lab11/signpost/modules/ambient/rev_a/ambient.kicad_pcb

## KiCad design modules/ambient/rev_a/ambient.kicad_pcb (2016-10-13, an earlier design)

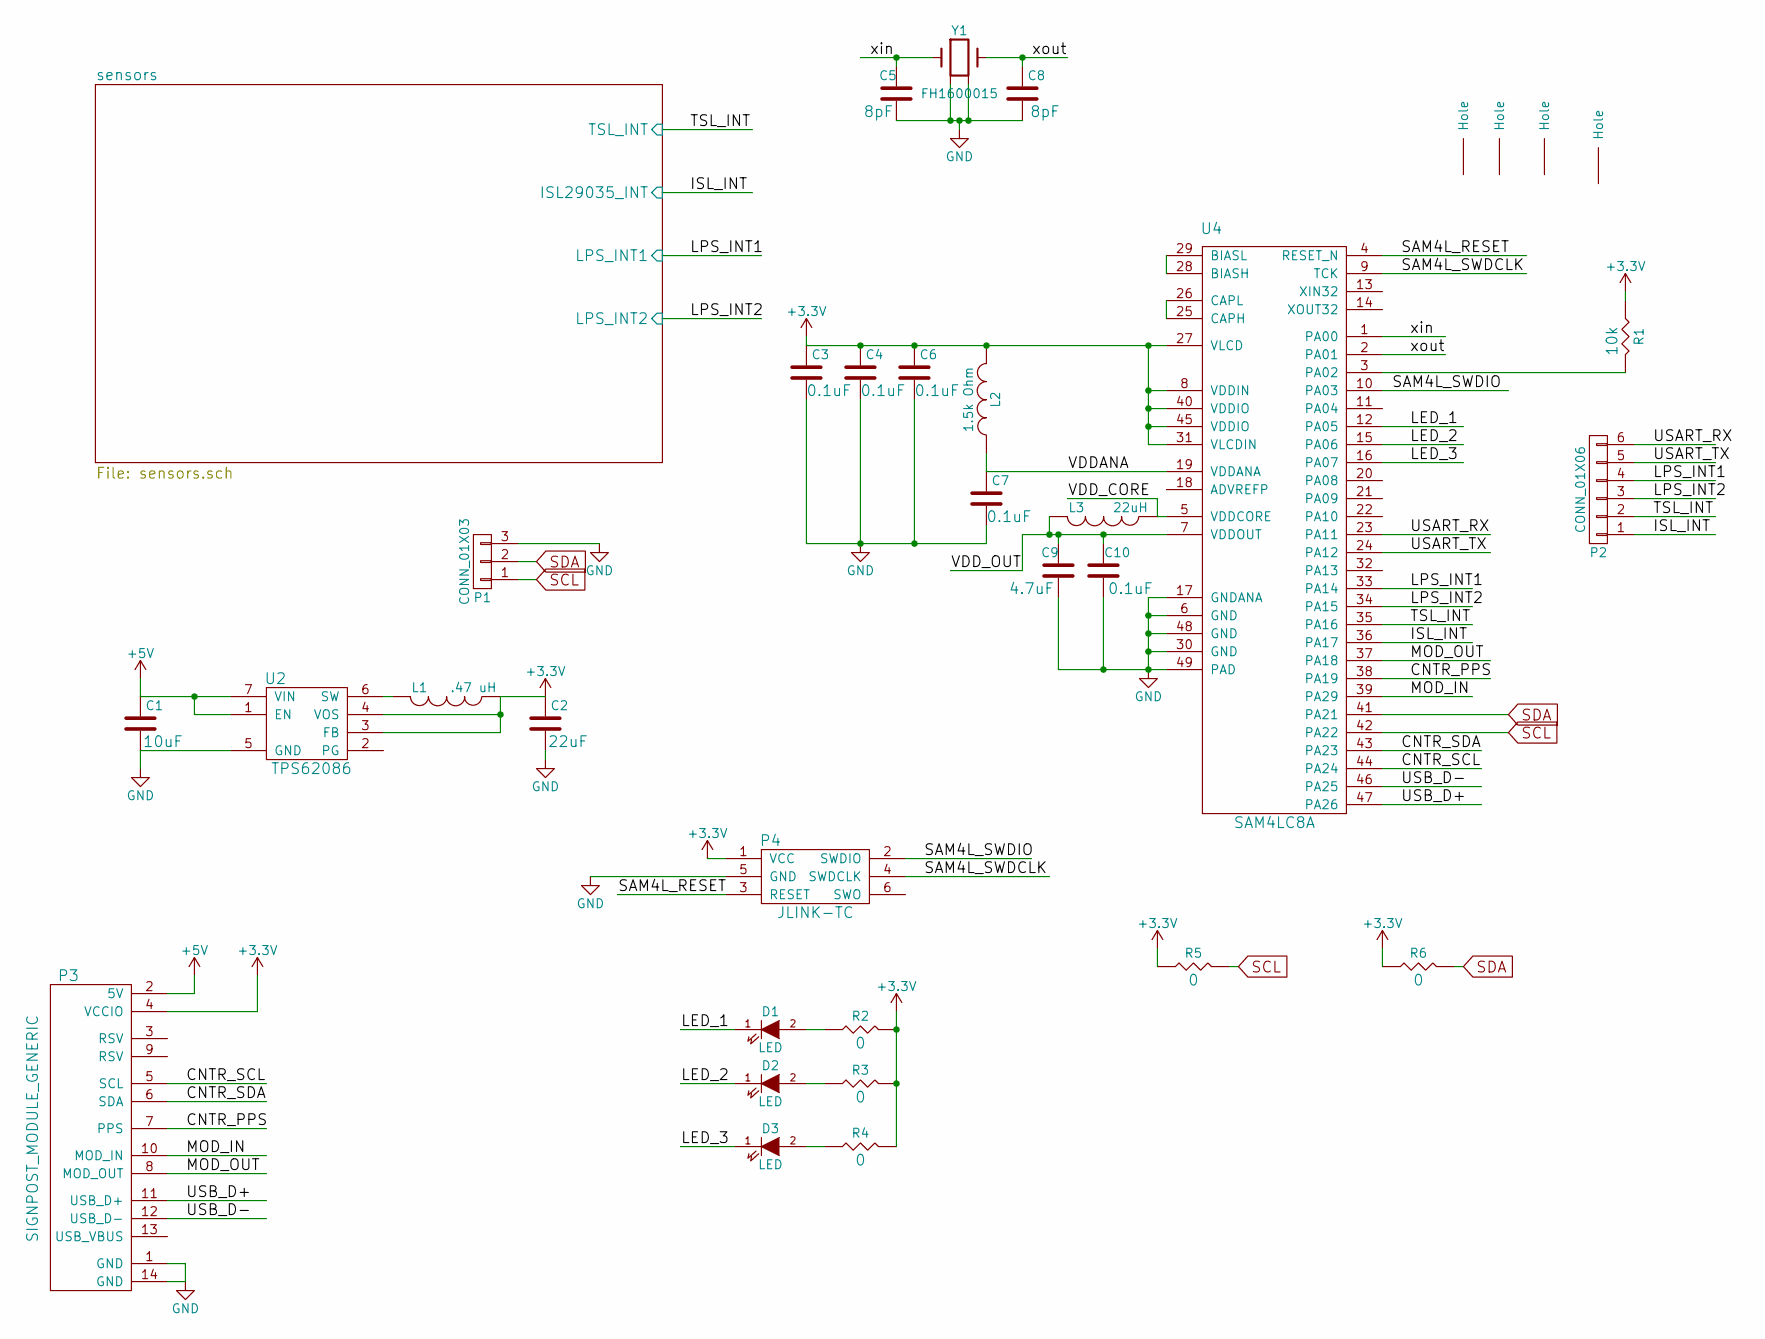
[picture p4: schematic ambient.sch]

Parts:
C1, C2: GENERIC_C_0805; C_0805_HandSoldering
C3, C4, C6, C7, C10: C_0.1u_0402_10V_10%_JB; C_0402
C5, C8: GENERIC_C_0402; C_0402
C9: C_4.7u_0402_10V_10%_X5R; C_0402
D1, D2, D3: LED; D_0603
H1, H2, H3, H4: SIGNPOST_HOLE
L1: .47 uH; DFE322512C
L2: 1.5k Ohm; C_0603_HandSoldering
L3: 22uH; 1212
P1: CONN_01X03; PINHEAD1-3
P2: CONN_01X06; PINHEAD1-6
P3: SIGNPOST_MODULE_GENERIC
P4: JLINK-TC; TC2030-IDC
R1: R_10k_0402_1%,100ppm/c,0.063W; R_0402
R2, R3, R4, R5, R6: GENERIC_R_0402; R_0402
U2: TPS62086; RLT0007A
U4: SAM4LC8A; QFN-48-1EP_7x7mm_Pitch0.5mm
Y1: FH1600015; FHXXX

Connections:
+3V3: C2.1, C3.1, C4.1, C6.1, L1.1, L2.2, P3.4 (VCCIO), P4.1 (VCC), R1.1, R2.2 (R1), R3.2 (R1), R4.2 (R1), R5.1, R6.1, U2.3 (FB), U2.4 (VOS), U4.8 (VDDIN), U4.27 (VLCD), U4.31 (VLCDIN), U4.40 (VDDIO), U4.45 (VDDIO); also elsewhere on the board
+5V: C1.1, P3.2 (5V), U2.1 (EN), U2.7 (VIN)
/CNTR_PPS: P3.7 (PPS), U4.38 (PA19)
/CNTR_SCL: P3.5 (SCL), U4.44 (PA24)
/CNTR_SDA: P3.6 (SDA), U4.43 (PA23)
/ISL_INT: P2.1, U4.36 (PA17); also elsewhere on the board
/LED_1: D1.1 (K), U4.12 (PA05)
/LED_2: D2.1 (K), U4.15 (PA06)
/LED_3: D3.1 (K), U4.16 (PA07)
/LPS_INT1: P2.4, U4.33 (PA14); also elsewhere on the board
/LPS_INT2: P2.3, U4.34 (PA15); also elsewhere on the board
/MOD_IN: P3.10 (MOD_IN), U4.39 (PA29)
/MOD_OUT: P3.8 (MOD_OUT), U4.37 (PA18)
/SAM4L_RESET: P4.3 (RESET), U4.4 (RESET_N)
/SAM4L_SWDCLK: P4.4 (SWDCLK), U4.9 (TCK)
/SAM4L_SWDIO: P4.2 (SWDIO), U4.10 (PA03)
/TSL_INT: P2.2, U4.35 (PA16); also elsewhere on the board
/USART_RX: P2.6, U4.23 (PA11)
/USART_TX: P2.5, U4.24 (PA12)
/USB_D+: P3.11 (USB_D+), U4.47 (PA26)
/USB_D-: P3.12 (USB_D-), U4.46 (PA25)
/VDDANA: C7.1, L2.1, U4.19 (VDDANA)
/VDD_CORE: L3.1, U4.5 (VDDCORE)
/VDD_OUT: C9.1, C10.1, L3.2, U4.7 (VDDOUT)
/xin: C5.1, U4.1 (PA00), Y1.1
/xout: C8.1, U4.2 (PA01), Y1.3
GND: C1.2, C2.2, C3.2, C4.2, C5.2, C6.2, C7.2, C8.2, C9.2, C10.2, P1.3, P3.1 (GND), P3.14 (GND), P4.5 (GND), U2.5 (GND), U4.6 (GND), U4.17 (GNDANA), U4.30 (GND), U4.48 (GND), U4.49 (PAD), Y1.2 (GND), Y1.4 (GND); also elsewhere on the board
unnamed: D1.2 (A), R2.1
unnamed: D2.2 (A), R3.1
unnamed: D3.2 (A), R4.1
unnamed: L1.2, U2.6 (SW)
unnamed: R1.2 (R1), U4.3 (PA02)
unnamed: U4.25 (CAPH), U4.26 (CAPL)
unnamed: U4.28 (BIASH), U4.29 (BIASL)
SCL: P1.1, R5.2 (R1), U4.42 (PA22); also elsewhere on the board
SDA: P1.2, R6.2 (R1), U4.41 (PA21); also elsewhere on the board

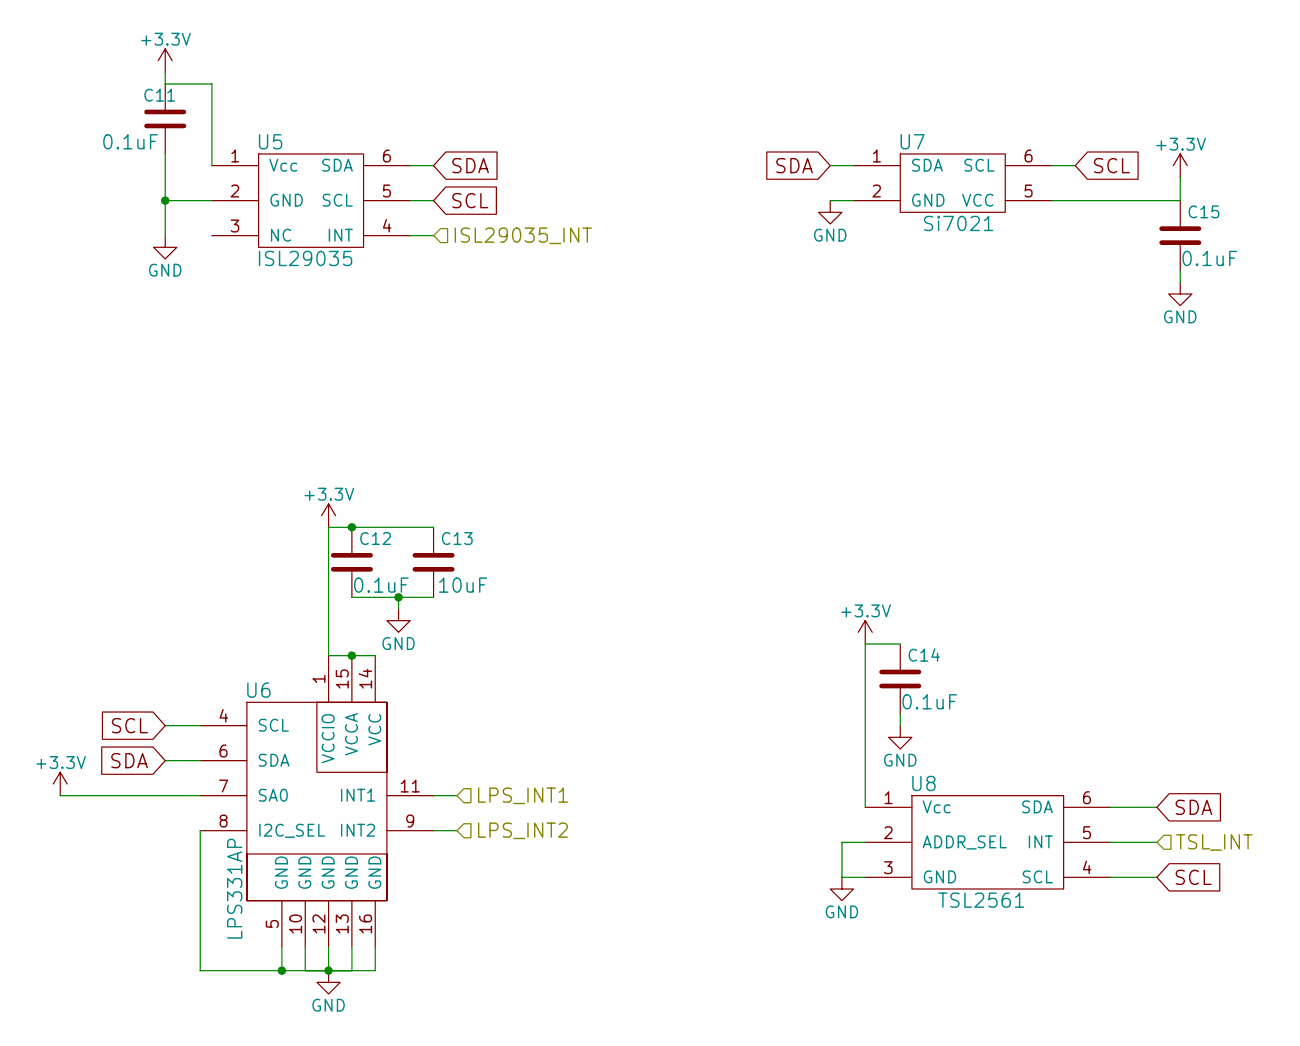
[picture p5: schematic sensors.sch]

Parts:
C11, C12, C14, C15: C_0.1u_0402_10V_10%_JB; C_0402
C13: C_10u_0603_10V_10%_JB; C_0603
U5: ISL29035; L6_1.5x1.6mm
U6: LPS331AP; HCLGA-16L
U7: Si7021; DFN_3x3mm_1mm
U8: TSL2561; DFN2

Connections:
+3V3: C11.1, C12.1, C13.1, C14.1, C15.1, U5.1 (Vcc), U6.1 (VCCIO), U6.7 (SA0), U6.14 (VCC), U6.15 (VCCA), U7.5 (VCC), U8.1 (Vcc); also elsewhere on the board
/ISL_INT: U5.4 (INT); also elsewhere on the board
/LPS_INT1: U6.11 (INT1); also elsewhere on the board
/LPS_INT2: U6.9 (INT2); also elsewhere on the board
/TSL_INT: U8.5 (INT); also elsewhere on the board
GND: C11.2, C12.2, C13.2, C14.2, C15.2, U5.2 (GND), U6.5 (GND), U6.8 (I2C_SEL), U6.10 (GND), U6.12 (GND), U6.13 (GND), U6.16 (GND), U7.2 (GND), U8.2 (ADDR_SEL), U8.3 (GND); also elsewhere on the board
SCL: U5.5 (SCL), U6.4 (SCL), U7.6 (SCL), U8.4 (SCL); also elsewhere on the board
SDA: U5.6 (SDA), U6.6 (SDA), U7.1 (SDA), U8.6 (SDA); also elsewhere on the board

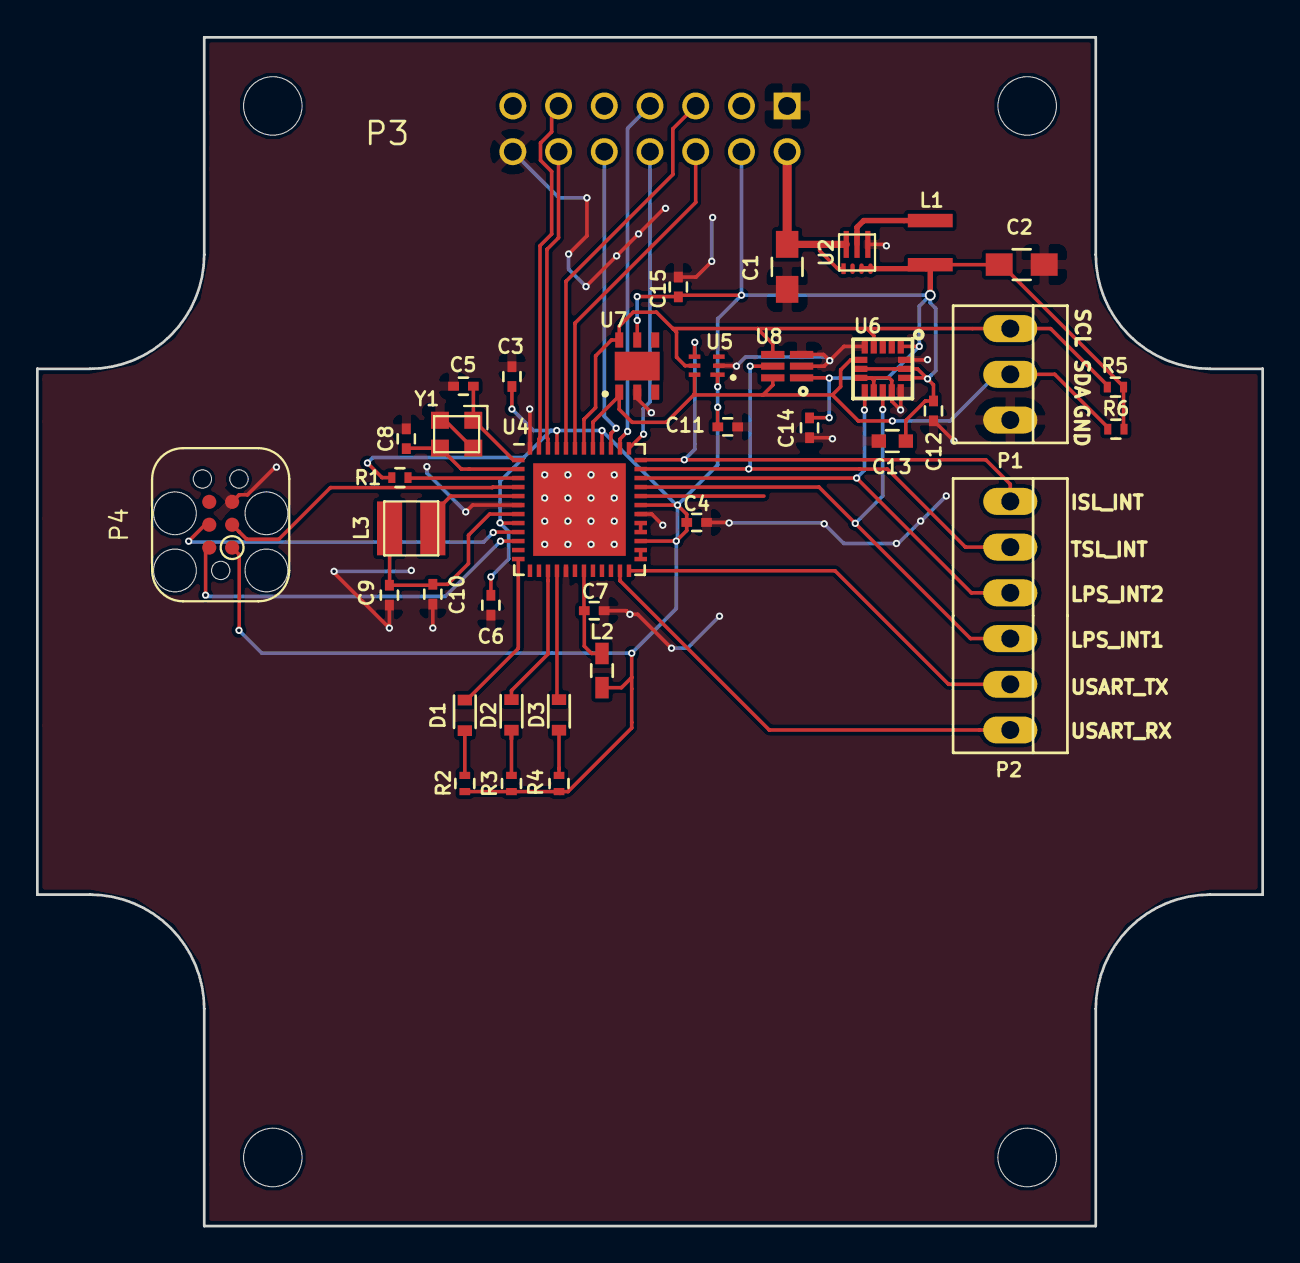
[picture p6: board modules/ambient/rev_a/ambient.kicad_pcb from above]

Board: 2 copper layers, 68.1 x 66.0 mm, 42 parts (0 on the bottom side), 36 nets.
