lab11/signpost/hardware/backplane/rev_d/backplane.brd

## EAGLE design hardware/backplane/rev_d/backplane.brd (2017-09-06)

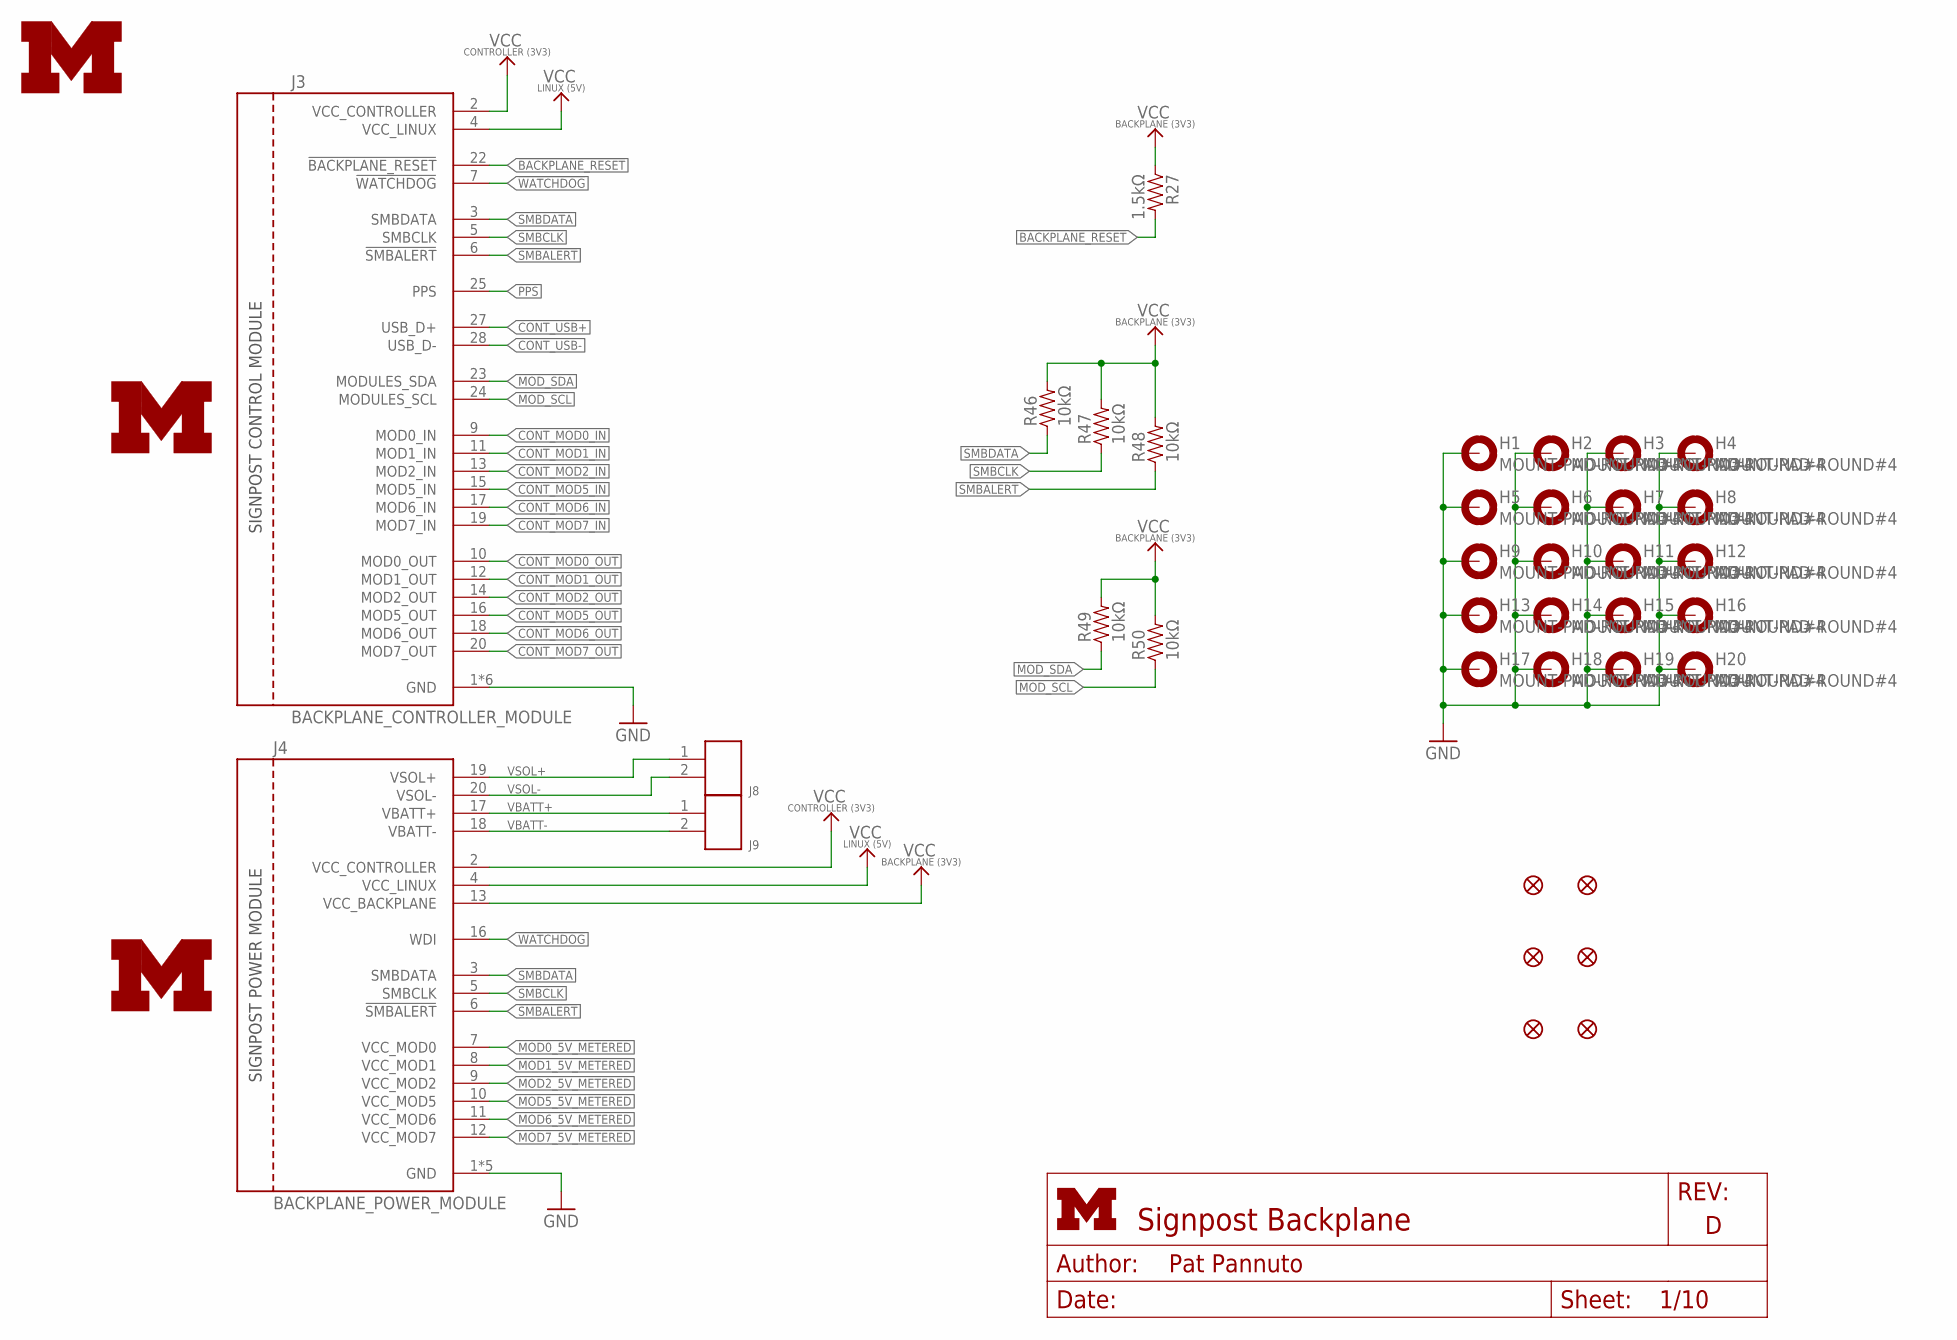
[picture p20: schematic backplane.sch, sheet 1, Special Modules & Misc Headers]

Parts:
H1, H2, H3, H4, H5, H6, H7, H8, H9, H10, H11, H12, H13, H14, H15, H16, H17, H18, H19, H20: MOUNT-PAD-ROUND#4; #4-PAD
J3: BACKPLANE_CONTROLLER_MODULE; BACKPLANE_MODULE_20PIN_10PIN
J4: BACKPLANE_POWER_MODULE; BACKPLANE_MODULE_20PIN
J8, J9: SCREW-TERMINAL_2_0.100; CONN_BLOCK_2
JP1, JP2, JP3, JP4, JP5, JP6: FIDUCIAL1X2; FIDUCIAL-1X2
LOGO1: UMICH_SOLID_GIANT; UMICH_SOLID_1000MIL
LOGO8, LOGO9: UMICH_SOLID_MEDIUM; UMICH_SOLID_200MIL
R27: 1.5kΩ; 0603-RES
R46, R47, R48, R49, R50: 10kΩ; 0603-RES

Connections:
!BACKPLANE_RESET: J3.22 (!BACKPLANE_RESET), R27.2; also elsewhere on the board
!SMBALERT: J3.6 (!SMBALERT), J4.6 (!SMBALERT), R48.1; also elsewhere on the board
!WATCHDOG: J3.7 (!WATCHDOG), J4.16 (WDI)
CONT_MOD0_IN: J3.9 (MOD0_IN); also elsewhere on the board
CONT_MOD0_OUT: J3.10 (MOD0_OUT); also elsewhere on the board
CONT_MOD1_IN: J3.11 (MOD1_IN); also elsewhere on the board
CONT_MOD1_OUT: J3.12 (MOD1_OUT); also elsewhere on the board
CONT_MOD2_IN: J3.13 (MOD2_IN); also elsewhere on the board
CONT_MOD2_OUT: J3.14 (MOD2_OUT); also elsewhere on the board
CONT_MOD5_IN: J3.15 (MOD5_IN); also elsewhere on the board
CONT_MOD5_OUT: J3.16 (MOD5_OUT); also elsewhere on the board
CONT_MOD6_IN: J3.17 (MOD6_IN); also elsewhere on the board
CONT_MOD6_OUT: J3.18 (MOD6_OUT); also elsewhere on the board
CONT_MOD7_IN: J3.19 (MOD7_IN); also elsewhere on the board
CONT_MOD7_OUT: J3.20 (MOD7_OUT); also elsewhere on the board
CONT_USB+: J3.27 (USB_D+); also elsewhere on the board
CONT_USB-: J3.28 (USB_D-); also elsewhere on the board
GND: H1.B#4, H2.B#4, H3.B#4, H4.B#4, H5.B#4, H6.B#4, H7.B#4, H8.B#4, H9.B#4, H10.B#4, H11.B#4, H12.B#4, H13.B#4, H14.B#4, H15.B#4, H16.B#4, H17.B#4, H18.B#4, H19.B#4, H20.B#4, J3.1 (GND), J3.21 (GND), J3.MNT1 (GND), J3.MNT2 (GND), J3.MNT3 (GND), J3.MNT4 (GND), J4.1 (GND), J4.MNT1 (GND), J4.MNT2 (GND), J4.MNT3 (GND), J4.MNT4 (GND); also elsewhere on the board
MOD0_5V_METERED: J4.7 (VCC_MOD0); also elsewhere on the board
MOD1_5V_METERED: J4.8 (VCC_MOD1); also elsewhere on the board
MOD2_5V_METERED: J4.9 (VCC_MOD2); also elsewhere on the board
MOD5_5V_METERED: J4.10 (VCC_MOD5); also elsewhere on the board
MOD6_5V_METERED: J4.11 (VCC_MOD6); also elsewhere on the board
MOD7_5V_METERED: J4.12 (VCC_MOD7); also elsewhere on the board
MOD_SCL: J3.24 (MODULES_SCL), R50.1; also elsewhere on the board
MOD_SDA: J3.23 (MODULES_SDA), R49.1; also elsewhere on the board
PPS: J3.25 (PPS); also elsewhere on the board
SMBCLK: J3.5 (SMBCLK), J4.5 (SMBCLK), R47.1; also elsewhere on the board
SMBDATA: J3.3 (SMBDATA), J4.3 (SMBDATA), R46.1; also elsewhere on the board
VBATT+: J4.17 (VBATT+), J9.1; also elsewhere on the board
VBATT-: J4.18 (VBATT-), J9.2; also elsewhere on the board
VCC_BACKPLANE: J4.13 (VCC_BACKPLANE), R27.1, R46.2, R47.2, R48.2, R49.2, R50.2; also elsewhere on the board
VCC_CONTROLLER: J3.2 (VCC_CONTROLLER), J4.2 (VCC_CONTROLLER); also elsewhere on the board
VCC_LINUX: J3.4 (VCC_LINUX), J4.4 (VCC_LINUX); also elsewhere on the board
VSOL+: J4.19 (VSOL+), J8.1; also elsewhere on the board
VSOL-: J4.20 (VSOL-), J8.2; also elsewhere on the board
