lab11/signpost/hardware/backplane/rev_d/backplane.brd

## EAGLE design hardware/backplane/rev_d/backplane.brd (continued)

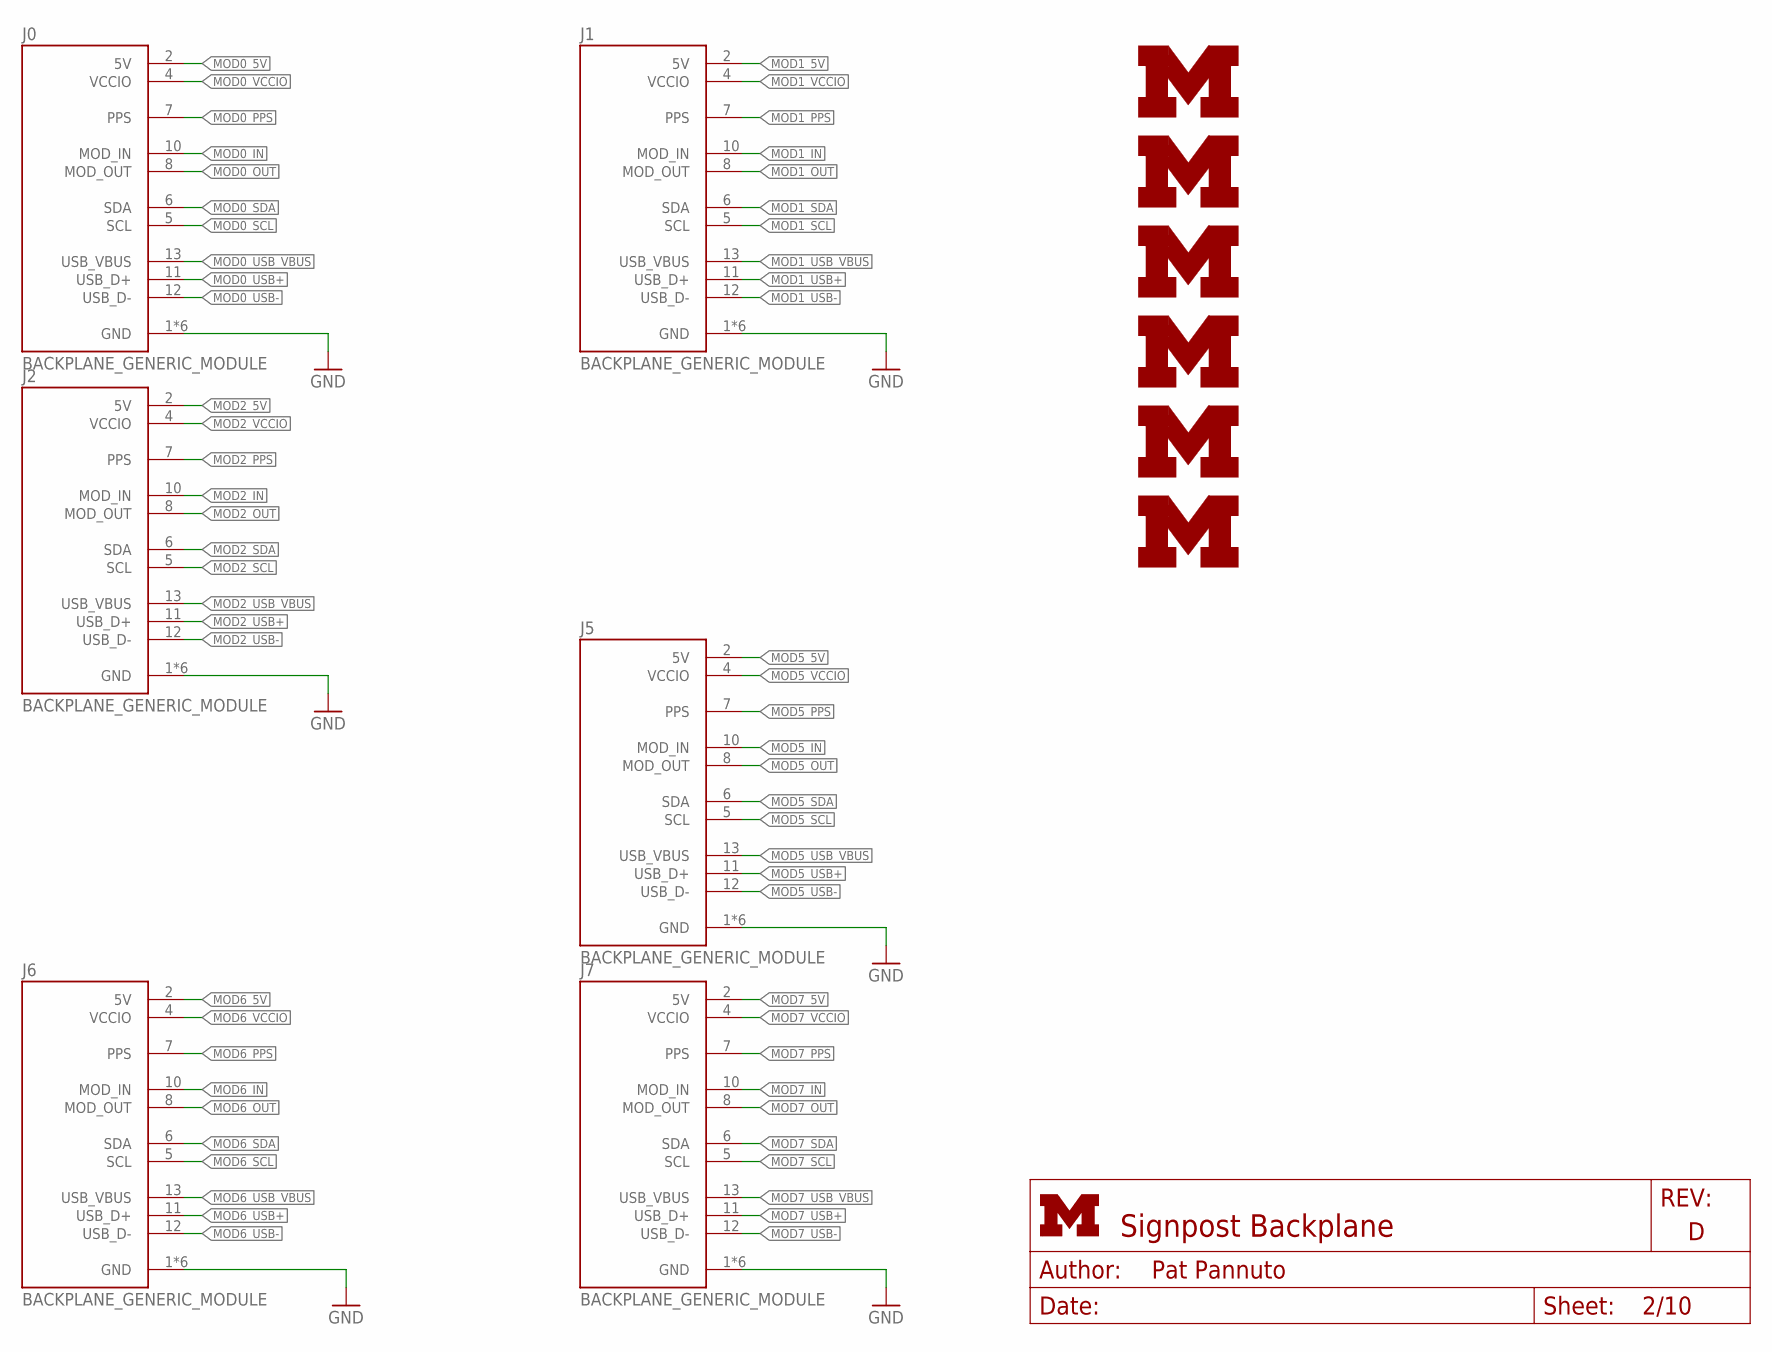
[picture p21: schematic backplane.sch, sheet 2, Generic Modules]

Parts:
J0, J1, J2, J5, J6, J7: BACKPLANE_GENERIC_MODULE; BACKPLANE_MODULE_14PIN
LOGO2, LOGO3, LOGO4, LOGO5, LOGO6, LOGO7: UMICH_SOLID_MEDIUM; UMICH_SOLID_200MIL

Connections:
GND: J0.1 (GND), J0.14 (GND), J0.MNT1 (GND), J0.MNT2 (GND), J0.MNT3 (GND), J0.MNT4 (GND), J1.1 (GND), J1.14 (GND), J1.MNT1 (GND), J1.MNT2 (GND), J1.MNT3 (GND), J1.MNT4 (GND), J2.1 (GND), J2.14 (GND), J2.MNT1 (GND), J2.MNT2 (GND), J2.MNT3 (GND), J2.MNT4 (GND), J5.1 (GND), J5.14 (GND), J5.MNT1 (GND), J5.MNT2 (GND), J5.MNT3 (GND), J5.MNT4 (GND), J6.1 (GND), J6.14 (GND), J6.MNT1 (GND), J6.MNT2 (GND), J6.MNT3 (GND), J6.MNT4 (GND), J7.1 (GND), J7.14 (GND), J7.MNT1 (GND), J7.MNT2 (GND), J7.MNT3 (GND), J7.MNT4 (GND); also elsewhere on the board
MOD0_5V: J0.2 (5V); also elsewhere on the board
MOD0_IN: J0.10 (MOD_IN); also elsewhere on the board
MOD0_OUT: J0.8 (MOD_OUT); also elsewhere on the board
MOD0_PPS: J0.7 (PPS); also elsewhere on the board
MOD0_SCL: J0.5 (SCL); also elsewhere on the board
MOD0_SDA: J0.6 (SDA); also elsewhere on the board
MOD0_USB+: J0.11 (USB_D+); also elsewhere on the board
MOD0_USB-: J0.12 (USB_D-); also elsewhere on the board
MOD0_USB_VBUS: J0.13 (USB_VBUS); also elsewhere on the board
MOD0_VCCIO: J0.4 (VCCIO); also elsewhere on the board
MOD1_5V: J1.2 (5V); also elsewhere on the board
MOD1_IN: J1.10 (MOD_IN); also elsewhere on the board
MOD1_OUT: J1.8 (MOD_OUT); also elsewhere on the board
MOD1_PPS: J1.7 (PPS); also elsewhere on the board
MOD1_SCL: J1.5 (SCL); also elsewhere on the board
MOD1_SDA: J1.6 (SDA); also elsewhere on the board
MOD1_USB+: J1.11 (USB_D+); also elsewhere on the board
MOD1_USB-: J1.12 (USB_D-); also elsewhere on the board
MOD1_USB_VBUS: J1.13 (USB_VBUS); also elsewhere on the board
MOD1_VCCIO: J1.4 (VCCIO); also elsewhere on the board
MOD2_5V: J2.2 (5V); also elsewhere on the board
MOD2_IN: J2.10 (MOD_IN); also elsewhere on the board
MOD2_OUT: J2.8 (MOD_OUT); also elsewhere on the board
MOD2_PPS: J2.7 (PPS); also elsewhere on the board
MOD2_SCL: J2.5 (SCL); also elsewhere on the board
MOD2_SDA: J2.6 (SDA); also elsewhere on the board
MOD2_USB+: J2.11 (USB_D+); also elsewhere on the board
MOD2_USB-: J2.12 (USB_D-); also elsewhere on the board
MOD2_USB_VBUS: J2.13 (USB_VBUS); also elsewhere on the board
MOD2_VCCIO: J2.4 (VCCIO); also elsewhere on the board
MOD5_5V: J5.2 (5V); also elsewhere on the board
MOD5_IN: J5.10 (MOD_IN); also elsewhere on the board
MOD5_OUT: J5.8 (MOD_OUT); also elsewhere on the board
MOD5_PPS: J5.7 (PPS); also elsewhere on the board
MOD5_SCL: J5.5 (SCL); also elsewhere on the board
MOD5_SDA: J5.6 (SDA); also elsewhere on the board
MOD5_USB+: J5.11 (USB_D+); also elsewhere on the board
MOD5_USB-: J5.12 (USB_D-); also elsewhere on the board
MOD5_USB_VBUS: J5.13 (USB_VBUS); also elsewhere on the board
MOD5_VCCIO: J5.4 (VCCIO); also elsewhere on the board
MOD6_5V: J6.2 (5V); also elsewhere on the board
MOD6_IN: J6.10 (MOD_IN); also elsewhere on the board
MOD6_OUT: J6.8 (MOD_OUT); also elsewhere on the board
MOD6_PPS: J6.7 (PPS); also elsewhere on the board
MOD6_SCL: J6.5 (SCL); also elsewhere on the board
MOD6_SDA: J6.6 (SDA); also elsewhere on the board
MOD6_USB+: J6.11 (USB_D+); also elsewhere on the board
MOD6_USB-: J6.12 (USB_D-); also elsewhere on the board
MOD6_USB_VBUS: J6.13 (USB_VBUS); also elsewhere on the board
MOD6_VCCIO: J6.4 (VCCIO); also elsewhere on the board
MOD7_5V: J7.2 (5V); also elsewhere on the board
MOD7_IN: J7.10 (MOD_IN); also elsewhere on the board
MOD7_OUT: J7.8 (MOD_OUT); also elsewhere on the board
MOD7_PPS: J7.7 (PPS); also elsewhere on the board
MOD7_SCL: J7.5 (SCL); also elsewhere on the board
MOD7_SDA: J7.6 (SDA); also elsewhere on the board
MOD7_USB+: J7.11 (USB_D+); also elsewhere on the board
MOD7_USB-: J7.12 (USB_D-); also elsewhere on the board
MOD7_USB_VBUS: J7.13 (USB_VBUS); also elsewhere on the board
MOD7_VCCIO: J7.4 (VCCIO); also elsewhere on the board

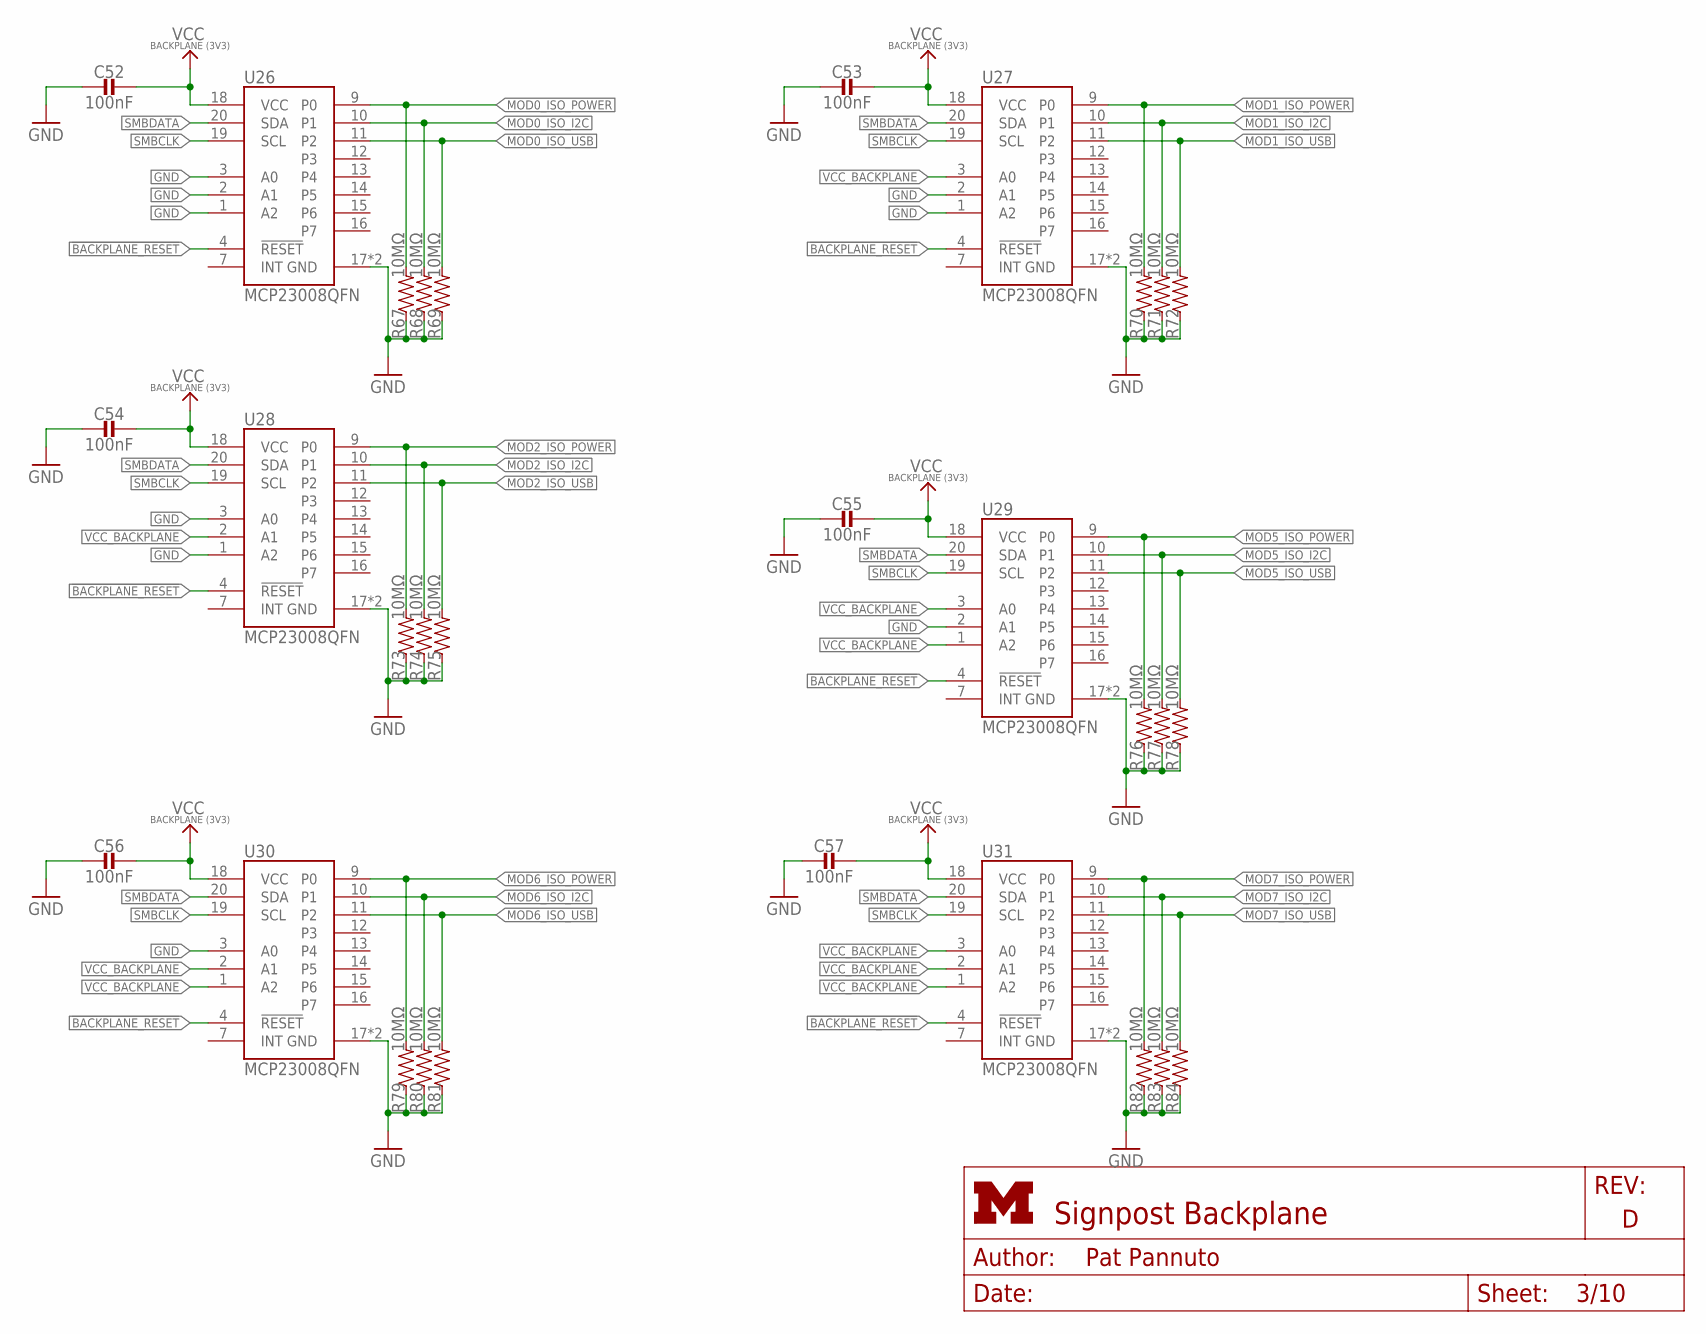
[picture p22: schematic backplane.sch, sheet 3, GPIO Extenders]

Parts:
C52, C53, C54, C55, C56, C57: 100nF; 0603_CAP
R67, R68, R69, R70, R71, R72, R73, R74, R75, R76, R77, R78, R79, R80, R81, R82, R83, R84: 10MΩ; 0603-RES
U26, U27, U28, U29, U30, U31: MCP23008QFN; QFN-20-4MM

Connections:
!BACKPLANE_RESET: U26.4 (!RESET), U27.4 (!RESET), U28.4 (!RESET), U29.4 (!RESET), U30.4 (!RESET), U31.4 (!RESET); also elsewhere on the board
GND: C52.2, C53.2, C54.2, C55.2, C56.2, C57.2, R67.1, R68.1, R69.1, R70.1, R71.1, R72.1, R73.1, R74.1, R75.1, R76.1, R77.1, R78.1, R79.1, R80.1, R81.1, R82.1, R83.1, R84.1, U26.1 (A2), U26.2 (A1), U26.3 (A0), U26.17 (GND), U26.GND, U27.1 (A2), U27.2 (A1), U27.17 (GND), U27.GND, U28.1 (A2), U28.3 (A0), U28.17 (GND), U28.GND, U29.2 (A1), U29.17 (GND), U29.GND, U30.3 (A0), U30.17 (GND), U30.GND, U31.17 (GND), U31.GND; also elsewhere on the board
MOD0_ISO_I2C: R68.2, U26.10 (P1); also elsewhere on the board
MOD0_ISO_POWER: R67.2, U26.9 (P0); also elsewhere on the board
MOD0_ISO_USB: R69.2, U26.11 (P2); also elsewhere on the board
MOD1_ISO_I2C: R71.2, U27.10 (P1); also elsewhere on the board
MOD1_ISO_POWER: R70.2, U27.9 (P0); also elsewhere on the board
MOD1_ISO_USB: R72.2, U27.11 (P2); also elsewhere on the board
MOD2_ISO_I2C: R74.2, U28.10 (P1); also elsewhere on the board
MOD2_ISO_POWER: R73.2, U28.9 (P0); also elsewhere on the board
MOD2_ISO_USB: R75.2, U28.11 (P2); also elsewhere on the board
MOD5_ISO_I2C: R77.2, U29.10 (P1); also elsewhere on the board
MOD5_ISO_POWER: R76.2, U29.9 (P0); also elsewhere on the board
MOD5_ISO_USB: R78.2, U29.11 (P2); also elsewhere on the board
MOD6_ISO_I2C: R80.2, U30.10 (P1); also elsewhere on the board
MOD6_ISO_POWER: R79.2, U30.9 (P0); also elsewhere on the board
MOD6_ISO_USB: R81.2, U30.11 (P2); also elsewhere on the board
MOD7_ISO_I2C: R83.2, U31.10 (P1); also elsewhere on the board
MOD7_ISO_POWER: R82.2, U31.9 (P0); also elsewhere on the board
MOD7_ISO_USB: R84.2, U31.11 (P2); also elsewhere on the board
SMBCLK: U26.19 (SCL), U27.19 (SCL), U28.19 (SCL), U29.19 (SCL), U30.19 (SCL), U31.19 (SCL); also elsewhere on the board
SMBDATA: U26.20 (SDA), U27.20 (SDA), U28.20 (SDA), U29.20 (SDA), U30.20 (SDA), U31.20 (SDA); also elsewhere on the board
VCC_BACKPLANE: C52.1, C53.1, C54.1, C55.1, C56.1, C57.1, U26.18 (VCC), U27.3 (A0), U27.18 (VCC), U28.2 (A1), U28.18 (VCC), U29.1 (A2), U29.3 (A0), U29.18 (VCC), U30.1 (A2), U30.2 (A1), U30.18 (VCC), U31.1 (A2), U31.2 (A1), U31.3 (A0), U31.18 (VCC); also elsewhere on the board

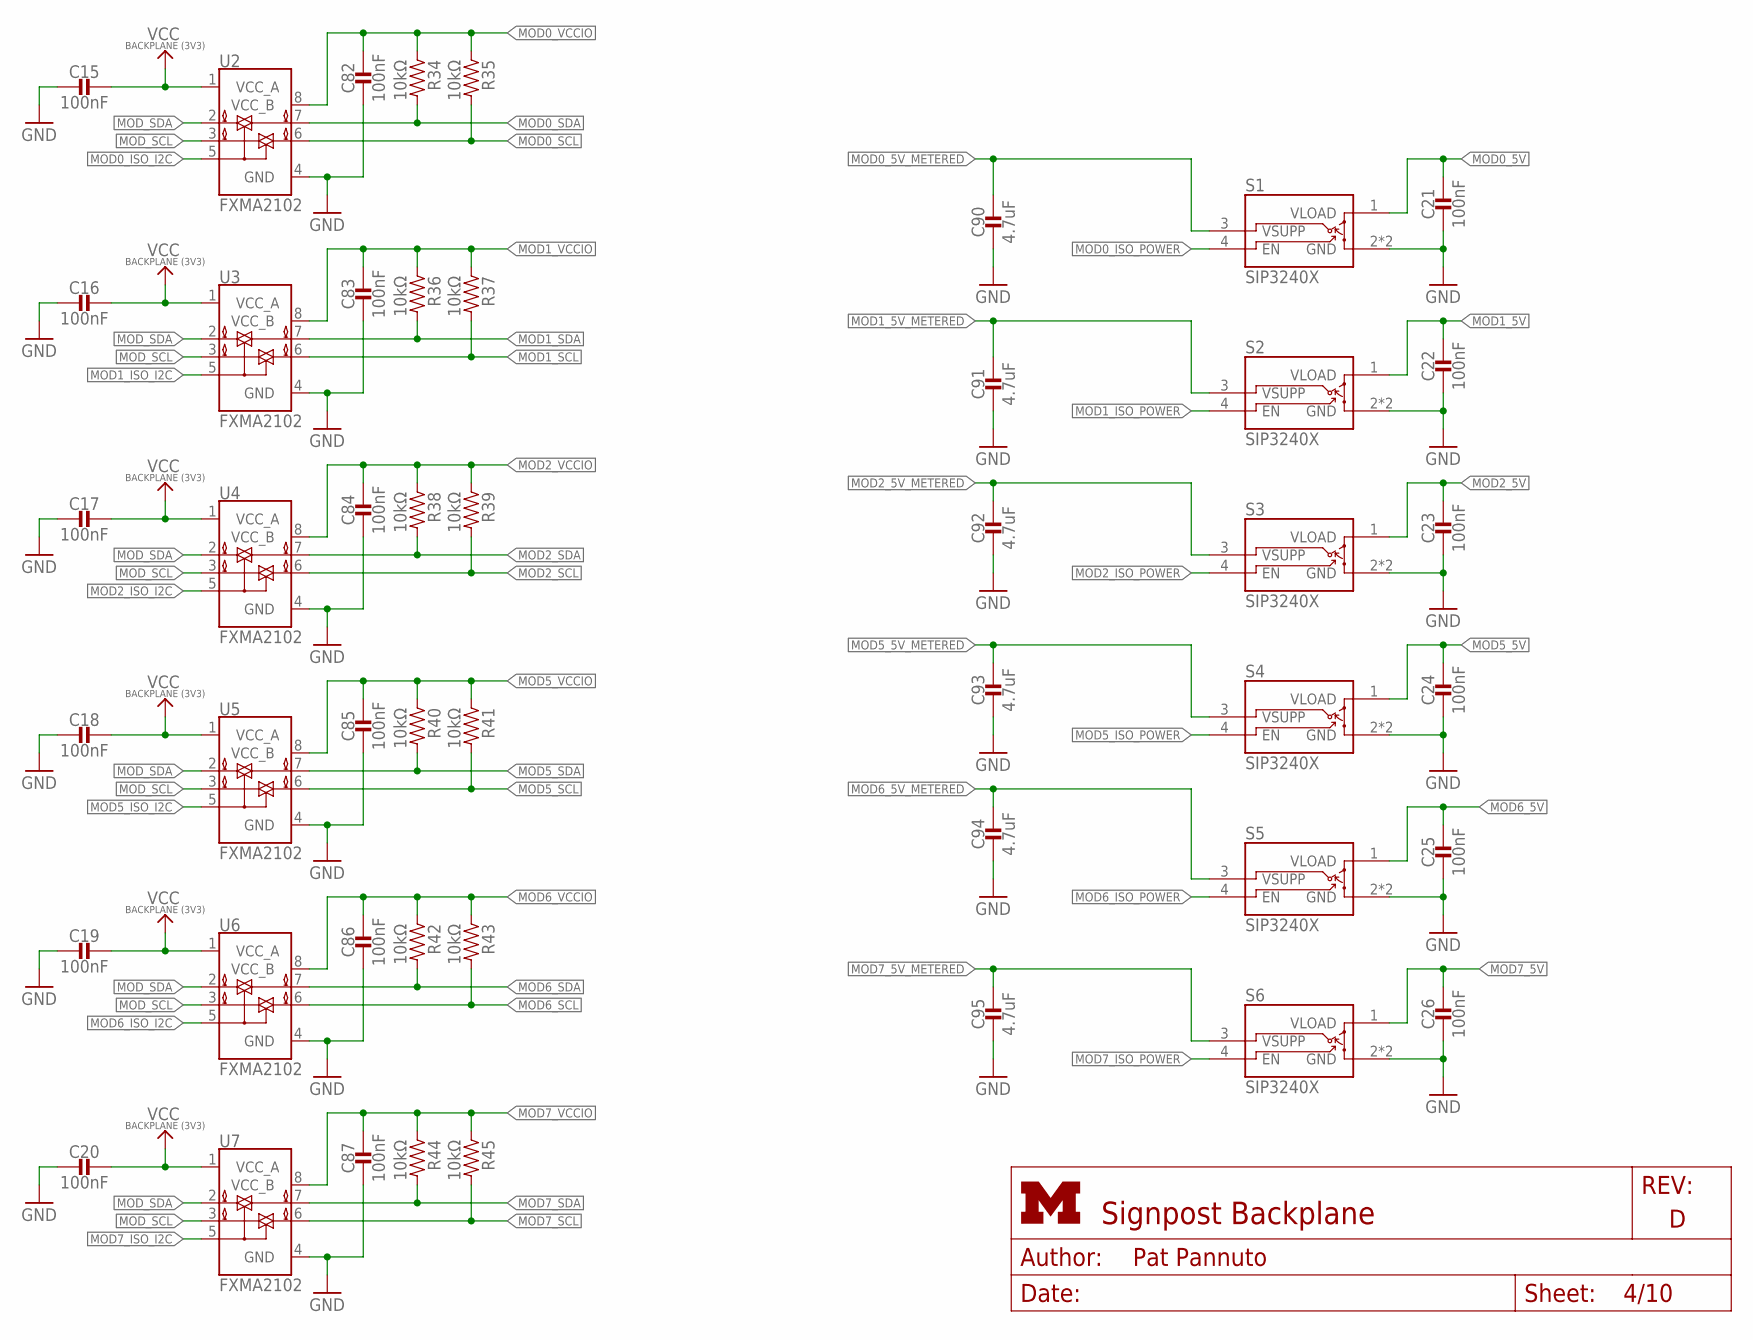
[picture p23: schematic backplane.sch, sheet 4, I2C and Power Isolation]

Parts:
C15, C16, C17, C18, C19, C20, C21, C22, C23, C24, C25, C26, C82, C83, C84, C85, C86, C87: 100nF; 0603_CAP
C90, C91, C92, C93, C94, C95: 4.7uF; 0603_CAP
R34, R35, R36, R37, R38, R39, R40, R41, R42, R43, R44, R45: 10kΩ; 0603-RES
S1, S2, S3, S4, S5, S6: SIP3240X; TDFN4
U2, U3, U4, U5, U6, U7: FXMA2102; UMLP-8

Connections:
GND: C15.2, C16.2, C17.2, C18.2, C19.2, C20.2, C21.2, C22.2, C23.2, C24.2, C25.2, C26.2, C82.2, C83.2, C84.2, C85.2, C86.2, C87.2, C90.2, C91.2, C92.2, C93.2, C94.2, C95.2, S1.2 (GND), S1.PAD (GND), S2.2 (GND), S2.PAD (GND), S3.2 (GND), S3.PAD (GND), S4.2 (GND), S4.PAD (GND), S5.2 (GND), S5.PAD (GND), S6.2 (GND), S6.PAD (GND), U2.4 (GND), U3.4 (GND), U4.4 (GND), U5.4 (GND), U6.4 (GND), U7.4 (GND); also elsewhere on the board
MOD0_5V: C21.1, S1.1 (VLOAD); also elsewhere on the board
MOD0_5V_METERED: C90.1, S1.3 (VSUPP); also elsewhere on the board
MOD0_ISO_I2C: U2.5 (OE); also elsewhere on the board
MOD0_ISO_POWER: S1.4 (EN); also elsewhere on the board
MOD0_SCL: R35.2, U2.6 (B1); also elsewhere on the board
MOD0_SDA: R34.2, U2.7 (B0); also elsewhere on the board
MOD0_VCCIO: C82.1, R34.1, R35.1, U2.8 (VCC_B); also elsewhere on the board
MOD1_5V: C22.1, S2.1 (VLOAD); also elsewhere on the board
MOD1_5V_METERED: C91.1, S2.3 (VSUPP); also elsewhere on the board
MOD1_ISO_I2C: U3.5 (OE); also elsewhere on the board
MOD1_ISO_POWER: S2.4 (EN); also elsewhere on the board
MOD1_SCL: R37.2, U3.6 (B1); also elsewhere on the board
MOD1_SDA: R36.2, U3.7 (B0); also elsewhere on the board
MOD1_VCCIO: C83.1, R36.1, R37.1, U3.8 (VCC_B); also elsewhere on the board
MOD2_5V: C23.1, S3.1 (VLOAD); also elsewhere on the board
MOD2_5V_METERED: C92.1, S3.3 (VSUPP); also elsewhere on the board
MOD2_ISO_I2C: U4.5 (OE); also elsewhere on the board
MOD2_ISO_POWER: S3.4 (EN); also elsewhere on the board
MOD2_SCL: R39.2, U4.6 (B1); also elsewhere on the board
MOD2_SDA: R38.2, U4.7 (B0); also elsewhere on the board
MOD2_VCCIO: C84.1, R38.1, R39.1, U4.8 (VCC_B); also elsewhere on the board
MOD5_5V: C24.1, S4.1 (VLOAD); also elsewhere on the board
MOD5_5V_METERED: C93.1, S4.3 (VSUPP); also elsewhere on the board
MOD5_ISO_I2C: U5.5 (OE); also elsewhere on the board
MOD5_ISO_POWER: S4.4 (EN); also elsewhere on the board
MOD5_SCL: R41.2, U5.6 (B1); also elsewhere on the board
MOD5_SDA: R40.2, U5.7 (B0); also elsewhere on the board
MOD5_VCCIO: C85.1, R40.1, R41.1, U5.8 (VCC_B); also elsewhere on the board
MOD6_5V: C25.1, S5.1 (VLOAD); also elsewhere on the board
MOD6_5V_METERED: C94.1, S5.3 (VSUPP); also elsewhere on the board
MOD6_ISO_I2C: U6.5 (OE); also elsewhere on the board
MOD6_ISO_POWER: S5.4 (EN); also elsewhere on the board
MOD6_SCL: R43.2, U6.6 (B1); also elsewhere on the board
MOD6_SDA: R42.2, U6.7 (B0); also elsewhere on the board
MOD6_VCCIO: C86.1, R42.1, R43.1, U6.8 (VCC_B); also elsewhere on the board
MOD7_5V: C26.1, S6.1 (VLOAD); also elsewhere on the board
MOD7_5V_METERED: C95.1, S6.3 (VSUPP); also elsewhere on the board
MOD7_ISO_I2C: U7.5 (OE); also elsewhere on the board
MOD7_ISO_POWER: S6.4 (EN); also elsewhere on the board
MOD7_SCL: R45.2, U7.6 (B1); also elsewhere on the board
MOD7_SDA: R44.2, U7.7 (B0); also elsewhere on the board
MOD7_VCCIO: C87.1, R44.1, R45.1, U7.8 (VCC_B); also elsewhere on the board
MOD_SCL: U2.3 (A1), U3.3 (A1), U4.3 (A1), U5.3 (A1), U6.3 (A1), U7.3 (A1); also elsewhere on the board
MOD_SDA: U2.2 (A0), U3.2 (A0), U4.2 (A0), U5.2 (A0), U6.2 (A0), U7.2 (A0); also elsewhere on the board
VCC_BACKPLANE: C15.1, C16.1, C17.1, C18.1, C19.1, C20.1, U2.1 (VCC_A), U3.1 (VCC_A), U4.1 (VCC_A), U5.1 (VCC_A), U6.1 (VCC_A), U7.1 (VCC_A); also elsewhere on the board

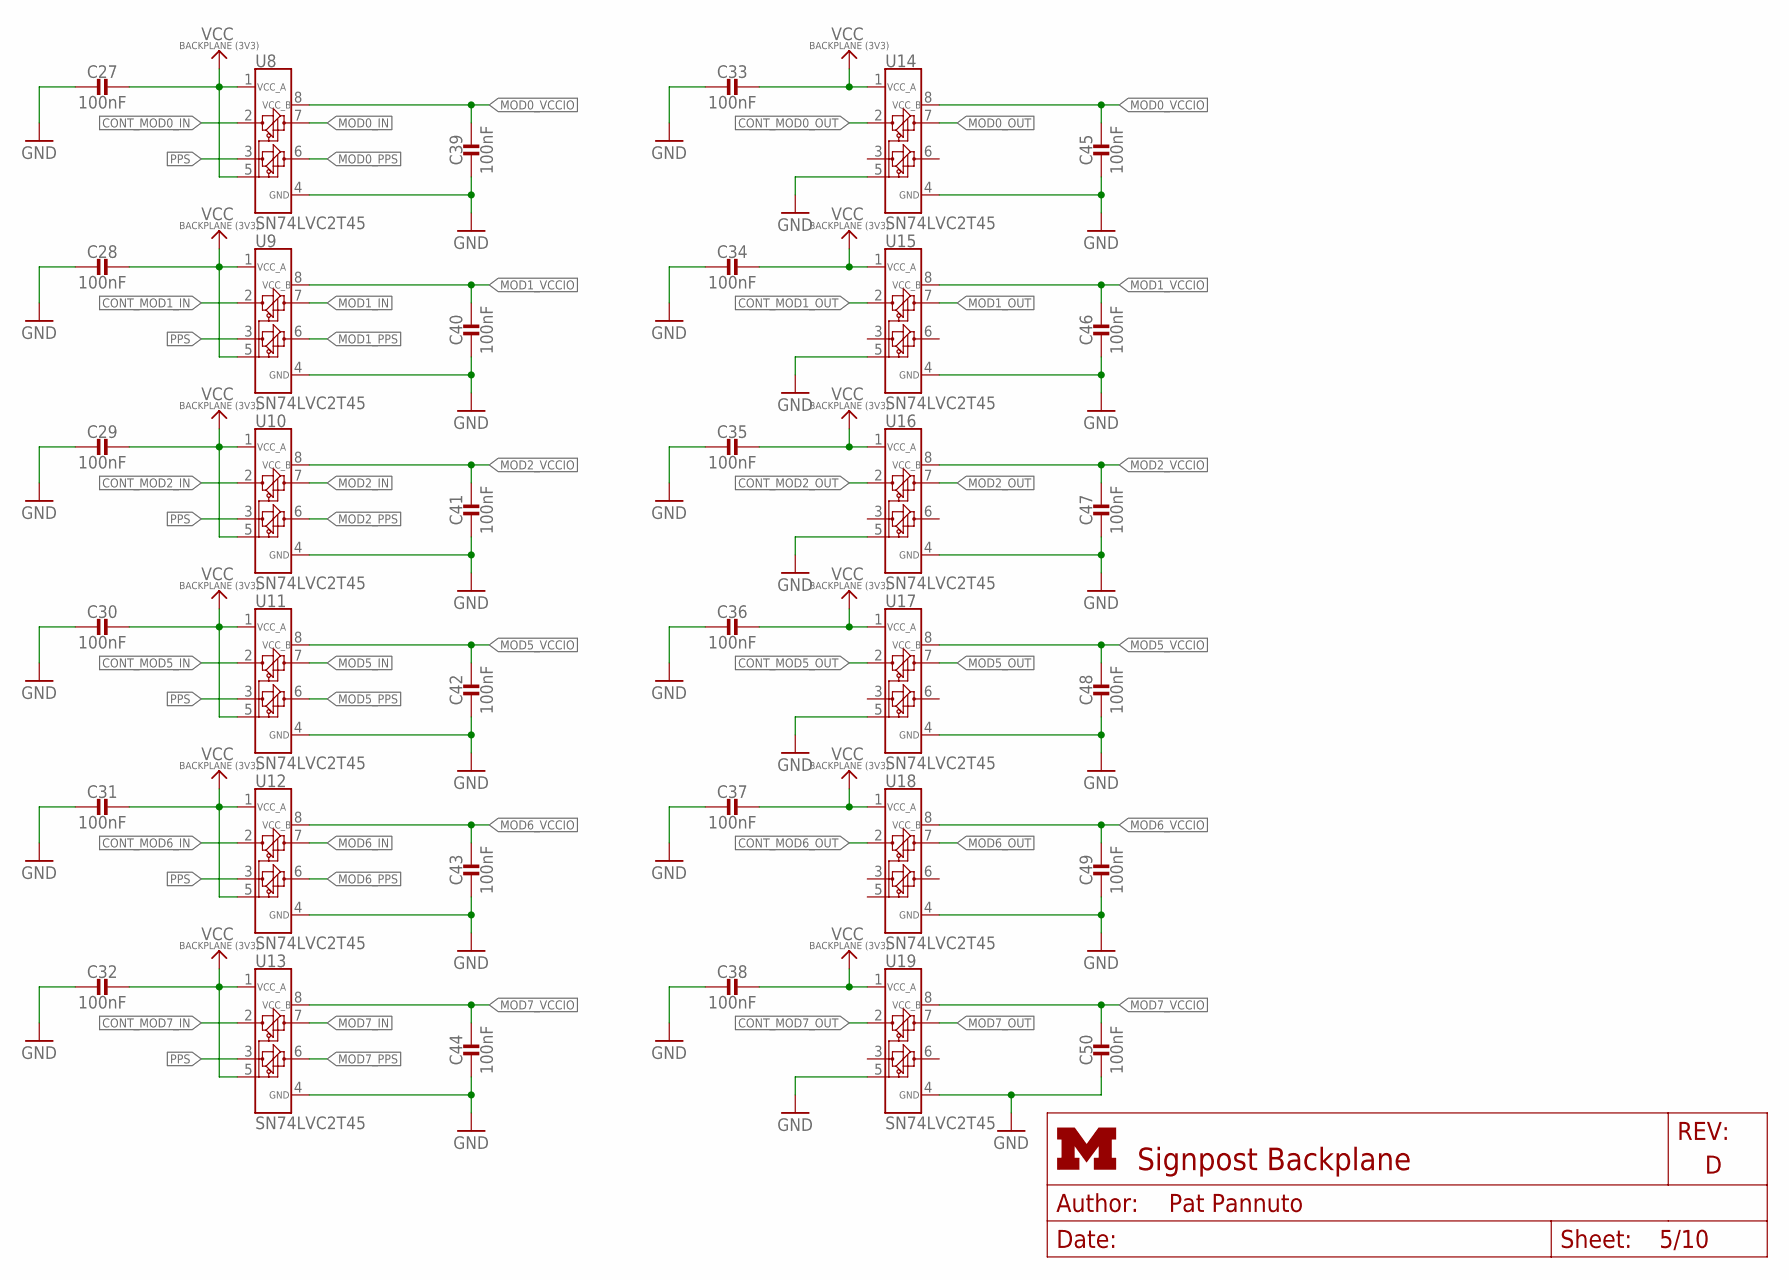
[picture p24: schematic backplane.sch, sheet 5, GPIO/PPS Isolation]

Parts:
C27, C28, C29, C30, C31, C32, C33, C34, C35, C36, C37, C38, C39, C40, C41, C42, C43, C44, C45, C46, C47, C48, C49, C50: 100nF; 0603_CAP
U8, U9, U10, U11, U12, U13, U14, U15, U16, U17, U18, U19: SN74LVC2T45; VFSOP-8

Connections:
CONT_MOD0_IN: U8.2 (A1); also elsewhere on the board
CONT_MOD0_OUT: U14.2 (A1); also elsewhere on the board
CONT_MOD1_IN: U9.2 (A1); also elsewhere on the board
CONT_MOD1_OUT: U15.2 (A1); also elsewhere on the board
CONT_MOD2_IN: U10.2 (A1); also elsewhere on the board
CONT_MOD2_OUT: U16.2 (A1); also elsewhere on the board
CONT_MOD5_IN: U11.2 (A1); also elsewhere on the board
CONT_MOD5_OUT: U17.2 (A1); also elsewhere on the board
CONT_MOD6_IN: U12.2 (A1); also elsewhere on the board
CONT_MOD6_OUT: U18.2 (A1); also elsewhere on the board
CONT_MOD7_IN: U13.2 (A1); also elsewhere on the board
CONT_MOD7_OUT: U19.2 (A1); also elsewhere on the board
GND: C27.2, C28.2, C29.2, C30.2, C31.2, C32.2, C33.2, C34.2, C35.2, C36.2, C37.2, C38.2, C39.2, C40.2, C41.2, C42.2, C43.2, C44.2, C45.2, C46.2, C47.2, C48.2, C49.2, C50.2, U8.4 (GND), U9.4 (GND), U10.4 (GND), U11.4 (GND), U12.4 (GND), U13.4 (GND), U14.4 (GND), U14.5 (DIR), U15.4 (GND), U15.5 (DIR), U16.4 (GND), U16.5 (DIR), U17.4 (GND), U17.5 (DIR), U18.4 (GND), U19.4 (GND), U19.5 (DIR); also elsewhere on the board
MOD0_IN: U8.7 (B1); also elsewhere on the board
MOD0_OUT: U14.7 (B1); also elsewhere on the board
MOD0_PPS: U8.6 (B2); also elsewhere on the board
MOD0_VCCIO: C39.1, C45.1, U8.8 (VCC_B), U14.8 (VCC_B); also elsewhere on the board
MOD1_IN: U9.7 (B1); also elsewhere on the board
MOD1_OUT: U15.7 (B1); also elsewhere on the board
MOD1_PPS: U9.6 (B2); also elsewhere on the board
MOD1_VCCIO: C40.1, C46.1, U9.8 (VCC_B), U15.8 (VCC_B); also elsewhere on the board
MOD2_IN: U10.7 (B1); also elsewhere on the board
MOD2_OUT: U16.7 (B1); also elsewhere on the board
MOD2_PPS: U10.6 (B2); also elsewhere on the board
MOD2_VCCIO: C41.1, C47.1, U10.8 (VCC_B), U16.8 (VCC_B); also elsewhere on the board
MOD5_IN: U11.7 (B1); also elsewhere on the board
MOD5_OUT: U17.7 (B1); also elsewhere on the board
MOD5_PPS: U11.6 (B2); also elsewhere on the board
MOD5_VCCIO: C42.1, C48.1, U11.8 (VCC_B), U17.8 (VCC_B); also elsewhere on the board
MOD6_IN: U12.7 (B1); also elsewhere on the board
MOD6_OUT: U18.7 (B1); also elsewhere on the board
MOD6_PPS: U12.6 (B2); also elsewhere on the board
MOD6_VCCIO: C43.1, C49.1, U12.8 (VCC_B), U18.8 (VCC_B); also elsewhere on the board
MOD7_IN: U13.7 (B1); also elsewhere on the board
MOD7_OUT: U19.7 (B1); also elsewhere on the board
MOD7_PPS: U13.6 (B2); also elsewhere on the board
MOD7_VCCIO: C44.1, C50.1, U13.8 (VCC_B), U19.8 (VCC_B); also elsewhere on the board
PPS: U8.3 (A2), U9.3 (A2), U10.3 (A2), U11.3 (A2), U12.3 (A2), U13.3 (A2); also elsewhere on the board
VCC_BACKPLANE: C27.1, C28.1, C29.1, C30.1, C31.1, C32.1, C33.1, C34.1, C35.1, C36.1, C37.1, C38.1, U8.1 (VCC_A), U8.5 (DIR), U9.1 (VCC_A), U9.5 (DIR), U10.1 (VCC_A), U10.5 (DIR), U11.1 (VCC_A), U11.5 (DIR), U12.1 (VCC_A), U12.5 (DIR), U13.1 (VCC_A), U13.5 (DIR), U14.1 (VCC_A), U15.1 (VCC_A), U16.1 (VCC_A), U17.1 (VCC_A), U18.1 (VCC_A), U19.1 (VCC_A); also elsewhere on the board

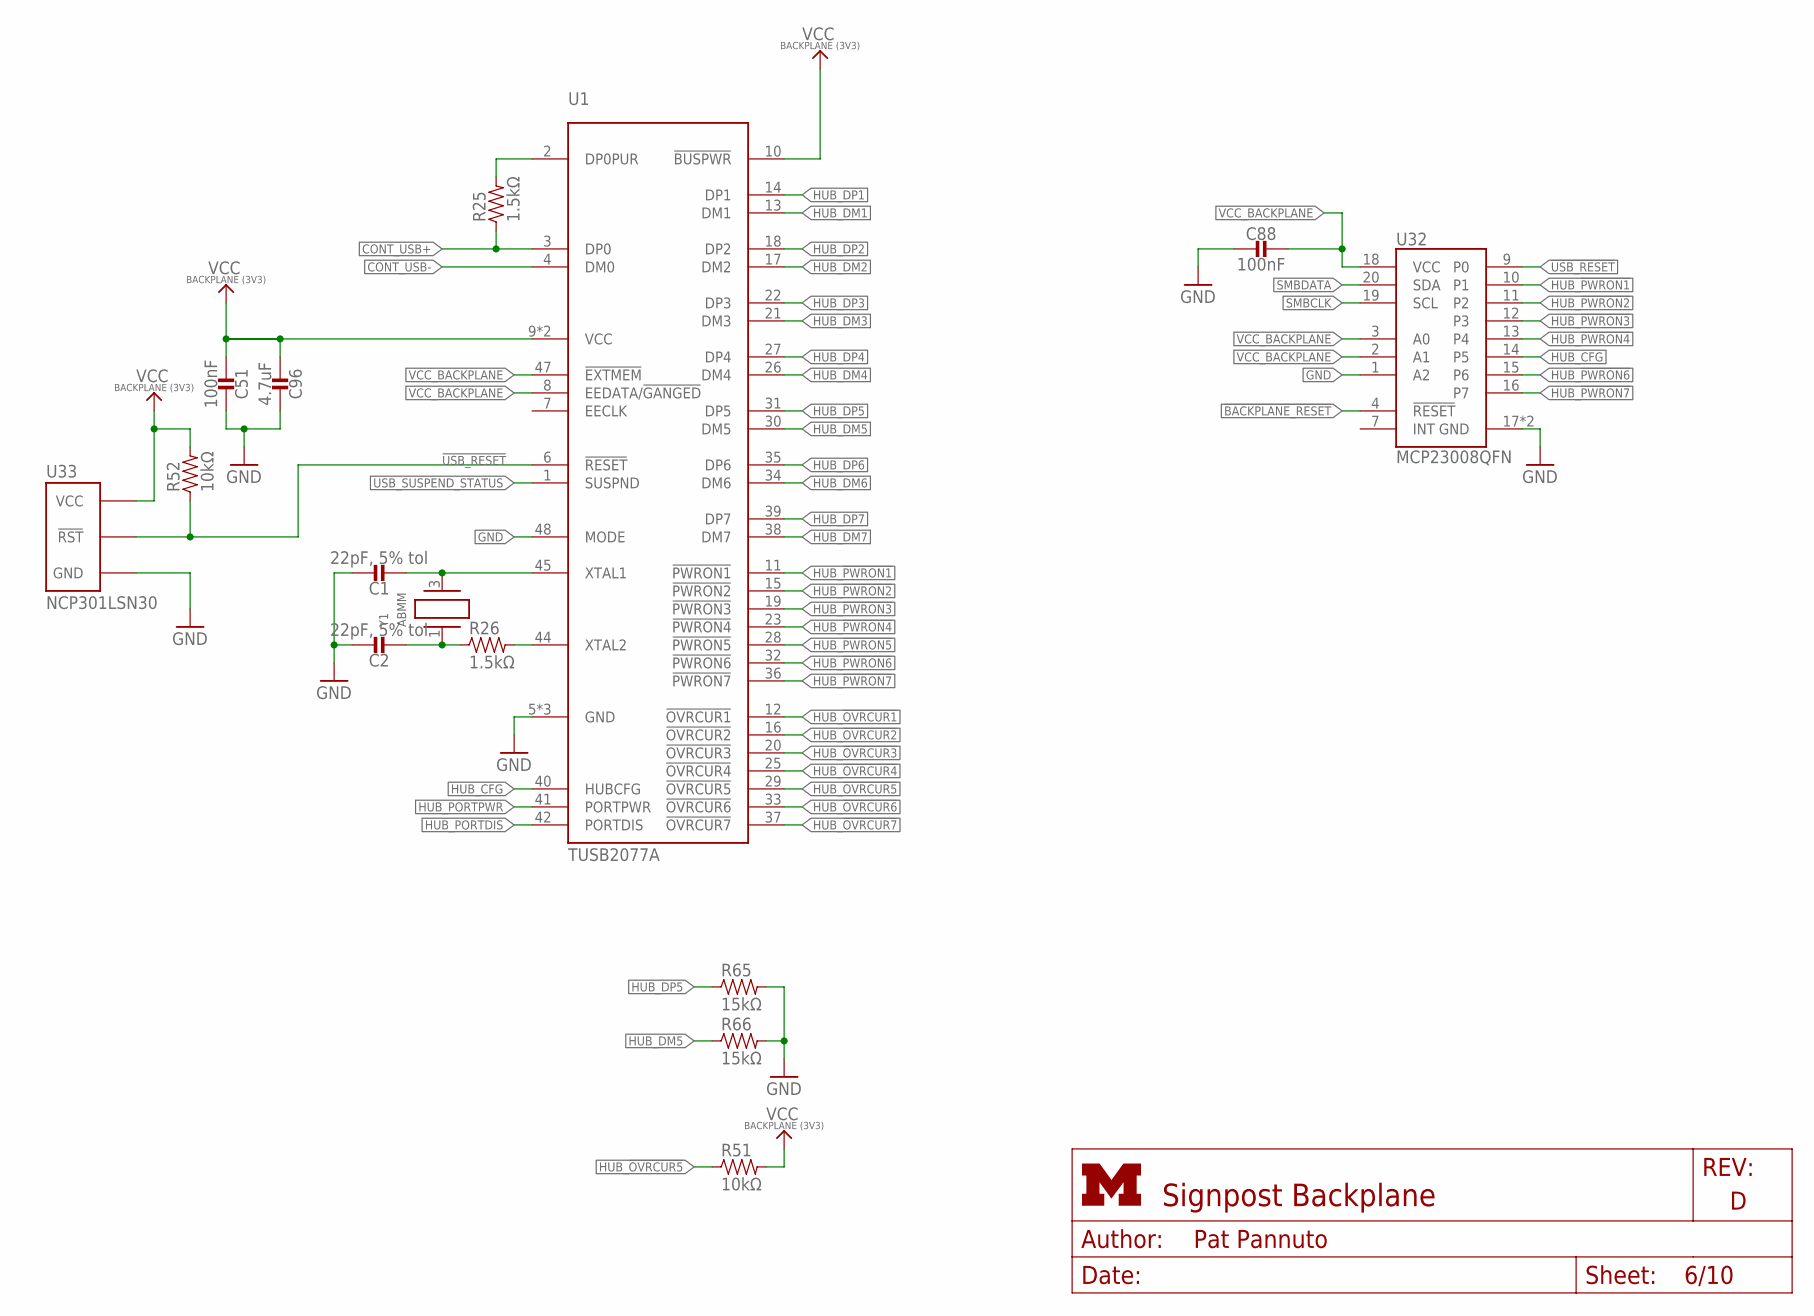
[picture p25: schematic backplane.sch, sheet 6, USB Hub]

Parts:
C1, C2: 22pF, 5% tol; 0603_CAP; DIGIKEY 1276-1023-1-ND
C51, C88: 100nF; 0603_CAP
C96: 4.7uF; 0603_CAP
R25, R26: 1.5kΩ; 0603-RES
R51, R52: 10kΩ; 0603-RES
R65, R66: 15kΩ; 0603-RES
U1: TUSB2077A; LQFP-48
U32: MCP23008QFN; QFN-20-4MM
U33: NCP301LSN30; SOT23-5
Y1: ABMM

Connections:
!BACKPLANE_RESET: U32.4 (!RESET); also elsewhere on the board
!USB_RESET: R52.1, U1.6 (!RESET), U32.9 (P0), U33.1 (!RST)
CONT_USB+: R25.1, U1.3 (DP0); also elsewhere on the board
CONT_USB-: U1.4 (DM0); also elsewhere on the board
GND: C1.1, C2.1, C51.1, C88.2, C96.1, R65.2, R66.2, U1.5 (GND), U1.24 (GND), U1.43 (GND), U1.48 (MODE), U32.1 (A2), U32.17 (GND), U32.GND, U33.3 (GND); also elsewhere on the board
HUB_!OVRCUR1: U1.12 (!OVRCUR1); also elsewhere on the board
HUB_!OVRCUR2: U1.16 (!OVRCUR2); also elsewhere on the board
HUB_!OVRCUR3: U1.20 (!OVRCUR3); also elsewhere on the board
HUB_!OVRCUR4: U1.25 (!OVRCUR4); also elsewhere on the board
HUB_!OVRCUR5: R51.1, U1.29 (!OVRCUR5)
HUB_!OVRCUR6: U1.33 (!OVRCUR6); also elsewhere on the board
HUB_!OVRCUR7: U1.37 (!OVRCUR7); also elsewhere on the board
HUB_!PWRON1: U1.11 (!PWRON1), U32.10 (P1); also elsewhere on the board
HUB_!PWRON2: U1.15 (!PWRON2), U32.11 (P2); also elsewhere on the board
HUB_!PWRON3: U1.19 (!PWRON3), U32.12 (P3); also elsewhere on the board
HUB_!PWRON4: U1.23 (!PWRON4), U32.13 (P4); also elsewhere on the board
HUB_!PWRON5: U1.28 (!PWRON5)
HUB_!PWRON6: U1.32 (!PWRON6), U32.15 (P6); also elsewhere on the board
HUB_!PWRON7: U1.36 (!PWRON7), U32.16 (P7); also elsewhere on the board
HUB_CFG: U1.40 (HUBCFG), U32.14 (P5); also elsewhere on the board
HUB_DM1: U1.13 (DM1); also elsewhere on the board
HUB_DM2: U1.17 (DM2); also elsewhere on the board
HUB_DM3: U1.21 (DM3); also elsewhere on the board
HUB_DM4: U1.26 (DM4); also elsewhere on the board
HUB_DM5: R66.1, U1.30 (DM5)
HUB_DM6: U1.34 (DM6); also elsewhere on the board
HUB_DM7: U1.38 (DM7); also elsewhere on the board
HUB_DP1: U1.14 (DP1); also elsewhere on the board
HUB_DP2: U1.18 (DP2); also elsewhere on the board
HUB_DP3: U1.22 (DP3); also elsewhere on the board
HUB_DP4: U1.27 (DP4); also elsewhere on the board
HUB_DP5: R65.1, U1.31 (DP5)
HUB_DP6: U1.35 (DP6); also elsewhere on the board
HUB_DP7: U1.39 (DP7); also elsewhere on the board
HUB_PORTDIS: U1.42 (PORTDIS); also elsewhere on the board
HUB_PORTPWR: U1.41 (PORTPWR); also elsewhere on the board
unnamed: R25.2, U1.2 (DP0PUR)
unnamed: C2.2, R26.1, Y1.1
unnamed: C1.2, U1.45 (XTAL1), Y1.3 (2)
unnamed: R26.2, U1.44 (XTAL2)
SMBCLK: U32.19 (SCL); also elsewhere on the board
SMBDATA: U32.20 (SDA); also elsewhere on the board
USB_SUSPEND_STATUS: U1.1 (SUSPND); also elsewhere on the board
VCC_BACKPLANE: C51.2, C88.1, C96.2, R51.2, R52.2, U1.8 (EEDATA/!GANGED), U1.9 (VCC), U1.10 (!BUSPWR), U1.46 (VCC), U1.47 (!EXTMEM), U32.2 (A1), U32.3 (A0), U32.18 (VCC), U33.2 (VCC); also elsewhere on the board
