lab11/signpost/hardware/radio_module/rev_c/macrofab_compliant/radio_module.brd

## EAGLE design hardware/radio_module/rev_c/macrofab_compliant/radio_module.brd (2017-09-06)

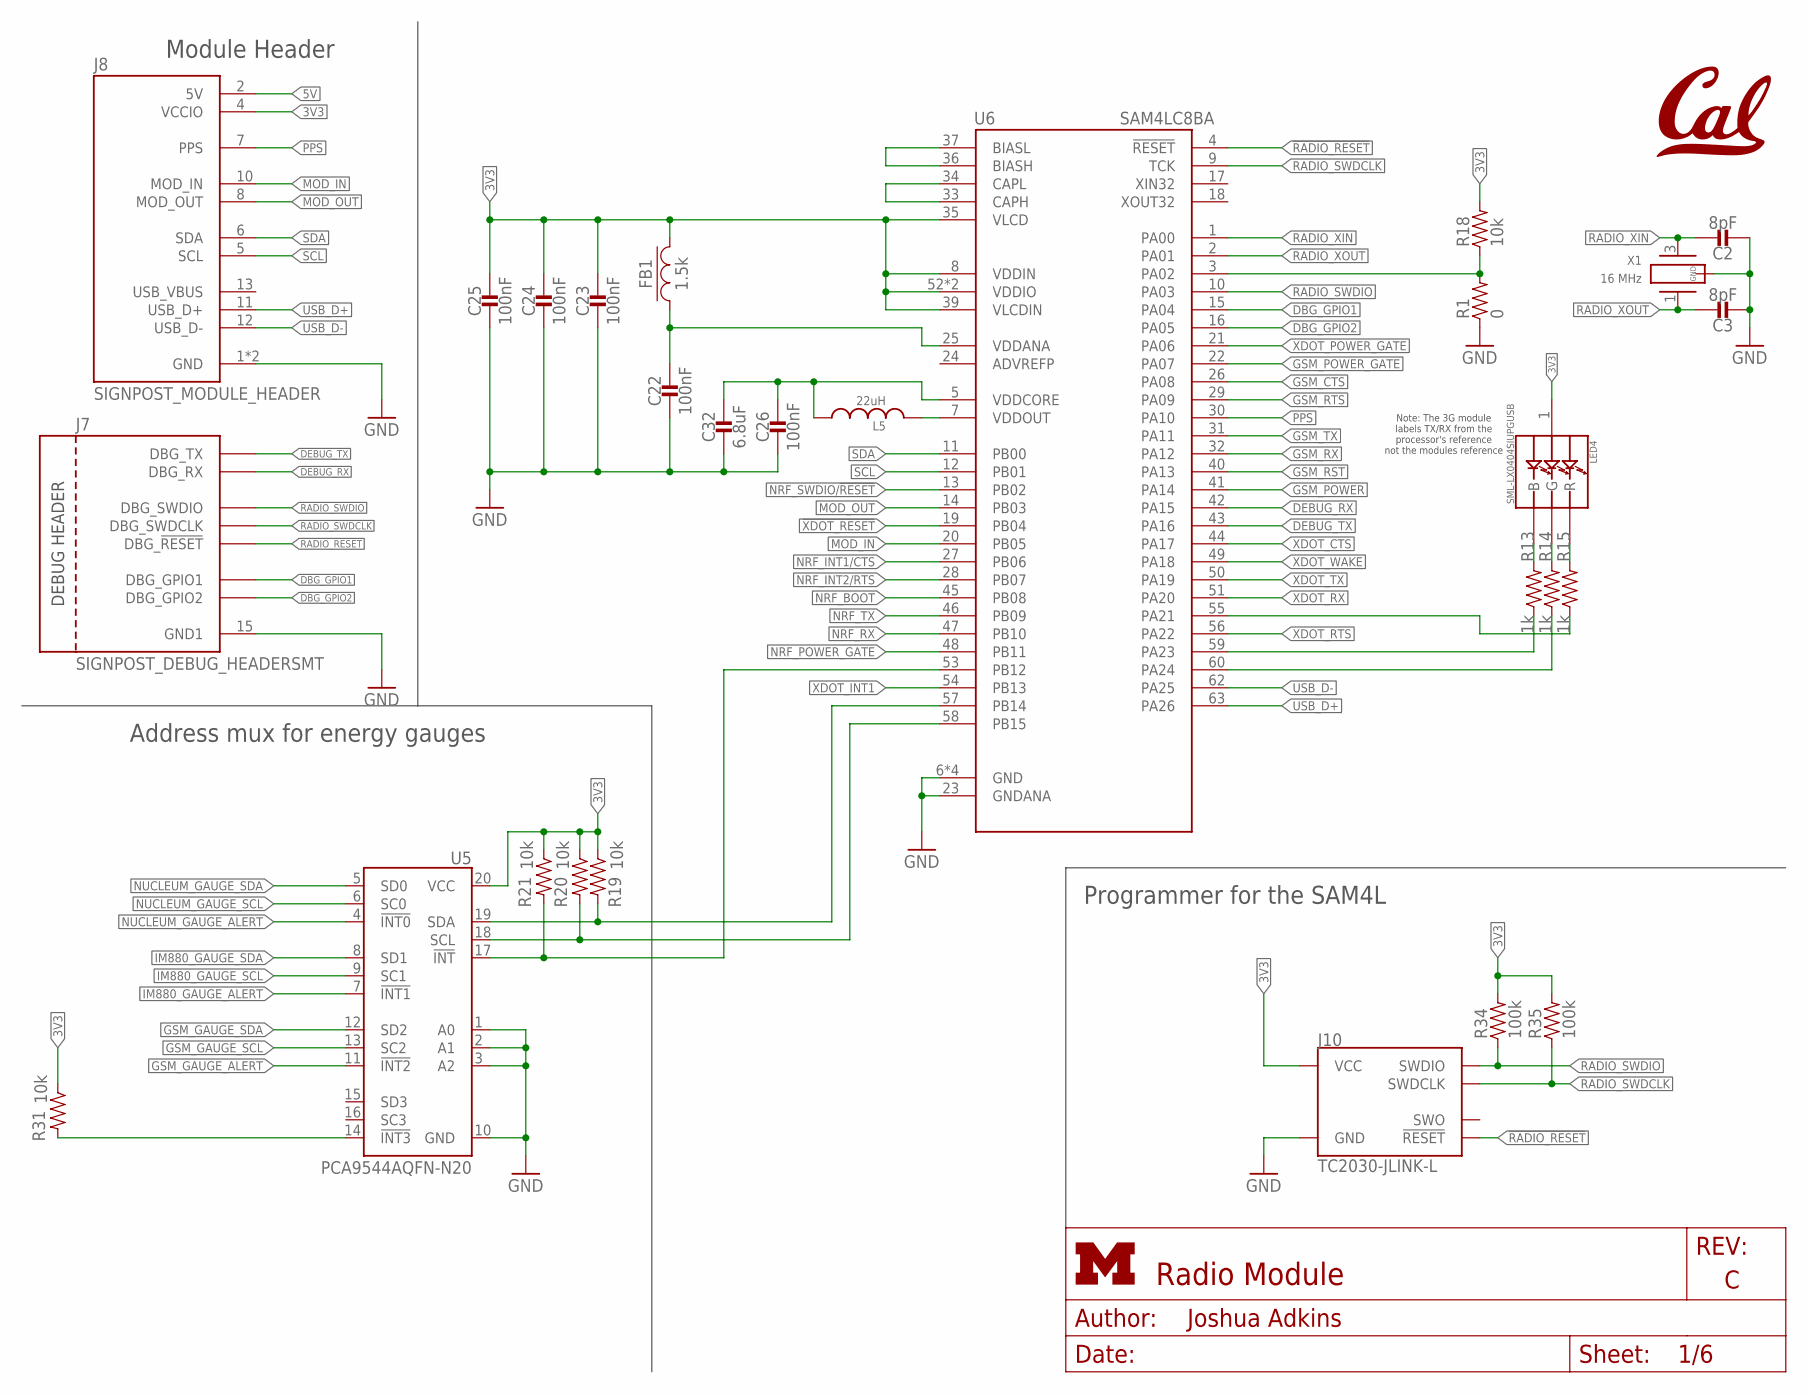
[picture p31: schematic radio_module.sch, sheet 1, Module Headers and SAM4L]

Parts:
C2, C3: 8pF; 0402_CAP; MPN GRM1555C1H8R0BA01D; DIGIKEY 490-8230-1-ND
C22, C23, C24, C25, C26: 100nF; 0402_CAP; MPN GRM155R71A104JA01D; DIGIKEY 490-10777-1-ND
C32: 6.8uF; 0402_CAP; MPN ZRB15XR61A475KE01D; DIGIKEY 490-13252-1-ND
FB1: 1.5k; 0402_CAP; MPN MMZ1005Y152CT000; DIGIKEY 445-2158-1-ND
J7: SIGNPOST_DEBUG_HEADERSMT; SIGNPOST_DEBUG_HEADER_SMT
J8: SIGNPOST_MODULE_HEADER
J10: TC2030-JLINK-L; TC2030-IDC
L5: 22uH; 1212
LED4: SML-LX0404SIUPGUSB; 1MM_SQ_4PAD
R1: 0; 0402_RES; MPN RC0402JR-070RL; DIGIKEY 311-0.0JRCT-ND
R13, R14, R15: 1k; 0402_RES; MPN RC0402JR-071KL; DIGIKEY 311-1.0KJRCT-ND
R18, R19, R20, R21, R31: 10k; 0402_RES; MPN RC0402JR-0710KL; DIGIKEY 311-10KJRCT-ND
R34, R35: 100k; 0402_RES; MPN RC0402FR-07100KL; DIGIKEY 311-100KLRCT-ND
U5: PCA9544AQFN-N20; QFN-N20
U6: SAM4LC8BA; QFN-64-9MM; DIGIKEY ATSAM4LC8BA-MU
U$1: UCB_CAL100MIL; UCB_CAL_100MIL
X1: 16 MHz; FHXXX

Connections:
3V3: C23.1, C24.1, C25.1, FB1.2, J8.4 (VCCIO), J10.1 (VCC), LED4.1 (VDD), R18.2, R19.1, R20.1, R21.1, R31.1, R34.2, R35.2, U5.20 (VCC), U6.8 (VDDIN), U6.35 (VLCD), U6.39 (VLCDIN), U6.52 (VDDIO), U6.61 (VDDIO); also elsewhere on the board
5V: J8.2 (5V); also elsewhere on the board
!RADIO_RESET: J7.20 (DBG_!RESET), J10.3 (!RESET), U6.4 (!RESET)
!XDOT_RESET: U6.19 (PB04); also elsewhere on the board
CONTROLLER_BUCK/LDO_N: R1.2, R18.1, U6.3 (PA02)
DBG_GPIO1: J7.16 (DBG_GPIO1), U6.15 (PA04)
DBG_GPIO2: J7.19 (DBG_GPIO2), U6.16 (PA05)
DEBUG_RX: J7.18 (DBG_RX), U6.42 (PA15)
DEBUG_TX: J7.17 (DBG_TX), U6.43 (PA16)
GND: C2.2, C3.2, C22.2, C23.2, C24.2, C25.2, C26.2, C32.2, J7.15 (GND1), J8.1 (GND), J8.14 (GND), J10.5 (GND), R1.1, U5.1 (A0), U5.2 (A1), U5.3 (A2), U5.10 (GND), U6.6 (GND), U6.23 (GNDANA), U6.38 (GND), U6.64 (GND), U6.GND, X1.2 (GND), X1.4 (GND); also elsewhere on the board
GSM_CTS: U6.26 (PA08); also elsewhere on the board
GSM_GAUGE_ALERT: U5.11 (!INT2); also elsewhere on the board
GSM_GAUGE_SCL: U5.13 (SC2); also elsewhere on the board
GSM_GAUGE_SDA: U5.12 (SD2); also elsewhere on the board
GSM_POWER: U6.41 (PA14); also elsewhere on the board
GSM_POWER_GATE: U6.22 (PA07); also elsewhere on the board
GSM_RST: U6.40 (PA13); also elsewhere on the board
GSM_RTS: U6.29 (PA09); also elsewhere on the board
GSM_RX: U6.32 (PA12); also elsewhere on the board
GSM_TX: U6.31 (PA11); also elsewhere on the board
IM880_GAUGE_ALERT: U5.7 (!INT1); also elsewhere on the board
IM880_GAUGE_SCL: U5.9 (SC1); also elsewhere on the board
IM880_GAUGE_SDA: U5.8 (SD1); also elsewhere on the board
MOD_IN: J8.10 (MOD_IN), U6.20 (PB05)
MOD_OUT: J8.8 (MOD_OUT), U6.14 (PB03)
unnamed: R21.2, U5.17 (!INT), U6.53 (PB12)
unnamed: R31.2, U5.14 (!INT3)
unnamed: R13.1, U6.59 (PA23)
unnamed: LED4.3 (B), R13.2
unnamed: L5.P$2 (2), U6.7 (VDDOUT)
unnamed: LED4.4 (G), R14.2
unnamed: LED4.2 (R), R15.2
unnamed: R14.1, U6.60 (PA24)
unnamed: R15.1, U6.55 (PA21)
unnamed: C22.1, FB1.1, U6.25 (VDDANA)
unnamed: C26.1, C32.1, L5.P$1 (1), U6.5 (VDDCORE)
unnamed: U6.36 (BIASH), U6.37 (BIASL)
unnamed: U6.33 (CAPH), U6.34 (CAPL)
NRF_BOOT: U6.45 (PB08); also elsewhere on the board
NRF_INT1/CTS: U6.27 (PB06); also elsewhere on the board
NRF_INT2/RTS: U6.28 (PB07); also elsewhere on the board
NRF_POWER_GATE: U6.48 (PB11); also elsewhere on the board
NRF_RX: U6.47 (PB10); also elsewhere on the board
NRF_SWDIO/!RESET: U6.13 (PB02); also elsewhere on the board
NRF_TX: U6.46 (PB09); also elsewhere on the board
NUCLEUM_GAUGE_ALERT: U5.4 (!INT0); also elsewhere on the board
NUCLEUM_GAUGE_SCL: U5.6 (SC0); also elsewhere on the board
NUCLEUM_GAUGE_SDA: U5.5 (SD0); also elsewhere on the board
PPS: J8.7 (PPS), U6.30 (PA10)
RADIO_SWDCLK: J7.21 (DBG_SWDCLK), J10.4 (SWDCLK), R35.1, U6.9 (TCK)
RADIO_SWDIO: J7.22 (DBG_SWDIO), J10.2 (SWDIO), R34.1, U6.10 (PA03)
RADIO_XIN: C2.1, U6.1 (PA00), X1.3 (2)
RADIO_XOUT: C3.1, U6.2 (PA01), X1.1
SCL: J8.5 (SCL), U6.12 (PB01)
SCL_INTERNAL: R20.2, U5.18 (SCL), U6.58 (PB15)
SDA: J8.6 (SDA), U6.11 (PB00)
SDA_INTERNAL: R19.2, U5.19 (SDA), U6.57 (PB14)
USB_D+: J8.11 (USB_D+), U6.63 (PA26)
USB_D-: J8.12 (USB_D-), U6.62 (PA25)
XDOT_CTS: U6.44 (PA17); also elsewhere on the board
XDOT_INT1: U6.54 (PB13); also elsewhere on the board
XDOT_POWER_GATE: U6.21 (PA06); also elsewhere on the board
XDOT_RTS: U6.56 (PA22); also elsewhere on the board
XDOT_RX: U6.51 (PA20); also elsewhere on the board
XDOT_TX: U6.50 (PA19); also elsewhere on the board
XDOT_WAKE: U6.49 (PA18); also elsewhere on the board

Notes on the sheet:
Programmer for the SAM4L
Address mux for energy gauges
Module Header
Note: The 3G module labels TX/RX from the processor's reference not the modules reference
