lab11/signpost/hardware/radio_module/rev_c/macrofab_compliant/radio_module.brd

## EAGLE design hardware/radio_module/rev_c/macrofab_compliant/radio_module.brd (continued)

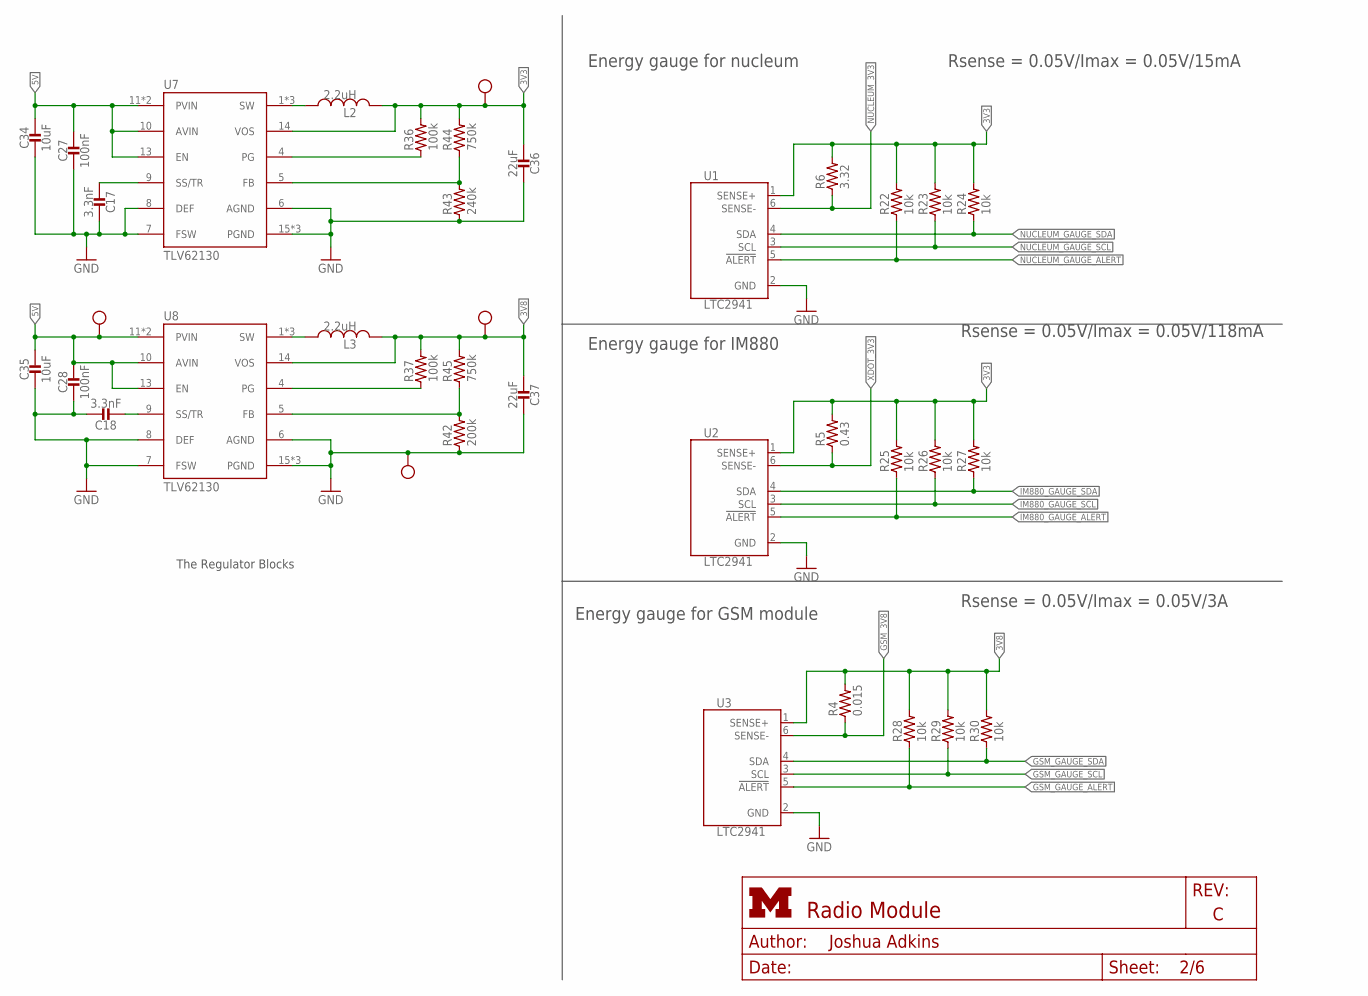
[picture p32: schematic radio_module.sch, sheet 2, Regulators and power metering]

Parts:
C17, C18: 3.3nF; 0402_CAP; MPN GRM155R71H332KA01D; DIGIKEY 490-3248-1-ND
C27, C28: 100nF; 0402_CAP; MPN GRM155R71A104JA01D; DIGIKEY 490-10777-1-ND
C34, C35: 10uF; 0402_CAP; MPN GRM155C80J106ME11D; DIGIKEY 490-13233-1-ND
C36, C37: 22uF; 0402_CAP; MPN CL05A226MQ5QUNC; DIGIKEY 1276-6834-1-ND
L2, L3: 2.2uH; IHL-1212BZ-11
R4: 0.015; 0603-RES; MPN RL0816T-R015-F; DIGIKEY 408-1406-1-ND
R5: 0.43; 0402_RES; MPN ERJ-2BQFR43X; DIGIKEY P.43AKCT-ND
R6: 3.32; 0402_RES; MPN CRCW04023R32FKED; DIGIKEY 541-3.32LLCT-ND
R22, R23, R24, R25, R26, R27, R28, R29, R30: 10k; 0402_RES; MPN RC0402JR-0710KL; DIGIKEY 311-10KJRCT-ND
R36, R37: 100k; 0402_RES; MPN RC0402FR-07100KL; DIGIKEY 311-100KLRCT-ND
R42: 200k; 0402_RES; MPN ERJ-2RKF2003X; DIGIKEY P200KLCT-ND
R43: 240k; 0402_RES; MPN RC0402JR-07240KL; DIGIKEY YAG3291CT-ND
R44, R45: 750k; 0402_RES; MPN RC0402FR-07750KL; DIGIKEY YAG3228CT-ND
TP1, TP2, TP3, TP4: TEST_POINT_0.040IN; TESTPOINT_0.040IN
U1, U2, U3: LTC2941; DFN-6-2MMX3MM
U7, U8: TLV62130; TQFN-16/3MM

Connections:
3V3: C36.2, L2.P$2 (2), R5.2, R6.2, R22.2, R23.2, R24.2, R25.2, R26.2, R27.2, R36.2, R44.2, TP1.TESTPOINT, U1.1 (SENSE+), U2.1 (SENSE+), U7.14 (VOS); also elsewhere on the board
3V8: C37.2, L3.P$2 (2), R4.2, R28.2, R29.2, R30.2, R37.2, R45.2, TP2.TESTPOINT, U3.1 (SENSE+), U8.14 (VOS)
3V8SWOUT: L3.P$1 (1), U8.1 (SW), U8.2 (SW), U8.3 (SW)
3VSWOUT: L2.P$1 (1), U7.1 (SW), U7.2 (SW), U7.3 (SW)
5V: C27.1, C28.1, C34.1, C35.1, TP4.TESTPOINT, U7.10 (AVIN), U7.11 (PVIN), U7.12 (PVIN), U7.13 (EN), U8.10 (AVIN), U8.11 (PVIN), U8.12 (PVIN), U8.13 (EN); also elsewhere on the board
GND: C17.1, C18.1, C27.2, C28.2, C34.2, C35.2, C36.1, C37.1, R42.1, R43.1, TP3.TESTPOINT, U1.2 (GND), U2.2 (GND), U3.2 (GND), U7.6 (AGND), U7.7 (FSW), U7.8 (DEF), U7.15 (PGND), U7.16 (PGND), U7.GND, U8.6 (AGND), U8.7 (FSW), U8.8 (DEF), U8.15 (PGND), U8.16 (PGND), U8.GND; also elsewhere on the board
GSM_3V8: R4.1, U3.6 (SENSE-); also elsewhere on the board
GSM_GAUGE_ALERT: R28.1, U3.5 (!ALERT); also elsewhere on the board
GSM_GAUGE_SCL: R29.1, U3.3 (SCL); also elsewhere on the board
GSM_GAUGE_SDA: R30.1, U3.4 (SDA); also elsewhere on the board
IM880_GAUGE_ALERT: R25.1, U2.5 (!ALERT); also elsewhere on the board
IM880_GAUGE_SCL: R26.1, U2.3 (SCL); also elsewhere on the board
IM880_GAUGE_SDA: R27.1, U2.4 (SDA); also elsewhere on the board
unnamed: C17.2, U7.9 (SS/TR)
unnamed: R36.1, U7.4 (PG)
unnamed: R43.2, R44.1, U7.5 (FB)
unnamed: C18.2, U8.9 (SS/TR)
unnamed: R37.1, U8.4 (PG)
unnamed: R42.2, R45.1, U8.5 (FB)
NUCLEUM_3V3: R6.1, U1.6 (SENSE-); also elsewhere on the board
NUCLEUM_GAUGE_ALERT: R22.1, U1.5 (!ALERT); also elsewhere on the board
NUCLEUM_GAUGE_SCL: R23.1, U1.3 (SCL); also elsewhere on the board
NUCLEUM_GAUGE_SDA: R24.1, U1.4 (SDA); also elsewhere on the board
XDOT_3V3: R5.1, U2.6 (SENSE-); also elsewhere on the board

Notes on the sheet:
Energy gauge for GSM module
Energy gauge for IM880
Energy gauge for nucleum
Rsense = 0.05V/Imax = 0.05V/15mA
Rsense = 0.05V/Imax = 0.05V/118mA
Rsense = 0.05V/Imax = 0.05V/3A
The Regulator Blocks

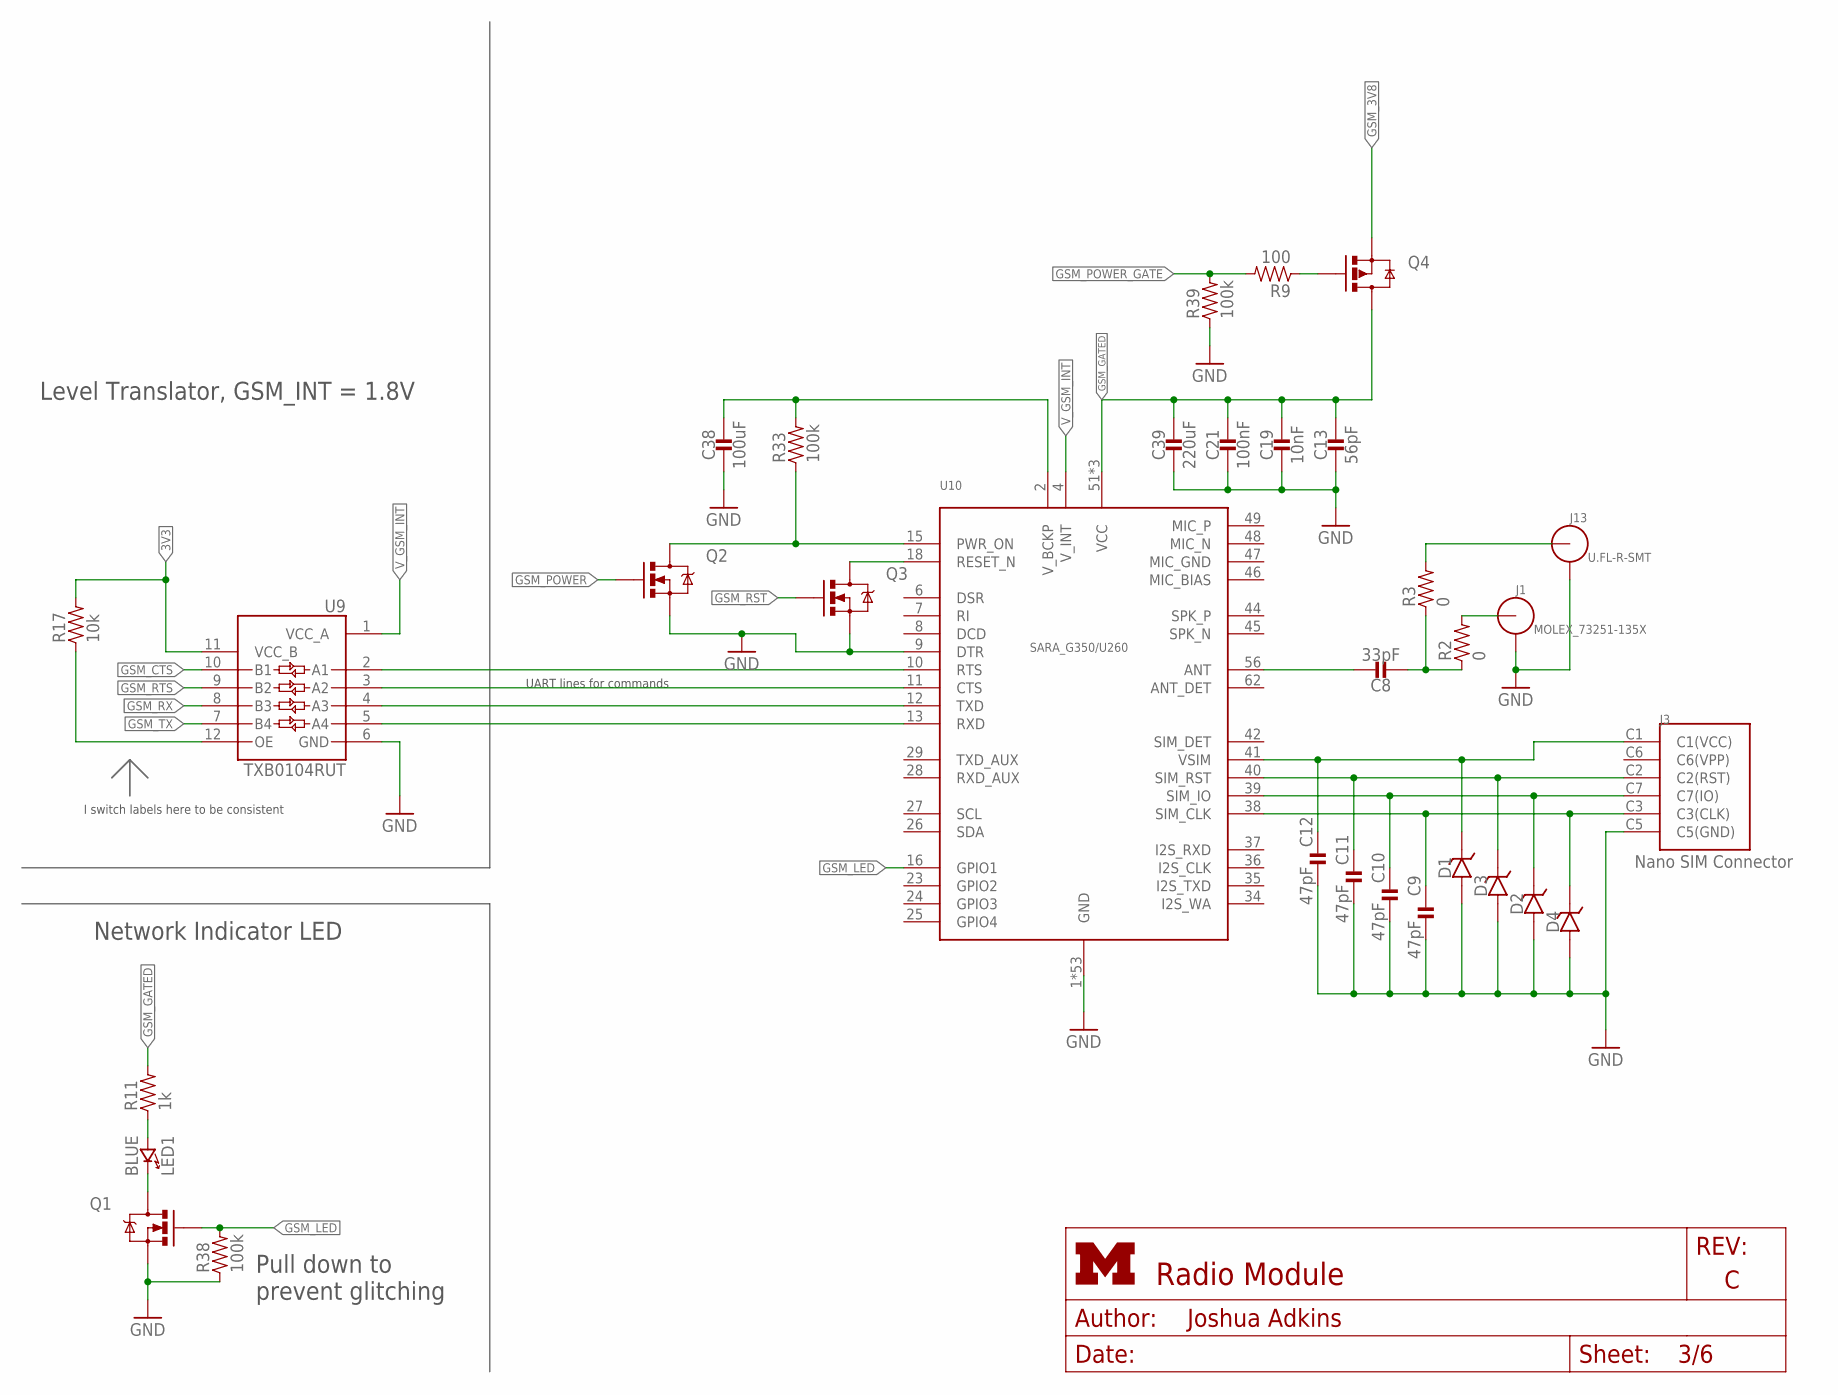
[picture p33: schematic radio_module.sch, sheet 3, 3G Radio Module]

Parts:
C8: 33pF; 0603_CAP; MPN 251R14S330JV4T; DIGIKEY 712-1342-1-ND
C9, C10, C11, C12: 47pF; 0402_CAP; MPN GRM1555C1H470FA01D; DIGIKEY 490-6241-1-ND
C13: 56pF; 0402_CAP; MPN GRM1555C1H560JA01D; DIGIKEY 490-1288-1-ND
C19: 10nF; 0402_CAP; MPN GRM155R71H103KA88D; DIGIKEY 490-4516-1-ND
C21: 100nF; 0402_CAP; MPN GRM155R71A104JA01D; DIGIKEY 490-10777-1-ND
C38: 100uF; 0805_CAP; MPN GRM21BR60J107ME15L; DIGIKEY 490-13981-1-ND
C39: 220uF; 1210_CAP; MPN CL32A227MQVNNNE; DIGIKEY 1276-3375-1-ND
D1, D2, D3, D4: 14V; 0402_DIODE; MPN PESD0402-140; DIGIKEY PESD0402-140CT-ND
J1: MOLEX_73251-135X; SMA-J/PCB
J3: NANO_SIM; WURTH_NANO_SIM
J13: U.FL-R-SMT; U.FL_SMT
LED1: BLUE; LED-0603; MPN SML-D12M8WT86; DIGIKEY 511-1578-1-ND
Q1, Q2, Q3: MOSFET-NCHANNELSMD; SOT23-3; MPN 2N7002LT1G; DIGIKEY 2N7002LT1GOSCT-ND
Q4: SI223DDS; SOT23-3
R2, R3: 0; 0402_RES; MPN RC0402JR-070RL; DIGIKEY 311-0.0JRCT-ND
R9: 100; 0402_RES; MPN RC0402FR-07100RL; DIGIKEY 311-100LRCT-ND
R11: 1k; 0402_RES; MPN RC0402JR-071KL; DIGIKEY 311-1.0KJRCT-ND
R17: 10k; 0402_RES; MPN RC0402JR-0710KL; DIGIKEY 311-10KJRCT-ND
R33, R38, R39: 100k; 0402_RES; MPN RC0402FR-07100KL; DIGIKEY 311-100KLRCT-ND
U9: TXB0104RUT; UQFN-12
U10: UBLOX_SARA_G350; UBLOX_SARA_G3

Connections:
3V3: R17.2, U9.11 (VCC_B); also elsewhere on the board
GND: C9.2, C10.2, C11.2, C12.2, C13.2, C19.2, C21.2, C38.P$2 (2), C39.2, D1.ANODE, D2.ANODE, D3.ANODE, D4.ANODE, J1.2, J1.3, J1.4, J1.5, J3.C5 (C5(GND)), J13.GND1, J13.GND2, Q1.2 (S), Q2.2 (S), Q3.2 (S), R38.1, R39.1, U9.6 (GND), U10.1 (GND), U10.3 (GND), U10.5 (GND), U10.9 (DTR), U10.14 (GND), U10.20 (GND), U10.21 (GND), U10.22 (GND), U10.30 (GND), U10.32 (GND), U10.33 (GND), U10.43 (GND), U10.50 (GND), U10.54 (GND), U10.55 (GND), U10.57 (GND), U10.58 (GND), U10.59 (GND), U10.60 (GND), U10.61 (GND), U10.63 (GND), U10.64 (GND), U10.65 (GND), U10.66 (GND), U10.67 (GND), U10.68 (GND), U10.69 (GND), U10.70 (GND), U10.71 (GND), U10.72 (GND), U10.73 (GND), U10.74 (GND), U10.75 (GND), U10.76 (GND), U10.77 (GND), U10.78 (GND), U10.79 (GND), U10.80 (GND), U10.81 (GND), U10.82 (GND), U10.83 (GND), U10.84 (GND), U10.85 (GND), U10.86 (GND), U10.87 (GND), U10.88 (GND), U10.89 (GND), U10.90 (GND), U10.91 (GND), U10.92 (GND), U10.93 (GND), U10.94 (GND), U10.95 (GND), U10.96 (GND); also elsewhere on the board
GSM_3V8: Q4.2 (S); also elsewhere on the board
GSM_CTS: U9.10 (B1); also elsewhere on the board
GSM_GATED: C13.1, C19.1, C21.1, C39.1, Q4.3 (D), R11.2, U10.51 (VCC), U10.52 (VCC), U10.53 (VCC)
GSM_LED: Q1.1 (G), R38.2, U10.16 (GPIO1)
GSM_POWER: Q2.1 (G); also elsewhere on the board
GSM_POWER_GATE: R9.2, R39.2; also elsewhere on the board
GSM_RST: Q3.1 (G); also elsewhere on the board
GSM_RTS: U9.9 (B2); also elsewhere on the board
GSM_RX: U9.8 (B3); also elsewhere on the board
GSM_TX: U9.7 (B4); also elsewhere on the board
unnamed: C12.1, D1.CATHODE, J3.C1 (C1(VCC)), U10.41 (VSIM)
unnamed: C11.1, D3.CATHODE, J3.C2 (C2(RST)), U10.40 (SIM_RST)
unnamed: C10.1, D2.CATHODE, J3.C7 (C7(IO)), U10.39 (SIM_IO)
unnamed: C9.1, D4.CATHODE, J3.C3 (C3(CLK)), U10.38 (SIM_CLK)
unnamed: R17.1, U9.12 (OE)
unnamed: C8.1, U10.56 (ANT)
unnamed: J13.SIG (ANT), R3.2
unnamed: LED1.A (ANODE), R11.1
unnamed: U9.4 (A3), U10.12 (TXD)
unnamed: U9.5 (A4), U10.13 (RXD)
unnamed: LED1.C (CATHODE), Q1.3 (D)
unnamed: Q3.3 (D), U10.18 (RESET_N)
unnamed: C38.P$1 (1), R33.2, U10.2 (V_BCKP)
unnamed: Q2.3 (D), R33.1, U10.15 (PWR_ON)
unnamed: U9.3 (A2), U10.11 (CTS)
unnamed: U9.2 (A1), U10.10 (RTS)
unnamed: C8.2, R2.1, R3.1
unnamed: J1.1 (ANT), R2.2
unnamed: Q4.1 (G), R9.1
V_GSM_INT: U9.1 (VCC_A), U10.4 (V_INT)

Notes on the sheet:
Network Indicator LED
Level Translator, GSM_INT = 1.8V
I switch labels here to be consistent
Pull down to prevent glitching
UART lines for commands

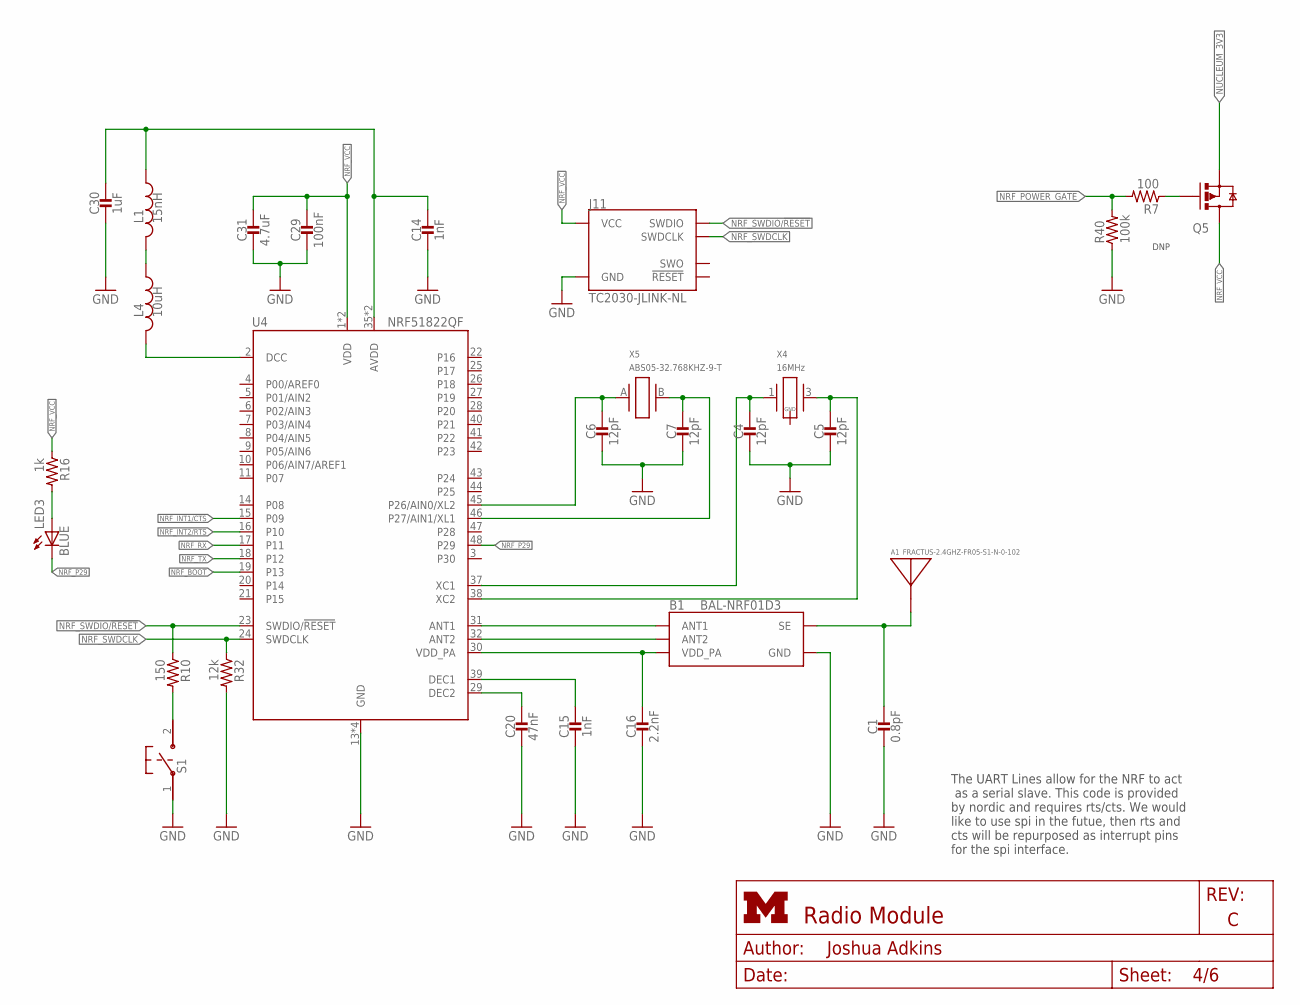
[picture p34: schematic radio_module.sch, sheet 4, Bluetooth Module]

Parts:
A1: FRACTUS-2.4GHZ-FR05-S1-N-0-102; FRACTUS-ANTENNA-FR05-S1-N-0-102
B1: BAL-NRF01D3
C1: 0.8pF; 0402_CAP; MPN GRM1555C1HR80BA01D; DIGIKEY 490-6269-1-ND
C4, C5, C6, C7: 12pF; 0402_CAP; MPN GRM1555C1H120GA01D; DIGIKEY 490-6197-1-ND
C14, C15: 1nF; 0402_CAP; MPN GRM155R71H102KA01D; DIGIKEY 490-1303-1-ND
C16: 2.2nF; 0402_CAP; MPN GRM155R71E222KA01D; DIGIKEY 490-5419-1-ND
C20: 47nF; 0402_CAP; MPN GRM155R71E473KA88D; DIGIKEY 490-3254-1-ND
C29: 100nF; 0402_CAP; MPN GRM155R71A104JA01D; DIGIKEY 490-10777-1-ND
C30: 1uF; 0402_CAP; MPN GRM155R60J105KE19D; DIGIKEY 490-1320-1-ND
C31: 4.7uF; 0402_CAP; MPN ZRB15XR61A475KE01D; DIGIKEY 490-13252-1-ND
J11: TC2030-JLINK-NL; TC2030-IDC-NL
L1: 15nH; 0402_CAP; MPN HK100515NJ-T; DIGIKEY 587-1521-1-ND
L4: 10uH; 0603_CAP; MPN LQM18FN100M00D; DIGIKEY 490-4025-1-ND
LED3: BLUE; LED-0603; MPN SML-D12M8WT86; DIGIKEY 511-1578-1-ND
Q5: SI223DDS; SOT23-3
R7: 100; 0402_RES; MPN RC0402FR-07100RL; DIGIKEY 311-100LRCT-ND
R10: 150; 0402_RES; MPN MCR01MRTF1500; DIGIKEY RHM150CDCT-ND
R16: 1k; 0402_RES; MPN RC0402JR-071KL; DIGIKEY 311-1.0KJRCT-ND
R32: 12k; 0402_RES; MPN MCR01MRTF1202; DIGIKEY RHM12.0KCDCT-ND
R40: 100k; 0402_RES; MPN RC0402FR-07100KL; DIGIKEY 311-100KLRCT-ND
S1: B3U-1000P
U4: NRF51822QF; QFN-48-6MM
X4: 16MHz; TXC-8Y; MPN 8Y-16.000MAAV-T; DIGIKEY 887-2003-1-ND
X5: ABS05-32.768KHZ-9-T; ABS05

Connections:
AVDD1: C14.1, C30.1, L1.1, U4.35 (AVDD), U4.36 (AVDD)
DCC1: L4.2, U4.2 (DCC)
GND: B1.GND, C1.2, C4.2, C5.2, C6.2, C7.2, C14.2, C15.2, C16.2, C20.2, C29.2, C30.2, C31.2, J11.5 (GND), R32.2, R40.1, S1.1, U4.13 (GND), U4.33 (GND), U4.34 (GND), U4.GND; also elsewhere on the board
unnamed: Q5.1 (G), R7.1
unnamed: B1.ANT1, U4.31 (ANT1)
unnamed: B1.ANT2, U4.32 (ANT2)
unnamed: A1.1, B1.SE, C1.1
unnamed: L1.2, L4.1
unnamed: C4.1, U4.37 (XC1), X4.1
unnamed: C5.1, U4.38 (XC2), X4.3 (2)
unnamed: C15.1, U4.39 (DEC1)
unnamed: C20.1, U4.29 (DEC2)
unnamed: LED3.A, R16.2
unnamed: R10.2, S1.2
NRF_A2: C7.1, U4.46 (P27/AIN1/XL1), X5.B (2)
NRF_A3: C6.1, U4.45 (P26/AIN0/XL2), X5.A (1)
NRF_BOOT: U4.19 (P13); also elsewhere on the board
NRF_INT1/CTS: U4.15 (P09); also elsewhere on the board
NRF_INT2/RTS: U4.16 (P10); also elsewhere on the board
NRF_P29: LED3.C, U4.48 (P29)
NRF_POWER_GATE: R7.2, R40.2; also elsewhere on the board
NRF_RX: U4.17 (P11); also elsewhere on the board
NRF_SWDCLK: J11.4 (SWDCLK), R32.1, U4.24 (SWDCLK)
NRF_SWDIO/!RESET: J11.2 (SWDIO), R10.1, U4.23 (SWDIO/!RESET); also elsewhere on the board
NRF_TX: U4.18 (P12); also elsewhere on the board
NRF_VCC: C29.1, C31.1, J11.1 (VCC), Q5.3 (D), R16.1, U4.1 (VDD), U4.12 (VDD)
NUCLEUM_3V3: Q5.2 (S); also elsewhere on the board
VDD_PA1: B1.VCC (VDD_PA), C16.1, U4.30 (VDD_PA)

Notes on the sheet:
The UART Lines allow for the NRF to act as a serial slave. This code is provided by nordic and requires rts/cts. We would like to use spi in the futue, then rts and cts will be repurposed as interrupt pins for the spi interface.
DNP

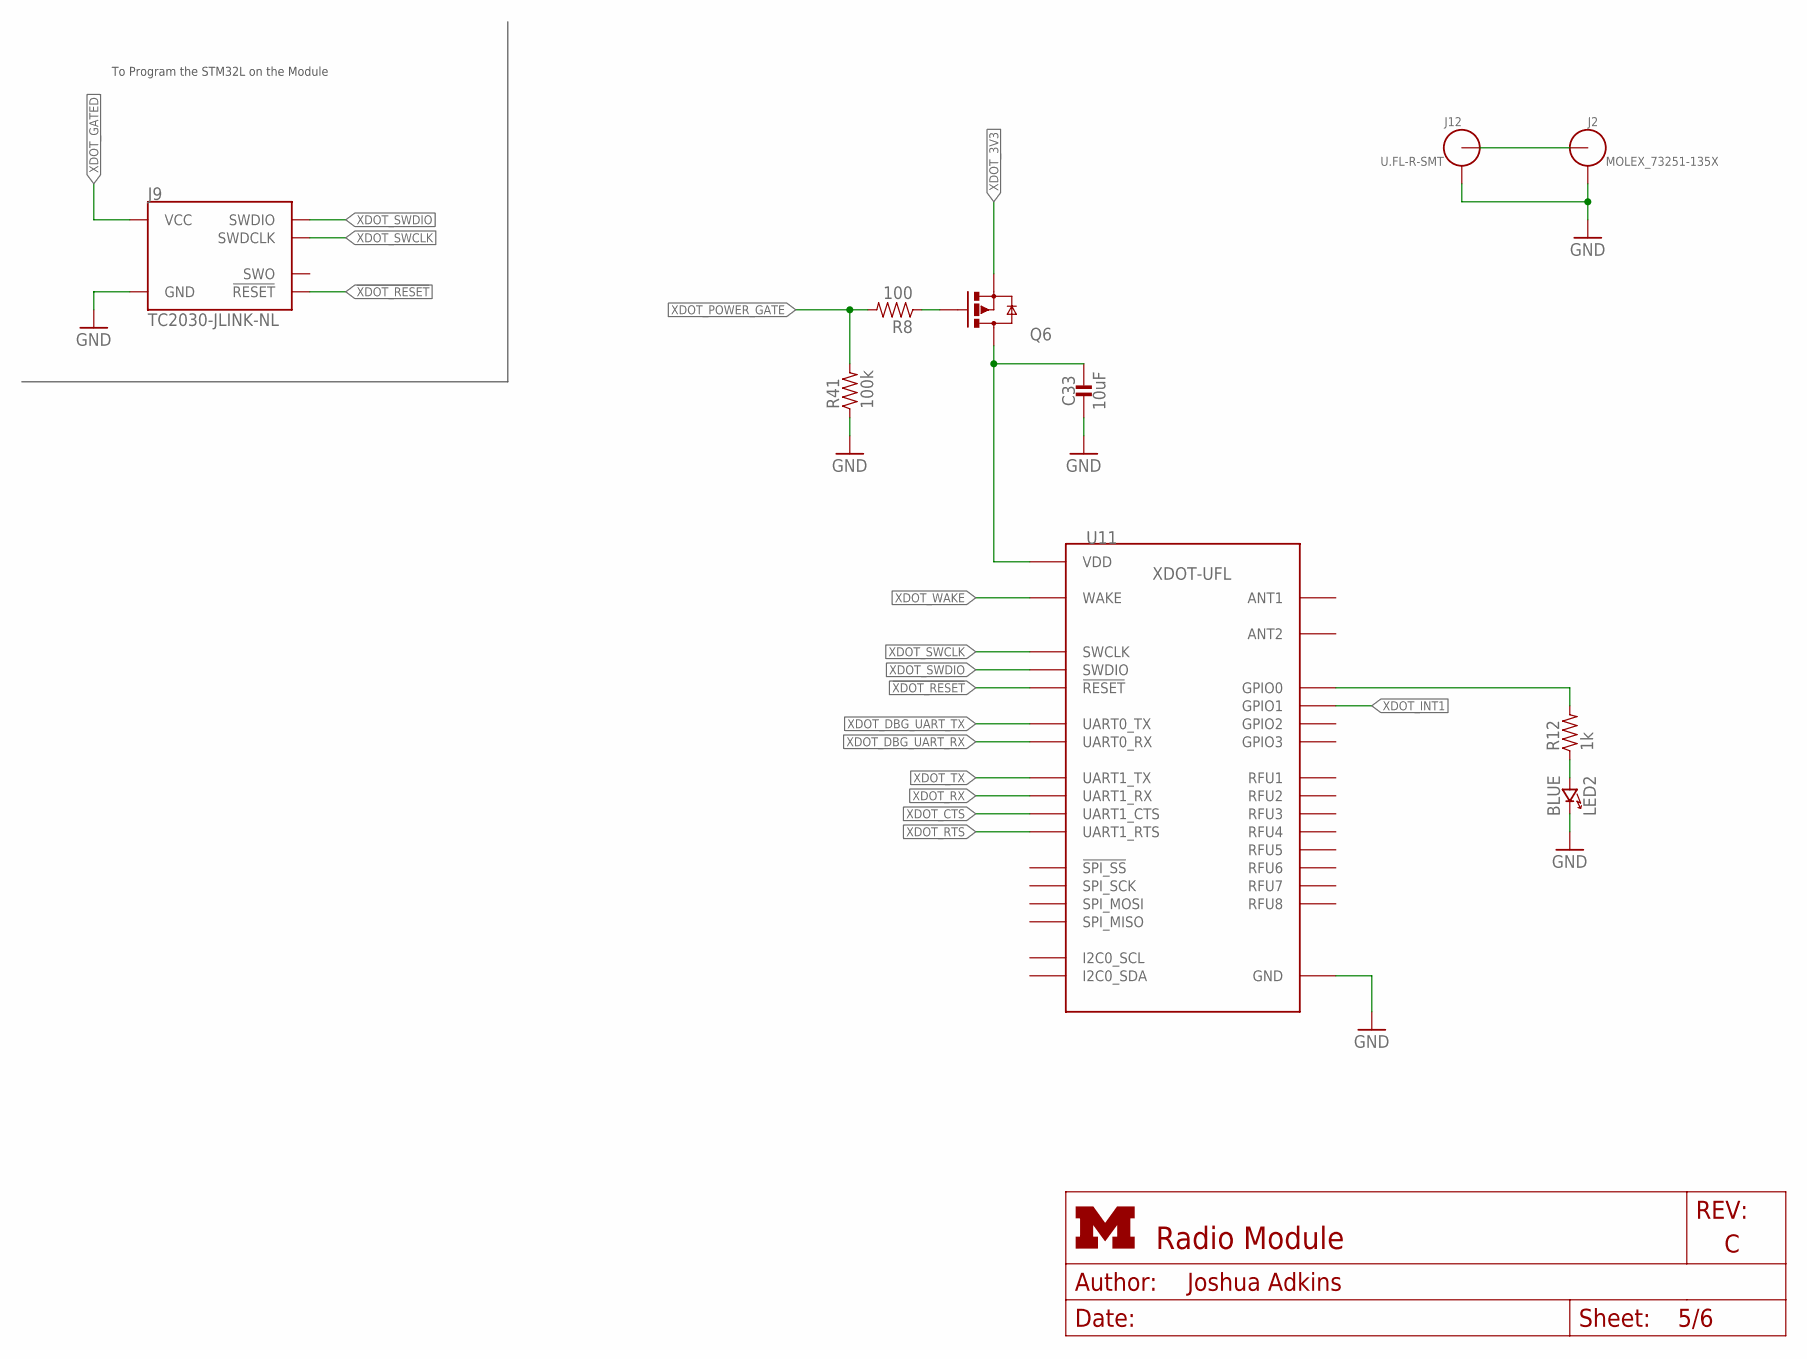
[picture p35: schematic radio_module.sch, sheet 5, Lora Module and Programming]

Parts:
C33: 10uF; 0402_CAP; MPN GRM155C80J106ME11D; DIGIKEY 490-13233-1-ND
J2: MOLEX_73251-135X; SMA-J/PCB
J9: TC2030-JLINK-NL; TC2030-IDC-NL
J12: U.FL-R-SMT; U.FL_SMT
LED2: BLUE; LED-0603; MPN SML-D12M8WT86; DIGIKEY 511-1578-1-ND
Q6: SI223DDS; SOT23-3
R8: 100; 0402_RES; MPN RC0402FR-07100RL; DIGIKEY 311-100LRCT-ND
R12: 1k; 0402_RES; MPN RC0402JR-071KL; DIGIKEY 311-1.0KJRCT-ND
R41: 100k; 0402_RES; MPN RC0402FR-07100KL; DIGIKEY 311-100KLRCT-ND
U11: XDOT_MODULE

Connections:
!XDOT_RESET: J9.3 (!RESET), U11.P$33 (!RESET); also elsewhere on the board
GND: C33.2, J2.2, J2.3, J2.4, J2.5, J9.5 (GND), J12.GND1, J12.GND2, LED2.C (CATHODE), R41.1, U11.P$1 (GND), U11.P$5 (GND), U11.P$17 (GND), U11.P$20 (GND), U11.P$35 (GND), U11.P$36 (GND), U11.P$38 (GND), U11.P$39 (GND), U11.P$40 (GND), U11.P$41 (GND), U11.P$42 (GND), U11.P$43 (GND), U11.P$44 (GND), U11.P$45 (GND), U11.P$46 (GND), U11.P$48 (GND), U11.P$49 (GND), U11.P$50 (GND), U11.P$51 (GND), U11.P$52 (GND), U11.P$53 (GND), U11.P$54 (GND), U11.P$55 (GND), U11.P$56 (GND), U11.P$57 (GND), U11.P$58 (GND); also elsewhere on the board
unnamed: J2.1 (ANT), J12.SIG (ANT)
unnamed: LED2.A (ANODE), R12.1
unnamed: Q6.1 (G), R8.1
XDOT_3V3: Q6.2 (S); also elsewhere on the board
XDOT_CTS: U11.P$32 (UART1_CTS); also elsewhere on the board
XDOT_DBG_UART_RX: U11.P$16 (UART0_RX); also elsewhere on the board
XDOT_DBG_UART_TX: U11.P$15 (UART0_TX); also elsewhere on the board
XDOT_GATED: C33.1, J9.1 (VCC), Q6.3 (D), U11.P$3 (VDD), U11.P$4 (VDD)
XDOT_GPIO0: R12.2, U11.P$26 (GPIO0)
XDOT_INT1: U11.P$25 (GPIO1); also elsewhere on the board
XDOT_POWER_GATE: R8.2, R41.2; also elsewhere on the board
XDOT_RTS: U11.P$31 (UART1_RTS); also elsewhere on the board
XDOT_RX: U11.P$14 (UART1_RX); also elsewhere on the board
XDOT_SWCLK: J9.4 (SWDCLK), U11.P$29 (SWCLK)
XDOT_SWDIO: J9.2 (SWDIO), U11.P$30 (SWDIO)
XDOT_TX: U11.P$13 (UART1_TX); also elsewhere on the board
XDOT_WAKE: U11.P$34 (WAKE); also elsewhere on the board

Notes on the sheet:
To Program the STM32L on the Module

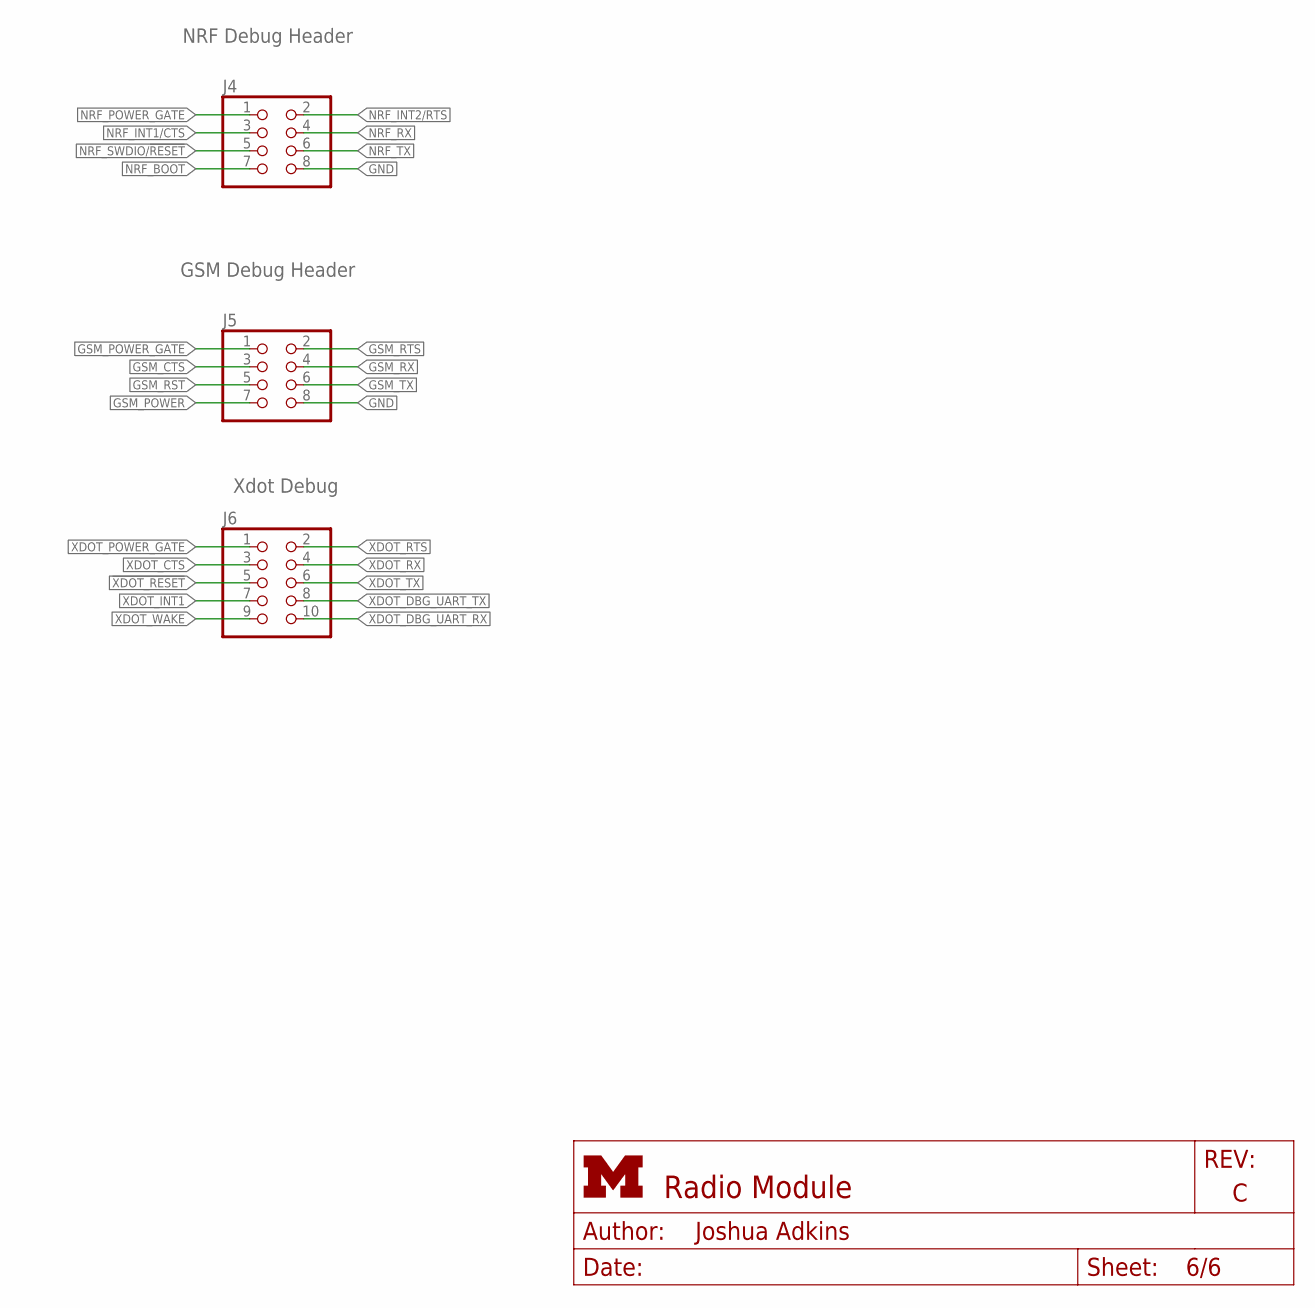
[picture p36: schematic radio_module.sch, sheet 6]

Parts:
J4, J5: PINHD-2X4; 2X04; MPN M20-9980446; DIGIKEY 952-2123-ND
J6: PINHD-2X5; 2X05; MPN 67997-410HLF; DIGIKEY 609-3243-ND

Connections:
!XDOT_RESET: J6.5; also elsewhere on the board
GND: J4.8, J5.8; also elsewhere on the board
GSM_CTS: J5.3; also elsewhere on the board
GSM_POWER: J5.7; also elsewhere on the board
GSM_POWER_GATE: J5.1; also elsewhere on the board
GSM_RST: J5.5; also elsewhere on the board
GSM_RTS: J5.2; also elsewhere on the board
GSM_RX: J5.4; also elsewhere on the board
GSM_TX: J5.6; also elsewhere on the board
NRF_BOOT: J4.7; also elsewhere on the board
NRF_INT1/CTS: J4.3; also elsewhere on the board
NRF_INT2/RTS: J4.2; also elsewhere on the board
NRF_POWER_GATE: J4.1; also elsewhere on the board
NRF_RX: J4.4; also elsewhere on the board
NRF_SWDIO/!RESET: J4.5; also elsewhere on the board
NRF_TX: J4.6; also elsewhere on the board
XDOT_CTS: J6.3; also elsewhere on the board
XDOT_DBG_UART_RX: J6.10; also elsewhere on the board
XDOT_DBG_UART_TX: J6.8; also elsewhere on the board
XDOT_INT1: J6.7; also elsewhere on the board
XDOT_POWER_GATE: J6.1; also elsewhere on the board
XDOT_RTS: J6.2; also elsewhere on the board
XDOT_RX: J6.4; also elsewhere on the board
XDOT_TX: J6.6; also elsewhere on the board
XDOT_WAKE: J6.9; also elsewhere on the board

Notes on the sheet:
GSM Debug Header
NRF Debug Header
Xdot Debug

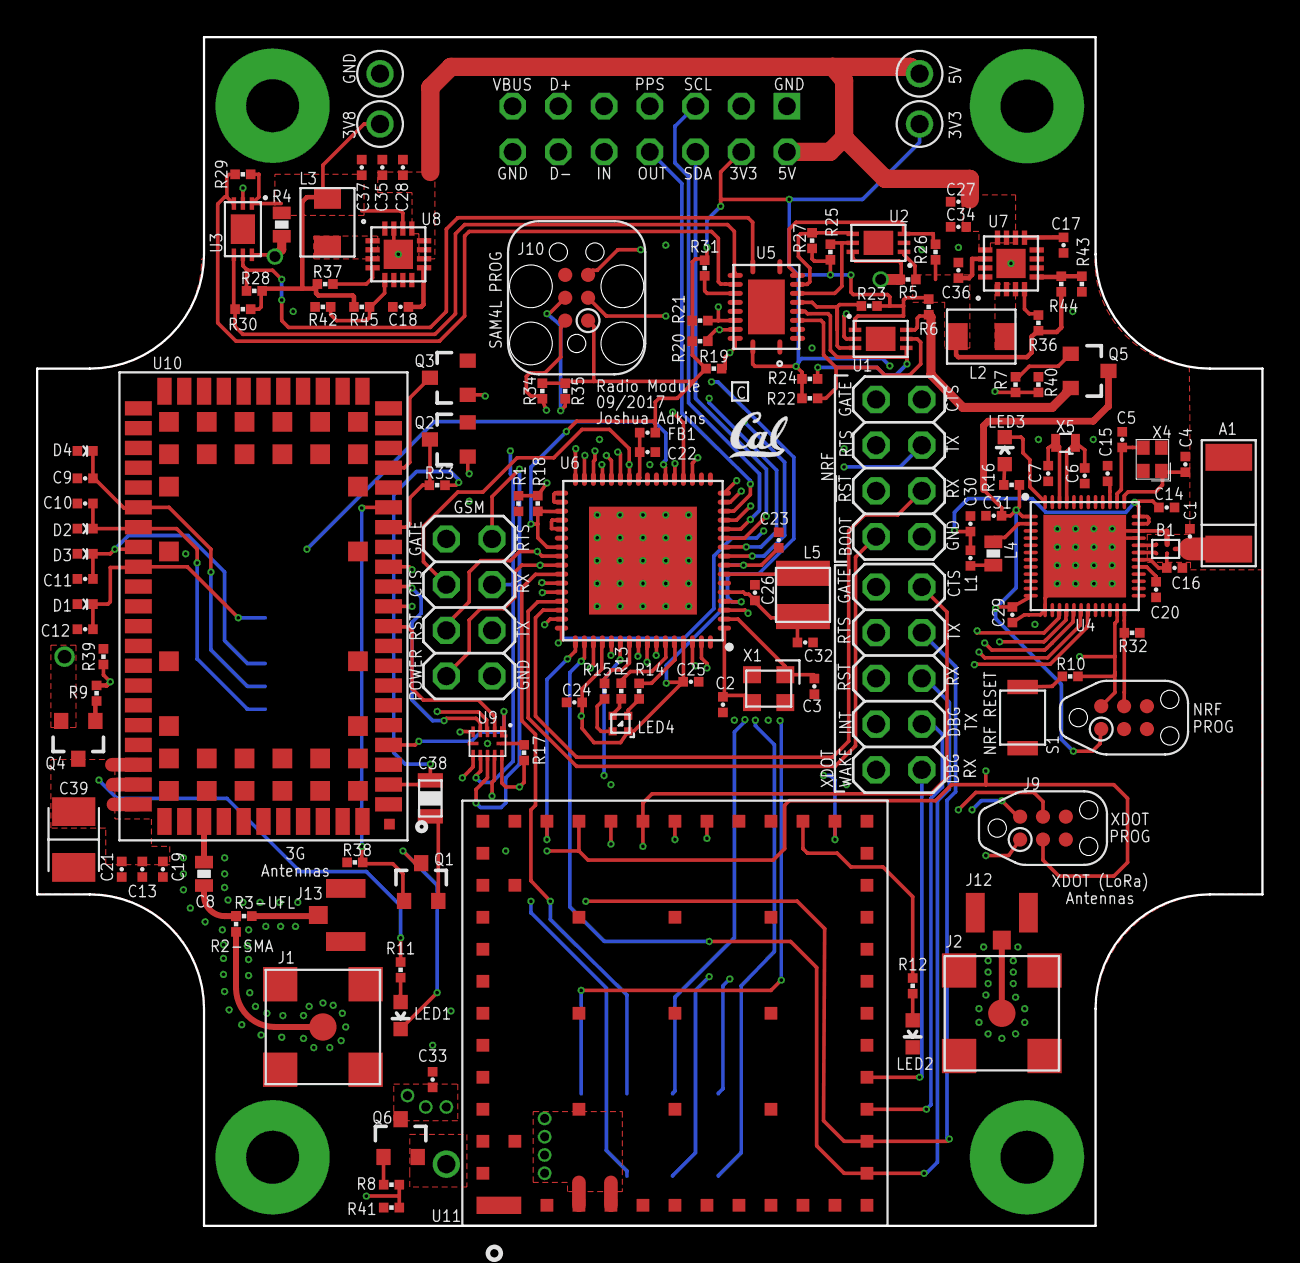
[picture p37: board hardware/radio_module/rev_c/macrofab_compliant/radio_module.brd from above]

Board: 4 copper layers, 68.1 x 66.0 mm, 139 parts (1 on the bottom side), 128 nets.
