lab11/signpost/modules/rf_spectrum/rev_b/macrofab_compliant/rf_spectrum.brd

## EAGLE design modules/rf_spectrum/rev_b/macrofab_compliant/rf_spectrum.brd (2017-09-06)

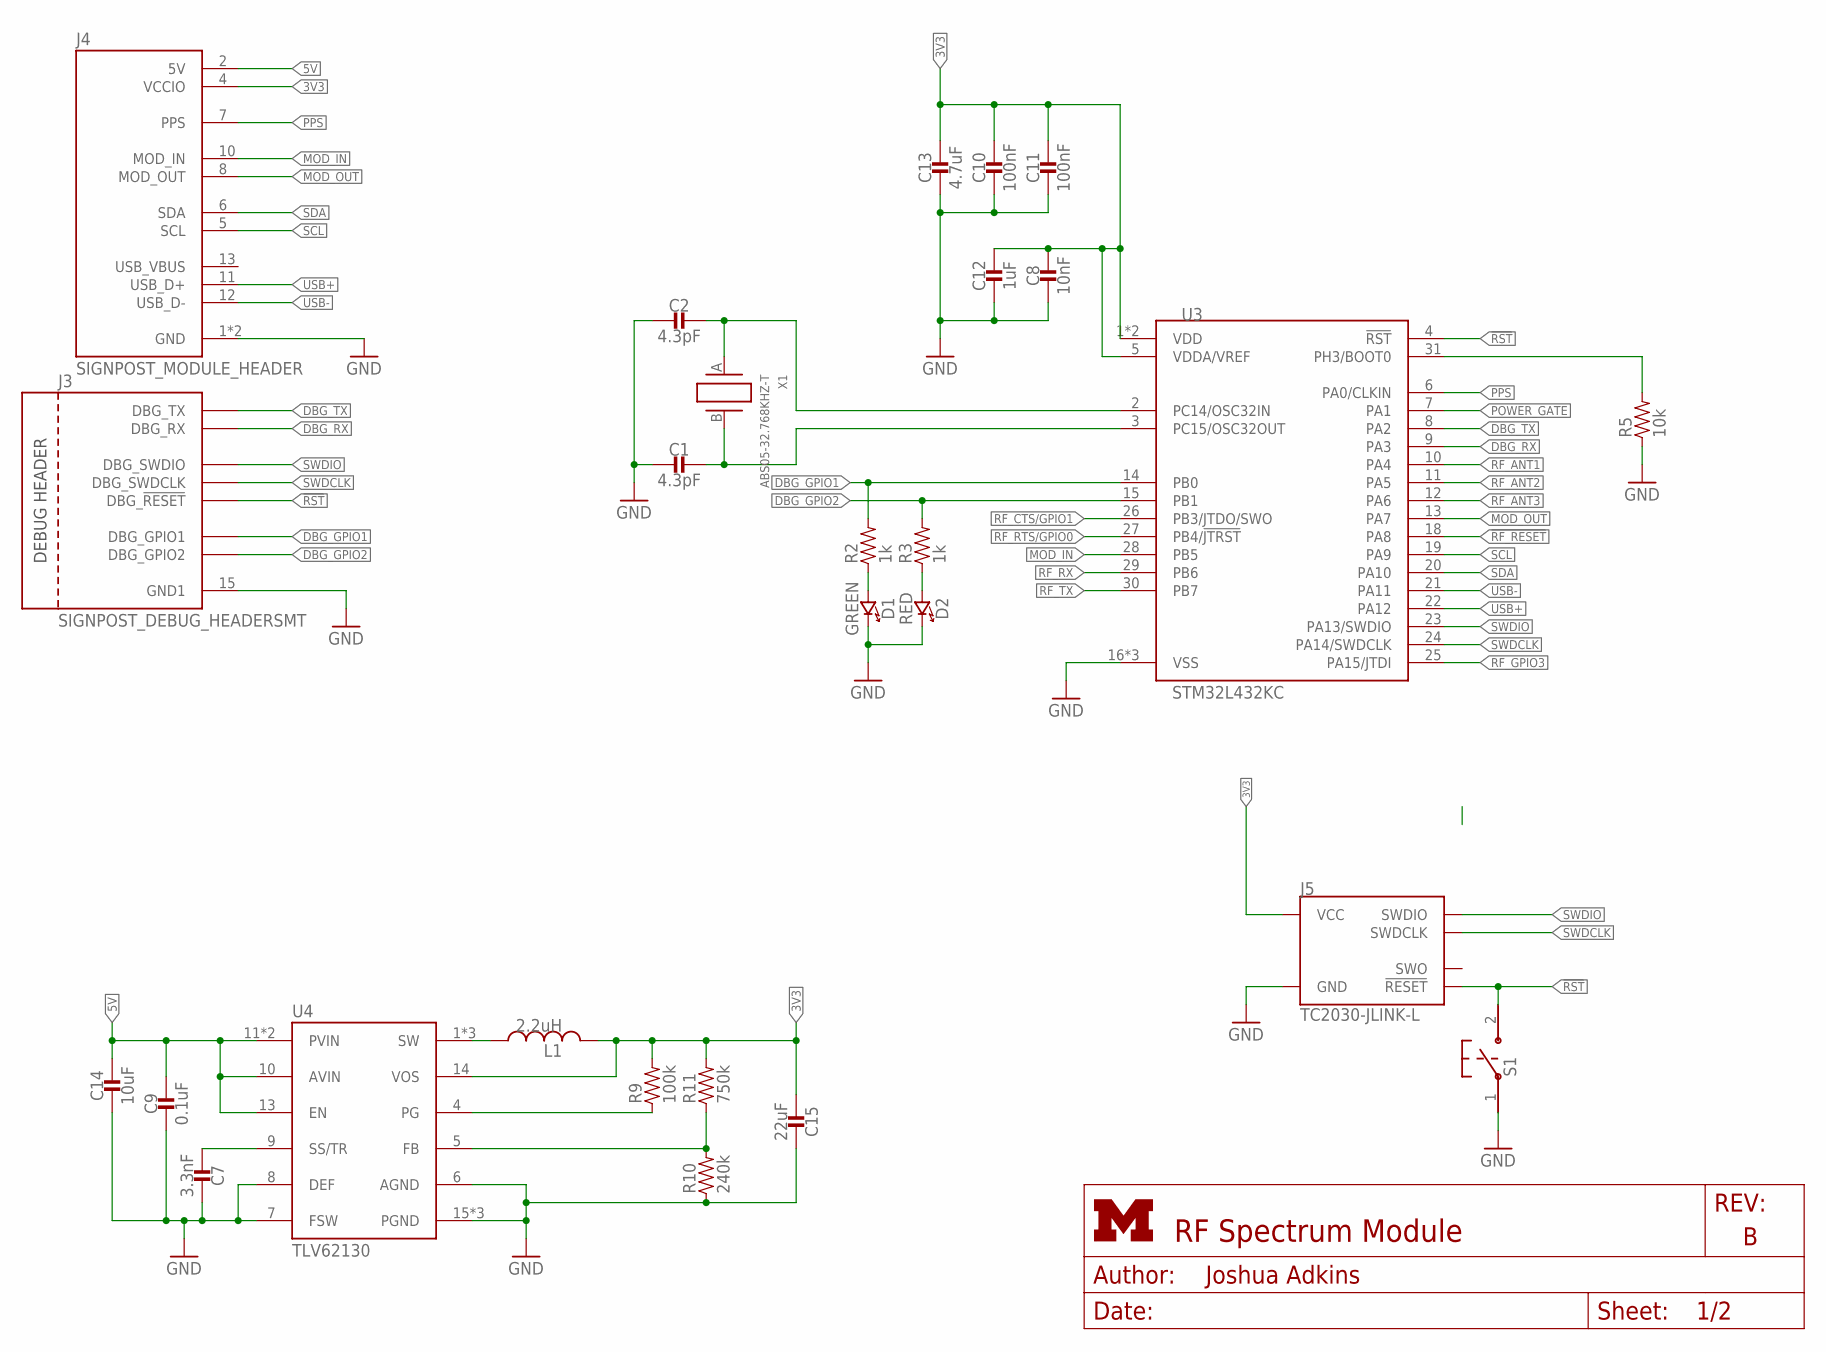
[picture p38: schematic rf_spectrum.sch, sheet 1, MCU, powersupply, module header]

Parts:
C1, C2: 4.3pF; 0402_CAP; MPN GRM1555C1H4R3BA01D; DIGIKEY 490-6243-1-ND
C7: 3.3nF; 0603_CAP; MPN GRM188R71H332KA01D; DIGIKEY 490-1503-1-ND
C8: 10nF; 0402_CAP; MPN GRM155R71H103KA88D; DIGIKEY 490-4516-1-ND
C9: 0.1uF; 0603_CAP; MPN GRM188R71C104KA01D; DIGIKEY 490-1532-1-ND
C10, C11: 100nF; 0402_CAP; MPN GRM155R71C104KA88J; DIGIKEY 490-6328-1-ND
C12: 1uF; 0402_CAP; MPN GRM155R60J105KE19D; DIGIKEY 490-1320-1-ND
C13: 4.7uF; 0402_CAP; MPN GRM155R60J475ME47D; DIGIKEY 490-5915-1-ND
C14: 10uF; 0603_CAP; MPN GRM188R60J106ME47J; DIGIKEY 490-6405-1-ND
C15: 22uF; 0603_CAP; MPN GRM188R60J226MEA0D; DIGIKEY 490-7611-1-ND
D1: GREEN; LED-0603; MPN LTST-C191KGKT; DIGIKEY 160-1446-1-ND
D2: RED; LED-0603; MPN LTST-C191KRKT; DIGIKEY 160-1447-1-ND
J3: SIGNPOST_DEBUG_HEADERSMT; SIGNPOST_DEBUG_HEADER_SMT
J4: SIGNPOST_MODULE_HEADER
J5: TC2030-JLINK-L; TC2030-IDC
L1: 2.2uH; IHL-1212BZ-11
R2, R3: 1k; 0402_RES; MPN RC0402JR-071KL; DIGIKEY 311-1.0KJRCT-ND
R5: 10k; 0402_RES; MPN RC0402JR-071KL; DIGIKEY 311-1.0KJRCT-ND
R9: 100k; 0603-RES; MPN RC0603JR-07100KL; DIGIKEY 311-100KGRCT-ND
R10: 240k; 0603-RES; MPN RC0603JR-07240KL; DIGIKEY 311-240KGRCT-ND
R11: 750k; 0603-RES; MPN 311-750KGRCT-ND; DIGIKEY 311-750KGRCT-ND
S1: B3U-1000P
U3: STM32L432KC; UQFN-32
U4: TLV62130; TQFN-16/3MM
X1: ABS05-32.768KHZ-T; ABS05

Connections:
3V3: C8.1, C10.1, C11.1, C12.1, C13.1, C15.2, J4.4 (VCCIO), J5.1 (VCC), L1.P$2 (2), R9.2, R11.2, U3.1 (VDD), U3.5 (VDDA/VREF), U3.17 (VDD), U4.14 (VOS); also elsewhere on the board
3VSWOUT: L1.P$1 (1), U4.1 (SW), U4.2 (SW), U4.3 (SW)
5V: C9.1, C14.1, J4.2 (5V), U4.10 (AVIN), U4.11 (PVIN), U4.12 (PVIN), U4.13 (EN)
!RF_RESET: U3.18 (PA8); also elsewhere on the board
!RST: J3.20 (DBG_!RESET), J5.3 (!RESET), S1.2, U3.4 (!RST)
DBG_GPIO1: J3.16 (DBG_GPIO1), R2.2, U3.14 (PB0)
DBG_GPIO2: J3.19 (DBG_GPIO2), R3.2, U3.15 (PB1)
DBG_RX: J3.18 (DBG_RX), U3.9 (PA3)
DBG_TX: J3.17 (DBG_TX), U3.8 (PA2)
GND: C1.2, C2.2, C7.1, C8.2, C9.2, C10.2, C11.2, C12.2, C13.2, C14.2, C15.1, D1.C (CATHODE), D2.C (CATHODE), J3.15 (GND1), J4.1 (GND), J4.14 (GND), J5.5 (GND), R5.1, R10.1, S1.1, U3.16 (VSS), U3.32 (VSS), U3.THERMAL (VSS), U4.6 (AGND), U4.7 (FSW), U4.8 (DEF), U4.15 (PGND), U4.16 (PGND), U4.GND; also elsewhere on the board
MOD_IN: J4.10 (MOD_IN), U3.28 (PB5)
MOD_OUT: J4.8 (MOD_OUT), U3.13 (PA7)
unnamed: C2.1, U3.2 (PC14/OSC32IN), X1.A (1)
unnamed: C1.1, U3.3 (PC15/OSC32OUT), X1.B (2)
unnamed: R5.2, U3.31 (PH3/BOOT0)
unnamed: D1.A (ANODE), R2.1
unnamed: C7.2, U4.9 (SS/TR)
unnamed: R9.1, U4.4 (PG)
unnamed: R10.2, R11.1, U4.5 (FB)
POWER_GATE: U3.7 (PA1); also elsewhere on the board
PPS: J4.7 (PPS), U3.6 (PA0/CLKIN)
R3: D2.A (ANODE), R3.1
RF_ANT1: U3.10 (PA4); also elsewhere on the board
RF_ANT2: U3.11 (PA5); also elsewhere on the board
RF_ANT3: U3.12 (PA6); also elsewhere on the board
RF_CTS/GPIO1: U3.26 (PB3/JTDO/SWO); also elsewhere on the board
RF_GPIO3: U3.25 (PA15/JTDI); also elsewhere on the board
RF_RTS/GPIO0: U3.27 (PB4/!JTRST); also elsewhere on the board
RF_RX: U3.29 (PB6); also elsewhere on the board
RF_TX: U3.30 (PB7); also elsewhere on the board
SCL: J4.5 (SCL), U3.19 (PA9)
SDA: J4.6 (SDA), U3.20 (PA10)
SWDCLK: J3.21 (DBG_SWDCLK), J5.4 (SWDCLK), U3.24 (PA14/SWDCLK)
SWDIO: J3.22 (DBG_SWDIO), J5.2 (SWDIO), U3.23 (PA13/SWDIO)
USB+: J4.11 (USB_D+), U3.22 (PA12)
USB-: J4.12 (USB_D-), U3.21 (PA11)

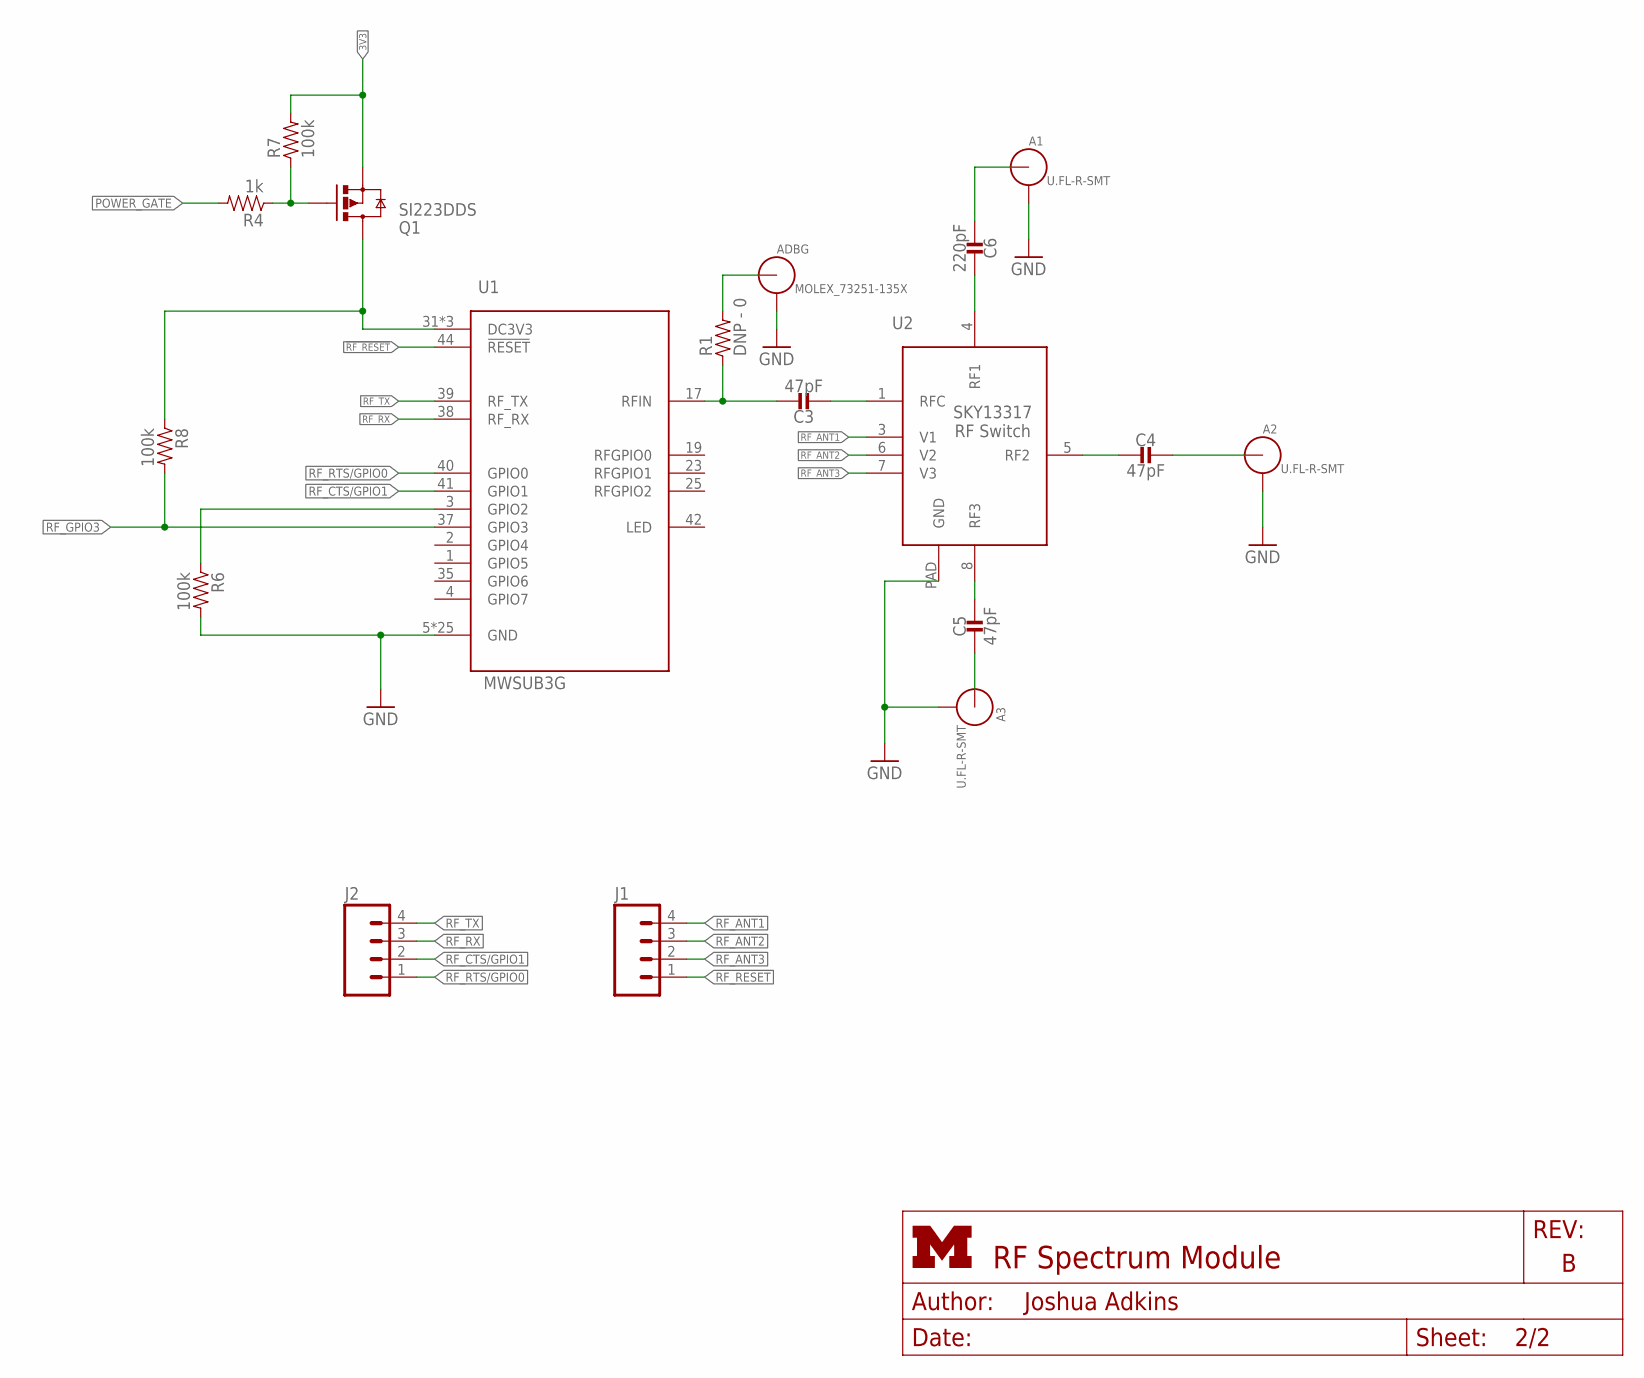
[picture p39: schematic rf_spectrum.sch, sheet 2, RF spectrum and switch]

Parts:
A1, A2, A3: U.FL-R-SMT; U.FL_SMT
ADBG: MOLEX_73251-135X; SMA-J/PCB
C3, C4, C5: 47pF; 0402_CAP; MPN GRM1555C1H470FA01D; DIGIKEY 490-6241-1-ND
C6: 220pF; 0402_CAP; MPN GRM1555C1H221JA01D; DIGIKEY 490-1293-1-ND
J1, J2: M04PTH; 1X04; MPN 0901200764; DIGIKEY WM8086-ND
Q1: SI223DDS; SOT23-3
R1: DNP - 0; 0402_RES; MPN RC0402JR-070RL; DIGIKEY 311-0.0JRCT-ND
R4: 1k; 0402_RES; MPN RC0402JR-071KL; DIGIKEY 311-1.0KJRCT-ND
R6, R7, R8: 100k; 0402_RES; MPN RC0402FR-07100KL; DIGIKEY 311-100KLRCT-ND
U1: MWSUB3G
U2: SKY13317; XDFN-8

Connections:
3V3: Q1.2 (S), R7.2; also elsewhere on the board
!RF_RESET: J1.1, U1.44 (!RESET); also elsewhere on the board
GATED: Q1.3 (D), R8.1, U1.31 (DC3V3), U1.32 (DC3V3), U1.33 (DC3V3)
GND: A1.GND1, A1.GND2, A2.GND1, A2.GND2, A3.GND1, A3.GND2, ADBG.2, ADBG.3, ADBG.4, ADBG.5, R6.2, U1.5 (GND), U1.6 (GND), U1.7 (GND), U1.8 (GND), U1.9 (GND), U1.10 (GND), U1.11 (GND), U1.12 (GND), U1.13 (GND), U1.14 (GND), U1.15 (GND), U1.16 (GND), U1.18 (GND), U1.20 (GND), U1.21 (GND), U1.22 (GND), U1.24 (GND), U1.26 (GND), U1.27 (GND), U1.28 (GND), U1.29 (GND), U1.34 (GND), U1.43 (GND), U1.45 (GND), U1.46 (GND), U2.PAD (GND); also elsewhere on the board
unnamed: C3.1, R1.1, U1.17 (RFIN)
unnamed: C3.2, U2.1 (RFC)
unnamed: C6.1, U2.4 (RF1)
unnamed: A1.SIG (ANT), C6.2
unnamed: C4.2, U2.5 (RF2)
unnamed: A2.SIG (ANT), C4.1
unnamed: C5.1, U2.8 (RF3)
unnamed: A3.SIG (ANT), C5.2
unnamed: Q1.1 (G), R4.1, R7.1
unnamed: ADBG.1 (ANT), R1.2
POWER_GATE: R4.2; also elsewhere on the board
RF_ANT1: J1.4, U2.3 (V1); also elsewhere on the board
RF_ANT2: J1.3, U2.6 (V2); also elsewhere on the board
RF_ANT3: J1.2, U2.7 (V3); also elsewhere on the board
RF_CTS/GPIO1: J2.2, U1.41 (GPIO1); also elsewhere on the board
RF_GPIO2: R6.1, U1.3 (GPIO2)
RF_GPIO3: R8.2, U1.37 (GPIO3); also elsewhere on the board
RF_RTS/GPIO0: J2.1, U1.40 (GPIO0); also elsewhere on the board
RF_RX: J2.3, U1.38 (RF_RX); also elsewhere on the board
RF_TX: J2.4, U1.39 (RF_TX); also elsewhere on the board

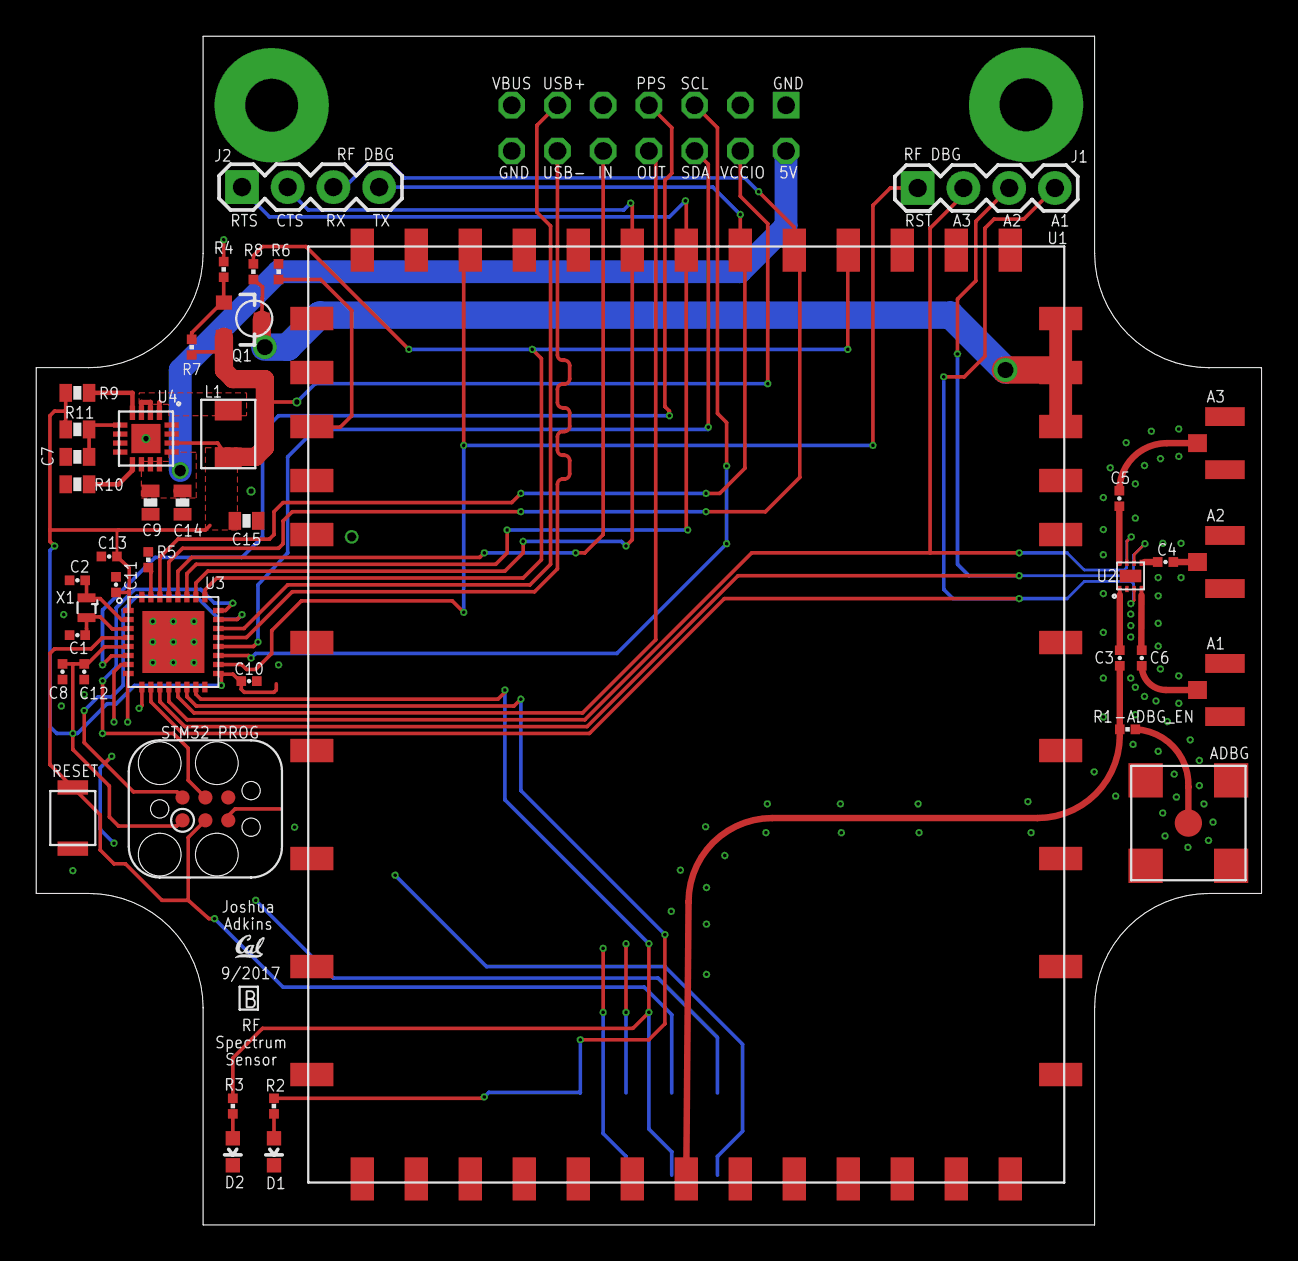
[picture p40: board rf_spectrum.brd from above]

Board: 4 copper layers, 68.1 x 66.0 mm, 46 parts (0 on the bottom side), 48 nets.

Other parts of the board:
U$2: UCB_CAL_50MIL
