lab11/signpost/modules/audio_spectrum/rev_e/macrofab_compliant/audio_spectrum.brd

## EAGLE design modules/audio_spectrum/rev_e/macrofab_compliant/audio_spectrum.brd (2017-09-05)

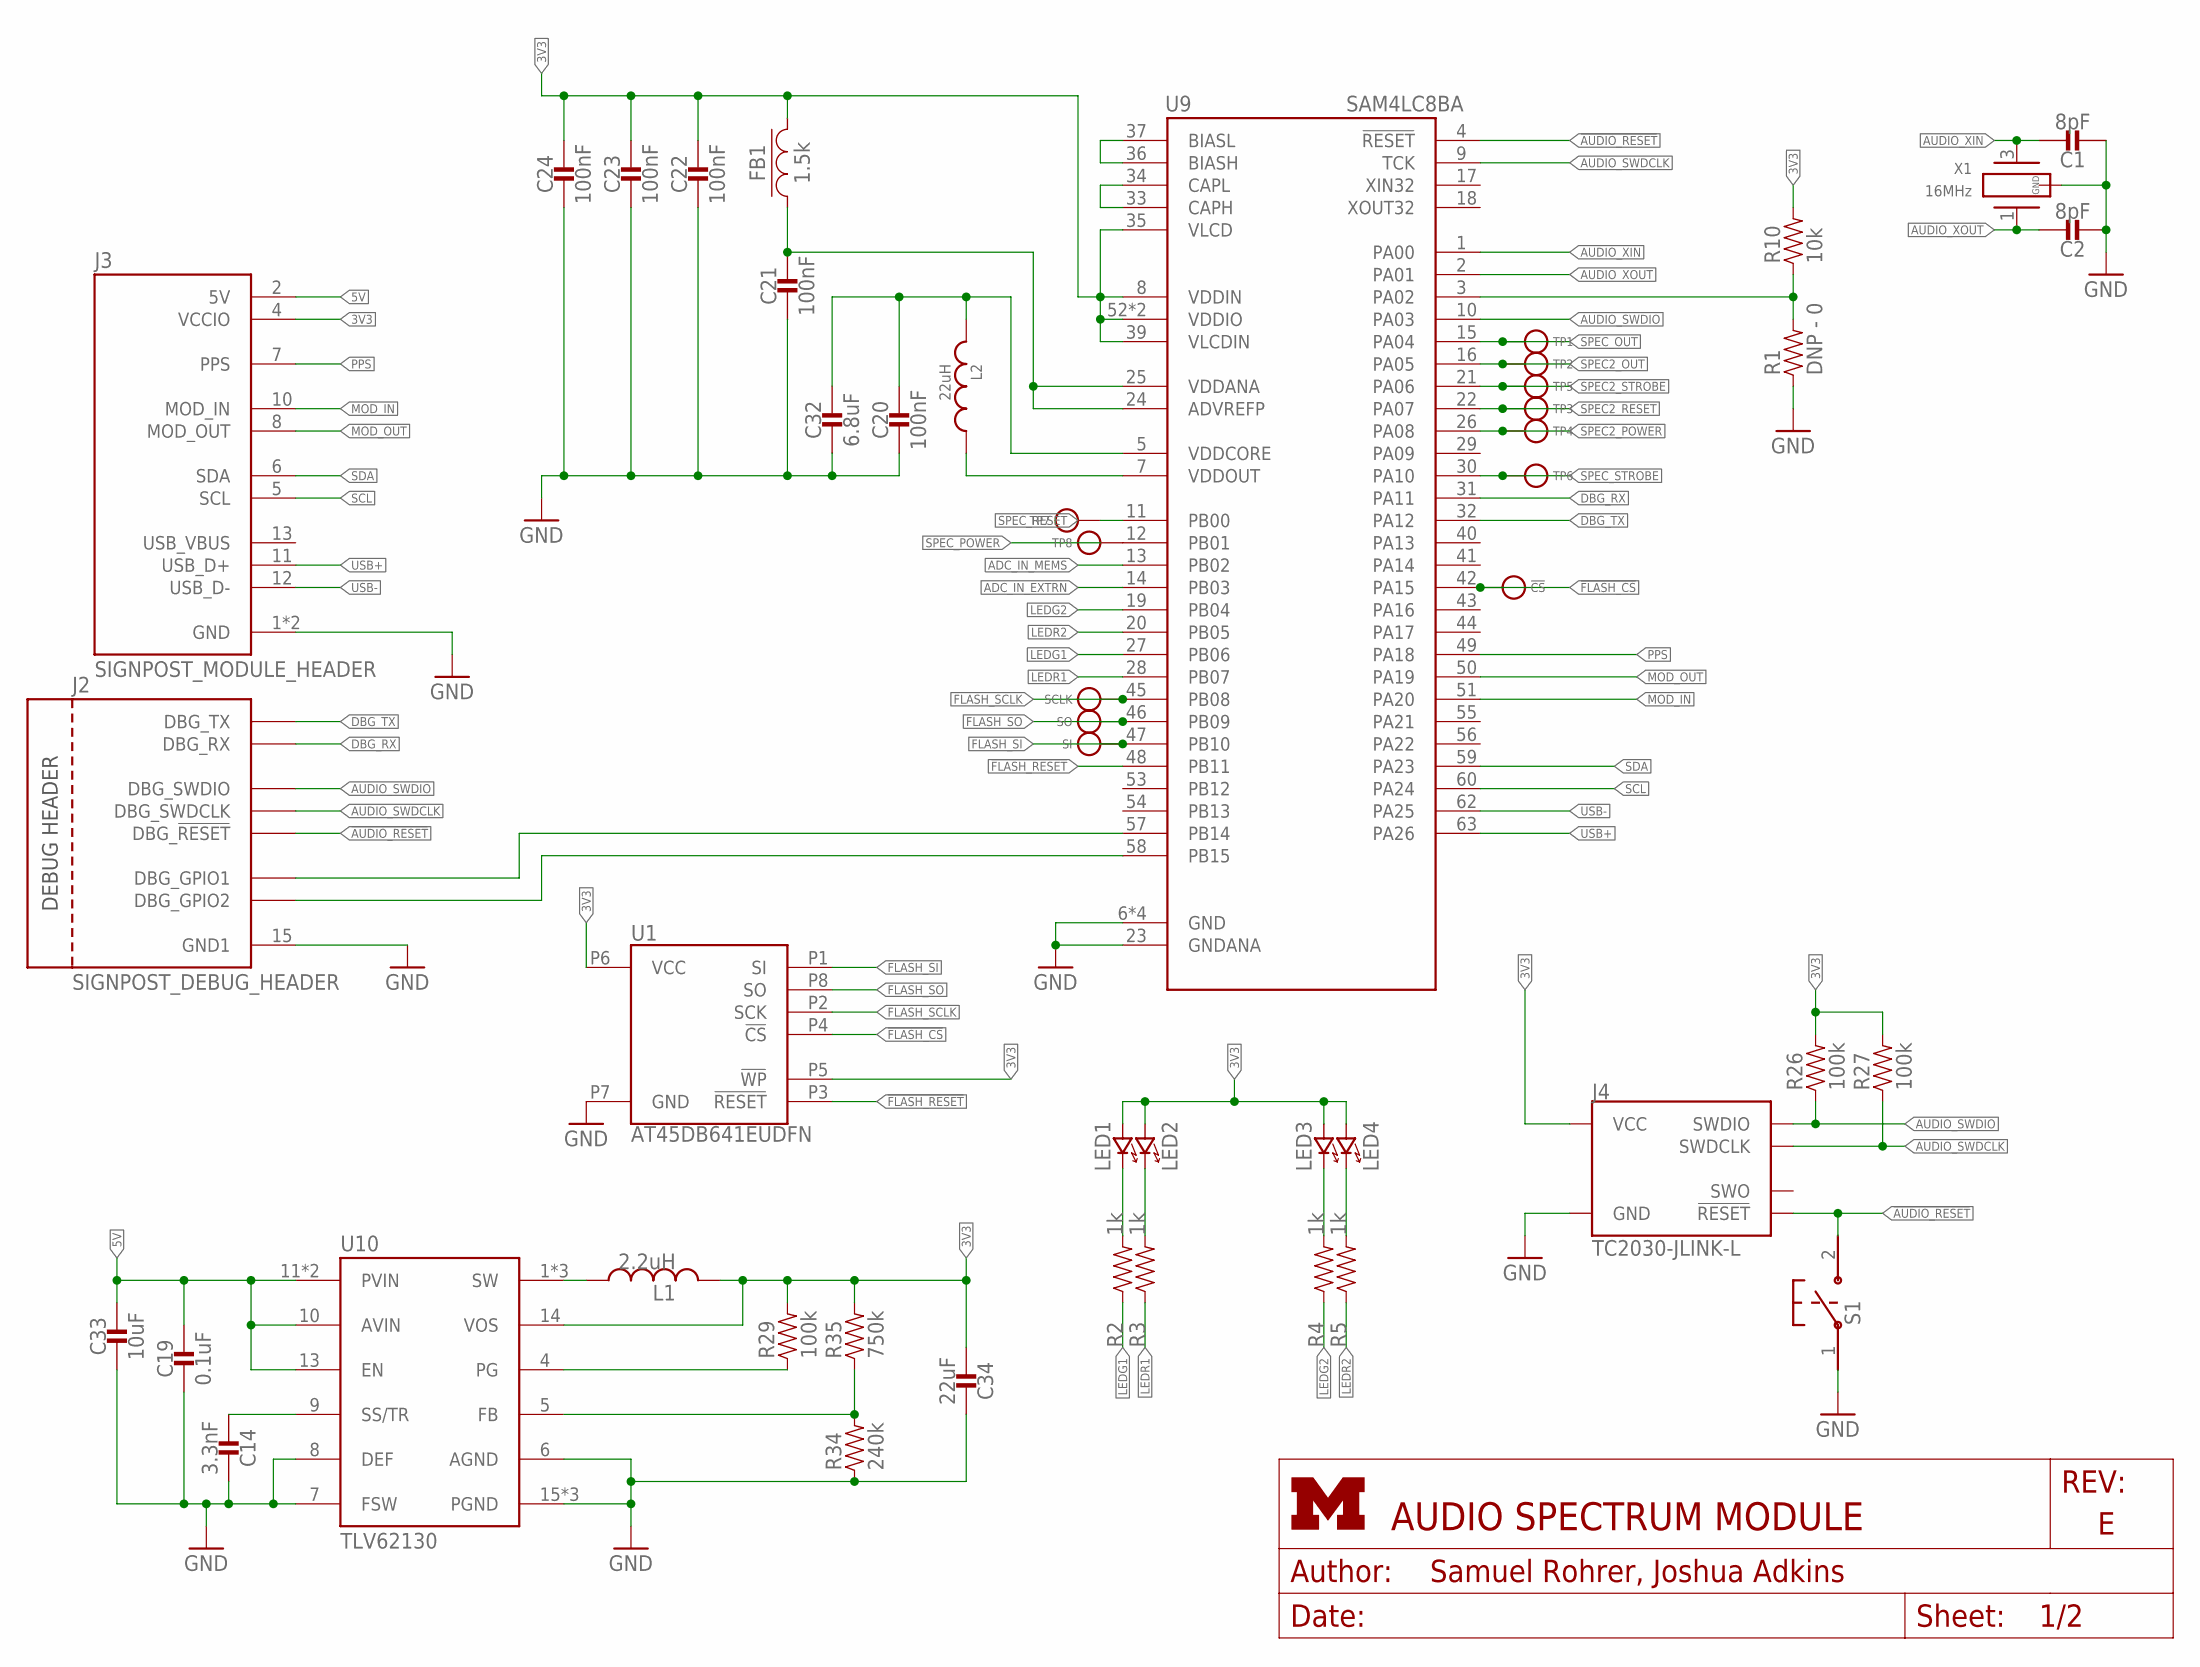
[picture p41: schematic audio_spectrum.sch, sheet 1]

Parts:
!CS: TEST_POINT_0.040IN; TESTPOINT_0.040IN
C1, C2: 8pF; 0402_CAP; MPN GRM1555C1H8R0BA01D; DIGIKEY 490-8230-1-ND
C14: 3.3nF; 0603_CAP; MPN GRM188R71H332KA01D; DIGIKEY 490-1503-1-ND
C19: 0.1uF; 0603_CAP; MPN GRM188R71C104KA01D; DIGIKEY 490-1532-1-ND
C20: 100nF; 0402_CAP; MPN GRM155R71A104JA01D; DIGIKEY 490-10777-1-ND
C21, C22, C23, C24: 100nF; 0603_CAP; MPN GRM188R71C104KA01D; DIGIKEY 490-1532-1-ND
C32: 6.8uF; 0603_CAP; MPN C1608X5R1A685K080AC; DIGIKEY 445-7484-1-ND
C33: 10uF; 0603_CAP; MPN GRM188R60J106ME47J; DIGIKEY 490-6405-1-ND
C34: 22uF; 0603_CAP; MPN GRM186R60J226ME15D; DIGIKEY 490-13241-1-ND
FB1: 1.5k; 0402_CAP; MPN BLM18HE152SN1D; DIGIKEY 490-5216-1-ND
J2: SIGNPOST_DEBUG_HEADER
J3: SIGNPOST_MODULE_HEADER
J4: TC2030-JLINK-L; TC2030-IDC
L1: 2.2uH; IHL-1212BZ-11
L2: 22uH; 1212; MPN LQH3NPN220MJ0L
LED1, LED3: LED0603; LED-0603; MPN LTST-C191KGKT; DIGIKEY 160-1446-1-ND
LED2, LED4: LED0603; LED-0603; MPN LTST-C191KRKT; DIGIKEY 160-1447-1-ND
R1: DNP - 0; 0603-RES; MPN RC1005F103CS; DIGIKEY 1276-3431-1-ND
R2: 1k; 0603-RES; MPN ESR03EZPJ102; DIGIKEY RHM1.0KDCT-N
R3, R4, R5: 1k; 0603-RES; MPN ESR03EZPJ102; DIGIKEY RHM1.0KDCT-ND
R10: 10k; 0603-RES; MPN MCR03EZPFX1002; DIGIKEY RHM10.0KHCT-ND
R26, R27, R29: 100k; 0603-RES; MPN MCR03ERTJ104; DIGIKEY RHM100KCGCT-ND
R34: 240k; 0603-RES; MPN RHM240KCFCT-ND; DIGIKEY RHM240KCFCT-ND
R35: 750k; 0603-RES; MPN MCR03ERTF7503; DIGIKEY RHM750KCFCT-ND
S1: B3U-1000P
SCLK: TEST_POINT_0.040IN; TESTPOINT_0.040IN
SI: TEST_POINT_0.040IN; TESTPOINT_0.040IN
SO: TEST_POINT_0.040IN; TESTPOINT_0.040IN
TP1, TP2, TP3, TP4, TP5, TP6, TP7, TP8: TEST_POINT_0.040IN; TESTPOINT_0.040IN
U1: AT45DB641EUDFN; UDFN-8-5MMX6MM
U9: SAM4LC8BA; QFN-64-9MM
U10: TLV62130; TQFN-16/3MM
X1: 16MHz; FHXXX

Connections:
3V3: C22.1, C23.1, C24.1, C34.2, FB1.2, J3.4 (VCCIO), J4.1 (VCC), L1.P$2 (2), LED1.A (ANODE), LED2.A (ANODE), LED3.A (ANODE), LED4.A (ANODE), R10.2, R26.2, R27.2, R29.2, R35.2, U1.P5 (!WP), U1.P6 (VCC), U9.8 (VDDIN), U9.35 (VLCD), U9.39 (VLCDIN), U9.52 (VDDIO), U9.61 (VDDIO), U10.14 (VOS); also elsewhere on the board
3VSWOUT: L1.P$1 (1), U10.1 (SW), U10.2 (SW), U10.3 (SW)
5V: C19.1, C33.1, J3.2 (5V), U10.10 (AVIN), U10.11 (PVIN), U10.12 (PVIN), U10.13 (EN)
!AUDIO_RESET: J2.20 (DBG_!RESET), J4.3 (!RESET), S1.2, U9.4 (!RESET)
!FLASH_CS: !CS.TESTPOINT, U1.P4 (!CS), U9.42 (PA15)
!FLASH_RESET: U1.P3 (!RESET), U9.48 (PB11)
ADC_IN_EXTRN: U9.14 (PB03); also elsewhere on the board
ADC_IN_MEMS: U9.13 (PB02); also elsewhere on the board
AUDIO_SWDCLK: J2.21 (DBG_SWDCLK), J4.4 (SWDCLK), R27.1, U9.9 (TCK)
AUDIO_SWDIO: J2.22 (DBG_SWDIO), J4.2 (SWDIO), R26.1, U9.10 (PA03)
AUDIO_XIN: C1.1, U9.1 (PA00), X1.3 (2)
AUDIO_XOUT: C2.1, U9.2 (PA01), X1.1
CONTROLLER_BUCK/LDO_N: R1.2, R10.1, U9.3 (PA02)
DBG_GPIO1: J2.16 (DBG_GPIO1), U9.57 (PB14)
DBG_GPIO2: J2.19 (DBG_GPIO2), U9.58 (PB15)
DBG_RX: J2.18 (DBG_RX), U9.31 (PA11)
DBG_TX: J2.17 (DBG_TX), U9.32 (PA12)
FLASH_SCLK: SCLK.TESTPOINT, U1.P2 (SCK), U9.45 (PB08)
FLASH_SI: SI.TESTPOINT, U1.P1 (SI), U9.47 (PB10)
FLASH_SO: SO.TESTPOINT, U1.P8 (SO), U9.46 (PB09)
GND: C1.2, C2.2, C14.1, C19.2, C20.2, C21.2, C22.2, C23.2, C24.2, C32.2, C33.2, C34.1, J2.15 (GND1), J3.1 (GND), J3.14 (GND), J4.5 (GND), R1.1, R34.1, S1.1, U1.P7 (GND), U9.6 (GND), U9.23 (GNDANA), U9.38 (GND), U9.64 (GND), U9.GND, U10.6 (AGND), U10.7 (FSW), U10.8 (DEF), U10.15 (PGND), U10.16 (PGND), U10.GND, X1.2 (GND), X1.4 (GND); also elsewhere on the board
LEDG1: R2.1, U9.27 (PB06)
LEDG2: R4.1, U9.19 (PB04)
LEDR1: R3.1, U9.28 (PB07)
LEDR2: R5.1, U9.20 (PB05)
MOD_IN: J3.10 (MOD_IN), U9.51 (PA20)
MOD_OUT: J3.8 (MOD_OUT), U9.50 (PA19)
unnamed: LED1.C (CATHODE), R2.2
unnamed: LED2.C (CATHODE), R3.2
unnamed: TP8.TESTPOINT, U9.12 (PB01)
unnamed: LED4.C (CATHODE), R5.2
unnamed: C20.1, C32.1, L2.P$2 (2), U9.5 (VDDCORE)
unnamed: C21.1, FB1.1, U9.24 (ADVREFP), U9.25 (VDDANA)
unnamed: LED3.C (CATHODE), R4.2
unnamed: C14.2, U10.9 (SS/TR)
unnamed: R29.1, U10.4 (PG)
unnamed: R34.2, R35.1, U10.5 (FB)
unnamed: L2.P$1 (1), U9.7 (VDDOUT)
unnamed: U9.36 (BIASH), U9.37 (BIASL)
unnamed: U9.33 (CAPH), U9.34 (CAPL)
PPS: J3.7 (PPS), U9.49 (PA18)
SCL: J3.5 (SCL), U9.60 (PA24)
SDA: J3.6 (SDA), U9.59 (PA23)
SPEC2_OUT: TP2.TESTPOINT, U9.16 (PA05); also elsewhere on the board
SPEC2_POWER: TP4.TESTPOINT, U9.26 (PA08); also elsewhere on the board
SPEC2_RESET: TP3.TESTPOINT, U9.22 (PA07); also elsewhere on the board
SPEC2_STROBE: TP5.TESTPOINT, U9.21 (PA06); also elsewhere on the board
SPEC_OUT: TP1.TESTPOINT, U9.15 (PA04); also elsewhere on the board
SPEC_RESET: TP7.TESTPOINT, U9.11 (PB00); also elsewhere on the board
SPEC_STROBE: TP6.TESTPOINT, U9.30 (PA10); also elsewhere on the board
USB+: J3.11 (USB_D+), U9.63 (PA26)
USB-: J3.12 (USB_D-), U9.62 (PA25)

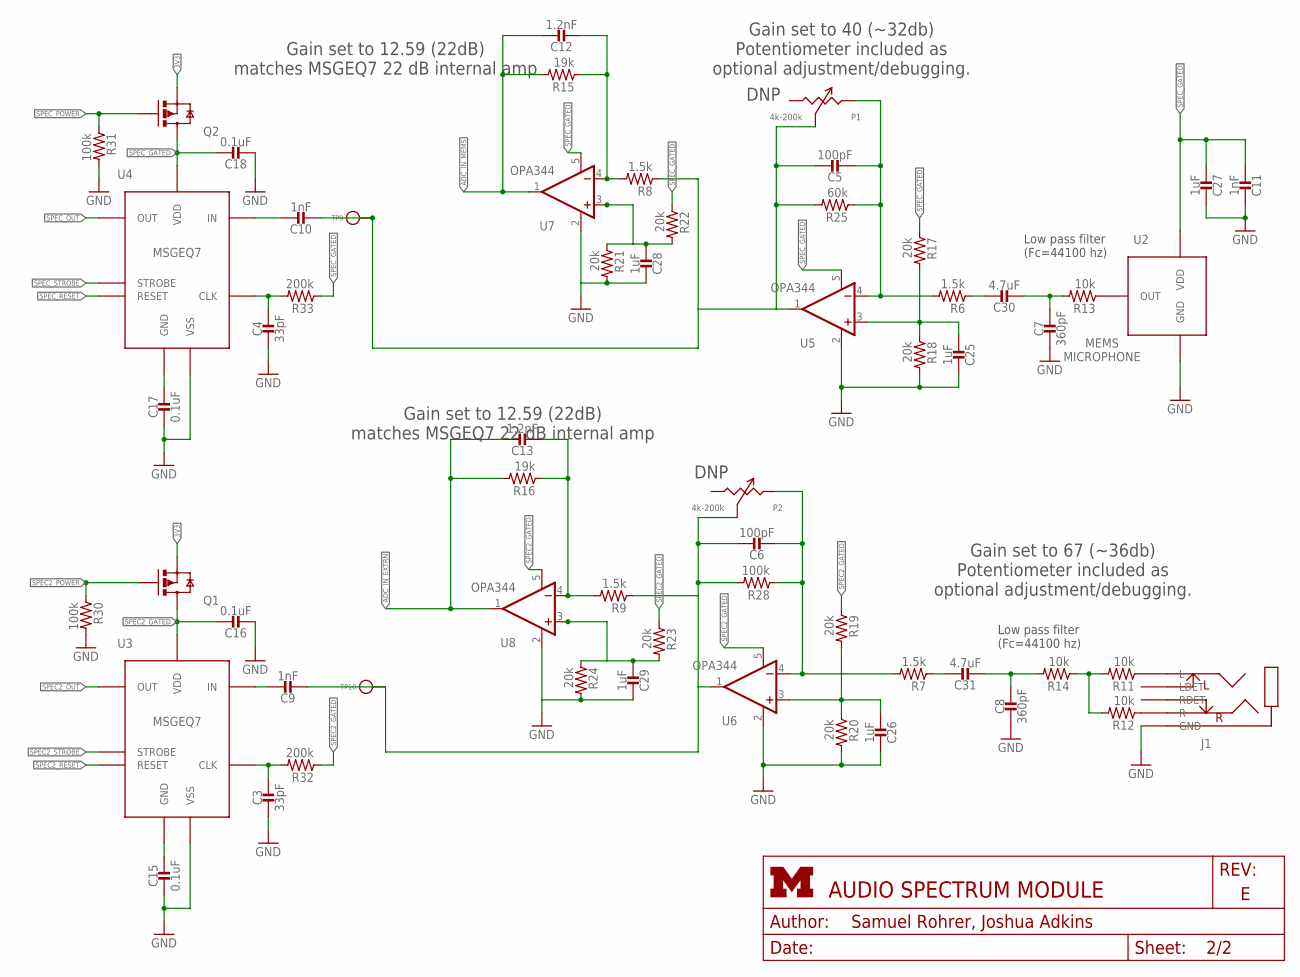
[picture p42: schematic audio_spectrum.sch, sheet 2]

Parts:
C3, C4: 33pF; 0603_CAP; MPN GRM1885C1H330JA01D; DIGIKEY 490-1415-1-ND
C5, C6: 100pF; 0603_CAP; MPN GRM1885C1H101JA01D; DIGIKEY 490-1427-1-ND
C7, C8: 360pF; 0603_CAP; MPN GRM1885C1H361JA01D; DIGIKEY 490-1440-1-ND
C9, C10, C11: 1nF; 0603_CAP; MPN GRM188R71H102KA01D; DIGIKEY 490-1494-1-ND
C12, C13: 1.2nF; 0603_CAP; MPN GCM1885C1H122JA16D; DIGIKEY 490-13298-1-ND
C15, C16, C17, C18: 0.1uF; 0603_CAP; MPN GRM188R71C104KA01D; DIGIKEY 490-1532-1-ND
C25, C26, C27, C28, C29: 1uF; 0603_CAP; MPN GRM188R61C105KA93D; DIGIKEY 490-1536-1-ND
C30, C31: 4.7uF; 0603_CAP; MPN GRM188R60J475KE19D; DIGIKEY 490-3297-1-ND
J1: AUDIO-JACK-VERTICAL; MPN STX-3790-5N
P1, P2: 4k-200k; TC33X-2
Q1, Q2: NX3008PBK; SOT23-3
R6, R7, R8, R9: 1.5k; 0603-RES; MPN MCR03ERTJ152; DIGIKEY RHM1.5KCGCT-ND
R11, R12, R13, R14: 10k; 0603-RES; MPN MCR03EZPFX1002; DIGIKEY RHM10.0KHCT-ND
R15, R16: 19k; 0603-RES; MPN MCR03ERTF1912; DIGIKEY RHM19.1KCFCT-ND
R17, R18, R19, R20, R21, R22, R23, R24: 20k; 0603-RES; MPN MCR03ERTJ203; DIGIKEY RHM20KCGCT-ND
R25: 60k; 0603-RES; MPN MCR03ERTF6042; DIGIKEY RHM60.4KCLCT-ND
R28, R30, R31: 100k; 0603-RES; MPN MCR03ERTJ104; DIGIKEY RHM100KCGCT-ND
R32, R33: 200k; 0603-RES; MPN MCR03ERTF2003; DIGIKEY RHM200KCFCT-ND
TP9, TP10: TEST_POINT_0.040IN; TESTPOINT_0.040IN
U2: MP23AB02B
U3, U4: MSGEQ7; DIP-8
U5, U6, U7, U8: OPA344; SOT23-5; DIGIKEY OPA344NACT-ND

Connections:
3V3: Q1.2 (S), Q2.2 (S); also elsewhere on the board
ADC_IN_EXTRN: C13.1, R16.2, U8.1 (OUT); also elsewhere on the board
ADC_IN_MEMS: C12.1, R15.2, U7.1 (OUT); also elsewhere on the board
GND: C3.2, C4.2, C7.2, C8.2, C11.1, C15.2, C16.2, C17.2, C18.2, C25.1, C26.1, C27.1, C28.1, C29.1, J1.5 (GND), R18.2, R20.2, R21.2, R24.2, R30.2, R31.2, U2.3 (GND), U3.2 (VSS), U4.2 (VSS), U5.2 (V-), U6.2 (V-), U7.2 (V-), U8.2 (V-); also elsewhere on the board
N87: C6.1, C9.2, P2.3 (W), R9.1, R28.2, TP10.TESTPOINT, U6.1 (OUT)
N90: C5.1, C10.2, P1.3 (W), R8.1, R25.2, TP9.TESTPOINT, U5.1 (OUT)
unnamed: C15.1, U3.6 (GND)
unnamed: C3.1, R32.2, U3.8 (CLK)
unnamed: C9.1, U3.5 (IN)
unnamed: C7.1, C30.2, R13.2
unnamed: C4.1, R33.2, U4.8 (CLK)
unnamed: C10.1, U4.5 (IN)
unnamed: C13.2, R9.2, R16.1, U8.4 (-IN)
unnamed: C25.2, R17.2, R18.1, U5.3 (+IN)
unnamed: R11.2, R12.2, R14.1
unnamed: C26.2, R19.2, R20.1, U6.3 (+IN)
unnamed: C5.2, P1.2 (CW), R6.2, R25.1, U5.4 (-IN)
unnamed: C30.1, R6.1
unnamed: C6.2, P2.2 (CW), R7.2, R28.1, U6.4 (-IN)
unnamed: C31.1, R7.1
unnamed: J1.1 (R), R12.1
unnamed: J1.4 (L), R11.1
unnamed: R13.1, U2.1 (OUT)
unnamed: C17.1, U4.6 (GND)
unnamed: C8.1, C31.2, R14.2
unnamed: C12.2, R8.2, R15.1, U7.4 (-IN)
unnamed: C28.2, R21.1, R22.2, U7.3 (+IN)
unnamed: C29.2, R23.2, R24.1, U8.3 (+IN)
SPEC2_GATED: C16.1, Q1.3 (D), R19.1, R23.1, R32.1, U3.1 (VDD), U6.5 (V+), U8.5 (V+)
SPEC2_OUT: U3.3 (OUT); also elsewhere on the board
SPEC2_POWER: Q1.1 (G), R30.1; also elsewhere on the board
SPEC2_RESET: U3.7 (RESET); also elsewhere on the board
SPEC2_STROBE: U3.4 (STROBE); also elsewhere on the board
SPEC_GATED: C11.2, C18.1, C27.2, Q2.3 (D), R17.1, R22.1, R33.1, U2.2 (VDD), U4.1 (VDD), U5.5 (V+), U7.5 (V+)
SPEC_OUT: U4.3 (OUT); also elsewhere on the board
SPEC_POWER: Q2.1 (G), R31.1
SPEC_RESET: U4.7 (RESET); also elsewhere on the board
SPEC_STROBE: U4.4 (STROBE); also elsewhere on the board

Notes on the sheet:
DNP
Gain set to 40 (~32db) Potentiometer included as optional adjustment/debugging.
Gain set to 67 (~36db) Potentiometer included as optional adjustment/debugging.
Low pass filter (Fc=44100 hz)
Gain set to 12.59 (22dB) matches MSGEQ7 22 dB internal amp

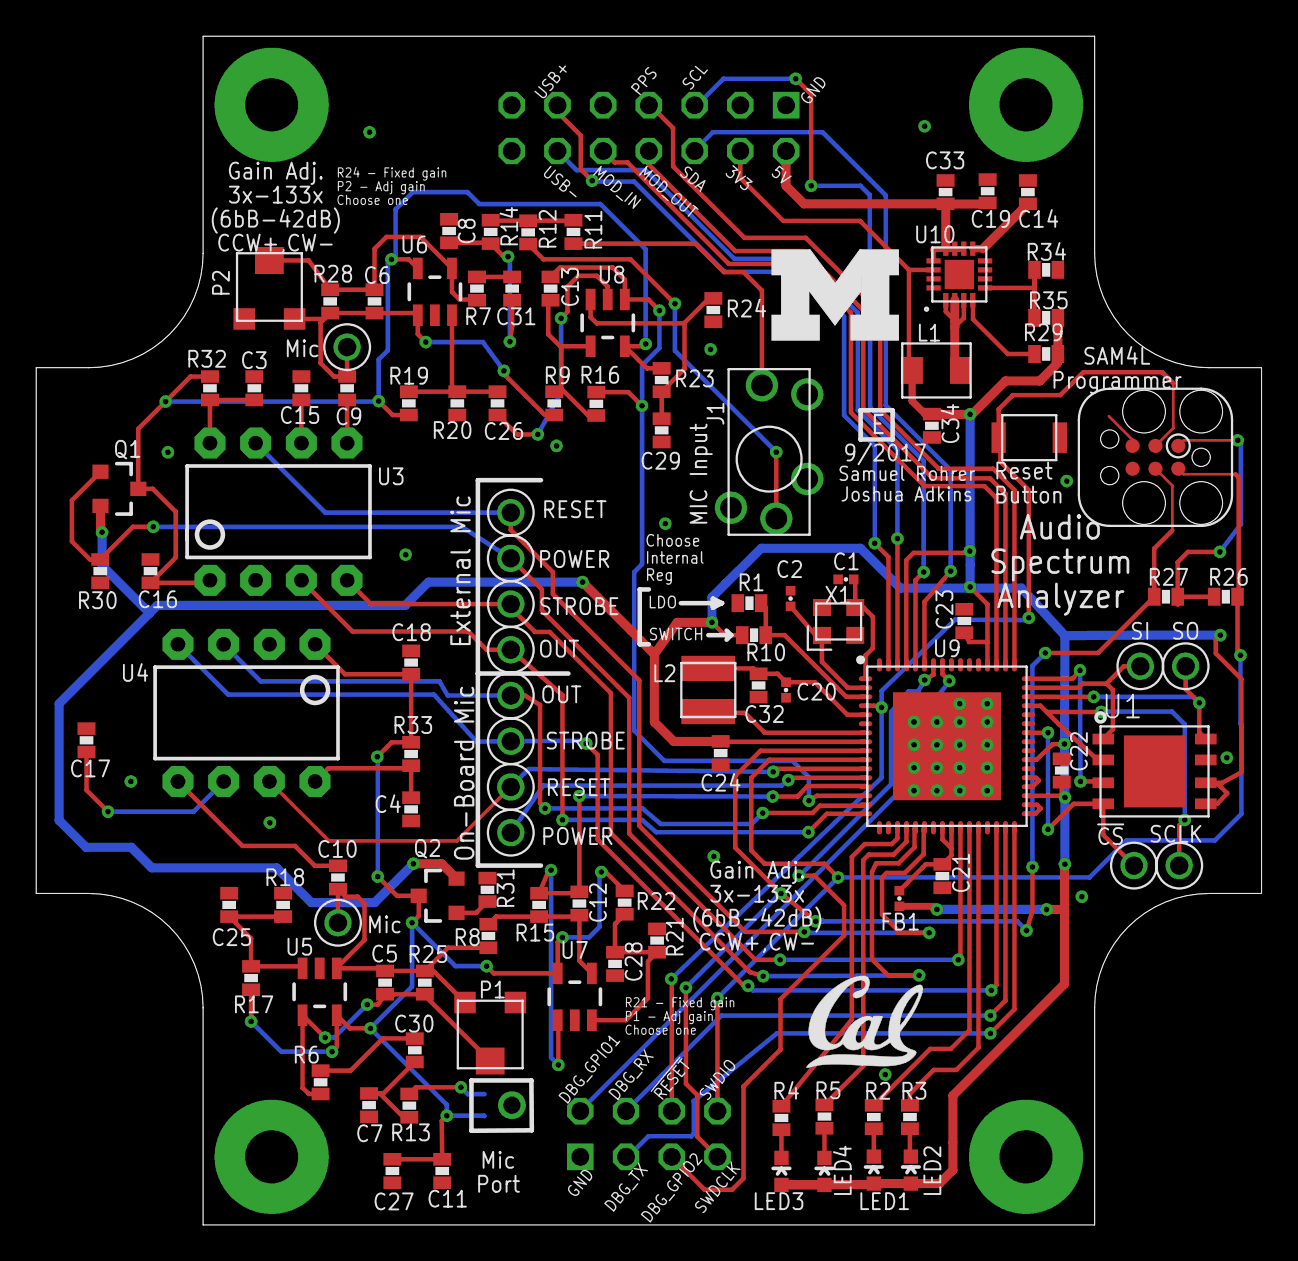
[picture p43: board modules/audio_spectrum/rev_e/macrofab_compliant/audio_spectrum.brd from above]

Board: 2 copper layers, 68.1 x 66.0 mm, 112 parts (1 on the bottom side), 79 nets.

Other parts of the board:
U$1: UMICH_SOLID_200MIL
U$2: UCB_CAL_200MIL
