lab11/signpost/hardware/battery_pack/rev_b/macrofab_compliant/battery_pack.brd

## EAGLE design hardware/battery_pack/rev_b/macrofab_compliant/battery_pack.brd (2017-09-05)

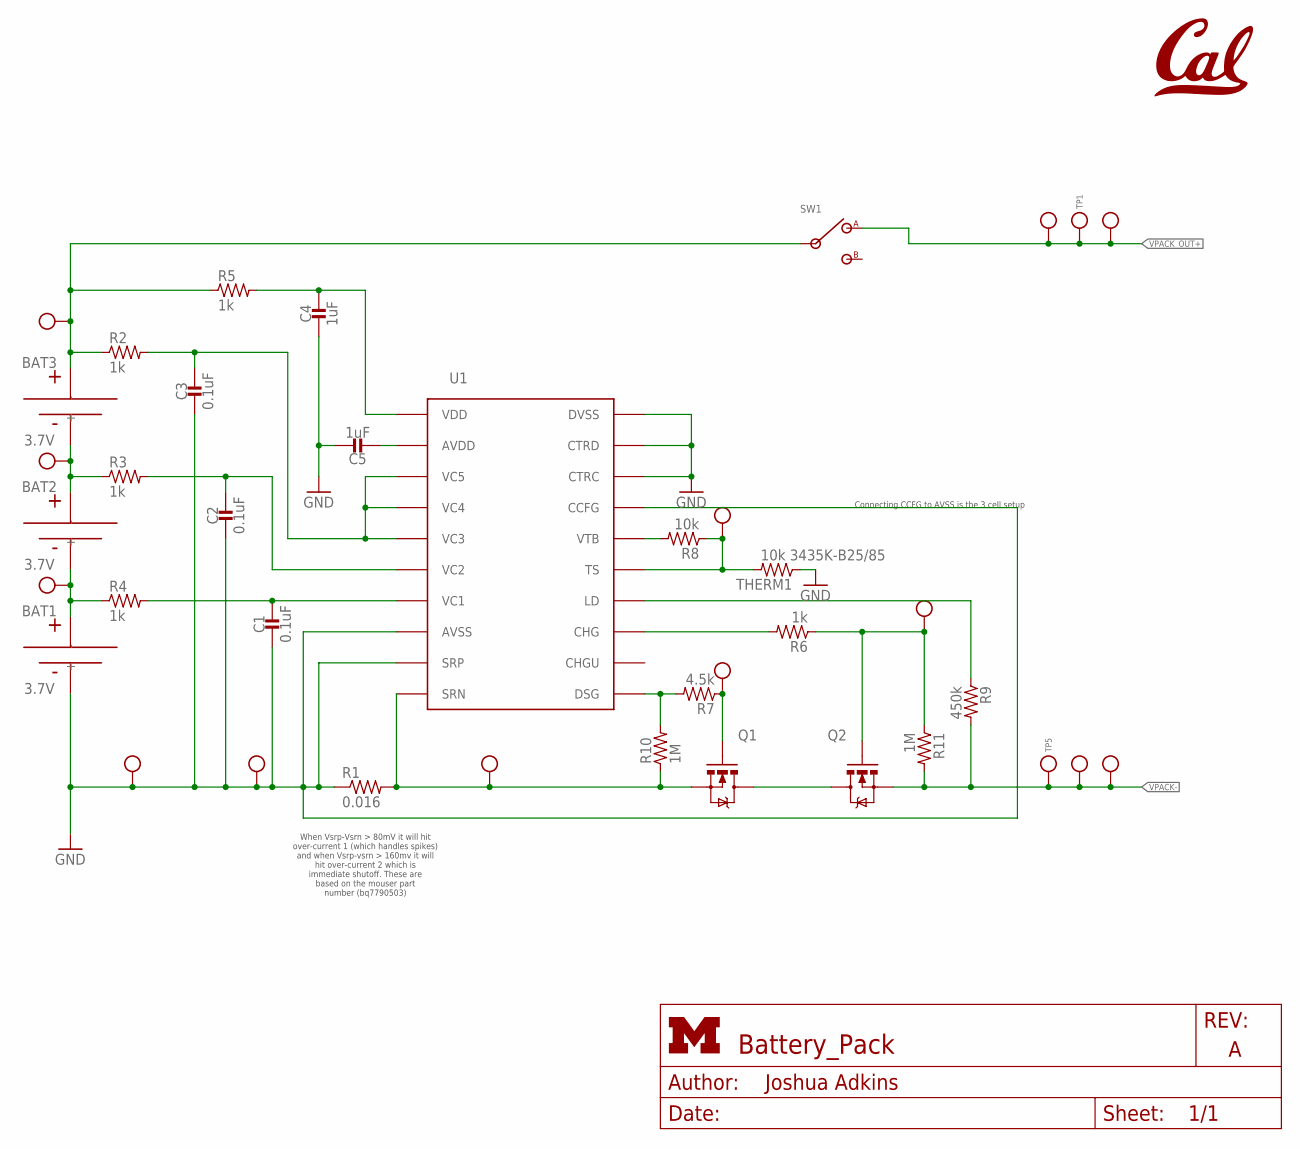
[picture p44: schematic battery_pack.sch]

Parts:
BAT1, BAT2, BAT3: 3.7V; PL-809797-1C
C1, C2, C3: 0.1uF; 0603_CAP; MPN CC0603ZRY5V8BB104; DIGIKEY 311-1087-1-ND
C4, C5: 1uF; 0603_CAP; MPN CC0603KRX5R8BB105; DIGIKEY 311-1445-1-ND
Q1, Q2: MOSFET-NCHANNELFDD8580; DPAK; MPN FDD8447L_F085; DIGIKEY FDD8447L_F085CT-ND
R1: 0.016; R1206; MPN ERJ8CWFR016V; DIGIKEY P0.016BVCT-ND
R2, R3, R4, R5, R6: 1k; 0603-RES; MPN RC0603JR-071KL; DIGIKEY 311-1.0KGRCT-ND
R7: 4.5k; 0603-RES; MPN RC0603FR-074K53L; DIGIKEY 311-4.53KHRCT-ND
R8: 10k; 0603-RES; MPN RC0603JR-0710KL; DIGIKEY 311-10KGRCT-ND
R9: 450k; 0603-RES; MPN RC0603FR-07453KL; DIGIKEY 311-453KHRCT-ND
R10, R11: 1M; 0603-RES; MPN RC0603JR-071ML; DIGIKEY 311-1.0MGRCT-ND
SW1: 500ASSP
THERM1: 10k 3435K-B25/85; 0603-RES; MPN NTCG163JF103FT1; DIGIKEY 445-2554-1-ND
TP1, TP5: TEST_POINT_0.060IN; TESTPOINT_0.060IN
TP2, TP6, TP7, TP8, TP14, TP15: TEST_POINT_0.112IN; TESTPOINT_0.112IN
TP3, TP4, TP9, TP10, TP11, TP12, TP13: TEST_POINT_0.040IN; TESTPOINT_0.040IN
U1: BQ77904; TSSOP-20/6MM
U$1: UCB_CAL500MIL; UCB_CAL_500MIL

Connections:
GND: BAT1.-, C1.2, C2.2, C3.2, C4.2, C5.1, R1.1, THERM1.1, TP7.1, TP9.TESTPOINT, U1.8 (AVSS), U1.9 (SRP), U1.17 (CCFG), U1.18 (CTRC), U1.19 (CTRD), U1.20 (DVSS)
unnamed: BAT1.+, BAT2.-, R4.1, TP15.1
unnamed: BAT2.+, BAT3.-, R3.1, TP14.1
unnamed: C1.1, R4.2, U1.7 (VC1)
unnamed: C2.1, R3.2, U1.6 (VC2)
unnamed: C3.1, R2.2, U1.3 (VC5), U1.4 (VC4), U1.5 (VC3)
unnamed: Q1.4 (D), Q2.4 (D)
unnamed: Q1.3 (S), R1.2, R10.1, TP10.TESTPOINT, U1.10 (SRN)
unnamed: C4.1, R5.2, U1.1 (VDD)
unnamed: R7.2, R10.2, U1.11 (DSG)
unnamed: C5.2, U1.2 (AVDD)
unnamed: Q1.1 (G), R7.1, TP11.TESTPOINT
unnamed: R6.2, U1.13 (CHG)
unnamed: Q2.1 (G), R6.1, R11.1, TP12.TESTPOINT
unnamed: R9.1, U1.14 (LD)
unnamed: R8.2, U1.16 (VTB)
unnamed: R8.1, THERM1.2, TP13.TESTPOINT, U1.15 (TS)
VPACK+: BAT3.+, R2.1, R5.1, SW1.2, TP8.1
VPACK-: Q2.3 (S), R9.2, R11.2, TP2.1, TP4.TESTPOINT, TP5.TESTPOINT
VPACK_OUT+: SW1.1, TP1.TESTPOINT, TP3.TESTPOINT, TP6.1

Notes on the sheet:
Connecting CCFG to AVSS is the 3 cell setup
When Vsrp-Vsrn > 80mV it will hit over-current 1 (which handles spikes) and when Vsrp-vsrn > 160mv it will hit over-current 2 which is immediate shutoff. These are based on the mouser part number (bq7790503)

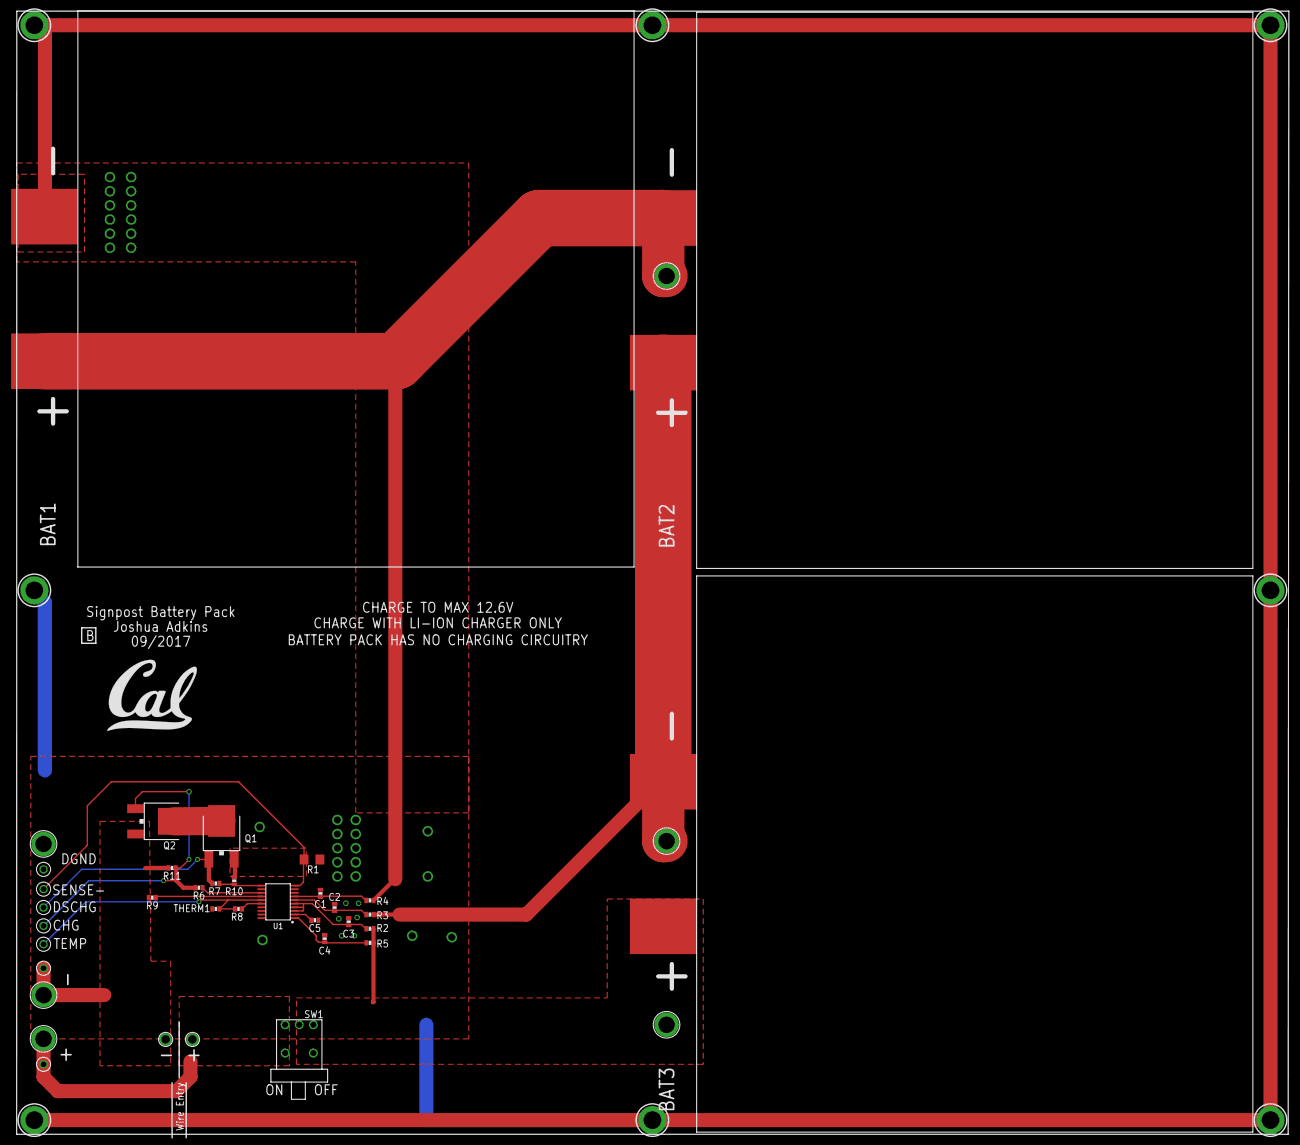
[picture p45: board battery_pack.brd from above]

Board: 2 copper layers, 228.7 x 201.9 mm, 40 parts (0 on the bottom side), 20 nets.
