lab11/signpost/modules/microwave_radar/hardware/rev_b/macrofab_compliant/microwave.brd

## EAGLE design modules/microwave_radar/hardware/rev_b/macrofab_compliant/microwave.brd (2017-09-05)

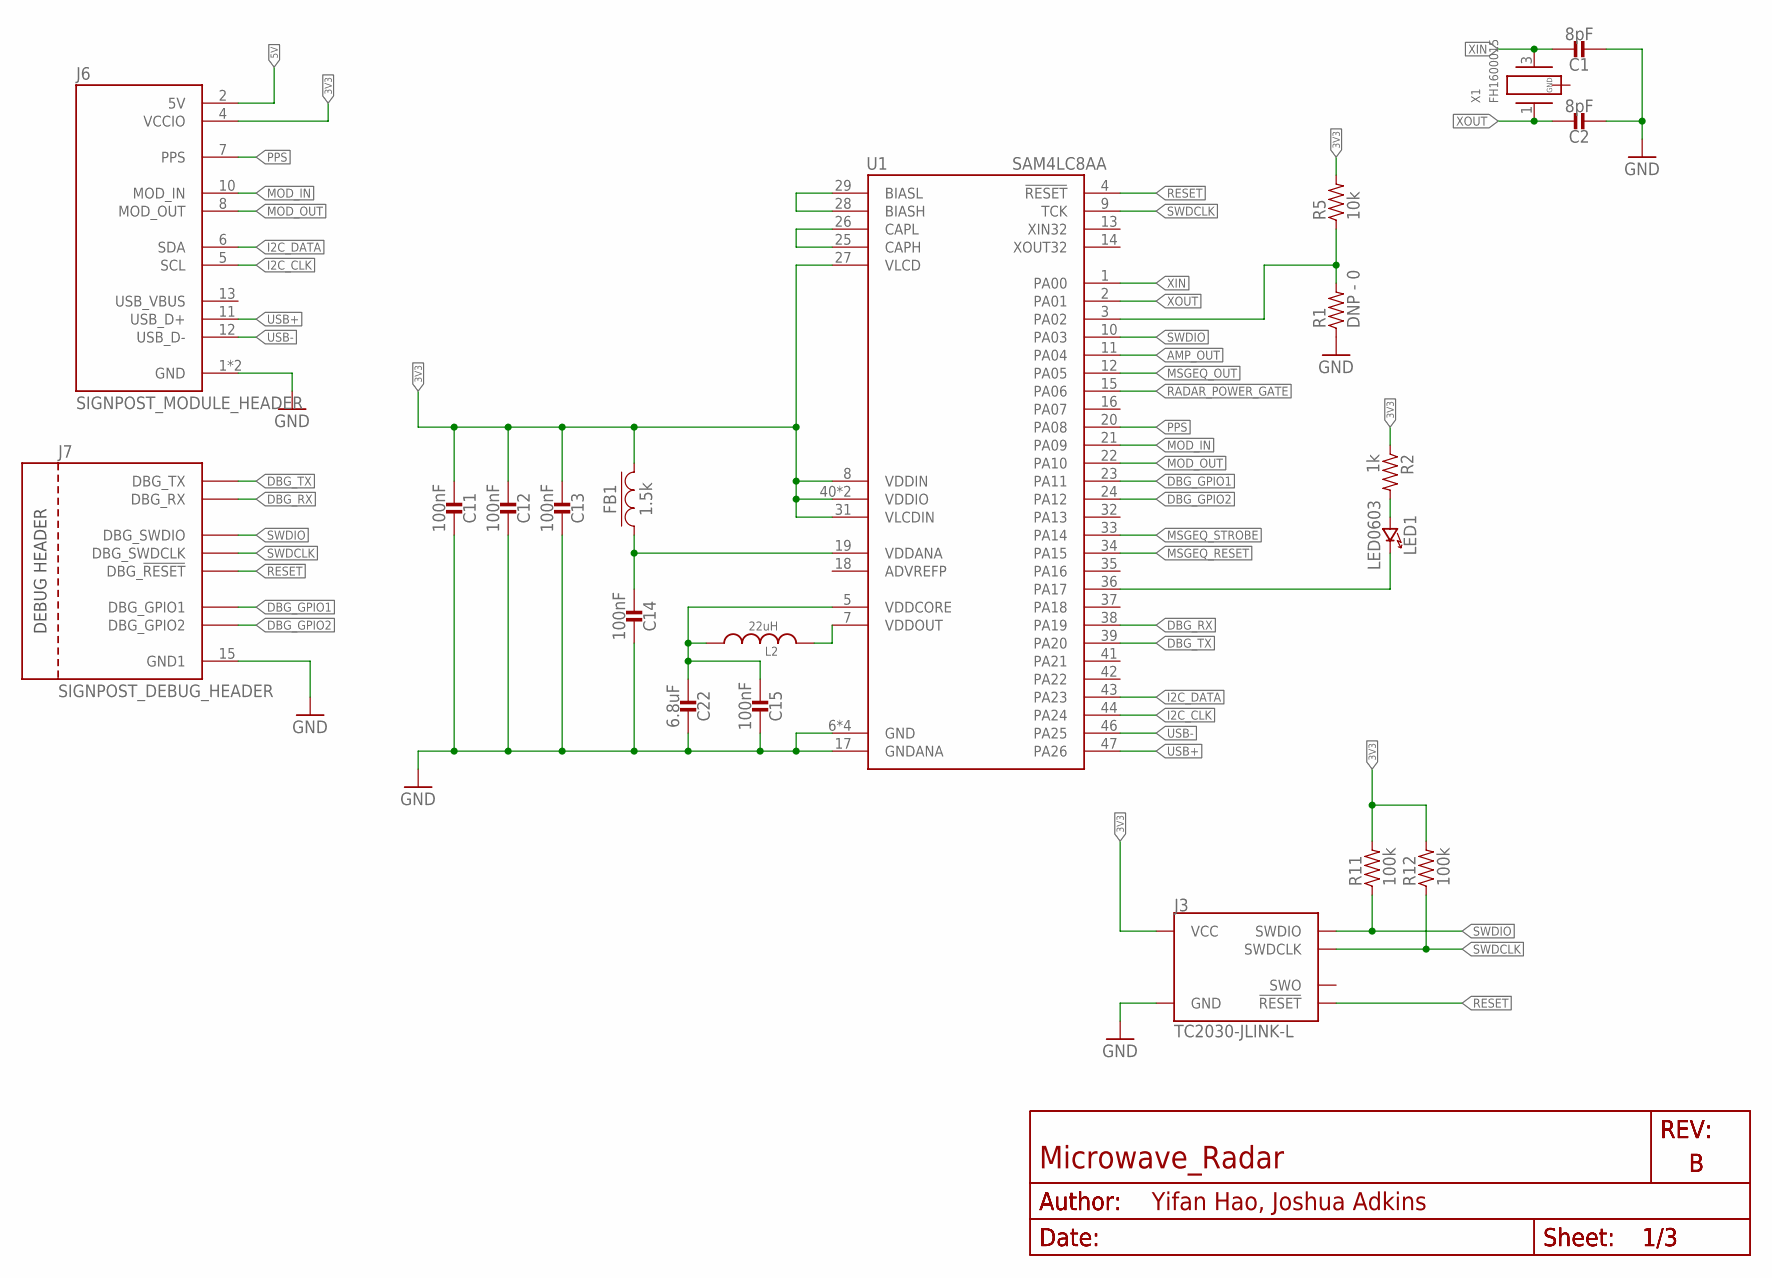
[picture p46: schematic microwave.sch, sheet 1]

Parts:
C1, C2: 8pF; 0402_CAP; MPN GRM1555C1H8R0BA01D; DIGIKEY 490-8230-1-ND
C11, C12, C13, C14, C15: 100nF; 0402_CAP; MPN GRM155R71A104JA01D; DIGIKEY 490-10777-1-ND
C22: 6.8uF; 0603_CAP; MPN C1608X5R1A685K080AC; DIGIKEY 445-7484-1-ND
FB1: 1.5k; 0402_CAP; MPN BLM18HE152SN1D; DIGIKEY 490-5216-1-ND
J3: TC2030-JLINK-L; TC2030-IDC
J6: SIGNPOST_MODULE_HEADER
J7: SIGNPOST_DEBUG_HEADER
L2: 22uH; 1212
LED1: LED0603; LED-0603; MPN LTST-C191KGKT; DIGIKEY 160-1446-1-ND
R1: DNP - 0; 0402_RES; MPN RC0402JR-070RL; DIGIKEY 311-0.0JRCT-ND
R2: 1k; 0402_RES; MPN RC1005F102CS; DIGIKEY 1276-3430-1-ND
R5: 10k; 0402_RES; MPN RC1005F103CS; DIGIKEY 1276-3431-1-ND
R11, R12: 100k; 0402_RES; MPN RC1005F104CS; DIGIKEY 1276-3432-1-ND
U1: SAM4LC8AA; QFN-48-7MM
X1: FH1600015; FHXXX

Connections:
3V3: C11.2, C12.2, C13.2, FB1.2, J3.1 (VCC), J6.4 (VCCIO), R2.1, R5.2, R11.2, R12.2, U1.8 (VDDIN), U1.27 (VLCD), U1.31 (VLCDIN), U1.40 (VDDIO), U1.45 (VDDIO); also elsewhere on the board
5V: J6.2 (5V); also elsewhere on the board
!RESET: J3.3 (!RESET), J7.20 (DBG_!RESET), U1.4 (!RESET)
AMP_OUT: U1.11 (PA04); also elsewhere on the board
DBG_GPIO1: J7.16 (DBG_GPIO1), U1.23 (PA11)
DBG_GPIO2: J7.19 (DBG_GPIO2), U1.24 (PA12)
DBG_RX: J7.18 (DBG_RX), U1.38 (PA19); also elsewhere on the board
DBG_TX: J7.17 (DBG_TX), U1.39 (PA20); also elsewhere on the board
GND: C1.2, C2.2, C11.1, C12.1, C13.1, C14.1, C15.1, C22.1, J3.5 (GND), J6.1 (GND), J6.14 (GND), J7.15 (GND1), R1.1, U1.6 (GND), U1.17 (GNDANA), U1.30 (GND), U1.48 (GND), U1.THERMAL (GND); also elsewhere on the board
I2C_CLK: J6.5 (SCL), U1.44 (PA24)
I2C_DATA: J6.6 (SDA), U1.43 (PA23)
MOD_IN: J6.10 (MOD_IN), U1.21 (PA09)
MOD_OUT: J6.8 (MOD_OUT), U1.22 (PA10)
MSGEQ_OUT: U1.12 (PA05); also elsewhere on the board
MSGEQ_RESET: U1.34 (PA15); also elsewhere on the board
MSGEQ_STROBE: U1.33 (PA14); also elsewhere on the board
unnamed: L2.P$2 (2), U1.7 (VDDOUT)
unnamed: U1.28 (BIASH), U1.29 (BIASL)
unnamed: U1.25 (CAPH), U1.26 (CAPL)
unnamed: C14.2, FB1.1, U1.19 (VDDANA)
unnamed: R1.2, R5.1, U1.3 (PA02)
unnamed: LED1.A (ANODE), R2.2
unnamed: LED1.C (CATHODE), U1.36 (PA17)
unnamed: C15.2, C22.2, L2.P$1 (1), U1.5 (VDDCORE)
PPS: J6.7 (PPS), U1.20 (PA08)
RADAR_POWER_GATE: U1.15 (PA06); also elsewhere on the board
SWDCLK: J3.4 (SWDCLK), J7.21 (DBG_SWDCLK), R12.1, U1.9 (TCK)
SWDIO: J3.2 (SWDIO), J7.22 (DBG_SWDIO), R11.1, U1.10 (PA03)
USB+: J6.11 (USB_D+), U1.47 (PA26)
USB-: J6.12 (USB_D-), U1.46 (PA25)
XIN: C1.1, U1.1 (PA00), X1.3 (2)
XOUT: C2.1, U1.2 (PA01), X1.1

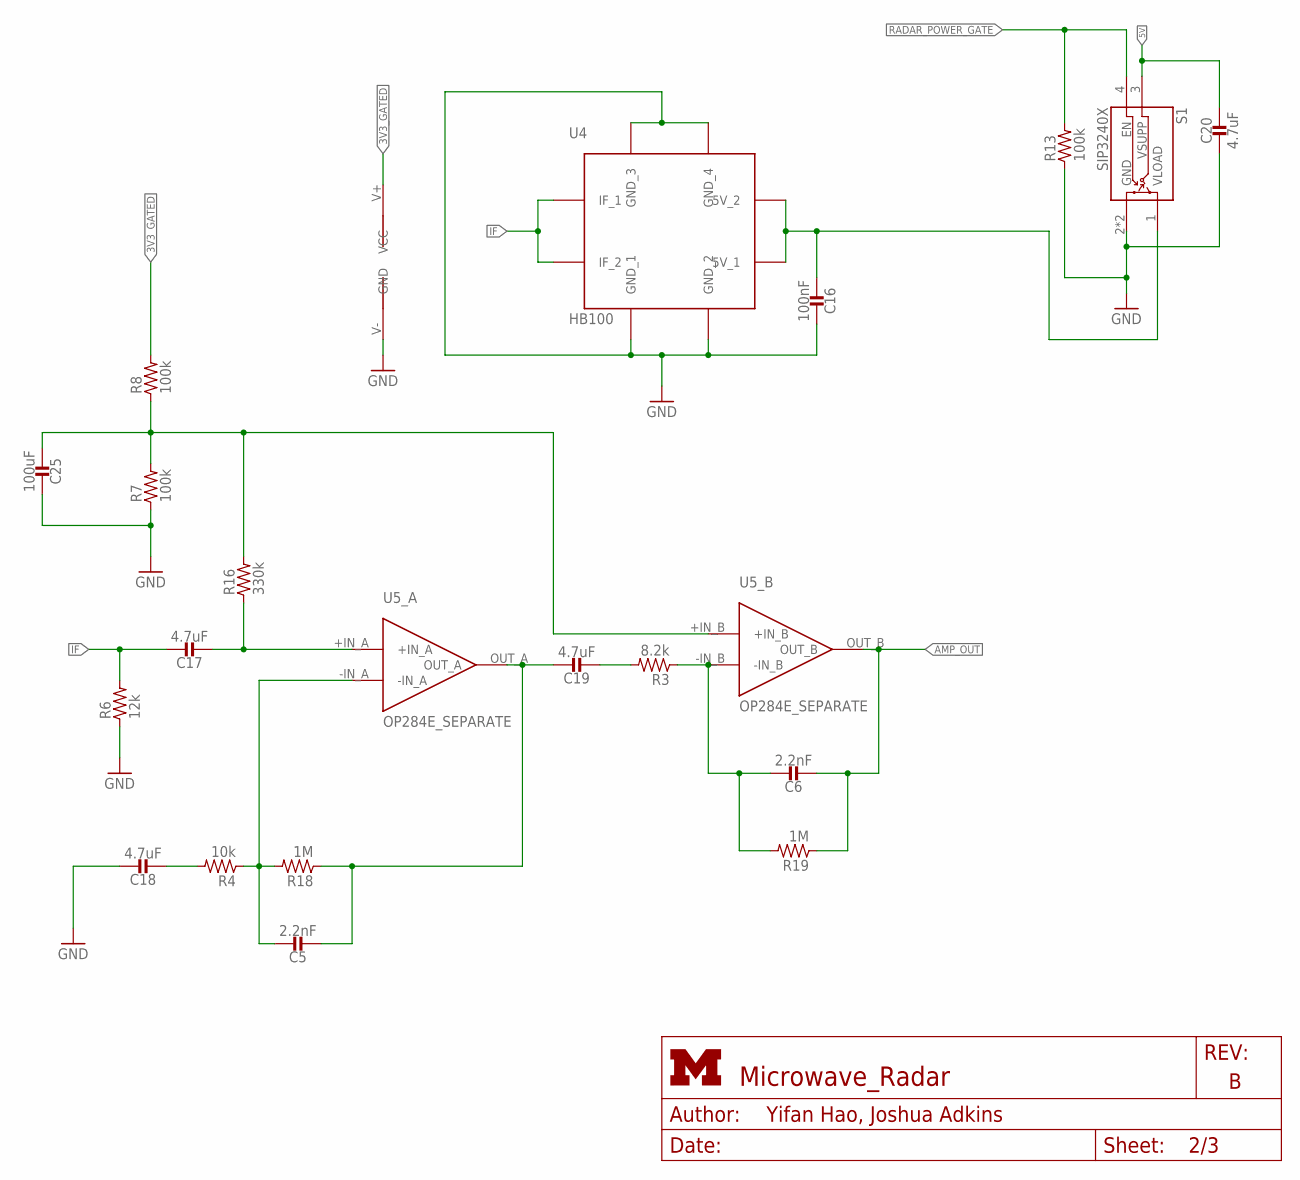
[picture p47: schematic microwave.sch, sheet 2]

Parts:
C5, C6: 2.2nF; 0402_CAP; MPN GRM155R70J222KA01D; DIGIKEY 490-11418-1-ND
C16: 100nF; 0402_CAP; MPN GRM155R71A104JA01D; DIGIKEY 490-10777-1-ND
C17, C18, C19, C20: 4.7uF; 0402_CAP; MPN CL05A475KQ5NRNC; DIGIKEY 1276-1481-1-ND
C25: 100uF; 1210_CAP; MPN GRM32ER60J107ME20L; DIGIKEY 490-3390-1-ND
R3: 8.2k; 0402_RES; MPN RC0402FR-078K2L; DIGIKEY 311-8.20KLRCT-ND
R4: 10k; 0402_RES; MPN RC1005F103CS; DIGIKEY 1276-3431-1-ND
R6: 12k; 0402_RES; MPN RC1005F123CS; DIGIKEY 1276-4122-1-ND
R7, R8, R13: 100k; 0402_RES; MPN RC1005F104CS; DIGIKEY 1276-3432-1-ND
R16: 330k; 0402_RES; MPN RC1005F334CS; DIGIKEY 1276-4244-1-ND
R18, R19: 1M; 0402_RES; MPN RC1005F104CS; DIGIKEY 1276-3432-1-ND
S1: SIP3240X; TDFN4
U4: HB100; MPN TSW-102-17-T-S; DIGIKEY SAM1067-02-ND
U5: OP284E_SEPARATE; MPN OP284ESZ; DIGIKEY OP284ESZ-ND

Connections:
3V3_GATED: R8.2, U5.V+ (VCC); also elsewhere on the board
5V: C20.1, S1.3 (VSUPP); also elsewhere on the board
5V_GATED: C16.2, S1.1 (VLOAD), U4.5V_1, U4.5V_2
AMP_OUT: C6.2, R19.1, U5.OUT_B; also elsewhere on the board
GND: C16.1, C18.1, C20.2, C25.1, R6.1, R7.1, R13.1, S1.2 (GND), S1.PAD (GND), U4.GND_1, U4.GND_2, U4.GND_3, U4.GND_4, U5.V- (GND); also elsewhere on the board
IF: C17.1, R6.2, U4.IF_1, U4.IF_2; also elsewhere on the board
unnamed: C25.2, R7.2, R8.1, R16.2, U5.+IN_B
unnamed: C17.2, R16.1, U5.+IN_A
unnamed: C5.1, R4.1, R18.2, U5.-IN_A
unnamed: C18.2, R4.2
unnamed: C5.2, C19.1, R18.1, U5.OUT_A
unnamed: C19.2, R3.2
unnamed: C6.1, R3.1, R19.2, U5.-IN_B
RADAR_POWER_GATE: R13.2, S1.4 (EN); also elsewhere on the board

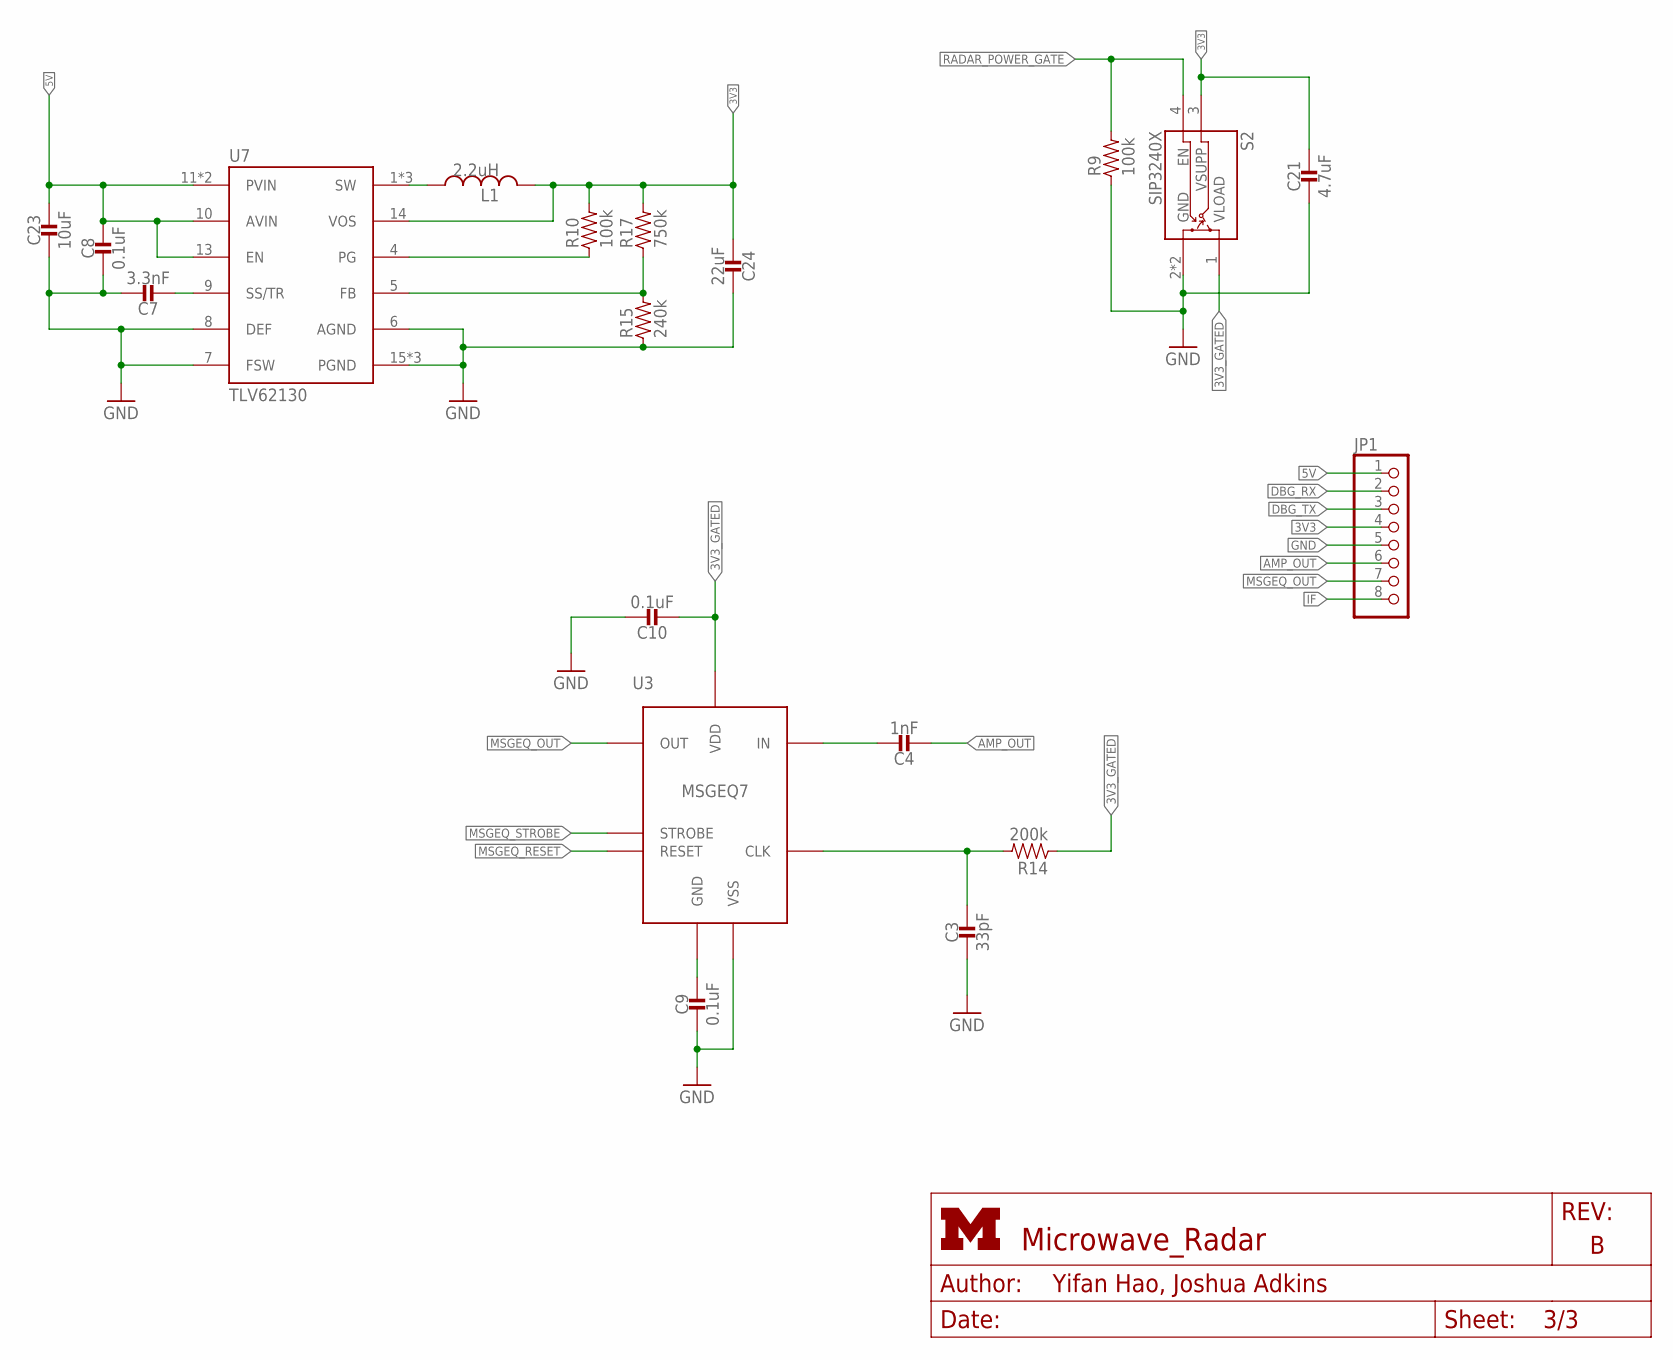
[picture p48: schematic microwave.sch, sheet 3]

Parts:
C3: 33pF; 0603_CAP; MPN GRM1885C1H330JA01D; DIGIKEY 490-1415-1-ND
C4: 1nF; 0603_CAP; MPN GRM188R71H102KA01D; DIGIKEY 490-1494-1-ND
C7: 3.3nF; 0402_CAP; MPN GRM155R71H332KA01D; DIGIKEY 490-3248-1-ND
C8: 0.1uF; 0402_CAP; MPN GRM155R71C104KA88J; DIGIKEY 490-6328-1-ND
C9, C10: 0.1uF; 0603_CAP; MPN GRM188R71C104KA01D; DIGIKEY 490-1532-1-ND
C21: 4.7uF; 0402_CAP; MPN CL05A475KQ5NRNC; DIGIKEY 1276-1481-1-ND
C23: 10uF; 0805_CAP; MPN C0805C106K8PACTU; DIGIKEY 399-4925-1-ND
C24: 22uF; 0603_CAP; MPN CC0603MRX5R5BB226; DIGIKEY 311-1815-1-ND
JP1: PINHD-1X8; 1X08
L1: 2.2uH; IHL-1212BZ-11
R9, R10: 100k; 0402_RES; MPN RC1005F104CS; DIGIKEY 1276-3432-1-ND
R14: 200k; 0603-RES; MPN RC0603JR-07200KL; DIGIKEY 311-200KGRCT-ND
R15: 240k; 0402_RES; MPN ERJ-2RKF2403X; DIGIKEY P240KLCT-ND
R17: 750k; 0402_RES; MPN ERJ-2RKF7503X; DIGIKEY P750KLCT-ND
S2: SIP3240X; TDFN4
U3: MSGEQ7; DIP-8
U7: TLV62130; TQFN-16/3MM

Connections:
3V3: C21.1, C24.2, JP1.4, L1.P$2 (2), R10.2, R17.2, S2.3 (VSUPP), U7.14 (VOS); also elsewhere on the board
3V3_GATED: C10.2, R14.1, S2.1 (VLOAD), U3.1 (VDD); also elsewhere on the board
5V: C8.1, C23.P$1 (1), JP1.1, U7.10 (AVIN), U7.11 (PVIN), U7.12 (PVIN), U7.13 (EN); also elsewhere on the board
AMP_OUT: C4.2, JP1.6; also elsewhere on the board
DBG_RX: JP1.2; also elsewhere on the board
DBG_TX: JP1.3; also elsewhere on the board
GND: C3.2, C7.1, C8.2, C9.2, C10.1, C21.2, C23.P$2 (2), C24.1, JP1.5, R9.1, R15.1, S2.2 (GND), S2.PAD (GND), U3.2 (VSS), U7.6 (AGND), U7.7 (FSW), U7.8 (DEF), U7.15 (PGND), U7.16 (PGND), U7.GND; also elsewhere on the board
IF: JP1.8; also elsewhere on the board
MSGEQ_OUT: JP1.7, U3.3 (OUT); also elsewhere on the board
MSGEQ_RESET: U3.7 (RESET); also elsewhere on the board
MSGEQ_STROBE: U3.4 (STROBE); also elsewhere on the board
unnamed: C3.1, R14.2, U3.8 (CLK)
unnamed: C4.1, U3.5 (IN)
unnamed: C9.1, U3.6 (GND)
unnamed: C7.2, U7.9 (SS/TR)
unnamed: L1.P$1 (1), U7.1 (SW), U7.2 (SW), U7.3 (SW)
unnamed: R10.1, U7.4 (PG)
unnamed: R15.2, R17.1, U7.5 (FB)
RADAR_POWER_GATE: R9.2, S2.4 (EN); also elsewhere on the board

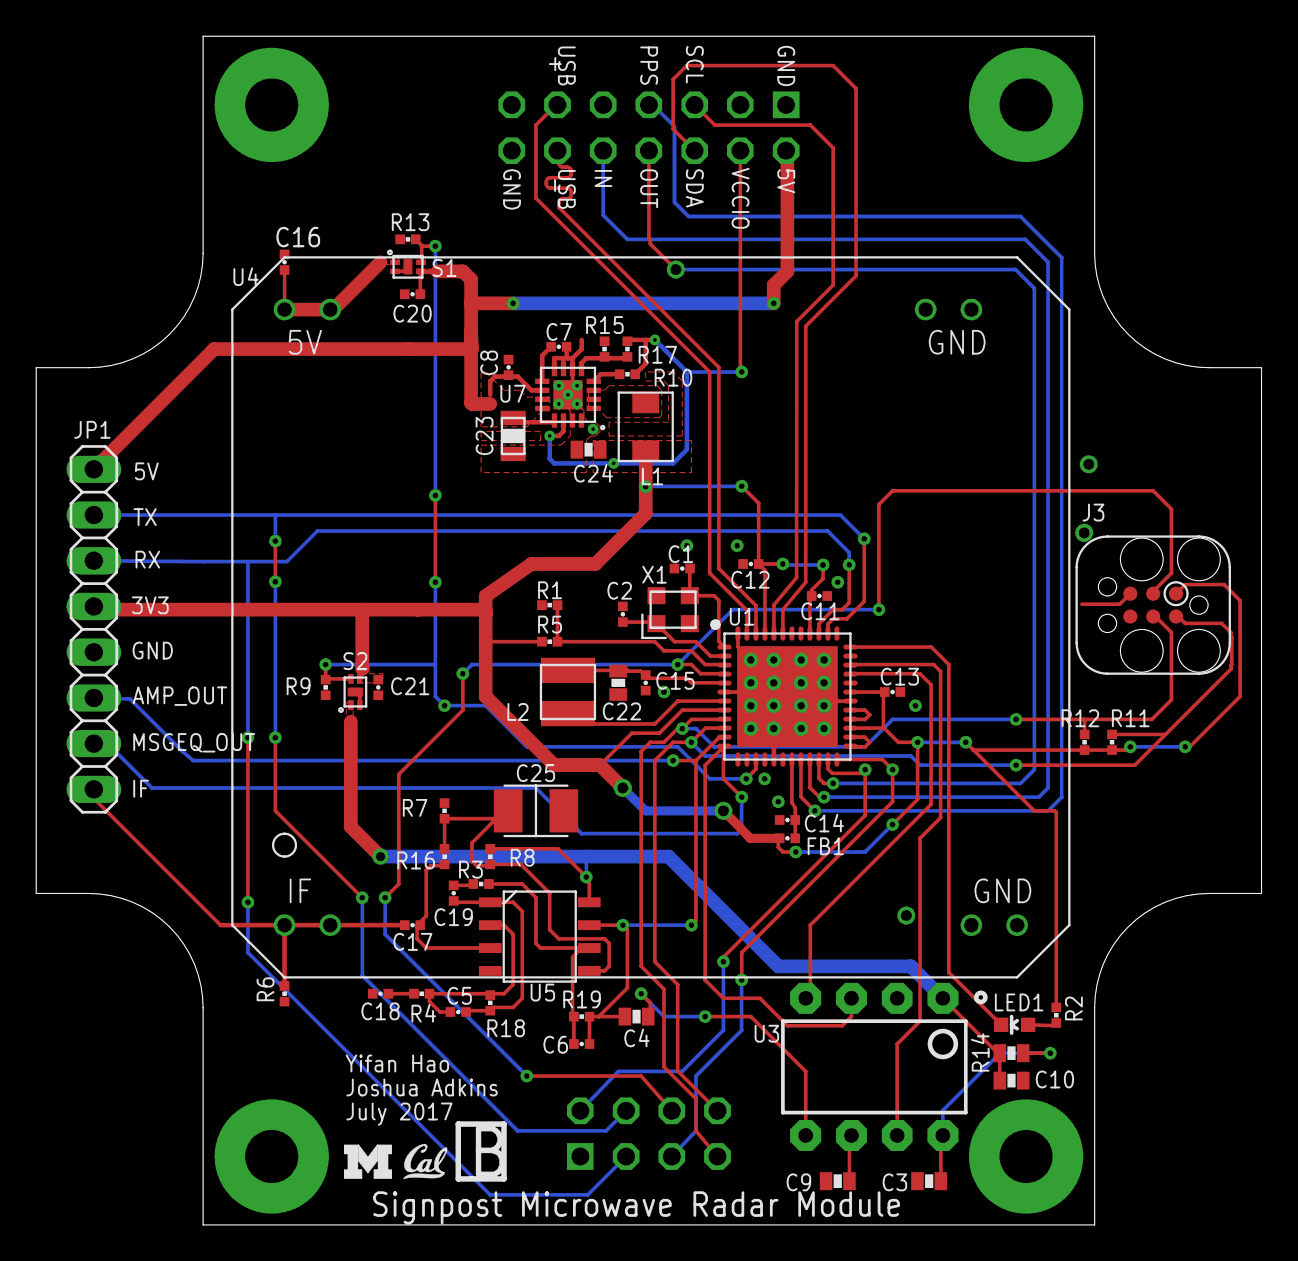
[picture p49: board modules/microwave_radar/hardware/rev_b/macrofab_compliant/microwave.b… from above]

Board: 2 copper layers, 68.1 x 66.0 mm, 62 parts (0 on the bottom side), 49 nets.

Other parts of the board:
U$2: UMICH_SOLID_75MIL
U$3: UCB_CAL_75MIL
