lab11/signpost/hardware/controller/rev_d/controller.brd

## EAGLE design hardware/controller/rev_d/controller.brd (2017-09-04)

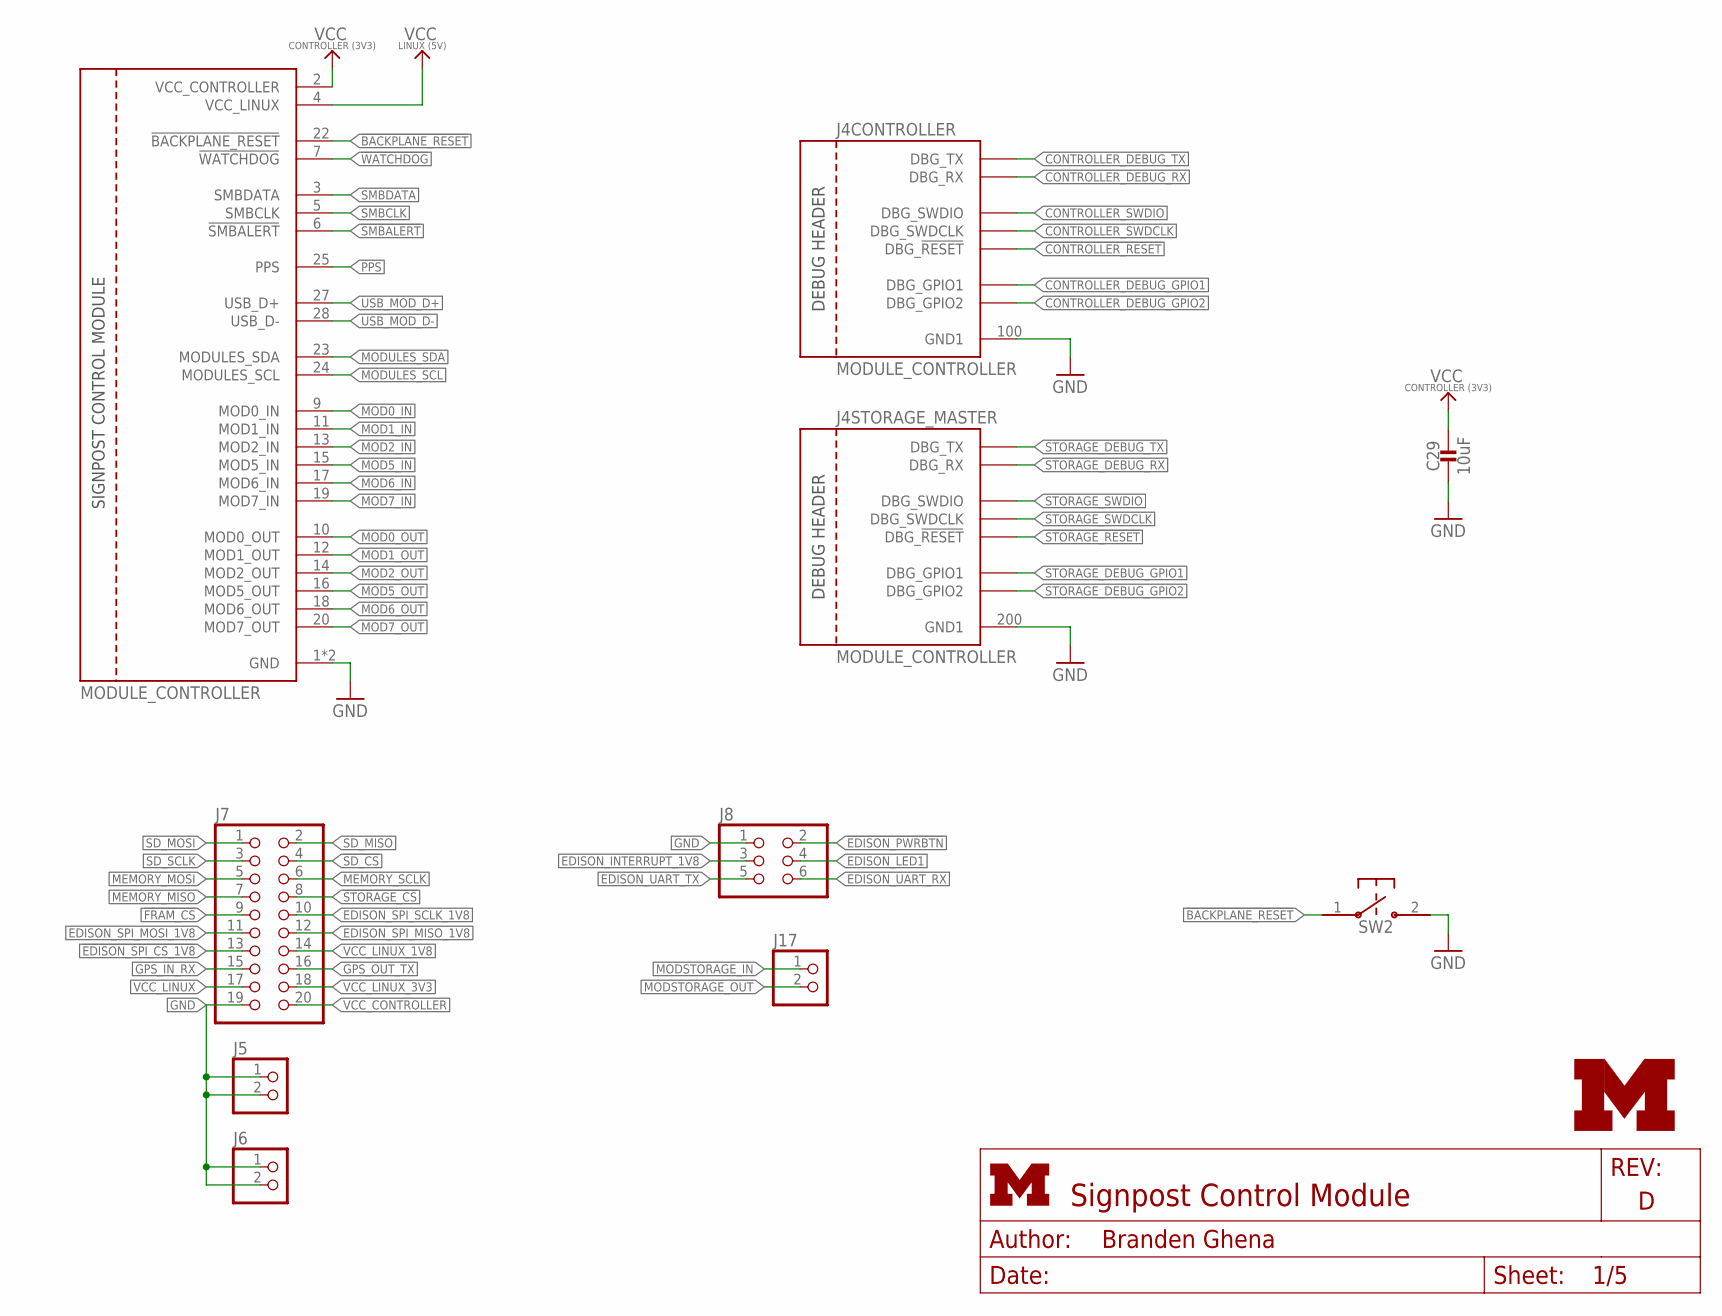
[picture p50: schematic controller.sch, sheet 1, Headers]

Parts:
C29: 10uF; 0402_CAP; DIGIKEY 490-13811-1-ND
J4: MODULE_CONTROLLER
J5, J6, J17: PINHD-1X2; 1X02
J7: PINHD-2X10; 2X10
J8: PINHD-2X3; 2X03
LOGO1: UMICH_SOLID_MEDIUM; UMICH_SOLID_200MIL
SW2: B3U-1000P

Connections:
!BACKPLANE_RESET: J4.22 (!BACKPLANE_RESET), SW2.1; also elsewhere on the board
!CONTROLLER_RESET: J4.105 (DBG_!RESET); also elsewhere on the board
!EDISON_PWRBTN: J8.2; also elsewhere on the board
!EDISON_SPI_CS_1V8: J7.13; also elsewhere on the board
!FRAM_CS: J7.9; also elsewhere on the board
!SD_CS: J7.4; also elsewhere on the board
!SMBALERT: J4.6 (!SMBALERT); also elsewhere on the board
!STORAGE_CS: J7.8; also elsewhere on the board
!STORAGE_RESET: J4.205 (DBG_!RESET); also elsewhere on the board
!WATCHDOG: J4.7 (!WATCHDOG); also elsewhere on the board
CONTROLLER_DEBUG_GPIO1: J4.101 (DBG_GPIO1); also elsewhere on the board
CONTROLLER_DEBUG_GPIO2: J4.104 (DBG_GPIO2); also elsewhere on the board
CONTROLLER_DEBUG_RX: J4.103 (DBG_RX); also elsewhere on the board
CONTROLLER_DEBUG_TX: J4.102 (DBG_TX); also elsewhere on the board
CONTROLLER_SWDCLK: J4.106 (DBG_SWDCLK); also elsewhere on the board
CONTROLLER_SWDIO: J4.107 (DBG_SWDIO); also elsewhere on the board
EDISON_INTERRUPT_1V8: J8.3; also elsewhere on the board
EDISON_LED1: J8.4; also elsewhere on the board
EDISON_SPI_MISO_1V8: J7.12; also elsewhere on the board
EDISON_SPI_MOSI_1V8: J7.11; also elsewhere on the board
EDISON_SPI_SCLK_1V8: J7.10; also elsewhere on the board
EDISON_UART_RX: J8.6; also elsewhere on the board
EDISON_UART_TX: J8.5; also elsewhere on the board
GND: C29.2, J4.1 (GND), J4.21 (GND), J4.100 (GND1), J4.200 (GND1), J5.1, J5.2, J6.1, J6.2, J7.19, J8.1, SW2.2; also elsewhere on the board
GPS_IN_RX: J7.15; also elsewhere on the board
GPS_OUT_TX: J7.16; also elsewhere on the board
MEMORY_MISO: J7.7; also elsewhere on the board
MEMORY_MOSI: J7.5; also elsewhere on the board
MEMORY_SCLK: J7.6; also elsewhere on the board
MOD0_IN: J4.9 (MOD0_IN); also elsewhere on the board
MOD0_OUT: J4.10 (MOD0_OUT); also elsewhere on the board
MOD1_IN: J4.11 (MOD1_IN); also elsewhere on the board
MOD1_OUT: J4.12 (MOD1_OUT); also elsewhere on the board
MOD2_IN: J4.13 (MOD2_IN); also elsewhere on the board
MOD2_OUT: J4.14 (MOD2_OUT); also elsewhere on the board
MOD5_IN: J4.15 (MOD5_IN); also elsewhere on the board
MOD5_OUT: J4.16 (MOD5_OUT); also elsewhere on the board
MOD6_IN: J4.17 (MOD6_IN); also elsewhere on the board
MOD6_OUT: J4.18 (MOD6_OUT); also elsewhere on the board
MOD7_IN: J4.19 (MOD7_IN); also elsewhere on the board
MOD7_OUT: J4.20 (MOD7_OUT); also elsewhere on the board
MODSTORAGE_IN: J17.1; also elsewhere on the board
MODSTORAGE_OUT: J17.2; also elsewhere on the board
MODULES_SCL: J4.24 (MODULES_SCL); also elsewhere on the board
MODULES_SDA: J4.23 (MODULES_SDA); also elsewhere on the board
PPS: J4.25 (PPS); also elsewhere on the board
SD_MISO: J7.2; also elsewhere on the board
SD_MOSI: J7.1; also elsewhere on the board
SD_SCLK: J7.3; also elsewhere on the board
SMBCLK: J4.5 (SMBCLK); also elsewhere on the board
SMBDATA: J4.3 (SMBDATA); also elsewhere on the board
STORAGE_DEBUG_GPIO1: J4.201 (DBG_GPIO1); also elsewhere on the board
STORAGE_DEBUG_GPIO2: J4.204 (DBG_GPIO2); also elsewhere on the board
STORAGE_DEBUG_RX: J4.203 (DBG_RX); also elsewhere on the board
STORAGE_DEBUG_TX: J4.202 (DBG_TX); also elsewhere on the board
STORAGE_SWDCLK: J4.206 (DBG_SWDCLK); also elsewhere on the board
STORAGE_SWDIO: J4.207 (DBG_SWDIO); also elsewhere on the board
USB_MOD_D+: J4.27 (USB_D+); also elsewhere on the board
USB_MOD_D-: J4.28 (USB_D-); also elsewhere on the board
VCC_CONTROLLER: C29.1, J4.2 (VCC_CONTROLLER), J7.20; also elsewhere on the board
VCC_LINUX: J4.4 (VCC_LINUX), J7.17; also elsewhere on the board
VCC_LINUX_1V8: J7.14; also elsewhere on the board
VCC_LINUX_3V3: J7.18; also elsewhere on the board
