lab11/signpost/hardware/controller/rev_d/controller.brd

## EAGLE design hardware/controller/rev_d/controller.brd (continued)

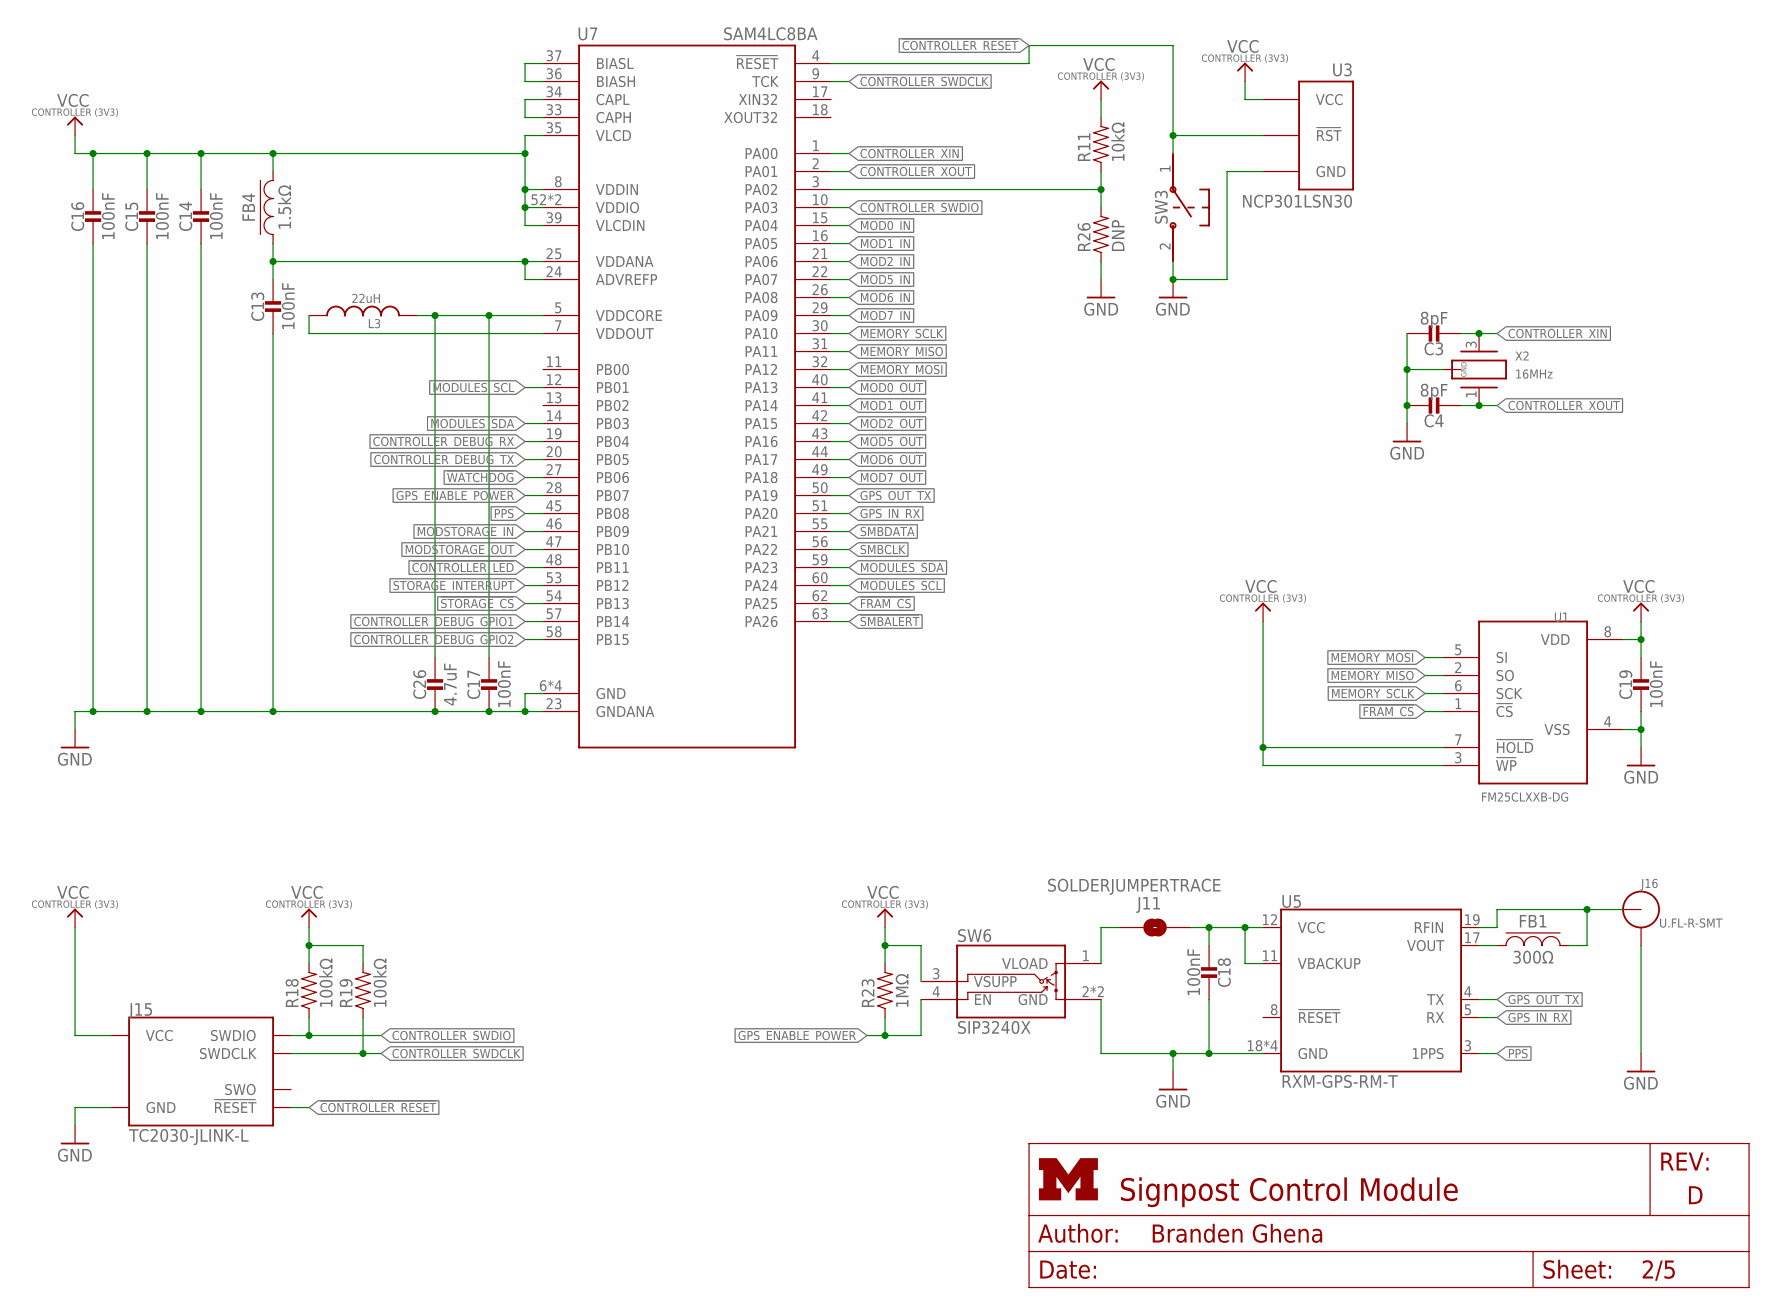
[picture p51: schematic controller.sch, sheet 2]

Parts:
C3, C4: 8pF; 0402_CAP; DIGIKEY 490-8230-1-ND
C13, C14, C15, C16, C17, C18, C19: 100nF; 0402_CAP; DIGIKEY 490-10777-1-ND
C26: 4.7uF; 0402_CAP; DIGIKEY 490-13252-1-ND
FB1: 300Ω; 0402_CAP; DIGIKEY ACML-0402-301-TCT-ND
FB4: 1.5kΩ; 0402_CAP; DIGIKEY 1276-6395-1-ND
J11: SOLDERJUMPERTRACE; SJ_2S-TRACE
J15: TC2030-JLINK-L; TC2030-IDC
J16: U.FL-R-SMT; U.FL_SMT
L3: 22uH; 1212
R11: 10kΩ; 0402_RES; DIGIKEY 1276-3431-1-ND
R18, R19: 100kΩ; 0402_RES; DIGIKEY 1276-3432-1-ND
R23: 1MΩ; 0402_RES; DIGIKEY 1276-3433-1-ND
R26: DNP; 0402_RES; DIGIKEY 1276-3431-1-ND
SW3: B3U-1000P
SW6: SIP3240X; TDFN4
U1: FM25CLXXB-DG; TDFN-8; DIGIKEY FM25CL64B-DGRA-ND
U3: NCP301LSN30; SOT23-5
U5: RXM-GPS-RM-T
U7: SAM4LC8BA; QFN-64-9MM
X2: 16MHz; FHXXX

Connections:
!CONTROLLER_LED: U7.48 (PB11); also elsewhere on the board
!CONTROLLER_RESET: J15.3 (!RESET), SW3.1, U3.1 (!RST), U7.4 (!RESET); also elsewhere on the board
!FRAM_CS: U1.1 (!CS), U7.62 (PA25); also elsewhere on the board
!SMBALERT: U7.63 (PA26); also elsewhere on the board
!STORAGE_CS: U7.54 (PB13); also elsewhere on the board
!WATCHDOG: U7.27 (PB06); also elsewhere on the board
CONTROLLER_BUCK/LDO_N: R11.1, R26.2, U7.3 (PA02)
CONTROLLER_DEBUG_GPIO1: U7.57 (PB14); also elsewhere on the board
CONTROLLER_DEBUG_GPIO2: U7.58 (PB15); also elsewhere on the board
CONTROLLER_DEBUG_RX: U7.19 (PB04); also elsewhere on the board
CONTROLLER_DEBUG_TX: U7.20 (PB05); also elsewhere on the board
CONTROLLER_SWDCLK: J15.4 (SWDCLK), R19.1, U7.9 (TCK); also elsewhere on the board
CONTROLLER_SWDIO: J15.2 (SWDIO), R18.1, U7.10 (PA03); also elsewhere on the board
CONTROLLER_XIN: C3.1, U7.1 (PA00), X2.3 (2)
CONTROLLER_XOUT: C4.1, U7.2 (PA01), X2.1
GND: C3.2, C4.2, C13.2, C14.2, C15.2, C16.2, C17.2, C18.2, C19.2, C26.2, J15.5 (GND), J16.GND1, J16.GND2, R26.1, SW3.2, SW6.2 (GND), SW6.PAD (GND), U1.4 (VSS), U3.3 (GND), U5.18 (GND), U5.20 (GND), U5.21 (GND), U5.22 (GND), U7.6 (GND), U7.23 (GNDANA), U7.38 (GND), U7.64 (GND), U7.GND, X2.2 (GND), X2.4 (GND); also elsewhere on the board
GPS_ENABLE_POWER: R23.1, SW6.4 (EN), U7.28 (PB07)
GPS_IN_RX: U5.5 (RX), U7.51 (PA20); also elsewhere on the board
GPS_OUT_TX: U5.4 (TX), U7.50 (PA19); also elsewhere on the board
MEMORY_MISO: U1.2 (SO), U7.31 (PA11); also elsewhere on the board
MEMORY_MOSI: U1.5 (SI), U7.32 (PA12); also elsewhere on the board
MEMORY_SCLK: U1.6 (SCK), U7.30 (PA10); also elsewhere on the board
MOD0_IN: U7.15 (PA04); also elsewhere on the board
MOD0_OUT: U7.40 (PA13); also elsewhere on the board
MOD1_IN: U7.16 (PA05); also elsewhere on the board
MOD1_OUT: U7.41 (PA14); also elsewhere on the board
MOD2_IN: U7.21 (PA06); also elsewhere on the board
MOD2_OUT: U7.42 (PA15); also elsewhere on the board
MOD5_IN: U7.22 (PA07); also elsewhere on the board
MOD5_OUT: U7.43 (PA16); also elsewhere on the board
MOD6_IN: U7.26 (PA08); also elsewhere on the board
MOD6_OUT: U7.44 (PA17); also elsewhere on the board
MOD7_IN: U7.29 (PA09); also elsewhere on the board
MOD7_OUT: U7.49 (PA18); also elsewhere on the board
MODSTORAGE_IN: U7.46 (PB09); also elsewhere on the board
MODSTORAGE_OUT: U7.47 (PB10); also elsewhere on the board
MODULES_SCL: U7.12 (PB01), U7.60 (PA24); also elsewhere on the board
MODULES_SDA: U7.14 (PB03), U7.59 (PA23); also elsewhere on the board
unnamed: FB1.1, U5.17 (VOUT)
unnamed: FB1.2, J16.SIG (ANT), U5.19 (RFIN)
unnamed: J11.1, SW6.1 (VLOAD)
unnamed: C13.1, FB4.1, U7.24 (ADVREFP), U7.25 (VDDANA)
unnamed: L3.P$1 (1), U7.7 (VDDOUT)
unnamed: U7.36 (BIASH), U7.37 (BIASL)
unnamed: U7.33 (CAPH), U7.34 (CAPL)
unnamed: C18.1, J11.2, U5.11 (VBACKUP), U5.12 (VCC)
unnamed: C17.1, C26.1, L3.P$2 (2), U7.5 (VDDCORE)
PPS: U5.3 (1PPS), U7.45 (PB08); also elsewhere on the board
SMBCLK: U7.56 (PA22); also elsewhere on the board
SMBDATA: U7.55 (PA21); also elsewhere on the board
STORAGE_INTERRUPT: U7.53 (PB12); also elsewhere on the board
VCC_CONTROLLER: C14.1, C15.1, C16.1, C19.1, FB4.2, J15.1 (VCC), R11.2, R18.2, R19.2, R23.2, SW6.3 (VSUPP), U1.3 (!WP), U1.7 (!HOLD), U1.8 (VDD), U3.2 (VCC), U7.8 (VDDIN), U7.35 (VLCD), U7.39 (VLCDIN), U7.52 (VDDIO), U7.61 (VDDIO); also elsewhere on the board

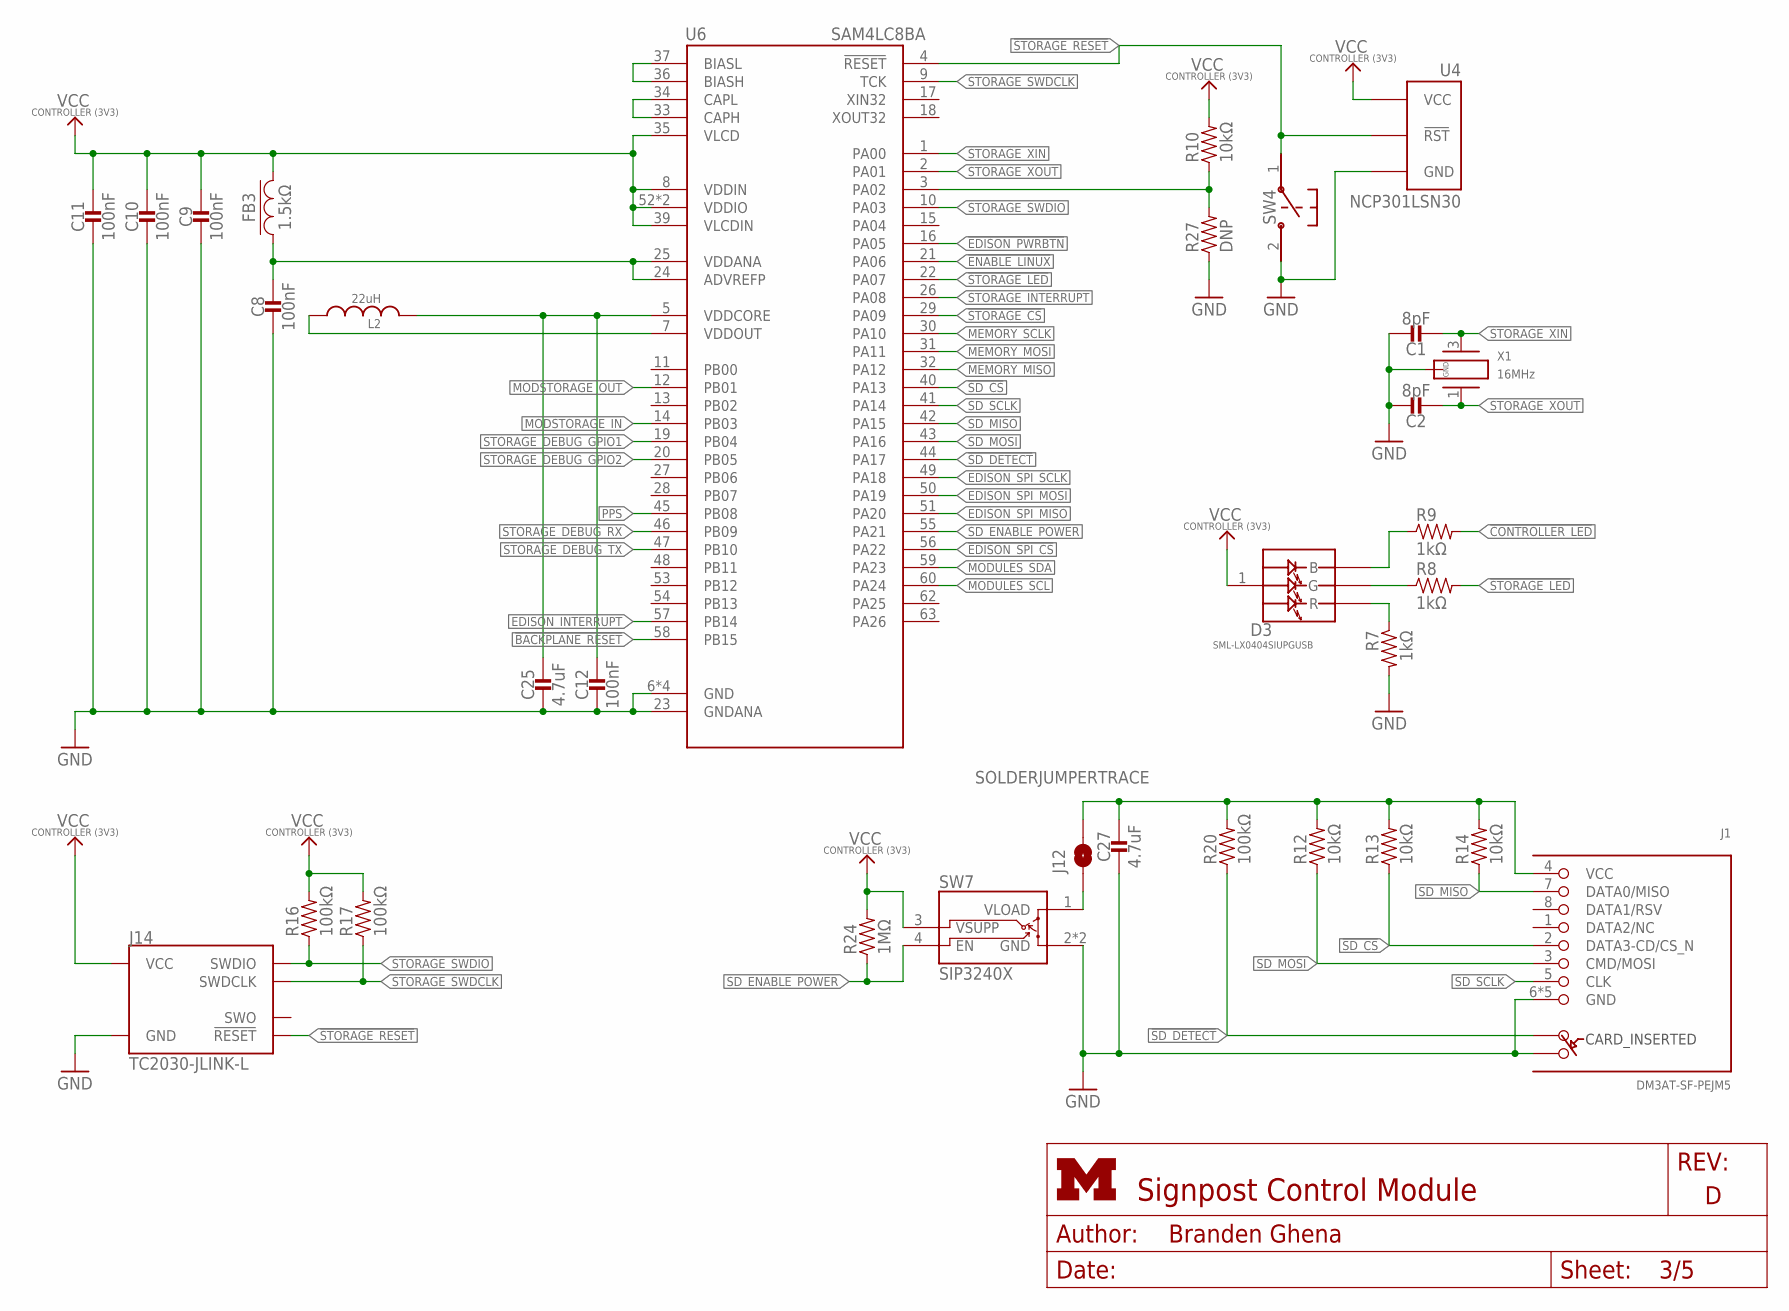
[picture p52: schematic controller.sch, sheet 3, Storage Master]

Parts:
C1, C2: 8pF; 0402_CAP; DIGIKEY 490-8230-1-ND
C8, C9, C10, C11, C12: 100nF; 0402_CAP; DIGIKEY 490-10777-1-ND
C25, C27: 4.7uF; 0402_CAP; DIGIKEY 490-13252-1-ND
D3: SML-LX0404SIUPGUSB; 1MM_SQ_4PAD
FB3: 1.5kΩ; 0402_CAP; DIGIKEY 1276-6395-1-ND
J1: DM3AT-SF-PEJM5
J12: SOLDERJUMPERTRACE; SJ_2S-TRACE
J14: TC2030-JLINK-L; TC2030-IDC
L2: 22uH; 1212
R7, R8, R9: 1kΩ; 0402_RES; DIGIKEY 1276-3430-1-ND
R10, R12, R13, R14: 10kΩ; 0402_RES; DIGIKEY 1276-3431-1-ND
R16, R17, R20: 100kΩ; 0402_RES; DIGIKEY 1276-3432-1-ND
R24: 1MΩ; 0402_RES; DIGIKEY 1276-3433-1-ND
R27: DNP; 0402_RES; DIGIKEY 1276-3431-1-ND
SW4: B3U-1000P
SW7: SIP3240X; TDFN4
U4: NCP301LSN30; SOT23-5
U6: SAM4LC8BA; QFN-64-9MM
X1: 16MHz; FHXXX

Connections:
!BACKPLANE_RESET: U6.58 (PB15); also elsewhere on the board
!CONTROLLER_LED: R9.2; also elsewhere on the board
!EDISON_PWRBTN: U6.16 (PA05); also elsewhere on the board
!EDISON_SPI_CS: U6.56 (PA22); also elsewhere on the board
!ENABLE_LINUX: U6.21 (PA06); also elsewhere on the board
!SD_CS: J1.2 (DATA3-CD/CS_N), R13.1, U6.40 (PA13); also elsewhere on the board
!SD_DETECT: J1.A, R20.1, U6.44 (PA17)
!STORAGE_CS: U6.29 (PA09); also elsewhere on the board
!STORAGE_LED: R8.2, U6.22 (PA07)
!STORAGE_RESET: J14.3 (!RESET), SW4.1, U4.1 (!RST), U6.4 (!RESET); also elsewhere on the board
EDISON_INTERRUPT: U6.57 (PB14); also elsewhere on the board
EDISON_SPI_MISO: U6.51 (PA20); also elsewhere on the board
EDISON_SPI_MOSI: U6.50 (PA19); also elsewhere on the board
EDISON_SPI_SCLK: U6.49 (PA18); also elsewhere on the board
GND: C1.2, C2.2, C8.2, C9.2, C10.2, C11.2, C12.2, C25.2, C27.2, J1.6 (GND), J1.B, J1.MOUNT0 (GND), J1.MOUNT1 (GND), J1.MOUNT2 (GND), J1.MOUNT3 (GND), J14.5 (GND), R7.2, R27.1, SW4.2, SW7.2 (GND), SW7.PAD (GND), U4.3 (GND), U6.6 (GND), U6.23 (GNDANA), U6.38 (GND), U6.64 (GND), U6.GND, X1.2 (GND), X1.4 (GND); also elsewhere on the board
MEMORY_MISO: U6.32 (PA12); also elsewhere on the board
MEMORY_MOSI: U6.31 (PA11); also elsewhere on the board
MEMORY_SCLK: U6.30 (PA10); also elsewhere on the board
MODSTORAGE_IN: U6.14 (PB03); also elsewhere on the board
MODSTORAGE_OUT: U6.12 (PB01); also elsewhere on the board
MODULES_SCL: U6.60 (PA24); also elsewhere on the board
MODULES_SDA: U6.59 (PA23); also elsewhere on the board
unnamed: D3.2 (R), R7.1
unnamed: D3.4 (G), R8.1
unnamed: D3.3 (B), R9.1
unnamed: J12.1, SW7.1 (VLOAD)
unnamed: C8.1, FB3.1, U6.24 (ADVREFP), U6.25 (VDDANA)
unnamed: L2.P$1 (1), U6.7 (VDDOUT)
unnamed: C12.1, C25.1, L2.P$2 (2), U6.5 (VDDCORE)
unnamed: U6.33 (CAPH), U6.34 (CAPL)
unnamed: U6.36 (BIASH), U6.37 (BIASL)
unnamed: C27.1, J1.4 (VCC), J12.2, R12.2, R13.2, R14.2, R20.2
PPS: U6.45 (PB08); also elsewhere on the board
SD_ENABLE_POWER: R24.1, SW7.4 (EN), U6.55 (PA21)
SD_MISO: J1.7 (DATA0/MISO), R14.1, U6.42 (PA15); also elsewhere on the board
SD_MOSI: J1.3 (CMD/MOSI), R12.1, U6.43 (PA16); also elsewhere on the board
SD_SCLK: J1.5 (CLK), U6.41 (PA14); also elsewhere on the board
STORAGE_BUCK/LDO_N: R10.1, R27.2, U6.3 (PA02)
STORAGE_DEBUG_GPIO1: U6.19 (PB04); also elsewhere on the board
STORAGE_DEBUG_GPIO2: U6.20 (PB05); also elsewhere on the board
STORAGE_DEBUG_RX: U6.46 (PB09); also elsewhere on the board
STORAGE_DEBUG_TX: U6.47 (PB10); also elsewhere on the board
STORAGE_INTERRUPT: U6.26 (PA08); also elsewhere on the board
STORAGE_SWDCLK: J14.4 (SWDCLK), R17.1, U6.9 (TCK); also elsewhere on the board
STORAGE_SWDIO: J14.2 (SWDIO), R16.1, U6.10 (PA03); also elsewhere on the board
STORAGE_XIN: C1.1, U6.1 (PA00), X1.3 (2)
STORAGE_XOUT: C2.1, U6.2 (PA01), X1.1
VCC_CONTROLLER: C9.1, C10.1, C11.1, D3.1 (VDD), FB3.2, J14.1 (VCC), R10.2, R16.2, R17.2, R24.2, SW7.3 (VSUPP), U4.2 (VCC), U6.8 (VDDIN), U6.35 (VLCD), U6.39 (VLCDIN), U6.52 (VDDIO), U6.61 (VDDIO); also elsewhere on the board

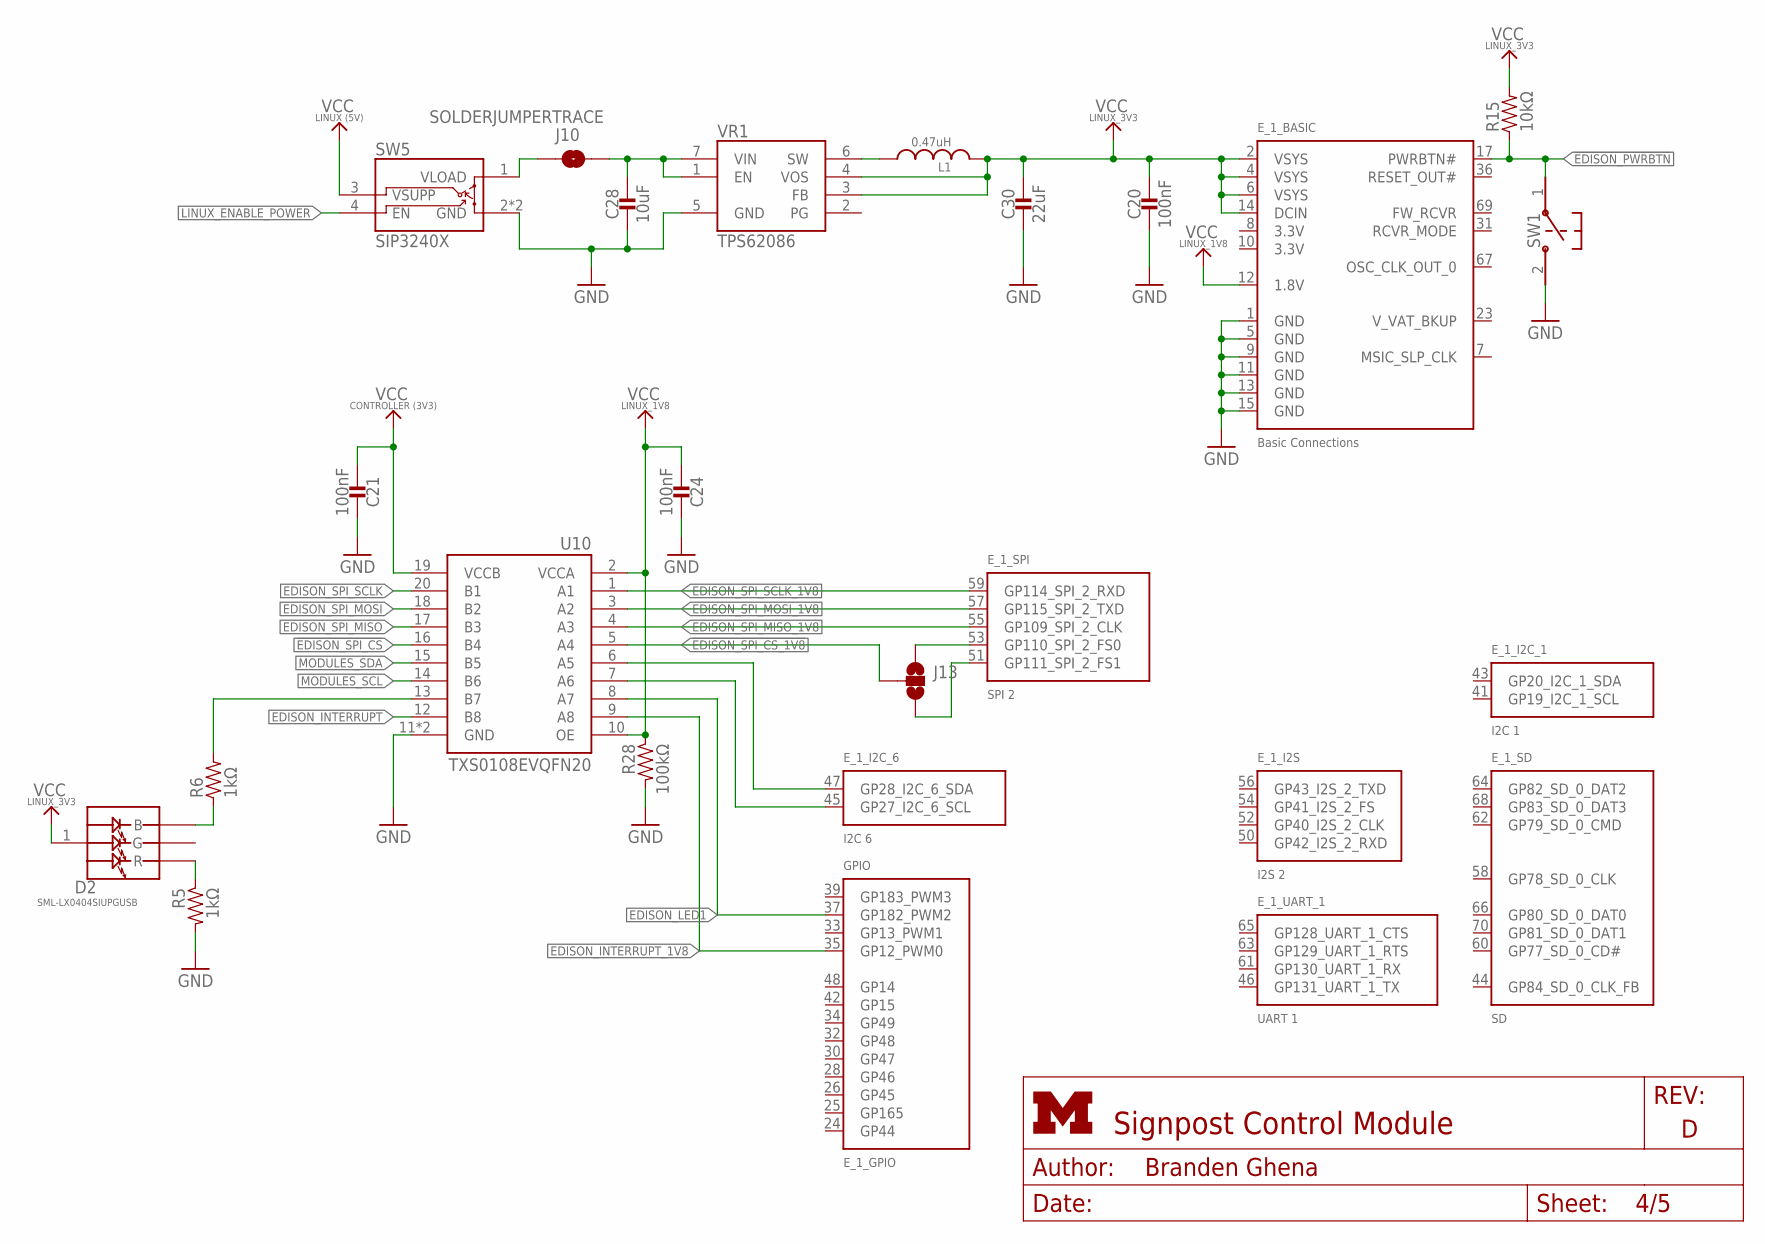
[picture p53: schematic controller.sch, sheet 4, Edison]

Parts:
C20, C21, C24: 100nF; 0402_CAP; DIGIKEY 490-10777-1-ND
C28: 10uF; 0805_CAP; DIGIKEY 490-8316-1-ND
C30: 22uF; 0805_CAP; DIGIKEY 490-1719-1-ND
D2: SML-LX0404SIUPGUSB; 1MM_SQ_4PAD
E_1: EDISON_CONNECTOR_SEGMENTED; EDISON_DAUGHTER; MOUSER 798-DF40HC3070DS4V51
J10: SOLDERJUMPERTRACE; SJ_2S-TRACE
J13: SOLDERJUMPER_2WAYPASTE2&3; SJ_3_PASTE2&3
L1: 0.47uH; DFE322512C; DIGIKEY 490-10596-1-ND
R5, R6: 1kΩ; 0402_RES; DIGIKEY 1276-3430-1-ND
R15: 10kΩ; 0402_RES; DIGIKEY 1276-3431-1-ND
R28: 100kΩ; 0402_RES; DIGIKEY 1276-3432-1-ND
SW1: B3U-1000P
SW5: SIP3240X; TDFN4
U10: TXS0108EVQFN20; R-PVQFN-N20; DIGIKEY 296-24806-1-ND
VR1: TPS62086; RLT0007A

Connections:
!EDISON_PWRBTN: E_1.17 (PWRBTN#), R15.1, SW1.1; also elsewhere on the board
!EDISON_SPI_CS: U10.16 (B4); also elsewhere on the board
!EDISON_SPI_CS_1V8: J13.2, U10.5 (A4); also elsewhere on the board
EDISON_INTERRUPT: U10.12 (B8); also elsewhere on the board
EDISON_INTERRUPT_1V8: E_1.35 (GP12_PWM0), U10.9 (A8); also elsewhere on the board
EDISON_LED1: E_1.37 (GP182_PWM2), U10.8 (A7); also elsewhere on the board
EDISON_SPI_MISO: U10.17 (B3); also elsewhere on the board
EDISON_SPI_MISO_1V8: E_1.55 (GP109_SPI_2_CLK), U10.4 (A3); also elsewhere on the board
EDISON_SPI_MOSI: U10.18 (B2); also elsewhere on the board
EDISON_SPI_MOSI_1V8: E_1.57 (GP115_SPI_2_TXD), U10.3 (A2); also elsewhere on the board
EDISON_SPI_SCLK: U10.20 (B1); also elsewhere on the board
EDISON_SPI_SCLK_1V8: E_1.59 (GP114_SPI_2_RXD), U10.1 (A1); also elsewhere on the board
GND: C20.2, C21.1, C24.1, C28.P$2 (2), C30.P$2 (2), E_1.1 (GND), E_1.5 (GND), E_1.9 (GND), E_1.11 (GND), E_1.13 (GND), E_1.15 (GND), R5.2, R28.2, SW1.2, SW5.2 (GND), SW5.PAD (GND), U10.11 (GND), U10.THERMAL (GND), VR1.5 (GND); also elsewhere on the board
LINUX_5V_IN: C28.P$1 (1), J10.2, VR1.1 (EN), VR1.7 (VIN)
LINUX_ENABLE_POWER: SW5.4 (EN); also elsewhere on the board
MODULES_SCL: U10.14 (B6); also elsewhere on the board
MODULES_SCL_1V8: E_1.45 (GP27_I2C_6_SCL), U10.7 (A6)
MODULES_SDA: U10.15 (B5); also elsewhere on the board
MODULES_SDA_1V8: E_1.47 (GP28_I2C_6_SDA), U10.6 (A5)
unnamed: E_1.53 (GP110_SPI_2_FS0), J13.1
unnamed: E_1.51 (GP111_SPI_2_FS1), J13.3
unnamed: L1.P$1 (1), VR1.6 (SW)
unnamed: J10.1, SW5.1 (VLOAD)
unnamed: D2.2 (R), R5.1
unnamed: D2.3 (B), R6.1
unnamed: R6.2, U10.13 (B7)
VCC_CONTROLLER: C21.2, U10.19 (VCCB); also elsewhere on the board
VCC_LINUX: SW5.3 (VSUPP); also elsewhere on the board
VCC_LINUX_1V8: C24.2, E_1.12 (1.8V), R28.1, U10.2 (VCCA), U10.10 (OE); also elsewhere on the board
VCC_LINUX_3V3: C20.1, C30.P$1 (1), D2.1 (VDD), E_1.2 (VSYS), E_1.4 (VSYS), E_1.6 (VSYS), E_1.14 (DCIN), L1.P$2 (2), R15.2, VR1.3 (FB), VR1.4 (VOS); also elsewhere on the board

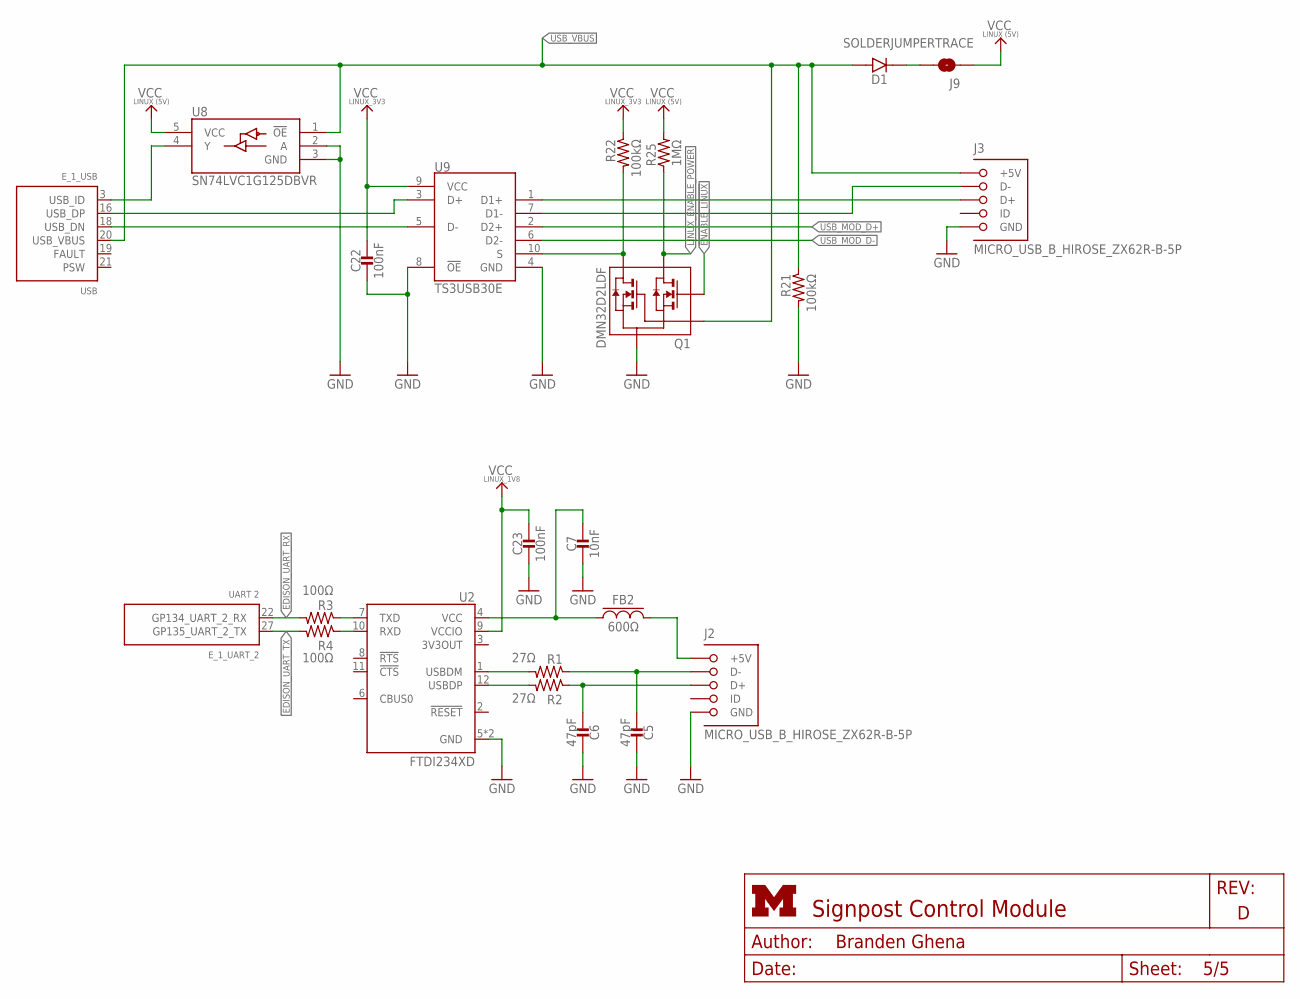
[picture p54: schematic controller.sch, sheet 5, USB]

Parts:
C5, C6: 47pF; 0402_CAP; DIGIKEY 490-6241-1-ND
C7: 10nF; 0402_CAP; DIGIKEY 490-6296-1-ND
C22, C23: 100nF; 0402_CAP; DIGIKEY 490-10777-1-ND
D1: DIODE; 0805_DIODE; DIGIKEY 478-7800-1-ND
E_1: EDISON_CONNECTOR_SEGMENTED; EDISON_DAUGHTER; MOUSER 798-DF40HC3070DS4V51
FB2: 600Ω; 0805_CAP; DIGIKEY 240-2390-1-ND
J2, J3: MICRO_USB_B_HIROSE_ZX62R-B-5P; USB_MICRO_B-HIROSE-ZX62R-B-5P; DIGIKEY H125274CT-ND
J9: SOLDERJUMPERTRACE; SJ_2S-TRACE
Q1: DMN32D2LDF; SOT353
R1, R2: 27Ω; 0402_RES; DIGIKEY 1276-3907-1-ND
R3, R4: 100Ω; 0402_RES; DIGIKEY 1276-3429-1-ND
R21, R22: 100kΩ; 0402_RES; DIGIKEY 1276-3432-1-ND
R25: 1MΩ; 0402_RES; DIGIKEY 1276-3433-1-ND
U2: FTDI234XD; DFN-12/3MM
U8: SN74LVC1G125DBVR; SOT-23-5
U9: TS3USB30E; UQFN-10

Connections:
!ENABLE_LINUX: Q1.G1; also elsewhere on the board
D+: C6.1, J2.3 (D+), R2.1
D-: C5.1, J2.2 (D-), R1.1
EDISON_UART_RX: E_1.22 (GP134_UART_2_RX), R3.2; also elsewhere on the board
EDISON_UART_TX: E_1.27 (GP135_UART_2_TX), R4.2; also elsewhere on the board
GND: C5.2, C6.2, C7.2, C22.2, C23.2, J2.5 (GND), J3.5 (GND), Q1.S, R21.2, U2.5 (GND), U2.13 (GND), U8.2 (A), U8.3 (GND), U9.4 (GND), U9.8 (!OE); also elsewhere on the board
LINUX_ENABLE_POWER: Q1.D1, R25.1; also elsewhere on the board
unnamed: R1.2, U2.1 (USBDM)
unnamed: R2.2, U2.12 (USBDP)
unnamed: J3.2 (D-), U9.7 (D1-)
unnamed: J3.3 (D+), U9.1 (D1+)
unnamed: FB2.P$2, J2.1 (+5V)
unnamed: D1.CATHODE, J9.2
unnamed: E_1.3 (USB_ID), U8.4 (Y)
unnamed: R3.1, U2.7 (TXD)
unnamed: R4.1, U2.10 (RXD)
unnamed: C7.1, FB2.P$1, U2.4 (VCC)
unnamed: Q1.D2, R22.2, U9.10 (S)
USB_D+: E_1.16 (USB_DP), U9.3 (D+)
USB_D-: E_1.18 (USB_DN), U9.5 (D-)
USB_MOD_D+: U9.2 (D2+); also elsewhere on the board
USB_MOD_D-: U9.6 (D2-); also elsewhere on the board
USB_VBUS: D1.ANODE, E_1.20 (USB_VBUS), J3.1 (+5V), Q1.G2, R21.1, U8.1 (!OE)
VCC_LINUX: J9.1, R25.2, U8.5 (VCC); also elsewhere on the board
VCC_LINUX_1V8: C23.1, U2.9 (VCCIO); also elsewhere on the board
VCC_LINUX_3V3: C22.1, R22.1, U9.9 (VCC); also elsewhere on the board

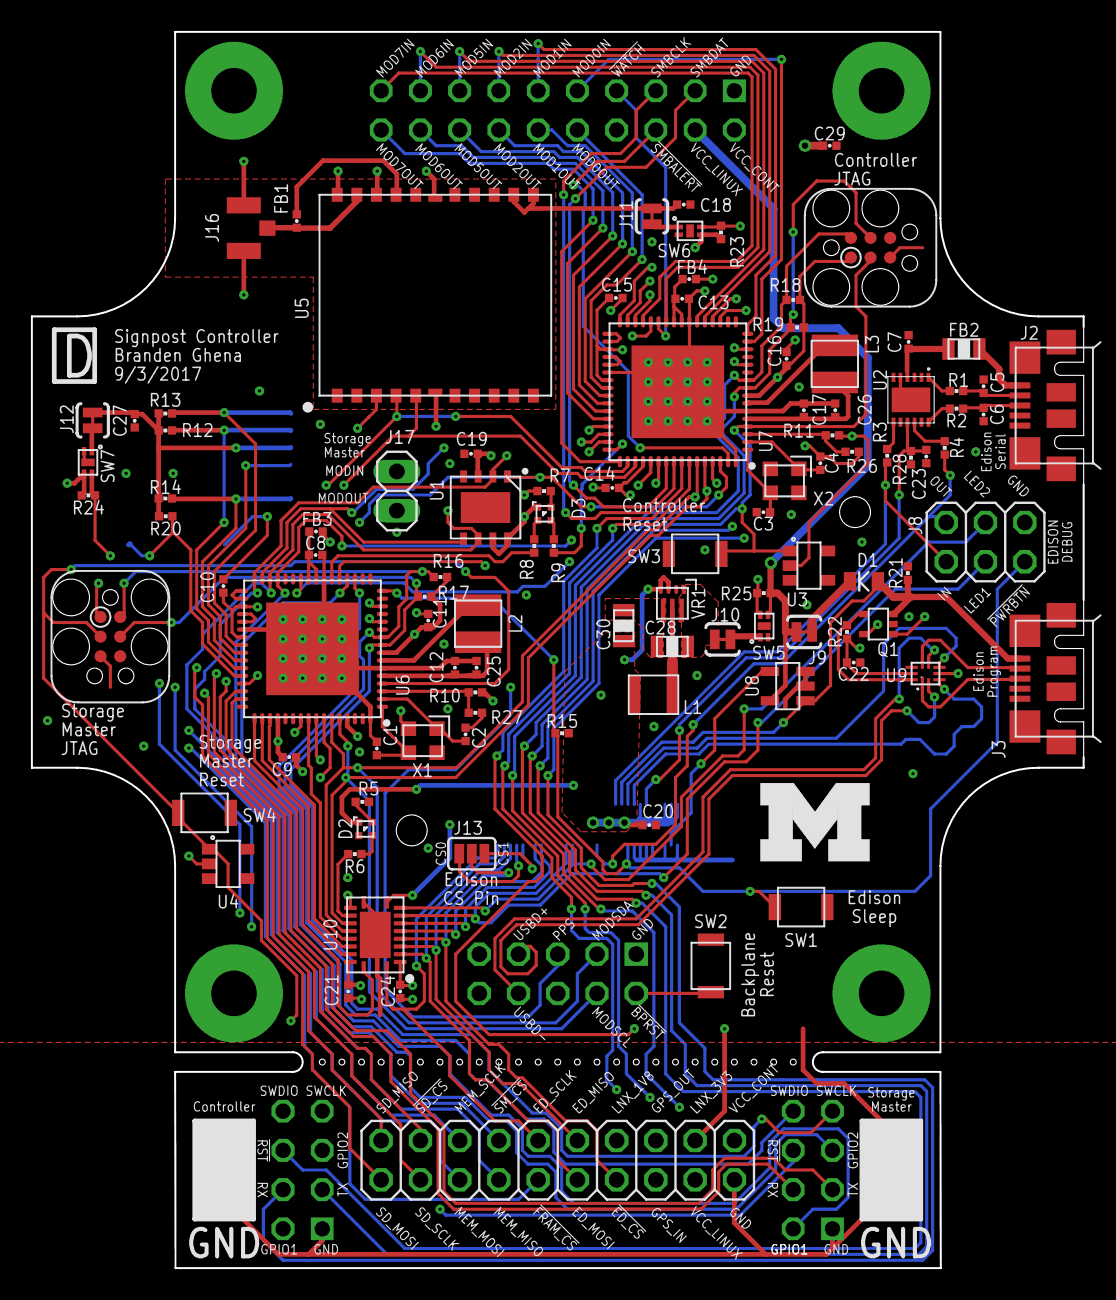
[picture p55: board hardware/controller/rev_d/controller.brd from above]

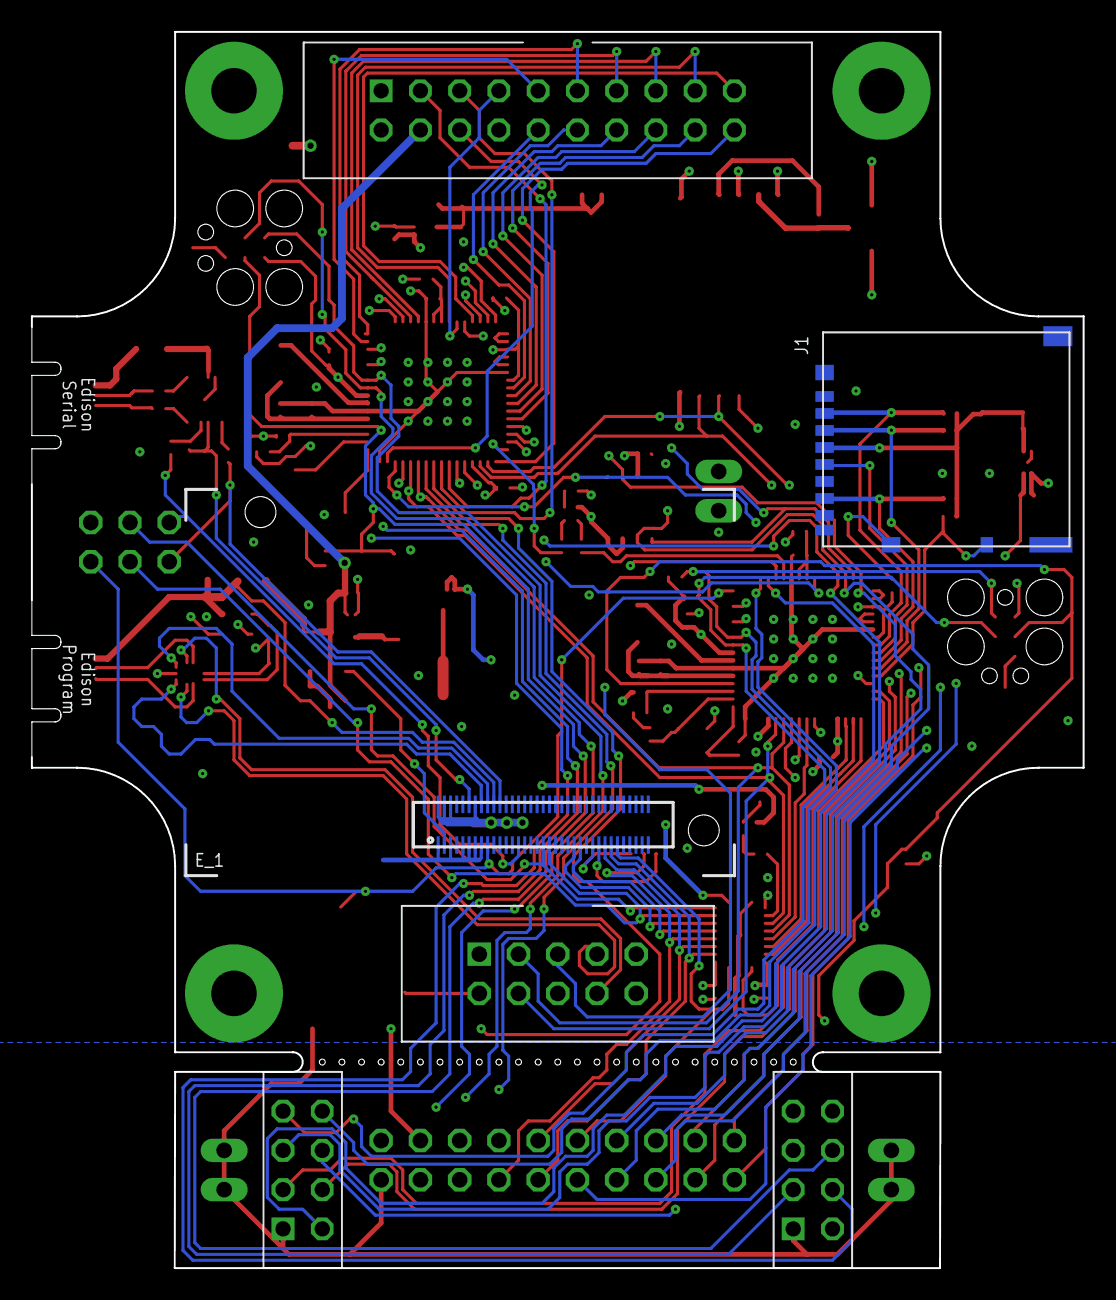
[picture p56: board hardware/controller/rev_d/controller.brd from below]

Board: 4 copper layers, 68.1 x 80.0 mm, 108 parts (2 on the bottom side), 127 nets.
