lab11/signpost/hardware/power_supply_module/rev_f/power_supply_module.brd

## EAGLE design hardware/power_supply_module/rev_f/power_supply_module.brd (2017-07-29)

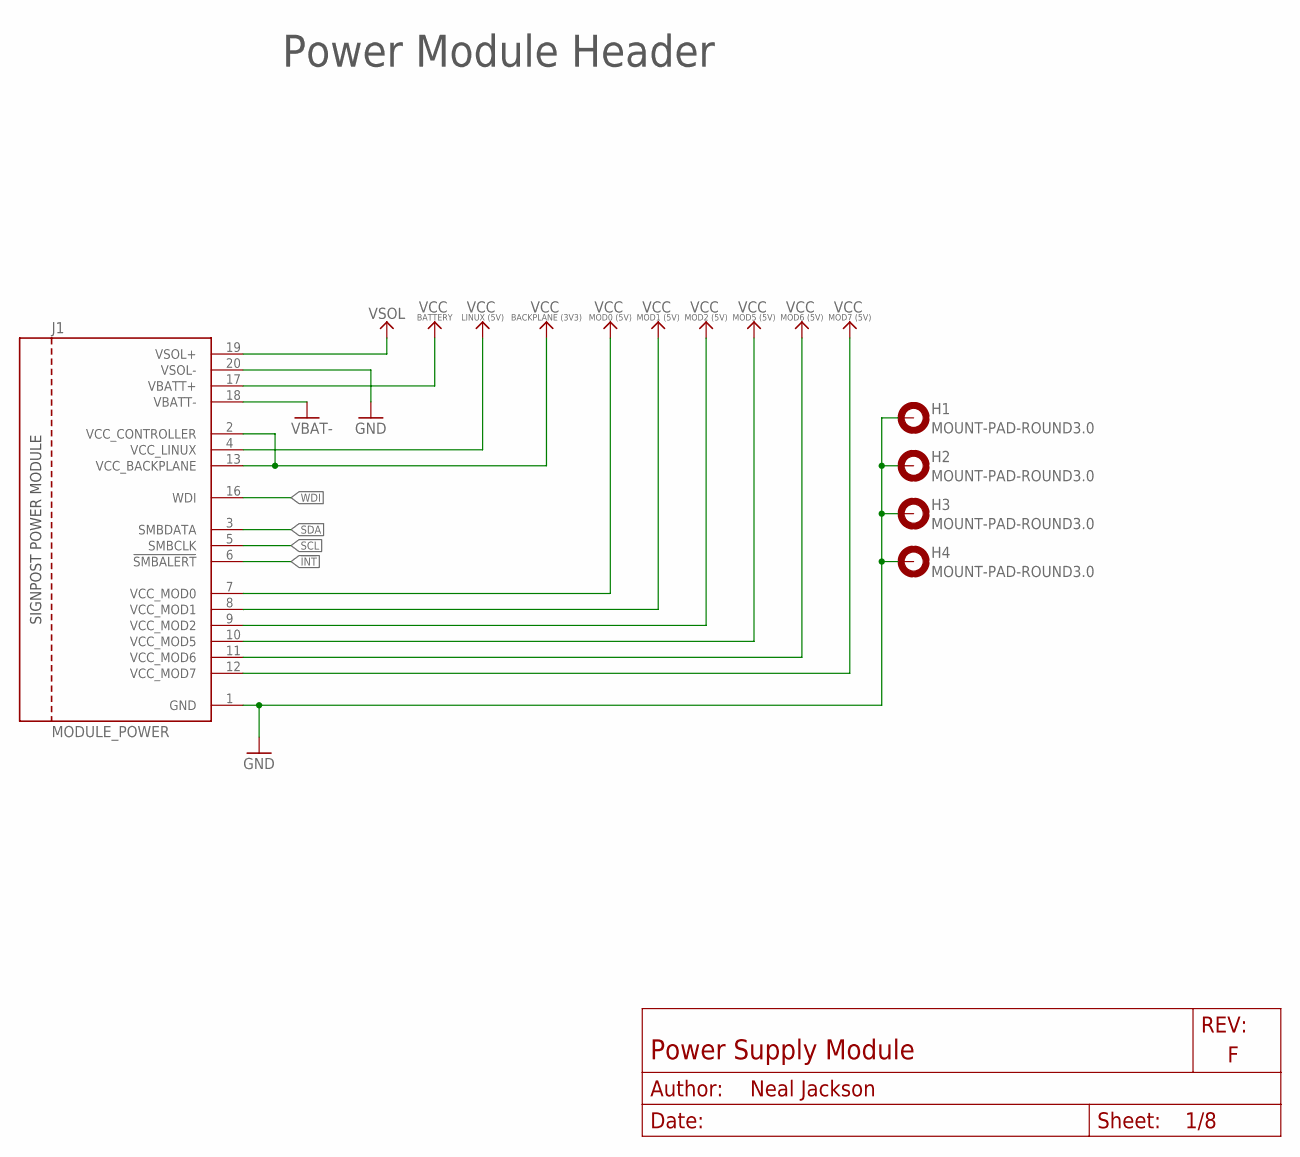
[picture p57: schematic power_supply_module.sch, sheet 1, Header and Mouting holes for Power Module]

Parts:
H1, H2, H3, H4: MOUNT-PAD-ROUND3.0; 3,0-PAD
J1: MODULE_POWER

Connections:
!INT: J1.6 (!SMBALERT); also elsewhere on the board
GND: H1.B3,0, H2.B3,0, H3.B3,0, H4.B3,0, J1.1 (GND), J1.20 (VSOL-); also elsewhere on the board
SCL: J1.5 (SMBCLK); also elsewhere on the board
SDA: J1.3 (SMBDATA); also elsewhere on the board
VBAT+: J1.17 (VBATT+); also elsewhere on the board
VBAT-: J1.18 (VBATT-); also elsewhere on the board
VCC_BACKPLANE: J1.2 (VCC_CONTROLLER), J1.13 (VCC_BACKPLANE); also elsewhere on the board
VCC_LINUX: J1.4 (VCC_LINUX); also elsewhere on the board
VCC_MOD0: J1.7 (VCC_MOD0); also elsewhere on the board
VCC_MOD1: J1.8 (VCC_MOD1); also elsewhere on the board
VCC_MOD2: J1.9 (VCC_MOD2); also elsewhere on the board
VCC_MOD5: J1.10 (VCC_MOD5); also elsewhere on the board
VCC_MOD6: J1.11 (VCC_MOD6); also elsewhere on the board
VCC_MOD7: J1.12 (VCC_MOD7); also elsewhere on the board
VSOL+: J1.19 (VSOL+); also elsewhere on the board
WDI: J1.16 (WDI); also elsewhere on the board

Notes on the sheet:
Power Module Header
