lab11/signpost/hardware/power_supply_module/rev_f/power_supply_module.brd

## EAGLE design hardware/power_supply_module/rev_f/power_supply_module.brd (continued)

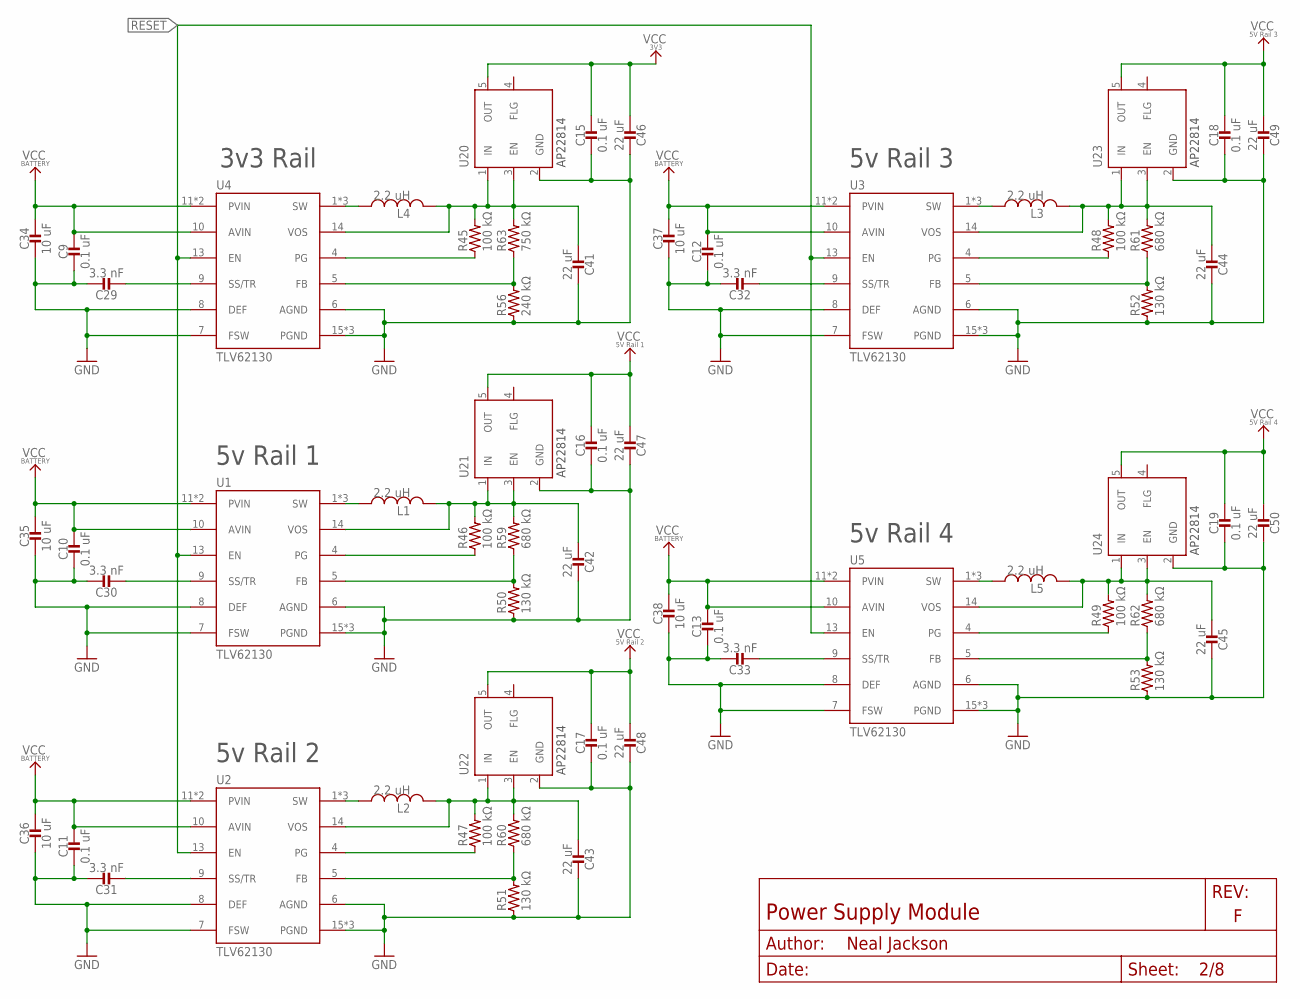
[picture p58: schematic power_supply_module.sch, sheet 2, Regulators for 3v3 and 5v power rails]

Parts:
C9, C10, C11, C12, C13, C15, C16, C17, C18, C19: 0.1 uF; 0402_CAP; MPN GRM155R61E104KA87D; DIGIKEY 490-5920-1-ND
C29, C30, C31, C32, C33: 3.3 nF; 0402_CAP; MPN GRM155R71H332KA01D; DIGIKEY 490-3248-1-ND
C34, C35, C36, C37, C38: 10 uF; 0805_CAP; MPN GRM21BR61E106KA73L; DIGIKEY 490-5523-1-ND
C41, C42, C43, C44, C45, C46, C47, C48, C49, C50: 22 uF; 0603_CAP; MPN CL10A226MQ8NRNC; DIGIKEY 1276-1193-1-ND
L1, L2, L3, L4, L5: 2.2 uH; IHL-1212BZ-11
R45, R46, R47, R48, R49: 100 kΩ; 0402_RES; MPN ERJ-2GEJ104X; DIGIKEY P100KJCT-ND
R50, R51, R52, R53: 130 kΩ; 0402_RES; MPN ERJ-2RKF1303X; DIGIKEY P130KLCT-ND
R56: 240 kΩ; 0402_RES; MPN ERJ-2RKF2403X; DIGIKEY P240KLCT-ND
R59, R60, R61, R62: 680 kΩ; 0402_RES; MPN ERJ-2RKF6803X; DIGIKEY P680KLCT-ND
R63: 750 kΩ; 0402_RES; MPN ERJ-2GEJ754X; DIGIKEY P750KJCT-ND
U1, U2, U3, U4, U5: TLV62130; TQFN-16/3MM
U20, U21, U22, U23, U24: AP22814; U-DFN2020-6

Connections:
3V3ROUT: C41.2, L4.P$2 (2), R45.2, R63.2, U4.14 (VOS), U20.1 (IN), U20.3 (EN)
5V_1ROUT: C42.2, L1.P$2 (2), R46.2, R59.2, U1.14 (VOS), U21.1 (IN), U21.3 (EN)
5V_2ROUT: C43.2, L2.P$2 (2), R47.2, R60.2, U2.14 (VOS), U22.1 (IN), U22.3 (EN)
5V_3ROUT: C44.2, L3.P$2 (2), R48.2, R61.2, U3.14 (VOS), U23.1 (IN), U23.3 (EN)
5V_4ROUT: C45.2, L5.P$2 (2), R49.2, R62.2, U5.14 (VOS), U24.1 (IN), U24.3 (EN)
!RESET: U1.13 (EN), U2.13 (EN), U3.13 (EN), U4.13 (EN), U5.13 (EN); also elsewhere on the board
GND: C9.2, C10.2, C11.2, C12.2, C13.2, C15.2, C16.2, C17.2, C18.2, C19.2, C29.1, C30.1, C31.1, C32.1, C33.1, C34.P$2 (2), C35.P$2 (2), C36.P$2 (2), C37.P$2 (2), C38.P$2 (2), C41.1, C42.1, C43.1, C44.1, C45.1, C46.1, C47.1, C48.1, C49.1, C50.1, R50.1, R51.1, R52.1, R53.1, R56.1, U1.6 (AGND), U1.7 (FSW), U1.8 (DEF), U1.15 (PGND), U1.16 (PGND), U1.GND, U2.6 (AGND), U2.7 (FSW), U2.8 (DEF), U2.15 (PGND), U2.16 (PGND), U2.GND, U3.6 (AGND), U3.7 (FSW), U3.8 (DEF), U3.15 (PGND), U3.16 (PGND), U3.GND, U4.6 (AGND), U4.7 (FSW), U4.8 (DEF), U4.15 (PGND), U4.16 (PGND), U4.GND, U5.6 (AGND), U5.7 (FSW), U5.8 (DEF), U5.15 (PGND), U5.16 (PGND), U5.GND, U20.2 (GND), U21.2 (GND), U22.2 (GND), U23.2 (GND), U24.2 (GND); also elsewhere on the board
unnamed: L4.P$1 (1), U4.1 (SW), U4.2 (SW), U4.3 (SW)
unnamed: C30.2, U1.9 (SS/TR)
unnamed: R46.1, U1.4 (PG)
unnamed: R50.2, R59.1, U1.5 (FB)
unnamed: C31.2, U2.9 (SS/TR)
unnamed: L2.P$1 (1), U2.1 (SW), U2.2 (SW), U2.3 (SW)
unnamed: R47.1, U2.4 (PG)
unnamed: R51.2, R60.1, U2.5 (FB)
unnamed: C29.2, U4.9 (SS/TR)
unnamed: L1.P$1 (1), U1.1 (SW), U1.2 (SW), U1.3 (SW)
unnamed: C32.2, U3.9 (SS/TR)
unnamed: R45.1, U4.4 (PG)
unnamed: R56.2, R63.1, U4.5 (FB)
unnamed: L3.P$1 (1), U3.1 (SW), U3.2 (SW), U3.3 (SW)
unnamed: R48.1, U3.4 (PG)
unnamed: R52.2, R61.1, U3.5 (FB)
unnamed: C33.2, U5.9 (SS/TR)
unnamed: L5.P$1 (1), U5.1 (SW), U5.2 (SW), U5.3 (SW)
unnamed: R49.1, U5.4 (PG)
unnamed: R53.2, R62.1, U5.5 (FB)
VBAT+: C9.1, C10.1, C11.1, C12.1, C13.1, C34.P$1 (1), C35.P$1 (1), C36.P$1 (1), C37.P$1 (1), C38.P$1 (1), U1.10 (AVIN), U1.11 (PVIN), U1.12 (PVIN), U2.10 (AVIN), U2.11 (PVIN), U2.12 (PVIN), U3.10 (AVIN), U3.11 (PVIN), U3.12 (PVIN), U4.10 (AVIN), U4.11 (PVIN), U4.12 (PVIN), U5.10 (AVIN), U5.11 (PVIN), U5.12 (PVIN); also elsewhere on the board
VCC_3V3: C15.1, C46.2, U20.5 (OUT); also elsewhere on the board
VCC_5V_1: C16.1, C47.2, U21.5 (OUT); also elsewhere on the board
VCC_5V_2: C17.1, C48.2, U22.5 (OUT); also elsewhere on the board
VCC_5V_3: C18.1, C49.2, U23.5 (OUT); also elsewhere on the board
VCC_5V_4: C19.1, C50.2, U24.5 (OUT); also elsewhere on the board

Notes on the sheet:
5v Rail 3
5v Rail 4
5v Rail 1
3v3 Rail
5v Rail 2

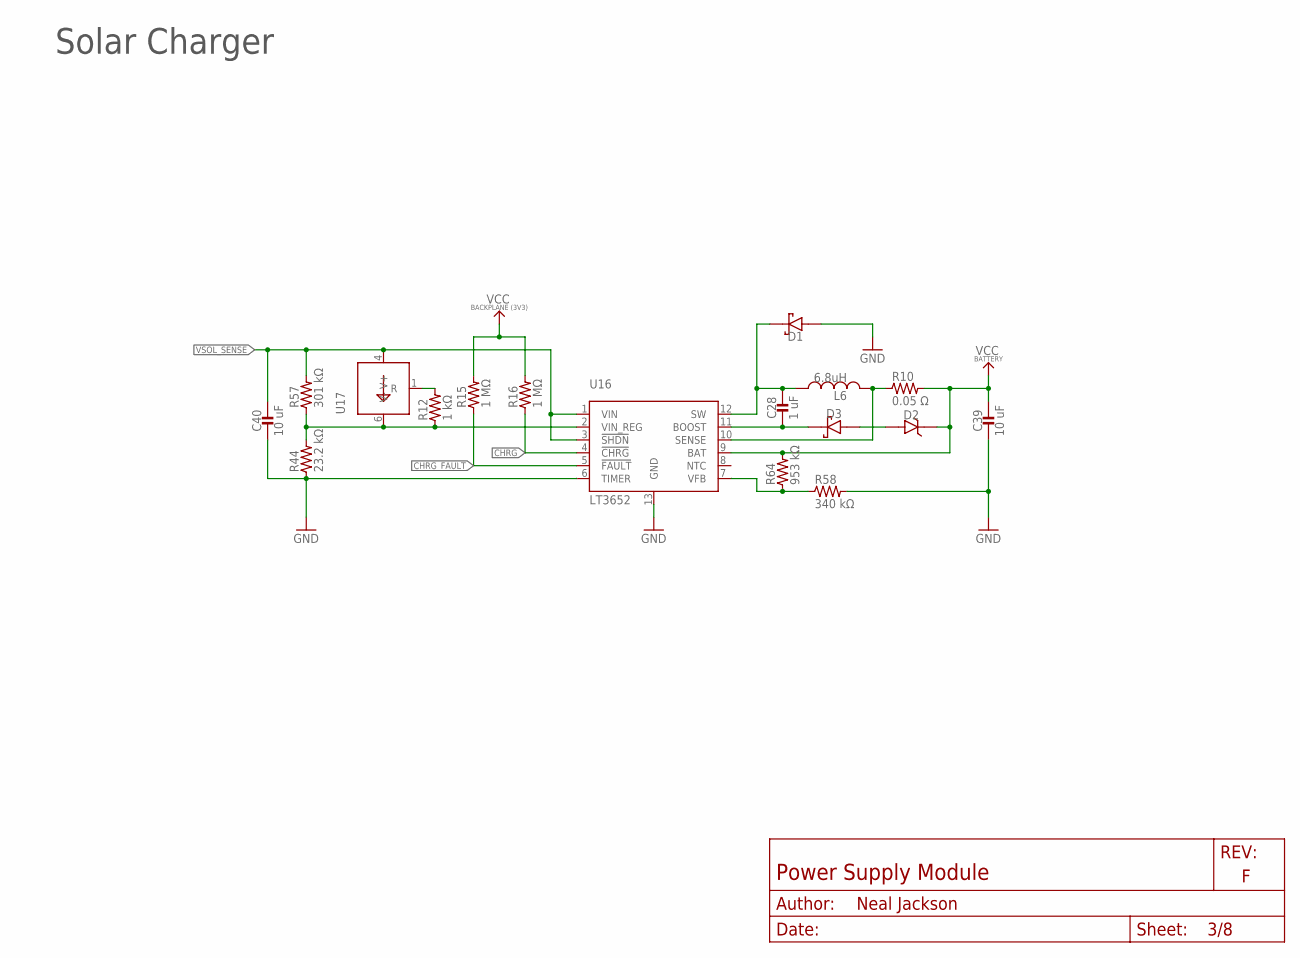
[picture p59: schematic power_supply_module.sch, sheet 3, Solar Charger]

Parts:
C28: 1 uF; 0603_CAP; MPN GRM188R61A105KA61D; DIGIKEY 490-1543-1-ND
C39, C40: 10 uF; 0805_CAP; MPN GRM21BR61E106KA73L; DIGIKEY 490-5523-1-ND
D1: DIODE_SCHOTTKYSOT-23F; SOT-23F; MPN CMPSH1-4 TR; DIGIKEY CMPSH1-4 CT-ND
D2: DIODE_ZENERSOT323; SOD323; MPN PDZ3.6B,115; DIGIKEY 1727-5151-1-ND
D3: DIODE_SCHOTTKYSOD323; SOD323; MPN CMDSH2-4L TR; DIGIKEY CMDSH2-4L CT-ND
L6: 6.8uH; IHL-2525CZ; MPN IHLP2525CZER6R8M11; DIGIKEY 541-2582-1-ND
R10: 0.05 Ω; 0805_RES; MPN WSLP0805R0500FEB; DIGIKEY WSLPB-.05CT-ND
R12: 1 kΩ; 0402_RES; MPN ERJ-2GEJ102X; DIGIKEY P1.0KJCT-ND
R15, R16: 1 MΩ; 0402_RES; MPN ERJ-2RKF1004X; DIGIKEY P1.00MLCT-ND
R44: 23.2 kΩ; 0805_RES; MPN ERA6AEB2322V; DIGIKEY P23.2KDACT-ND
R57: 301 kΩ; 0805_RES; MPN ERA-6AEB3013V; DIGIKEY P301KDACT-ND
R58: 340 kΩ; 0805_RES; MPN ERA-6AEB3403V; DIGIKEY P340KDACT-ND
R64: 953 kΩ; 0805_RES; MPN ERA-6AEB9533V; DIGIKEY P953KDACT-ND
U16: LT3652; DFN-12/3MM
U17: LM234; SOIC-8

Connections:
BOOST: C28.2, D3.P$1 (CATHODE), U16.11 (BOOST)
CHRG: R16.1, U16.4 (!CHRG); also elsewhere on the board
CHRG_FAULT: R15.1, U16.5 (!FAULT); also elsewhere on the board
GND: C39.P$2 (2), C40.P$2 (2), D1.P$1 (ANODE), R44.1, R58.2, U16.6 (TIMER), U16.13 (GND); also elsewhere on the board
unnamed: D2.P$2 (ANODE), D3.P$2 (ANODE)
unnamed: R12.2, U17.1 (R)
SENSE: L6.P$2 (2), R10.1, U16.10 (SENSE)
SW: C28.1, D1.P$3 (CATHODE), L6.P$1 (1), U16.12 (SW)
VBAT+: C39.P$1 (1), D2.P$1 (CATHODE), R10.2, R64.2, U16.9 (BAT); also elsewhere on the board
VCC_BACKPLANE: R15.2, R16.2; also elsewhere on the board
VFB: R58.1, R64.1, U16.7 (VFB)
VINREG: R12.1, R44.2, R57.1, U16.2 (VIN_REG), U17.6 (V-)
VSOL_SENSE: C40.P$1 (1), R57.2, U16.1 (VIN), U16.3 (!SHDN), U17.4 (V+); also elsewhere on the board

Notes on the sheet:
Solar Charger

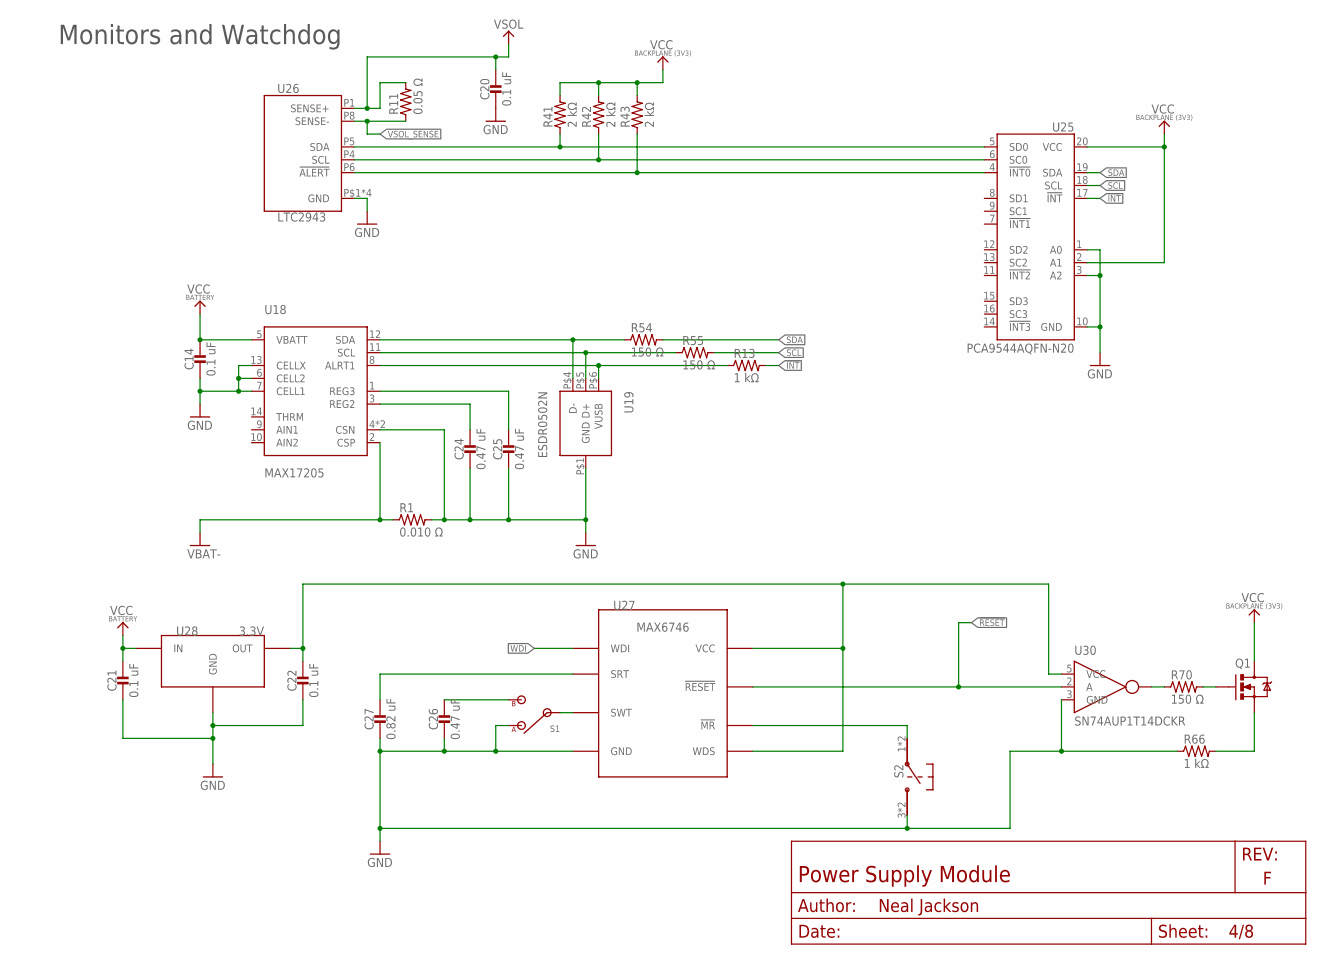
[picture p60: schematic power_supply_module.sch, sheet 4, Battery and Solar Monitors + Watchdog]

Parts:
C14, C20, C21, C22: 0.1 uF; 0402_CAP; MPN GRM155R61E104KA87D; DIGIKEY 490-5920-1-ND
C24, C25, C26: 0.47 uF; 0402_CAP; MPN GRM155R60J474KE19D; DIGIKEY 490-3266-1-ND
C27: 0.82 uF; 0402_CAP; MPN GRM155C80J824KE15D; DIGIKEY 490-10440-1-ND
Q1: MOSFET-NCHANNELSMD; SOT23-3; MPN 2N7002LT1G; DIGIKEY 2N7002LT1GOSCT-ND
R1: 0.010 Ω; 0805_RES; MPN WSLP0805R0100FEB; DIGIKEY WSLPB-.01CT-ND
R11: 0.05 Ω; 0805_RES; MPN WSLP0805R0500FEB; DIGIKEY WSLPB-.05CT-ND
R13, R66: 1 kΩ; 0402_RES; MPN ERJ-2GEJ102X; DIGIKEY P1.0KJCT-ND
R41, R42, R43: 2 kΩ; 0402_RES; MPN ERJ-2RKF2001X; DIGIKEY P2.00KLCT-ND
R54, R55, R70: 150 Ω; 0402_RES; MPN ERJ-2RKF1500X; DIGIKEY P150LCT-ND
S1: TE_SSA12/SPDT
S2: PTS810SJ
U18: MAX17205; 14-TDFN
U19: ESDR0502N; UDFN-6
U25: PCA9544AQFN-N20; QFN-N20
U26: LTC2943; DFN-8
U27: MAX6746; SOT-23-8
U28: 3.3V; SOT-23; MPN ZMR330FTA; DIGIKEY ZMR330FCT-ND
U30: SN74AUP1T14DCKR; SC70

Connections:
!INT: R13.2, U25.17 (!INT); also elsewhere on the board
!RESET: U27.7 (!RESET), U30.2 (A); also elsewhere on the board
GND: C14.2, C20.2, C21.2, C22.2, C24.2, C25.2, C26.2, C27.2, R1.2, R66.1, S1.1 (A), S2.3, S2.4, U18.4 (CSN), U18.6 (CELL2), U18.7 (CELL1), U18.13 (CELLX), U18.15 (CSN), U19.P$1 (GND), U25.1 (A0), U25.3 (A2), U25.10 (GND), U26.P2 (GND), U26.P3 (GND), U26.P7 (GND), U26.P$1 (GND), U27.4 (GND), U28.3 (GND), U30.3 (GND); also elsewhere on the board
unnamed: S2.1, S2.2, U27.1 (!MR)
unnamed: Q1.1 (G), R70.2
unnamed: C27.1, U27.3 (SRT)
unnamed: R54.1, U18.12 (SDA), U19.P$4 (D-)
unnamed: C26.1, S1.2 (B)
unnamed: R55.1, U18.11 (SCL), U19.P$5 (D+)
unnamed: C24.1, U18.3 (REG2)
unnamed: R13.1, U18.8 (ALRT1), U19.P$6 (VUSB)
unnamed: C25.1, U18.1 (REG3)
unnamed: S1.IN, U27.2 (SWT)
unnamed: R70.1, U30.4 (Y)
unnamed: C22.1, U27.5 (WDS), U27.8 (VCC), U28.1 (OUT), U30.5 (VCC)
unnamed: R43.1, U25.4 (!INT0), U26.P6 (!ALERT)
unnamed: R42.1, U25.6 (SC0), U26.P4 (SCL)
unnamed: R41.1, U25.5 (SD0), U26.P5 (SDA)
unnamed: Q1.2 (S), R66.2
SCL: R55.2, U25.18 (SCL); also elsewhere on the board
SDA: R54.2, U25.19 (SDA); also elsewhere on the board
VBAT+: C14.1, C21.1, U18.5 (VBATT), U28.2 (IN); also elsewhere on the board
VBAT-: R1.1, U18.2 (CSP); also elsewhere on the board
VCC_BACKPLANE: Q1.3 (D), R41.2, R42.2, R43.2, U25.2 (A1), U25.20 (VCC); also elsewhere on the board
VSOL+: C20.1, R11.2, U26.P1 (SENSE+); also elsewhere on the board
VSOL_SENSE: R11.1, U26.P8 (SENSE-); also elsewhere on the board
WDI: U27.6 (WDI); also elsewhere on the board

Notes on the sheet:
Monitors and Watchdog

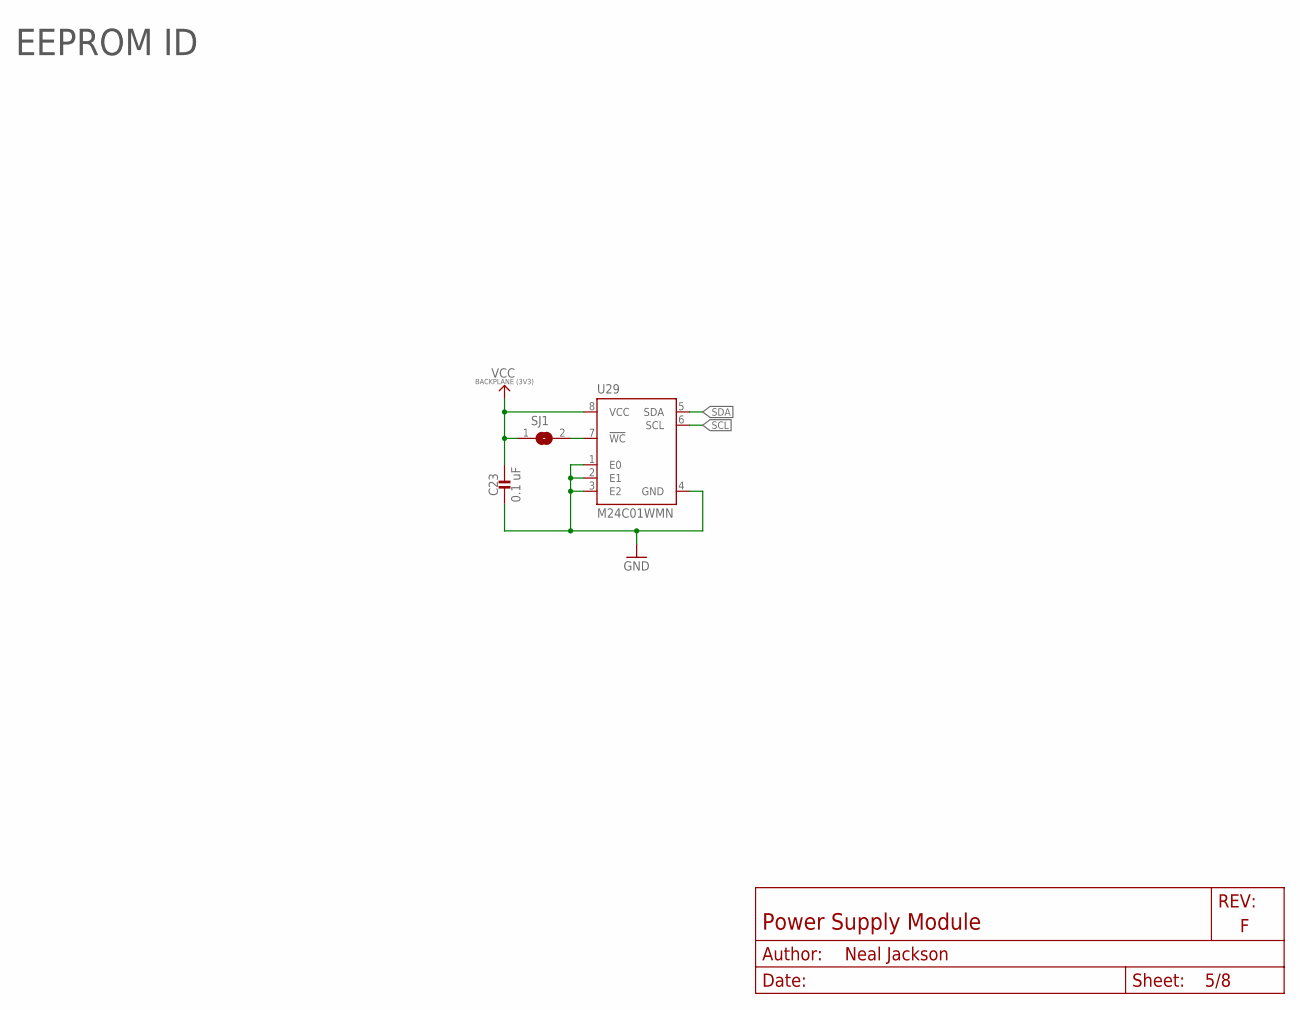
[picture p61: schematic power_supply_module.sch, sheet 5, EEPROM ID]

Parts:
C23: 0.1 uF; 0402_CAP; MPN GRM155R61E104KA87D; DIGIKEY 490-5920-1-ND
SJ1: SJ
U29: M24C01WMN; SOIC-8

Connections:
GND: C23.2, U29.1 (E0), U29.2 (E1), U29.3 (E2), U29.4 (GND); also elsewhere on the board
unnamed: SJ1.2, U29.7 (!WC)
SCL: U29.6 (SCL); also elsewhere on the board
SDA: U29.5 (SDA); also elsewhere on the board
VCC_BACKPLANE: C23.1, SJ1.1, U29.8 (VCC); also elsewhere on the board

Notes on the sheet:
EEPROM ID

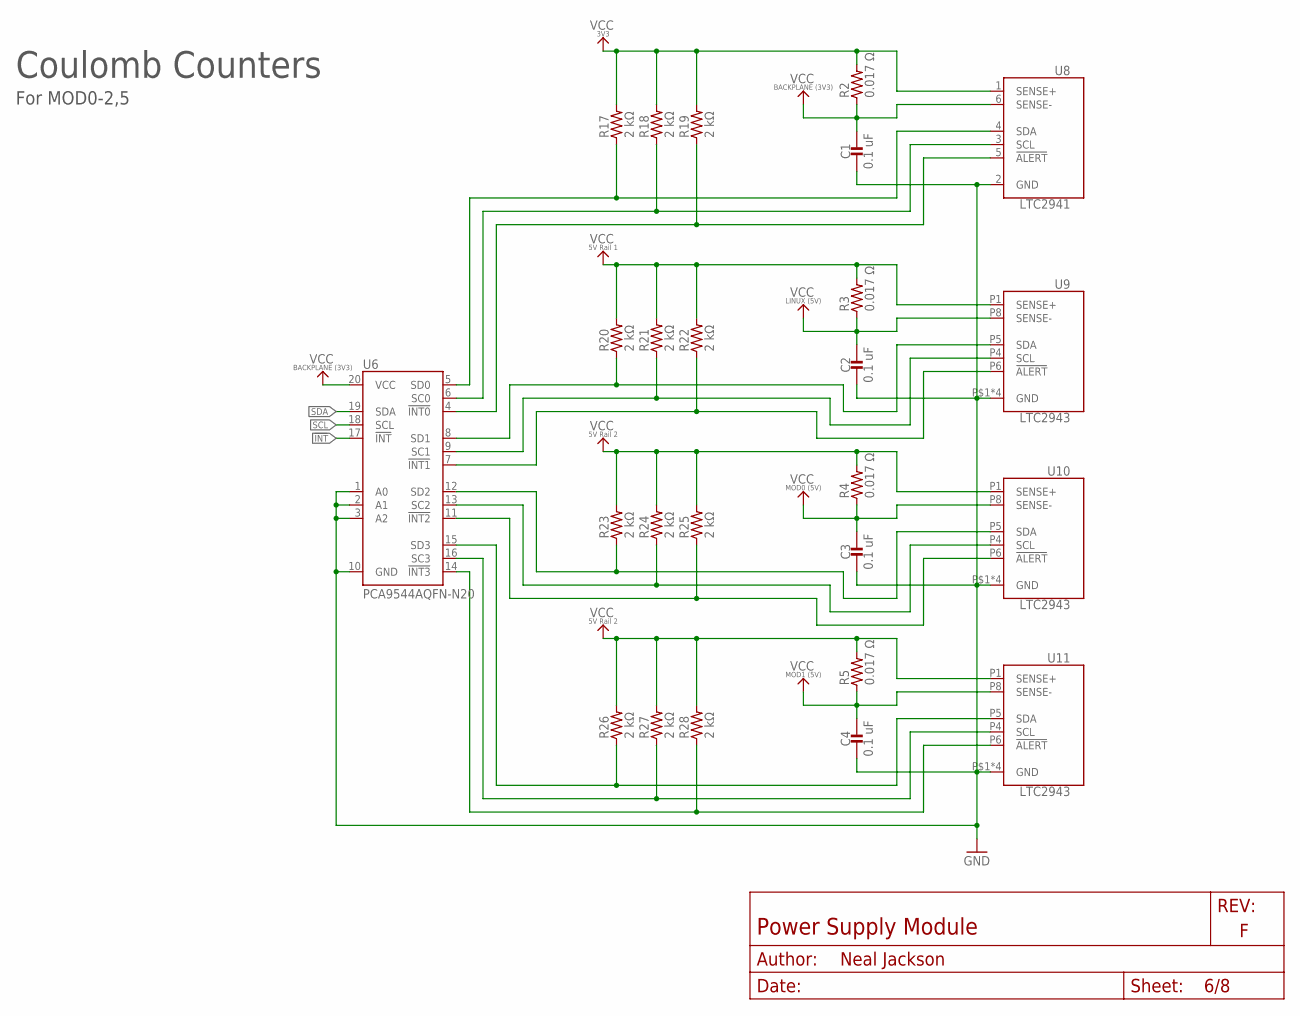
[picture p62: schematic power_supply_module.sch, sheet 6, Module + System Gauges]

Parts:
C1, C2, C3, C4: 0.1 uF; 0402_CAP; MPN GRM155R61E104KA87D; DIGIKEY 490-5920-1-ND
R2, R3, R4, R5: 0.017 Ω; 0805_RES; MPN WSLP0805R0170FEB; DIGIKEY WSLPB-.017CT-ND
R17, R18, R19, R20, R21, R22, R23, R24, R25, R26, R27, R28: 2 kΩ; 0402_RES; MPN ERJ-2RKF2001X; DIGIKEY P2.00KLCT-ND
U6: PCA9544AQFN-N20; QFN-N20
U8: LTC2941; DFN-6-2MMX3MM
U9, U10, U11: LTC2943; DFN-8

Connections:
!INT: U6.17 (!INT); also elsewhere on the board
GND: C1.2, C2.2, C3.2, C4.2, U6.1 (A0), U6.2 (A1), U6.3 (A2), U6.10 (GND), U8.2 (GND), U9.P2 (GND), U9.P3 (GND), U9.P7 (GND), U9.P$1 (GND), U10.P2 (GND), U10.P3 (GND), U10.P7 (GND), U10.P$1 (GND), U11.P2 (GND), U11.P3 (GND), U11.P7 (GND), U11.P$1 (GND); also elsewhere on the board
unnamed: R17.1, U6.5 (SD0), U8.4 (SDA)
unnamed: R18.1, U6.6 (SC0), U8.3 (SCL)
unnamed: R23.1, U6.12 (SD2), U10.P5 (SDA)
unnamed: R24.1, U6.13 (SC2), U10.P4 (SCL)
unnamed: R25.1, U6.11 (!INT2), U10.P6 (!ALERT)
unnamed: R26.1, U6.15 (SD3), U11.P5 (SDA)
unnamed: R27.1, U6.16 (SC3), U11.P4 (SCL)
unnamed: R28.1, U6.14 (!INT3), U11.P6 (!ALERT)
unnamed: R19.1, U6.4 (!INT0), U8.5 (!ALERT)
unnamed: R20.1, U6.8 (SD1), U9.P5 (SDA)
unnamed: R21.1, U6.9 (SC1), U9.P4 (SCL)
unnamed: R22.1, U6.7 (!INT1), U9.P6 (!ALERT)
SCL: U6.18 (SCL); also elsewhere on the board
SDA: U6.19 (SDA); also elsewhere on the board
VCC_3V3: R2.2, R17.2, R18.2, R19.2, U8.1 (SENSE+); also elsewhere on the board
VCC_5V_1: R3.2, R20.2, R21.2, R22.2, U9.P1 (SENSE+); also elsewhere on the board
VCC_5V_2: R4.2, R5.2, R23.2, R24.2, R25.2, R26.2, R27.2, R28.2, U10.P1 (SENSE+), U11.P1 (SENSE+); also elsewhere on the board
VCC_BACKPLANE: C1.1, R2.1, U6.20 (VCC), U8.6 (SENSE-); also elsewhere on the board
VCC_LINUX: C2.1, R3.1, U9.P8 (SENSE-); also elsewhere on the board
VCC_MOD0: C3.1, R4.1, U10.P8 (SENSE-); also elsewhere on the board
VCC_MOD1: C4.1, R5.1, U11.P8 (SENSE-); also elsewhere on the board

Notes on the sheet:
For MOD0-2,5
Coulomb Counters

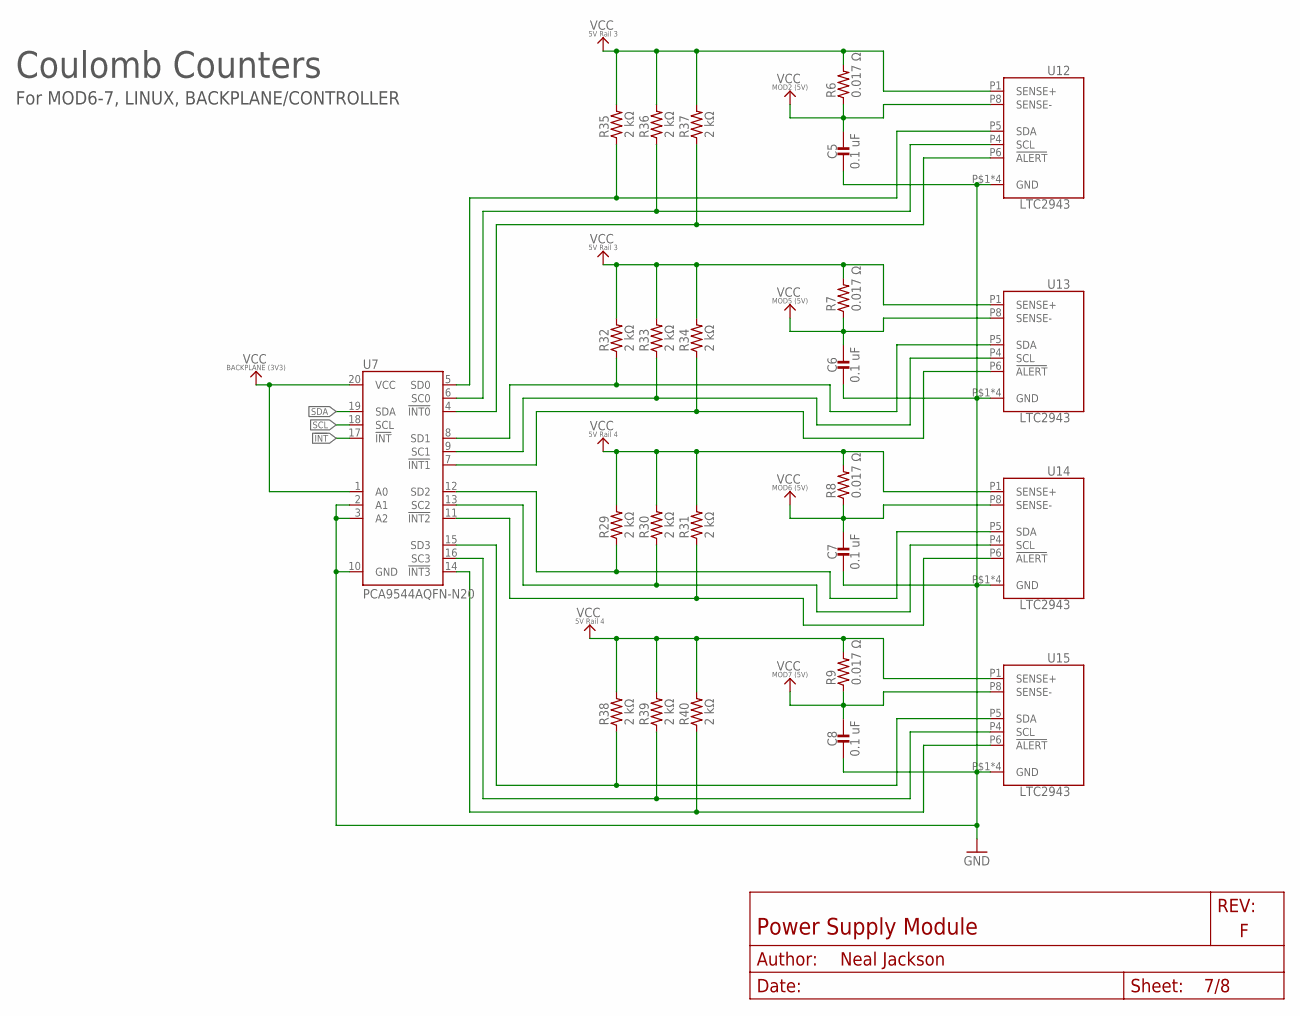
[picture p63: schematic power_supply_module.sch, sheet 7, Module Gauges]

Parts:
C5, C6, C7, C8: 0.1 uF; 0402_CAP; MPN GRM155R61E104KA87D; DIGIKEY 490-5920-1-ND
R6, R7, R8, R9: 0.017 Ω; 0805_RES; MPN WSLP0805R0170FEB; DIGIKEY WSLPB-.017CT-ND
R29, R30, R31, R32, R33, R34, R35, R36, R37, R38, R39, R40: 2 kΩ; 0402_RES; MPN ERJ-2RKF2001X; DIGIKEY P2.00KLCT-ND
U7: PCA9544AQFN-N20; QFN-N20
U12, U13, U14, U15: LTC2943; DFN-8

Connections:
!INT: U7.17 (!INT); also elsewhere on the board
GND: C5.2, C6.2, C7.2, C8.2, U7.2 (A1), U7.3 (A2), U7.10 (GND), U12.P2 (GND), U12.P3 (GND), U12.P7 (GND), U12.P$1 (GND), U13.P2 (GND), U13.P3 (GND), U13.P7 (GND), U13.P$1 (GND), U14.P2 (GND), U14.P3 (GND), U14.P7 (GND), U14.P$1 (GND), U15.P2 (GND), U15.P3 (GND), U15.P7 (GND), U15.P$1 (GND); also elsewhere on the board
unnamed: R35.1, U7.5 (SD0), U12.P5 (SDA)
unnamed: R36.1, U7.6 (SC0), U12.P4 (SCL)
unnamed: R29.1, U7.12 (SD2), U14.P5 (SDA)
unnamed: R30.1, U7.13 (SC2), U14.P4 (SCL)
unnamed: R31.1, U7.11 (!INT2), U14.P6 (!ALERT)
unnamed: R38.1, U7.15 (SD3), U15.P5 (SDA)
unnamed: R39.1, U7.16 (SC3), U15.P4 (SCL)
unnamed: R40.1, U7.14 (!INT3), U15.P6 (!ALERT)
unnamed: R37.1, U7.4 (!INT0), U12.P6 (!ALERT)
unnamed: R32.1, U7.8 (SD1), U13.P5 (SDA)
unnamed: R33.1, U7.9 (SC1), U13.P4 (SCL)
unnamed: R34.1, U7.7 (!INT1), U13.P6 (!ALERT)
SCL: U7.18 (SCL); also elsewhere on the board
SDA: U7.19 (SDA); also elsewhere on the board
VCC_5V_3: R6.2, R7.2, R32.2, R33.2, R34.2, R35.2, R36.2, R37.2, U12.P1 (SENSE+), U13.P1 (SENSE+); also elsewhere on the board
VCC_5V_4: R8.2, R9.2, R29.2, R30.2, R31.2, R38.2, R39.2, R40.2, U14.P1 (SENSE+), U15.P1 (SENSE+); also elsewhere on the board
VCC_BACKPLANE: U7.1 (A0), U7.20 (VCC); also elsewhere on the board
VCC_MOD2: C5.1, R6.1, U12.P8 (SENSE-); also elsewhere on the board
VCC_MOD5: C6.1, R7.1, U13.P8 (SENSE-); also elsewhere on the board
VCC_MOD6: C7.1, R8.1, U14.P8 (SENSE-); also elsewhere on the board
VCC_MOD7: C8.1, R9.1, U15.P8 (SENSE-); also elsewhere on the board

Notes on the sheet:
For MOD6-7, LINUX, BACKPLANE/CONTROLLER
Coulomb Counters

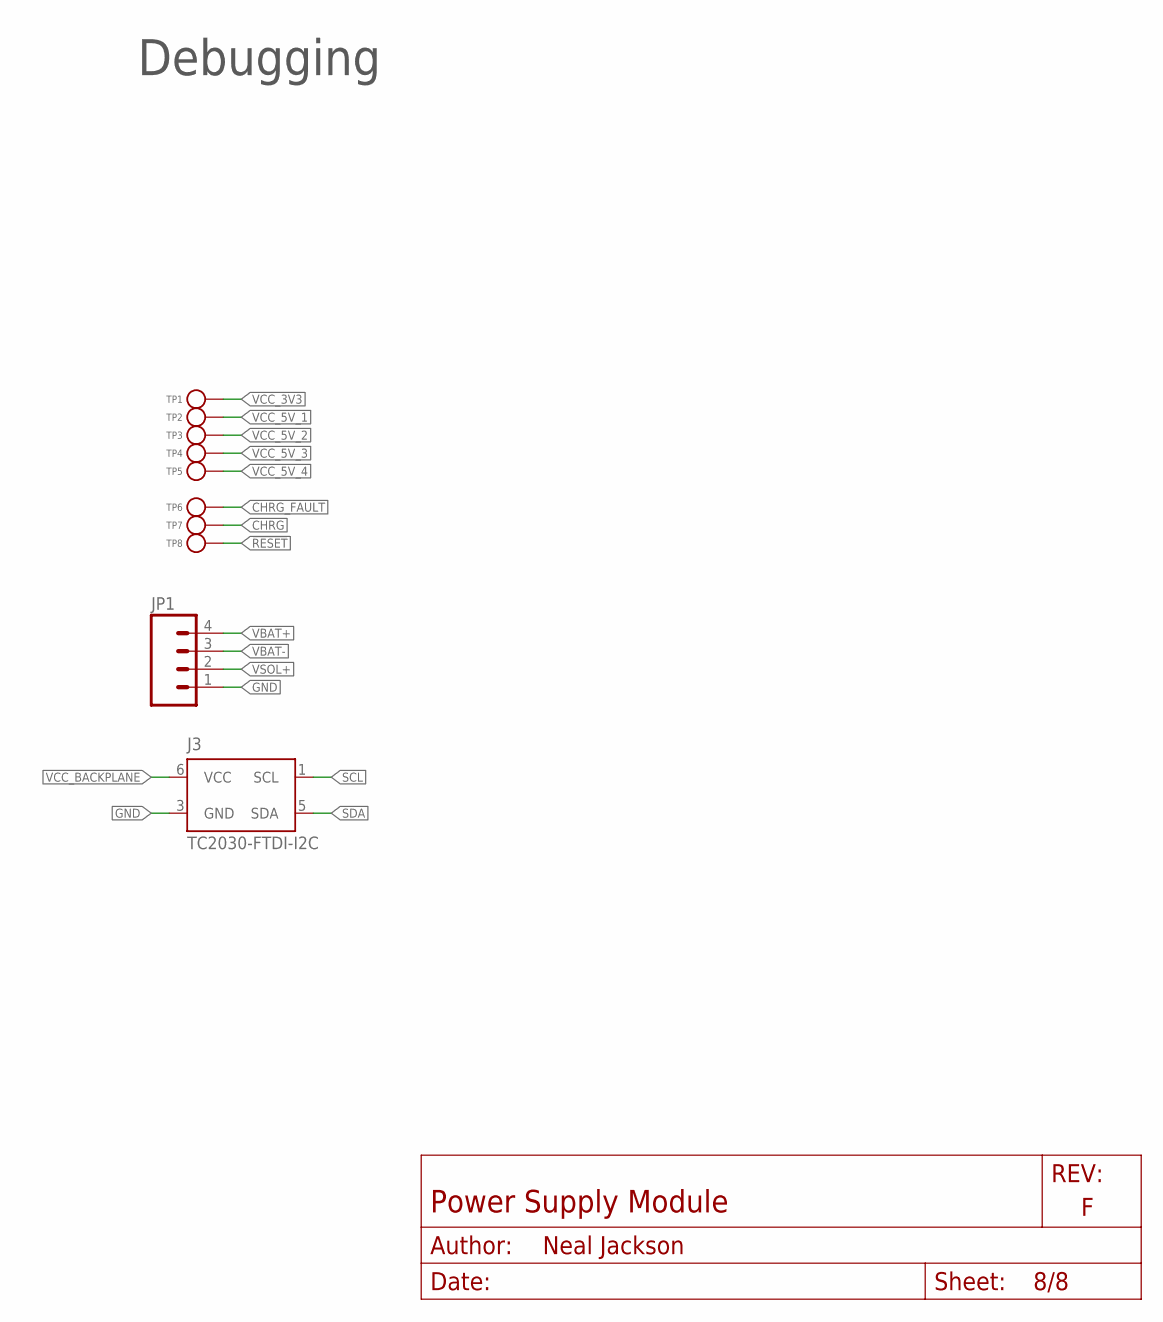
[picture p64: schematic power_supply_module.sch, sheet 8, Debug]

Parts:
J3: TC2030-FTDI-I2C; TC2030-IDC-NL
JP1: M04PTH; 1X04
TP1, TP2, TP3, TP4, TP5, TP6, TP7, TP8: TEST_POINT_0.040IN; TESTPOINT_0.040IN

Connections:
!RESET: TP8.TESTPOINT; also elsewhere on the board
CHRG: TP7.TESTPOINT; also elsewhere on the board
CHRG_FAULT: TP6.TESTPOINT; also elsewhere on the board
GND: J3.3 (GND), JP1.1; also elsewhere on the board
SCL: J3.1 (SCL); also elsewhere on the board
SDA: J3.5 (SDA); also elsewhere on the board
VBAT+: JP1.4; also elsewhere on the board
VBAT-: JP1.3; also elsewhere on the board
VCC_3V3: TP1.TESTPOINT; also elsewhere on the board
VCC_5V_1: TP2.TESTPOINT; also elsewhere on the board
VCC_5V_2: TP3.TESTPOINT; also elsewhere on the board
VCC_5V_3: TP4.TESTPOINT; also elsewhere on the board
VCC_5V_4: TP5.TESTPOINT; also elsewhere on the board
VCC_BACKPLANE: J3.6 (VCC); also elsewhere on the board
VSOL+: JP1.2; also elsewhere on the board

Notes on the sheet:
Debugging

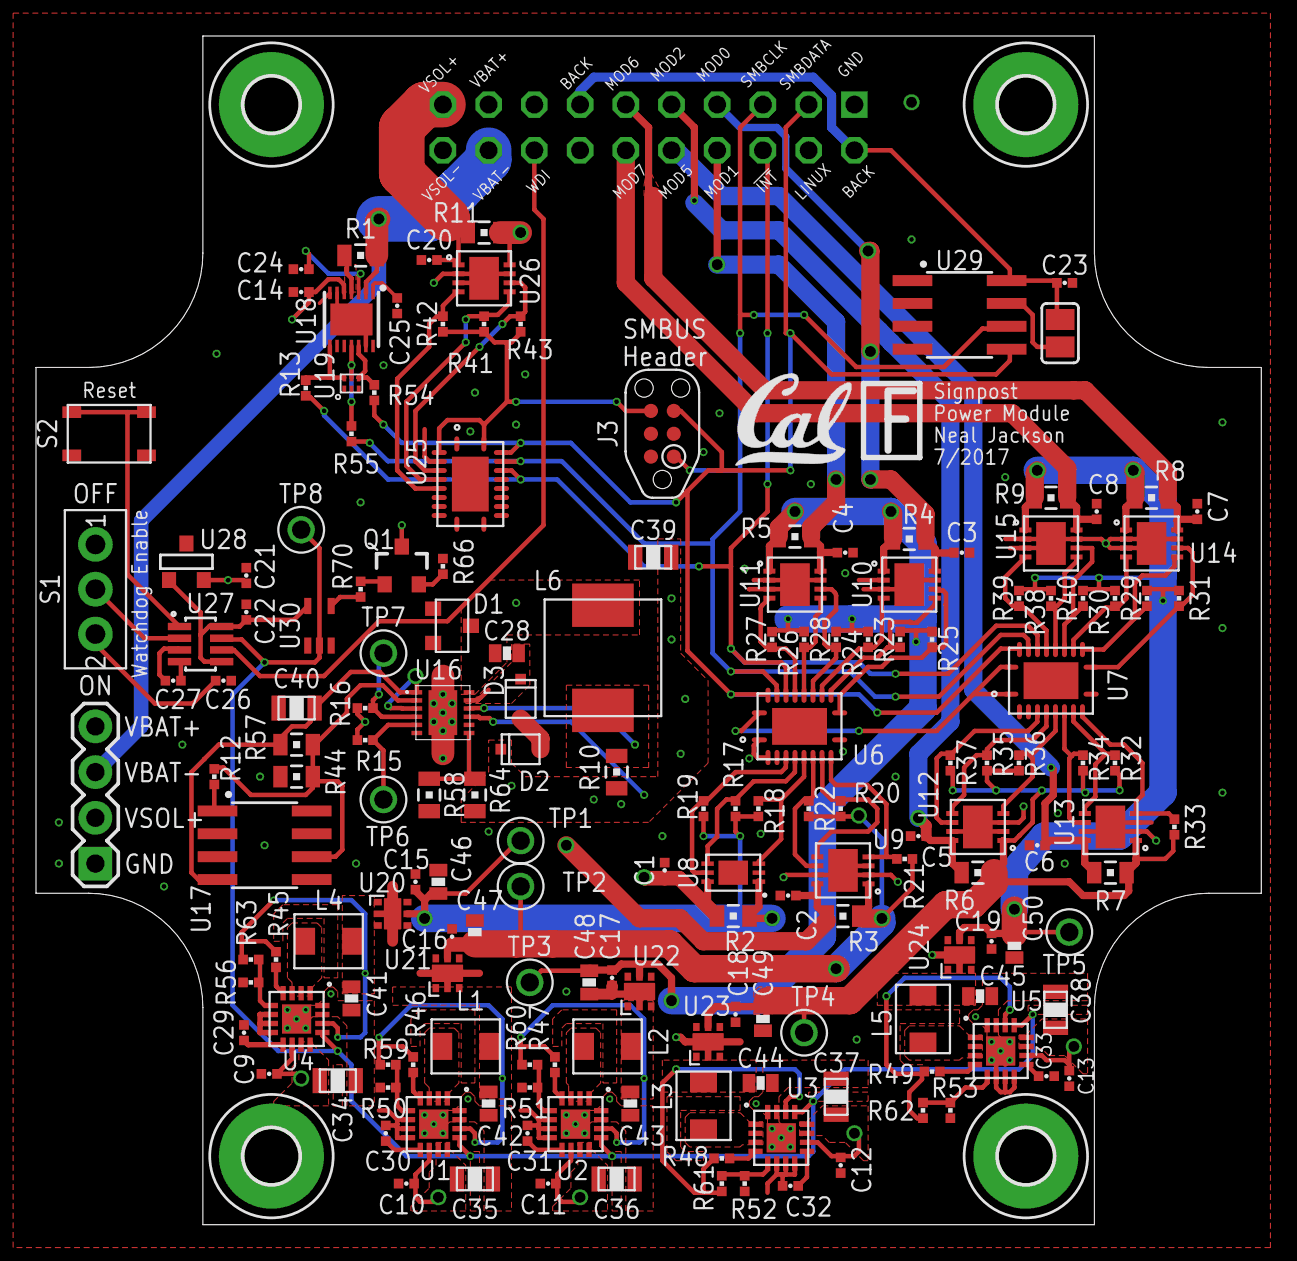
[picture p65: board hardware/power_supply_module/rev_f/power_supply_module.brd from above]

Board: 4 copper layers, 68.1 x 66.0 mm, 174 parts (0 on the bottom side), 98 nets.

Other parts of the board:
U$1: UCB_CAL_200MIL
