lab11/signpost/modules/arduino/rev_a/arduino.brd

## EAGLE design modules/arduino/rev_a/arduino.brd (2017-04-28)

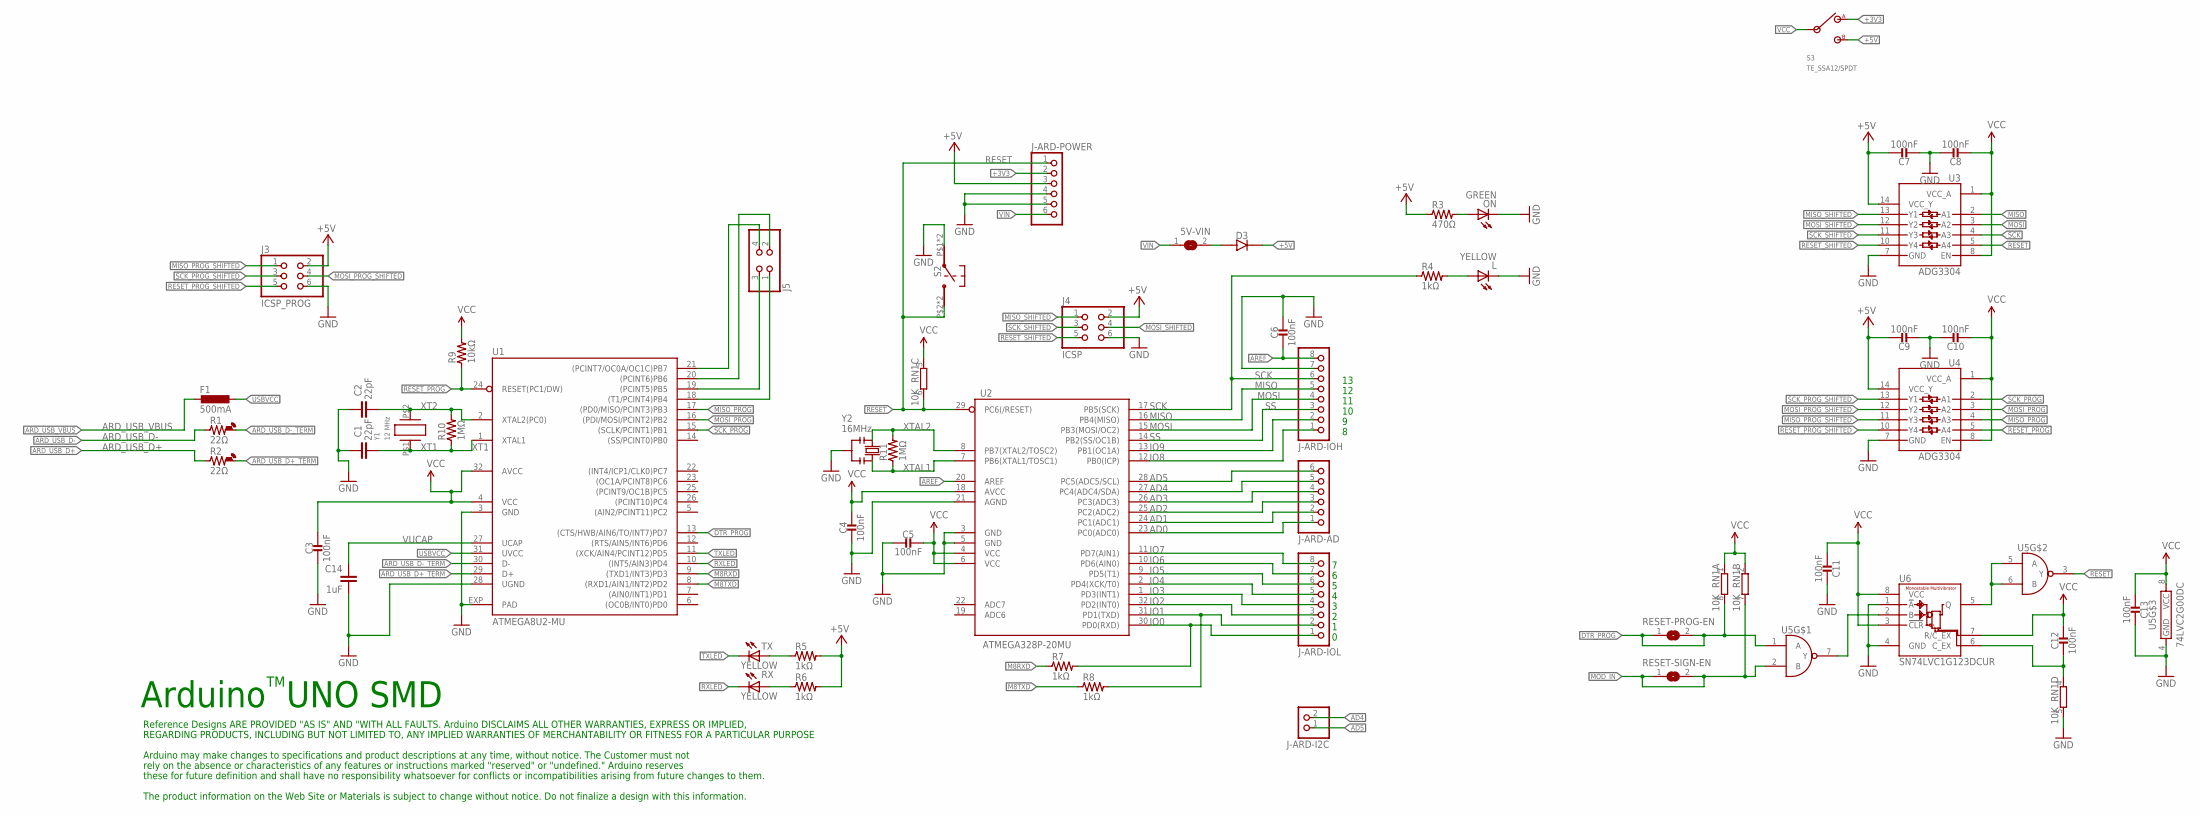
[picture p66: schematic arduino.sch, sheet 1]

Parts:
5V-VIN: SJ
C1, C2: 22pF; C0603-ROUND
C3, C4, C5, C6, C7, C8, C9, C10, C11, C12, C13: 100nF; 0603_CAP
C14: 1uF; C0603-ROUND
D3: DIODE; 0402_DIODE; DIGIKEY P18981CT-ND
F1: 500mA; L1812; DIGIKEY MF-MSMF050-2CT-ND
J3: ICSP_PROG; 2X03
J4: ICSP; 2X03
J5: PINHD-2X2; 2X02
J-ARD-AD: PINHD-1X6; 1X06
J-ARD-I2C: PINHD-1X2; 1X02
J-ARD-IOH: PINHD-1X8; 1X08
J-ARD-IOL: PINHD-1X8; 1X08
J-ARD-POWER: PINHD-1X6; 1X06
L: YELLOW; CHIP-LED0805
ON: GREEN; CHIP-LED0805
R1, R2: 22Ω; 0402_RES-HIGH_SPEED
R3: 470Ω; 0603-RES
R4, R5, R6, R7, R8: 1kΩ; 0603-RES
R9: 10kΩ; 0603-RES
R10, R11: 1MΩ; 0603-RES
RESET-PROG-EN: SJ
RESET-SIGN-EN: SJ
RN1: 10K; CAY16; DIGIKEY CAY16-103J4GLFCT-ND
RX: YELLOW; CHIP-LED0805
S2: EVQP2
S3: TE_SSA12/SPDT
TX: YELLOW; CHIP-LED0805
U1: ATMEGA8U2-MU; QFN32; DIGIKEY ATMEGA8U2-MURCT-ND
U2: ATMEGA328P-20MU; MLF32; DIGIKEY ATMEGA328P-MU-ND
U3, U4: ADG3304; TSSOP-14/5MM
U5: 74LVC2G00DC; VSSOP-8
U6: SN74LVC1G123DCUR; VFSOP-8
Y1: 12 MHz; ABM3; DIGIKEY 535-9103-1-ND
Y2: 16MHz; RESONATOR; DIGIKEY 490-1198-1-ND

Connections:
+3V3: J-ARD-POWER.2, S3.1 (A); also elsewhere on the board
+5V: C7.1, C9.1, D3.CATHODE, J3.2, J4.2, J-ARD-POWER.3, R3.1, R5.2, R6.2, S3.2 (B), U3.14 (VCC_Y), U4.14 (VCC_Y); also elsewhere on the board
AD0: J-ARD-AD.1, U2.23 (PC0(ADC0))
AD1: J-ARD-AD.2, U2.24 (PC1(ADC1))
AD2: J-ARD-AD.3, U2.25 (PC2(ADC2))
AD3: J-ARD-AD.4, U2.26 (PC3(ADC3))
AD4: J-ARD-AD.5, J-ARD-I2C.2, U2.27 (PC4(ADC4/SDA))
AD5: J-ARD-AD.6, J-ARD-I2C.1, U2.28 (PC5(ADC5/SCL))
ARD_USB_D+: R2.2; also elsewhere on the board
ARD_USB_D+_TERM: R2.1, U1.29 (D+)
ARD_USB_D-: R1.2; also elsewhere on the board
ARD_USB_D-_TERM: R1.1, U1.30 (D-)
ARD_USB_VBUS: F1.2; also elsewhere on the board
AREF: C6.2, J-ARD-IOH.8, U2.20 (AREF)
DTR_PROG: RESET-PROG-EN.1, RESET-PROG-EN.2, RN1.8 (2), U1.13 ((CTS/HWB/AIN6/TO/INT7)PD7), U5.1 (A)
GND: C1.2, C2.2, C3.2, C4.2, C5.2, C6.1, C7.2, C8.1, C9.2, C10.1, C11.1, C13.1, C14.2, J3.6, J4.6, J-ARD-IOH.7, J-ARD-POWER.4, J-ARD-POWER.5, L.C, ON.C, RN1.5 (2), S2.P$1, S2.P$3, U1.3 (GND), U1.28 (UGND), U1.EXP (PAD), U2.3 (GND), U2.5 (GND), U2.21 (AGND), U3.7 (GND), U4.7 (GND), U5.4 (GND), U6.1 (!A), U6.4 (GND), Y2.2; also elsewhere on the board
IO0: J-ARD-IOL.1, R7.2, U2.30 (PD0(RXD))
IO1: J-ARD-IOL.2, R8.2, U2.31 (PD1(TXD))
IO2: J-ARD-IOL.3, U2.32 (PD2(INT0))
IO3: J-ARD-IOL.4, U2.1 (PD3(INT1))
IO4: J-ARD-IOL.5, U2.2 (PD4(XCK/T0))
IO5: J-ARD-IOL.6, U2.9 (PD5(T1))
IO6: J-ARD-IOL.7, U2.10 (PD6(AIN0))
IO7: J-ARD-IOL.8, U2.11 (PD7(AIN1))
IO8: J-ARD-IOH.1, U2.12 (PB0(ICP))
IO9: J-ARD-IOH.2, U2.13 (PB1(OC1A))
M8RXD: R7.1, U1.9 ((TXD1/INT3)PD3)
M8TXD: R8.1, U1.8 ((RXD1/AIN1/INT2)PD2)
MISO: J-ARD-IOH.5, U2.16 (PB4(MISO)), U3.2 (A1)
MISO_PROG: U1.17 ((PD0/MISO/PCINT3)PB3), U4.4 (A3)
MISO_PROG_SHIFTED: J3.1, U4.11 (Y3)
MISO_SHIFTED: J4.1, U3.13 (Y1)
MOD_IN: RESET-SIGN-EN.1, RESET-SIGN-EN.2, RN1.7 (2), U5.2 (B); also elsewhere on the board
MOSI: J-ARD-IOH.4, U2.15 (PB3(MOSI/OC2)), U3.3 (A2)
MOSI_PROG: U1.16 ((PDI/MOSI/PCINT2)PB2), U4.3 (A2)
MOSI_PROG_SHIFTED: J3.4, U4.12 (Y2)
MOSI_SHIFTED: J4.4, U3.12 (Y2)
unnamed: L.A, R4.2
unnamed: J5.1, U1.18 ((T1/PCINT4)PB4)
unnamed: ON.A, R3.2
unnamed: J5.3, U1.19 ((PCINT5)PB5)
unnamed: J5.2, U1.20 ((PCINT6)PB6)
unnamed: J5.4, U1.21 ((PCINT7/OC0A/OC1C)PB7)
unnamed: C12.2, RN1.4 (1), U6.6 (C_EX)
unnamed: 5V-VIN.2, D3.ANODE
unnamed: U5.7 (Y), U6.2 (B)
unnamed: U5.5 (A), U5.6 (B), U6.5 (Q)
unnamed: R6.1, RX.A
unnamed: R5.1, TX.A
RESET: J-ARD-POWER.1, RN1.6 (2), S2.P$2, S2.P$4, U2.29 (PC6(/RESET)), U3.5 (A4), U5.3 (Y)
RESET_PROG: R9.1, U1.24 (RESET(PC1/DW)), U4.5 (A4)
RESET_PROG_SHIFTED: J3.5, U4.10 (Y4)
RESET_SHIFTED: J4.5, U3.10 (Y4)
RXLED: RX.C, U1.10 ((INT5/AIN3)PD4)
SCK: J-ARD-IOH.6, R4.1, U2.17 (PB5(SCK)), U3.4 (A3)
SCK_PROG: U1.15 ((SCLK/PCINT1)PB1), U4.2 (A1)
SCK_PROG_SHIFTED: J3.3, U4.13 (Y1)
SCK_SHIFTED: J4.3, U3.11 (Y3)
SS: J-ARD-IOH.3, U2.14 (PB2(SS/OC1B))
TXLED: TX.C, U1.11 ((XCK/AIN4/PCINT12)PD5)
USBVCC: F1.1, U1.31 (UVCC)
VCC: C3.1, C4.1, C5.1, C8.2, C10.2, C11.2, C12.1, C13.2, R9.2, RN1.1, RN1.2 (1), RN1.3 (1), S3.IN, U1.4 (VCC), U1.32 (AVCC), U2.4 (VCC), U2.6 (VCC), U2.18 (AVCC), U3.1 (VCC_A), U3.8 (EN), U4.1 (VCC_A), U4.8 (EN), U5.8 (VCC), U6.3 (!CLR), U6.7 (R/C_EX), U6.8 (VCC); also elsewhere on the board
VIN: 5V-VIN.1, J-ARD-POWER.6
VUCAP: C14.1, U1.27 (UCAP)
XT1: C1.1, R10.1, U1.1 (XTAL1), Y1.P$1 (1)
XT2: C2.1, R10.2, U1.2 (XTAL2(PC0)), Y1.P$2 (2)
XTAL1: R11.1, U2.7 (PB6(XTAL1/TOSC1)), Y2.3
XTAL2: R11.2, U2.8 (PB7(XTAL2/TOSC2)), Y2.1

Notes on the sheet:
Arduino UNO SMD
Reference Designs ARE PROVIDED "AS IS" AND "WITH ALL FAULTS. Arduino DISCLAIMS ALL OTHER WARRANTIES, EXPRESS OR IMPLIED,
Arduino may make changes to specifications and product descriptions at any time, without notice. The Customer must not
REGARDING PRODUCTS, INCLUDING BUT NOT LIMITED TO, ANY IMPLIED WARRANTIES OF MERCHANTABILITY OR FITNESS FOR A PARTICULAR PURPOSE
rely on the absence or characteristics of any features or instructions marked "reserved" or "undefined." Arduino reserves
these for future definition and shall have no responsibility whatsoever for conflicts or incompatibilities arising from future changes to them.
The product information on the Web Site or Materials is subject to change without notice. Do not finalize a design with this information.

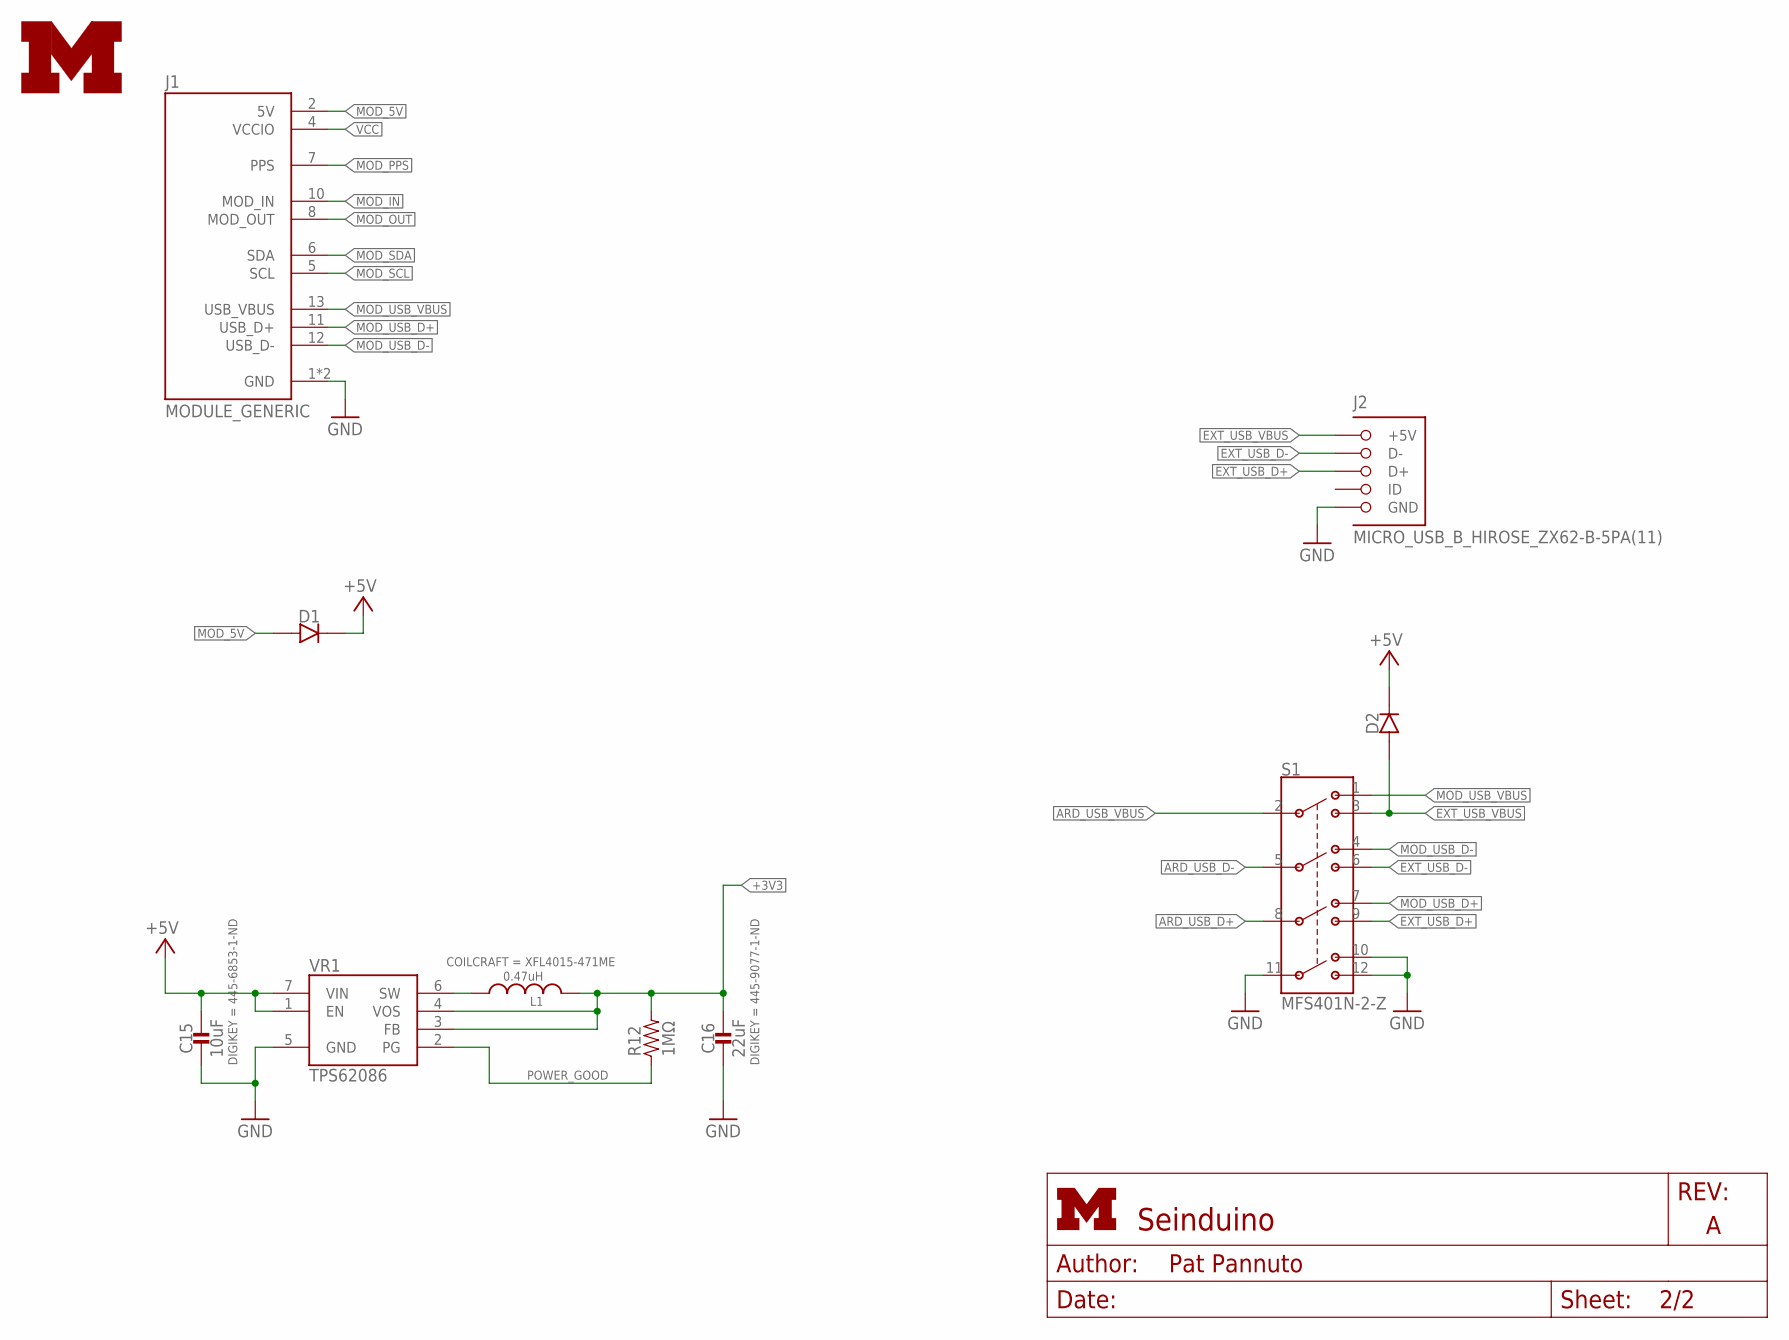
[picture p67: schematic arduino.sch, sheet 2]

Parts:
C15: 10uF; 0603_CAP; DIGIKEY 445-6853-1-ND
C16: 22uF; 0603_CAP; DIGIKEY 445-9077-1-ND
D1, D2: DIODE; 0402_DIODE; DIGIKEY P18981CT-ND
J1: MODULE_GENERIC
J2: MICRO_USB_B_HIROSE_ZX62-B-5PA(11); USB_MICRO_B-HIROSE-ZX62-B-5PA(11)
L1: 0.47uH; XFL4015
LOGO1: UMICH_SOLID_MEDIUM; UMICH_SOLID_200MIL
R12: 1MΩ; 0603-RES
S1: MFS401N-2-Z
VR1: TPS62086; RLT0007A

Connections:
+3V3: C16.1, L1.2, R12.2, VR1.3 (FB), VR1.4 (VOS); also elsewhere on the board
+5V: C15.1, D1.CATHODE, D2.CATHODE, VR1.1 (EN), VR1.7 (VIN); also elsewhere on the board
ARD_USB_D+: S1.8 (3P); also elsewhere on the board
ARD_USB_D-: S1.5 (2P); also elsewhere on the board
ARD_USB_VBUS: S1.2 (1P); also elsewhere on the board
EXT_USB_D+: J2.3 (D+), S1.9 (3TB)
EXT_USB_D-: J2.2 (D-), S1.6 (2TB)
EXT_USB_VBUS: D2.ANODE, J2.1 (+5V), S1.3 (1TB)
GND: C15.2, C16.2, J1.1 (GND), J1.14 (GND), J2.5 (GND), S1.10 (4TA), S1.11 (4P), S1.12 (4TB), VR1.5 (GND); also elsewhere on the board
MOD_5V: D1.ANODE, J1.2 (5V)
MOD_IN: J1.10 (MOD_IN); also elsewhere on the board
MOD_OUT: J1.8 (MOD_OUT)
MOD_PPS: J1.7 (PPS)
MOD_SCL: J1.5 (SCL)
MOD_SDA: J1.6 (SDA)
MOD_USB_D+: J1.11 (USB_D+), S1.7 (3TA)
MOD_USB_D-: J1.12 (USB_D-), S1.4 (2TA)
MOD_USB_VBUS: J1.13 (USB_VBUS), S1.1 (1TA)
POWER_GOOD: R12.1, VR1.2 (PG)
VCC: J1.4 (VCCIO); also elsewhere on the board
VR_IND_SW: L1.1, VR1.6 (SW)

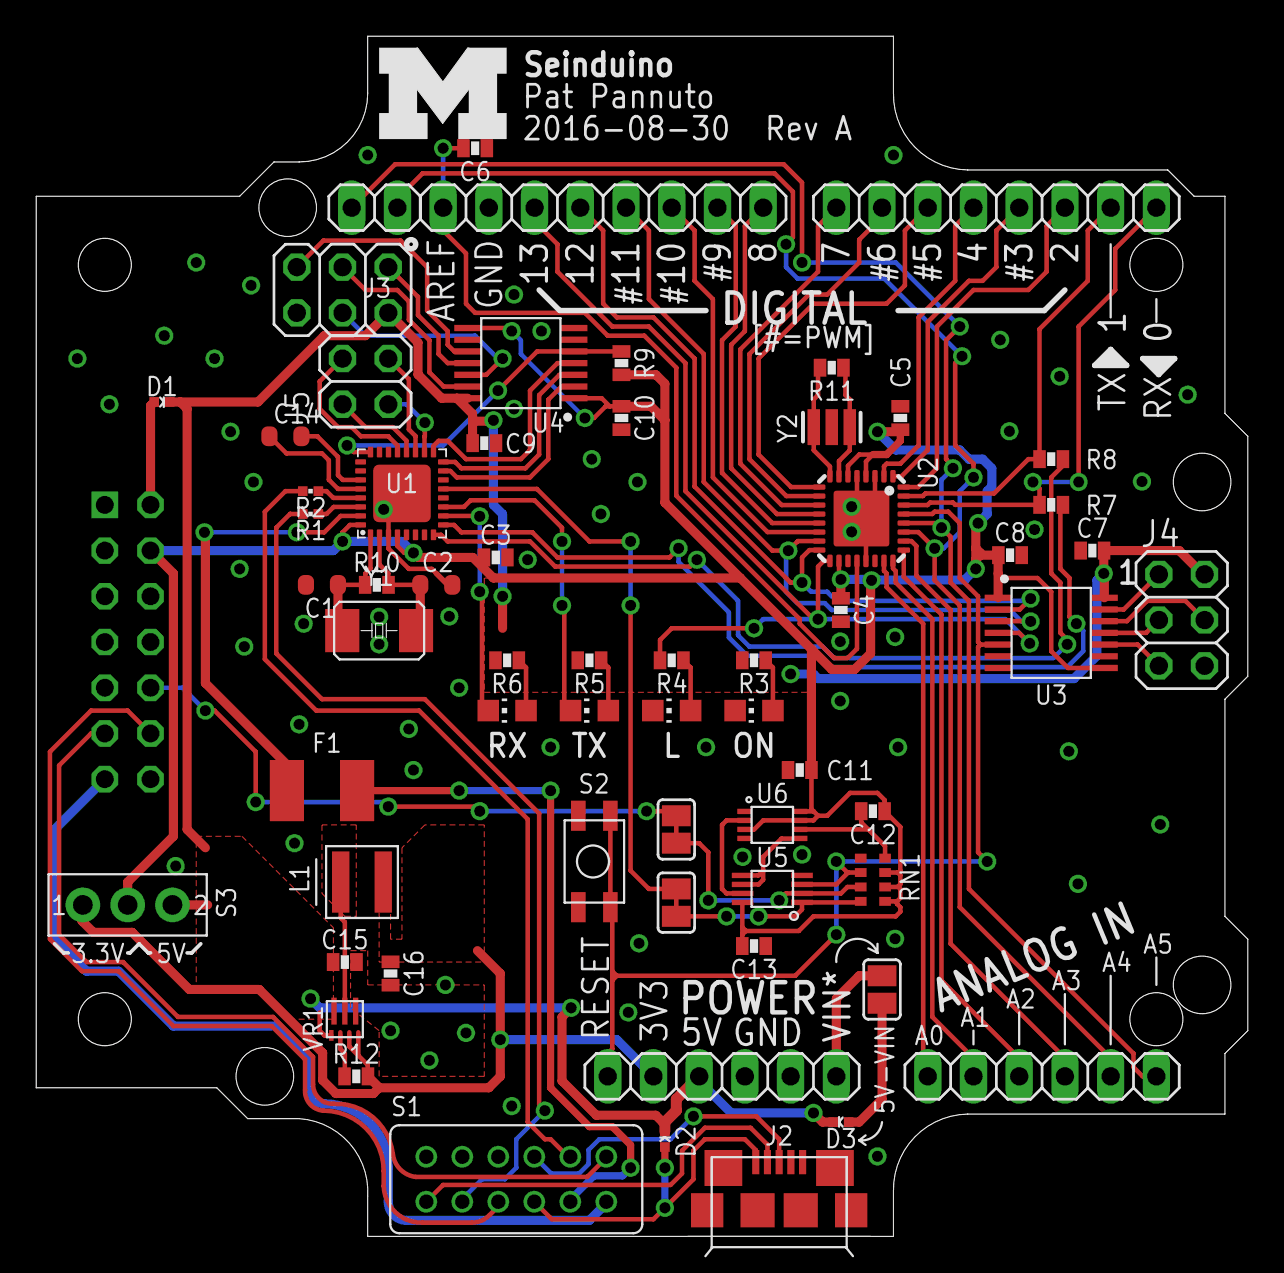
[picture p68: board arduino.brd from above]

Board: 2 copper layers, 67.3 x 66.7 mm, 64 parts (0 on the bottom side), 77 nets.
