lab11/signpost/hardware/debug_backplane/rev_a/debug_backplane.brd

## EAGLE design hardware/debug_backplane/rev_a/debug_backplane.brd (2017-01-23, an earlier design)

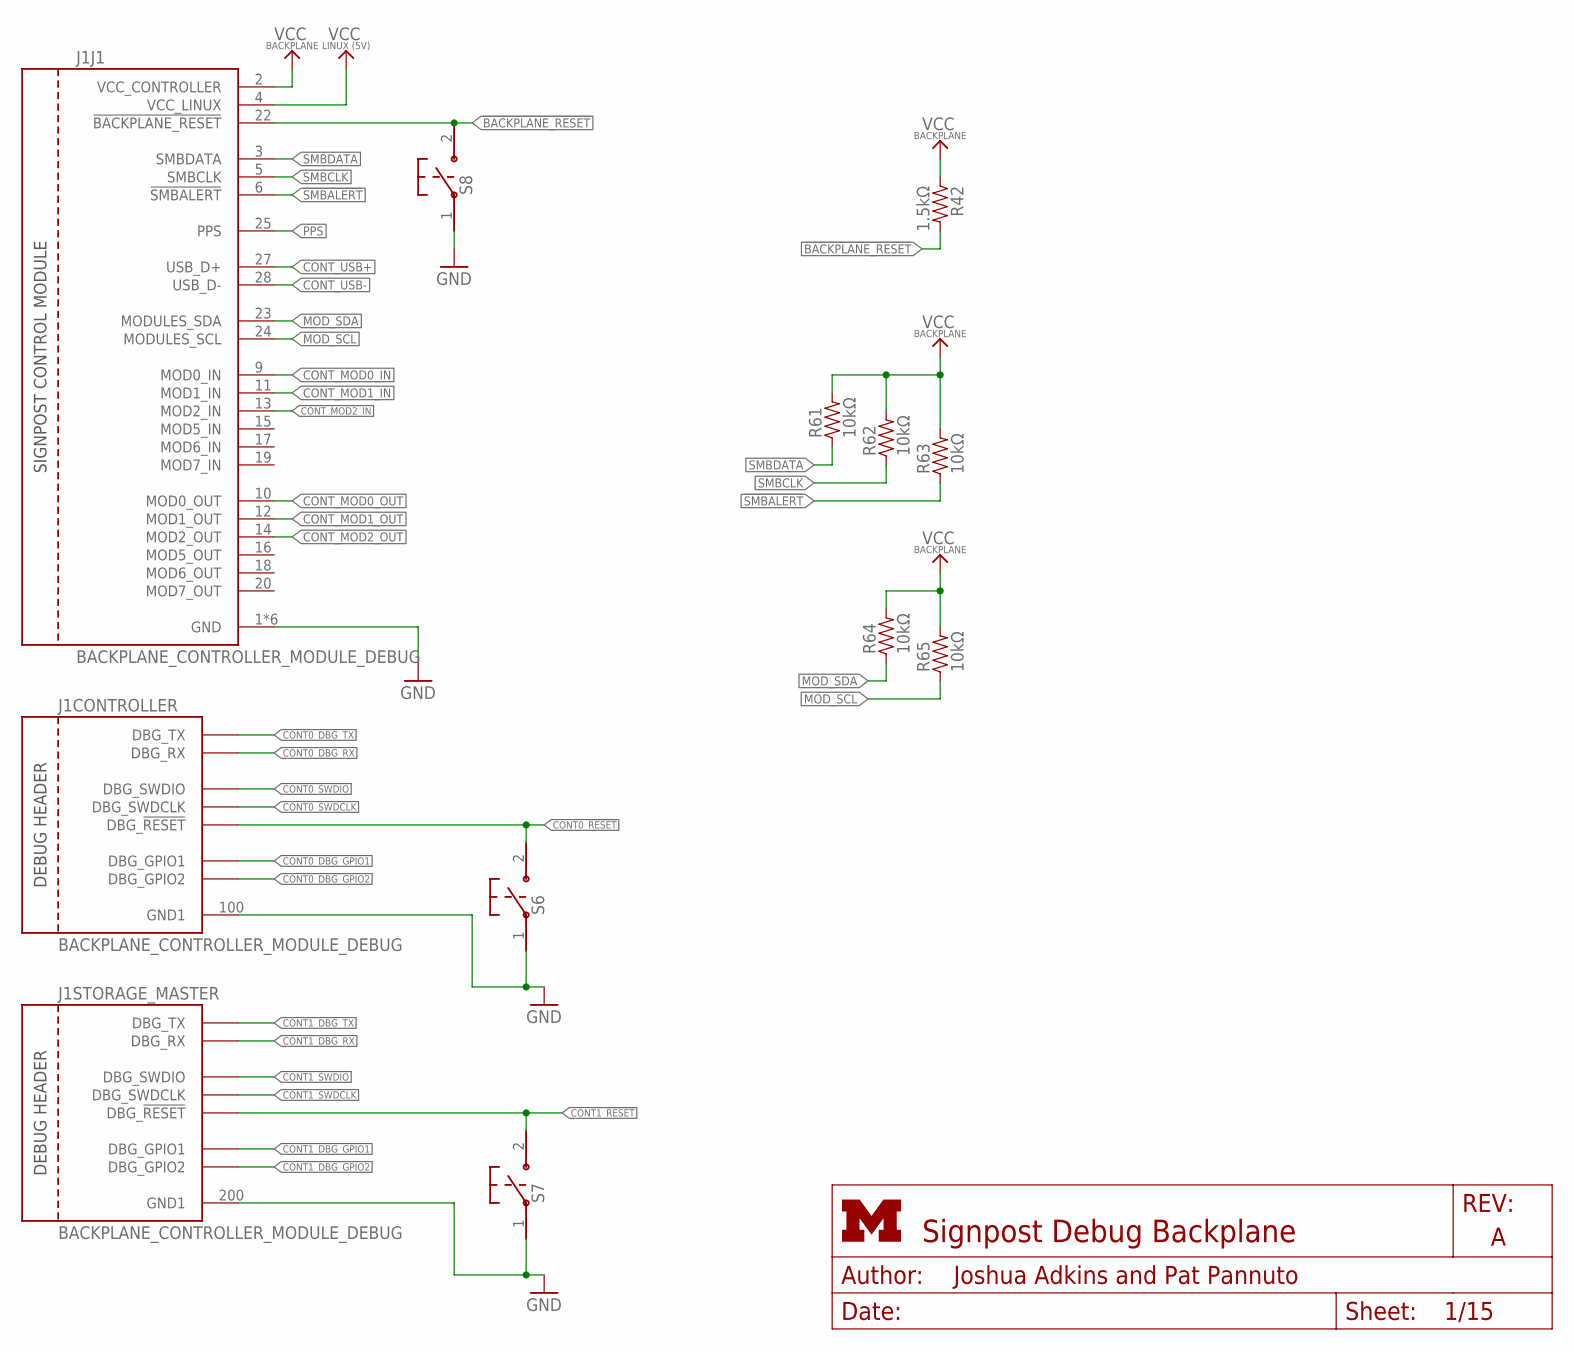
[picture p69: schematic debug_backplane.sch, sheet 1]

Parts:
J1: BACKPLANE_CONTROLLER_MODULE_DEBUG; BACKPLANE_MODULE_20PIN_10PIN_DEBUG
R42: 1.5kΩ; 0603-RES
R61, R62, R63, R64, R65: 10kΩ; 0603-RES
S6, S7, S8: B3U-1000P

Connections:
!BACKPLANE_RESET: J1.22 (!BACKPLANE_RESET), R42.2, S8.2; also elsewhere on the board
!SMBALERT: J1.6 (!SMBALERT), R63.1; also elsewhere on the board
CONT0_!RESET: J1.105 (DBG_!RESET), S6.2; also elsewhere on the board
CONT0_DBG_GPIO1: J1.101 (DBG_GPIO1); also elsewhere on the board
CONT0_DBG_GPIO2: J1.104 (DBG_GPIO2); also elsewhere on the board
CONT0_DBG_RX: J1.103 (DBG_RX); also elsewhere on the board
CONT0_DBG_TX: J1.102 (DBG_TX); also elsewhere on the board
CONT0_SWDCLK: J1.106 (DBG_SWDCLK); also elsewhere on the board
CONT0_SWDIO: J1.107 (DBG_SWDIO); also elsewhere on the board
CONT1_!RESET: J1.205 (DBG_!RESET), S7.2; also elsewhere on the board
CONT1_DBG_GPIO1: J1.201 (DBG_GPIO1); also elsewhere on the board
CONT1_DBG_GPIO2: J1.204 (DBG_GPIO2); also elsewhere on the board
CONT1_DBG_RX: J1.203 (DBG_RX); also elsewhere on the board
CONT1_DBG_TX: J1.202 (DBG_TX); also elsewhere on the board
CONT1_SWDCLK: J1.206 (DBG_SWDCLK); also elsewhere on the board
CONT1_SWDIO: J1.207 (DBG_SWDIO); also elsewhere on the board
CONT_MOD0_IN: J1.9 (MOD0_IN); also elsewhere on the board
CONT_MOD0_OUT: J1.10 (MOD0_OUT); also elsewhere on the board
CONT_MOD1_IN: J1.11 (MOD1_IN); also elsewhere on the board
CONT_MOD1_OUT: J1.12 (MOD1_OUT); also elsewhere on the board
CONT_MOD2_IN: J1.13 (MOD2_IN); also elsewhere on the board
CONT_MOD2_OUT: J1.14 (MOD2_OUT); also elsewhere on the board
CONT_USB+: J1.27 (USB_D+); also elsewhere on the board
CONT_USB-: J1.28 (USB_D-); also elsewhere on the board
GND: J1.1 (GND), J1.21 (GND), J1.100 (GND1), J1.200 (GND1), J1.MNT1 (GND), J1.MNT2 (GND), J1.MNT3 (GND), J1.MNT4 (GND), S6.1, S7.1, S8.1; also elsewhere on the board
MOD_SCL: J1.24 (MODULES_SCL), R65.1; also elsewhere on the board
MOD_SDA: J1.23 (MODULES_SDA), R64.1; also elsewhere on the board
PPS: J1.25 (PPS); also elsewhere on the board
SMBCLK: J1.5 (SMBCLK), R62.1; also elsewhere on the board
SMBDATA: J1.3 (SMBDATA), R61.1; also elsewhere on the board
VCC_BACKPLANE: J1.2 (VCC_CONTROLLER), R42.1, R61.2, R62.2, R63.2, R64.2, R65.2; also elsewhere on the board
VCC_LINUX: J1.4 (VCC_LINUX); also elsewhere on the board

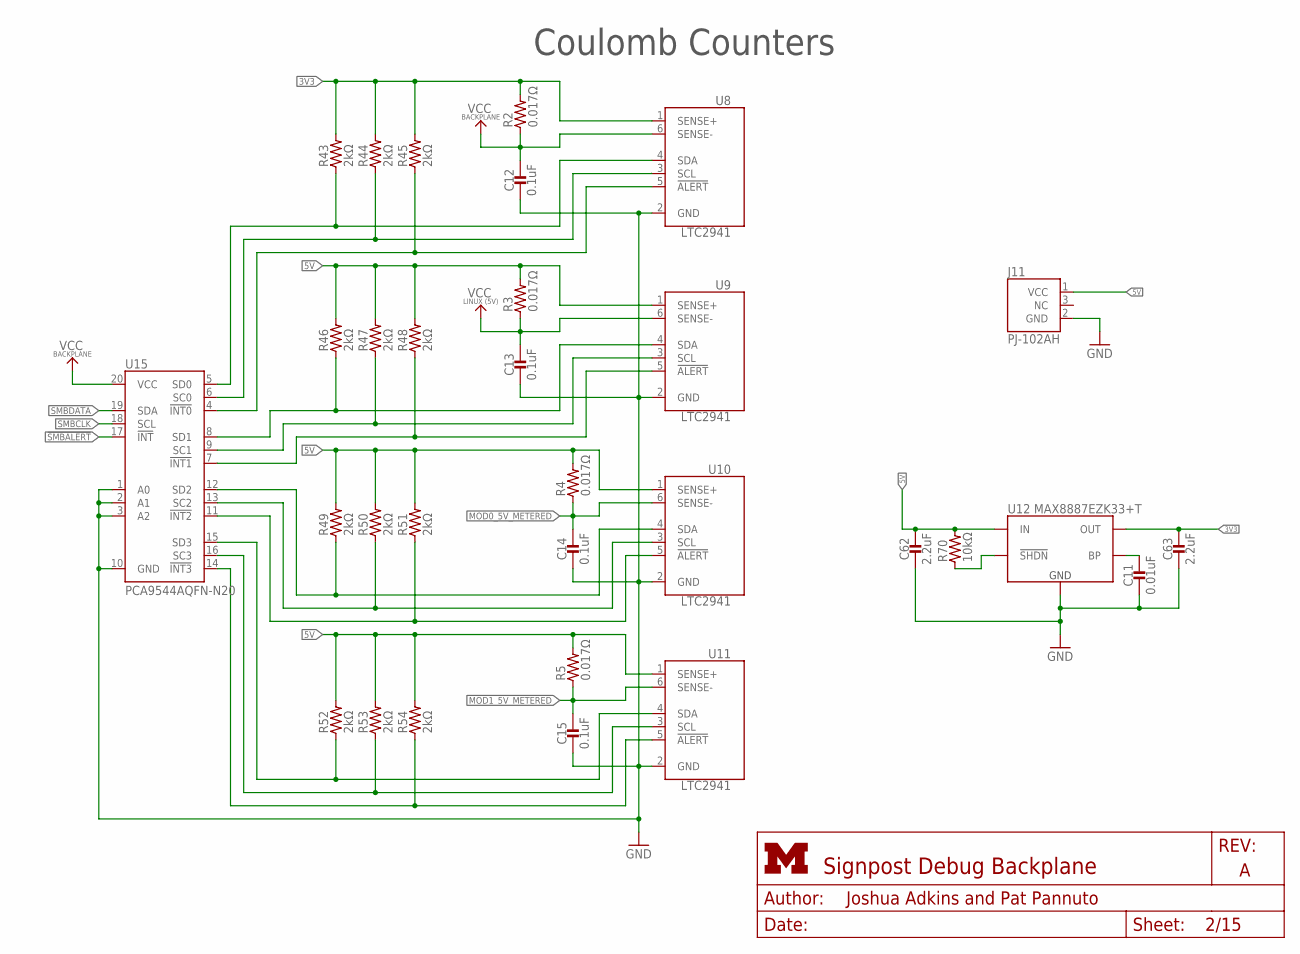
[picture p70: schematic debug_backplane.sch, sheet 2]

Parts:
C11: 0.01uF; 0402_CAP
C12, C13, C14, C15: 0.1uF; 0402_CAP
C62, C63: 2.2uF; 0603_CAP
J11: PJ-102AH
R2, R3, R4, R5: 0.017Ω; 0805_RES
R43, R44, R45, R46, R47, R48, R49, R50, R51, R52, R53, R54: 2kΩ; 0402_RES
R70: 10kΩ; 0603-RES
U8, U9, U10, U11: LTC2941; DFN-6-2MMX3MM
U12: MAX8887EZK33+T; SOT-23-5
U15: PCA9544AQFN-N20; QFN-N20

Connections:
3V3: C63.1, R2.2, R43.2, R44.2, R45.2, U8.1 (SENSE+), U12.5 (OUT); also elsewhere on the board
5V: C62.1, J11.1 (VCC), R3.2, R4.2, R5.2, R46.2, R47.2, R48.2, R49.2, R50.2, R51.2, R52.2, R53.2, R54.2, R70.2, U9.1 (SENSE+), U10.1 (SENSE+), U11.1 (SENSE+), U12.1 (IN); also elsewhere on the board
!SMBALERT: U15.17 (!INT); also elsewhere on the board
GND: C11.2, C12.2, C13.2, C14.2, C15.2, C62.2, C63.2, J11.2 (GND), U8.2 (GND), U9.2 (GND), U10.2 (GND), U11.2 (GND), U12.2 (GND), U15.1 (A0), U15.2 (A1), U15.3 (A2), U15.10 (GND); also elsewhere on the board
MOD0_5V_METERED: C14.1, R4.1, U10.6 (SENSE-); also elsewhere on the board
MOD1_5V_METERED: C15.1, R5.1, U11.6 (SENSE-); also elsewhere on the board
unnamed: R70.1, U12.3 (!SHDN)
unnamed: C11.1, U12.4 (BP)
unnamed: R43.1, U8.4 (SDA), U15.5 (SD0)
unnamed: R44.1, U8.3 (SCL), U15.6 (SC0)
unnamed: R49.1, U10.4 (SDA), U15.12 (SD2)
unnamed: R50.1, U10.3 (SCL), U15.13 (SC2)
unnamed: R51.1, U10.5 (!ALERT), U15.11 (!INT2)
unnamed: R52.1, U11.4 (SDA), U15.15 (SD3)
unnamed: R53.1, U11.3 (SCL), U15.16 (SC3)
unnamed: R54.1, U11.5 (!ALERT), U15.14 (!INT3)
unnamed: R45.1, U8.5 (!ALERT), U15.4 (!INT0)
unnamed: R46.1, U9.4 (SDA), U15.8 (SD1)
unnamed: R47.1, U9.3 (SCL), U15.9 (SC1)
unnamed: R48.1, U9.5 (!ALERT), U15.7 (!INT1)
SMBCLK: U15.18 (SCL); also elsewhere on the board
SMBDATA: U15.19 (SDA); also elsewhere on the board
VCC_BACKPLANE: C12.1, R2.1, U8.6 (SENSE-), U15.20 (VCC); also elsewhere on the board
VCC_LINUX: C13.1, R3.1, U9.6 (SENSE-); also elsewhere on the board

Notes on the sheet:
Coulomb Counters

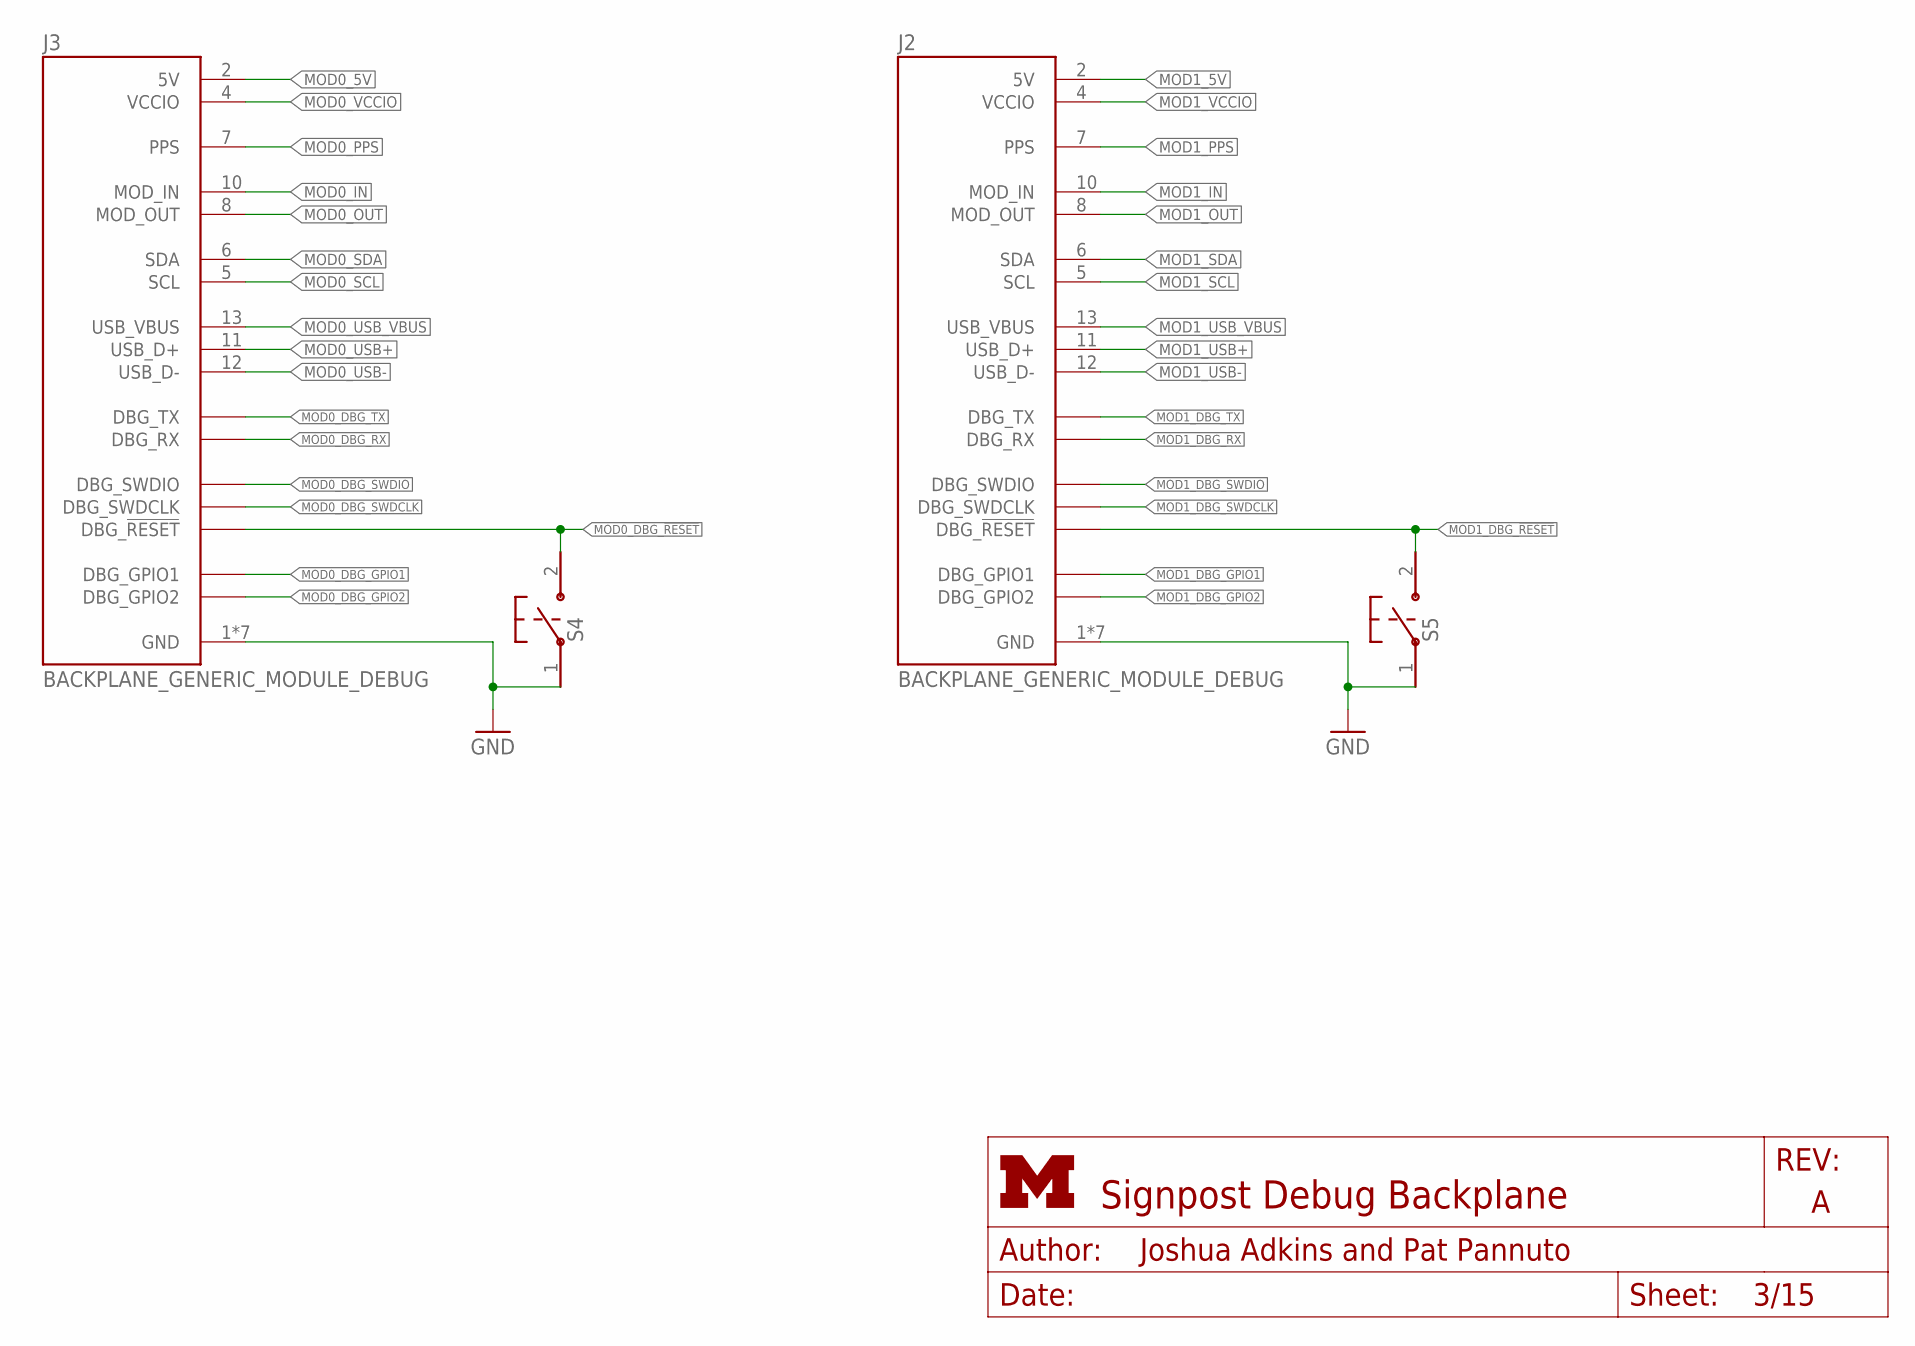
[picture p71: schematic debug_backplane.sch, sheet 3]

Parts:
J2, J3: BACKPLANE_GENERIC_MODULE_DEBUG; BACKPLANE_MODULE_14PIN_8PIN
S4, S5: B3U-1000P

Connections:
GND: J2.1 (GND), J2.14 (GND), J2.15 (GND), J2.MNT1 (GND), J2.MNT2 (GND), J2.MNT3 (GND), J2.MNT4 (GND), J3.1 (GND), J3.14 (GND), J3.15 (GND), J3.MNT1 (GND), J3.MNT2 (GND), J3.MNT3 (GND), J3.MNT4 (GND), S4.1, S5.1; also elsewhere on the board
MOD0_5V: J3.2 (5V); also elsewhere on the board
MOD0_DBG_!RESET: J3.20 (DBG_!RESET), S4.2; also elsewhere on the board
MOD0_DBG_GPIO1: J3.16 (DBG_GPIO1); also elsewhere on the board
MOD0_DBG_GPIO2: J3.19 (DBG_GPIO2); also elsewhere on the board
MOD0_DBG_RX: J3.18 (DBG_RX); also elsewhere on the board
MOD0_DBG_SWDCLK: J3.21 (DBG_SWDCLK); also elsewhere on the board
MOD0_DBG_SWDIO: J3.22 (DBG_SWDIO); also elsewhere on the board
MOD0_DBG_TX: J3.17 (DBG_TX); also elsewhere on the board
MOD0_IN: J3.10 (MOD_IN); also elsewhere on the board
MOD0_OUT: J3.8 (MOD_OUT); also elsewhere on the board
MOD0_PPS: J3.7 (PPS); also elsewhere on the board
MOD0_SCL: J3.5 (SCL); also elsewhere on the board
MOD0_SDA: J3.6 (SDA); also elsewhere on the board
MOD0_USB+: J3.11 (USB_D+); also elsewhere on the board
MOD0_USB-: J3.12 (USB_D-); also elsewhere on the board
MOD0_USB_VBUS: J3.13 (USB_VBUS); also elsewhere on the board
MOD0_VCCIO: J3.4 (VCCIO); also elsewhere on the board
MOD1_5V: J2.2 (5V); also elsewhere on the board
MOD1_DBG_!RESET: J2.20 (DBG_!RESET), S5.2; also elsewhere on the board
MOD1_DBG_GPIO1: J2.16 (DBG_GPIO1); also elsewhere on the board
MOD1_DBG_GPIO2: J2.19 (DBG_GPIO2); also elsewhere on the board
MOD1_DBG_RX: J2.18 (DBG_RX); also elsewhere on the board
MOD1_DBG_SWDCLK: J2.21 (DBG_SWDCLK); also elsewhere on the board
MOD1_DBG_SWDIO: J2.22 (DBG_SWDIO); also elsewhere on the board
MOD1_DBG_TX: J2.17 (DBG_TX); also elsewhere on the board
MOD1_IN: J2.10 (MOD_IN); also elsewhere on the board
MOD1_OUT: J2.8 (MOD_OUT); also elsewhere on the board
MOD1_PPS: J2.7 (PPS); also elsewhere on the board
MOD1_SCL: J2.5 (SCL); also elsewhere on the board
MOD1_SDA: J2.6 (SDA); also elsewhere on the board
MOD1_USB+: J2.11 (USB_D+); also elsewhere on the board
MOD1_USB-: J2.12 (USB_D-); also elsewhere on the board
MOD1_USB_VBUS: J2.13 (USB_VBUS); also elsewhere on the board
MOD1_VCCIO: J2.4 (VCCIO); also elsewhere on the board
