lab11/signpost/hardware/debug_backplane/rev_a/debug_backplane.brd

## EAGLE design hardware/debug_backplane/rev_a/debug_backplane.brd (continued)

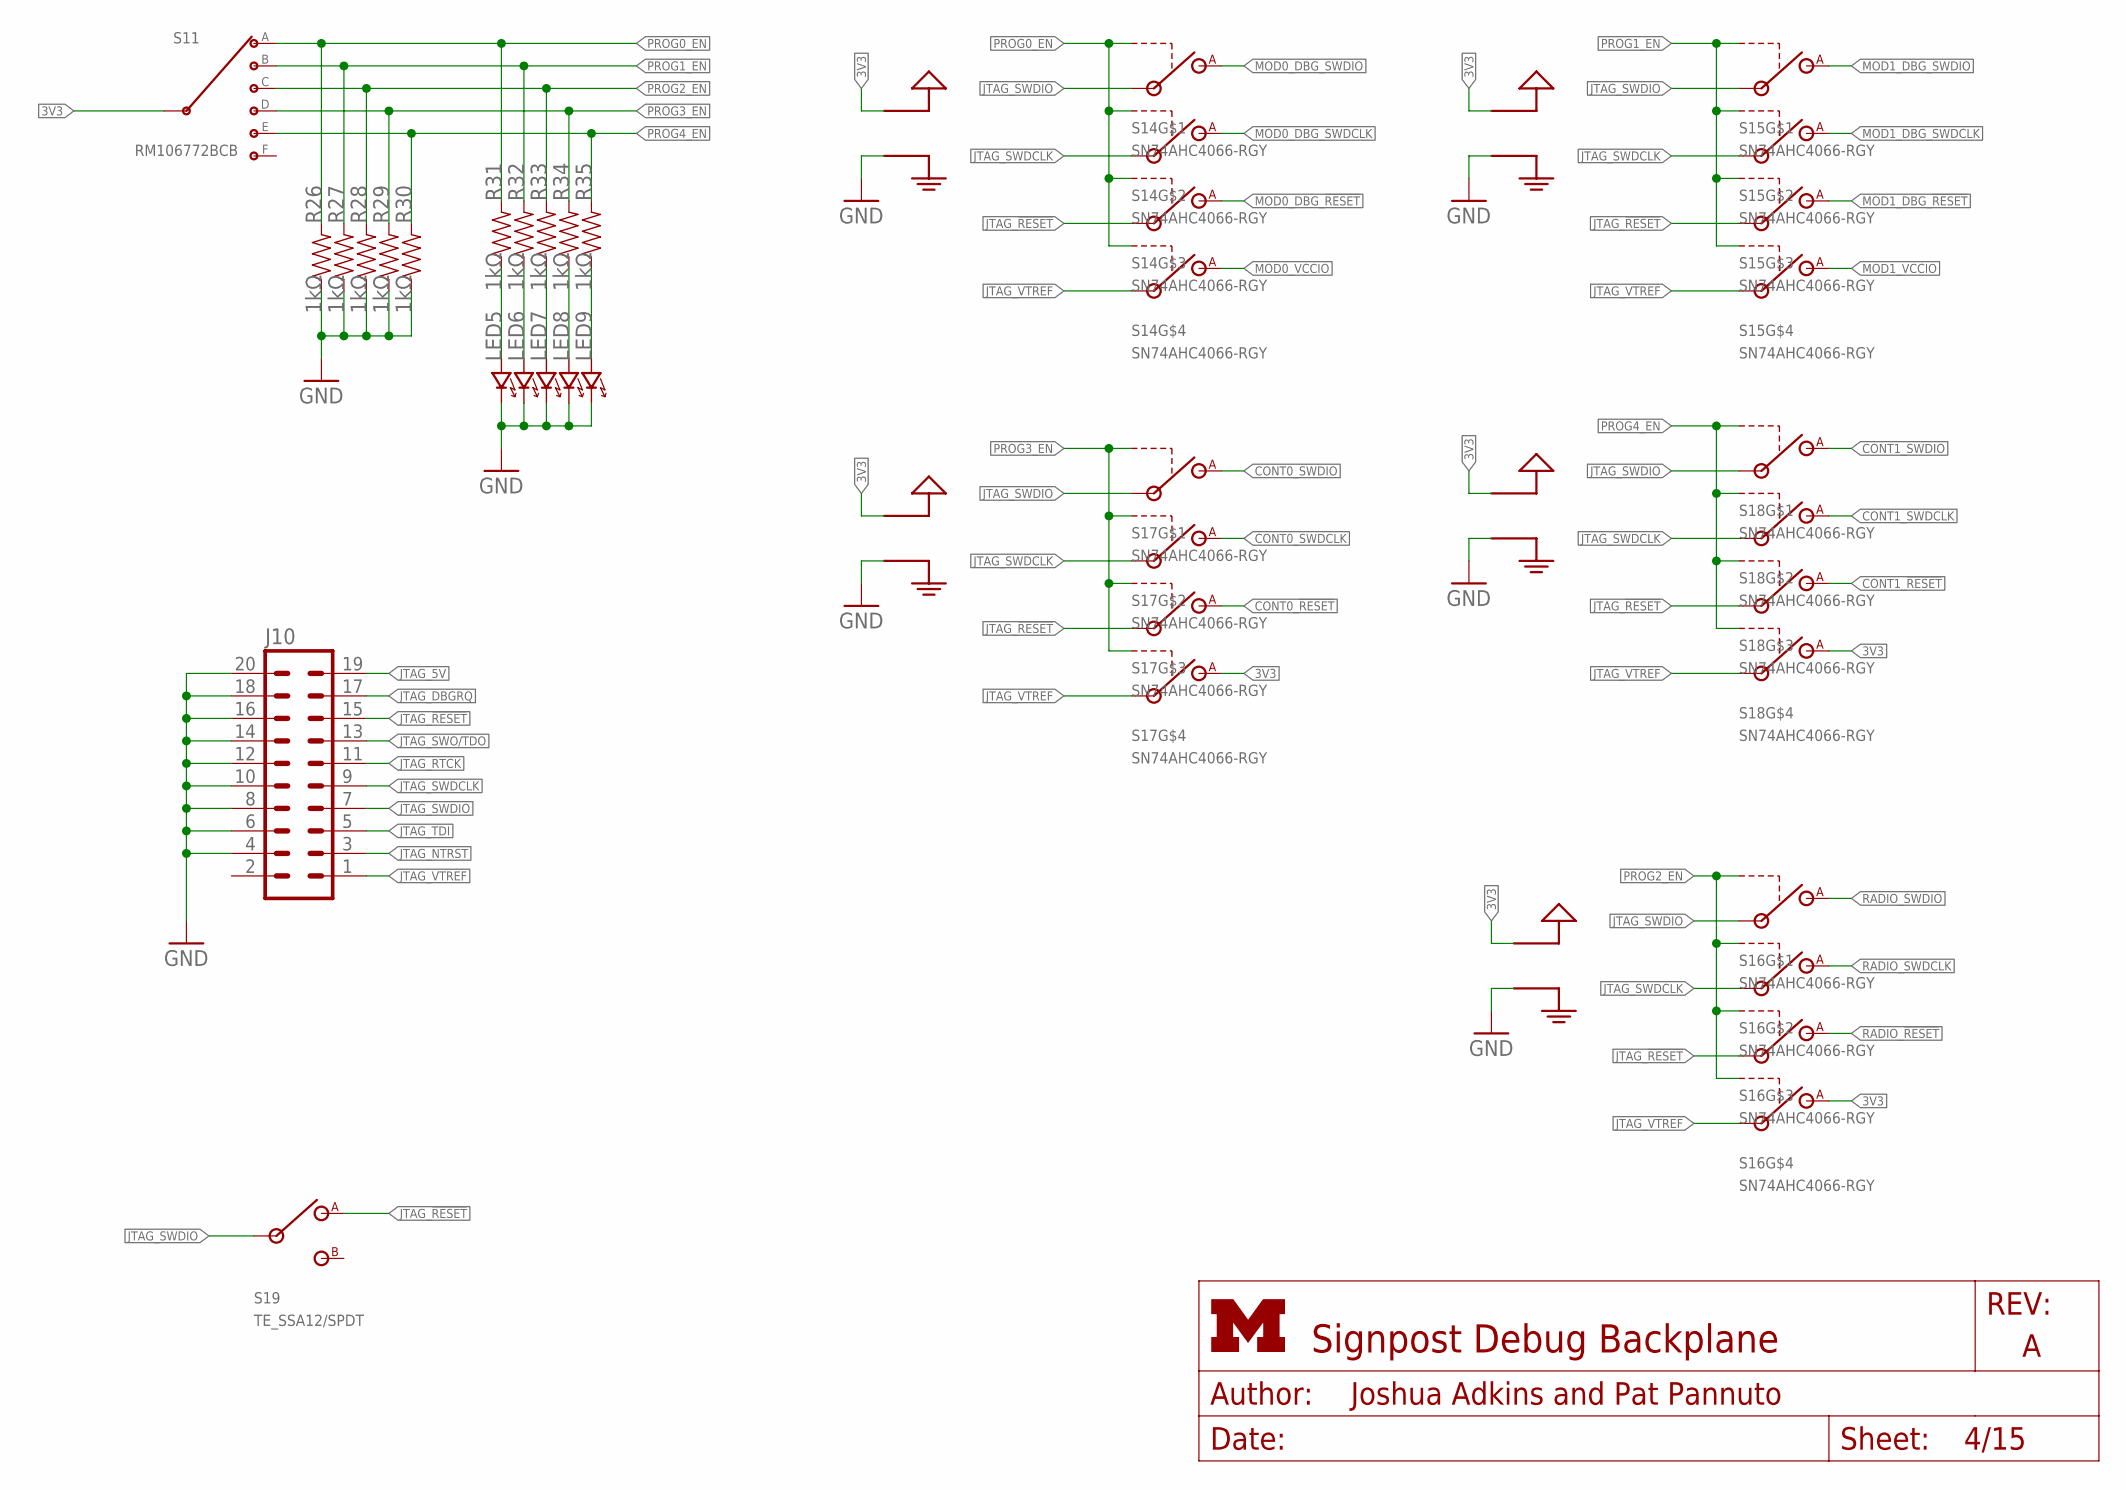
[picture p72: schematic debug_backplane.sch, sheet 4]

Parts:
J10: ML20
LED5, LED6, LED7, LED8, LED9: LED0603; LED-0603
R26, R27, R28, R29, R30, R31, R32, R33, R34, R35: 1kΩ; 0603-RES
S11: RM106772BCB; RM-SWITCH
S14, S15, S16, S17, S18: SN74AHC4066-RGY; S-PVQFN-N14-3.5MM
S19: TE_SSA12/SPDT

Connections:
3V3: S11.C (INPUT), S14.14 (VCC), S15.14 (VCC), S16.10 (A), S16.14 (VCC), S17.10 (A), S17.14 (VCC), S18.10 (A), S18.14 (VCC); also elsewhere on the board
CONT0_!RESET: S17.9 (A); also elsewhere on the board
CONT0_SWDCLK: S17.3 (A); also elsewhere on the board
CONT0_SWDIO: S17.2 (A); also elsewhere on the board
CONT1_!RESET: S18.9 (A); also elsewhere on the board
CONT1_SWDCLK: S18.3 (A); also elsewhere on the board
CONT1_SWDIO: S18.2 (A); also elsewhere on the board
GND: J10.4, J10.6, J10.8, J10.10, J10.12, J10.14, J10.16, J10.18, J10.20, LED5.C (CATHODE), LED6.C (CATHODE), LED7.C (CATHODE), LED8.C (CATHODE), LED9.C (CATHODE), R26.1, R27.1, R28.1, R29.1, R30.1, S14.7 (GND), S15.7 (GND), S16.7 (GND), S17.7 (GND), S18.7 (GND); also elsewhere on the board
JTAG_5V: J10.19
JTAG_!RESET: J10.15, S14.8 (IN), S15.8 (IN), S16.8 (IN), S17.8 (IN), S18.8 (IN), S19.1 (A)
JTAG_DBGRQ: J10.17
JTAG_NTRST: J10.3
JTAG_RTCK: J10.11
JTAG_SWDCLK: J10.9, S14.4 (IN), S15.4 (IN), S16.4 (IN), S17.4 (IN), S18.4 (IN)
JTAG_SWDIO: J10.7, S14.1 (IN), S15.1 (IN), S16.1 (IN), S17.1 (IN), S18.1 (IN), S19.IN
JTAG_SWO/TDO: J10.13
JTAG_TDI: J10.5
JTAG_VTREF: J10.1, S14.11 (IN), S15.11 (IN), S16.11 (IN), S17.11 (IN), S18.11 (IN)
MOD0_DBG_!RESET: S14.9 (A); also elsewhere on the board
MOD0_DBG_SWDCLK: S14.3 (A); also elsewhere on the board
MOD0_DBG_SWDIO: S14.2 (A); also elsewhere on the board
MOD0_VCCIO: S14.10 (A); also elsewhere on the board
MOD1_DBG_!RESET: S15.9 (A); also elsewhere on the board
MOD1_DBG_SWDCLK: S15.3 (A); also elsewhere on the board
MOD1_DBG_SWDIO: S15.2 (A); also elsewhere on the board
MOD1_VCCIO: S15.10 (A); also elsewhere on the board
unnamed: LED6.A (ANODE), R32.1
unnamed: LED5.A (ANODE), R31.1
unnamed: LED7.A (ANODE), R33.1
unnamed: LED8.A (ANODE), R34.1
unnamed: LED9.A (ANODE), R35.1
PROG0_EN: R26.2, R31.2, S11.1 (A), S14.5 (CTRL), S14.6 (CTRL), S14.12 (CTRL), S14.13 (CTRL)
PROG1_EN: R27.2, R32.2, S11.2 (B), S15.5 (CTRL), S15.6 (CTRL), S15.12 (CTRL), S15.13 (CTRL)
PROG2_EN: R28.2, R33.2, S11.3 (C), S16.5 (CTRL), S16.6 (CTRL), S16.12 (CTRL), S16.13 (CTRL)
PROG3_EN: R29.2, R34.2, S11.4 (D), S17.5 (CTRL), S17.6 (CTRL), S17.12 (CTRL), S17.13 (CTRL)
PROG4_EN: R30.2, R35.2, S11.5 (E), S18.5 (CTRL), S18.6 (CTRL), S18.12 (CTRL), S18.13 (CTRL)
RADIO_!RESET: S16.9 (A); also elsewhere on the board
RADIO_SWDCLK: S16.3 (A); also elsewhere on the board
RADIO_SWDIO: S16.2 (A); also elsewhere on the board

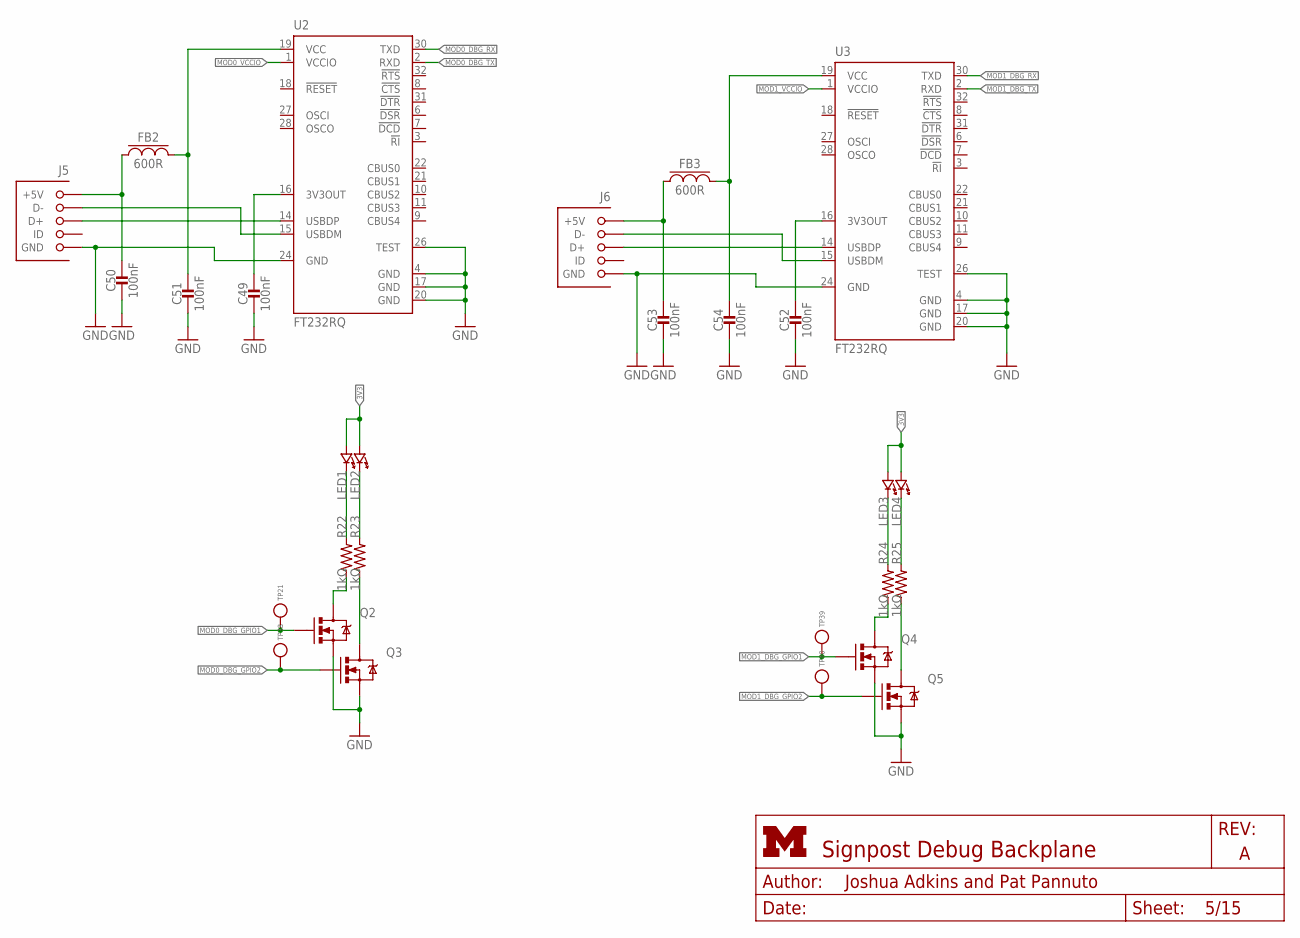
[picture p73: schematic debug_backplane.sch, sheet 5]

Parts:
C49, C50, C51, C52, C53, C54: 100nF; 0603_CAP
FB2, FB3: 600R; 0603_CAP
J5, J6: MICRO_USB_B_HIROSE_ZX62R-B-5P; USB_MICRO_B-HIROSE-ZX62R-B-5P
LED1, LED2, LED3, LED4: LED0603; LED-0603
Q2, Q3, Q4, Q5: MOSFET-NCHANNELSMD; SOT23-3
R22, R23, R24, R25: 1kΩ; 0603-RES
TP21, TP38, TP39, TP40: TEST_POINT_0.040IN; TESTPOINT_0.040IN
U2, U3: FT232RQ; QFN32

Connections:
3V3: LED1.A (ANODE), LED2.A (ANODE), LED3.A (ANODE), LED4.A (ANODE); also elsewhere on the board
GND: C49.2, C50.2, C51.2, C52.2, C53.2, C54.2, J5.5 (GND), J6.5 (GND), Q2.2 (S), Q3.2 (S), Q4.2 (S), Q5.2 (S), U2.4 (GND), U2.17 (GND), U2.20 (GND), U2.24 (GND), U2.26 (TEST), U3.4 (GND), U3.17 (GND), U3.20 (GND), U3.24 (GND), U3.26 (TEST); also elsewhere on the board
MOD0_DBG_GPIO1: Q2.1 (G), TP21.TESTPOINT; also elsewhere on the board
MOD0_DBG_GPIO2: Q3.1 (G), TP38.TESTPOINT; also elsewhere on the board
MOD0_DBG_RX: U2.30 (TXD); also elsewhere on the board
MOD0_DBG_TX: U2.2 (RXD); also elsewhere on the board
MOD0_VCCIO: U2.1 (VCCIO); also elsewhere on the board
MOD1_DBG_GPIO1: Q4.1 (G), TP39.TESTPOINT; also elsewhere on the board
MOD1_DBG_GPIO2: Q5.1 (G), TP40.TESTPOINT; also elsewhere on the board
MOD1_DBG_RX: U3.30 (TXD); also elsewhere on the board
MOD1_DBG_TX: U3.2 (RXD); also elsewhere on the board
MOD1_VCCIO: U3.1 (VCCIO); also elsewhere on the board
unnamed: LED1.C (CATHODE), R22.2
unnamed: LED2.C (CATHODE), R23.2
unnamed: Q2.3 (D), R22.1
unnamed: Q3.3 (D), R23.1
unnamed: LED3.C (CATHODE), R24.2
unnamed: LED4.C (CATHODE), R25.2
unnamed: Q4.3 (D), R24.1
unnamed: Q5.3 (D), R25.1
unnamed: J5.2 (D-), U2.15 (USBDM)
unnamed: J5.3 (D+), U2.14 (USBDP)
unnamed: C50.1, FB2.1, J5.1 (+5V)
unnamed: C51.1, FB2.2, U2.19 (VCC)
unnamed: C49.1, U2.16 (3V3OUT)
unnamed: J6.2 (D-), U3.15 (USBDM)
unnamed: J6.3 (D+), U3.14 (USBDP)
unnamed: C53.1, FB3.1, J6.1 (+5V)
unnamed: C54.1, FB3.2, U3.19 (VCC)
unnamed: C52.1, U3.16 (3V3OUT)

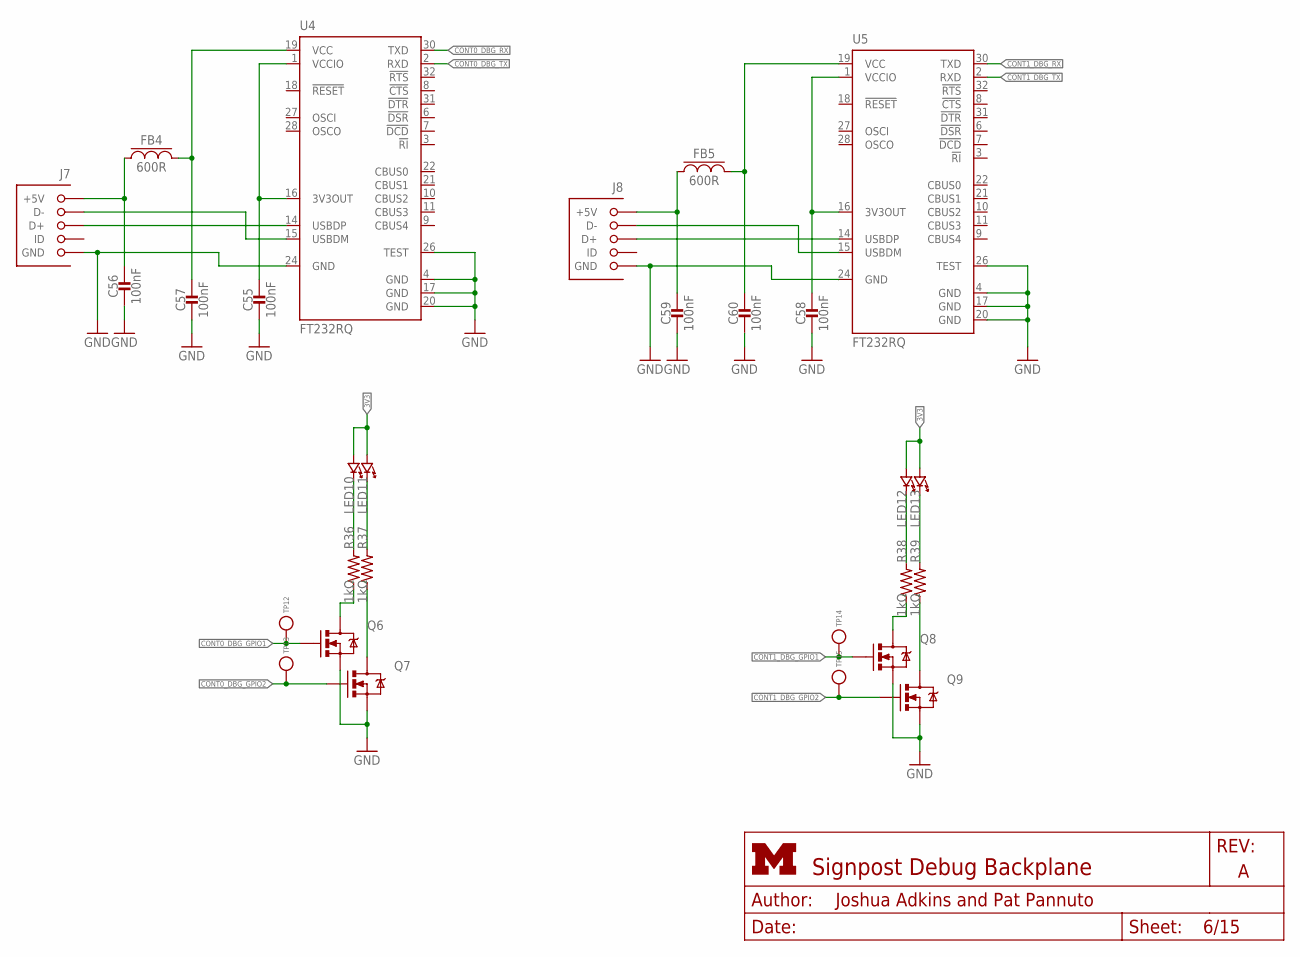
[picture p74: schematic debug_backplane.sch, sheet 6]

Parts:
C55, C56, C57, C58, C59, C60: 100nF; 0603_CAP
FB4, FB5: 600R; 0603_CAP
J7, J8: MICRO_USB_B_HIROSE_ZX62R-B-5P; USB_MICRO_B-HIROSE-ZX62R-B-5P
LED10, LED11, LED12, LED13: LED0603; LED-0603
Q6, Q7, Q8, Q9: MOSFET-NCHANNELSMD; SOT23-3
R36, R37, R38, R39: 1kΩ; 0603-RES
TP12, TP13, TP14, TP15: TEST_POINT_0.040IN; TESTPOINT_0.040IN
U4, U5: FT232RQ; QFN32

Connections:
3V3: LED10.A (ANODE), LED11.A (ANODE), LED12.A (ANODE), LED13.A (ANODE); also elsewhere on the board
CONT0_DBG_GPIO1: Q6.1 (G), TP12.TESTPOINT; also elsewhere on the board
CONT0_DBG_GPIO2: Q7.1 (G), TP13.TESTPOINT; also elsewhere on the board
CONT0_DBG_RX: U4.30 (TXD); also elsewhere on the board
CONT0_DBG_TX: U4.2 (RXD); also elsewhere on the board
CONT0_VCCIO: C55.1, U4.1 (VCCIO), U4.16 (3V3OUT)
CONT1_DBG_GPIO1: Q8.1 (G), TP14.TESTPOINT; also elsewhere on the board
CONT1_DBG_GPIO2: Q9.1 (G), TP15.TESTPOINT; also elsewhere on the board
CONT1_DBG_RX: U5.30 (TXD); also elsewhere on the board
CONT1_DBG_TX: U5.2 (RXD); also elsewhere on the board
CONT1_VCCIO: C58.1, U5.1 (VCCIO), U5.16 (3V3OUT)
GND: C55.2, C56.2, C57.2, C58.2, C59.2, C60.2, J7.5 (GND), J8.5 (GND), Q6.2 (S), Q7.2 (S), Q8.2 (S), Q9.2 (S), U4.4 (GND), U4.17 (GND), U4.20 (GND), U4.24 (GND), U4.26 (TEST), U5.4 (GND), U5.17 (GND), U5.20 (GND), U5.24 (GND), U5.26 (TEST); also elsewhere on the board
unnamed: J7.2 (D-), U4.15 (USBDM)
unnamed: J7.3 (D+), U4.14 (USBDP)
unnamed: C56.1, FB4.1, J7.1 (+5V)
unnamed: C57.1, FB4.2, U4.19 (VCC)
unnamed: J8.2 (D-), U5.15 (USBDM)
unnamed: J8.3 (D+), U5.14 (USBDP)
unnamed: C59.1, FB5.1, J8.1 (+5V)
unnamed: C60.1, FB5.2, U5.19 (VCC)
unnamed: LED10.C (CATHODE), R36.2
unnamed: LED11.C (CATHODE), R37.2
unnamed: Q6.3 (D), R36.1
unnamed: Q7.3 (D), R37.1
unnamed: LED12.C (CATHODE), R38.2
unnamed: LED13.C (CATHODE), R39.2
unnamed: Q8.3 (D), R38.1
unnamed: Q9.3 (D), R39.1

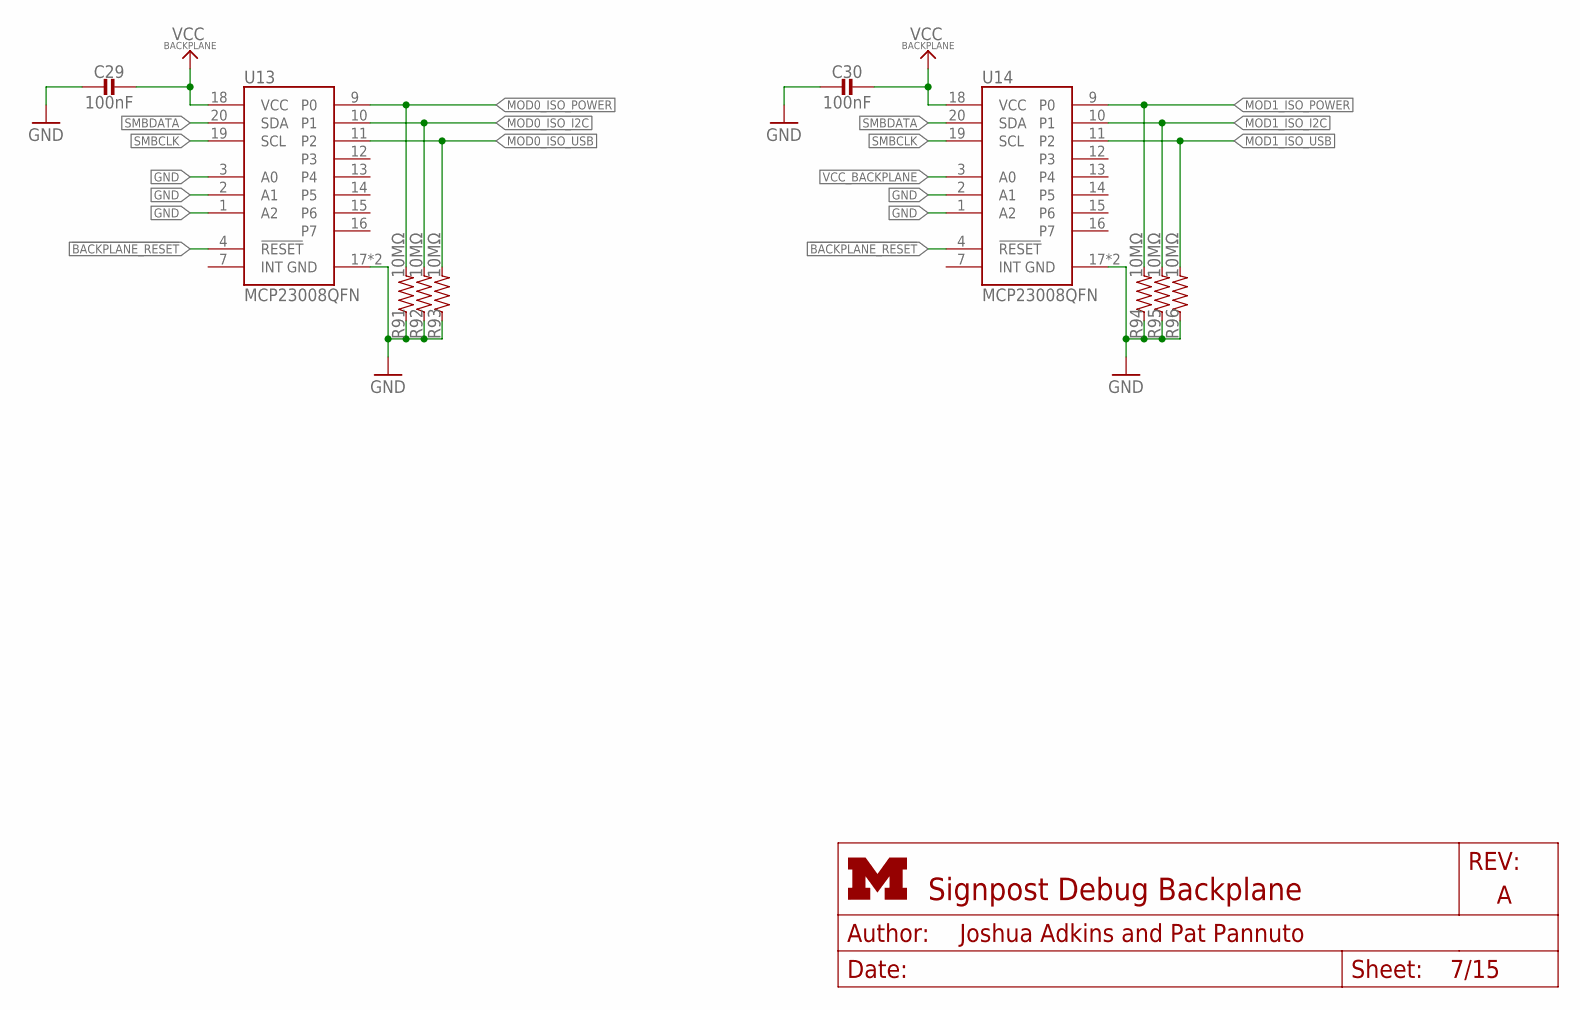
[picture p75: schematic debug_backplane.sch, sheet 7]

Parts:
C29, C30: 100nF; 0603_CAP
R91, R92, R93, R94, R95, R96: 10MΩ; 0603-RES
U13, U14: MCP23008QFN; QFN-20-4MM

Connections:
!BACKPLANE_RESET: U13.4 (!RESET), U14.4 (!RESET); also elsewhere on the board
GND: C29.2, C30.2, R91.1, R92.1, R93.1, R94.1, R95.1, R96.1, U13.1 (A2), U13.2 (A1), U13.3 (A0), U13.17 (GND), U13.GND, U14.1 (A2), U14.2 (A1), U14.17 (GND), U14.GND; also elsewhere on the board
MOD0_ISO_I2C: R92.2, U13.10 (P1); also elsewhere on the board
MOD0_ISO_POWER: R91.2, U13.9 (P0); also elsewhere on the board
MOD0_ISO_USB: R93.2, U13.11 (P2); also elsewhere on the board
MOD1_ISO_I2C: R95.2, U14.10 (P1); also elsewhere on the board
MOD1_ISO_POWER: R94.2, U14.9 (P0); also elsewhere on the board
MOD1_ISO_USB: R96.2, U14.11 (P2); also elsewhere on the board
SMBCLK: U13.19 (SCL), U14.19 (SCL); also elsewhere on the board
SMBDATA: U13.20 (SDA), U14.20 (SDA); also elsewhere on the board
VCC_BACKPLANE: C29.1, C30.1, U13.18 (VCC), U14.3 (A0), U14.18 (VCC); also elsewhere on the board

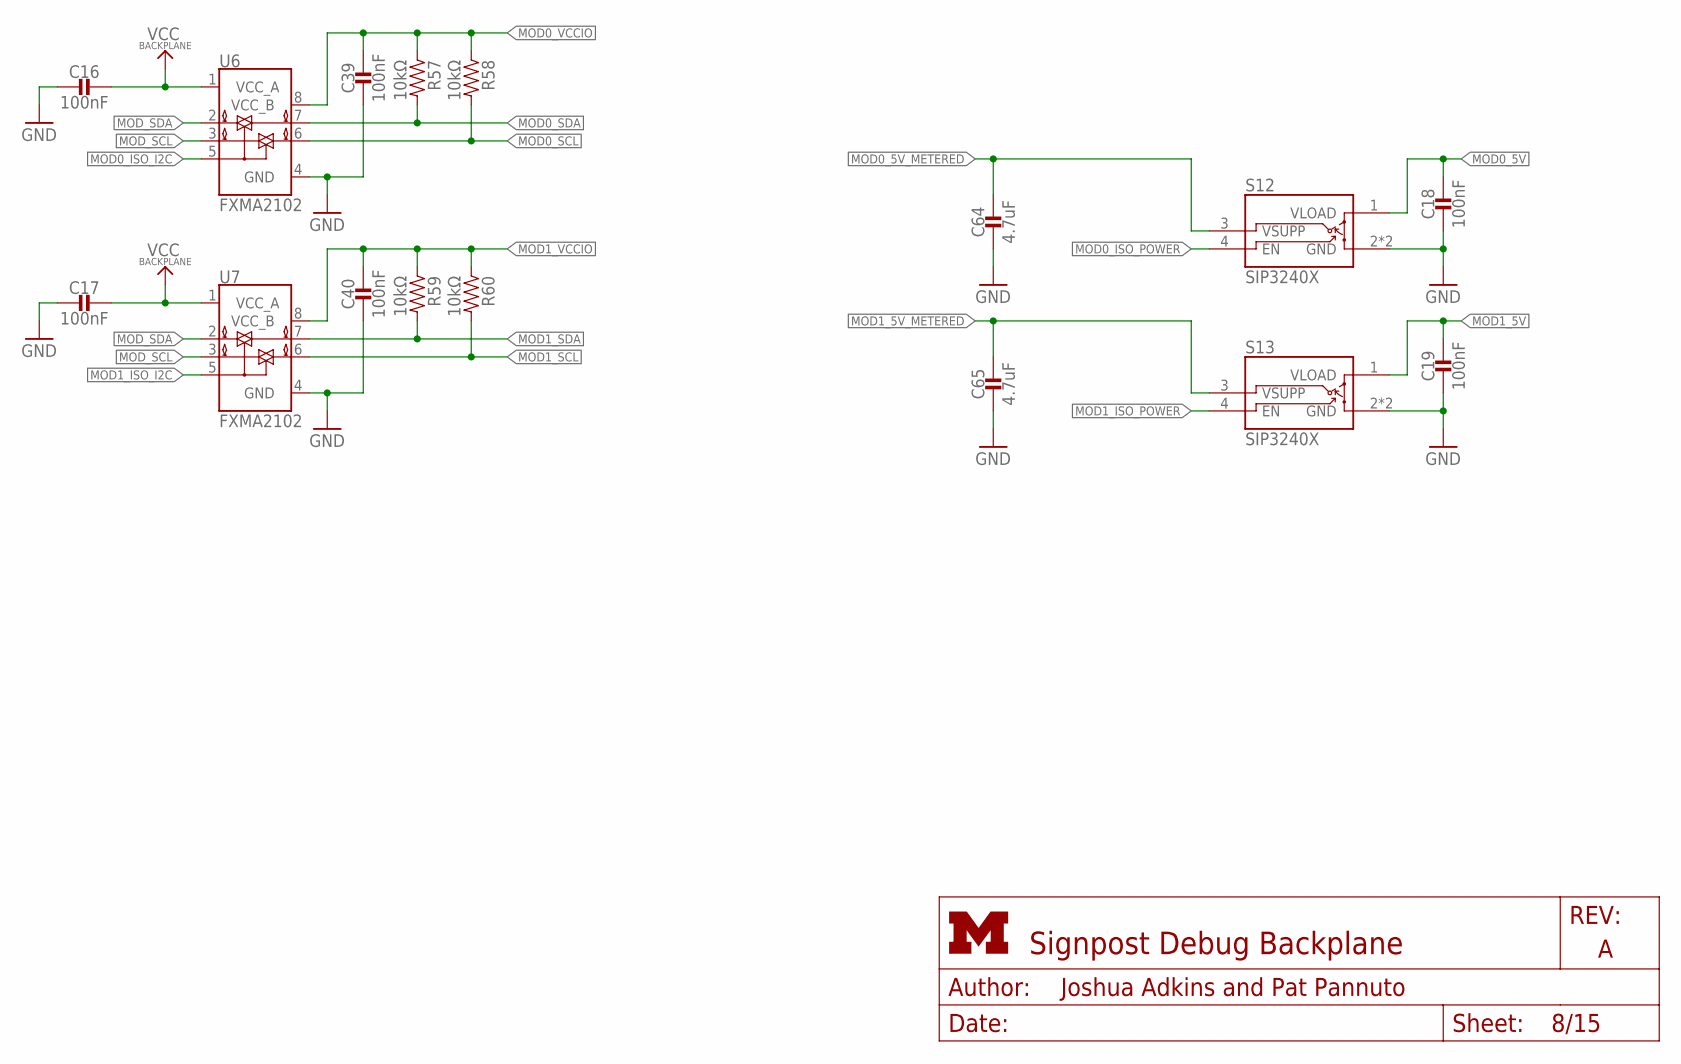
[picture p76: schematic debug_backplane.sch, sheet 8]

Parts:
C16, C17, C18, C19, C39, C40: 100nF; 0603_CAP
C64, C65: 4.7uF; 0603_CAP
R57, R58, R59, R60: 10kΩ; 0603-RES
S12, S13: SIP3240X; TDFN4
U6, U7: FXMA2102; UMLP-8

Connections:
GND: C16.2, C17.2, C18.2, C19.2, C39.2, C40.2, C64.2, C65.2, S12.2 (GND), S12.PAD (GND), S13.2 (GND), S13.PAD (GND), U6.4 (GND), U7.4 (GND); also elsewhere on the board
MOD0_5V: C18.1, S12.1 (VLOAD); also elsewhere on the board
MOD0_5V_METERED: C64.1, S12.3 (VSUPP); also elsewhere on the board
MOD0_ISO_I2C: U6.5 (OE); also elsewhere on the board
MOD0_ISO_POWER: S12.4 (EN); also elsewhere on the board
MOD0_SCL: R58.2, U6.6 (B1); also elsewhere on the board
MOD0_SDA: R57.2, U6.7 (B0); also elsewhere on the board
MOD0_VCCIO: C39.1, R57.1, R58.1, U6.8 (VCC_B); also elsewhere on the board
MOD1_5V: C19.1, S13.1 (VLOAD); also elsewhere on the board
MOD1_5V_METERED: C65.1, S13.3 (VSUPP); also elsewhere on the board
MOD1_ISO_I2C: U7.5 (OE); also elsewhere on the board
MOD1_ISO_POWER: S13.4 (EN); also elsewhere on the board
MOD1_SCL: R60.2, U7.6 (B1); also elsewhere on the board
MOD1_SDA: R59.2, U7.7 (B0); also elsewhere on the board
MOD1_VCCIO: C40.1, R59.1, R60.1, U7.8 (VCC_B); also elsewhere on the board
MOD_SCL: U6.3 (A1), U7.3 (A1); also elsewhere on the board
MOD_SDA: U6.2 (A0), U7.2 (A0); also elsewhere on the board
VCC_BACKPLANE: C16.1, C17.1, U6.1 (VCC_A), U7.1 (VCC_A); also elsewhere on the board

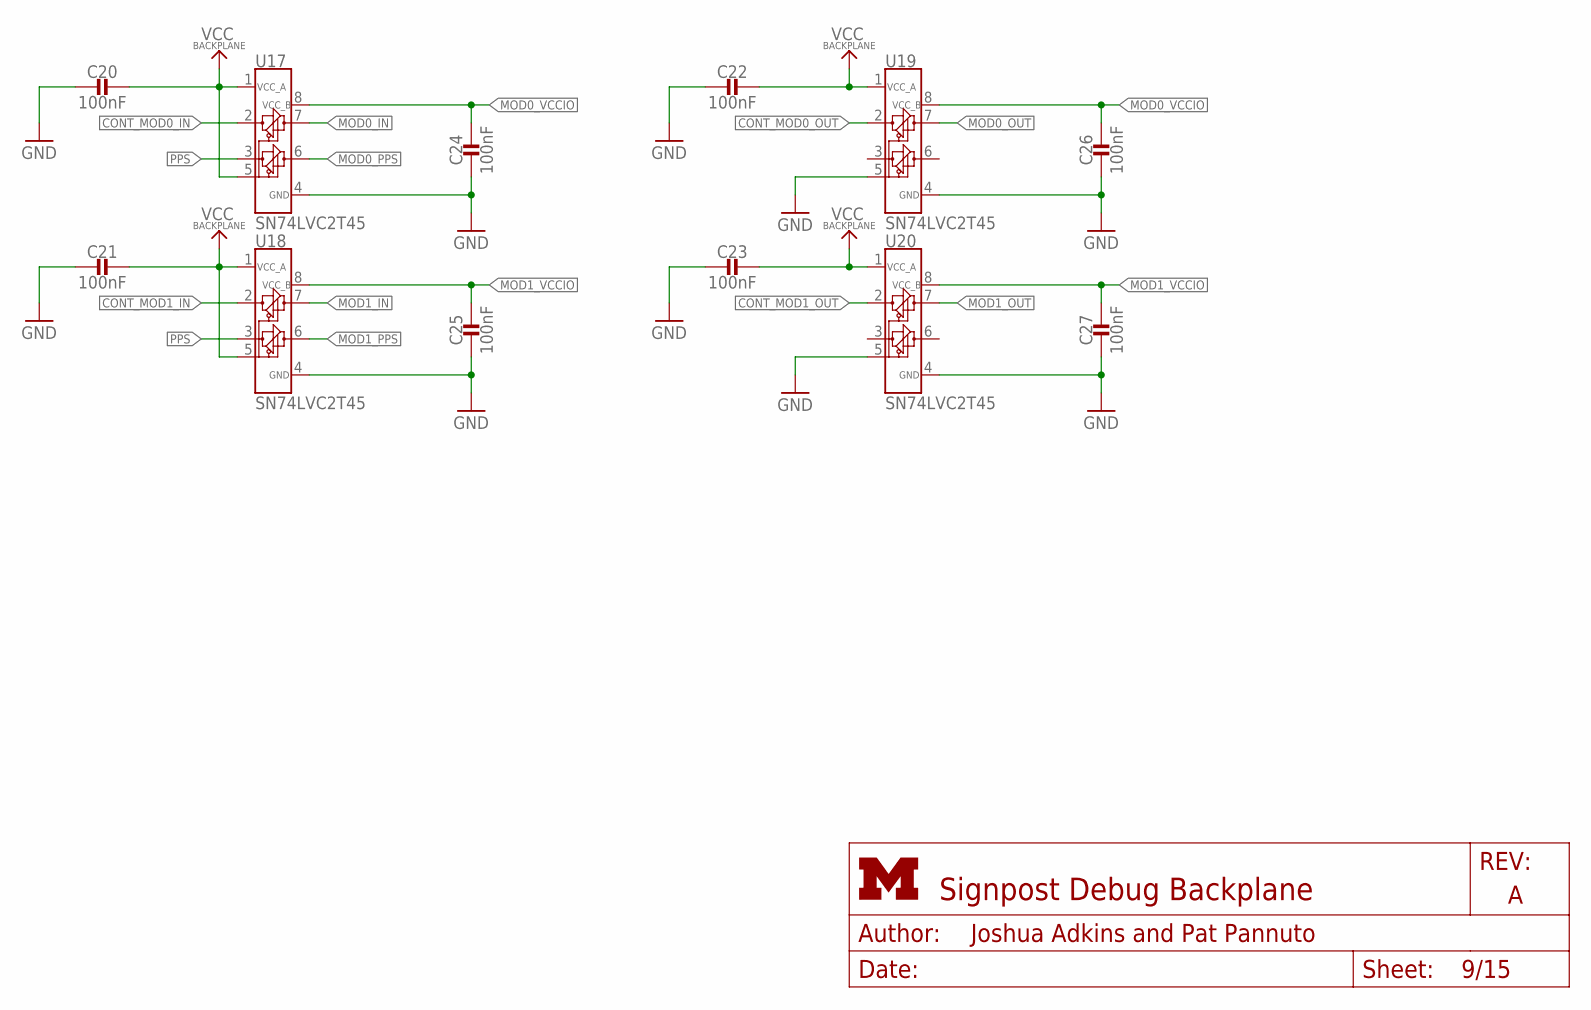
[picture p77: schematic debug_backplane.sch, sheet 9]

Parts:
C20, C21, C22, C23, C24, C25, C26, C27: 100nF; 0603_CAP
U17, U18, U19, U20: SN74LVC2T45; VFSOP-8

Connections:
CONT_MOD0_IN: U17.2 (A1); also elsewhere on the board
CONT_MOD0_OUT: U19.2 (A1); also elsewhere on the board
CONT_MOD1_IN: U18.2 (A1); also elsewhere on the board
CONT_MOD1_OUT: U20.2 (A1); also elsewhere on the board
GND: C20.2, C21.2, C22.2, C23.2, C24.2, C25.2, C26.2, C27.2, U17.4 (GND), U18.4 (GND), U19.4 (GND), U19.5 (DIR), U20.4 (GND), U20.5 (DIR); also elsewhere on the board
MOD0_IN: U17.7 (B1); also elsewhere on the board
MOD0_OUT: U19.7 (B1); also elsewhere on the board
MOD0_PPS: U17.6 (B2); also elsewhere on the board
MOD0_VCCIO: C24.1, C26.1, U17.8 (VCC_B), U19.8 (VCC_B); also elsewhere on the board
MOD1_IN: U18.7 (B1); also elsewhere on the board
MOD1_OUT: U20.7 (B1); also elsewhere on the board
MOD1_PPS: U18.6 (B2); also elsewhere on the board
MOD1_VCCIO: C25.1, C27.1, U18.8 (VCC_B), U20.8 (VCC_B); also elsewhere on the board
PPS: U17.3 (A2), U18.3 (A2); also elsewhere on the board
VCC_BACKPLANE: C20.1, C21.1, C22.1, C23.1, U17.1 (VCC_A), U17.5 (DIR), U18.1 (VCC_A), U18.5 (DIR), U19.1 (VCC_A), U20.1 (VCC_A); also elsewhere on the board

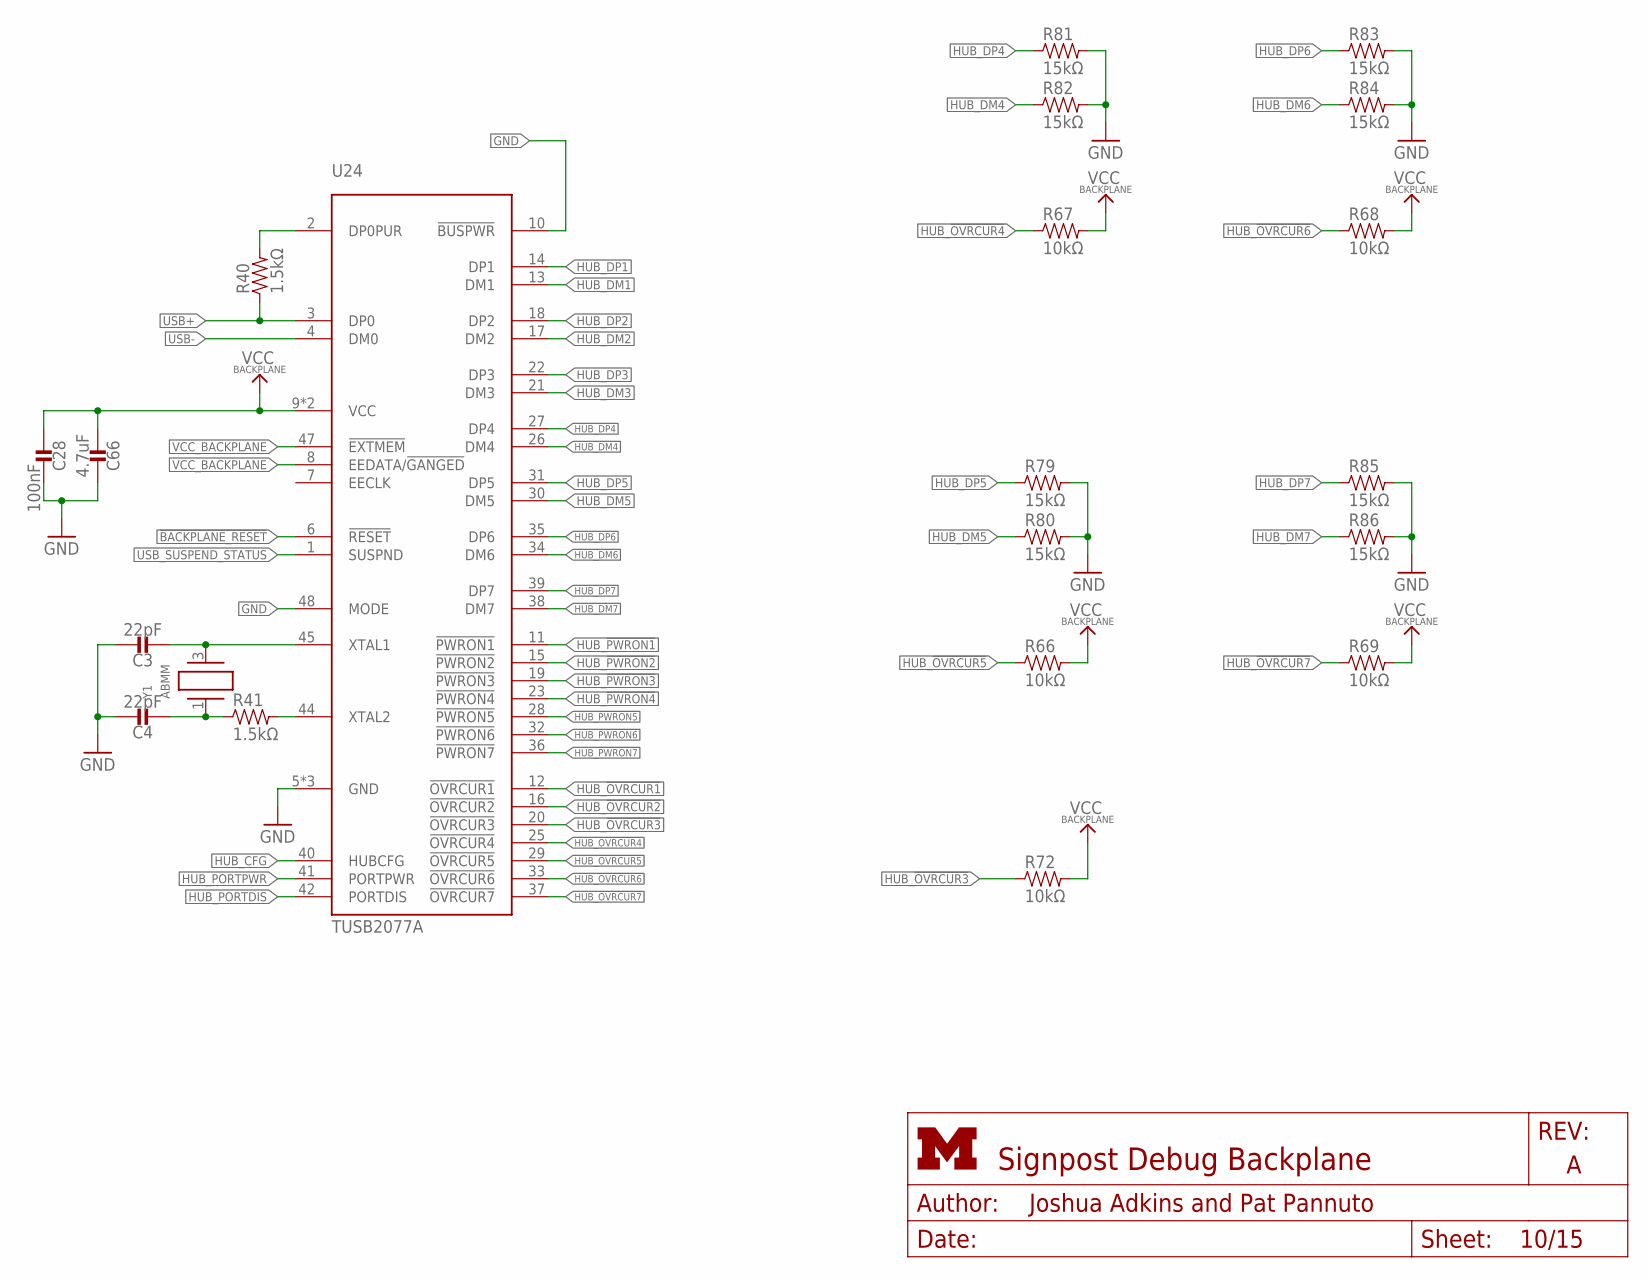
[picture p78: schematic debug_backplane.sch, sheet 10]

Parts:
C3, C4: 22pF; 0603_CAP; DIGIKEY 1276-1023-1-ND
C28: 100nF; 0603_CAP
C66: 4.7uF; 0603_CAP
R40, R41: 1.5kΩ; 0603-RES
R66, R67, R68, R69, R72: 10kΩ; 0603-RES
R79, R80, R81, R82, R83, R84, R85, R86: 15kΩ; 0603-RES
U24: TUSB2077A; LQFP-48
Y1: ABMM

Connections:
!BACKPLANE_RESET: U24.6 (!RESET); also elsewhere on the board
GND: C3.1, C4.1, C28.1, C66.1, R79.2, R80.2, R81.2, R82.2, R83.2, R84.2, R85.2, R86.2, U24.5 (GND), U24.10 (!BUSPWR), U24.24 (GND), U24.43 (GND), U24.48 (MODE); also elsewhere on the board
HUB_!OVRCUR1: U24.12 (!OVRCUR1); also elsewhere on the board
HUB_!OVRCUR2: U24.16 (!OVRCUR2); also elsewhere on the board
HUB_!OVRCUR3: R72.1, U24.20 (!OVRCUR3); also elsewhere on the board
HUB_!OVRCUR4: R67.1, U24.25 (!OVRCUR4)
HUB_!OVRCUR5: R66.1, U24.29 (!OVRCUR5)
HUB_!OVRCUR6: R68.1, U24.33 (!OVRCUR6)
HUB_!OVRCUR7: R69.1, U24.37 (!OVRCUR7)
HUB_!PWRON1: U24.11 (!PWRON1); also elsewhere on the board
HUB_!PWRON2: U24.15 (!PWRON2); also elsewhere on the board
HUB_!PWRON3: U24.19 (!PWRON3); also elsewhere on the board
HUB_!PWRON4: U24.23 (!PWRON4)
HUB_!PWRON5: U24.28 (!PWRON5)
HUB_!PWRON6: U24.32 (!PWRON6)
HUB_!PWRON7: U24.36 (!PWRON7)
HUB_CFG: U24.40 (HUBCFG); also elsewhere on the board
HUB_DM1: U24.13 (DM1); also elsewhere on the board
HUB_DM2: U24.17 (DM2); also elsewhere on the board
HUB_DM3: U24.21 (DM3); also elsewhere on the board
HUB_DM4: R82.1, U24.26 (DM4)
HUB_DM5: R80.1, U24.30 (DM5)
HUB_DM6: R84.1, U24.34 (DM6)
HUB_DM7: R86.1, U24.38 (DM7)
HUB_DP1: U24.14 (DP1); also elsewhere on the board
HUB_DP2: U24.18 (DP2); also elsewhere on the board
HUB_DP3: U24.22 (DP3); also elsewhere on the board
HUB_DP4: R81.1, U24.27 (DP4)
HUB_DP5: R79.1, U24.31 (DP5)
HUB_DP6: R83.1, U24.35 (DP6)
HUB_DP7: R85.1, U24.39 (DP7)
HUB_PORTDIS: U24.42 (PORTDIS); also elsewhere on the board
HUB_PORTPWR: U24.41 (PORTPWR); also elsewhere on the board
unnamed: R40.2, U24.2 (DP0PUR)
unnamed: C4.2, R41.1, Y1.1
unnamed: C3.2, U24.45 (XTAL1), Y1.3 (2)
unnamed: R41.2, U24.44 (XTAL2)
USB+: R40.1, U24.3 (DP0); also elsewhere on the board
USB-: U24.4 (DM0); also elsewhere on the board
USB_SUSPEND_STATUS: U24.1 (SUSPND); also elsewhere on the board
VCC_BACKPLANE: C28.2, C66.2, R66.2, R67.2, R68.2, R69.2, R72.2, U24.8 (EEDATA/!GANGED), U24.9 (VCC), U24.46 (VCC), U24.47 (!EXTMEM); also elsewhere on the board

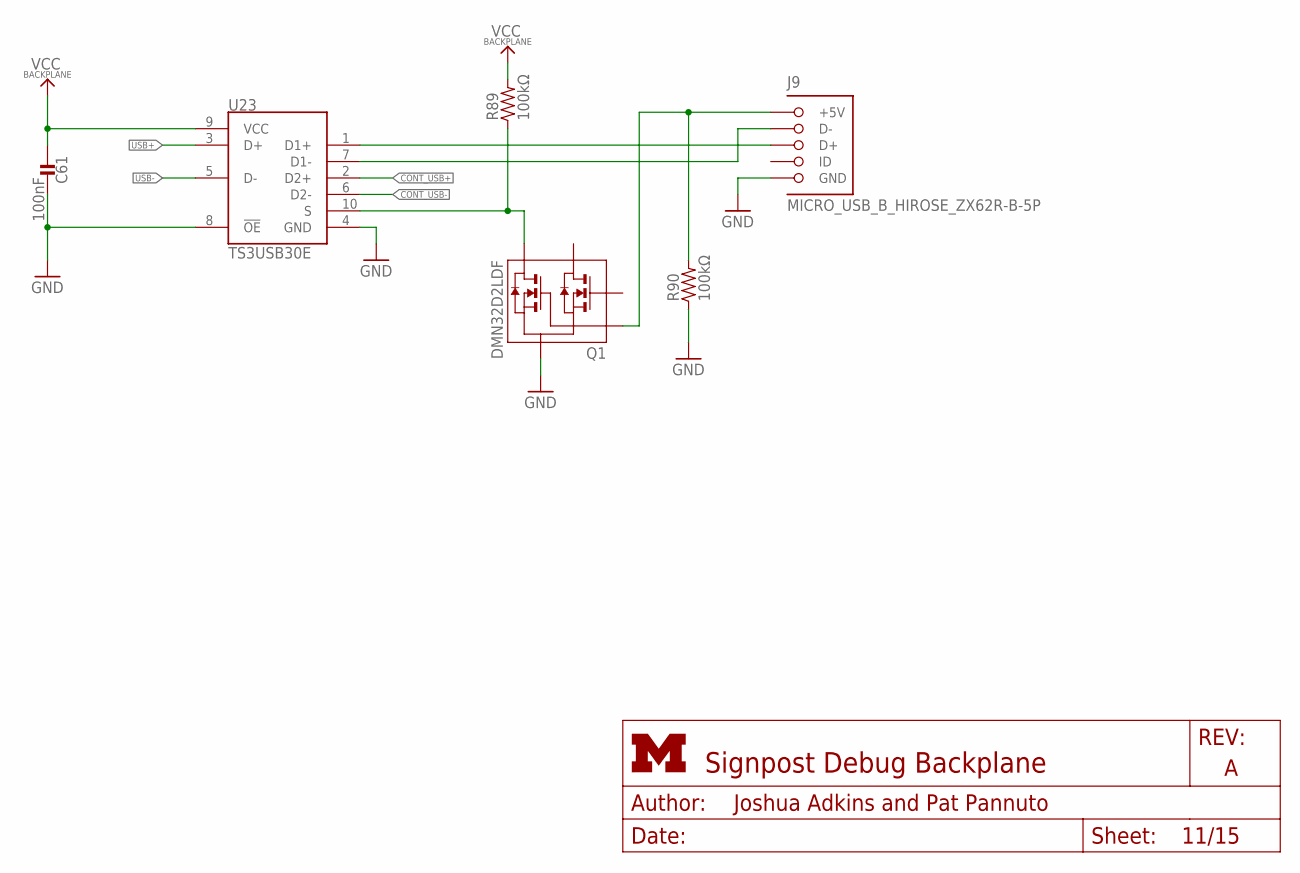
[picture p79: schematic debug_backplane.sch, sheet 11]

Parts:
C61: 100nF; 0603_CAP
J9: MICRO_USB_B_HIROSE_ZX62R-B-5P; USB_MICRO_B-HIROSE-ZX62R-B-5P
Q1: DMN32D2LDF; SOT353
R89, R90: 100kΩ; 0603-RES
U23: TS3USB30E; UQFN-10

Connections:
CONT_USB+: U23.2 (D2+); also elsewhere on the board
CONT_USB-: U23.6 (D2-); also elsewhere on the board
GND: C61.1, J9.5 (GND), Q1.S, R90.1, U23.4 (GND), U23.8 (!OE); also elsewhere on the board
unnamed: J9.1 (+5V), Q1.G2, R90.2
unnamed: Q1.D2, R89.1, U23.10 (S)
unnamed: J9.3 (D+), U23.1 (D1+)
unnamed: J9.2 (D-), U23.7 (D1-)
USB+: U23.3 (D+); also elsewhere on the board
USB-: U23.5 (D-); also elsewhere on the board
VCC_BACKPLANE: C61.2, R89.2, U23.9 (VCC); also elsewhere on the board
