lab11/signpost/hardware/debug_backplane/rev_a/debug_backplane.brd

## EAGLE design hardware/debug_backplane/rev_a/debug_backplane.brd (continued)

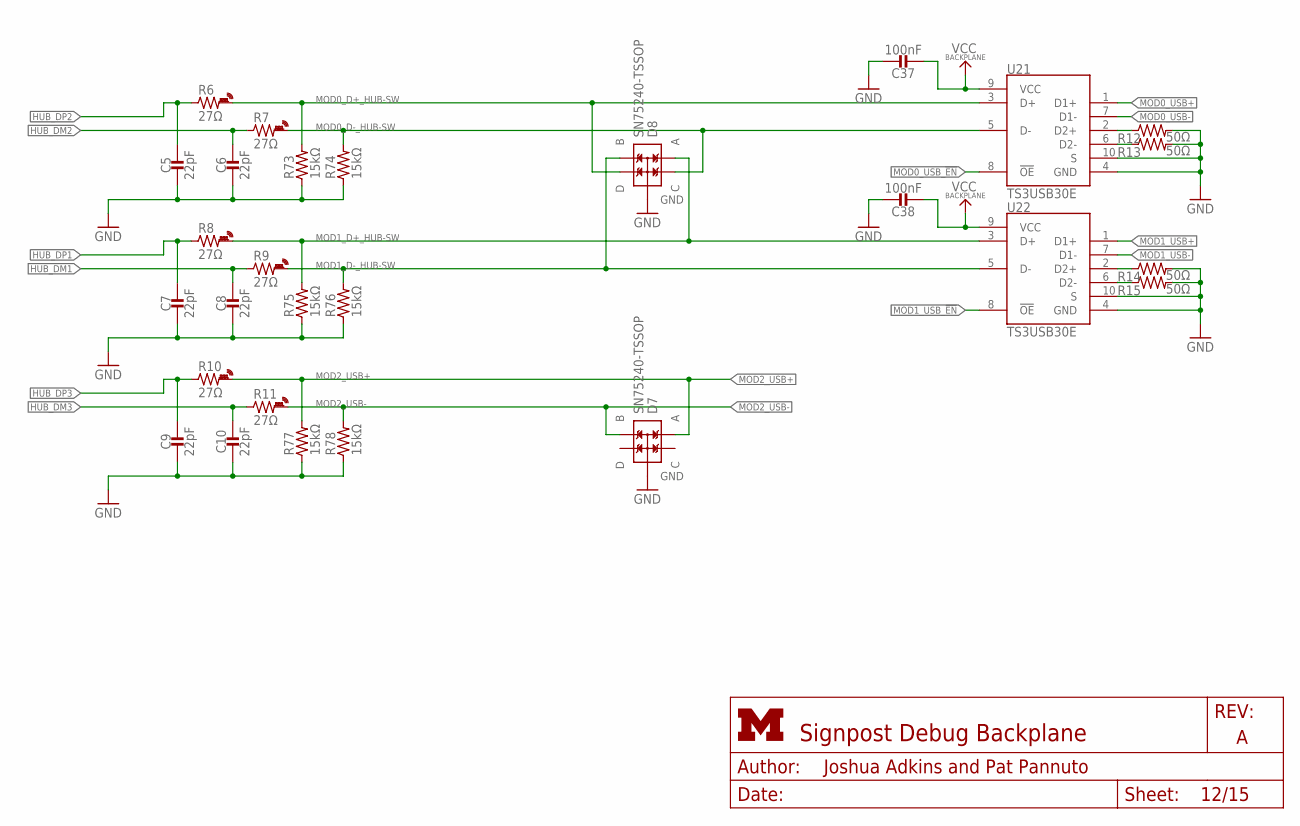
[picture p80: schematic debug_backplane.sch, sheet 12]

Parts:
C5, C6, C7, C8, C9, C10: 22pF; 0402_CAP
C37, C38: 100nF; 0603_CAP
D7, D8: SN75240-TSSOP; TSSOP-8
R6, R7, R8, R9, R10, R11: 27Ω; 0402_RES-HIGH_SPEED
R12, R13, R14, R15: 50Ω; 0603-RES
R73, R74, R75, R76, R77, R78: 15kΩ; 0603-RES
U21, U22: TS3USB30E; UQFN-10

Connections:
GND: C5.2, C6.2, C7.2, C8.2, C9.2, C10.2, C37.1, C38.1, D7.1 (GND), D7.3 (GND), D7.5 (GND), D7.7 (GND), D8.1 (GND), D8.3 (GND), D8.5 (GND), D8.7 (GND), R12.2, R13.2, R14.2, R15.2, R73.1, R74.1, R75.1, R76.1, R77.1, R78.1, U21.4 (GND), U21.10 (S), U22.4 (GND), U22.10 (S); also elsewhere on the board
HUB_DM1: C8.1, R9.2; also elsewhere on the board
HUB_DM2: C6.1, R7.2; also elsewhere on the board
HUB_DM3: C10.1, R11.2; also elsewhere on the board
HUB_DP1: C7.1, R8.2; also elsewhere on the board
HUB_DP2: C5.1, R6.2; also elsewhere on the board
HUB_DP3: C9.1, R10.2; also elsewhere on the board
MOD0_D+_HUB-SW: D8.4 (D), R6.1, R73.2, U21.3 (D+)
MOD0_D-_HUB-SW: D8.2 (C), R7.1, R74.2, U21.5 (D-)
MOD0_USB+: U21.1 (D1+); also elsewhere on the board
MOD0_USB-: U21.7 (D1-); also elsewhere on the board
MOD0_USB_!EN: U21.8 (!OE); also elsewhere on the board
MOD1_D+_HUB-SW: D8.8 (A), R8.1, R75.2, U22.3 (D+)
MOD1_D-_HUB-SW: D8.6 (B), R9.1, R76.2, U22.5 (D-)
MOD1_USB+: U22.1 (D1+); also elsewhere on the board
MOD1_USB-: U22.7 (D1-); also elsewhere on the board
MOD1_USB_!EN: U22.8 (!OE); also elsewhere on the board
MOD2_USB+: D7.8 (A), R10.1, R77.2; also elsewhere on the board
MOD2_USB-: D7.6 (B), R11.1, R78.2; also elsewhere on the board
unnamed: R12.1, U21.2 (D2+)
unnamed: R15.1, U22.6 (D2-)
unnamed: R14.1, U22.2 (D2+)
unnamed: R13.1, U21.6 (D2-)
VCC_BACKPLANE: C37.2, C38.2, U21.9 (VCC), U22.9 (VCC); also elsewhere on the board

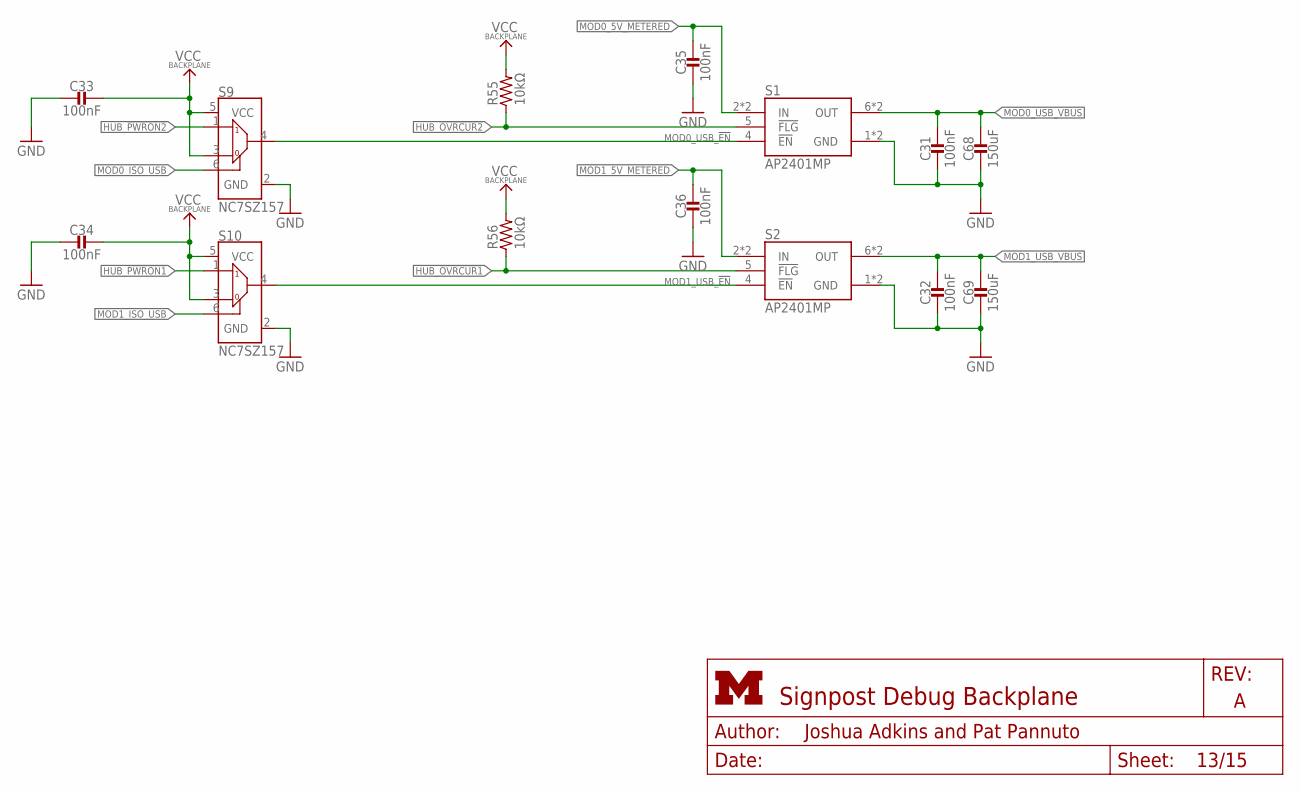
[picture p81: schematic debug_backplane.sch, sheet 13]

Parts:
C31, C32, C33, C34, C35, C36: 100nF; 0603_CAP
C68, C69: 150uF; 1210_CAP; DIGIKEY 1276-3367-1-ND
R55, R56: 10kΩ; 0603-RES
S1, S2: AP2401MP; MSOP-8EP
S9, S10: NC7SZ157; SC70-6

Connections:
GND: C31.2, C32.2, C33.2, C34.2, C35.2, C36.2, C68.2, C69.2, S1.1 (GND), S1.PAD (GND), S2.1 (GND), S2.PAD (GND), S9.2 (GND), S10.2 (GND); also elsewhere on the board
HUB_!OVRCUR1: R56.1, S2.5 (!FLG); also elsewhere on the board
HUB_!OVRCUR2: R55.1, S1.5 (!FLG); also elsewhere on the board
HUB_!PWRON1: S10.1 (I1); also elsewhere on the board
HUB_!PWRON2: S9.1 (I1); also elsewhere on the board
MOD0_5V_METERED: C35.1, S1.2 (IN), S1.3 (IN); also elsewhere on the board
MOD0_ISO_USB: S9.6 (S); also elsewhere on the board
MOD0_USB_!EN: S1.4 (!EN), S9.4 (Z); also elsewhere on the board
MOD0_USB_VBUS: C31.1, C68.1, S1.6 (OUT), S1.7 (OUT); also elsewhere on the board
MOD1_5V_METERED: C36.1, S2.2 (IN), S2.3 (IN); also elsewhere on the board
MOD1_ISO_USB: S10.6 (S); also elsewhere on the board
MOD1_USB_!EN: S2.4 (!EN), S10.4 (Z); also elsewhere on the board
MOD1_USB_VBUS: C32.1, C69.1, S2.6 (OUT), S2.7 (OUT); also elsewhere on the board
VCC_BACKPLANE: C33.1, C34.1, R55.2, R56.2, S9.3 (I0), S9.5 (VCC), S10.3 (I0), S10.5 (VCC); also elsewhere on the board

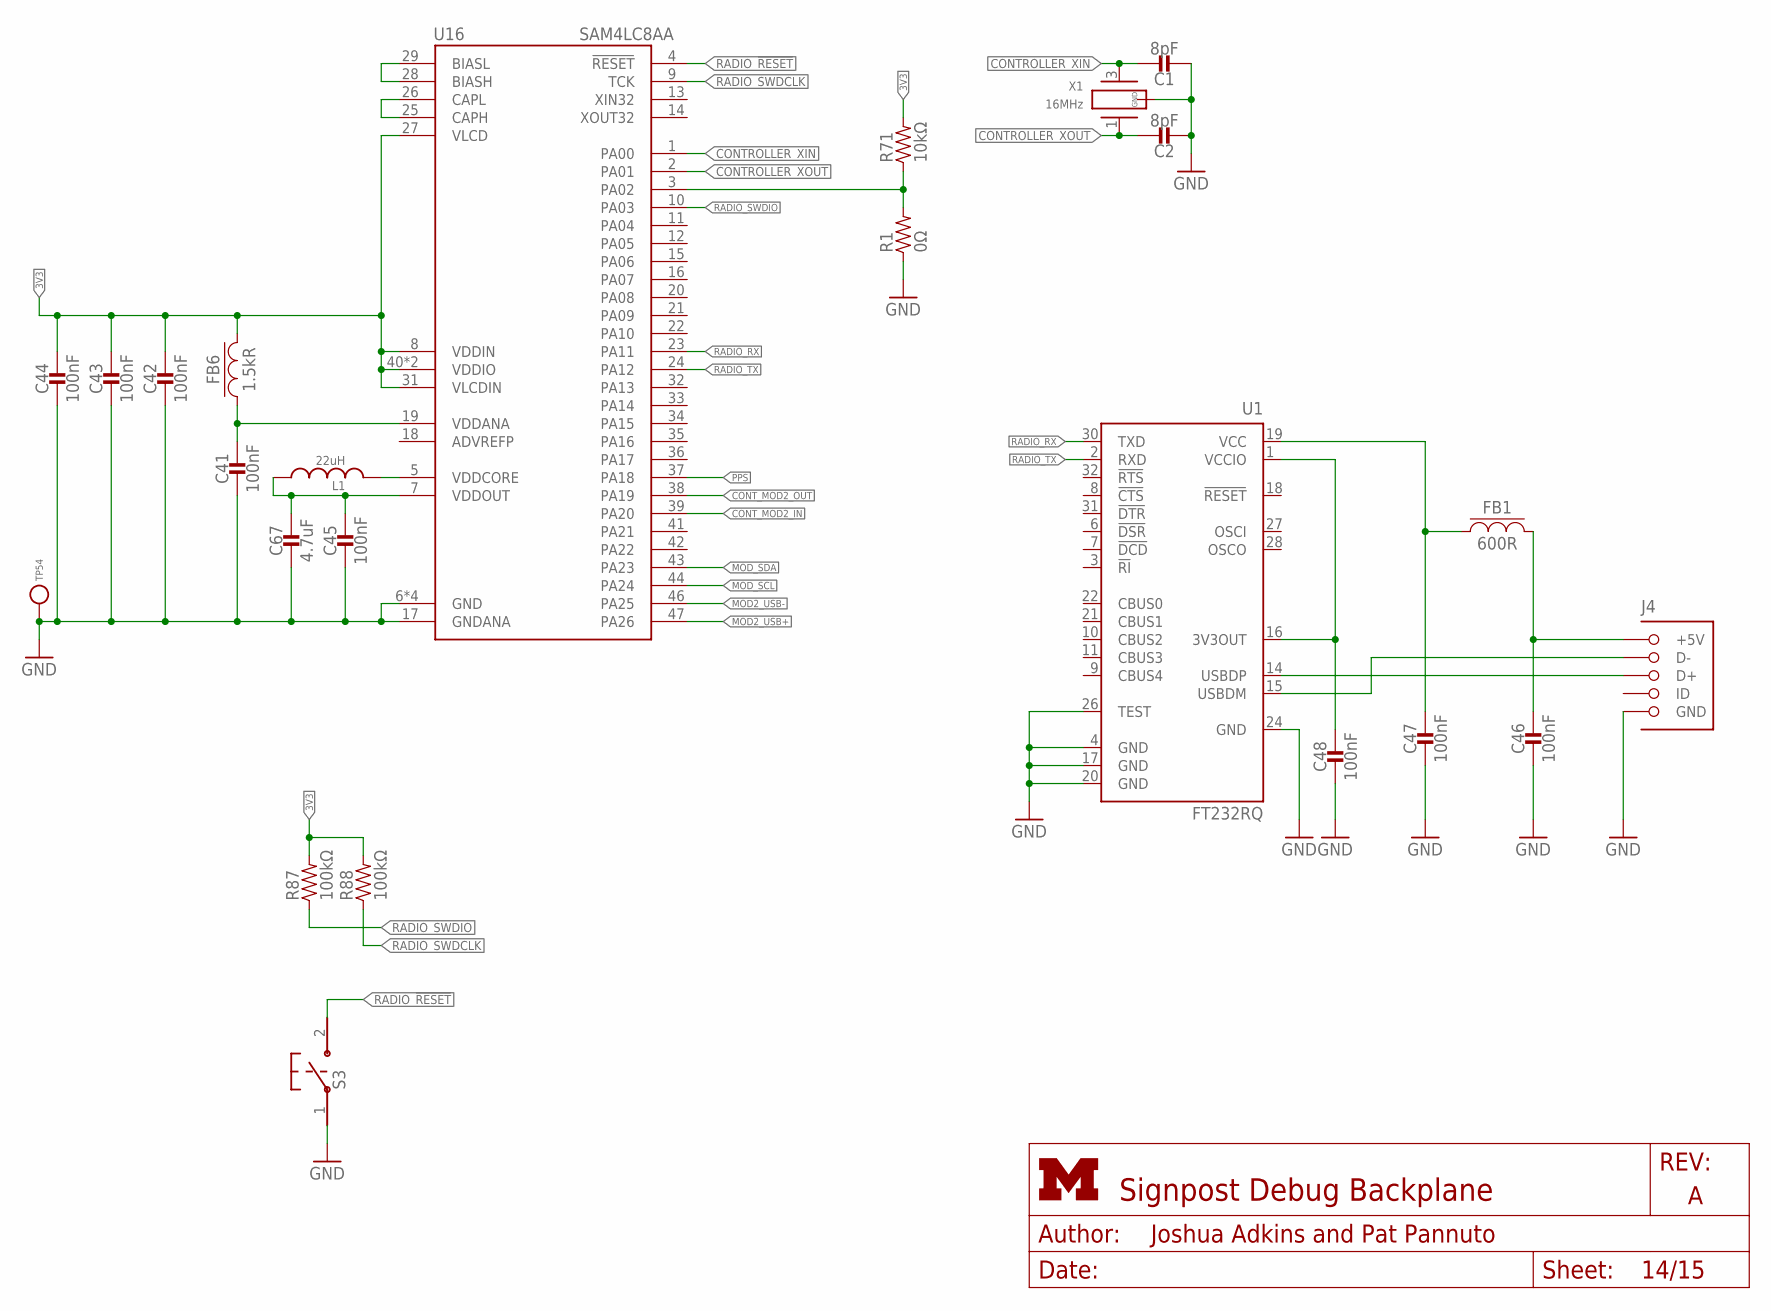
[picture p82: schematic debug_backplane.sch, sheet 14]

Parts:
C1, C2: 8pF; 0603_CAP; DIGIKEY 490-8230-1-ND
C41, C42, C43, C44, C46, C47, C48: 100nF; 0603_CAP; DIGIKEY 490-10777-1-ND
C45: 100nF; 0402_CAP; DIGIKEY 490-10777-1-ND
C67: 4.7uF; 0402_CAP; DIGIKEY 490-13252-1-ND
FB1: 600R; 0603_CAP
FB6: 1.5kR; 0603_CAP; DIGIKEY 490-5216-1-ND
J4: MICRO_USB_B_HIROSE_ZX62R-B-5P; USB_MICRO_B-HIROSE-ZX62R-B-5P
L1: 22uH; 1212
R1: 0Ω; 0603-RES; DIGIKEY 1276-3431-1-ND
R71: 10kΩ; 0603-RES; DIGIKEY 1276-3431-1-ND
R87, R88: 100kΩ; 0603-RES; DIGIKEY 1276-3432-1-ND
S3: B3U-1000P
TP54: TEST_POINT_0.040IN; TESTPOINT_0.040IN
U1: FT232RQ; QFN32
U16: SAM4LC8AA; QFN-48-7MM
X1: 16MHz; FHXXX

Connections:
3V3: C42.1, C43.1, C44.1, FB6.2, R71.2, R87.2, R88.2, U16.8 (VDDIN), U16.27 (VLCD), U16.31 (VLCDIN), U16.40 (VDDIO), U16.45 (VDDIO); also elsewhere on the board
CONTROLLER_BUCK/LDO_N: R1.2, R71.1, U16.3 (PA02)
CONTROLLER_XIN: C1.1, U16.1 (PA00), X1.3 (2)
CONTROLLER_XOUT: C2.1, U16.2 (PA01), X1.1
CONT_MOD2_IN: U16.39 (PA20); also elsewhere on the board
CONT_MOD2_OUT: U16.38 (PA19); also elsewhere on the board
GND: C1.2, C2.2, C41.2, C42.2, C43.2, C44.2, C45.2, C46.2, C47.2, C48.2, C67.2, J4.5 (GND), R1.1, S3.1, TP54.TESTPOINT, U1.4 (GND), U1.17 (GND), U1.20 (GND), U1.24 (GND), U1.26 (TEST), U16.6 (GND), U16.17 (GNDANA), U16.30 (GND), U16.48 (GND), U16.THERMAL (GND), X1.2 (GND), X1.4 (GND); also elsewhere on the board
MOD2_USB+: U16.47 (PA26); also elsewhere on the board
MOD2_USB-: U16.46 (PA25); also elsewhere on the board
MOD_SCL: U16.44 (PA24); also elsewhere on the board
MOD_SDA: U16.43 (PA23); also elsewhere on the board
unnamed: C41.1, FB6.1, U16.19 (VDDANA)
unnamed: L1.P$2 (2), U16.5 (VDDCORE)
unnamed: U16.28 (BIASH), U16.29 (BIASL)
unnamed: U16.25 (CAPH), U16.26 (CAPL)
unnamed: J4.2 (D-), U1.15 (USBDM)
unnamed: C45.1, C67.1, L1.P$1 (1), U16.7 (VDDOUT)
unnamed: J4.3 (D+), U1.14 (USBDP)
unnamed: C46.1, FB1.2, J4.1 (+5V)
unnamed: C47.1, FB1.1, U1.19 (VCC)
unnamed: C48.1, U1.1 (VCCIO), U1.16 (3V3OUT)
PPS: U16.37 (PA18); also elsewhere on the board
RADIO_!RESET: S3.2, U16.4 (!RESET); also elsewhere on the board
RADIO_RX: U1.30 (TXD), U16.23 (PA11)
RADIO_SWDCLK: R88.1, U16.9 (TCK); also elsewhere on the board
RADIO_SWDIO: R87.1, U16.10 (PA03); also elsewhere on the board
RADIO_TX: U1.2 (RXD), U16.24 (PA12)

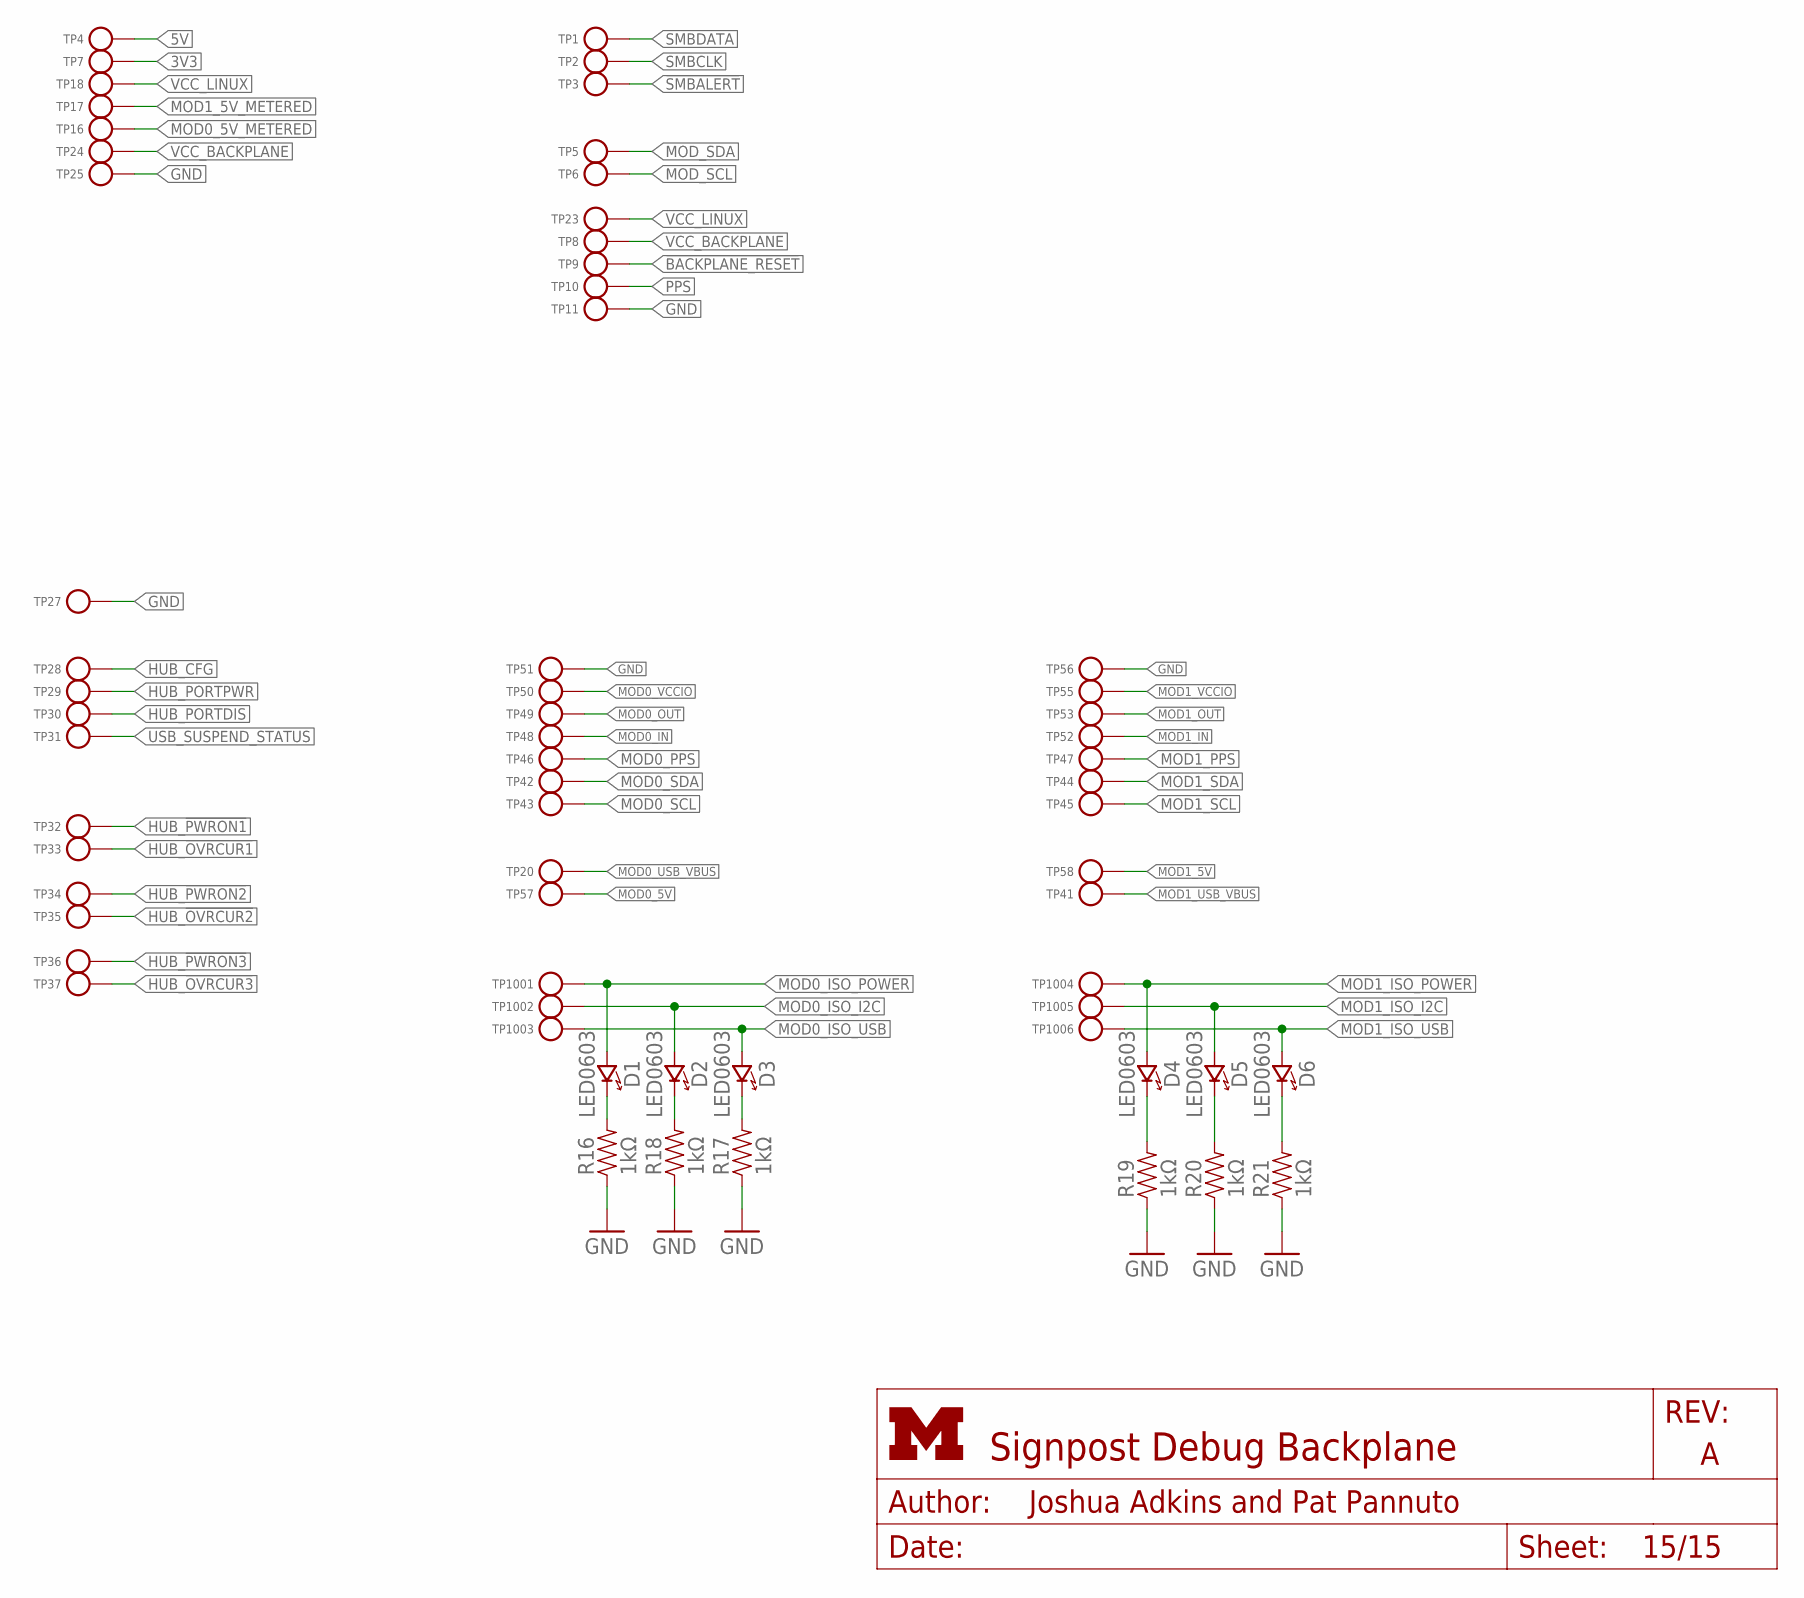
[picture p83: schematic debug_backplane.sch, sheet 15]

Parts:
D1, D2, D3, D4, D5, D6: LED0603; LED-0603
R16, R17, R18, R19, R20, R21: 1kΩ; 0603-RES
TP1, TP2, TP3, TP4, TP5, TP6, TP7, TP8, TP9, TP10, TP11, TP16, TP17, TP18, TP20, TP23, TP24, TP25, TP27, TP28, TP29, TP30, TP31, TP32, TP33, TP34, TP35, TP36, TP37, TP41, TP42, TP43, TP44, TP45, TP46, TP47, TP48, TP49, TP50, TP51, TP52, TP53, TP55, TP56, TP57, TP58, TP1001, TP1002, TP1003, TP1004, TP1005, TP1006: TEST_POINT_0.040IN; TESTPOINT_0.040IN

Connections:
3V3: TP7.TESTPOINT; also elsewhere on the board
5V: TP4.TESTPOINT; also elsewhere on the board
!BACKPLANE_RESET: TP9.TESTPOINT; also elsewhere on the board
!SMBALERT: TP3.TESTPOINT; also elsewhere on the board
GND: R16.1, R17.1, R18.1, R19.1, R20.1, R21.1, TP11.TESTPOINT, TP25.TESTPOINT, TP27.TESTPOINT, TP51.TESTPOINT, TP56.TESTPOINT; also elsewhere on the board
HUB_!OVRCUR1: TP33.TESTPOINT; also elsewhere on the board
HUB_!OVRCUR2: TP35.TESTPOINT; also elsewhere on the board
HUB_!OVRCUR3: TP37.TESTPOINT; also elsewhere on the board
HUB_!PWRON1: TP32.TESTPOINT; also elsewhere on the board
HUB_!PWRON2: TP34.TESTPOINT; also elsewhere on the board
HUB_!PWRON3: TP36.TESTPOINT; also elsewhere on the board
HUB_CFG: TP28.TESTPOINT; also elsewhere on the board
HUB_PORTDIS: TP30.TESTPOINT; also elsewhere on the board
HUB_PORTPWR: TP29.TESTPOINT; also elsewhere on the board
MOD0_5V: TP57.TESTPOINT; also elsewhere on the board
MOD0_5V_METERED: TP16.TESTPOINT; also elsewhere on the board
MOD0_IN: TP48.TESTPOINT; also elsewhere on the board
MOD0_ISO_I2C: D2.A (ANODE), TP1002.TESTPOINT; also elsewhere on the board
MOD0_ISO_POWER: D1.A (ANODE), TP1001.TESTPOINT; also elsewhere on the board
MOD0_ISO_USB: D3.A (ANODE), TP1003.TESTPOINT; also elsewhere on the board
MOD0_OUT: TP49.TESTPOINT; also elsewhere on the board
MOD0_PPS: TP46.TESTPOINT; also elsewhere on the board
MOD0_SCL: TP43.TESTPOINT; also elsewhere on the board
MOD0_SDA: TP42.TESTPOINT; also elsewhere on the board
MOD0_USB_VBUS: TP20.TESTPOINT; also elsewhere on the board
MOD0_VCCIO: TP50.TESTPOINT; also elsewhere on the board
MOD1_5V: TP58.TESTPOINT; also elsewhere on the board
MOD1_5V_METERED: TP17.TESTPOINT; also elsewhere on the board
MOD1_IN: TP52.TESTPOINT; also elsewhere on the board
MOD1_ISO_I2C: D5.A (ANODE), TP1005.TESTPOINT; also elsewhere on the board
MOD1_ISO_POWER: D4.A (ANODE), TP1004.TESTPOINT; also elsewhere on the board
MOD1_ISO_USB: D6.A (ANODE), TP1006.TESTPOINT; also elsewhere on the board
MOD1_OUT: TP53.TESTPOINT; also elsewhere on the board
MOD1_PPS: TP47.TESTPOINT; also elsewhere on the board
MOD1_SCL: TP45.TESTPOINT; also elsewhere on the board
MOD1_SDA: TP44.TESTPOINT; also elsewhere on the board
MOD1_USB_VBUS: TP41.TESTPOINT; also elsewhere on the board
MOD1_VCCIO: TP55.TESTPOINT; also elsewhere on the board
MOD_SCL: TP6.TESTPOINT; also elsewhere on the board
MOD_SDA: TP5.TESTPOINT; also elsewhere on the board
unnamed: D1.C (CATHODE), R16.2
unnamed: D2.C (CATHODE), R18.2
unnamed: D3.C (CATHODE), R17.2
unnamed: D4.C (CATHODE), R19.2
unnamed: D5.C (CATHODE), R20.2
unnamed: D6.C (CATHODE), R21.2
PPS: TP10.TESTPOINT; also elsewhere on the board
SMBCLK: TP2.TESTPOINT; also elsewhere on the board
SMBDATA: TP1.TESTPOINT; also elsewhere on the board
USB_SUSPEND_STATUS: TP31.TESTPOINT; also elsewhere on the board
VCC_BACKPLANE: TP8.TESTPOINT, TP24.TESTPOINT; also elsewhere on the board
VCC_LINUX: TP18.TESTPOINT, TP23.TESTPOINT; also elsewhere on the board

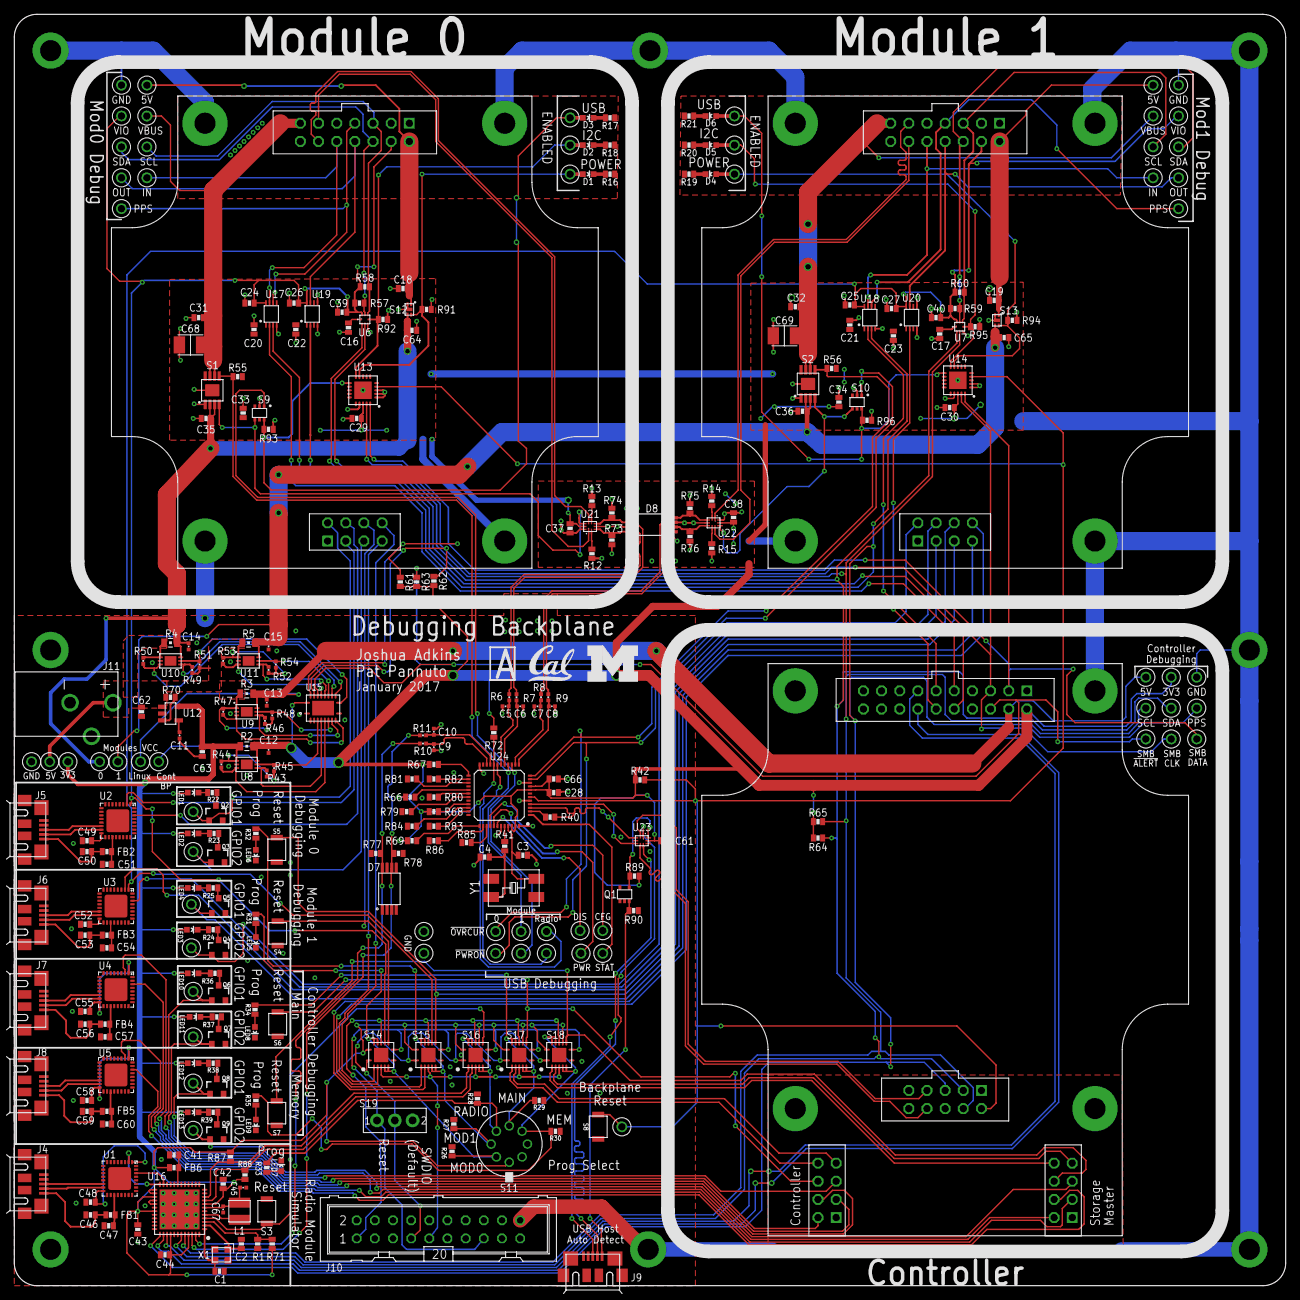
[picture p84: board hardware/debug_backplane/rev_a/debug_backplane.brd from above]

Board: 2 copper layers, 177.8 x 177.8 mm, 321 parts (0 on the bottom side), 214 nets.

Other parts of the board:
U$12: UMICH_SOLID_200MIL
U$15: UCB_CAL_200MIL
