lab11/signpost/hardware/boson/rev_a/boson.brd

## EAGLE design hardware/boson/rev_a/boson.brd (2016-12-03)

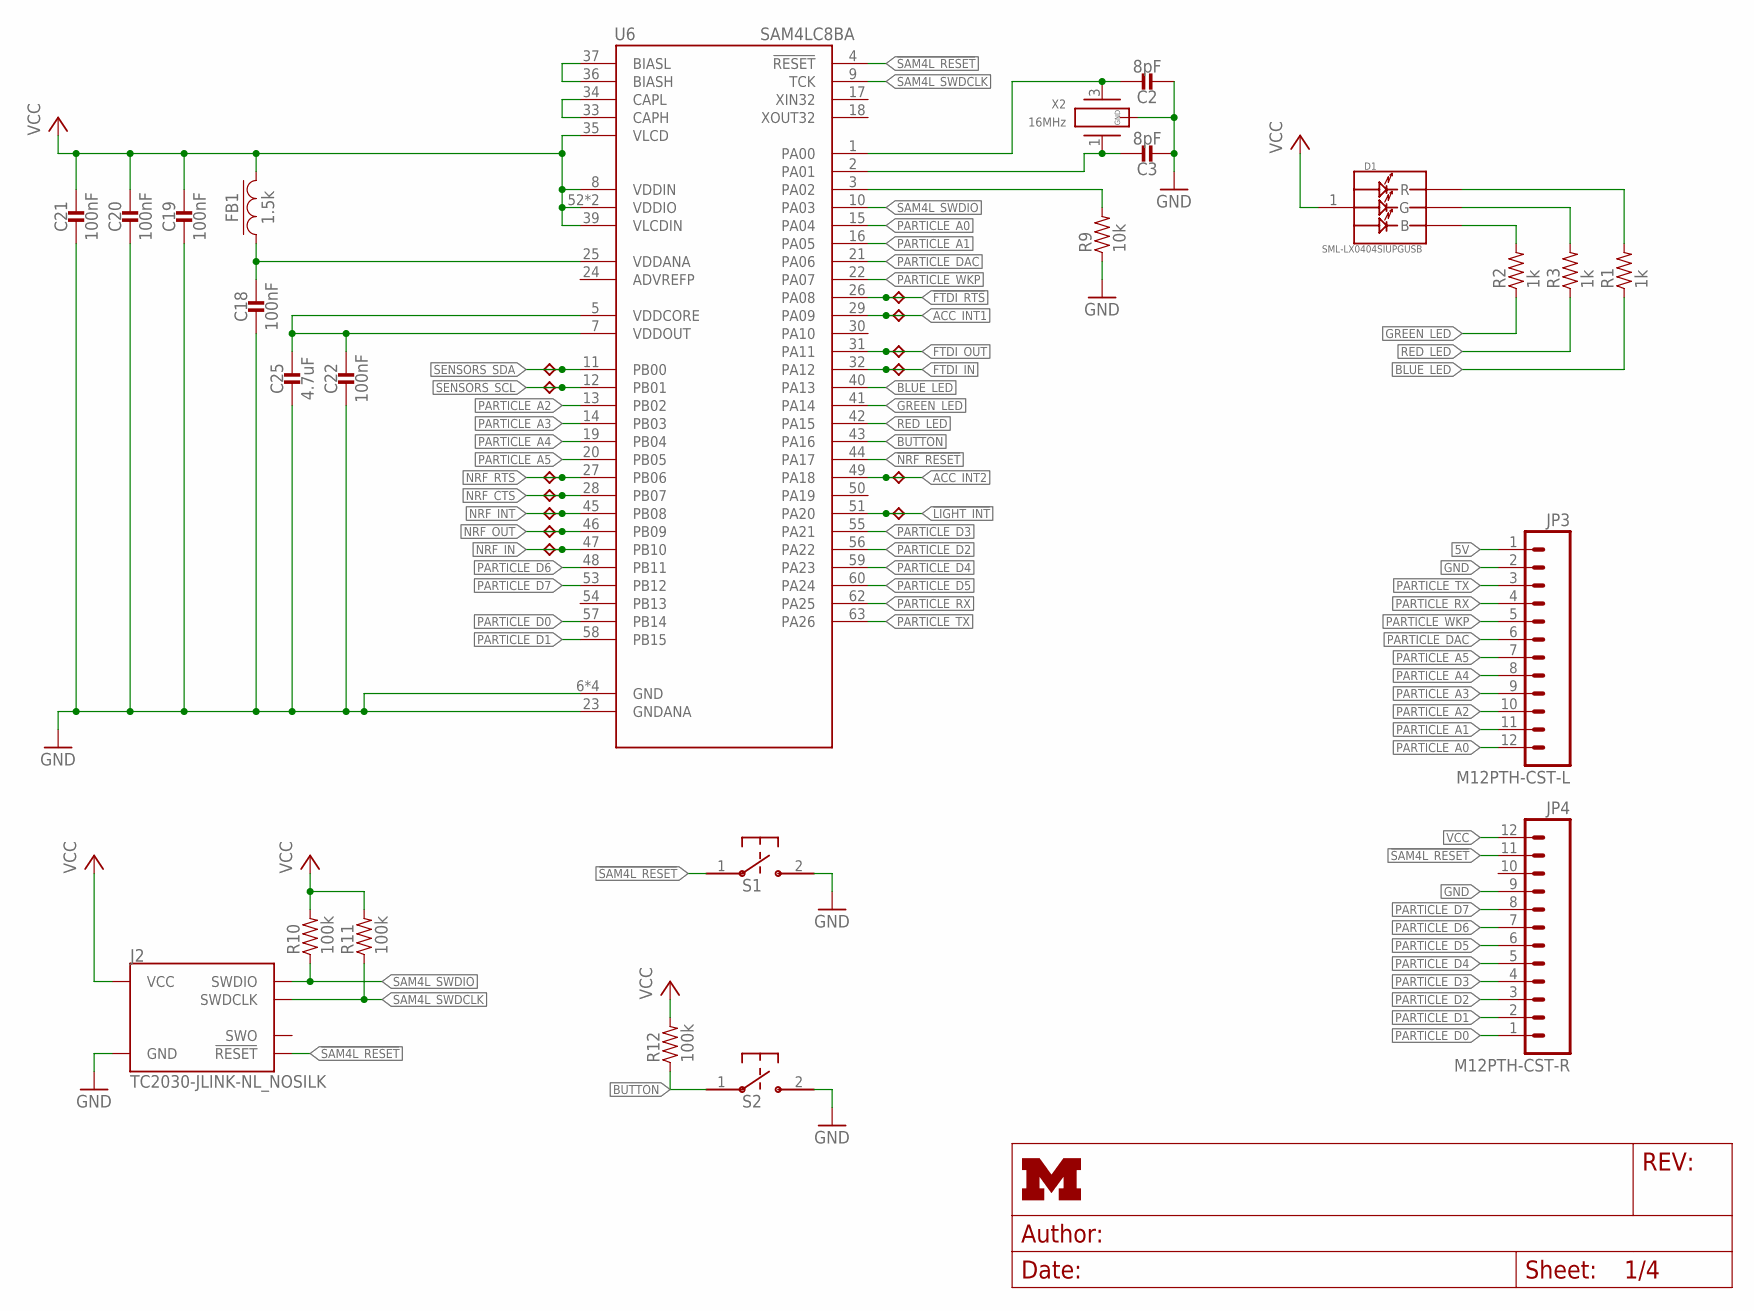
[picture p85: schematic boson.sch, sheet 1]

Parts:
C2, C3: 8pF; 0402_CAP; DIGIKEY 490-8230-1-ND
C18, C19, C20, C21, C22: 100nF; 0402_CAP; DIGIKEY 490-10777-1-ND
C25: 4.7uF; 0402_CAP; DIGIKEY 490-13252-1-ND
D1: SML-LX0404SIUPGUSB; 1MM_SQ_4PAD
FB1: 1.5k; 0402_CAP; DIGIKEY 490-5216-1-ND
J2: TC2030-JLINK-NL_NOSILK; TC2030-IDC-NL_NOSILK
JP3: M12PTH-CST-L; 1X12-CASTELLATED
JP4: M12PTH-CST-R; 1X12-CASTELLATED
R1, R2, R3: 1k; 0402_RES
R9: 10k; 0402_RES; DIGIKEY 1276-3431-1-ND
R10, R11, R12: 100k; 0402_RES; DIGIKEY 1276-3432-1-ND
S1, S2: B3U-1000P
TP1, TP2, TP3, TP4, TP5, TP6, TP7, TP8, TP9, TP10, TP11, TP12, TP13: TPB1,27; B1,27
U6: SAM4LC8BA; QFN-64-9MM
X2: 16MHz; FHXXX

Connections:
5V: JP3.1 (12); also elsewhere on the board
!FTDI_RTS: TP11.TP, U6.26 (PA08); also elsewhere on the board
!LIGHT_INT: TP10.TP, U6.51 (PA20); also elsewhere on the board
!NRF_RESET: U6.44 (PA17); also elsewhere on the board
!SAM4L_RESET: J2.3 (!RESET), JP4.11, S1.1, U6.4 (!RESET); also elsewhere on the board
ACC_INT1: TP8.TP, U6.29 (PA09); also elsewhere on the board
ACC_INT2: TP9.TP, U6.49 (PA18); also elsewhere on the board
ADVREFP: U6.24 (ADVREFP)
BLUE_LED: R1.1, U6.40 (PA13)
BUCK/LDO_N1: R9.2, U6.3 (PA02)
BUTTON: R12.1, S2.1, U6.43 (PA16)
FTDI_IN: TP13.TP, U6.32 (PA12); also elsewhere on the board
FTDI_OUT: TP12.TP, U6.31 (PA11); also elsewhere on the board
GND: C2.2, C3.2, C18.2, C19.2, C20.2, C21.2, C22.2, C25.2, J2.5 (GND), JP3.2 (11), JP4.9, R9.1, S1.2, S2.2, U6.6 (GND), U6.23 (GNDANA), U6.38 (GND), U6.64 (GND), U6.GND, X2.2 (GND), X2.4 (GND); also elsewhere on the board
GREEN_LED: R2.1, U6.41 (PA14)
unnamed: D1.3 (B), R2.2
unnamed: D1.4 (G), R3.2
unnamed: D1.2 (R), R1.2
unnamed: U6.36 (BIASH), U6.37 (BIASL)
unnamed: U6.33 (CAPH), U6.34 (CAPL)
unnamed: C18.1, FB1.1, U6.25 (VDDANA)
unnamed: C22.1, C25.1, U6.5 (VDDCORE), U6.7 (VDDOUT)
NRF_CTS: TP2.TP, U6.28 (PB07); also elsewhere on the board
NRF_IN: TP5.TP, U6.47 (PB10); also elsewhere on the board
NRF_INT: TP3.TP, U6.45 (PB08); also elsewhere on the board
NRF_OUT: TP4.TP, U6.46 (PB09); also elsewhere on the board
NRF_RTS: TP1.TP, U6.27 (PB06); also elsewhere on the board
PARTICLE_A0: JP3.12 (1), U6.15 (PA04)
PARTICLE_A1: JP3.11 (2), U6.16 (PA05)
PARTICLE_A2: JP3.10 (3), U6.13 (PB02)
PARTICLE_A3: JP3.9 (4), U6.14 (PB03)
PARTICLE_A4: JP3.8 (5), U6.19 (PB04)
PARTICLE_A5: JP3.7 (6), U6.20 (PB05)
PARTICLE_D0: JP4.1, U6.57 (PB14)
PARTICLE_D1: JP4.2, U6.58 (PB15)
PARTICLE_D2: JP4.3, U6.56 (PA22)
PARTICLE_D3: JP4.4, U6.55 (PA21)
PARTICLE_D4: JP4.5, U6.59 (PA23)
PARTICLE_D5: JP4.6, U6.60 (PA24)
PARTICLE_D6: JP4.7, U6.48 (PB11)
PARTICLE_D7: JP4.8, U6.53 (PB12)
PARTICLE_DAC: JP3.6 (7), U6.21 (PA06)
PARTICLE_RX: JP3.4 (9), U6.62 (PA25)
PARTICLE_TX: JP3.3 (10), U6.63 (PA26)
PARTICLE_WKP: JP3.5 (8), U6.22 (PA07)
RED_LED: R3.1, U6.42 (PA15)
SAM4L_SWDCLK: J2.4 (SWDCLK), R11.1, U6.9 (TCK)
SAM4L_SWDIO: J2.2 (SWDIO), R10.1, U6.10 (PA03)
SAM4L_XIN1: C2.1, U6.1 (PA00), X2.3 (2)
SAM4L_XOUT1: C3.1, U6.2 (PA01), X2.1
SENSORS_SCL: TP7.TP, U6.12 (PB01); also elsewhere on the board
SENSORS_SDA: TP6.TP, U6.11 (PB00); also elsewhere on the board
VCC: C19.1, C20.1, C21.1, D1.1 (VDD), FB1.2, J2.1 (VCC), JP4.12, R10.2, R11.2, R12.2, U6.8 (VDDIN), U6.35 (VLCD), U6.39 (VLCDIN), U6.52 (VDDIO), U6.61 (VDDIO); also elsewhere on the board

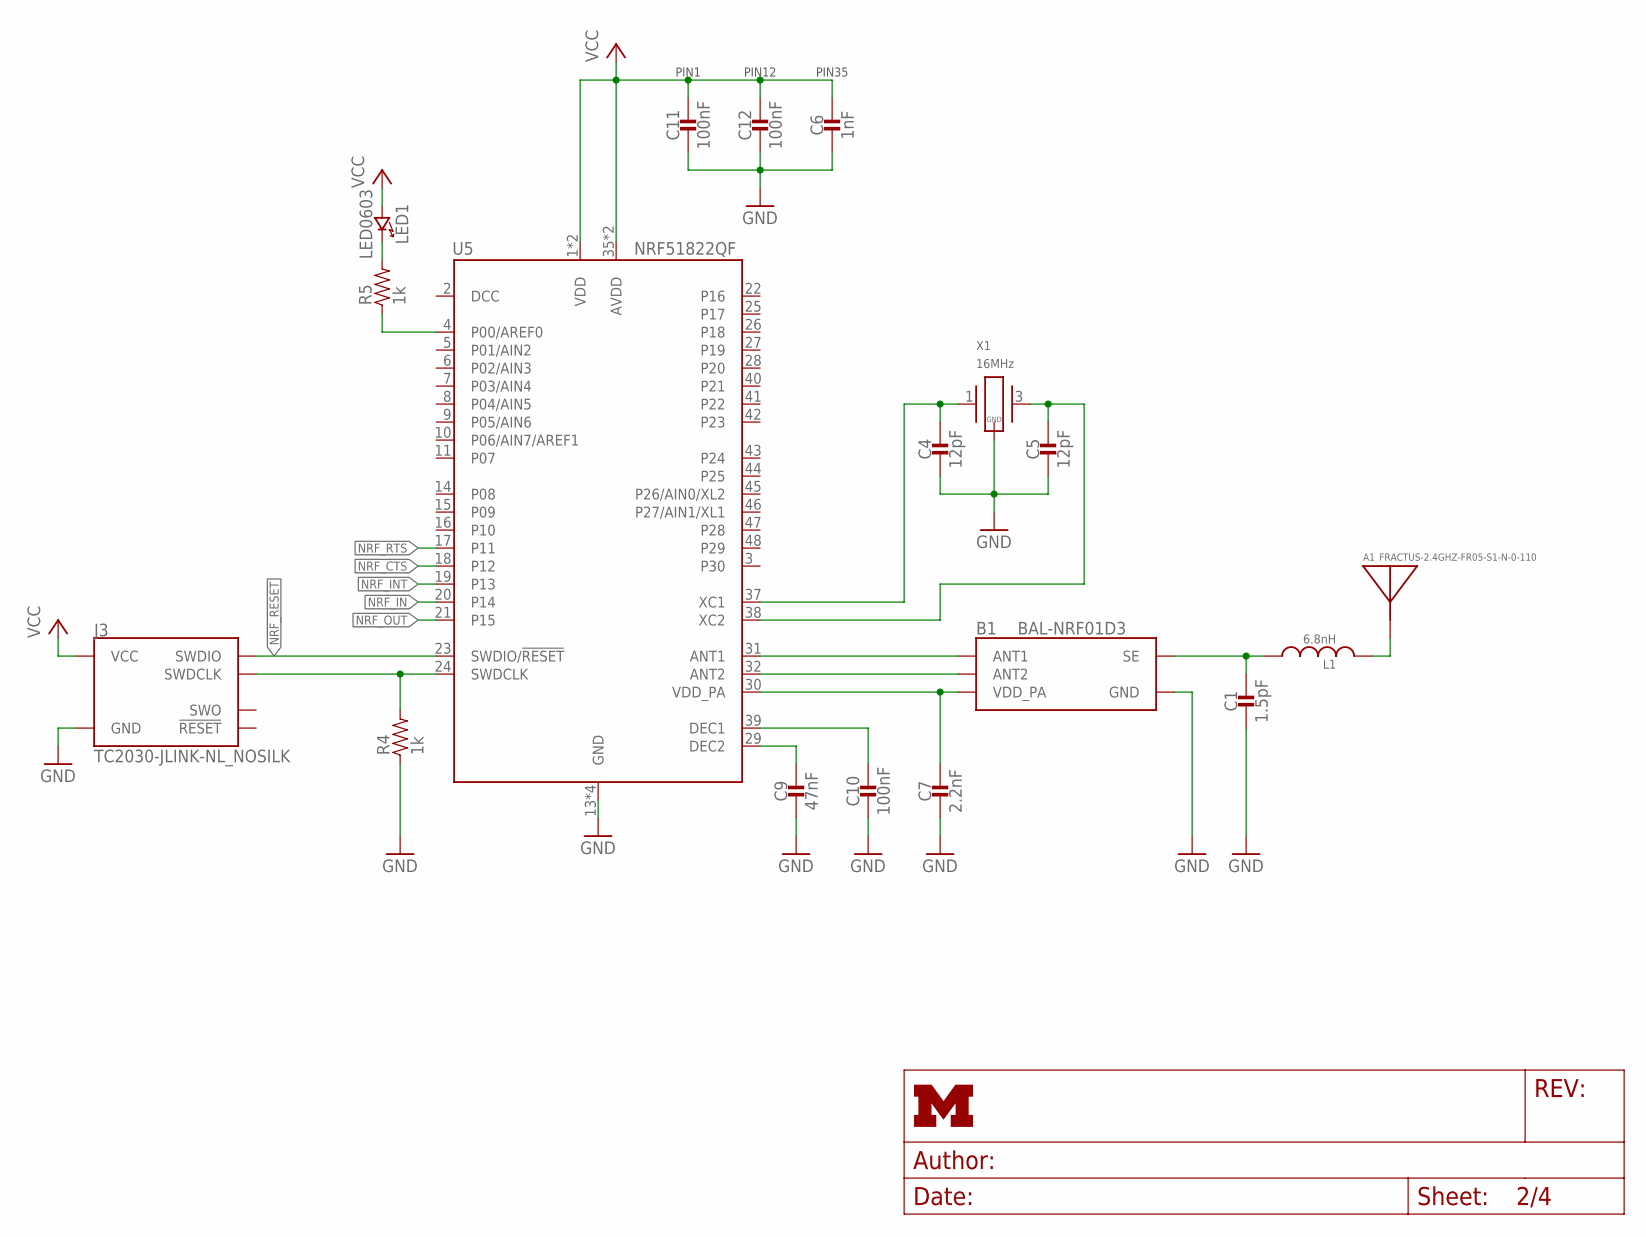
[picture p86: schematic boson.sch, sheet 2]

Parts:
A1: FRACTUS-2.4GHZ-FR05-S1-N-0-110; FRACTUS-ANTENNA-FR05-S1-N-0-110
B1: BAL-NRF01D3
C1: 1.5pF; 0402_CAP
C4, C5: 12pF; 0402_CAP; DIGIKEY 490-6197-1-ND
C6: 1nF; 0402_CAP
C7: 2.2nF; 0402_CAP
C9: 47nF; 0402_CAP
C10, C11, C12: 100nF; 0402_CAP
J3: TC2030-JLINK-NL_NOSILK; TC2030-IDC-NL_NOSILK
L1: 6.8nH; 0402_CAP
LED1: LED0603; LED-0603
R4, R5: 1k; 0402_RES
U5: NRF51822QF; QFN-48-6MM
X1: 16MHz; TXC-8Y; DIGIKEY 887-2003-1-ND

Connections:
!NRF_RESET: J3.2 (SWDIO), U5.23 (SWDIO/!RESET); also elsewhere on the board
GND: B1.GND, C1.2, C4.2, C5.2, C6.2, C7.2, C9.2, C10.2, C11.2, C12.2, J3.5 (GND), R4.1, U5.13 (GND), U5.33 (GND), U5.34 (GND), U5.GND, X1.2 (GND), X1.4 (GND); also elsewhere on the board
unnamed: C10.1, U5.39 (DEC1)
unnamed: C9.1, U5.29 (DEC2)
unnamed: J3.4 (SWDCLK), R4.2, U5.24 (SWDCLK)
unnamed: R5.1, U5.4 (P00/AREF0)
unnamed: LED1.C (CATHODE), R5.2
unnamed: B1.ANT1, U5.31 (ANT1)
unnamed: B1.VCC (VDD_PA), C7.1, U5.30 (VDD_PA)
unnamed: B1.ANT2, U5.32 (ANT2)
unnamed: C4.1, U5.37 (XC1), X1.1
unnamed: C5.1, U5.38 (XC2), X1.3 (2)
unnamed: B1.SE, C1.1, L1.1
unnamed: A1.ANT, L1.2
NRF_CTS: U5.18 (P12); also elsewhere on the board
NRF_IN: U5.20 (P14); also elsewhere on the board
NRF_INT: U5.19 (P13); also elsewhere on the board
NRF_OUT: U5.21 (P15); also elsewhere on the board
NRF_RTS: U5.17 (P11); also elsewhere on the board
VCC: C6.1, C11.1, C12.1, J3.1 (VCC), LED1.A (ANODE), U5.1 (VDD), U5.12 (VDD), U5.35 (AVDD), U5.36 (AVDD); also elsewhere on the board

Notes on the sheet:
PIN35
PIN1
PIN12
