lab11/signpost/hardware/boson/rev_a/boson.brd

## EAGLE design hardware/boson/rev_a/boson.brd (continued)

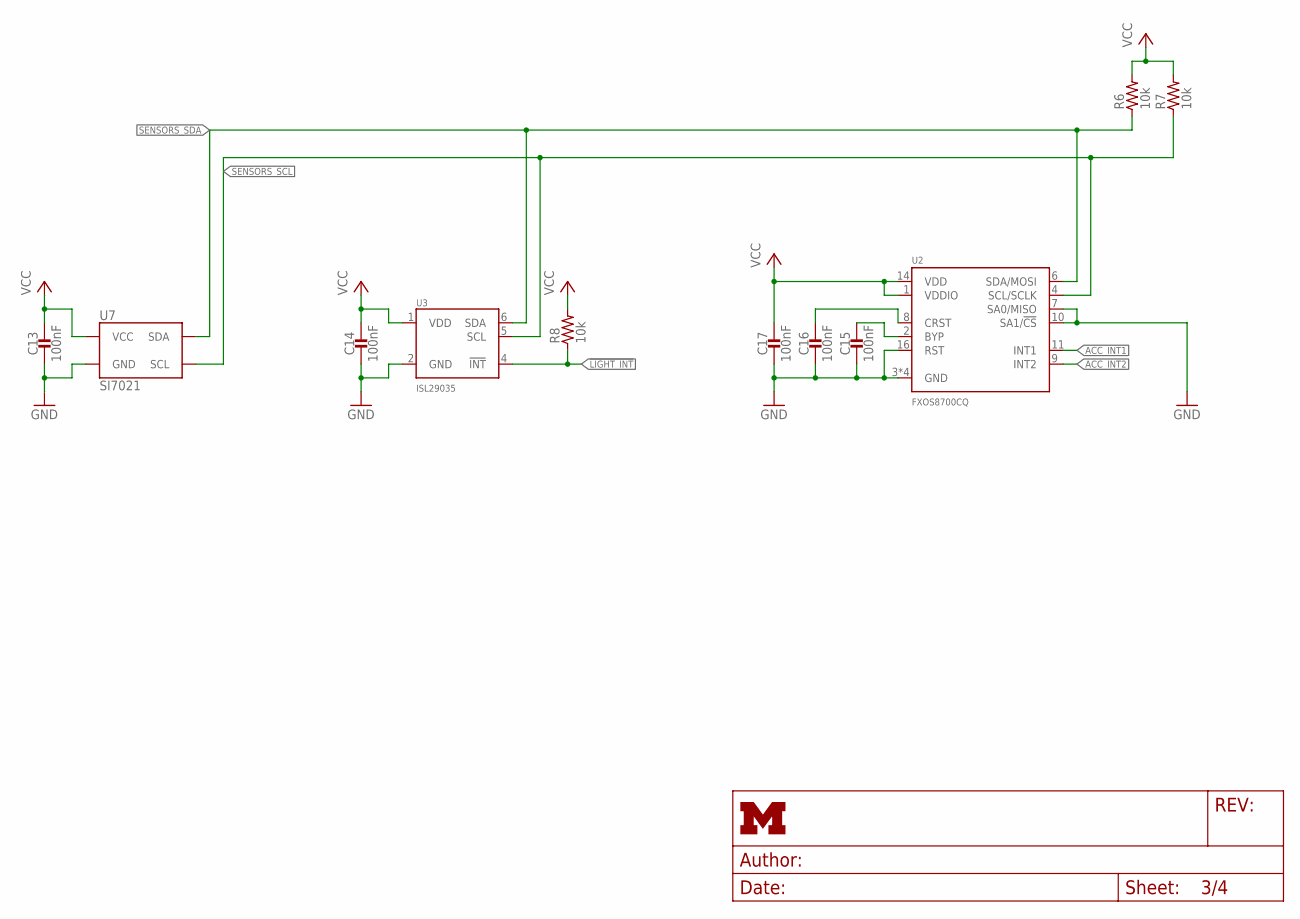
[picture p87: schematic boson.sch, sheet 3]

Parts:
C13, C14, C15, C16, C17: 100nF; 0402_CAP
R6, R7, R8: 10k; 0402_RES
U2: FXOS8700CQ; QFN-16-3MM
U3: ISL29035; ODFN-6-1.5MMX1.6MM
U7: SI7021; DFN-6/3MM

Connections:
!LIGHT_INT: R8.1, U3.4 (!INT); also elsewhere on the board
ACC_INT1: U2.11 (INT1); also elsewhere on the board
ACC_INT2: U2.9 (INT2); also elsewhere on the board
GND: C13.2, C14.2, C15.2, C16.2, C17.2, U2.3 (GND), U2.5 (GND), U2.7 (SA0/MISO), U2.10 (SA1/!CS), U2.12 (GND), U2.13 (GND), U2.16 (RST), U3.2 (GND), U7.2 (GND); also elsewhere on the board
unnamed: C15.1, U2.2 (BYP)
unnamed: C16.1, U2.8 (CRST)
SENSORS_SCL: R7.1, U2.4 (SCL/SCLK), U3.5 (SCL), U7.6 (SCL); also elsewhere on the board
SENSORS_SDA: R6.1, U2.6 (SDA/MOSI), U3.6 (SDA), U7.1 (SDA); also elsewhere on the board
VCC: C13.1, C14.1, C17.1, R6.2, R7.2, R8.2, U2.1 (VDDIO), U2.14 (VDD), U3.1 (VDD), U7.5 (VCC); also elsewhere on the board

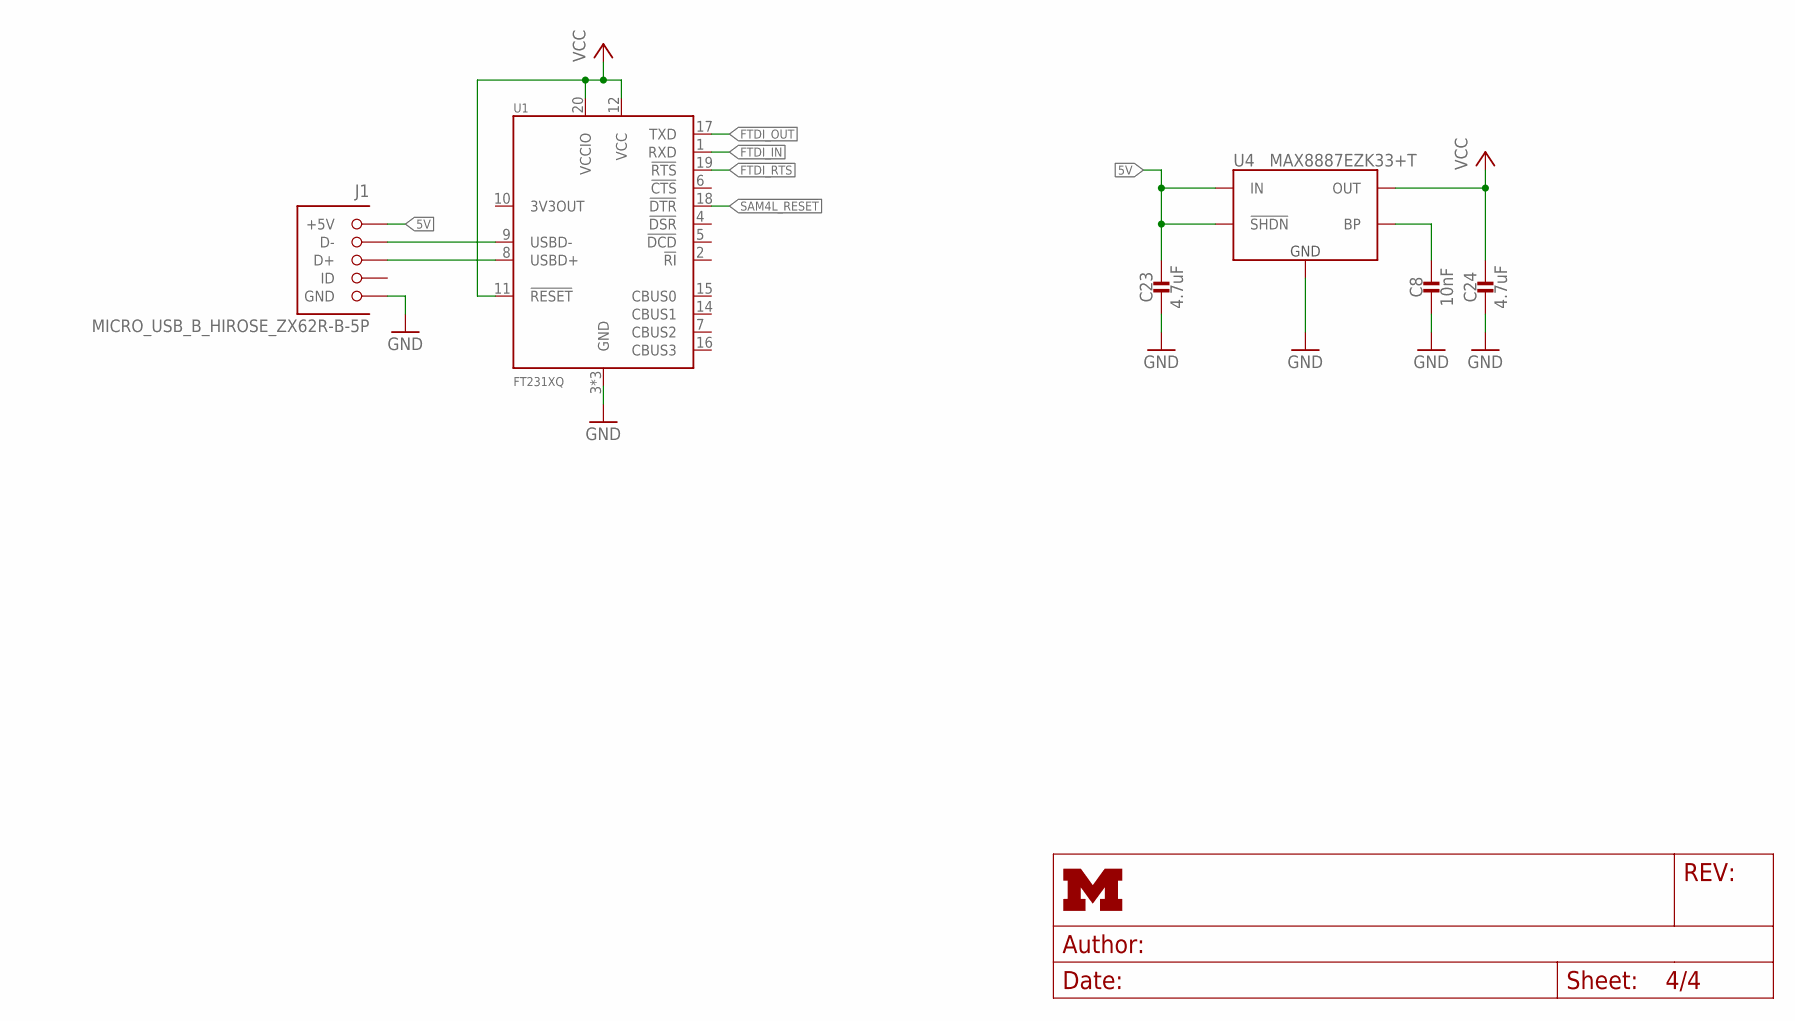
[picture p88: schematic boson.sch, sheet 4]

Parts:
C8: 10nF; 0402_CAP
C23, C24: 4.7uF; 0402_CAP
J1: MICRO_USB_B_HIROSE_ZX62R-B-5P; USB_MICRO_B-HIROSE-ZX62R-B-5P; DIGIKEY H125274CT-ND
U1: FT231XQ; QFN-20-4MM
U4: MAX8887EZK33+T; SOT-23-5

Connections:
5V: C23.1, J1.1 (+5V), U4.1 (IN), U4.3 (!SHDN); also elsewhere on the board
!FTDI_RTS: U1.19 (!RTS); also elsewhere on the board
!SAM4L_RESET: U1.18 (!DTR); also elsewhere on the board
FTDI_IN: U1.1 (RXD); also elsewhere on the board
FTDI_OUT: U1.17 (TXD); also elsewhere on the board
GND: C8.2, C23.2, C24.2, J1.5 (GND), U1.3 (GND), U1.13 (GND), U1.GND, U4.2 (GND); also elsewhere on the board
unnamed: J1.2 (D-), U1.9 (USBD-)
unnamed: J1.3 (D+), U1.8 (USBD+)
unnamed: C8.1, U4.4 (BP)
VCC: C24.1, U1.11 (!RESET), U1.12 (VCC), U1.20 (VCCIO), U4.5 (OUT); also elsewhere on the board

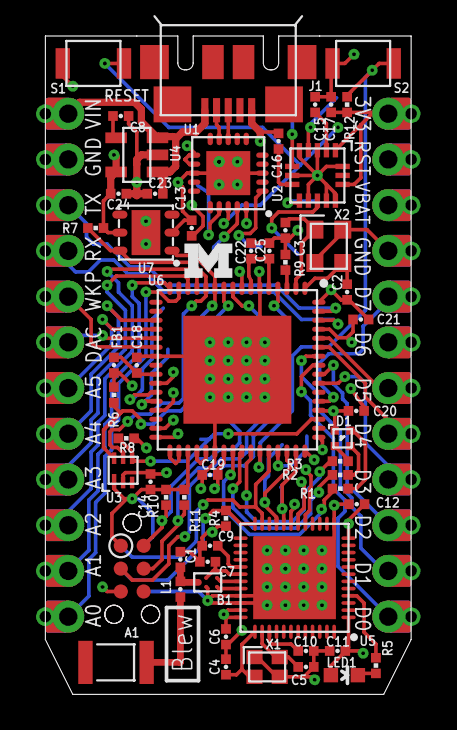
[picture p89: board boson.brd from above]

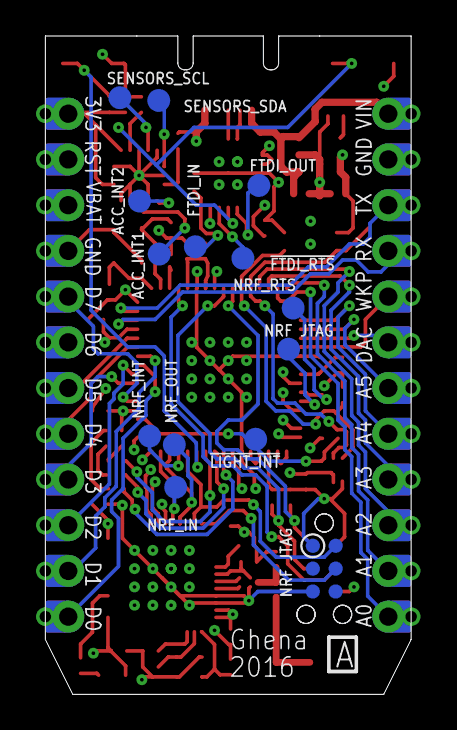
[picture p90: board boson.brd from below]

Board: 4 copper layers, 20.3 x 36.6 mm, 75 parts (14 on the bottom side), 69 nets.

Other parts of the board:
U$1: PHOTON-BOTTOM-SS
U$2: PHOTON-TOP-SS
U$3: UMICH_SOLID_75MIL
