lab11/signpost/hardware/power_supply_module/rev_b/power_supply_module.brd

## EAGLE design hardware/power_supply_module/rev_b/power_supply_module.brd (continued)

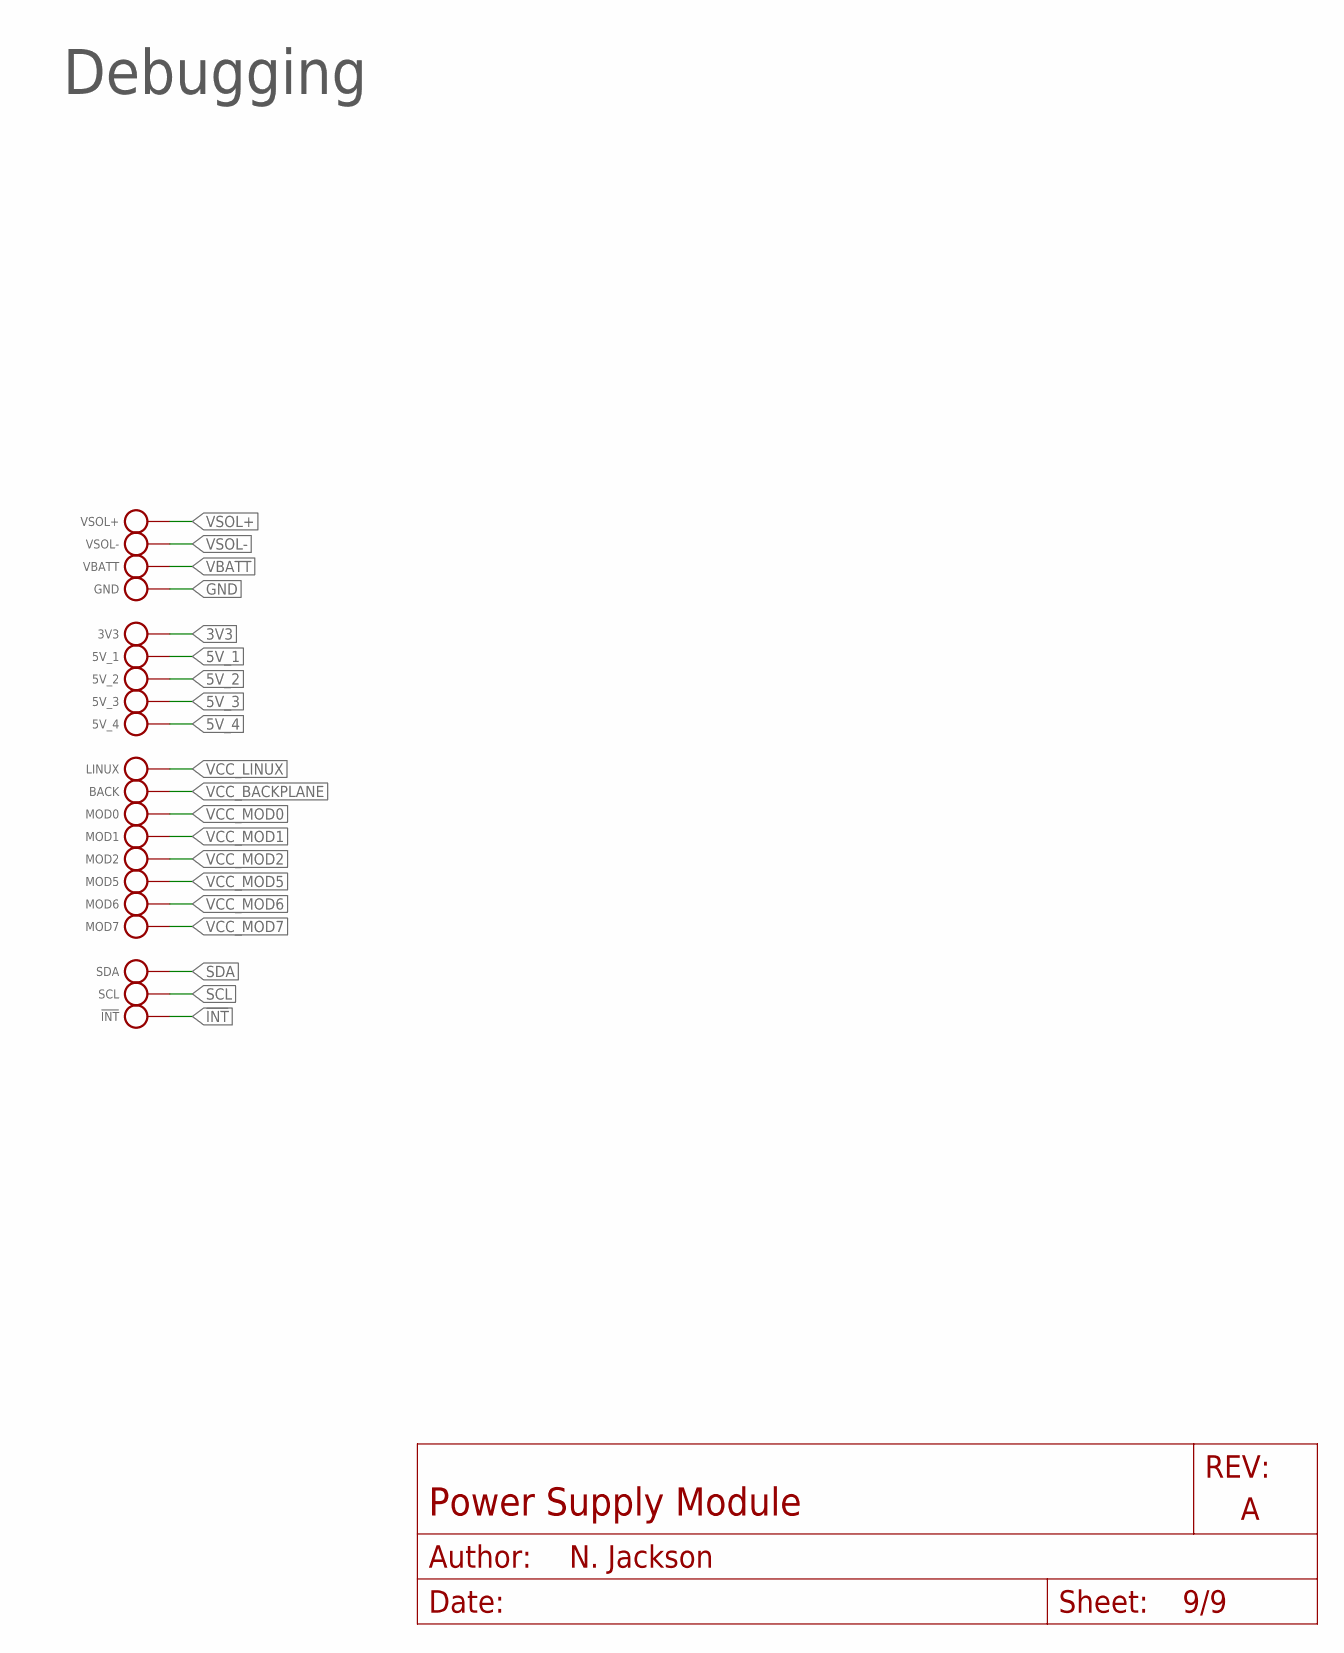
[picture p99: schematic power_supply_module.sch, sheet 9]

Parts:
3V3, 5V_1, 5V_2, 5V_3, 5V_4: TEST_POINT_0.040IN; TESTPOINT_0.040IN
!INT: TEST_POINT_0.040IN; TESTPOINT_0.040IN
BACK: TEST_POINT_0.040IN; TESTPOINT_0.040IN
GND: TEST_POINT_0.040IN; TESTPOINT_0.040IN
LINUX: TEST_POINT_0.040IN; TESTPOINT_0.040IN
MOD0, MOD1, MOD2, MOD5, MOD6, MOD7: TEST_POINT_0.040IN; TESTPOINT_0.040IN
SCL: TEST_POINT_0.040IN; TESTPOINT_0.040IN
SDA: TEST_POINT_0.040IN; TESTPOINT_0.040IN
VBATT: TEST_POINT_0.040IN; TESTPOINT_0.040IN
VSOL+: TEST_POINT_0.040IN; TESTPOINT_0.040IN
VSOL-: TEST_POINT_0.040IN; TESTPOINT_0.040IN

Connections:
3V3: 3V3.TESTPOINT; also elsewhere on the board
5V_1: 5V_1.TESTPOINT; also elsewhere on the board
5V_2: 5V_2.TESTPOINT; also elsewhere on the board
5V_3: 5V_3.TESTPOINT; also elsewhere on the board
5V_4: 5V_4.TESTPOINT; also elsewhere on the board
!INT: !INT.TESTPOINT; also elsewhere on the board
GND: GND.TESTPOINT; also elsewhere on the board
SCL: SCL.TESTPOINT; also elsewhere on the board
SDA: SDA.TESTPOINT; also elsewhere on the board
VBATT: VBATT.TESTPOINT; also elsewhere on the board
VCC_BACKPLANE: BACK.TESTPOINT; also elsewhere on the board
VCC_LINUX: LINUX.TESTPOINT; also elsewhere on the board
VCC_MOD0: MOD0.TESTPOINT; also elsewhere on the board
VCC_MOD1: MOD1.TESTPOINT; also elsewhere on the board
VCC_MOD2: MOD2.TESTPOINT; also elsewhere on the board
VCC_MOD5: MOD5.TESTPOINT; also elsewhere on the board
VCC_MOD6: MOD6.TESTPOINT; also elsewhere on the board
VCC_MOD7: MOD7.TESTPOINT; also elsewhere on the board
VSOL+: VSOL+.TESTPOINT; also elsewhere on the board
VSOL-: VSOL-.TESTPOINT; also elsewhere on the board

Notes on the sheet:
Debugging

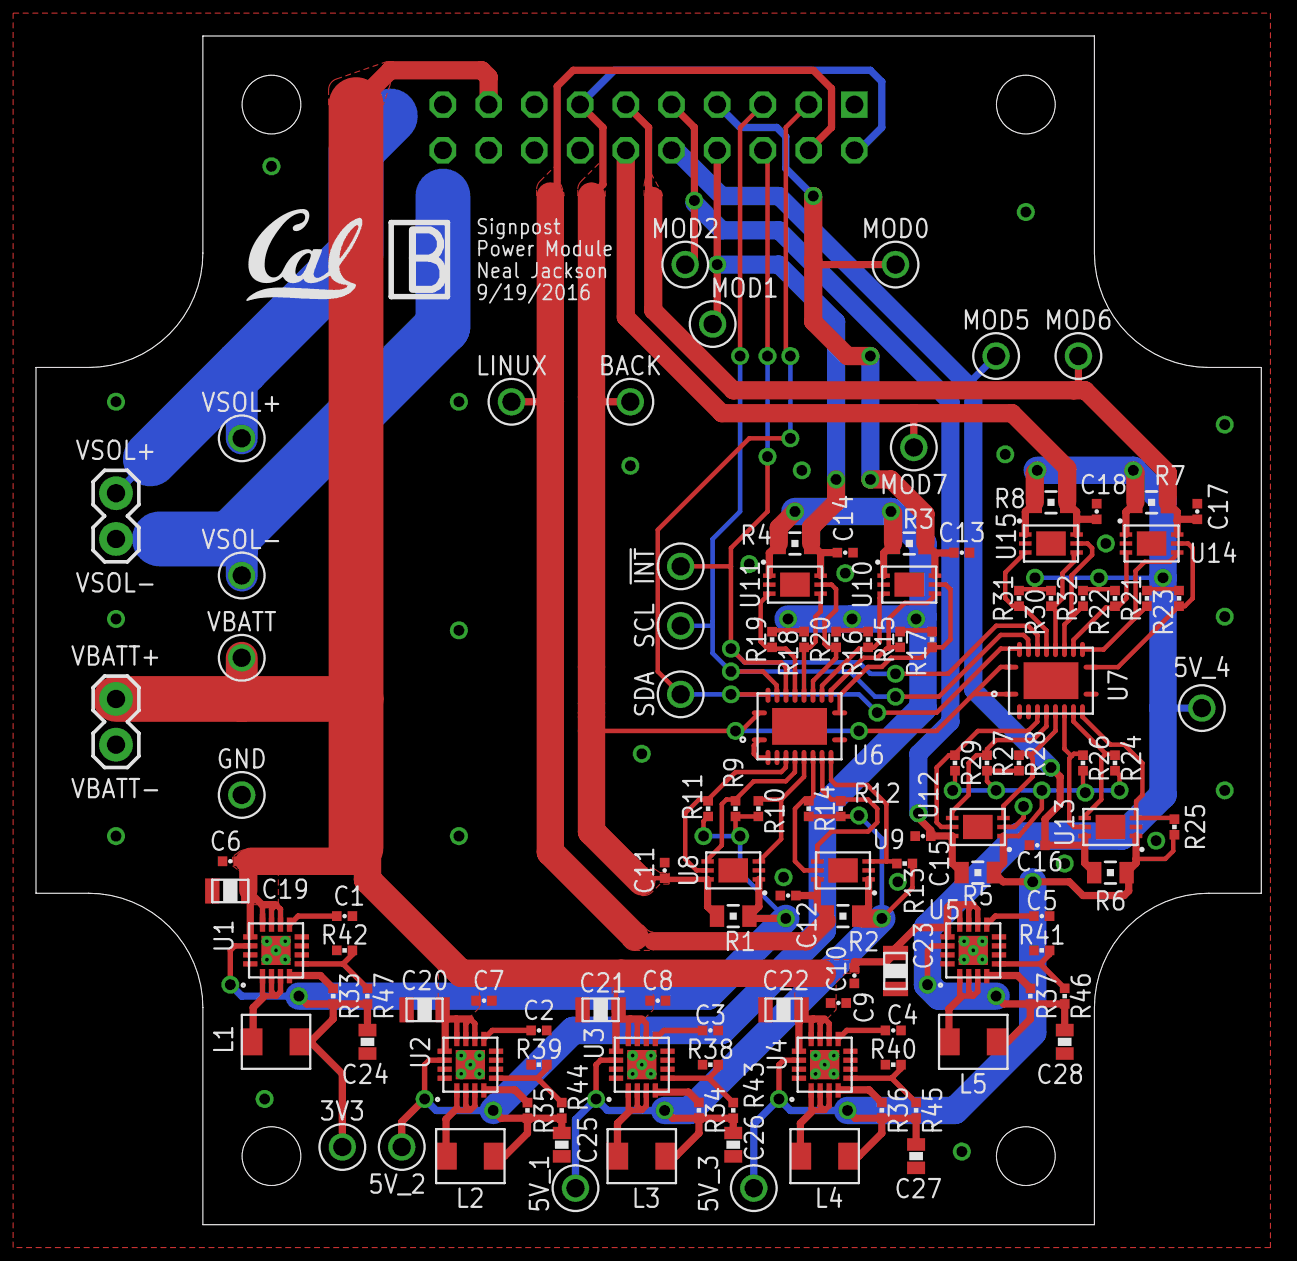
[picture p100: board hardware/power_supply_module/rev_b/power_supply_module.brd from above]

Board: 2 copper layers, 68.1 x 66.0 mm, 119 parts (0 on the bottom side), 64 nets.

Other parts of the board:
U$1: UCB_CAL_200MIL
