lab11/signpost/modules/microwave_radar/hardware/rev_a/microwave.brd

## EAGLE design modules/microwave_radar/hardware/rev_a/microwave.brd (2016-10-07, an earlier design)

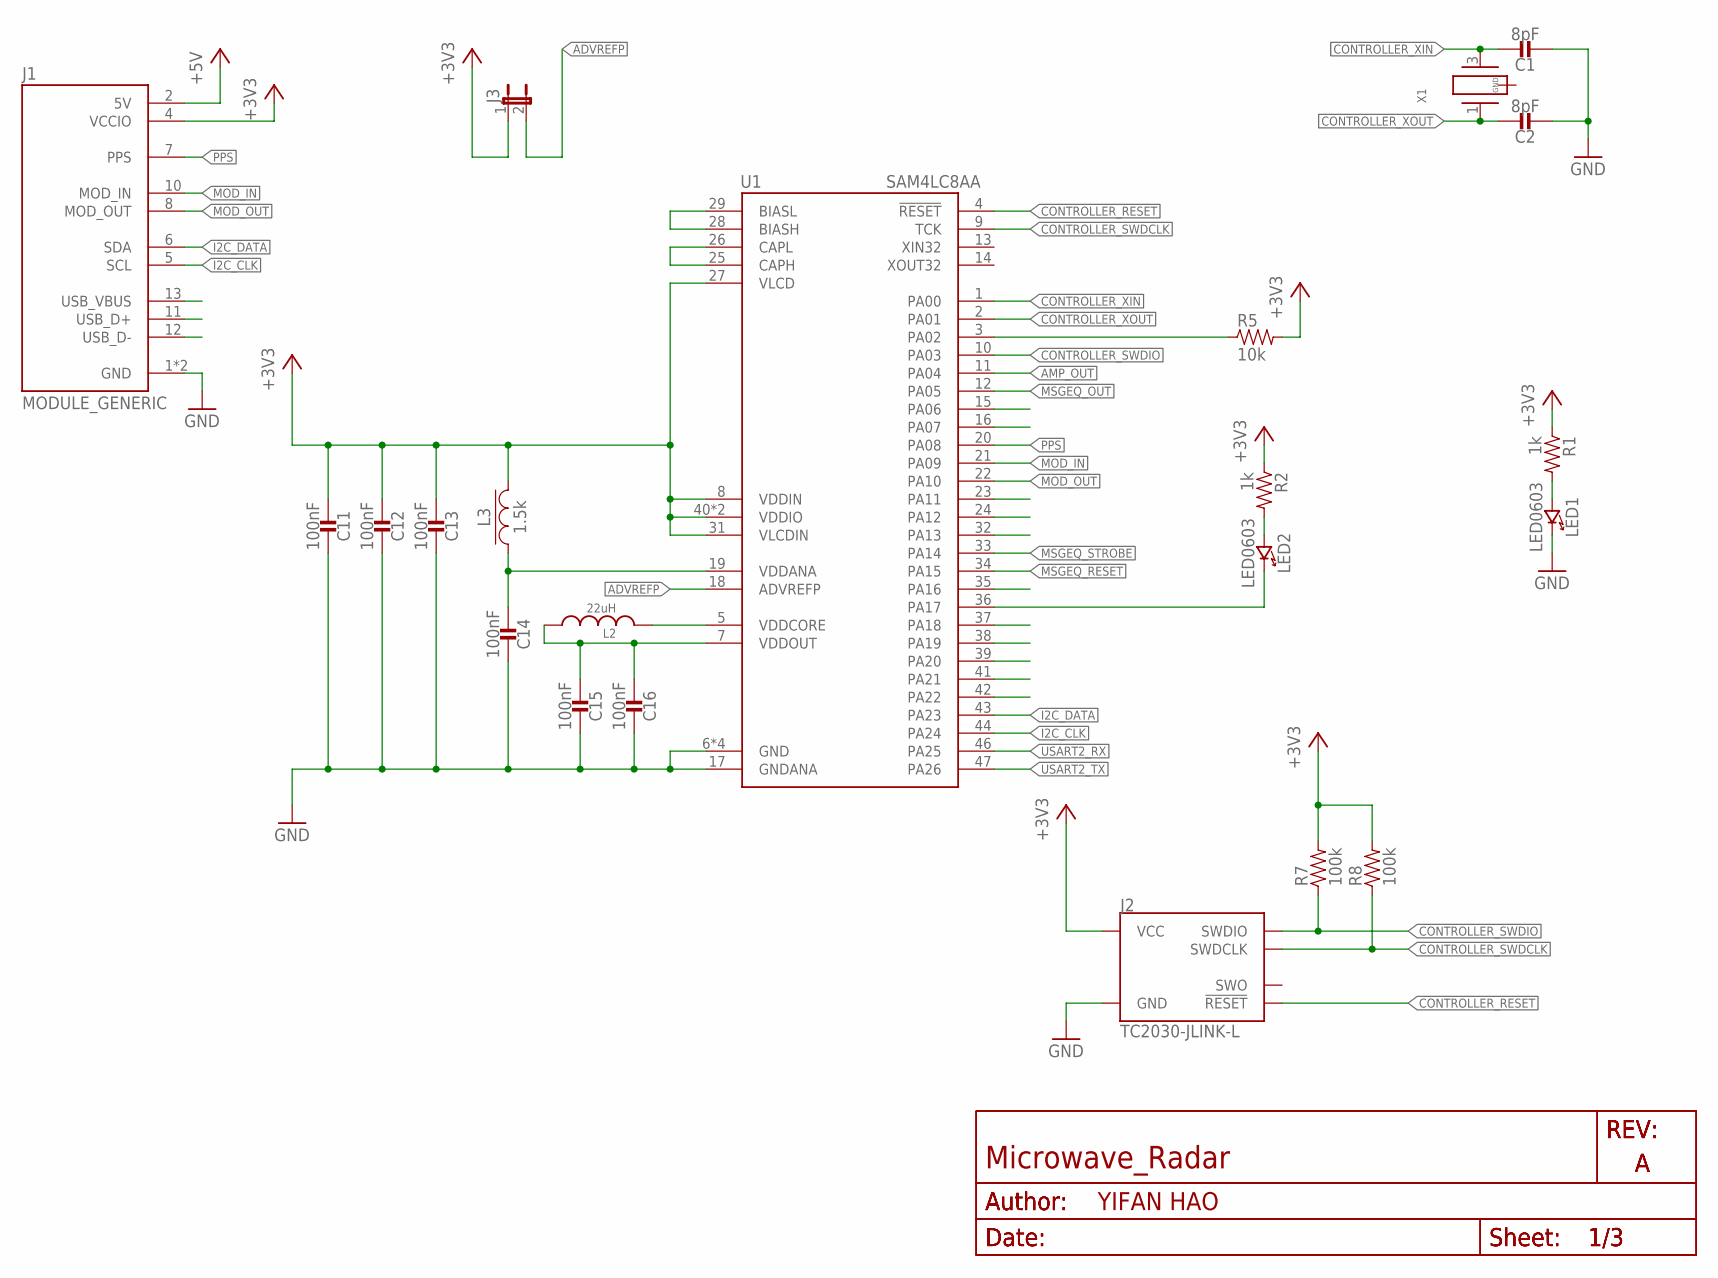
[picture p101: schematic microwave.sch, sheet 1]

Parts:
C1, C2: 8pF; 0402_CAP; DIGIKEY 490-8230-1-ND
C11, C12, C13, C14, C16: 100nF; 0402_CAP; DIGIKEY 490-10777-1-ND
C15: 100nF; 0402_CAP; DIGIKEY 490-13252-1-ND
J1: MODULE_GENERIC
J2: TC2030-JLINK-L; TC2030-IDC
J3: JUMPER-2PTH; 1X02
L2: 22uH; 1212
L3: 1.5k; 0402_CAP; DIGIKEY 490-5216-1-ND
LED1, LED2: LED0603; LED-0603
R1, R2: 1k; 0402_RES; DIGIKEY 1276-3430-1-ND
R5: 10k; 0402_RES; DIGIKEY 1276-3431-1-ND
R7, R8: 100k; 0402_RES; DIGIKEY 1276-3432-1-ND
U1: SAM4LC8AA; QFN-48-7MM
X1: FH1600015; FHXXX

Connections:
+3V3: C11.2, C12.2, C13.2, J1.4 (VCCIO), J2.1 (VCC), J3.1, L3.2, R1.1, R2.1, R5.2, R7.2, R8.2, U1.8 (VDDIN), U1.27 (VLCD), U1.31 (VLCDIN), U1.40 (VDDIO), U1.45 (VDDIO); also elsewhere on the board
+5V: J1.2 (5V); also elsewhere on the board
ADVREFP: J3.2, U1.18 (ADVREFP)
AMP_OUT: U1.11 (PA04); also elsewhere on the board
CONTROLLER_RESET: J2.3 (!RESET), U1.4 (!RESET)
CONTROLLER_SWDCLK: J2.4 (SWDCLK), R8.1, U1.9 (TCK)
CONTROLLER_SWDIO: J2.2 (SWDIO), R7.1, U1.10 (PA03)
CONTROLLER_XIN: C1.1, U1.1 (PA00), X1.3 (2)
CONTROLLER_XOUT: C2.1, U1.2 (PA01), X1.1
GND: C1.2, C2.2, C11.1, C12.1, C13.1, C14.1, C15.1, C16.1, J1.1 (GND), J1.14 (GND), J2.5 (GND), LED1.C (CATHODE), U1.6 (GND), U1.17 (GNDANA), U1.30 (GND), U1.48 (GND), U1.THERMAL (GND); also elsewhere on the board
I2C_CLK: J1.5 (SCL), U1.44 (PA24)
I2C_DATA: J1.6 (SDA), U1.43 (PA23)
MOD_IN: J1.10 (MOD_IN), U1.21 (PA09)
MOD_OUT: J1.8 (MOD_OUT), U1.22 (PA10)
MSGEQ_OUT: U1.12 (PA05); also elsewhere on the board
MSGEQ_RESET: U1.34 (PA15); also elsewhere on the board
MSGEQ_STROBE: U1.33 (PA14); also elsewhere on the board
unnamed: LED1.A (ANODE), R1.2
unnamed: L2.P$2 (2), U1.5 (VDDCORE)
unnamed: C15.2, C16.2, L2.P$1 (1), U1.7 (VDDOUT)
unnamed: U1.28 (BIASH), U1.29 (BIASL)
unnamed: U1.25 (CAPH), U1.26 (CAPL)
unnamed: C14.2, L3.1, U1.19 (VDDANA)
unnamed: R5.1, U1.3 (PA02)
unnamed: LED2.A (ANODE), R2.2
unnamed: LED2.C (CATHODE), U1.36 (PA17)
PPS: J1.7 (PPS), U1.20 (PA08)
USART2_RX: U1.46 (PA25); also elsewhere on the board
USART2_TX: U1.47 (PA26); also elsewhere on the board
USB+: J1.11 (USB_D+)
USB-: J1.12 (USB_D-)

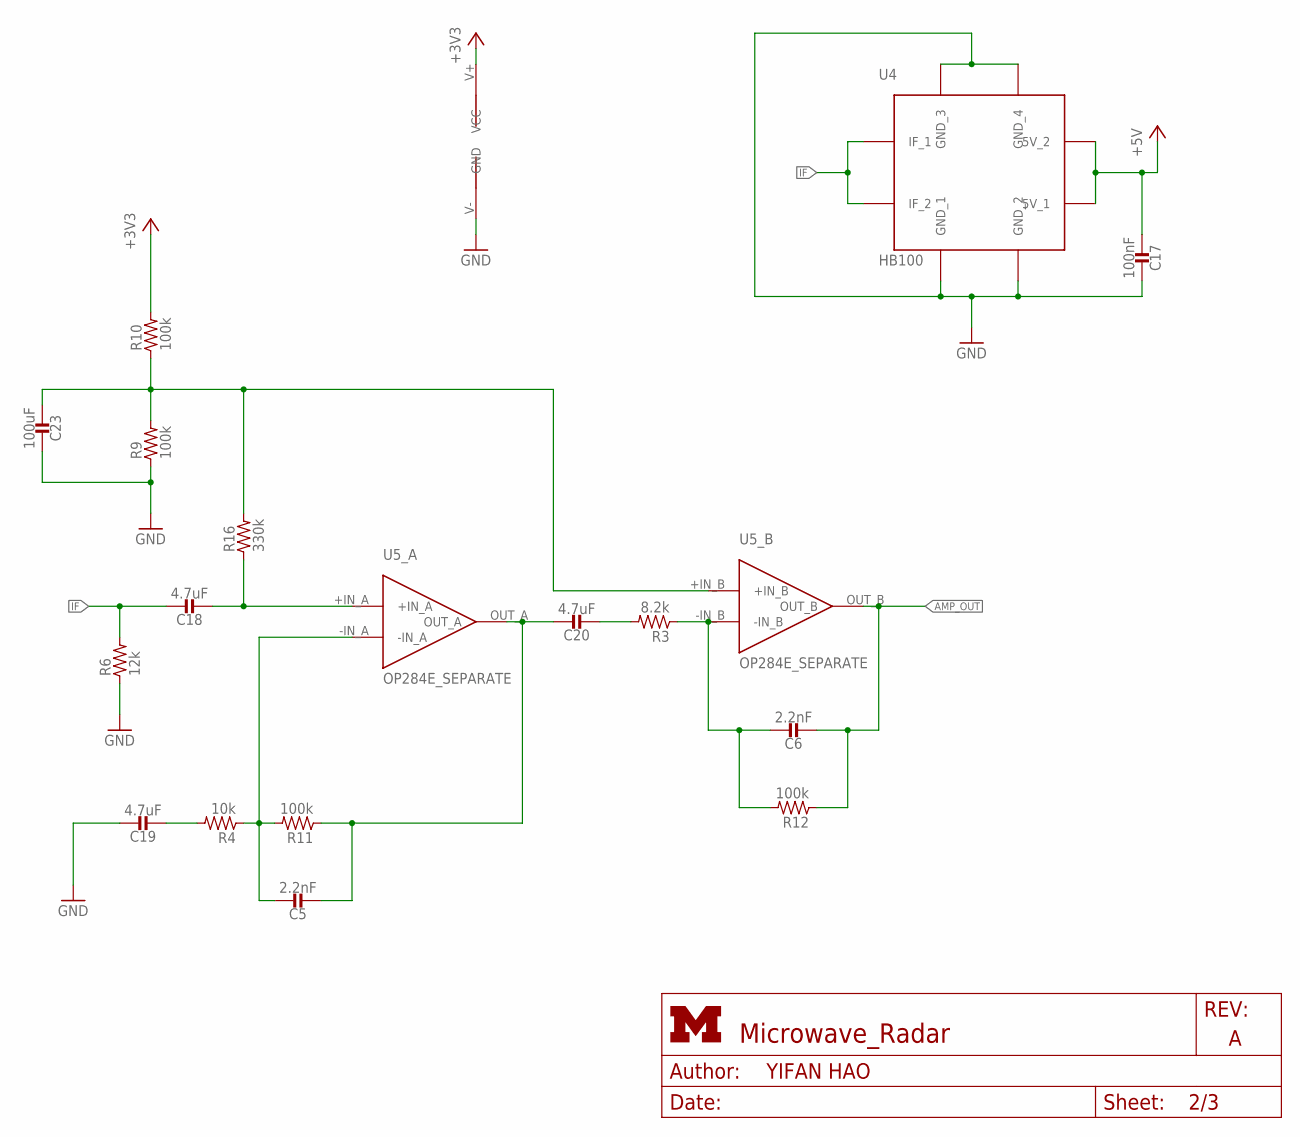
[picture p102: schematic microwave.sch, sheet 2]

Parts:
C5, C6: 2.2nF; 0402_CAP; DIGIKEY 490-11418-1-ND
C17: 100nF; 0402_CAP; DIGIKEY 490-10777-1-ND
C18, C19, C20: 4.7uF; 0402_CAP; DIGIKEY 1276-1481-1-ND
C23: 100uF; 1210_CAP; DIGIKEY 490-3390-1-ND
R3: 8.2k; 0402_RES; DIGIKEY 311-8.20KLRCT-ND
R4: 10k; 0402_RES; DIGIKEY 1276-3431-1-ND
R6: 12k; 0402_RES; DIGIKEY 1276-4122-1-ND
R9, R10, R11, R12: 100k; 0402_RES; DIGIKEY 1276-3432-1-ND
R16: 330k; 0402_RES; DIGIKEY 1276-4244-1-ND
U4: HB100; DIGIKEY SAM1067-02-ND
U5: OP284E_SEPARATE; DIGIKEY OP284ESZ-ND

Connections:
+3V3: R10.2, U5.V+ (VCC); also elsewhere on the board
+5V: C17.2, U4.5V_1, U4.5V_2; also elsewhere on the board
AMP_OUT: C6.2, R12.1, U5.OUT_B; also elsewhere on the board
GND: C17.1, C19.1, C23.1, R6.1, R9.1, U4.GND_1, U4.GND_2, U4.GND_3, U4.GND_4, U5.V- (GND); also elsewhere on the board
IF: C18.1, R6.2, U4.IF_1, U4.IF_2; also elsewhere on the board
unnamed: C23.2, R9.2, R10.1, R16.2, U5.+IN_B
unnamed: C18.2, R16.1, U5.+IN_A
unnamed: C5.1, R4.1, R11.2, U5.-IN_A
unnamed: C19.2, R4.2
unnamed: C5.2, C20.1, R11.1, U5.OUT_A
unnamed: C20.2, R3.2
unnamed: C6.1, R3.1, R12.2, U5.-IN_B

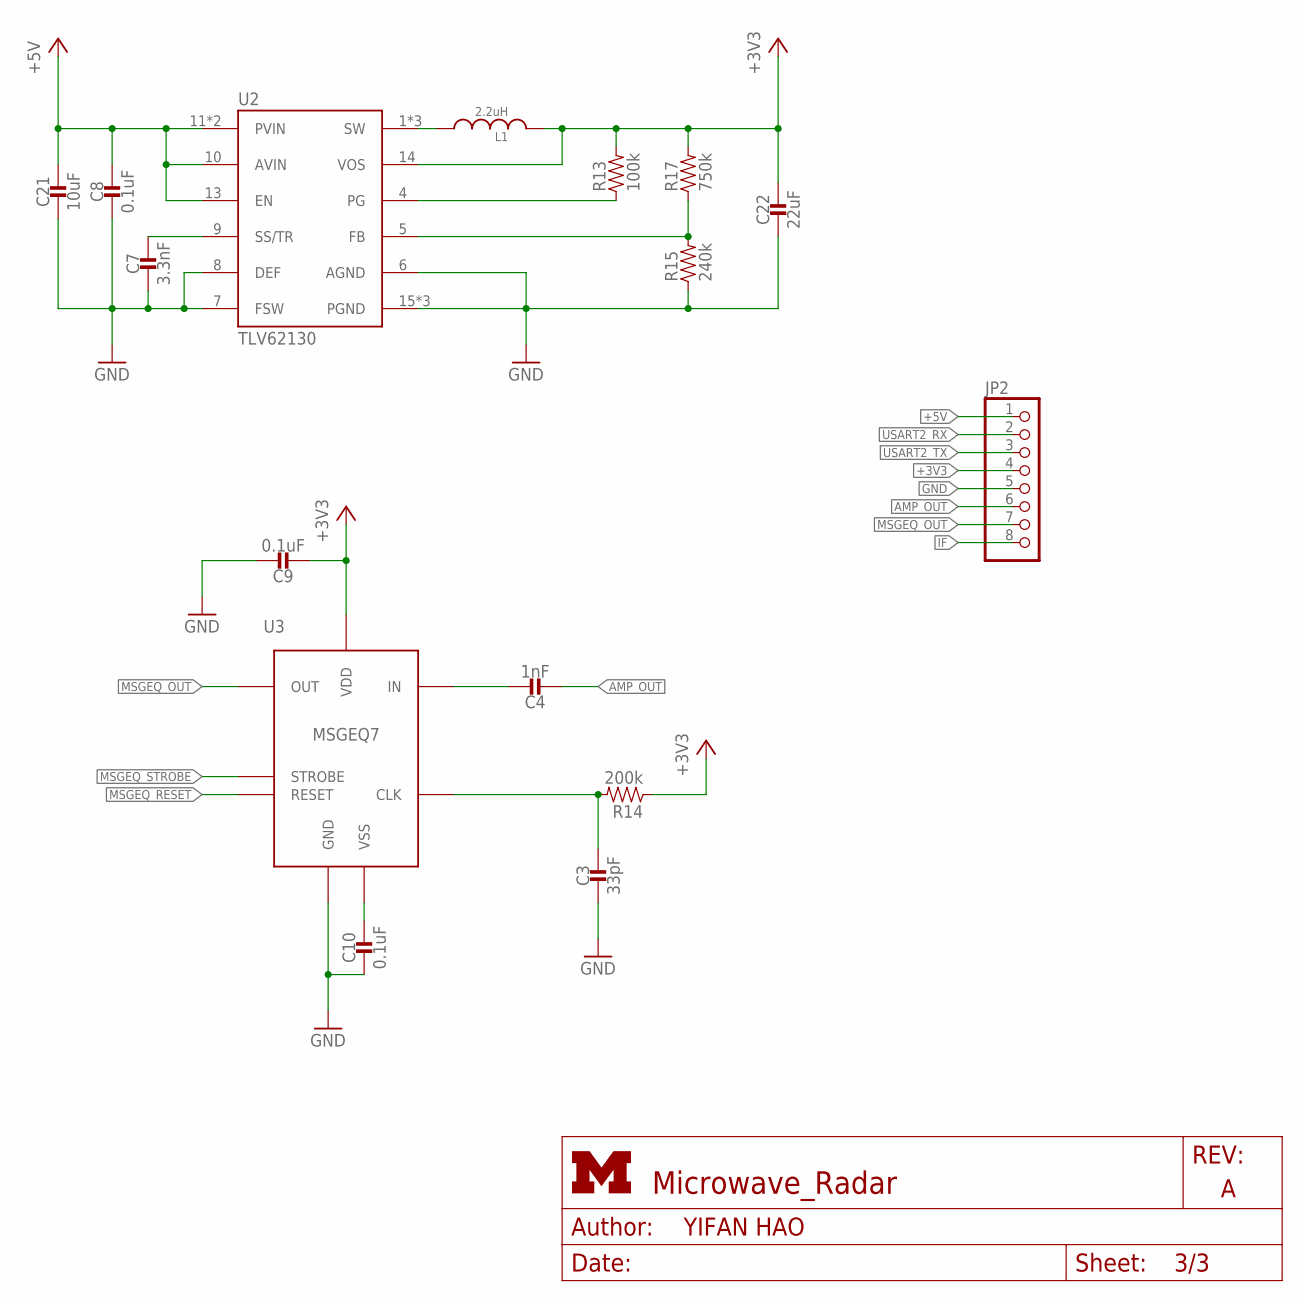
[picture p103: schematic microwave.sch, sheet 3]

Parts:
C3: 33pF; 0603_CAP; DIGIKEY 490-1415-1-ND
C4: 1nF; 0603_CAP; DIGIKEY 490-1494-1-ND
C7: 3.3nF; 0402_CAP; DIGIKEY 490-3248-1-ND
C8: 0.1uF; 0402_CAP; DIGIKEY 490-5920-1-ND
C9, C10: 0.1uF; 0603_CAP; DIGIKEY 490-1532-1-ND
C21: 10uF; 0805_CAP; DIGIKEY 490-5523-1-ND
C22: 22uF; 0603_CAP; DIGIKEY 1276-1193-1-ND
JP2: PINHD-1X8; 1X08
L1: 2.2uH; IHL-1212BZ-11
R13: 100k; 0402_RES; DIGIKEY P100KJCT-ND
R14: 200k; 0603-RES; DIGIKEY RHM200KCFCT-ND
R15: 240k; 0402_RES; DIGIKEY P240KLCT-ND
R17: 750k; 0402_RES; DIGIKEY P750KLCT-ND
U2: TLV62130; TQFN-16/3MM
U3: MSGEQ7; DIP-8

Connections:
+3V3: C9.2, C22.1, JP2.4, L1.P$2 (2), R13.2, R14.1, R17.2, U2.14 (VOS), U3.1 (VDD); also elsewhere on the board
+5V: C8.1, C21.P$1 (1), JP2.1, U2.10 (AVIN), U2.11 (PVIN), U2.12 (PVIN), U2.13 (EN); also elsewhere on the board
AMP_OUT: C4.2, JP2.6; also elsewhere on the board
GND: C3.2, C7.2, C8.2, C9.1, C10.2, C21.P$2 (2), C22.2, JP2.5, R15.1, U2.6 (AGND), U2.7 (FSW), U2.8 (DEF), U2.15 (PGND), U2.16 (PGND), U2.GND, U3.6 (GND); also elsewhere on the board
IF: JP2.8; also elsewhere on the board
MSGEQ_OUT: JP2.7, U3.3 (OUT); also elsewhere on the board
MSGEQ_RESET: U3.7 (RESET); also elsewhere on the board
MSGEQ_STROBE: U3.4 (STROBE); also elsewhere on the board
unnamed: C3.1, R14.2, U3.8 (CLK)
unnamed: C4.1, U3.5 (IN)
unnamed: C10.1, U3.2 (VSS)
unnamed: C7.1, U2.9 (SS/TR)
unnamed: L1.P$1 (1), U2.1 (SW), U2.2 (SW), U2.3 (SW)
unnamed: R13.1, U2.4 (PG)
unnamed: R15.2, R17.1, U2.5 (FB)
USART2_RX: JP2.2; also elsewhere on the board
USART2_TX: JP2.3; also elsewhere on the board

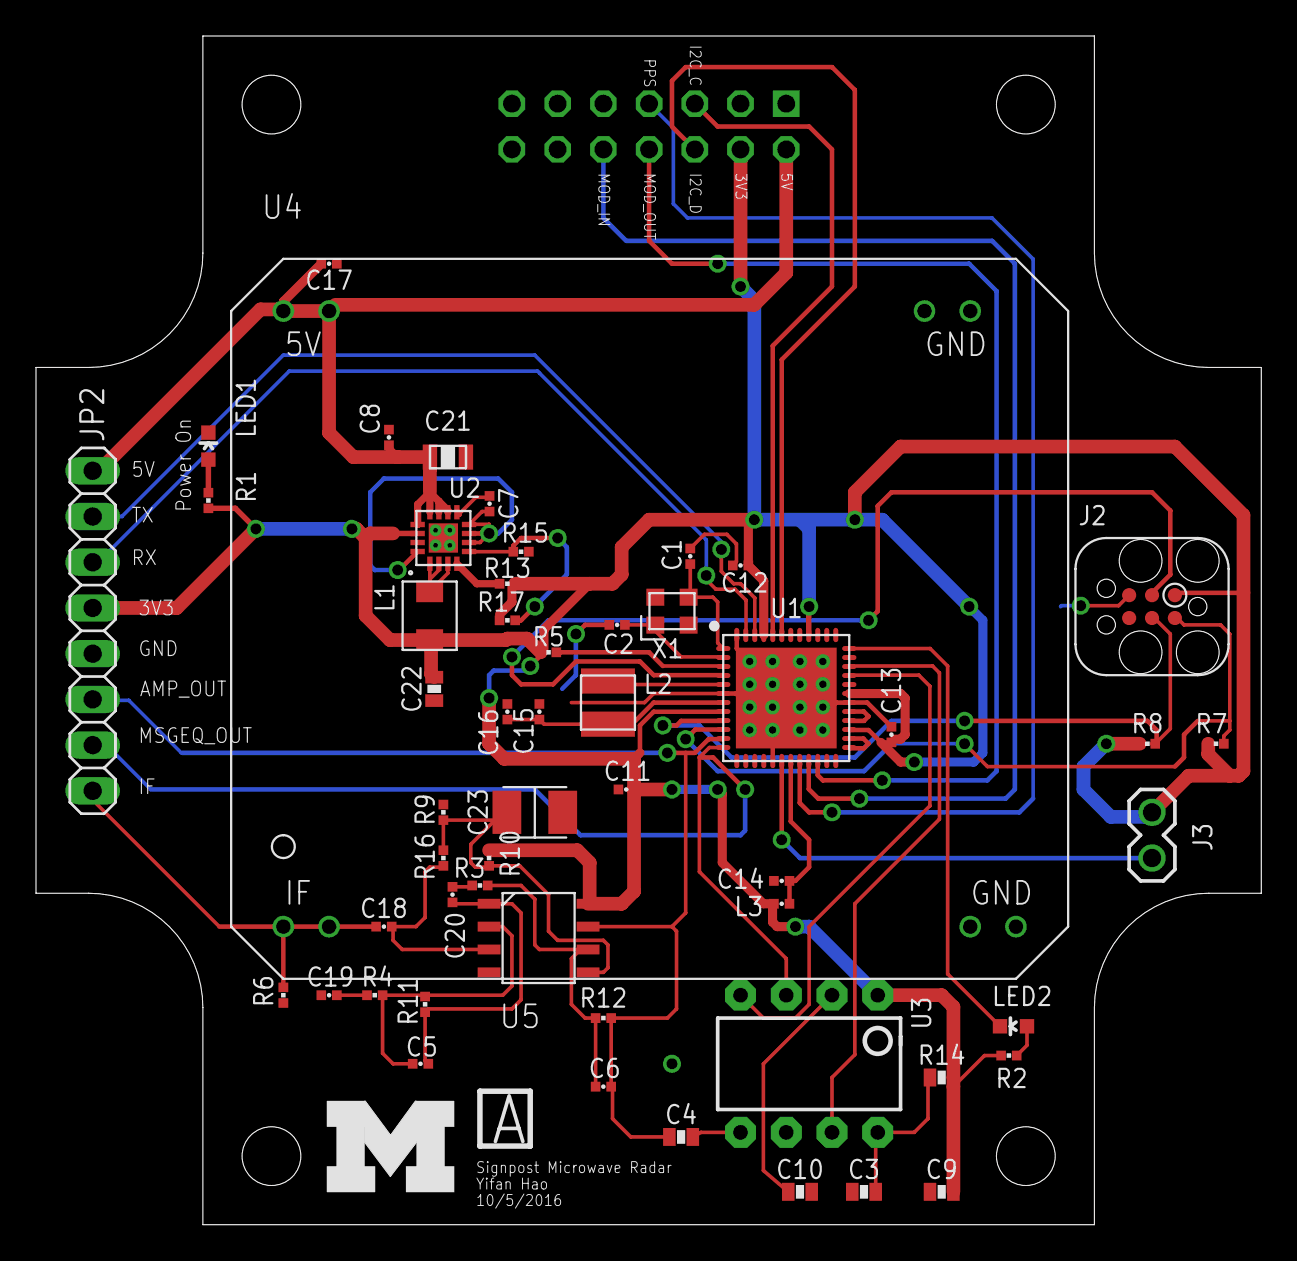
[picture p104: board modules/microwave_radar/hardware/rev_a/microwave.brd from above]

Board: 2 copper layers, 68.1 x 66.0 mm, 56 parts (0 on the bottom side), 44 nets.

Other parts of the board:
U$1: UMICH_SOLID_200MIL
