lab11/signpost/modules/audio_spectrum/rev_a/audio_spectrum.brd

## EAGLE design modules/audio_spectrum/rev_a/audio_spectrum.brd (2016-09-27, an earlier design)

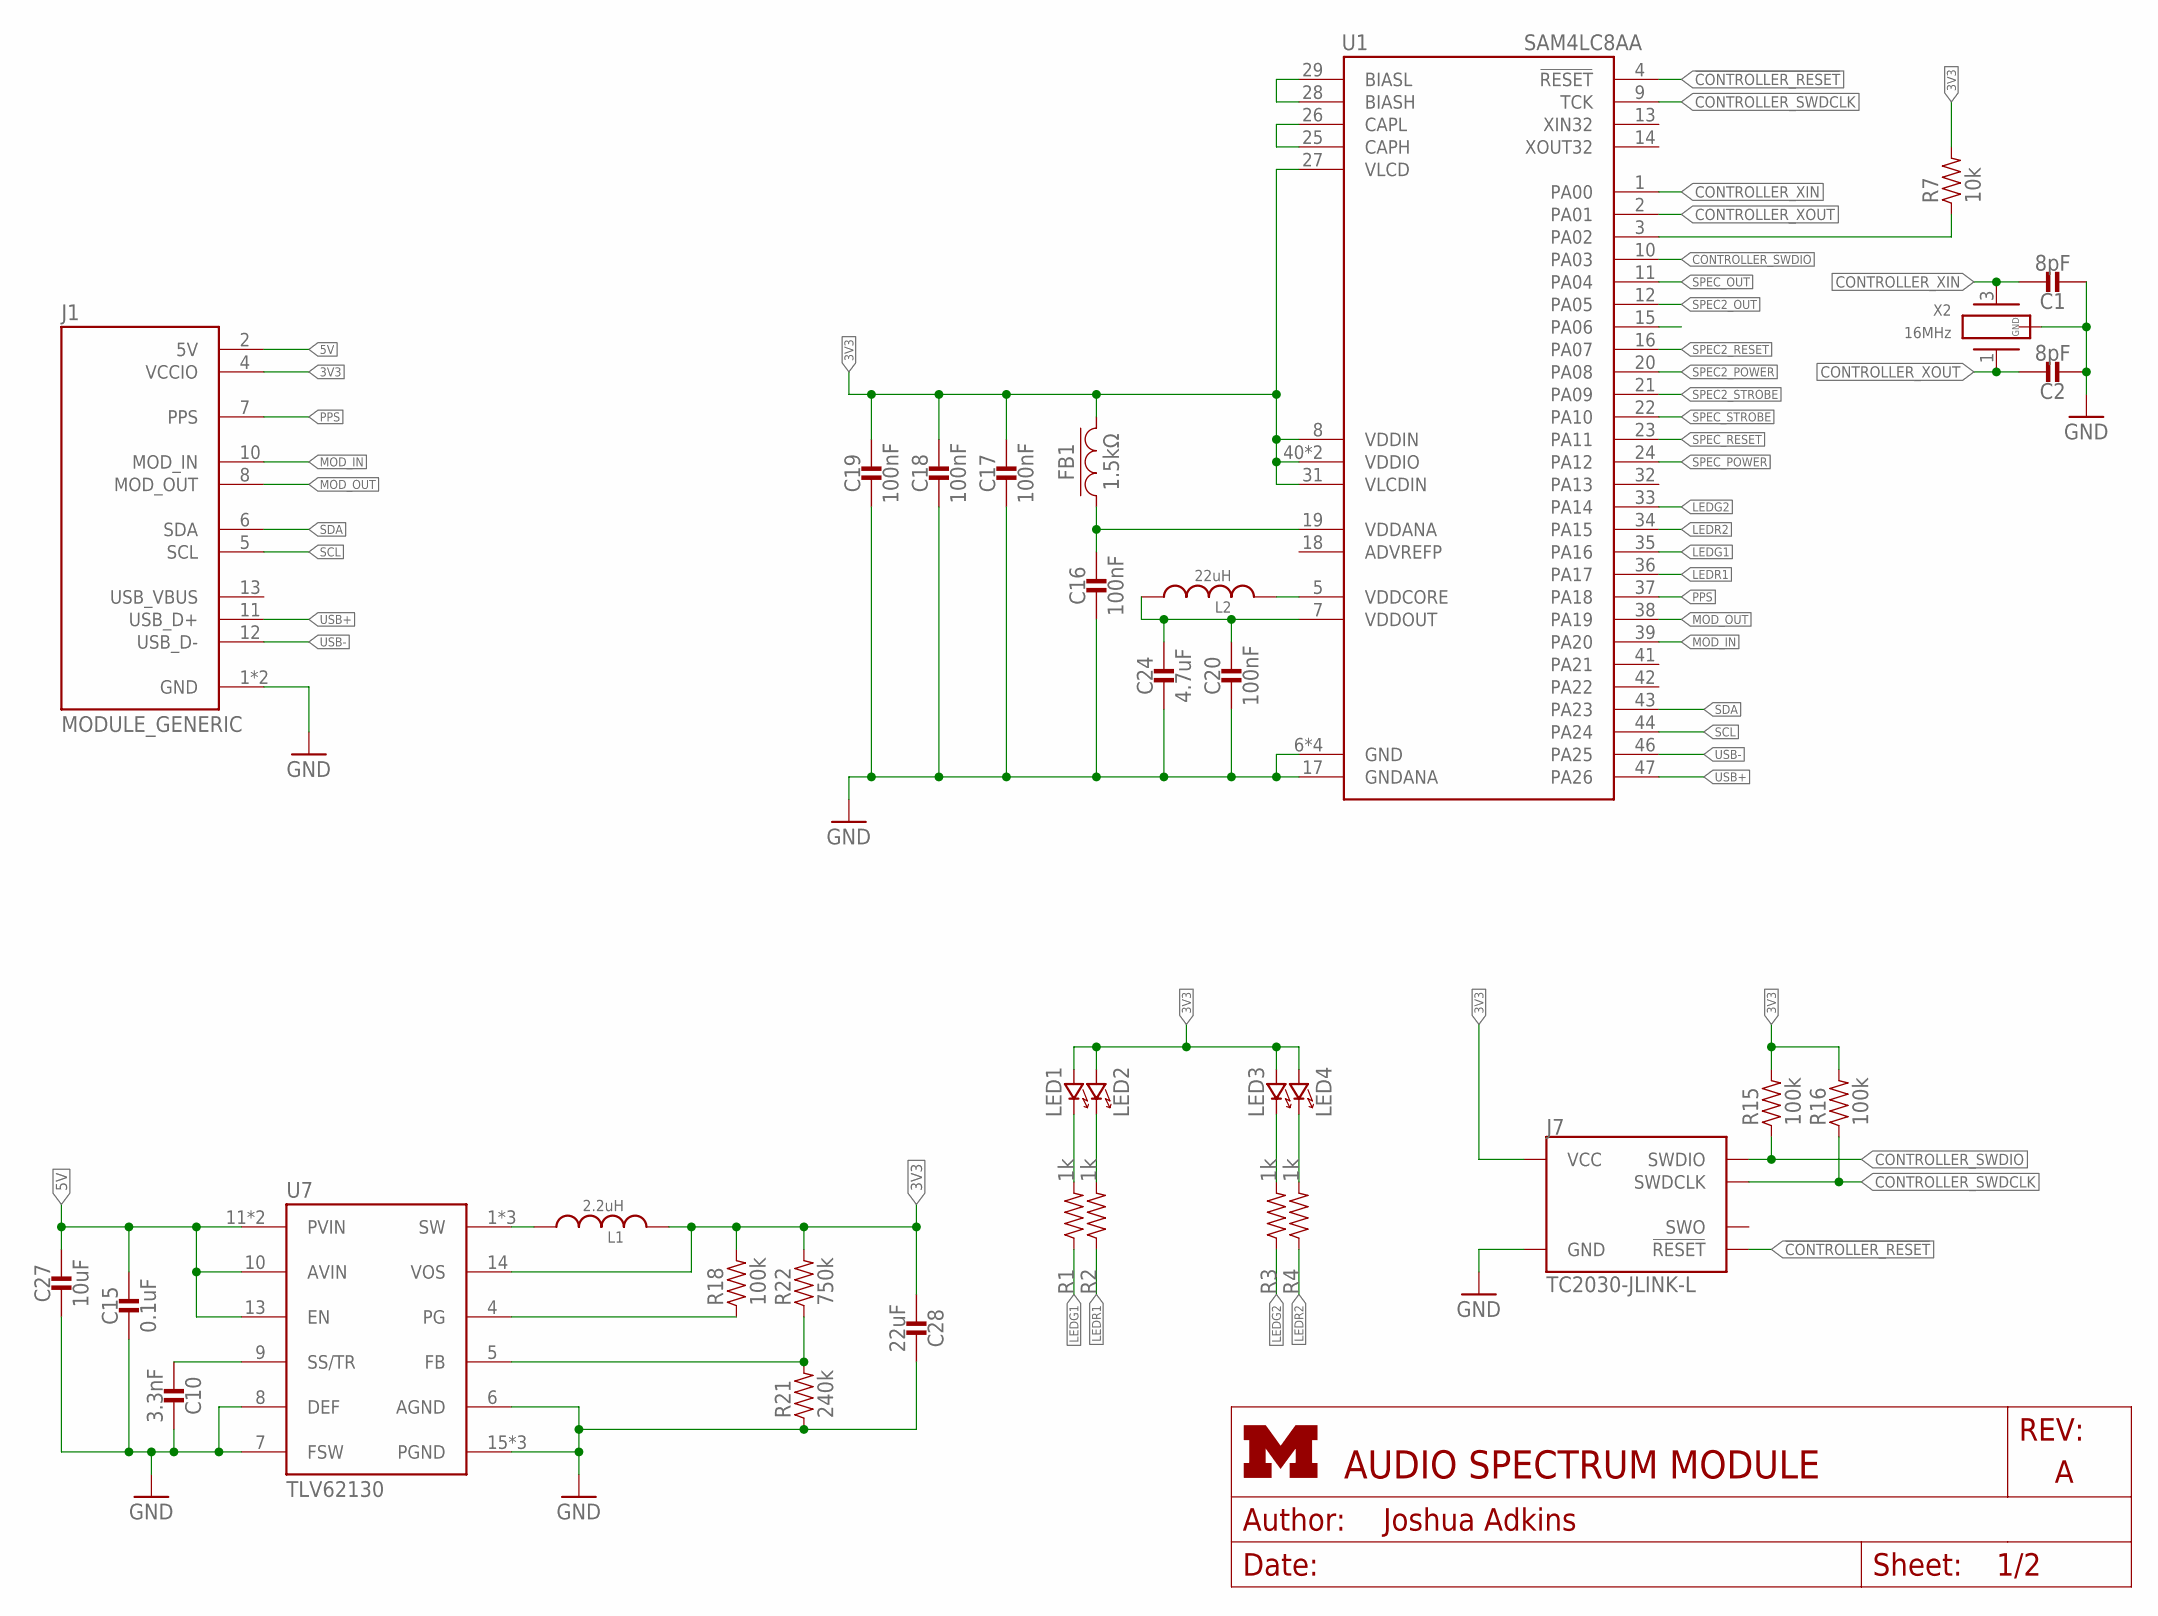
[picture p105: schematic audio_spectrum.sch, sheet 1]

Parts:
C1, C2: 8pF; 0603_CAP; DIGIKEY 490-8230-1-ND
C10: 3.3nF; 0603_CAP
C15: 0.1uF; 0603_CAP
C16, C17, C18, C19, C20: 100nF; 0603_CAP; DIGIKEY 490-10777-1-ND
C24: 4.7uF; 0603_CAP; DIGIKEY 490-13252-1-ND
C27: 10uF; 0603_CAP
C28: 22uF; 0603_CAP
FB1: 1.5kΩ; 0603_CAP; DIGIKEY 490-5216-1-ND
J1: MODULE_GENERIC
J7: TC2030-JLINK-L; TC2030-IDC
L1: 2.2uH; IHL-1212BZ-11
L2: 22uH; 1212
LED1, LED2, LED3, LED4: LED0603; LED-0603
R1, R2, R3, R4: 1k; 0603-RES; DIGIKEY 1276-3431-1-ND
R7: 10k; 0603-RES; DIGIKEY 1276-3431-1-ND
R15, R16: 100k; 0603-RES; DIGIKEY 1276-3432-1-ND
R18: 100k; 0603-RES
R21: 240k; 0603-RES
R22: 750k; 0603-RES
U1: SAM4LC8AA; QFN-48-7MM
U7: TLV62130; TQFN-16/3MM
X2: 16MHz; FHXXX

Connections:
3V3: C17.1, C18.1, C19.1, C28.2, FB1.2, J1.4 (VCCIO), J7.1 (VCC), L1.P$2 (2), LED1.A (ANODE), LED2.A (ANODE), LED3.A (ANODE), LED4.A (ANODE), R7.2, R15.2, R16.2, R18.2, R22.2, U1.8 (VDDIN), U1.27 (VLCD), U1.31 (VLCDIN), U1.40 (VDDIO), U1.45 (VDDIO), U7.14 (VOS); also elsewhere on the board
3VSWOUT: L1.P$1 (1), U7.1 (SW), U7.2 (SW), U7.3 (SW)
5V: C15.1, C27.1, J1.2 (5V), U7.10 (AVIN), U7.11 (PVIN), U7.12 (PVIN), U7.13 (EN)
!CONTROLLER_RESET: J7.3 (!RESET), U1.4 (!RESET)
CONTROLLER_BUCK/LDO_N: R7.1, U1.3 (PA02)
CONTROLLER_SWDCLK: J7.4 (SWDCLK), R16.1, U1.9 (TCK)
CONTROLLER_SWDIO: J7.2 (SWDIO), R15.1, U1.10 (PA03)
CONTROLLER_XIN: C1.1, U1.1 (PA00), X2.3 (2)
CONTROLLER_XOUT: C2.1, U1.2 (PA01), X2.1
GND: C1.2, C2.2, C10.1, C15.2, C16.2, C17.2, C18.2, C19.2, C20.2, C24.2, C27.2, C28.1, J1.1 (GND), J1.14 (GND), J7.5 (GND), R21.1, U1.6 (GND), U1.17 (GNDANA), U1.30 (GND), U1.48 (GND), U1.THERMAL (GND), U7.6 (AGND), U7.7 (FSW), U7.8 (DEF), U7.15 (PGND), U7.16 (PGND), U7.GND, X2.2 (GND), X2.4 (GND); also elsewhere on the board
LEDG1: R1.1, U1.35 (PA16)
LEDG2: R3.1, U1.33 (PA14)
LEDR1: R2.1, U1.36 (PA17)
LEDR2: R4.1, U1.34 (PA15)
MOD_IN: J1.10 (MOD_IN), U1.39 (PA20)
MOD_OUT: J1.8 (MOD_OUT), U1.38 (PA19)
unnamed: LED1.C (CATHODE), R1.2
unnamed: LED2.C (CATHODE), R2.2
unnamed: LED4.C (CATHODE), R4.2
unnamed: C16.1, FB1.1, U1.19 (VDDANA)
unnamed: LED3.C (CATHODE), R3.2
unnamed: C10.2, U7.9 (SS/TR)
unnamed: R18.1, U7.4 (PG)
unnamed: R21.2, R22.1, U7.5 (FB)
unnamed: C20.1, C24.1, L2.P$1 (1), U1.7 (VDDOUT)
unnamed: L2.P$2 (2), U1.5 (VDDCORE)
unnamed: U1.28 (BIASH), U1.29 (BIASL)
unnamed: U1.25 (CAPH), U1.26 (CAPL)
PPS: J1.7 (PPS), U1.37 (PA18)
SCL: J1.5 (SCL), U1.44 (PA24)
SDA: J1.6 (SDA), U1.43 (PA23)
SPEC2_OUT: U1.12 (PA05); also elsewhere on the board
SPEC2_POWER: U1.20 (PA08); also elsewhere on the board
SPEC2_RESET: U1.16 (PA07); also elsewhere on the board
SPEC2_STROBE: U1.21 (PA09); also elsewhere on the board
SPEC_OUT: U1.11 (PA04); also elsewhere on the board
SPEC_POWER: U1.24 (PA12); also elsewhere on the board
SPEC_RESET: U1.23 (PA11); also elsewhere on the board
SPEC_STROBE: U1.22 (PA10); also elsewhere on the board
USB+: J1.11 (USB_D+), U1.47 (PA26)
USB-: J1.12 (USB_D-), U1.46 (PA25)

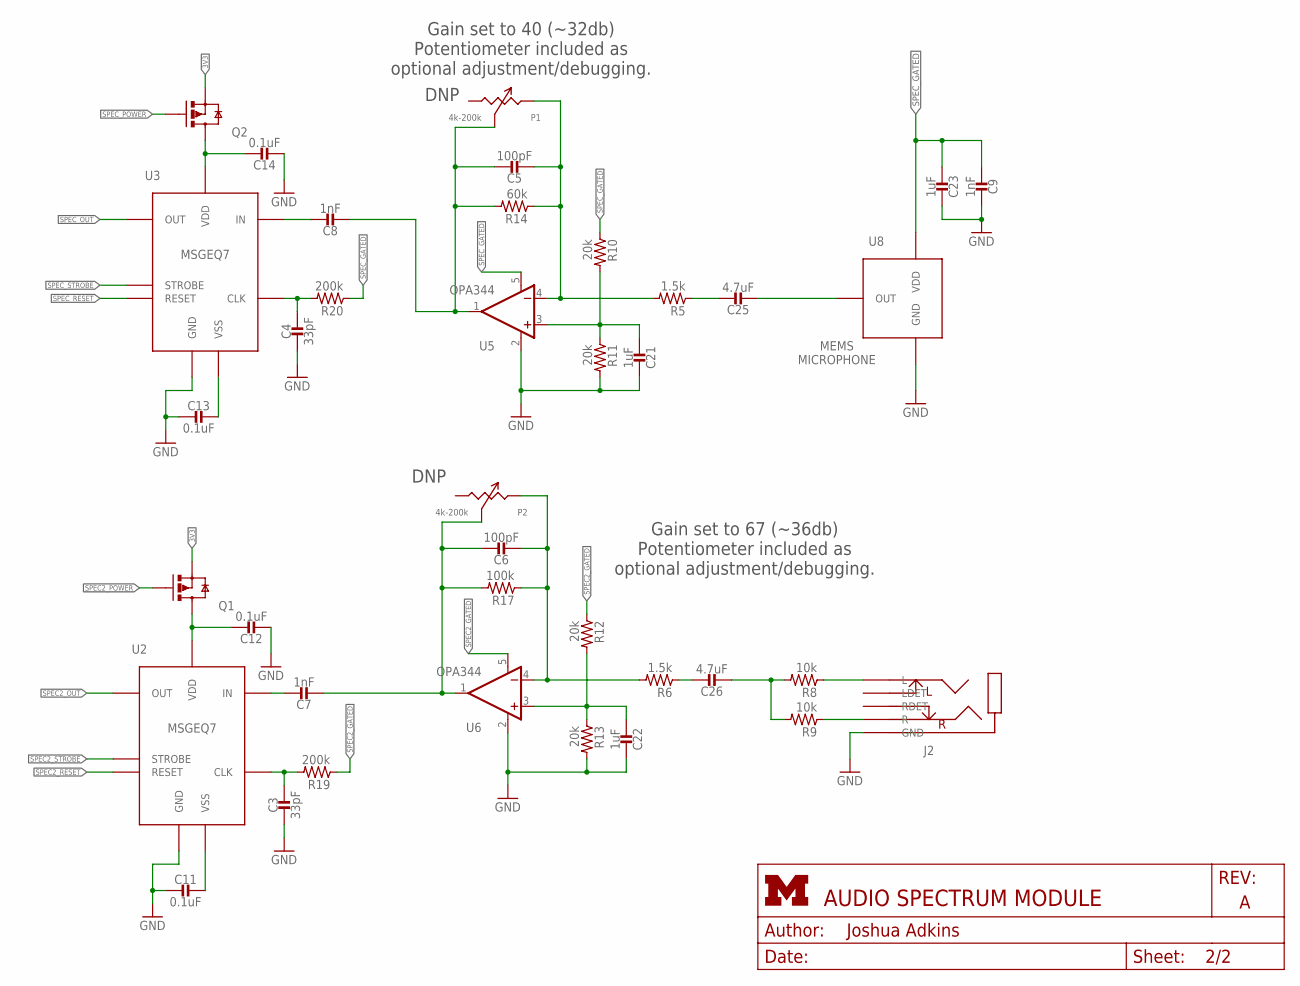
[picture p106: schematic audio_spectrum.sch, sheet 2]

Parts:
C3, C4: 33pF; 0603_CAP
C5, C6: 100pF; 0603_CAP
C7, C8, C9: 1nF; 0603_CAP
C11, C12, C13, C14: 0.1uF; 0603_CAP
C21, C22, C23: 1uF; 0603_CAP
C25, C26: 4.7uF; 0603_CAP
J2: AUDIO-JACK-VERTICAL
P1, P2: 4k-200k; TC33X-2
Q1, Q2: NX3008PBK; SOT23-3
R5, R6: 1.5k; 0603-RES
R8, R9: 10k; 0603-RES
R10, R11, R12, R13: 20k; 0603-RES
R14: 60k; 0603-RES
R17: 100k; 0603-RES
R19, R20: 200k; 0603-RES
U2, U3: MSGEQ7; DIP-8
U5, U6: OPA344; SOT23-5
U8: MP23AB02B

Connections:
3V3: Q1.2 (S), Q2.2 (S); also elsewhere on the board
GND: C3.2, C4.2, C9.1, C11.2, C12.2, C13.2, C14.2, C21.1, C22.1, C23.1, J2.5 (GND), R11.2, R13.2, U2.6 (GND), U3.6 (GND), U5.2 (V-), U6.2 (V-), U8.3 (GND); also elsewhere on the board
unnamed: C11.1, U2.2 (VSS)
unnamed: C3.1, R19.2, U2.8 (CLK)
unnamed: C7.1, U2.5 (IN)
unnamed: C6.1, C7.2, P2.3 (W), R17.2, U6.1 (OUT)
unnamed: C13.1, U3.2 (VSS)
unnamed: C4.1, R20.2, U3.8 (CLK)
unnamed: C8.1, U3.5 (IN)
unnamed: C5.1, C8.2, P1.3 (W), R14.2, U5.1 (OUT)
unnamed: C21.2, R10.2, R11.1, U5.3 (+IN)
unnamed: C26.2, R8.2, R9.2
unnamed: C22.2, R12.2, R13.1, U6.3 (+IN)
unnamed: C5.2, P1.2 (CW), R5.2, R14.1, U5.4 (-IN)
unnamed: C25.1, R5.1
unnamed: C6.2, P2.2 (CW), R6.2, R17.1, U6.4 (-IN)
unnamed: C26.1, R6.1
unnamed: J2.1 (R), R9.1
unnamed: J2.4 (L), R8.1
unnamed: C25.2, U8.1 (OUT)
SPEC2_GATED: C12.1, Q1.3 (D), R12.1, R19.1, U2.1 (VDD), U6.5 (V+)
SPEC2_OUT: U2.3 (OUT); also elsewhere on the board
SPEC2_POWER: Q1.1 (G); also elsewhere on the board
SPEC2_RESET: U2.7 (RESET); also elsewhere on the board
SPEC2_STROBE: U2.4 (STROBE); also elsewhere on the board
SPEC_GATED: C9.2, C14.1, C23.2, Q2.3 (D), R10.1, R20.1, U3.1 (VDD), U5.5 (V+), U8.2 (VDD)
SPEC_OUT: U3.3 (OUT); also elsewhere on the board
SPEC_POWER: Q2.1 (G); also elsewhere on the board
SPEC_RESET: U3.7 (RESET); also elsewhere on the board
SPEC_STROBE: U3.4 (STROBE); also elsewhere on the board

Notes on the sheet:
DNP
Gain set to 40 (~32db) Potentiometer included as optional adjustment/debugging.
Gain set to 67 (~36db) Potentiometer included as optional adjustment/debugging.
