lab11/signpost/modules/audio_spectrum/rev_a/audio_spectrum.brd

## EAGLE design modules/audio_spectrum/rev_a/audio_spectrum.brd (continued)

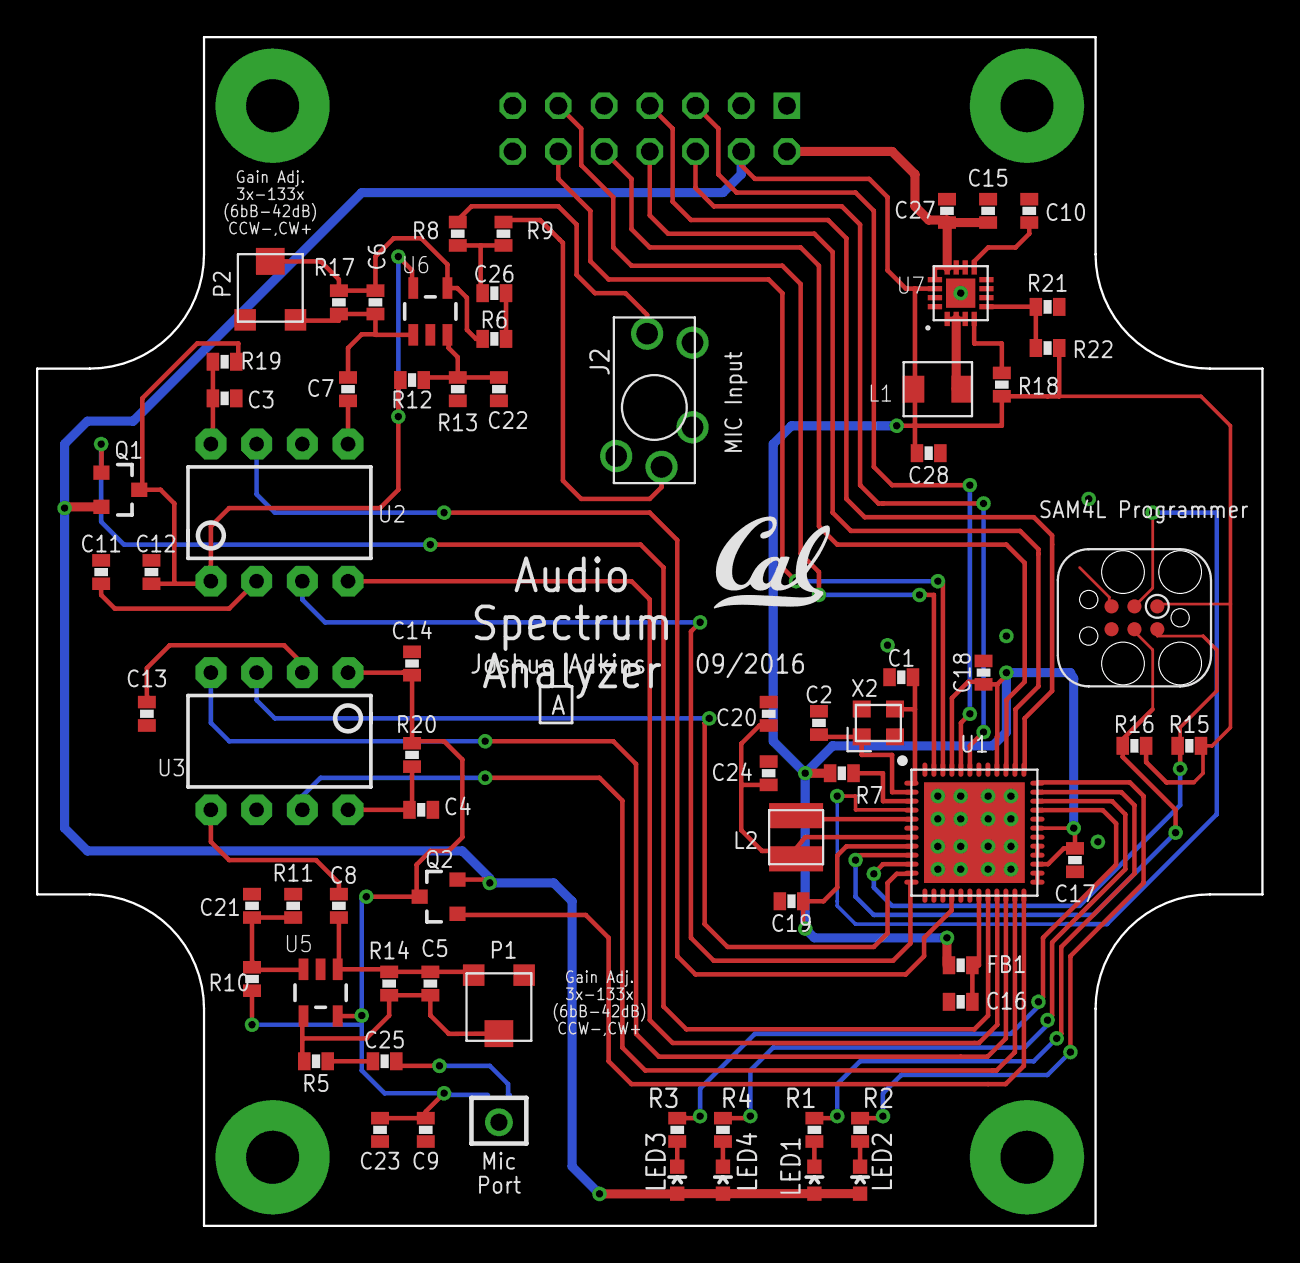
[picture p107: board modules/audio_spectrum/rev_a/audio_spectrum.brd from above]

Board: 2 copper layers, 68.1 x 66.0 mm, 73 parts (1 on the bottom side), 61 nets.

Other parts of the board:
U$2: UCB_CAL_200MIL
