lab11/signpost/hardware/radio_module/rev_a/radio_module.brd

## EAGLE design hardware/radio_module/rev_a/radio_module.brd (2016-09-19, an earlier design)

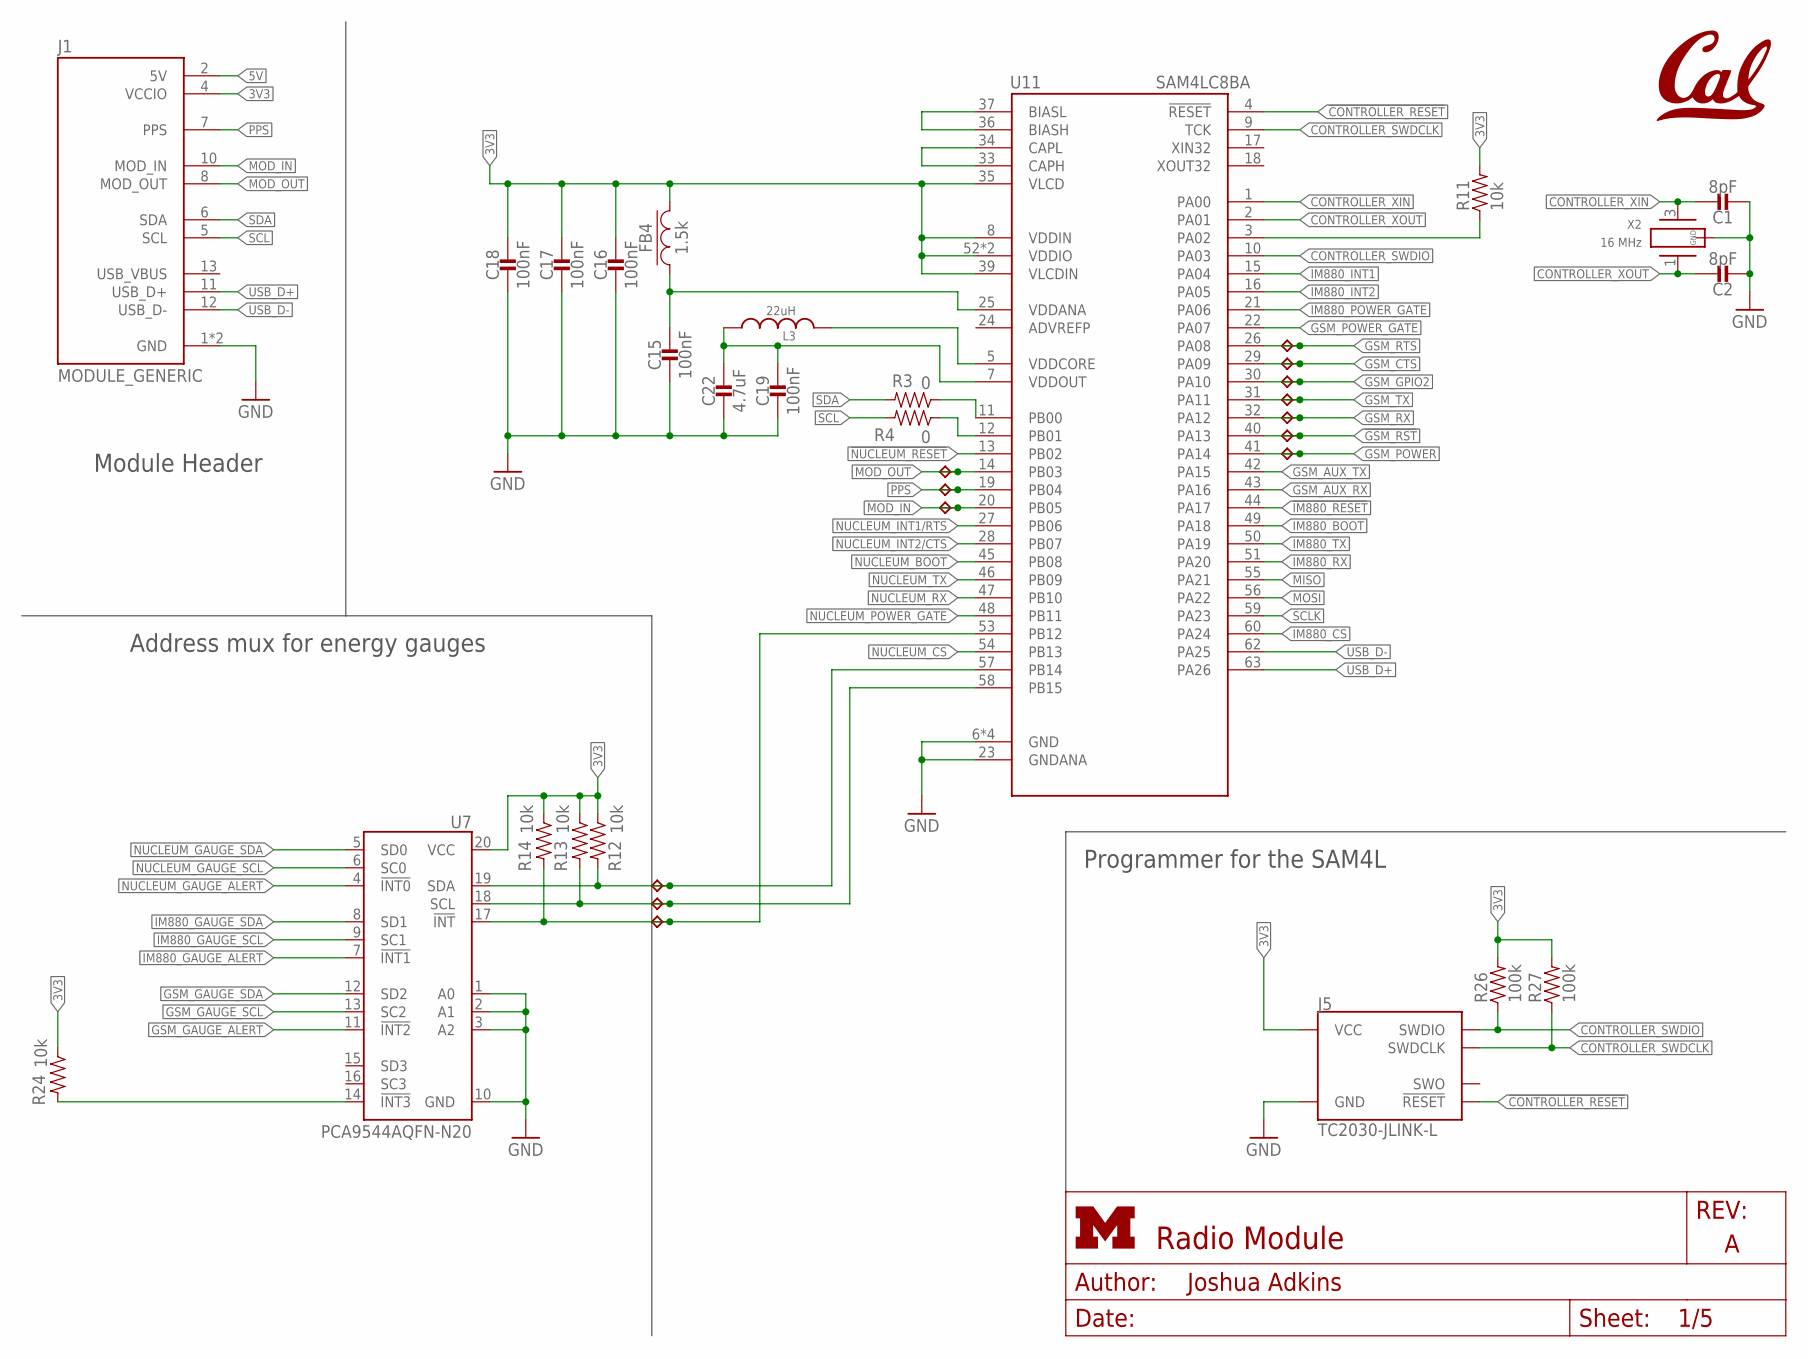
[picture p108: schematic radio_module.sch, sheet 1]

Parts:
C1, C2: 8pF; 0402_CAP; DIGIKEY 490-8230-1-ND
C15, C16, C17, C18, C19: 100nF; 0402_CAP; DIGIKEY 490-10777-1-ND
C22: 4.7uF; 0402_CAP; DIGIKEY 490-13252-1-ND
FB4: 1.5k; 0402_CAP; DIGIKEY 490-5216-1-ND
J1: MODULE_GENERIC
J5: TC2030-JLINK-L; TC2030-IDC
L3: 22uH; 1212
R3, R4: 0; 0402_RES; DIGIKEY 1276-3431-1-ND
R11, R12, R13, R14, R24: 10k; 0402_RES; DIGIKEY 1276-3431-1-ND
R26, R27: 100k; 0402_RES; DIGIKEY 1276-3432-1-ND
TP1, TP2, TP3, TP4, TP5, TP6, TP7, TP8, TP9, TP10, TP11, TP12, TP13: TPB1,27; B1,27
U7: PCA9544AQFN-N20; QFN-N20
U11: SAM4LC8BA; QFN-64-9MM
U$1: UCB_CAL100MIL; UCB_CAL_100MIL
X2: 16 MHz; FHXXX

Connections:
3V3: C16.1, C17.1, C18.1, FB4.2, J1.4 (VCCIO), J5.1 (VCC), R11.2, R12.1, R13.1, R14.1, R24.1, R26.2, R27.2, U7.20 (VCC), U11.8 (VDDIN), U11.35 (VLCD), U11.39 (VLCDIN), U11.52 (VDDIO), U11.61 (VDDIO); also elsewhere on the board
5V: J1.2 (5V); also elsewhere on the board
!CONTROLLER_RESET: J5.3 (!RESET), U11.4 (!RESET)
!GSM_RST: TP7.TP, U11.40 (PA13); also elsewhere on the board
!IM880_RESET: U11.44 (PA17); also elsewhere on the board
!NUCLEUM_RESET: U11.13 (PB02); also elsewhere on the board
ADVREFP: U11.24 (ADVREFP)
CONTROLLER_BUCK/LDO_N: R11.1, U11.3 (PA02)
CONTROLLER_SWDCLK: J5.4 (SWDCLK), R27.1, U11.9 (TCK)
CONTROLLER_SWDIO: J5.2 (SWDIO), R26.1, U11.10 (PA03)
CONTROLLER_XIN: C1.1, U11.1 (PA00), X2.3 (2)
CONTROLLER_XOUT: C2.1, U11.2 (PA01), X2.1
GND: C1.2, C2.2, C15.2, C16.2, C17.2, C18.2, C19.2, C22.2, J1.1 (GND), J1.14 (GND), J5.5 (GND), U7.1 (A0), U7.2 (A1), U7.3 (A2), U7.10 (GND), U11.6 (GND), U11.23 (GNDANA), U11.38 (GND), U11.64 (GND), U11.GND, X2.2 (GND), X2.4 (GND); also elsewhere on the board
GSM_AUX_RX: U11.43 (PA16); also elsewhere on the board
GSM_AUX_TX: U11.42 (PA15); also elsewhere on the board
GSM_CTS: TP11.TP, U11.29 (PA09); also elsewhere on the board
GSM_GAUGE_ALERT: U7.11 (!INT2); also elsewhere on the board
GSM_GAUGE_SCL: U7.13 (SC2); also elsewhere on the board
GSM_GAUGE_SDA: U7.12 (SD2); also elsewhere on the board
GSM_GPIO2: TP10.TP, U11.30 (PA10); also elsewhere on the board
GSM_POWER: TP6.TP, U11.41 (PA14); also elsewhere on the board
GSM_POWER_GATE: U11.22 (PA07); also elsewhere on the board
GSM_RTS: TP12.TP, U11.26 (PA08); also elsewhere on the board
GSM_RX: TP8.TP, U11.32 (PA12); also elsewhere on the board
GSM_TX: TP9.TP, U11.31 (PA11); also elsewhere on the board
IM880_BOOT: U11.49 (PA18); also elsewhere on the board
IM880_CS: U11.60 (PA24); also elsewhere on the board
IM880_GAUGE_ALERT: U7.7 (!INT1); also elsewhere on the board
IM880_GAUGE_SCL: U7.9 (SC1); also elsewhere on the board
IM880_GAUGE_SDA: U7.8 (SD1); also elsewhere on the board
IM880_INT1: U11.15 (PA04); also elsewhere on the board
IM880_INT2: U11.16 (PA05); also elsewhere on the board
IM880_POWER_GATE: U11.21 (PA06); also elsewhere on the board
IM880_RX: U11.51 (PA20); also elsewhere on the board
IM880_TX: U11.50 (PA19); also elsewhere on the board
MISO: U11.55 (PA21); also elsewhere on the board
MOD_IN: J1.10 (MOD_IN), TP3.TP, U11.20 (PB05)
MOD_OUT: J1.8 (MOD_OUT), TP1.TP, U11.14 (PB03)
MOSI: U11.56 (PA22); also elsewhere on the board
unnamed: R14.2, TP13.TP, U7.17 (!INT), U11.53 (PB12)
unnamed: R24.2, U7.14 (!INT3)
unnamed: R3.1, U11.11 (PB00)
unnamed: R4.1, U11.12 (PB01)
unnamed: C15.1, FB4.1, U11.25 (VDDANA)
unnamed: C19.1, C22.1, L3.P$1 (1), U11.7 (VDDOUT)
unnamed: L3.P$2 (2), U11.5 (VDDCORE)
unnamed: U11.36 (BIASH), U11.37 (BIASL)
unnamed: U11.33 (CAPH), U11.34 (CAPL)
NUCLEUM_BOOT: U11.45 (PB08); also elsewhere on the board
NUCLEUM_CS: U11.54 (PB13); also elsewhere on the board
NUCLEUM_GAUGE_ALERT: U7.4 (!INT0); also elsewhere on the board
NUCLEUM_GAUGE_SCL: U7.6 (SC0); also elsewhere on the board
NUCLEUM_GAUGE_SDA: U7.5 (SD0); also elsewhere on the board
NUCLEUM_INT1/RTS: U11.27 (PB06); also elsewhere on the board
NUCLEUM_INT2/CTS: U11.28 (PB07); also elsewhere on the board
NUCLEUM_POWER_GATE: U11.48 (PB11); also elsewhere on the board
NUCLEUM_RX: U11.47 (PB10); also elsewhere on the board
NUCLEUM_TX: U11.46 (PB09); also elsewhere on the board
PPS: J1.7 (PPS), TP2.TP, U11.19 (PB04)
SCL: J1.5 (SCL), R4.2; also elsewhere on the board
SCLK: U11.59 (PA23); also elsewhere on the board
SCL_INTERNAL: R13.2, TP5.TP, U7.18 (SCL), U11.58 (PB15)
SDA: J1.6 (SDA), R3.2; also elsewhere on the board
SDA_INTERNAL: R12.2, TP4.TP, U7.19 (SDA), U11.57 (PB14)
USB_D+: J1.11 (USB_D+), U11.63 (PA26)
USB_D-: J1.12 (USB_D-), U11.62 (PA25)

Notes on the sheet:
Module Header
Address mux for energy gauges
Programmer for the SAM4L

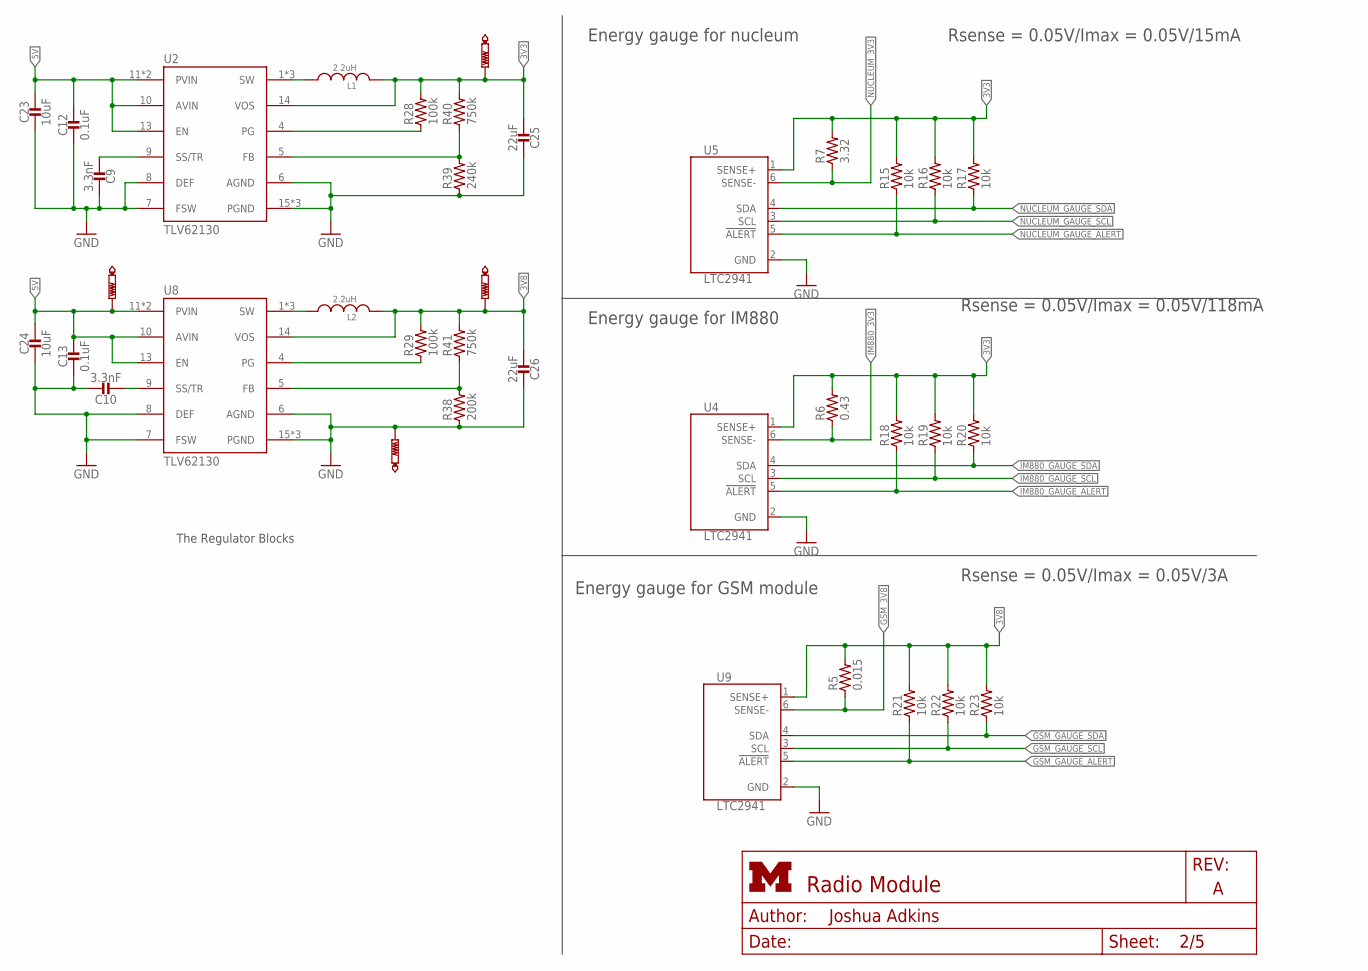
[picture p109: schematic radio_module.sch, sheet 2]

Parts:
C9, C10: 3.3nF; 0402_CAP
C12, C13: 0.1uF; 0402_CAP
C23, C24: 10uF; 0402_CAP
C25, C26: 22uF; 0402_CAP
L1, L2: 2.2uH; IHL-1212BZ-11
R5: 0.015; 0603-RES
R6: 0.43; 0402_RES
R7: 3.32; 0402_RES
R15, R16, R17, R18, R19, R20, R21, R22, R23: 10k; 0402_RES
R28, R29: 100k; 0402_RES
R38: 200k; 0402_RES
R39: 240k; 0402_RES
R40, R41: 750k; 0402_RES
TP14, TP15, TP16, TP17: PTR1PAD1-13; P1-13
U2, U8: TLV62130; TQFN-16/3MM
U4, U5, U9: LTC2941; DFN-6-2MMX3MM

Connections:
3V3: C25.2, L1.P$2 (2), R6.2, R7.2, R15.2, R16.2, R17.2, R18.2, R19.2, R20.2, R28.2, R40.2, TP17.TP, U2.14 (VOS), U4.1 (SENSE+), U5.1 (SENSE+); also elsewhere on the board
3V8: C26.2, L2.P$2 (2), R5.2, R21.2, R22.2, R23.2, R29.2, R41.2, TP14.TP, U8.14 (VOS), U9.1 (SENSE+)
3V8SWOUT: L2.P$1 (1), U8.1 (SW), U8.2 (SW), U8.3 (SW)
3VSWOUT: L1.P$1 (1), U2.1 (SW), U2.2 (SW), U2.3 (SW)
5V: C12.1, C13.1, C23.1, C24.1, TP16.TP, U2.10 (AVIN), U2.11 (PVIN), U2.12 (PVIN), U2.13 (EN), U8.10 (AVIN), U8.11 (PVIN), U8.12 (PVIN), U8.13 (EN); also elsewhere on the board
GND: C9.1, C10.1, C12.2, C13.2, C23.2, C24.2, C25.1, C26.1, R38.1, R39.1, TP15.TP, U2.6 (AGND), U2.7 (FSW), U2.8 (DEF), U2.15 (PGND), U2.16 (PGND), U2.GND, U4.2 (GND), U5.2 (GND), U8.6 (AGND), U8.7 (FSW), U8.8 (DEF), U8.15 (PGND), U8.16 (PGND), U8.GND, U9.2 (GND); also elsewhere on the board
GSM_3V8: R5.1, U9.6 (SENSE-); also elsewhere on the board
GSM_GAUGE_ALERT: R21.1, U9.5 (!ALERT); also elsewhere on the board
GSM_GAUGE_SCL: R22.1, U9.3 (SCL); also elsewhere on the board
GSM_GAUGE_SDA: R23.1, U9.4 (SDA); also elsewhere on the board
IM880_3V3: R6.1, U4.6 (SENSE-); also elsewhere on the board
IM880_GAUGE_ALERT: R18.1, U4.5 (!ALERT); also elsewhere on the board
IM880_GAUGE_SCL: R19.1, U4.3 (SCL); also elsewhere on the board
IM880_GAUGE_SDA: R20.1, U4.4 (SDA); also elsewhere on the board
unnamed: C9.2, U2.9 (SS/TR)
unnamed: R28.1, U2.4 (PG)
unnamed: R39.2, R40.1, U2.5 (FB)
unnamed: C10.2, U8.9 (SS/TR)
unnamed: R29.1, U8.4 (PG)
unnamed: R38.2, R41.1, U8.5 (FB)
NUCLEUM_3V3: R7.1, U5.6 (SENSE-); also elsewhere on the board
NUCLEUM_GAUGE_ALERT: R15.1, U5.5 (!ALERT); also elsewhere on the board
NUCLEUM_GAUGE_SCL: R16.1, U5.3 (SCL); also elsewhere on the board
NUCLEUM_GAUGE_SDA: R17.1, U5.4 (SDA); also elsewhere on the board

Notes on the sheet:
The Regulator Blocks
Energy gauge for nucleum
Energy gauge for IM880
Energy gauge for GSM module
Rsense = 0.05V/Imax = 0.05V/15mA
Rsense = 0.05V/Imax = 0.05V/118mA
Rsense = 0.05V/Imax = 0.05V/3A

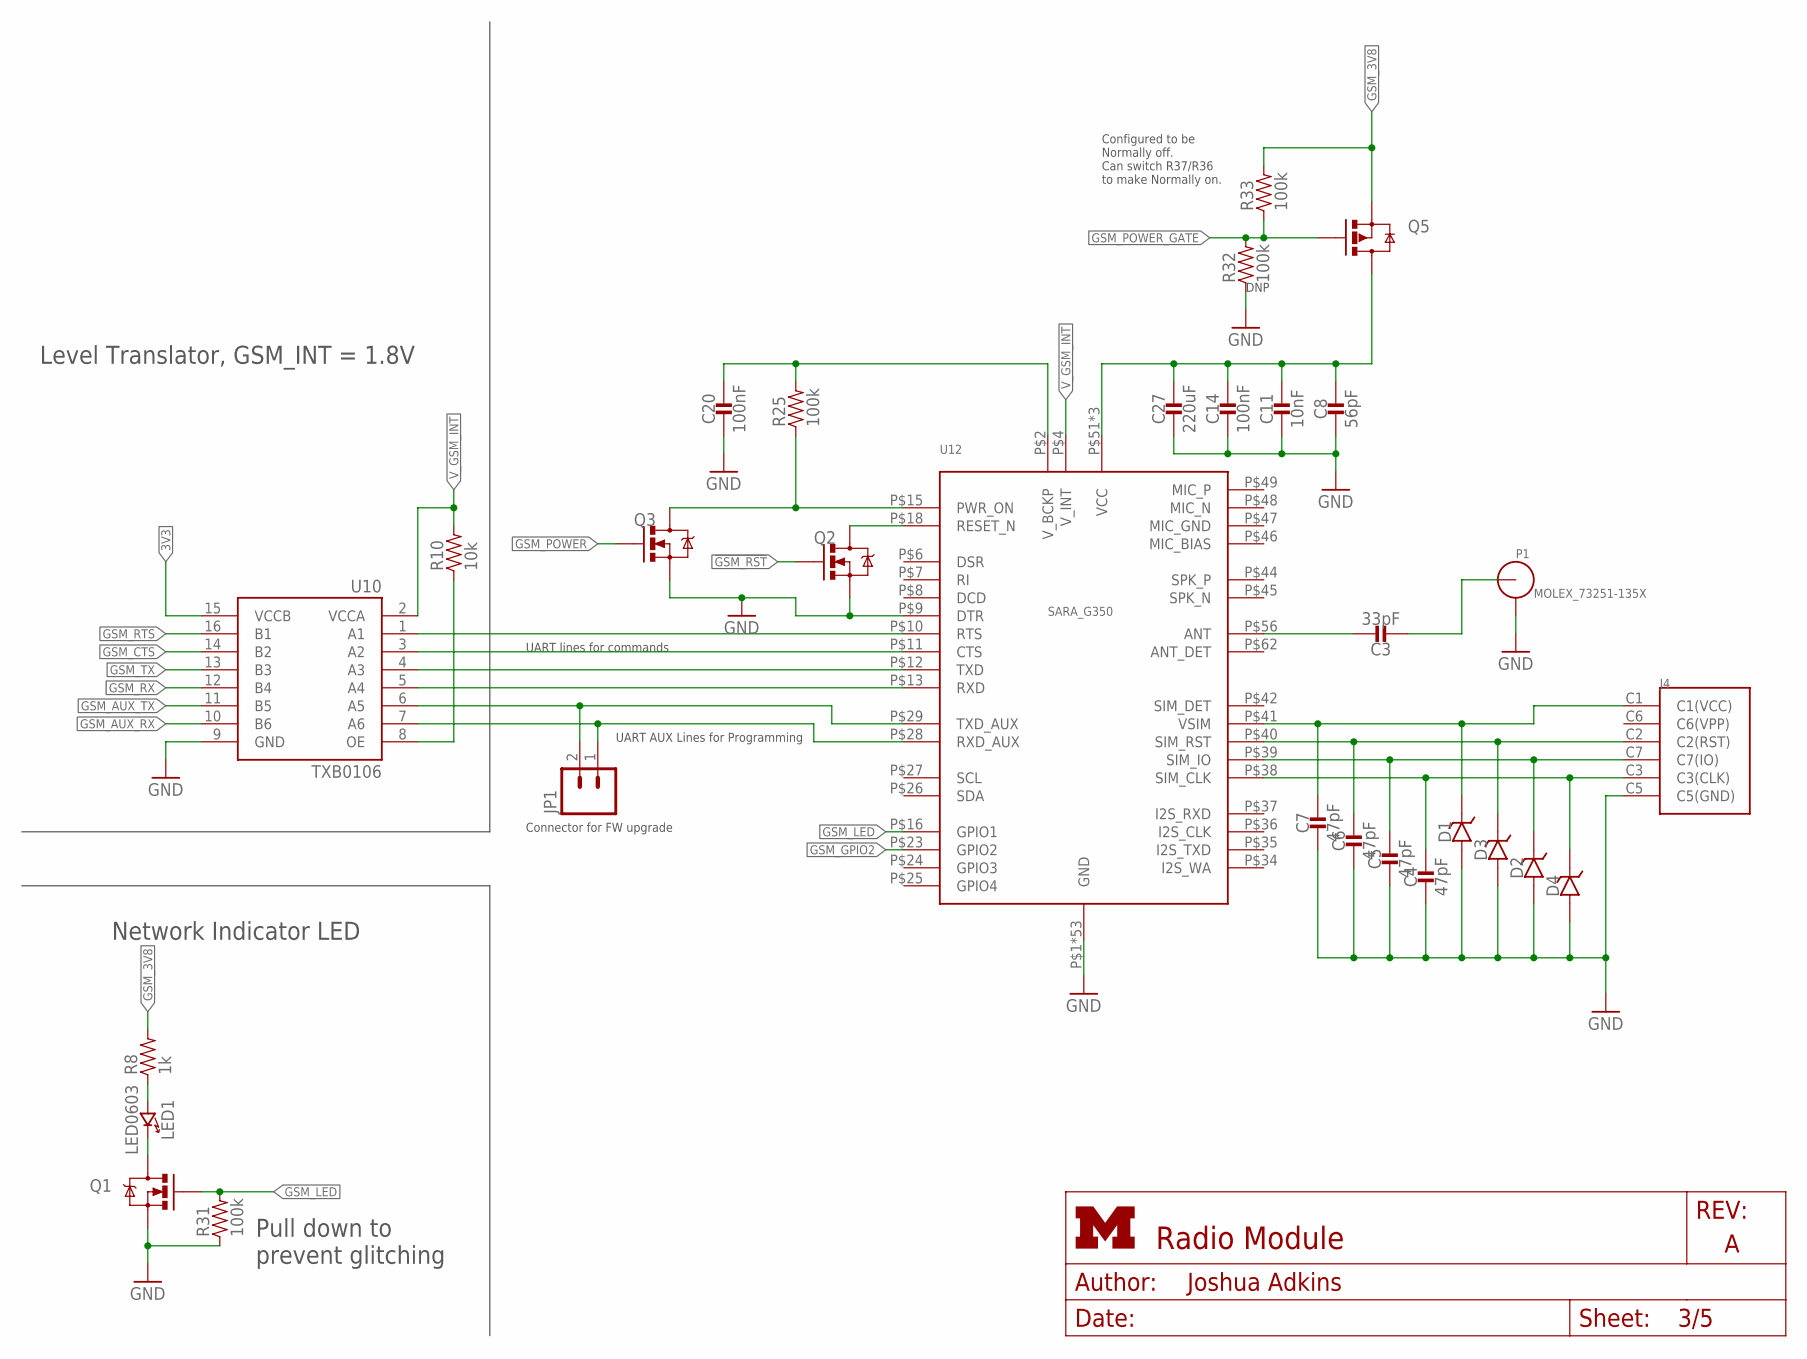
[picture p110: schematic radio_module.sch, sheet 3]

Parts:
C3: 33pF; 0603_CAP
C4, C5, C6, C7: 47pF; 0402_CAP
C8: 56pF; 0402_CAP
C11: 10nF; 0402_CAP
C14, C20: 100nF; 0402_CAP
C27: 220uF; 1210_CAP
D1: 14V; 0402_DIODE
D2, D3, D4: DIODE_ZENER; 0402_DIODE
J4: NANO_SIM; WURTH_NANO_SIM
JP1: M02PTH; 1X02
LED1: LED0603; LED-0603
P1: MOLEX_73251-135X; SMA-J/PCB
Q1, Q2, Q3: MOSFET-NCHANNELXFDN-3; XFDFN-3
Q5: SI223DDS; SOT23-3
R8: 1k; 0402_RES
R10: 10k; 0402_RES
R25, R31, R32, R33: 100k; 0402_RES
U10: TXB0106; R-PVQFN-N16
U12: UBLOX_SARA_G350; UBLOX_SARA_G3

Connections:
3V3: U10.15 (VCCB); also elsewhere on the board
!GSM_RST: Q2.G; also elsewhere on the board
GND: C4.2, C5.2, C6.2, C7.2, C8.2, C11.2, C14.2, C20.2, C27.2, D1.ANODE, D2.ANODE, D3.ANODE, D4.ANODE, J4.C5 (C5(GND)), P1.2, P1.3, P1.4, P1.5, Q1.S, Q2.S, Q3.S, R31.1, R32.1, U10.9 (GND), U12.P65 (GND), U12.P66 (GND), U12.P67 (GND), U12.P68 (GND), U12.P69 (GND), U12.P70 (GND), U12.P71 (GND), U12.P72 (GND), U12.P73 (GND), U12.P74 (GND), U12.P75 (GND), U12.P76 (GND), U12.P77 (GND), U12.P78 (GND), U12.P79 (GND), U12.P80 (GND), U12.P81 (GND), U12.P82 (GND), U12.P83 (GND), U12.P84 (GND), U12.P85 (GND), U12.P86 (GND), U12.P87 (GND), U12.P88 (GND), U12.P89 (GND), U12.P90 (GND), U12.P91 (GND), U12.P92 (GND), U12.P93 (GND), U12.P94 (GND), U12.P95 (GND), U12.P96 (GND), U12.P$1 (GND), U12.P$3 (GND), U12.P$5 (GND), U12.P$9 (DTR), U12.P$14 (GND), U12.P$20 (GND), U12.P$21 (GND), U12.P$22 (GND), U12.P$30 (GND), U12.P$32 (GND), U12.P$33 (GND), U12.P$43 (GND), U12.P$50 (GND), U12.P$54 (GND), U12.P$55 (GND), U12.P$57 (GND), U12.P$58 (GND), U12.P$59 (GND), U12.P$60 (GND), U12.P$61 (GND), U12.P$63 (GND), U12.P$64 (GND); also elsewhere on the board
GSM_3V8: Q5.2 (S), R8.2, R33.2; also elsewhere on the board
GSM_AUX_RX: U10.10 (B6); also elsewhere on the board
GSM_AUX_TX: U10.11 (B5); also elsewhere on the board
GSM_CTS: U10.14 (B2); also elsewhere on the board
GSM_GATED: C8.1, C11.1, C14.1, C27.1, Q5.3 (D), U12.P$51 (VCC), U12.P$52 (VCC), U12.P$53 (VCC)
GSM_GPIO2: U12.P$23 (GPIO2); also elsewhere on the board
GSM_LED: Q1.G, R31.2, U12.P$16 (GPIO1)
GSM_POWER: Q3.G; also elsewhere on the board
GSM_POWER_GATE: Q5.1 (G), R32.2, R33.1; also elsewhere on the board
GSM_RTS: U10.16 (B1); also elsewhere on the board
GSM_RX: U10.12 (B4); also elsewhere on the board
GSM_TX: U10.13 (B3); also elsewhere on the board
unnamed: C7.1, D1.CATHODE, J4.C1 (C1(VCC)), U12.P$41 (VSIM)
unnamed: C6.1, D3.CATHODE, J4.C2 (C2(RST)), U12.P$40 (SIM_RST)
unnamed: C5.1, D2.CATHODE, J4.C7 (C7(IO)), U12.P$39 (SIM_IO)
unnamed: C4.1, D4.CATHODE, J4.C3 (C3(CLK)), U12.P$38 (SIM_CLK)
unnamed: R10.1, U10.8 (OE)
unnamed: C3.1, U12.P$56 (ANT)
unnamed: C3.2, P1.1 (ANT)
unnamed: LED1.A (ANODE), R8.1
unnamed: U10.4 (A3), U12.P$12 (TXD)
unnamed: U10.5 (A4), U12.P$13 (RXD)
unnamed: LED1.C (CATHODE), Q1.D
unnamed: Q2.D, U12.P$18 (RESET_N)
unnamed: C20.1, R25.2, U12.P$2 (V_BCKP)
unnamed: Q3.D, R25.1, U12.P$15 (PWR_ON)
unnamed: JP1.2, U10.6 (A5), U12.P$29 (TXD_AUX)
unnamed: JP1.1, U10.7 (A6), U12.P$28 (RXD_AUX)
unnamed: U10.3 (A2), U12.P$11 (CTS)
unnamed: U10.1 (A1), U12.P$10 (RTS)
V_GSM_INT: R10.2, U10.2 (VCCA), U12.P$4 (V_INT)

Notes on the sheet:
Pull down to prevent glitching
Network Indicator LED
Level Translator, GSM_INT = 1.8V
UART AUX Lines for Programming
UART lines for commands
DNP
Configured to be Normally off. Can switch R37/R36 to make Normally on.
Connector for FW upgrade

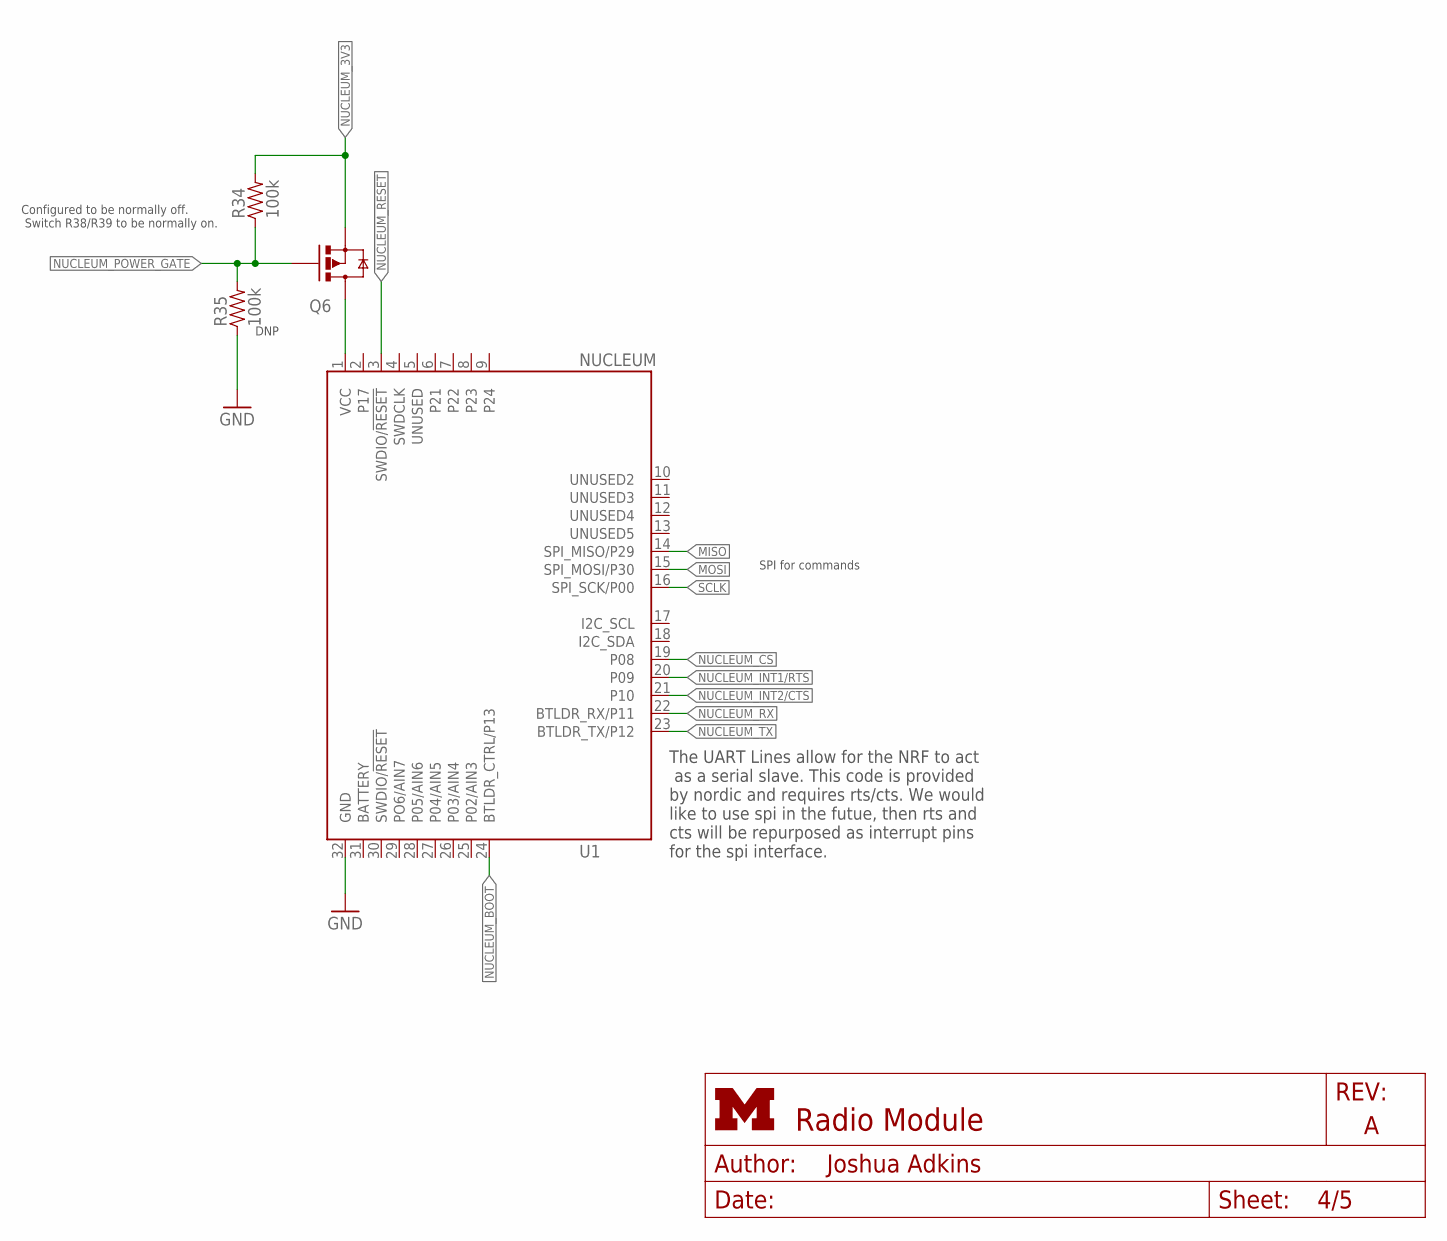
[picture p111: schematic radio_module.sch, sheet 4]

Parts:
Q6: SI223DDS; SOT23-3
R34, R35: 100k; 0402_RES
U1: NUCLEUM

Connections:
!NUCLEUM_RESET: U1.3 (SWDIO/!RESET); also elsewhere on the board
GND: R35.1, U1.32 (GND); also elsewhere on the board
MISO: U1.14 (SPI_MISO/P29); also elsewhere on the board
MOSI: U1.15 (SPI_MOSI/P30); also elsewhere on the board
unnamed: Q6.3 (D), U1.1 (VCC)
NUCLEUM_3V3: Q6.2 (S), R34.2; also elsewhere on the board
NUCLEUM_BOOT: U1.24 (BTLDR_CTRL/P13); also elsewhere on the board
NUCLEUM_CS: U1.19 (P08); also elsewhere on the board
NUCLEUM_INT1/RTS: U1.20 (P09); also elsewhere on the board
NUCLEUM_INT2/CTS: U1.21 (P10); also elsewhere on the board
NUCLEUM_POWER_GATE: Q6.1 (G), R34.1, R35.2; also elsewhere on the board
NUCLEUM_RX: U1.22 (BTLDR_RX/P11); also elsewhere on the board
NUCLEUM_TX: U1.23 (BTLDR_TX/P12); also elsewhere on the board
SCLK: U1.16 (SPI_SCK/P00); also elsewhere on the board

Notes on the sheet:
SPI for commands
DNP
Configured to be normally off. Switch R38/R39 to be normally on.
The UART Lines allow for the NRF to act as a serial slave. This code is provided by nordic and requires rts/cts. We would like to use spi in the futue, then rts and cts will be repurposed as interrupt pins for the spi interface.

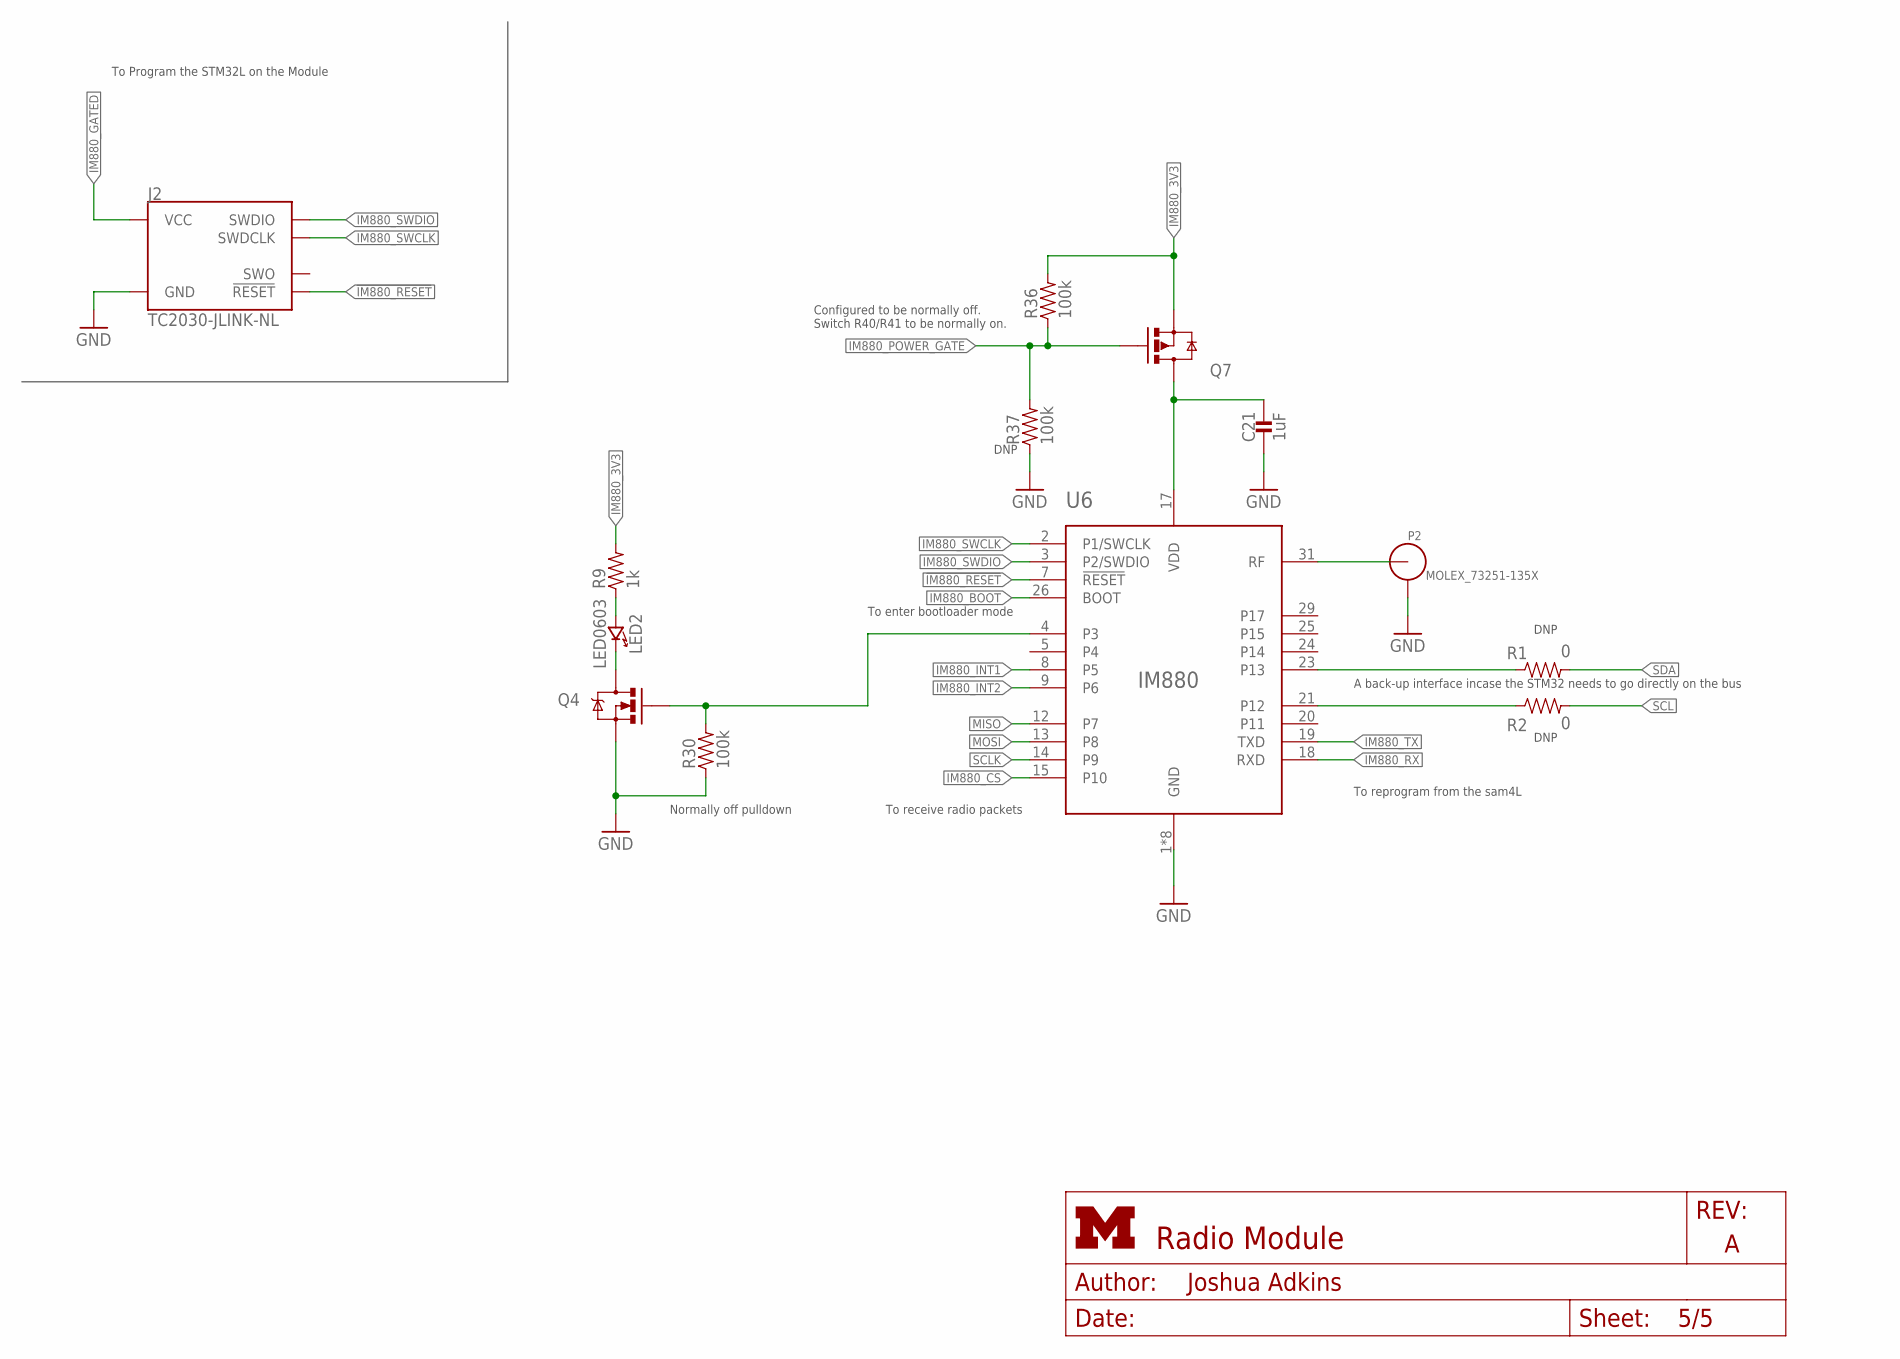
[picture p112: schematic radio_module.sch, sheet 5]

Parts:
C21: 1uF; 0402_CAP
J2: TC2030-JLINK-NL; TC2030-IDC-NL
LED2: LED0603; LED-0603
P2: MOLEX_73251-135X; SMA-J/PCB
Q4: MOSFET-NCHANNELXFDN-3; XFDFN-3
Q7: SI223DDS; SOT23-3
R1, R2: 0; 0402_RES
R9: 1k; 0402_RES
R30, R36, R37: 100k; 0402_RES
U6: IM880_MODULE

Connections:
!IM880_RESET: J2.3 (!RESET), U6.7 (!RESET); also elsewhere on the board
GND: C21.2, J2.5 (GND), P2.2, P2.3, P2.4, P2.5, Q4.S, R30.1, R37.1, U6.1 (GND), U6.6 (GND), U6.11 (GND), U6.16 (GND), U6.22 (GND), U6.27 (GND), U6.30 (GND), U6.32 (GND); also elsewhere on the board
IM880_3V3: Q7.2 (S), R9.2, R36.2; also elsewhere on the board
IM880_BOOT: U6.26 (BOOT); also elsewhere on the board
IM880_CS: U6.15 (P10); also elsewhere on the board
IM880_GATED: C21.1, J2.1 (VCC), Q7.3 (D), U6.17 (VDD)
IM880_INT1: U6.8 (P5); also elsewhere on the board
IM880_INT2: U6.9 (P6); also elsewhere on the board
IM880_NETWORK: Q4.G, R30.2, U6.4 (P3)
IM880_POWER_GATE: Q7.1 (G), R36.1, R37.2; also elsewhere on the board
IM880_RX: U6.18 (RXD); also elsewhere on the board
IM880_SWCLK: J2.4 (SWDCLK), U6.2 (P1/SWCLK)
IM880_SWDIO: J2.2 (SWDIO), U6.3 (P2/SWDIO)
IM880_TX: U6.19 (TXD); also elsewhere on the board
MISO: U6.12 (P7); also elsewhere on the board
MOSI: U6.13 (P8); also elsewhere on the board
unnamed: P2.1 (ANT), U6.31 (RF)
unnamed: R1.1, U6.23 (P13)
unnamed: R2.1, U6.21 (P12)
unnamed: LED2.A (ANODE), R9.1
unnamed: LED2.C (CATHODE), Q4.D
SCL: R2.2; also elsewhere on the board
SCLK: U6.14 (P9); also elsewhere on the board
SDA: R1.2; also elsewhere on the board

Notes on the sheet:
To Program the STM32L on the Module
To reprogram from the sam4L
To receive radio packets
A back-up interface incase the STM32 needs to go directly on the bus
To enter bootloader mode
DNP
Configured to be normally off. Switch R40/R41 to be normally on.
Normally off pulldown

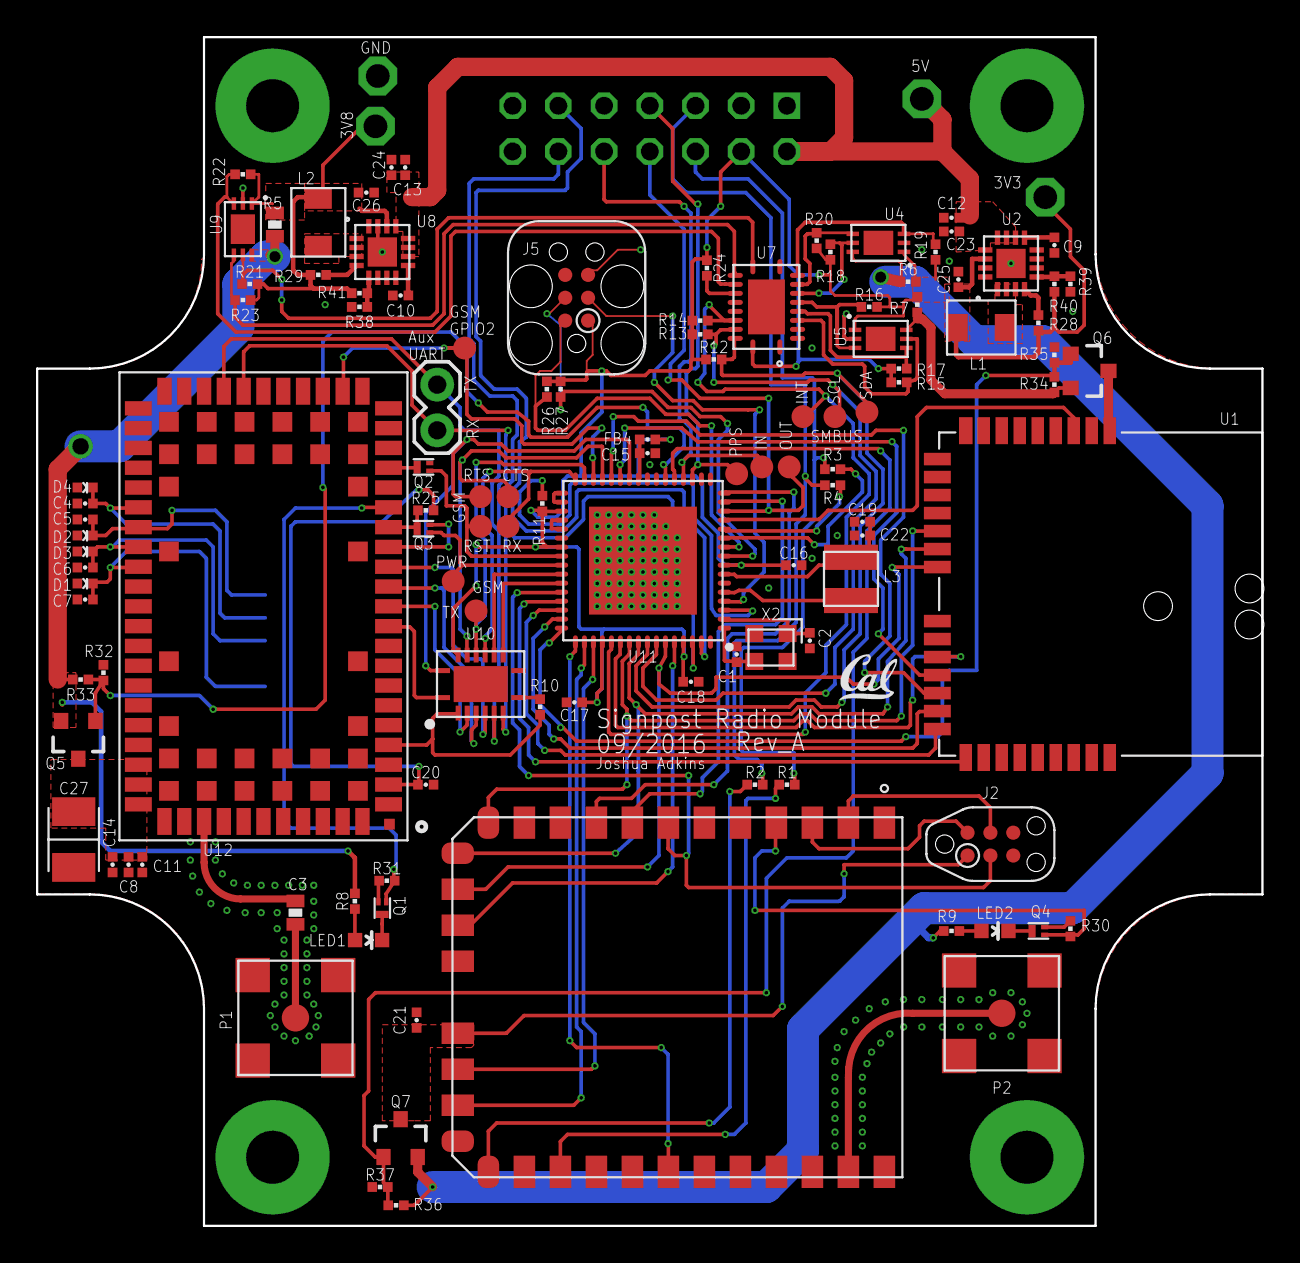
[picture p113: board hardware/radio_module/rev_a/radio_module.brd from above]

Board: 4 copper layers, 68.1 x 66.0 mm, 122 parts (1 on the bottom side), 108 nets.
