lab11/signpost/hardware/controller/rev_a/controller.brd

## EAGLE design hardware/controller/rev_a/controller.brd (2016-09-15, an earlier design)

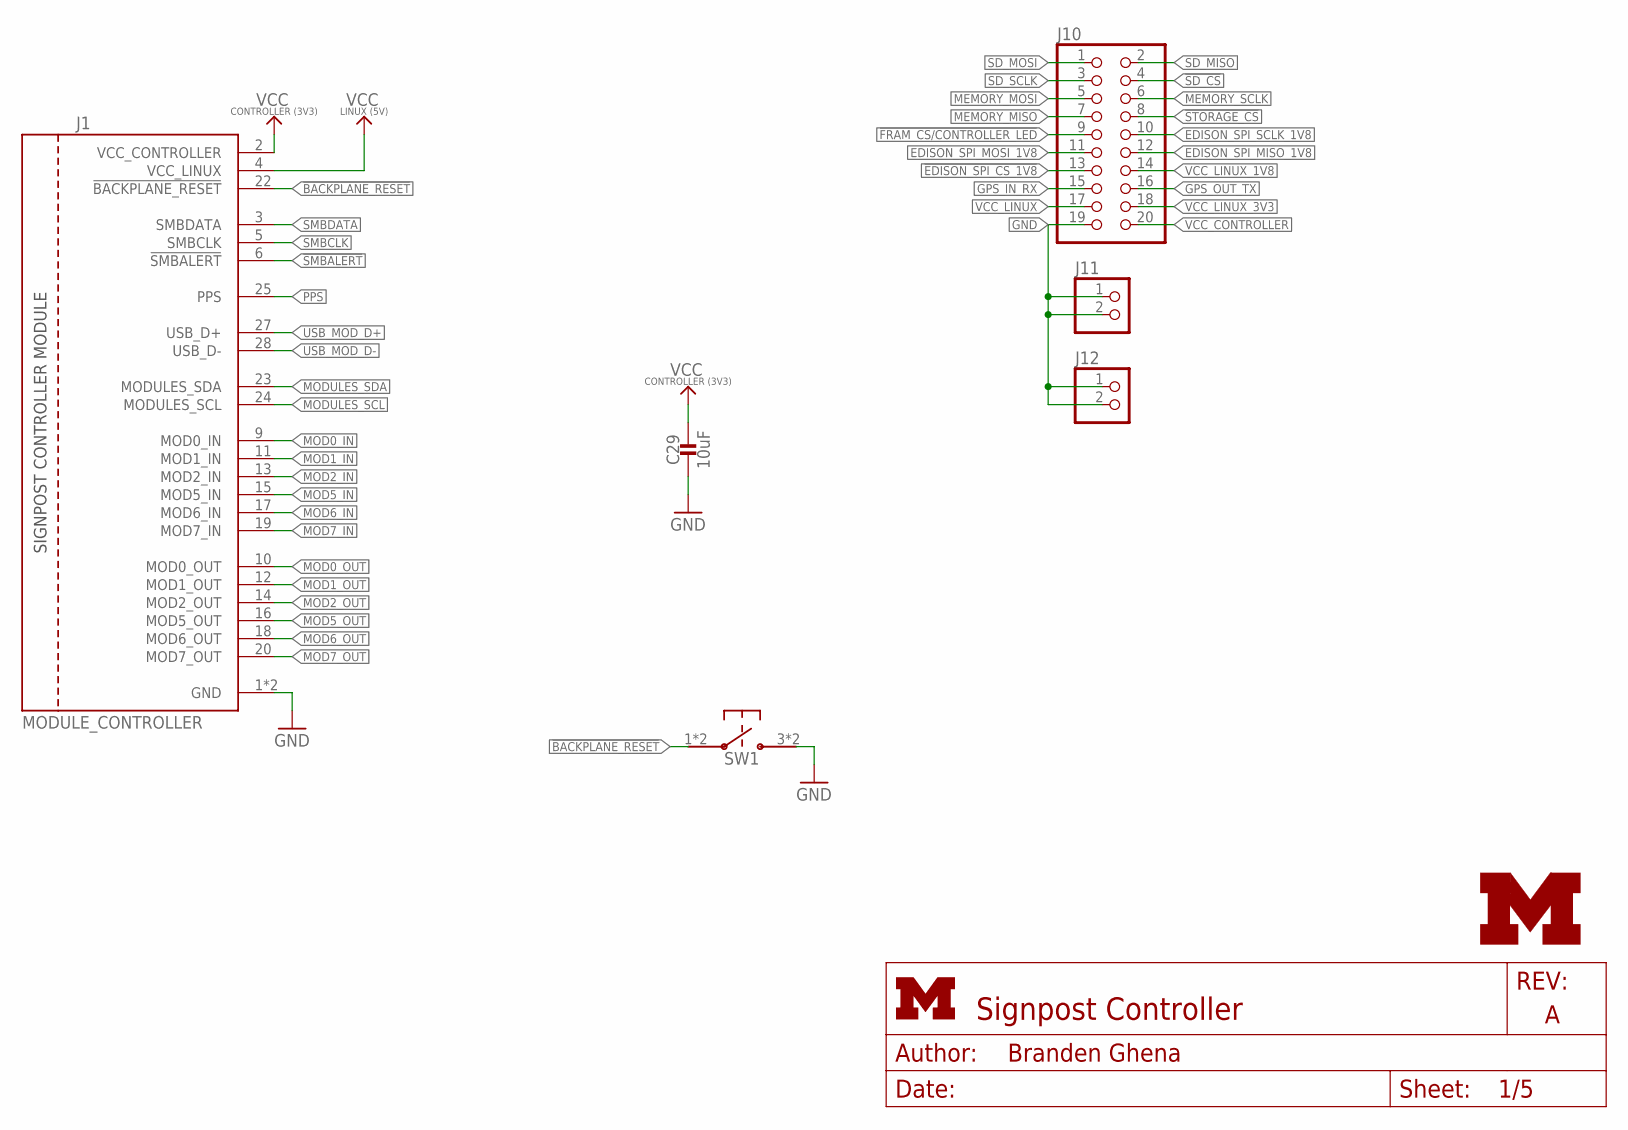
[picture p114: schematic controller.sch, sheet 1]

Parts:
C29: 10uF; 0402_CAP; DIGIKEY 490-13811-1-ND
J1: MODULE_CONTROLLER
J10: PINHD-2X10; 2X10
J11, J12: PINHD-1X2; 1X02
LOGO1: UMICH_SOLID_MEDIUM; UMICH_SOLID_200MIL
SW1: PTS810SJ

Connections:
!BACKPLANE_RESET: J1.22 (!BACKPLANE_RESET), SW1.1, SW1.2
!EDISON_SPI_CS_1V8: J10.13; also elsewhere on the board
!FRAM_CS/CONTROLLER_LED: J10.9; also elsewhere on the board
!SD_CS: J10.4; also elsewhere on the board
!SMBALERT: J1.6 (!SMBALERT); also elsewhere on the board
!STORAGE_CS: J10.8; also elsewhere on the board
EDISON_SPI_MISO_1V8: J10.12; also elsewhere on the board
EDISON_SPI_MOSI_1V8: J10.11; also elsewhere on the board
EDISON_SPI_SCLK_1V8: J10.10; also elsewhere on the board
GND: C29.2, J1.1 (GND), J1.21 (GND), J10.19, J11.1, J11.2, J12.1, J12.2, SW1.3, SW1.4; also elsewhere on the board
GPS_IN_RX: J10.15; also elsewhere on the board
GPS_OUT_TX: J10.16; also elsewhere on the board
MEMORY_MISO: J10.7; also elsewhere on the board
MEMORY_MOSI: J10.5; also elsewhere on the board
MEMORY_SCLK: J10.6; also elsewhere on the board
MOD0_IN: J1.9 (MOD0_IN); also elsewhere on the board
MOD0_OUT: J1.10 (MOD0_OUT); also elsewhere on the board
MOD1_IN: J1.11 (MOD1_IN); also elsewhere on the board
MOD1_OUT: J1.12 (MOD1_OUT); also elsewhere on the board
MOD2_IN: J1.13 (MOD2_IN); also elsewhere on the board
MOD2_OUT: J1.14 (MOD2_OUT); also elsewhere on the board
MOD5_IN: J1.15 (MOD5_IN); also elsewhere on the board
MOD5_OUT: J1.16 (MOD5_OUT); also elsewhere on the board
MOD6_IN: J1.17 (MOD6_IN); also elsewhere on the board
MOD6_OUT: J1.18 (MOD6_OUT); also elsewhere on the board
MOD7_IN: J1.19 (MOD7_IN); also elsewhere on the board
MOD7_OUT: J1.20 (MOD7_OUT); also elsewhere on the board
MODULES_SCL: J1.24 (MODULES_SCL); also elsewhere on the board
MODULES_SDA: J1.23 (MODULES_SDA); also elsewhere on the board
PPS: J1.25 (PPS); also elsewhere on the board
SD_MISO: J10.2; also elsewhere on the board
SD_MOSI: J10.1; also elsewhere on the board
SD_SCLK: J10.3; also elsewhere on the board
SMBCLK: J1.5 (SMBCLK); also elsewhere on the board
SMBDATA: J1.3 (SMBDATA); also elsewhere on the board
USB_MOD_D+: J1.27 (USB_D+); also elsewhere on the board
USB_MOD_D-: J1.28 (USB_D-); also elsewhere on the board
VCC_CONTROLLER: C29.1, J1.2 (VCC_CONTROLLER), J10.20; also elsewhere on the board
VCC_LINUX: J1.4 (VCC_LINUX), J10.17; also elsewhere on the board
VCC_LINUX_1V8: J10.14; also elsewhere on the board
VCC_LINUX_3V3: J10.18; also elsewhere on the board

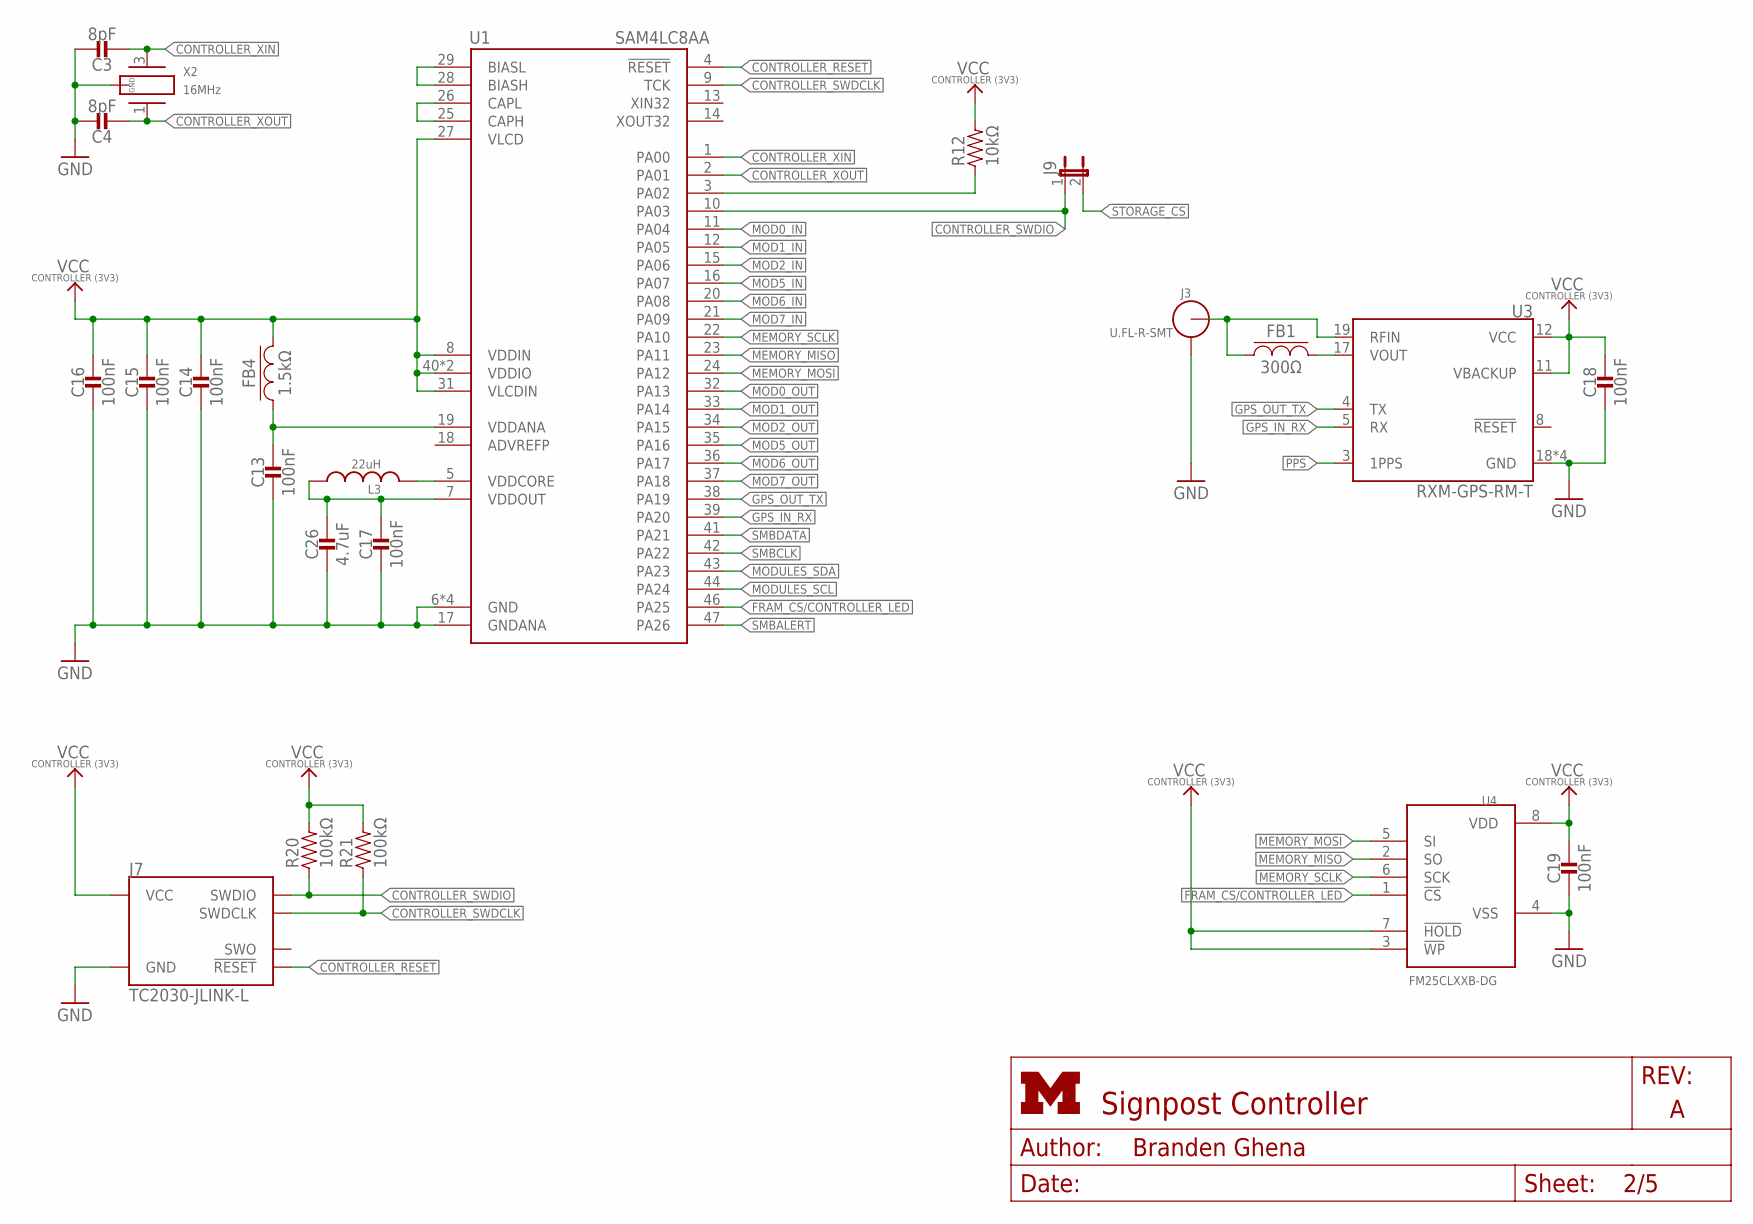
[picture p115: schematic controller.sch, sheet 2]

Parts:
C3, C4: 8pF; 0402_CAP; DIGIKEY 490-8230-1-ND
C13, C14, C15, C16, C17, C18, C19: 100nF; 0402_CAP; DIGIKEY 490-10777-1-ND
C26: 4.7uF; 0402_CAP; DIGIKEY 490-13252-1-ND
FB1: 300Ω; 0402_CAP; DIGIKEY ACML-0402-301-TCT-ND
FB4: 1.5kΩ; 0402_CAP; DIGIKEY 490-5216-1-ND
J3: U.FL-R-SMT; U.FL_SMT
J7: TC2030-JLINK-L; TC2030-IDC
J9: JUMPER-2PTH; 1X02
L3: 22uH; 1212
R12: 10kΩ; 0402_RES; DIGIKEY 1276-3431-1-ND
R20, R21: 100kΩ; 0402_RES; DIGIKEY 1276-3432-1-ND
U1: SAM4LC8AA; QFN-48-7MM
U3: RXM-GPS-RM-T
U4: FM25CLXXB-DG; TDFN-8; DIGIKEY FM25CL64B-DGRA-ND
X2: 16MHz; FHXXX

Connections:
!CONTROLLER_RESET: J7.3 (!RESET), U1.4 (!RESET)
!FRAM_CS/CONTROLLER_LED: U1.46 (PA25), U4.1 (!CS); also elsewhere on the board
!SMBALERT: U1.47 (PA26); also elsewhere on the board
!STORAGE_CS: J9.2; also elsewhere on the board
CONTROLLER_BUCK/LDO_N: R12.1, U1.3 (PA02)
CONTROLLER_SWDCLK: J7.4 (SWDCLK), R21.1, U1.9 (TCK)
CONTROLLER_SWDIO: J7.2 (SWDIO), J9.1, R20.1, U1.10 (PA03)
CONTROLLER_XIN: C3.1, U1.1 (PA00), X2.3 (2)
CONTROLLER_XOUT: C4.1, U1.2 (PA01), X2.1
GND: C3.2, C4.2, C13.2, C14.2, C15.2, C16.2, C17.2, C18.2, C19.2, C26.2, J3.GND1, J3.GND2, J7.5 (GND), U1.6 (GND), U1.17 (GNDANA), U1.30 (GND), U1.48 (GND), U1.THERMAL (GND), U3.18 (GND), U3.20 (GND), U3.21 (GND), U3.22 (GND), U4.4 (VSS), X2.2 (GND), X2.4 (GND); also elsewhere on the board
GPS_IN_RX: U1.39 (PA20), U3.5 (RX); also elsewhere on the board
GPS_OUT_TX: U1.38 (PA19), U3.4 (TX); also elsewhere on the board
MEMORY_MISO: U1.23 (PA11), U4.2 (SO); also elsewhere on the board
MEMORY_MOSI: U1.24 (PA12), U4.5 (SI); also elsewhere on the board
MEMORY_SCLK: U1.22 (PA10), U4.6 (SCK); also elsewhere on the board
MOD0_IN: U1.11 (PA04); also elsewhere on the board
MOD0_OUT: U1.32 (PA13); also elsewhere on the board
MOD1_IN: U1.12 (PA05); also elsewhere on the board
MOD1_OUT: U1.33 (PA14); also elsewhere on the board
MOD2_IN: U1.15 (PA06); also elsewhere on the board
MOD2_OUT: U1.34 (PA15); also elsewhere on the board
MOD5_IN: U1.16 (PA07); also elsewhere on the board
MOD5_OUT: U1.35 (PA16); also elsewhere on the board
MOD6_IN: U1.20 (PA08); also elsewhere on the board
MOD6_OUT: U1.36 (PA17); also elsewhere on the board
MOD7_IN: U1.21 (PA09); also elsewhere on the board
MOD7_OUT: U1.37 (PA18); also elsewhere on the board
MODULES_SCL: U1.44 (PA24); also elsewhere on the board
MODULES_SDA: U1.43 (PA23); also elsewhere on the board
unnamed: FB1.1, U3.17 (VOUT)
unnamed: FB1.2, J3.SIG (ANT), U3.19 (RFIN)
unnamed: C13.1, FB4.1, U1.19 (VDDANA)
unnamed: C17.1, C26.1, L3.P$1 (1), U1.7 (VDDOUT)
unnamed: L3.P$2 (2), U1.5 (VDDCORE)
unnamed: U1.28 (BIASH), U1.29 (BIASL)
unnamed: U1.25 (CAPH), U1.26 (CAPL)
PPS: U3.3 (1PPS); also elsewhere on the board
SMBCLK: U1.42 (PA22); also elsewhere on the board
SMBDATA: U1.41 (PA21); also elsewhere on the board
VCC_CONTROLLER: C14.1, C15.1, C16.1, C18.1, C19.1, FB4.2, J7.1 (VCC), R12.2, R20.2, R21.2, U1.8 (VDDIN), U1.27 (VLCD), U1.31 (VLCDIN), U1.40 (VDDIO), U1.45 (VDDIO), U3.11 (VBACKUP), U3.12 (VCC), U4.3 (!WP), U4.7 (!HOLD), U4.8 (VDD); also elsewhere on the board

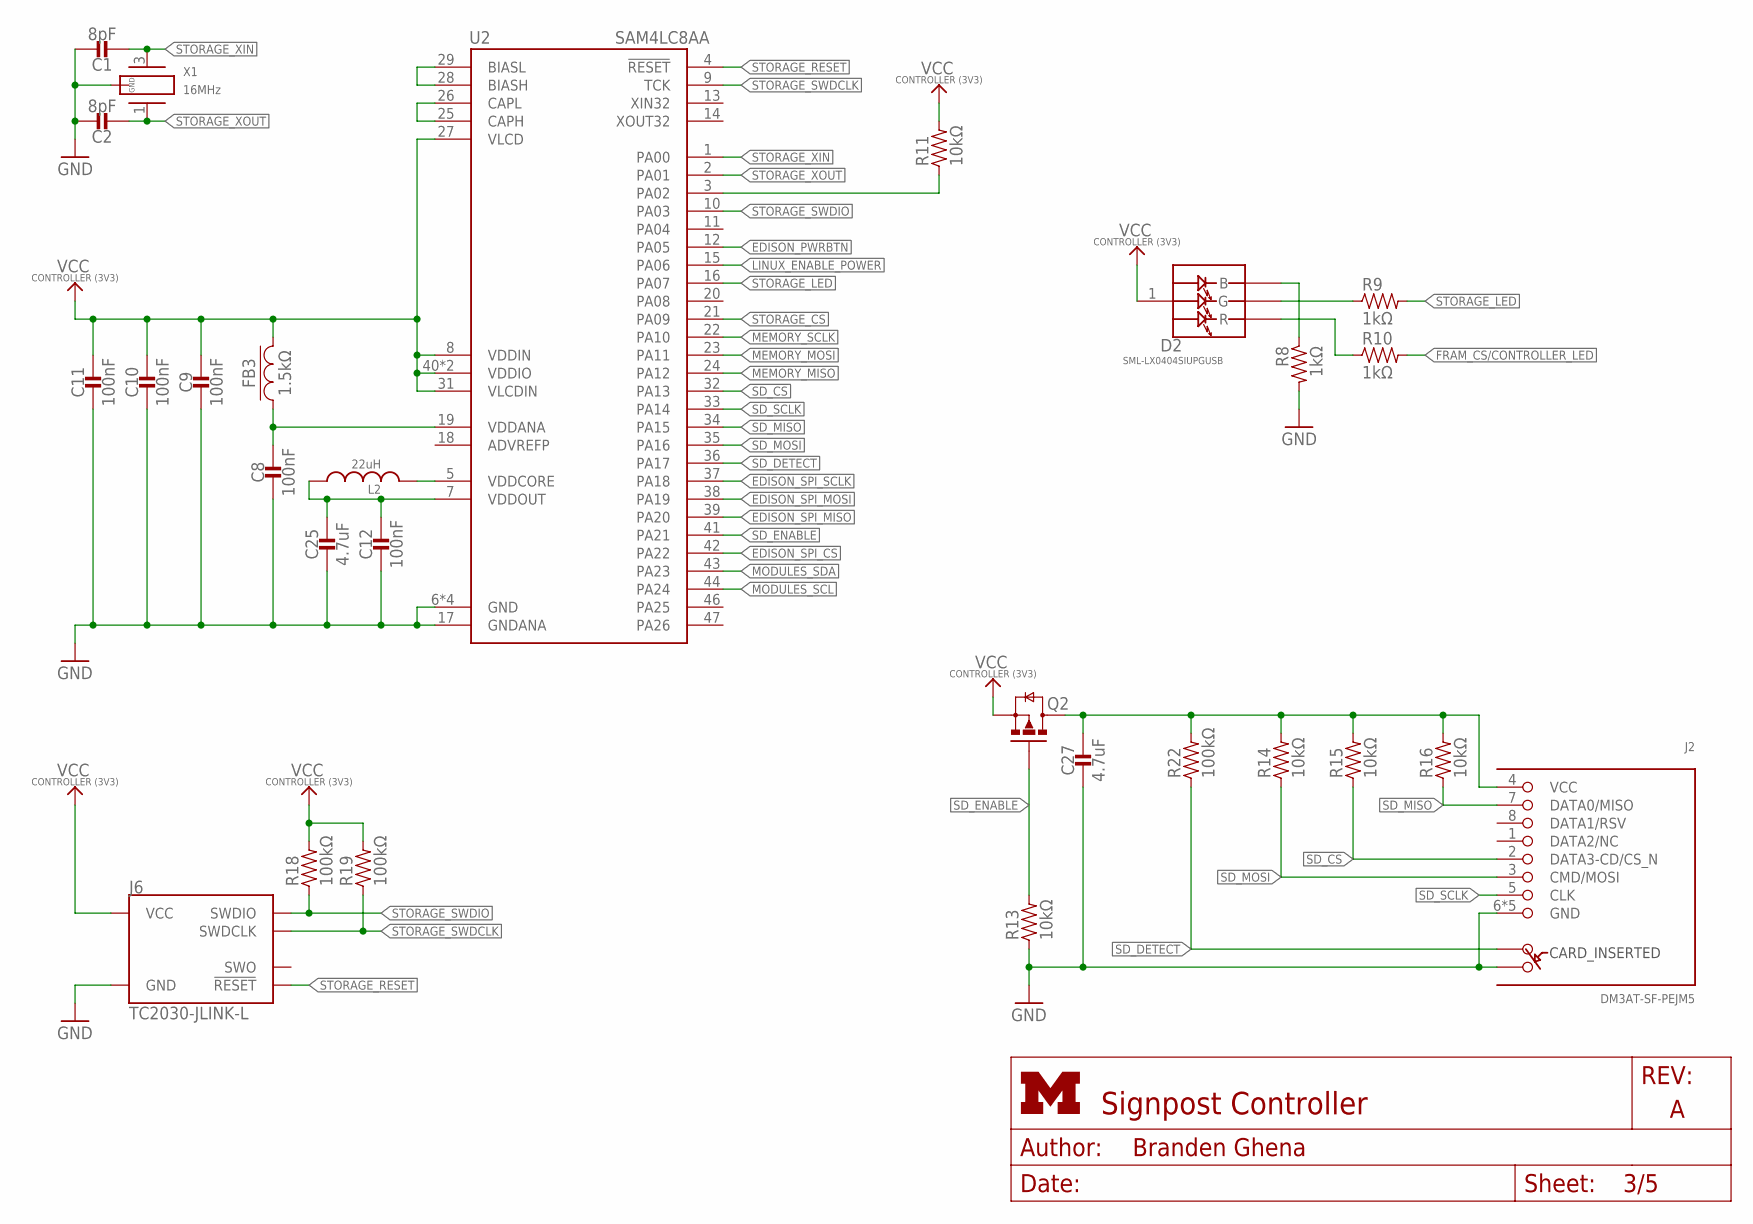
[picture p116: schematic controller.sch, sheet 3]

Parts:
C1, C2: 8pF; 0402_CAP; DIGIKEY 490-8230-1-ND
C8, C9, C10, C11, C12: 100nF; 0402_CAP; DIGIKEY 490-10777-1-ND
C25, C27: 4.7uF; 0402_CAP; DIGIKEY 490-13252-1-ND
D2: SML-LX0404SIUPGUSB; 1MM_SQ_4PAD
FB3: 1.5kΩ; 0402_CAP; DIGIKEY 490-5216-1-ND
J2: DM3AT-SF-PEJM5
J6: TC2030-JLINK-L; TC2030-IDC
L2: 22uH; 1212
Q2: NX3008PBK; SOT23-3
R8, R9, R10: 1kΩ; 0402_RES; DIGIKEY 1276-3430-1-ND
R11, R13, R14, R15, R16: 10kΩ; 0402_RES; DIGIKEY 1276-3431-1-ND
R18, R19, R22: 100kΩ; 0402_RES; DIGIKEY 1276-3432-1-ND
U2: SAM4LC8AA; QFN-48-7MM
X1: 16MHz; FHXXX

Connections:
!EDISON_PWRBTN: U2.12 (PA05); also elsewhere on the board
!EDISON_SPI_CS: U2.42 (PA22); also elsewhere on the board
!FRAM_CS/CONTROLLER_LED: R10.2; also elsewhere on the board
!SD_CS: J2.2 (DATA3-CD/CS_N), R15.1, U2.32 (PA13); also elsewhere on the board
!STORAGE_CS: U2.21 (PA09); also elsewhere on the board
!STORAGE_LED: R9.2, U2.16 (PA07)
!STORAGE_RESET: J6.3 (!RESET), U2.4 (!RESET)
EDISON_SPI_MISO: U2.39 (PA20); also elsewhere on the board
EDISON_SPI_MOSI: U2.38 (PA19); also elsewhere on the board
EDISON_SPI_SCLK: U2.37 (PA18); also elsewhere on the board
GND: C1.2, C2.2, C8.2, C9.2, C10.2, C11.2, C12.2, C25.2, C27.2, J2.6 (GND), J2.B, J2.MOUNT0 (GND), J2.MOUNT1 (GND), J2.MOUNT2 (GND), J2.MOUNT3 (GND), J6.5 (GND), R8.2, R13.1, U2.6 (GND), U2.17 (GNDANA), U2.30 (GND), U2.48 (GND), U2.THERMAL (GND), X1.2 (GND), X1.4 (GND); also elsewhere on the board
LINUX_ENABLE_POWER: U2.15 (PA06); also elsewhere on the board
MEMORY_MISO: U2.24 (PA12); also elsewhere on the board
MEMORY_MOSI: U2.23 (PA11); also elsewhere on the board
MEMORY_SCLK: U2.22 (PA10); also elsewhere on the board
MODULES_SCL: U2.44 (PA24); also elsewhere on the board
MODULES_SDA: U2.43 (PA23); also elsewhere on the board
unnamed: D2.3 (B), R8.1
unnamed: D2.4 (G), R9.1
unnamed: D2.2 (R), R10.1
unnamed: C27.1, J2.4 (VCC), Q2.3 (D), R14.2, R15.2, R16.2, R22.2
unnamed: C8.1, FB3.1, U2.19 (VDDANA)
unnamed: C12.1, C25.1, L2.P$1 (1), U2.7 (VDDOUT)
unnamed: L2.P$2 (2), U2.5 (VDDCORE)
unnamed: U2.25 (CAPH), U2.26 (CAPL)
unnamed: U2.28 (BIASH), U2.29 (BIASL)
SD_DETECT: J2.A, R22.1, U2.36 (PA17)
SD_ENABLE: Q2.1 (G), R13.2, U2.41 (PA21)
SD_MISO: J2.7 (DATA0/MISO), R16.1, U2.34 (PA15); also elsewhere on the board
SD_MOSI: J2.3 (CMD/MOSI), R14.1, U2.35 (PA16); also elsewhere on the board
SD_SCLK: J2.5 (CLK), U2.33 (PA14); also elsewhere on the board
STORAGE_BUCK/LDO_N: R11.1, U2.3 (PA02)
STORAGE_SWDCLK: J6.4 (SWDCLK), R19.1, U2.9 (TCK)
STORAGE_SWDIO: J6.2 (SWDIO), R18.1, U2.10 (PA03)
STORAGE_XIN: C1.1, U2.1 (PA00), X1.3 (2)
STORAGE_XOUT: C2.1, U2.2 (PA01), X1.1
VCC_CONTROLLER: C9.1, C10.1, C11.1, D2.1 (VDD), FB3.2, J6.1 (VCC), Q2.2 (S), R11.2, R18.2, R19.2, U2.8 (VDDIN), U2.27 (VLCD), U2.31 (VLCDIN), U2.40 (VDDIO), U2.45 (VDDIO); also elsewhere on the board

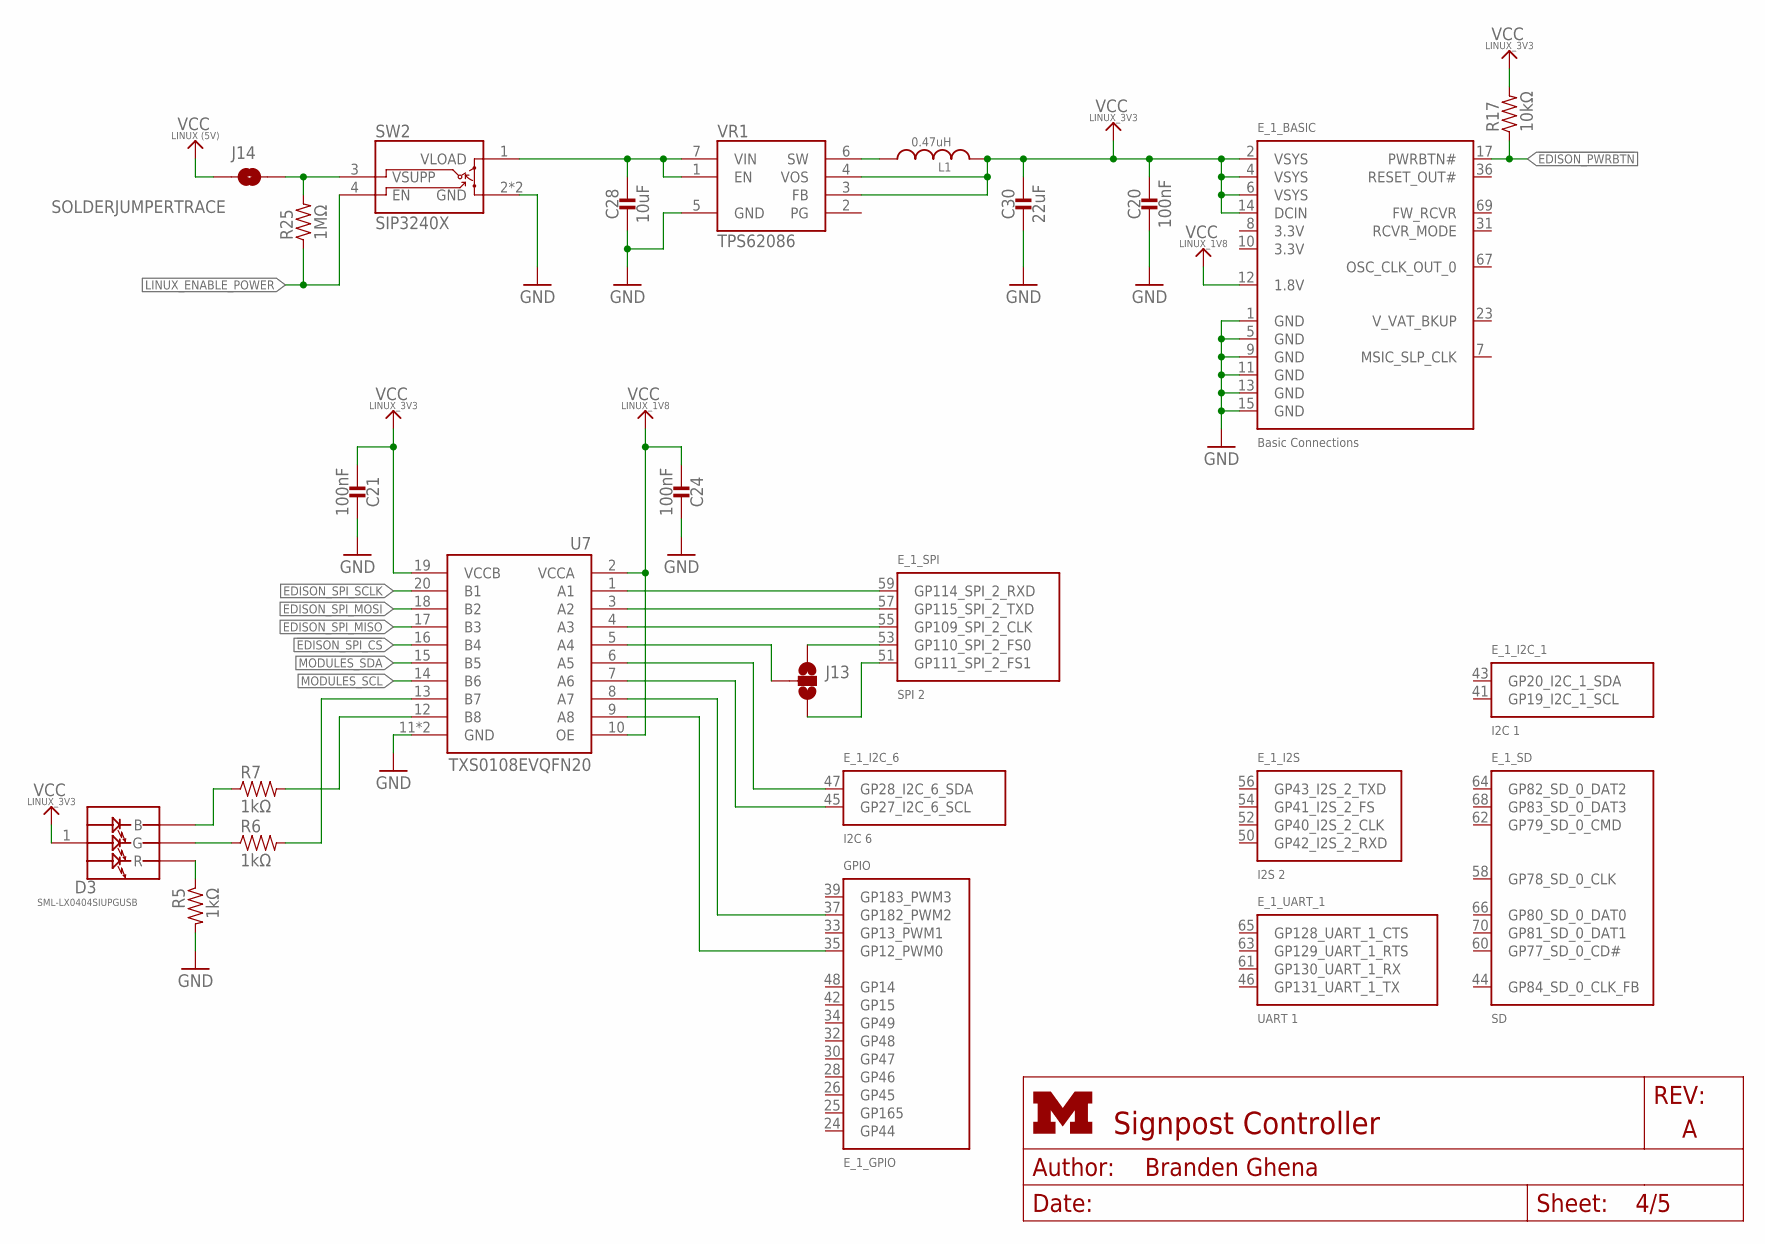
[picture p117: schematic controller.sch, sheet 4]

Parts:
C20, C21, C24: 100nF; 0402_CAP; DIGIKEY 490-10777-1-ND
C28: 10uF; 0805_CAP; DIGIKEY 490-8316-1-ND
C30: 22uF; 0805_CAP; DIGIKEY 490-1719-1-ND
D3: SML-LX0404SIUPGUSB; 1MM_SQ_4PAD
E_1: EDISON_CONNECTOR_SEGMENTED; EDISON_DAUGHTER; MOUSER 798-DF40HC3070DS4V51
J13: SOLDERJUMPER_2WAYPASTE2&3; SJ_3_PASTE2&3
J14: SOLDERJUMPERTRACE; SJ_2S-TRACE
L1: 0.47uH; DFE322512C; MOUSER 81-1277AS-H-R47MP2
R5, R6, R7: 1kΩ; 0402_RES; DIGIKEY 1276-3430-1-ND
R17: 10kΩ; 0402_RES; DIGIKEY 1276-3431-1-ND
R25: 1MΩ; 0402_RES; DIGIKEY 1276-3433-1-ND
SW2: SIP3240X; TDFN4
U7: TXS0108EVQFN20; R-PVQFN-N20; DIGIKEY 296-24806-1-ND
VR1: TPS62086; RLT0007A

Connections:
!EDISON_PWRBTN: E_1.17 (PWRBTN#), R17.1; also elsewhere on the board
!EDISON_SPI_CS: U7.16 (B4); also elsewhere on the board
!EDISON_SPI_CS_1V8: J13.2, U7.5 (A4); also elsewhere on the board
EDISON_SPI_MISO: U7.17 (B3); also elsewhere on the board
EDISON_SPI_MISO_1V8: E_1.55 (GP109_SPI_2_CLK), U7.4 (A3); also elsewhere on the board
EDISON_SPI_MOSI: U7.18 (B2); also elsewhere on the board
EDISON_SPI_MOSI_1V8: E_1.57 (GP115_SPI_2_TXD), U7.3 (A2); also elsewhere on the board
EDISON_SPI_SCLK: U7.20 (B1); also elsewhere on the board
EDISON_SPI_SCLK_1V8: E_1.59 (GP114_SPI_2_RXD), U7.1 (A1); also elsewhere on the board
GND: C20.2, C21.1, C24.1, C28.P$2 (2), C30.P$2 (2), E_1.1 (GND), E_1.5 (GND), E_1.9 (GND), E_1.11 (GND), E_1.13 (GND), E_1.15 (GND), R5.2, SW2.2 (GND), SW2.PAD (GND), U7.11 (GND), U7.THERMAL (GND), VR1.5 (GND); also elsewhere on the board
LINUX_5V_IN: C28.P$1 (1), SW2.1 (VLOAD), VR1.1 (EN), VR1.7 (VIN)
LINUX_ENABLE_POWER: R25.1, SW2.4 (EN); also elsewhere on the board
MODULES_SCL: U7.14 (B6); also elsewhere on the board
MODULES_SCL_1V8: E_1.45 (GP27_I2C_6_SCL), U7.7 (A6)
MODULES_SDA: U7.15 (B5); also elsewhere on the board
MODULES_SDA_1V8: E_1.47 (GP28_I2C_6_SDA), U7.6 (A5)
unnamed: E_1.53 (GP110_SPI_2_FS0), J13.1
unnamed: R7.2, U7.12 (B8)
unnamed: E_1.51 (GP111_SPI_2_FS1), J13.3
unnamed: L1.P$1 (1), VR1.6 (SW)
unnamed: J14.2, R25.2, SW2.3 (VSUPP)
unnamed: E_1.37 (GP182_PWM2), U7.8 (A7)
unnamed: D3.2 (R), R5.1
unnamed: D3.4 (G), R6.1
unnamed: D3.3 (B), R7.1
unnamed: E_1.35 (GP12_PWM0), U7.9 (A8)
unnamed: R6.2, U7.13 (B7)
VCC_LINUX: J14.1; also elsewhere on the board
VCC_LINUX_1V8: C24.2, E_1.12 (1.8V), U7.2 (VCCA), U7.10 (OE); also elsewhere on the board
VCC_LINUX_3V3: C20.1, C21.2, C30.P$1 (1), D3.1 (VDD), E_1.2 (VSYS), E_1.4 (VSYS), E_1.6 (VSYS), E_1.14 (DCIN), L1.P$2 (2), R17.2, U7.19 (VCCB), VR1.3 (FB), VR1.4 (VOS); also elsewhere on the board

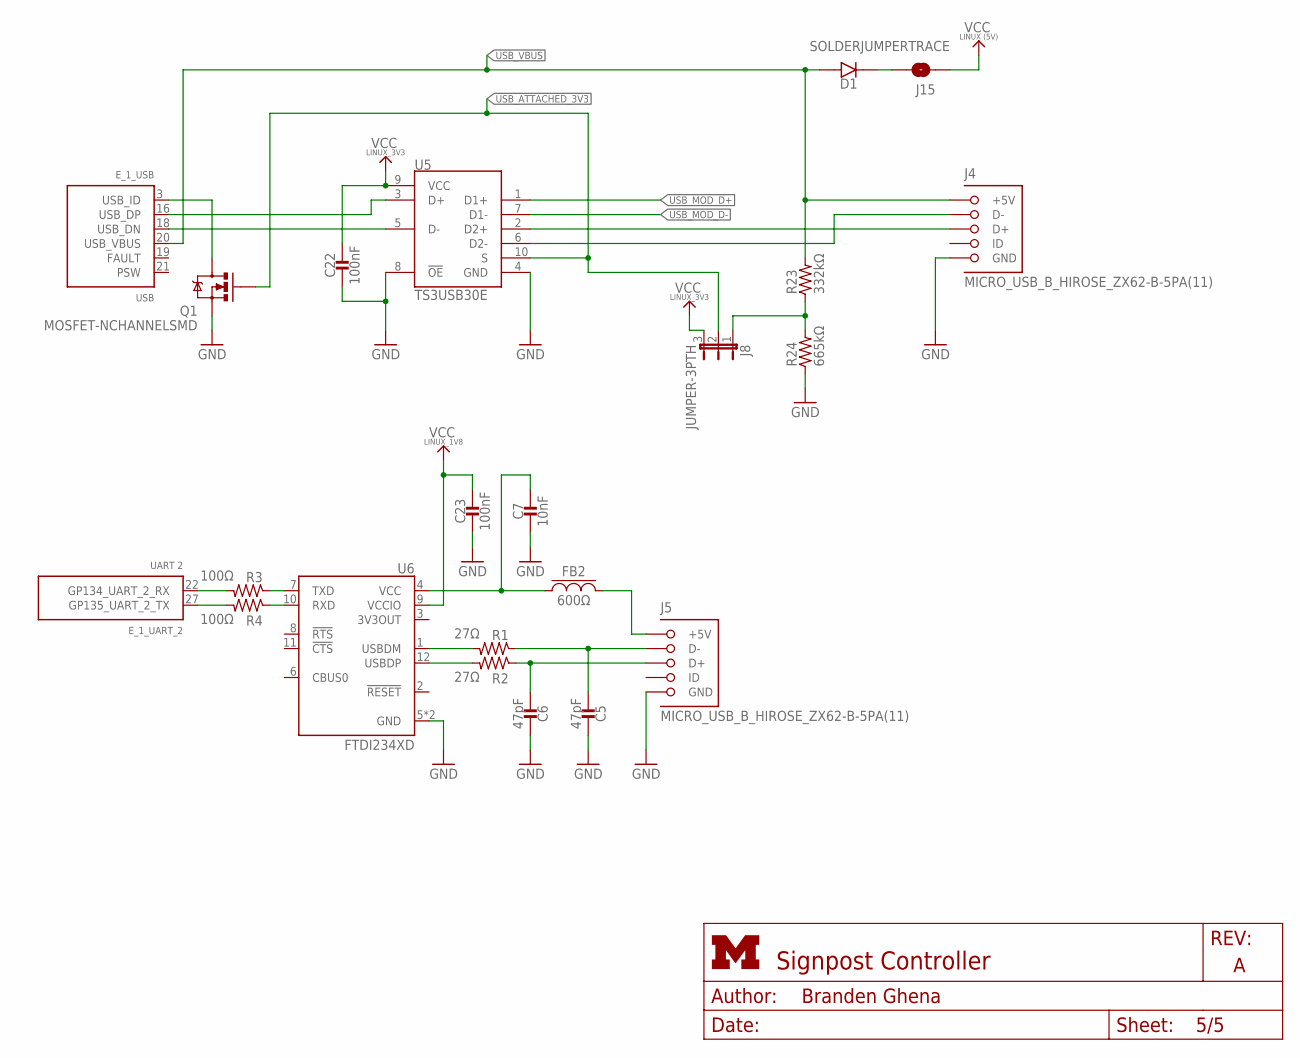
[picture p118: schematic controller.sch, sheet 5]

Parts:
C5, C6: 47pF; 0402_CAP; DIGIKEY 490-6241-1-ND
C7: 10nF; 0402_CAP; DIGIKEY 490-6296-1-ND
C22, C23: 100nF; 0402_CAP; DIGIKEY 490-10777-1-ND
D1: DIODE; 0402_DIODE; DIGIKEY P18981CT-ND
E_1: EDISON_CONNECTOR_SEGMENTED; EDISON_DAUGHTER; MOUSER 798-DF40HC3070DS4V51
FB2: 600Ω; 0805_CAP; DIGIKEY 240-2390-1-ND
J4, J5: MICRO_USB_B_HIROSE_ZX62-B-5PA(11); USB_MICRO_B-HIROSE-ZX62-B-5PA(11)
J8: JUMPER-3PTH; 1X03
J15: SOLDERJUMPERTRACE; SJ_2S-TRACE
Q1: MOSFET-NCHANNELSMD; SOT23-3; DIGIKEY SI2312CDS-T1-GE3CT-ND
R1, R2: 27Ω; 0402_RES; DIGIKEY 1276-3907-1-ND
R3, R4: 100Ω; 0402_RES; DIGIKEY 1276-3429-1-ND
R23: 332kΩ; 0402_RES; DIGIKEY 1276-4245-1-ND
R24: 665kΩ; 0402_RES; DIGIKEY 1276-4275-1-ND
U5: TS3USB30E; UQFN-10
U6: FTDI234XD; DFN-12/3MM

Connections:
D+: C6.1, J5.3 (D+), R2.1
D-: C5.1, J5.2 (D-), R1.1
EDISON_UART_RX: E_1.22 (GP134_UART_2_RX), R3.2
EDISON_UART_TX: E_1.27 (GP135_UART_2_TX), R4.2
GND: C5.2, C6.2, C7.2, C22.2, C23.2, J4.5 (GND), J5.5 (GND), Q1.2 (S), R24.1, U5.4 (GND), U5.8 (!OE), U6.5 (GND), U6.13 (GND); also elsewhere on the board
unnamed: R1.2, U6.1 (USBDM)
unnamed: R2.2, U6.12 (USBDP)
unnamed: J4.2 (D-), U5.6 (D2-)
unnamed: J4.3 (D+), U5.2 (D2+)
unnamed: FB2.P$2, J5.1 (+5V)
unnamed: D1.CATHODE, J15.2
unnamed: J8.1, R23.1, R24.2
unnamed: R3.1, U6.7 (TXD)
unnamed: R4.1, U6.10 (RXD)
unnamed: C7.1, FB2.P$1, U6.4 (VCC)
unnamed: E_1.3 (USB_ID), Q1.3 (D)
USB_ATTACHED_3V3: J8.2, Q1.1 (G), U5.10 (S)
USB_D+: E_1.16 (USB_DP), U5.3 (D+)
USB_D-: E_1.18 (USB_DN), U5.5 (D-)
USB_MOD_D+: U5.1 (D1+); also elsewhere on the board
USB_MOD_D-: U5.7 (D1-); also elsewhere on the board
USB_VBUS: D1.ANODE, E_1.20 (USB_VBUS), J4.1 (+5V), R23.2
VCC_LINUX: J15.1; also elsewhere on the board
VCC_LINUX_1V8: C23.1, U6.9 (VCCIO); also elsewhere on the board
VCC_LINUX_3V3: C22.1, J8.3, U5.9 (VCC); also elsewhere on the board

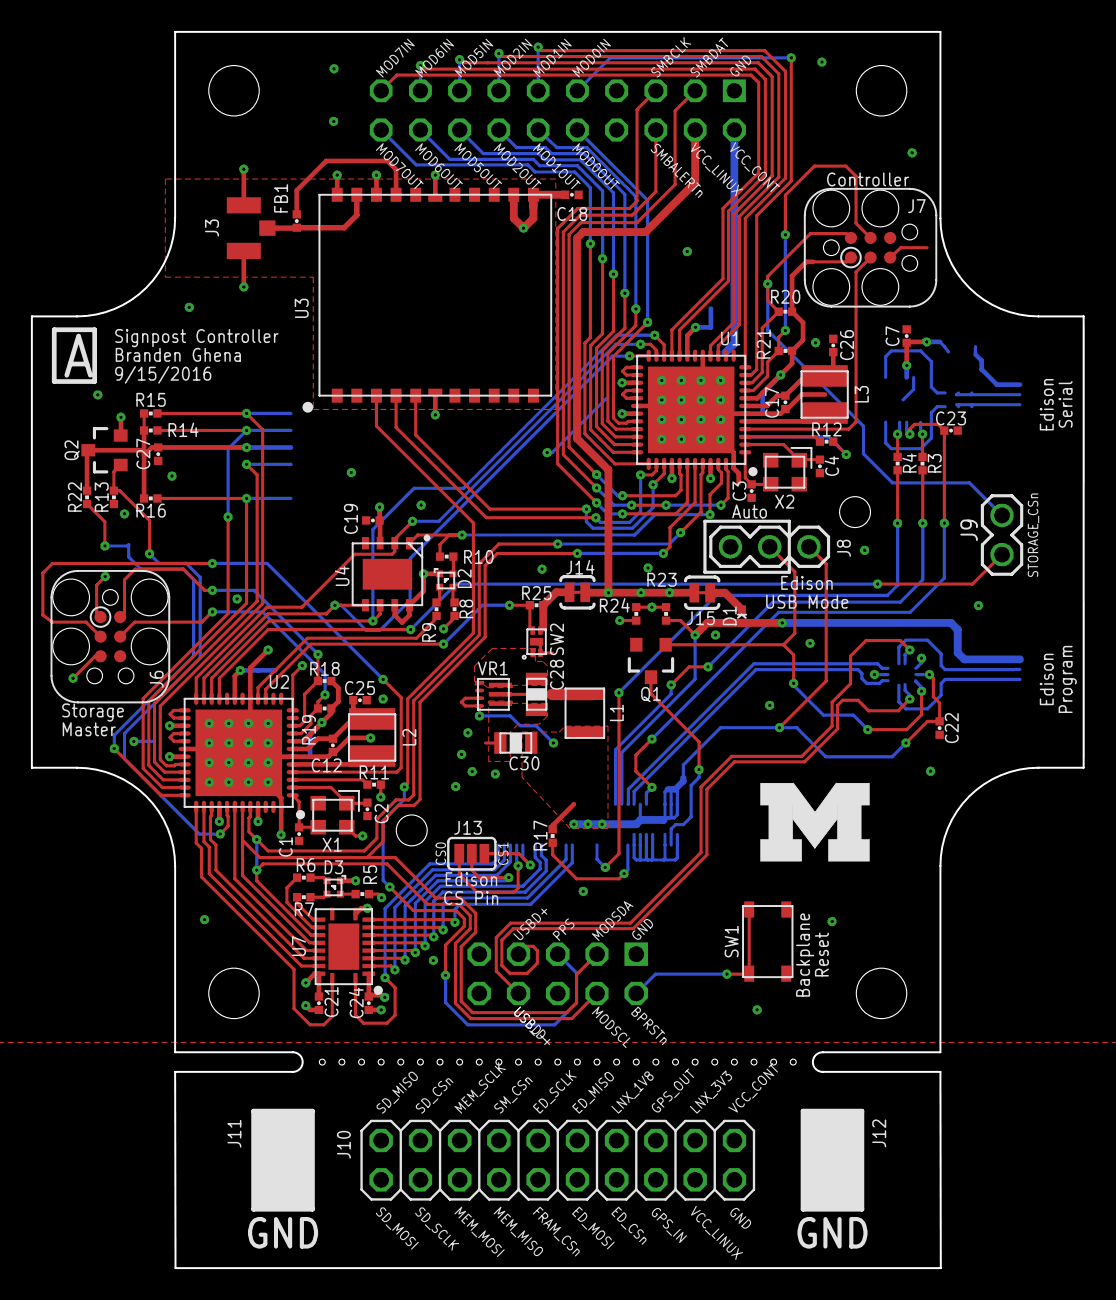
[picture p119: board hardware/controller/rev_a/controller.brd from above]

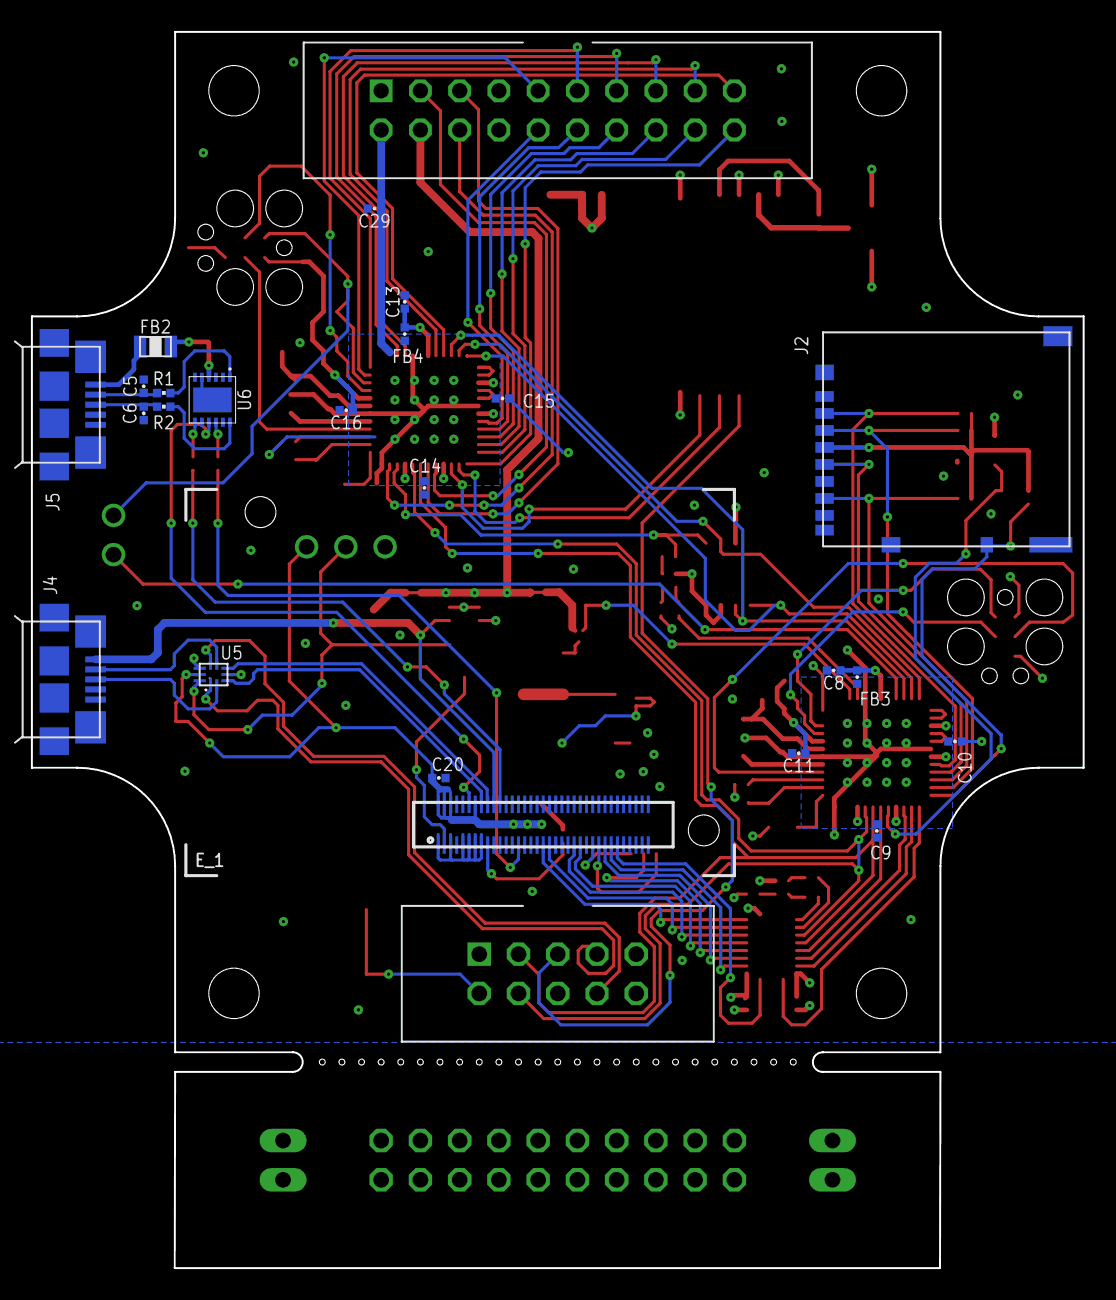
[picture p120: board hardware/controller/rev_a/controller.brd from below]

Board: 4 copper layers, 68.1 x 80.0 mm, 96 parts (23 on the bottom side), 111 nets.
