lab11/signpost/hardware/power_supply_module/rev_a/power_supply_module.brd

## EAGLE design hardware/power_supply_module/rev_a/power_supply_module.brd (continued)

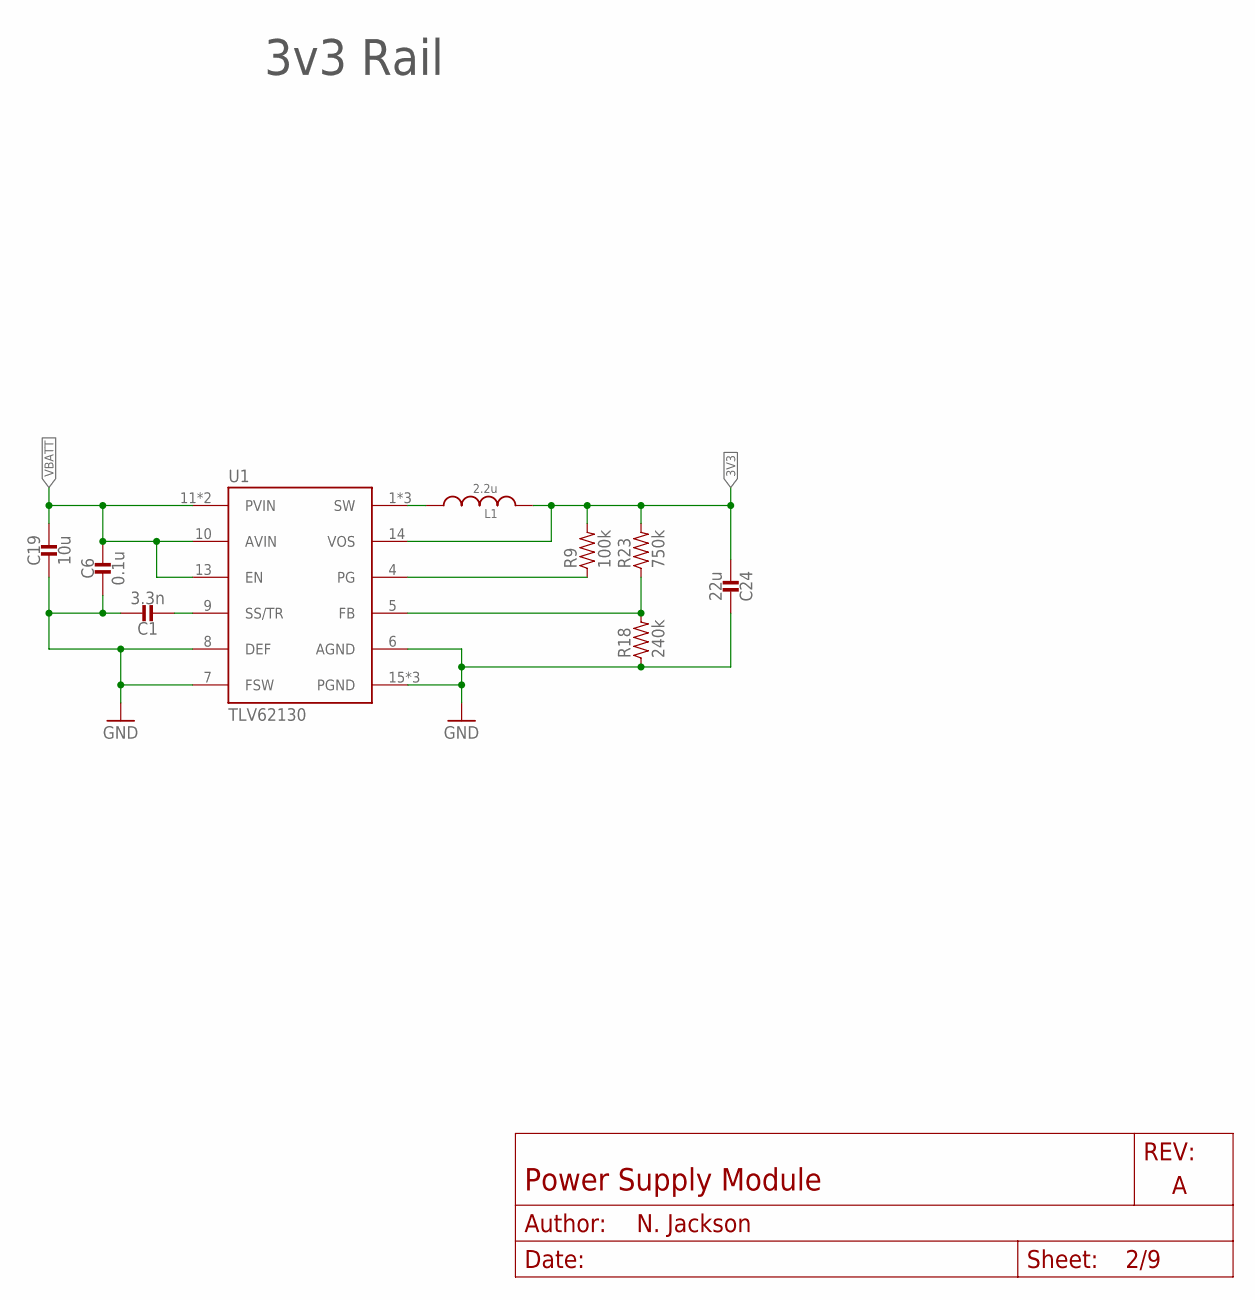
[picture p121: schematic power_supply_module.sch, sheet 2]

Parts:
C1: 3.3n; 0402_CAP
C6: 0.1u; 0402_CAP
C19: 10u; 0805_CAP
C24: 22u; 0603_CAP
L1: 2.2u; IHL-1212BZ-11
R9: 100k; 0402_RES
R18: 240k; 0402_RES
R23: 750k; 0402_RES
U1: TLV62130; TQFN-16/3MM

Connections:
3V3: C24.2, L1.P$2 (2), R9.2, R23.2, U1.14 (VOS); also elsewhere on the board
GND: C1.1, C6.2, C19.P$2 (2), C24.1, R18.1, U1.6 (AGND), U1.7 (FSW), U1.8 (DEF), U1.15 (PGND), U1.16 (PGND), U1.GND; also elsewhere on the board
unnamed: C1.2, U1.9 (SS/TR)
unnamed: L1.P$1 (1), U1.1 (SW), U1.2 (SW), U1.3 (SW)
unnamed: R9.1, U1.4 (PG)
unnamed: R18.2, R23.1, U1.5 (FB)
VBATT: C6.1, C19.P$1 (1), U1.10 (AVIN), U1.11 (PVIN), U1.12 (PVIN), U1.13 (EN); also elsewhere on the board

Notes on the sheet:
3v3 Rail

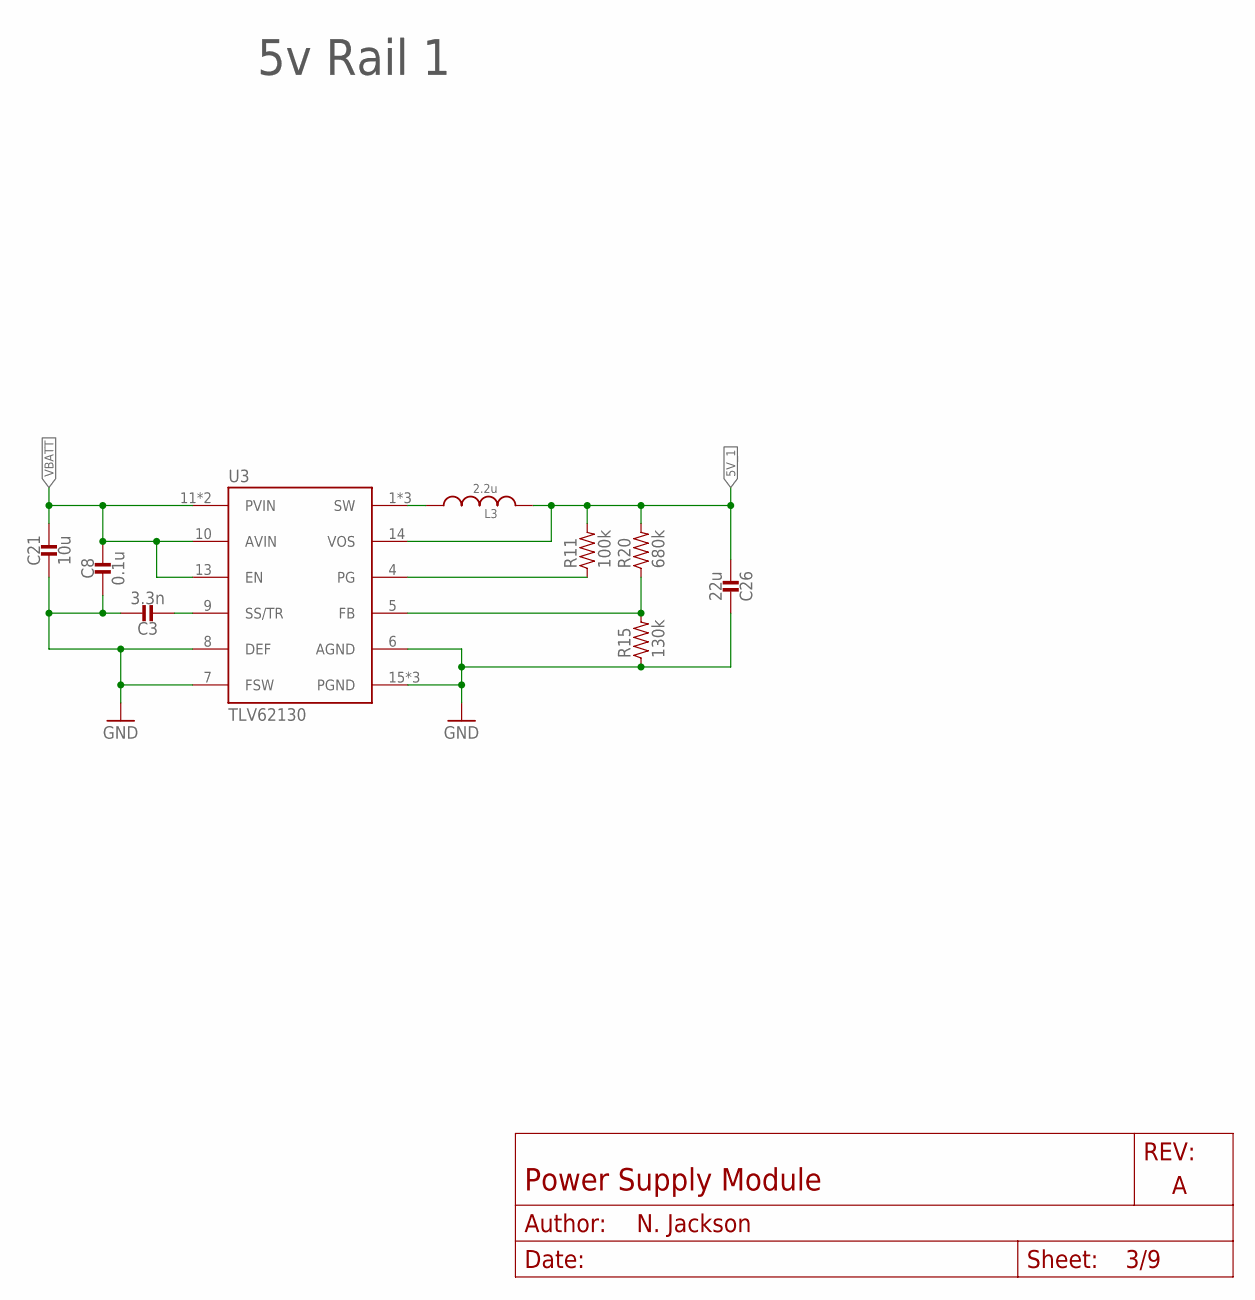
[picture p122: schematic power_supply_module.sch, sheet 3]

Parts:
C3: 3.3n; 0402_CAP
C8: 0.1u; 0402_CAP
C21: 10u; 0805_CAP
C26: 22u; 0603_CAP
L3: 2.2u; IHL-1212BZ-11
R11: 100k; 0402_RES
R15: 130k; 0402_RES
R20: 680k; 0402_RES
U3: TLV62130; TQFN-16/3MM

Connections:
5V_1: C26.2, L3.P$2 (2), R11.2, R20.2, U3.14 (VOS); also elsewhere on the board
GND: C3.1, C8.2, C21.P$2 (2), C26.1, R15.1, U3.6 (AGND), U3.7 (FSW), U3.8 (DEF), U3.15 (PGND), U3.16 (PGND), U3.GND; also elsewhere on the board
unnamed: C3.2, U3.9 (SS/TR)
unnamed: L3.P$1 (1), U3.1 (SW), U3.2 (SW), U3.3 (SW)
unnamed: R11.1, U3.4 (PG)
unnamed: R15.2, R20.1, U3.5 (FB)
VBATT: C8.1, C21.P$1 (1), U3.10 (AVIN), U3.11 (PVIN), U3.12 (PVIN), U3.13 (EN); also elsewhere on the board

Notes on the sheet:
5v Rail 1

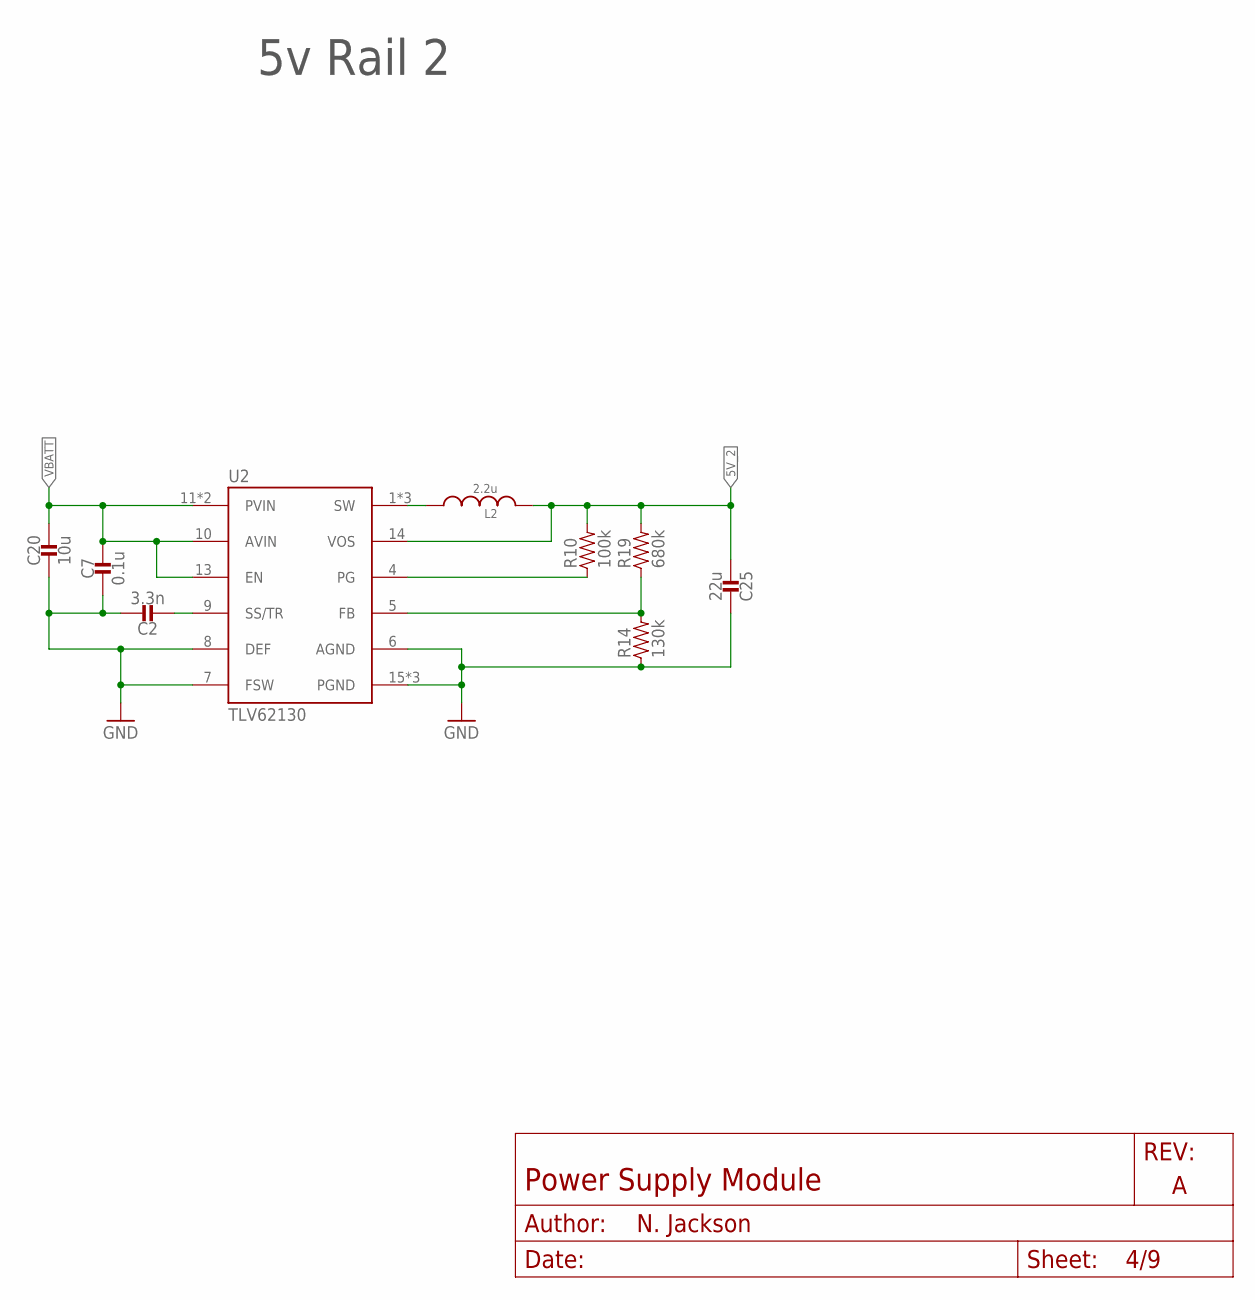
[picture p123: schematic power_supply_module.sch, sheet 4]

Parts:
C2: 3.3n; 0402_CAP
C7: 0.1u; 0402_CAP
C20: 10u; 0805_CAP
C25: 22u; 0603_CAP
L2: 2.2u; IHL-1212BZ-11
R10: 100k; 0402_RES
R14: 130k; 0402_RES
R19: 680k; 0402_RES
U2: TLV62130; TQFN-16/3MM

Connections:
5V_2: C25.2, L2.P$2 (2), R10.2, R19.2, U2.14 (VOS); also elsewhere on the board
GND: C2.1, C7.2, C20.P$2 (2), C25.1, R14.1, U2.6 (AGND), U2.7 (FSW), U2.8 (DEF), U2.15 (PGND), U2.16 (PGND), U2.GND; also elsewhere on the board
unnamed: C2.2, U2.9 (SS/TR)
unnamed: L2.P$1 (1), U2.1 (SW), U2.2 (SW), U2.3 (SW)
unnamed: R10.1, U2.4 (PG)
unnamed: R14.2, R19.1, U2.5 (FB)
VBATT: C7.1, C20.P$1 (1), U2.10 (AVIN), U2.11 (PVIN), U2.12 (PVIN), U2.13 (EN); also elsewhere on the board

Notes on the sheet:
5v Rail 2

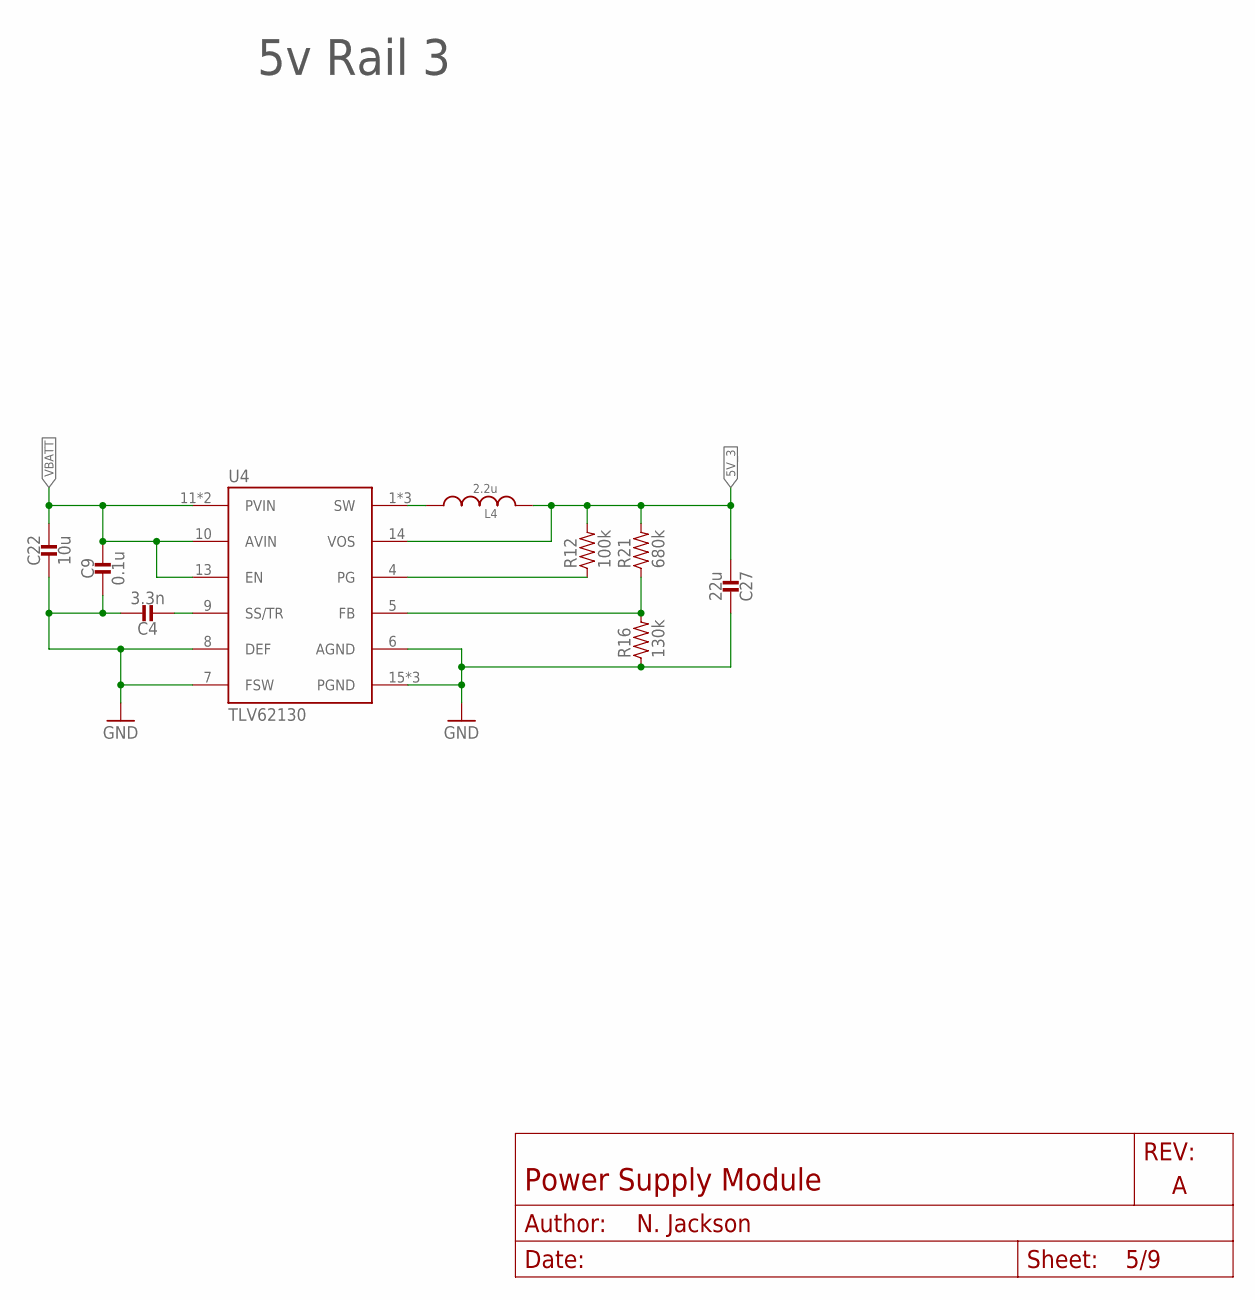
[picture p124: schematic power_supply_module.sch, sheet 5]

Parts:
C4: 3.3n; 0402_CAP
C9: 0.1u; 0402_CAP
C22: 10u; 0805_CAP
C27: 22u; 0603_CAP
L4: 2.2u; IHL-1212BZ-11
R12: 100k; 0402_RES
R16: 130k; 0402_RES
R21: 680k; 0402_RES
U4: TLV62130; TQFN-16/3MM

Connections:
5V_3: C27.2, L4.P$2 (2), R12.2, R21.2, U4.14 (VOS); also elsewhere on the board
GND: C4.1, C9.2, C22.P$2 (2), C27.1, R16.1, U4.6 (AGND), U4.7 (FSW), U4.8 (DEF), U4.15 (PGND), U4.16 (PGND), U4.GND; also elsewhere on the board
unnamed: C4.2, U4.9 (SS/TR)
unnamed: L4.P$1 (1), U4.1 (SW), U4.2 (SW), U4.3 (SW)
unnamed: R12.1, U4.4 (PG)
unnamed: R16.2, R21.1, U4.5 (FB)
VBATT: C9.1, C22.P$1 (1), U4.10 (AVIN), U4.11 (PVIN), U4.12 (PVIN), U4.13 (EN); also elsewhere on the board

Notes on the sheet:
5v Rail 3

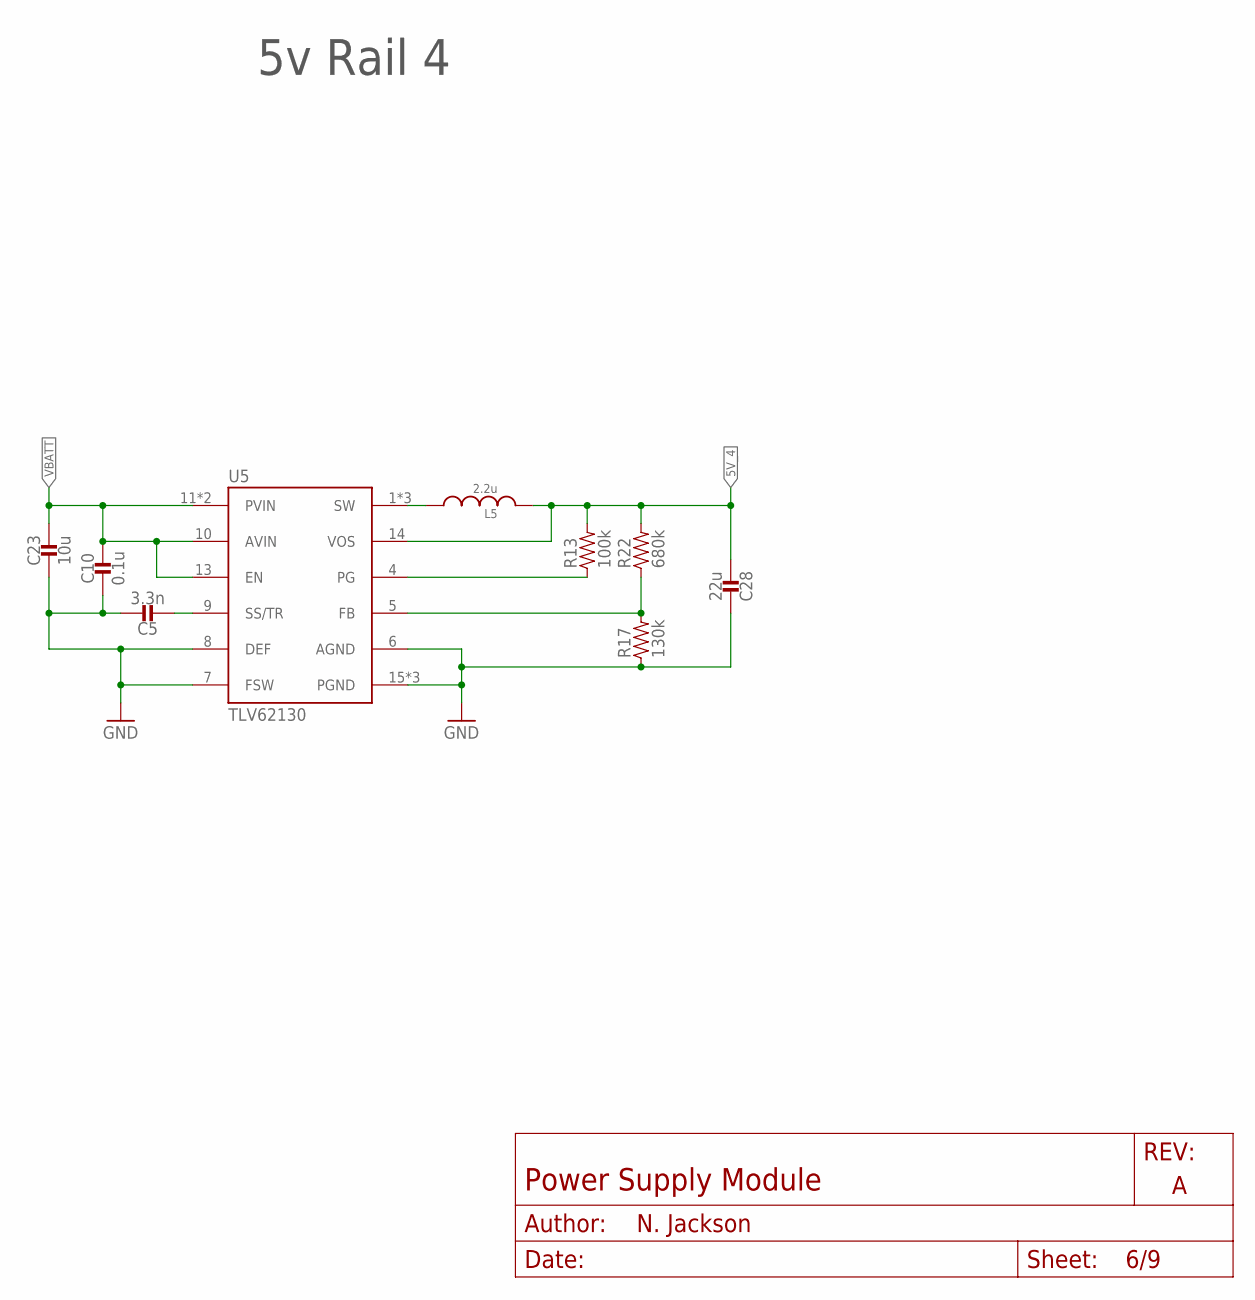
[picture p125: schematic power_supply_module.sch, sheet 6]

Parts:
C5: 3.3n; 0402_CAP
C10: 0.1u; 0402_CAP
C23: 10u; 0805_CAP
C28: 22u; 0603_CAP
L5: 2.2u; IHL-1212BZ-11
R13: 100k; 0402_RES
R17: 130k; 0402_RES
R22: 680k; 0402_RES
U5: TLV62130; TQFN-16/3MM

Connections:
5V_4: C28.2, L5.P$2 (2), R13.2, R22.2, U5.14 (VOS); also elsewhere on the board
GND: C5.1, C10.2, C23.P$2 (2), C28.1, R17.1, U5.6 (AGND), U5.7 (FSW), U5.8 (DEF), U5.15 (PGND), U5.16 (PGND), U5.GND; also elsewhere on the board
unnamed: C5.2, U5.9 (SS/TR)
unnamed: L5.P$1 (1), U5.1 (SW), U5.2 (SW), U5.3 (SW)
unnamed: R13.1, U5.4 (PG)
unnamed: R17.2, R22.1, U5.5 (FB)
VBATT: C10.1, C23.P$1 (1), U5.10 (AVIN), U5.11 (PVIN), U5.12 (PVIN), U5.13 (EN); also elsewhere on the board

Notes on the sheet:
5v Rail 4

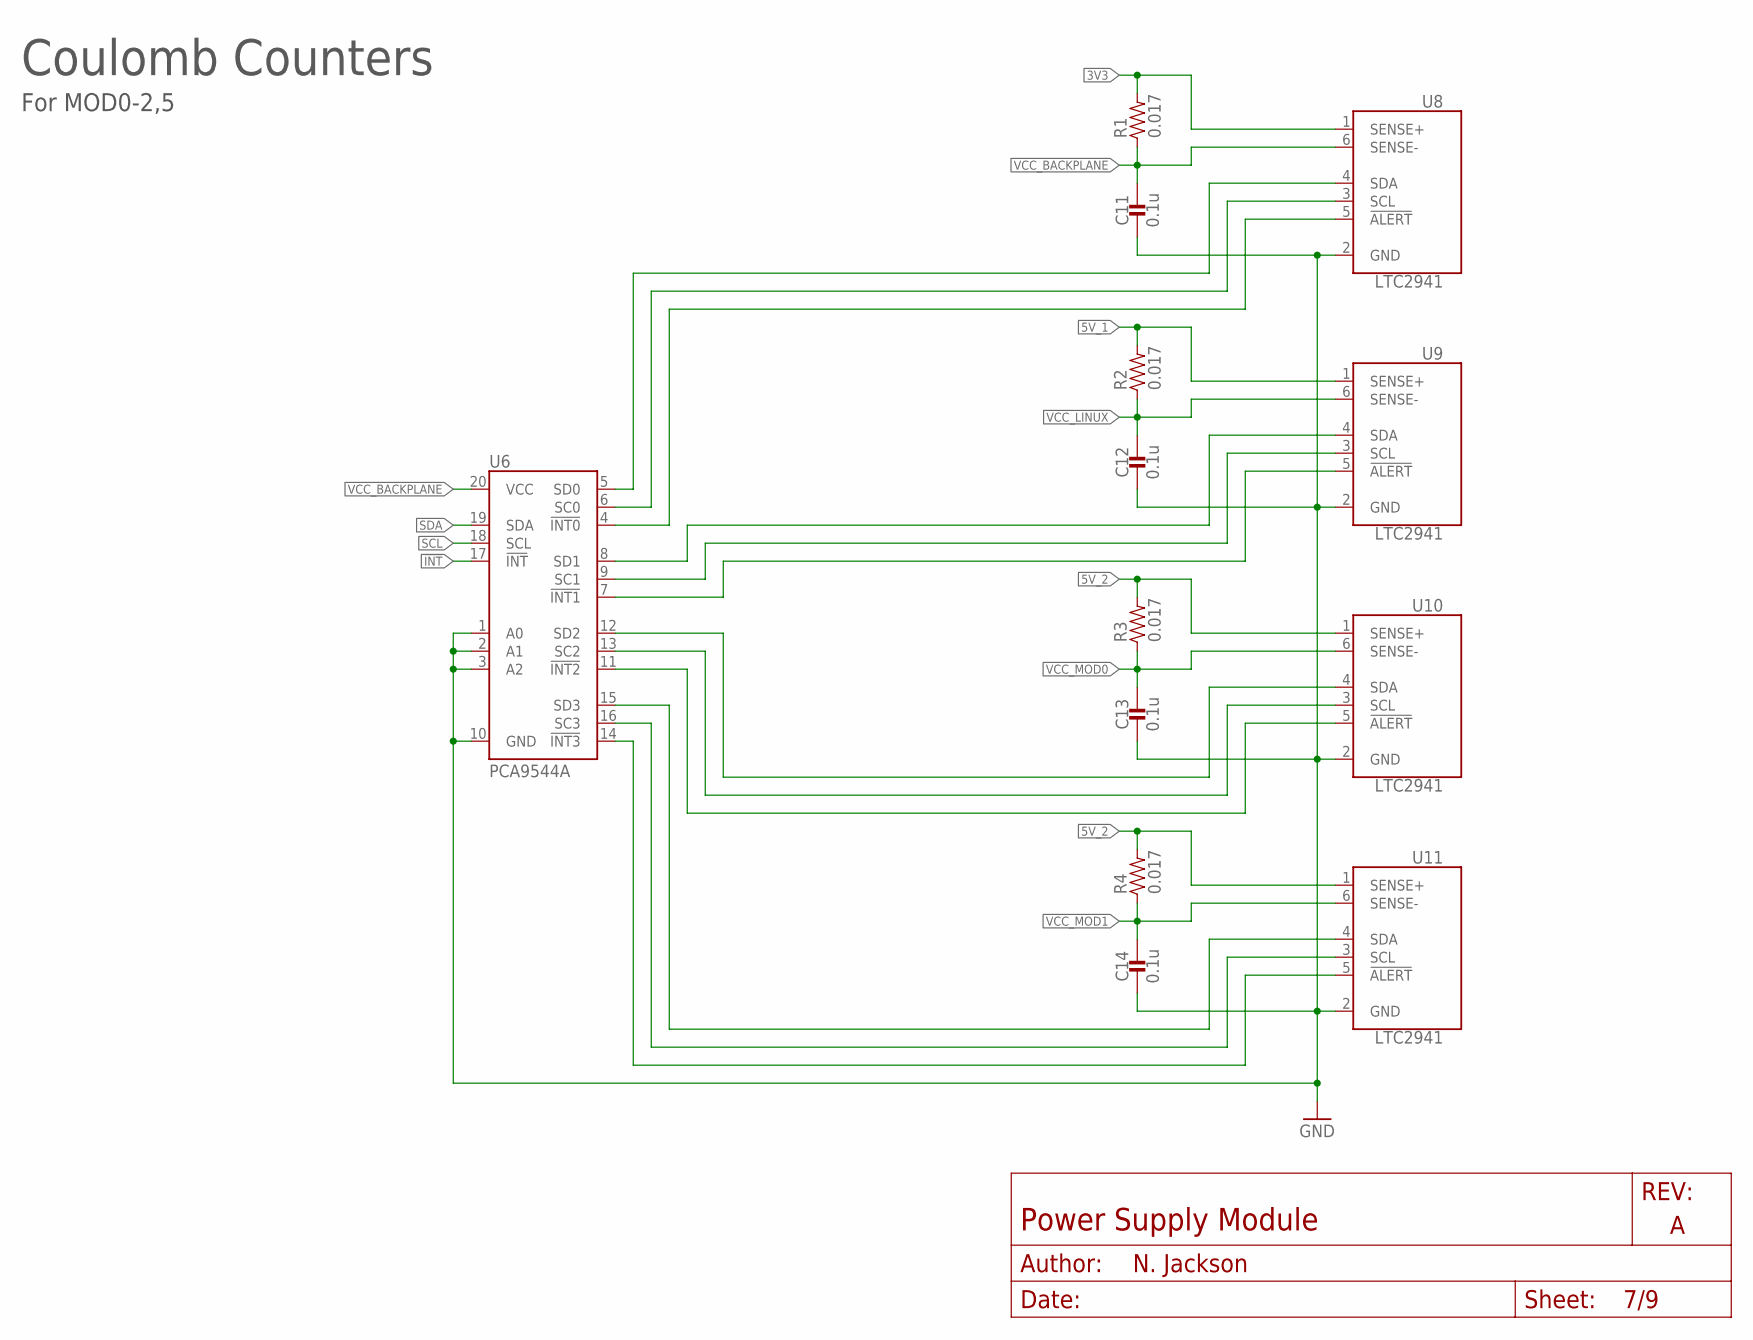
[picture p126: schematic power_supply_module.sch, sheet 7]

Parts:
C11, C12, C13, C14: 0.1u; 0402_CAP
R1, R2, R3, R4: 0.017; 0805_RES
U6: PCA9544A; SO20L
U8, U9, U10, U11: LTC2941; DFN-6-2MMX3MM

Connections:
3V3: R1.2, U8.1 (SENSE+); also elsewhere on the board
5V_1: R2.2, U9.1 (SENSE+); also elsewhere on the board
5V_2: R3.2, R4.2, U10.1 (SENSE+), U11.1 (SENSE+); also elsewhere on the board
!INT: U6.17 (!INT); also elsewhere on the board
GND: C11.2, C12.2, C13.2, C14.2, U6.1 (A0), U6.2 (A1), U6.3 (A2), U6.10 (GND), U8.2 (GND), U9.2 (GND), U10.2 (GND), U11.2 (GND); also elsewhere on the board
unnamed: U6.5 (SD0), U8.4 (SDA)
unnamed: U6.6 (SC0), U8.3 (SCL)
unnamed: U6.12 (SD2), U10.4 (SDA)
unnamed: U6.13 (SC2), U10.3 (SCL)
unnamed: U6.11 (!INT2), U10.5 (!ALERT)
unnamed: U6.15 (SD3), U11.4 (SDA)
unnamed: U6.16 (SC3), U11.3 (SCL)
unnamed: U6.14 (!INT3), U11.5 (!ALERT)
unnamed: U6.4 (!INT0), U8.5 (!ALERT)
unnamed: U6.8 (SD1), U9.4 (SDA)
unnamed: U6.9 (SC1), U9.3 (SCL)
unnamed: U6.7 (!INT1), U9.5 (!ALERT)
SCL: U6.18 (SCL); also elsewhere on the board
SDA: U6.19 (SDA); also elsewhere on the board
VCC_BACKPLANE: C11.1, R1.1, U6.20 (VCC), U8.6 (SENSE-); also elsewhere on the board
VCC_LINUX: C12.1, R2.1, U9.6 (SENSE-); also elsewhere on the board
VCC_MOD0: C13.1, R3.1, U10.6 (SENSE-); also elsewhere on the board
VCC_MOD1: C14.1, R4.1, U11.6 (SENSE-); also elsewhere on the board

Notes on the sheet:
Coulomb Counters
For MOD0-2,5

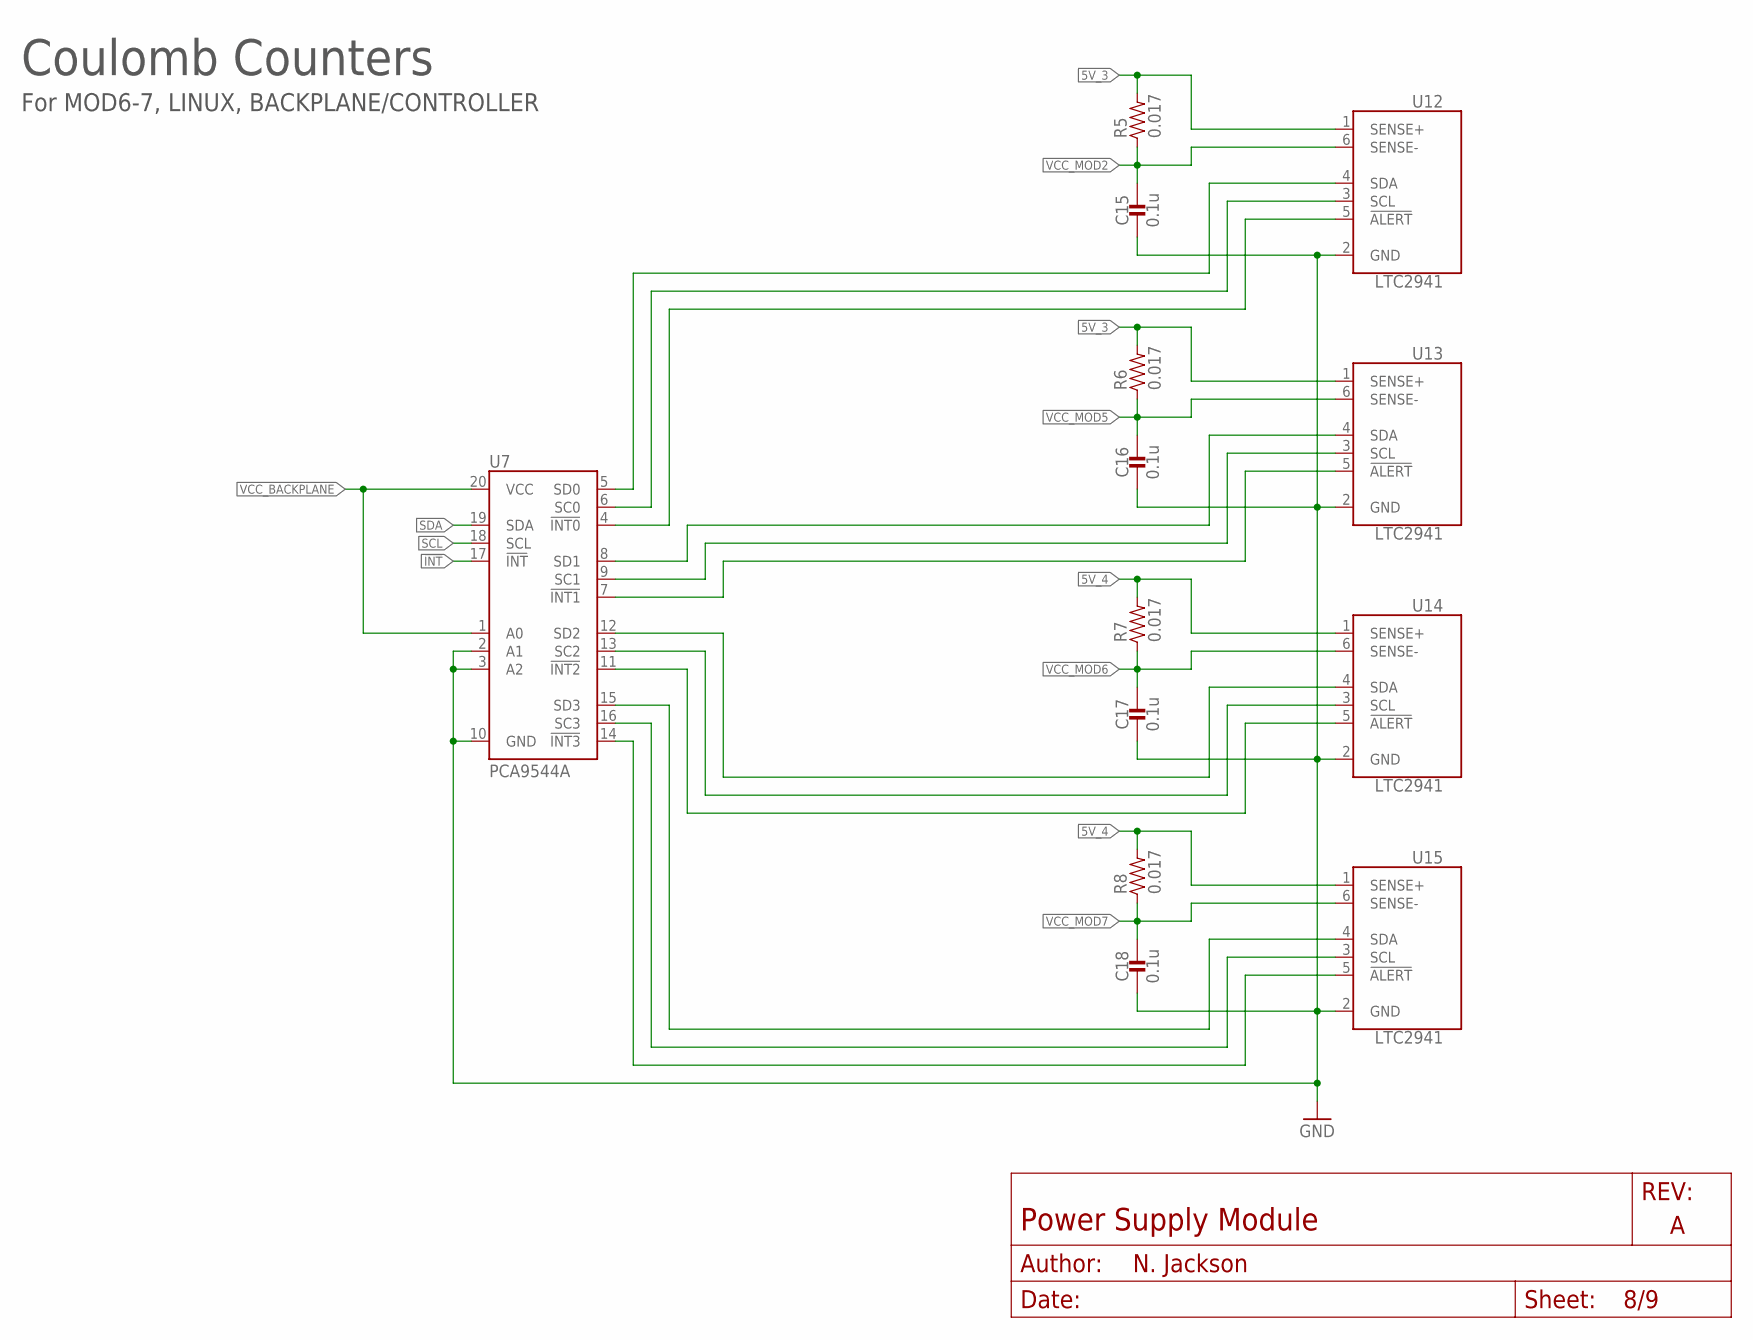
[picture p127: schematic power_supply_module.sch, sheet 8]

Parts:
C15, C16, C17, C18: 0.1u; 0402_CAP
R5, R6, R7, R8: 0.017; 0805_RES
U7: PCA9544A; SO20L
U12, U13, U14, U15: LTC2941; DFN-6-2MMX3MM

Connections:
5V_3: R5.2, R6.2, U12.1 (SENSE+), U13.1 (SENSE+); also elsewhere on the board
5V_4: R7.2, R8.2, U14.1 (SENSE+), U15.1 (SENSE+); also elsewhere on the board
!INT: U7.17 (!INT); also elsewhere on the board
GND: C15.2, C16.2, C17.2, C18.2, U7.2 (A1), U7.3 (A2), U7.10 (GND), U12.2 (GND), U13.2 (GND), U14.2 (GND), U15.2 (GND); also elsewhere on the board
unnamed: U7.5 (SD0), U12.4 (SDA)
unnamed: U7.6 (SC0), U12.3 (SCL)
unnamed: U7.12 (SD2), U14.4 (SDA)
unnamed: U7.13 (SC2), U14.3 (SCL)
unnamed: U7.11 (!INT2), U14.5 (!ALERT)
unnamed: U7.15 (SD3), U15.4 (SDA)
unnamed: U7.16 (SC3), U15.3 (SCL)
unnamed: U7.14 (!INT3), U15.5 (!ALERT)
unnamed: U7.4 (!INT0), U12.5 (!ALERT)
unnamed: U7.8 (SD1), U13.4 (SDA)
unnamed: U7.9 (SC1), U13.3 (SCL)
unnamed: U7.7 (!INT1), U13.5 (!ALERT)
SCL: U7.18 (SCL); also elsewhere on the board
SDA: U7.19 (SDA); also elsewhere on the board
VCC_BACKPLANE: U7.1 (A0), U7.20 (VCC); also elsewhere on the board
VCC_MOD2: C15.1, R5.1, U12.6 (SENSE-); also elsewhere on the board
VCC_MOD5: C16.1, R6.1, U13.6 (SENSE-); also elsewhere on the board
VCC_MOD6: C17.1, R7.1, U14.6 (SENSE-); also elsewhere on the board
VCC_MOD7: C18.1, R8.1, U15.6 (SENSE-); also elsewhere on the board

Notes on the sheet:
Coulomb Counters
For MOD6-7, LINUX, BACKPLANE/CONTROLLER

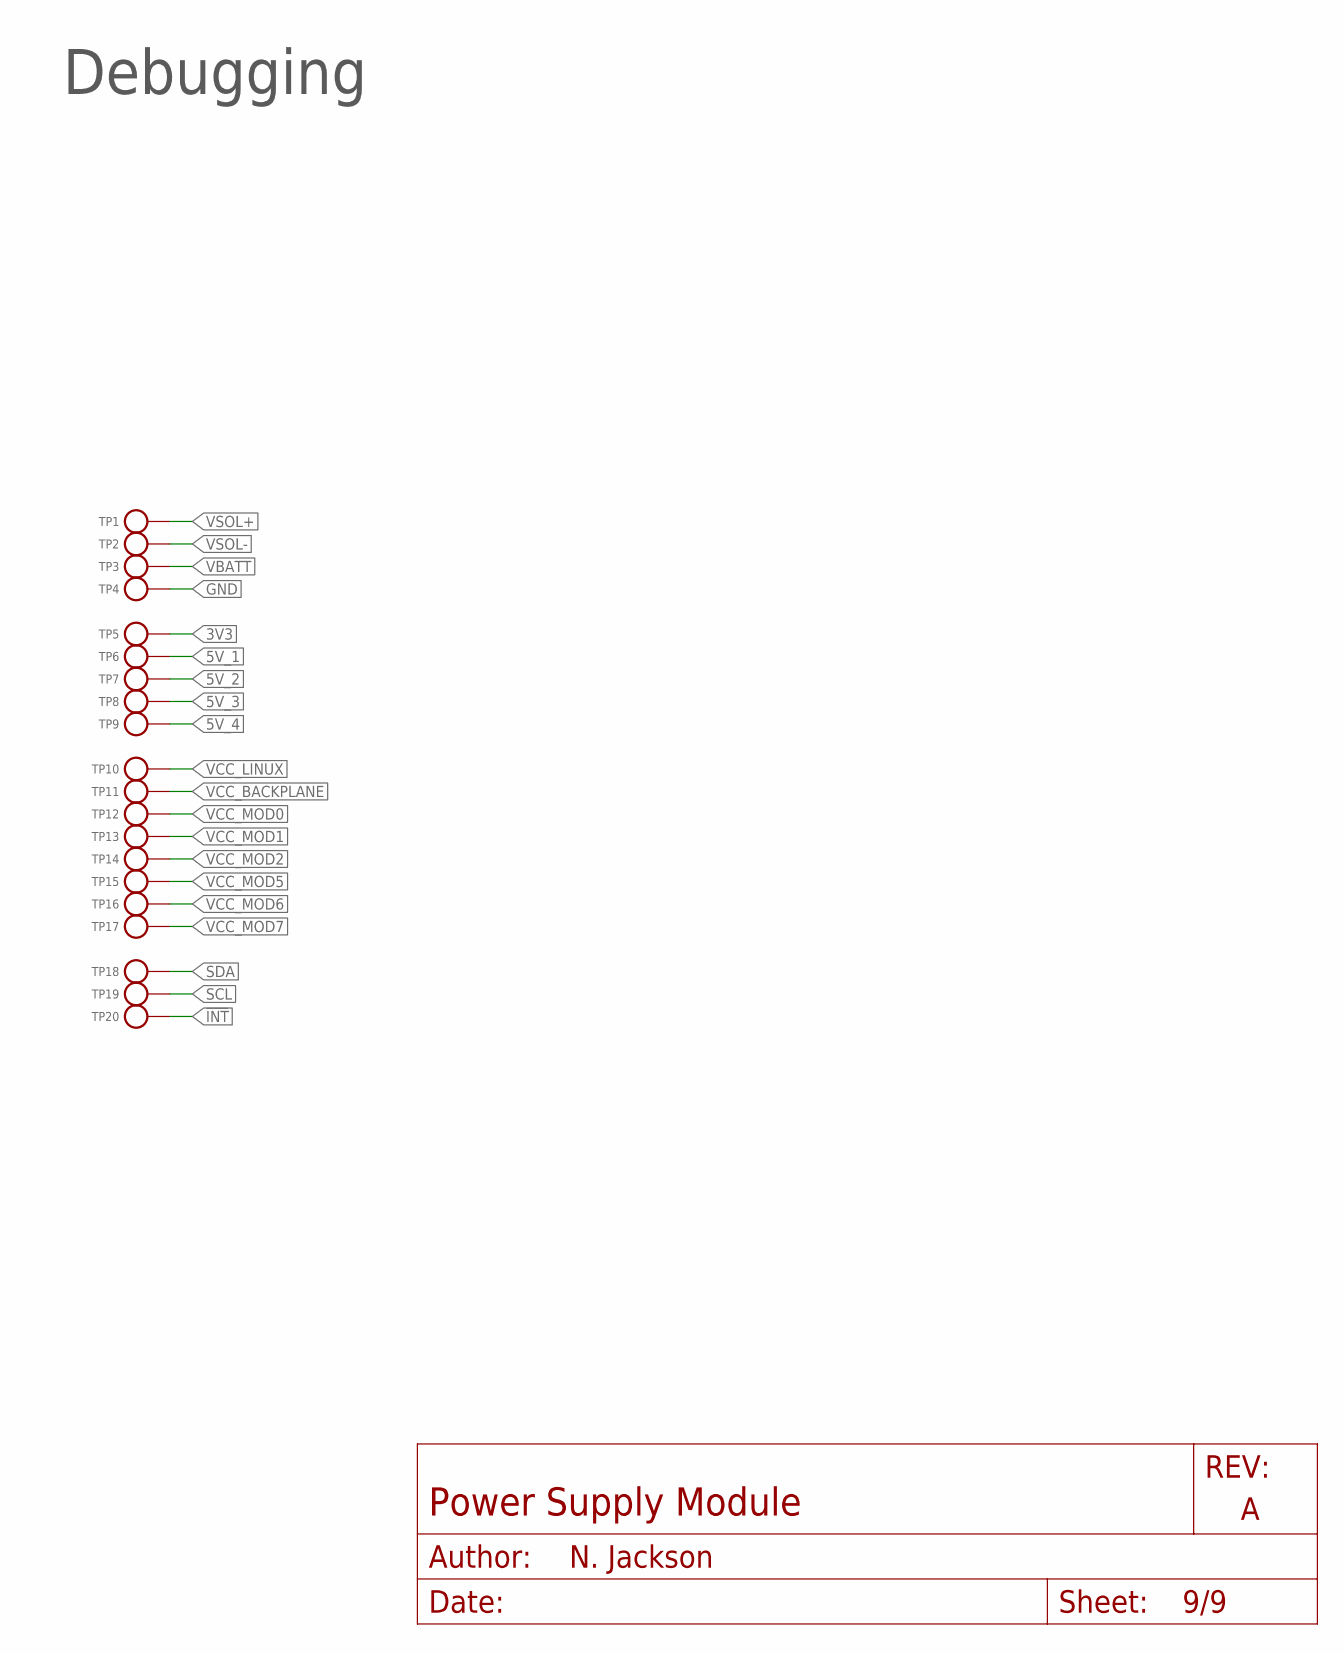
[picture p128: schematic power_supply_module.sch, sheet 9]

Parts:
TP1, TP2, TP3, TP4, TP5, TP6, TP7, TP8, TP9, TP10, TP11, TP12, TP13, TP14, TP15, TP16, TP17, TP18, TP19, TP20: TEST_POINT_0.040IN; TESTPOINT_0.040IN

Connections:
3V3: TP5.TESTPOINT; also elsewhere on the board
5V_1: TP6.TESTPOINT; also elsewhere on the board
5V_2: TP7.TESTPOINT; also elsewhere on the board
5V_3: TP8.TESTPOINT; also elsewhere on the board
5V_4: TP9.TESTPOINT; also elsewhere on the board
!INT: TP20.TESTPOINT; also elsewhere on the board
GND: TP4.TESTPOINT; also elsewhere on the board
SCL: TP19.TESTPOINT; also elsewhere on the board
SDA: TP18.TESTPOINT; also elsewhere on the board
VBATT: TP3.TESTPOINT; also elsewhere on the board
VCC_BACKPLANE: TP11.TESTPOINT; also elsewhere on the board
VCC_LINUX: TP10.TESTPOINT; also elsewhere on the board
VCC_MOD0: TP12.TESTPOINT; also elsewhere on the board
VCC_MOD1: TP13.TESTPOINT; also elsewhere on the board
VCC_MOD2: TP14.TESTPOINT; also elsewhere on the board
VCC_MOD5: TP15.TESTPOINT; also elsewhere on the board
VCC_MOD6: TP16.TESTPOINT; also elsewhere on the board
VCC_MOD7: TP17.TESTPOINT; also elsewhere on the board
VSOL+: TP1.TESTPOINT; also elsewhere on the board
VSOL-: TP2.TESTPOINT; also elsewhere on the board

Notes on the sheet:
Debugging

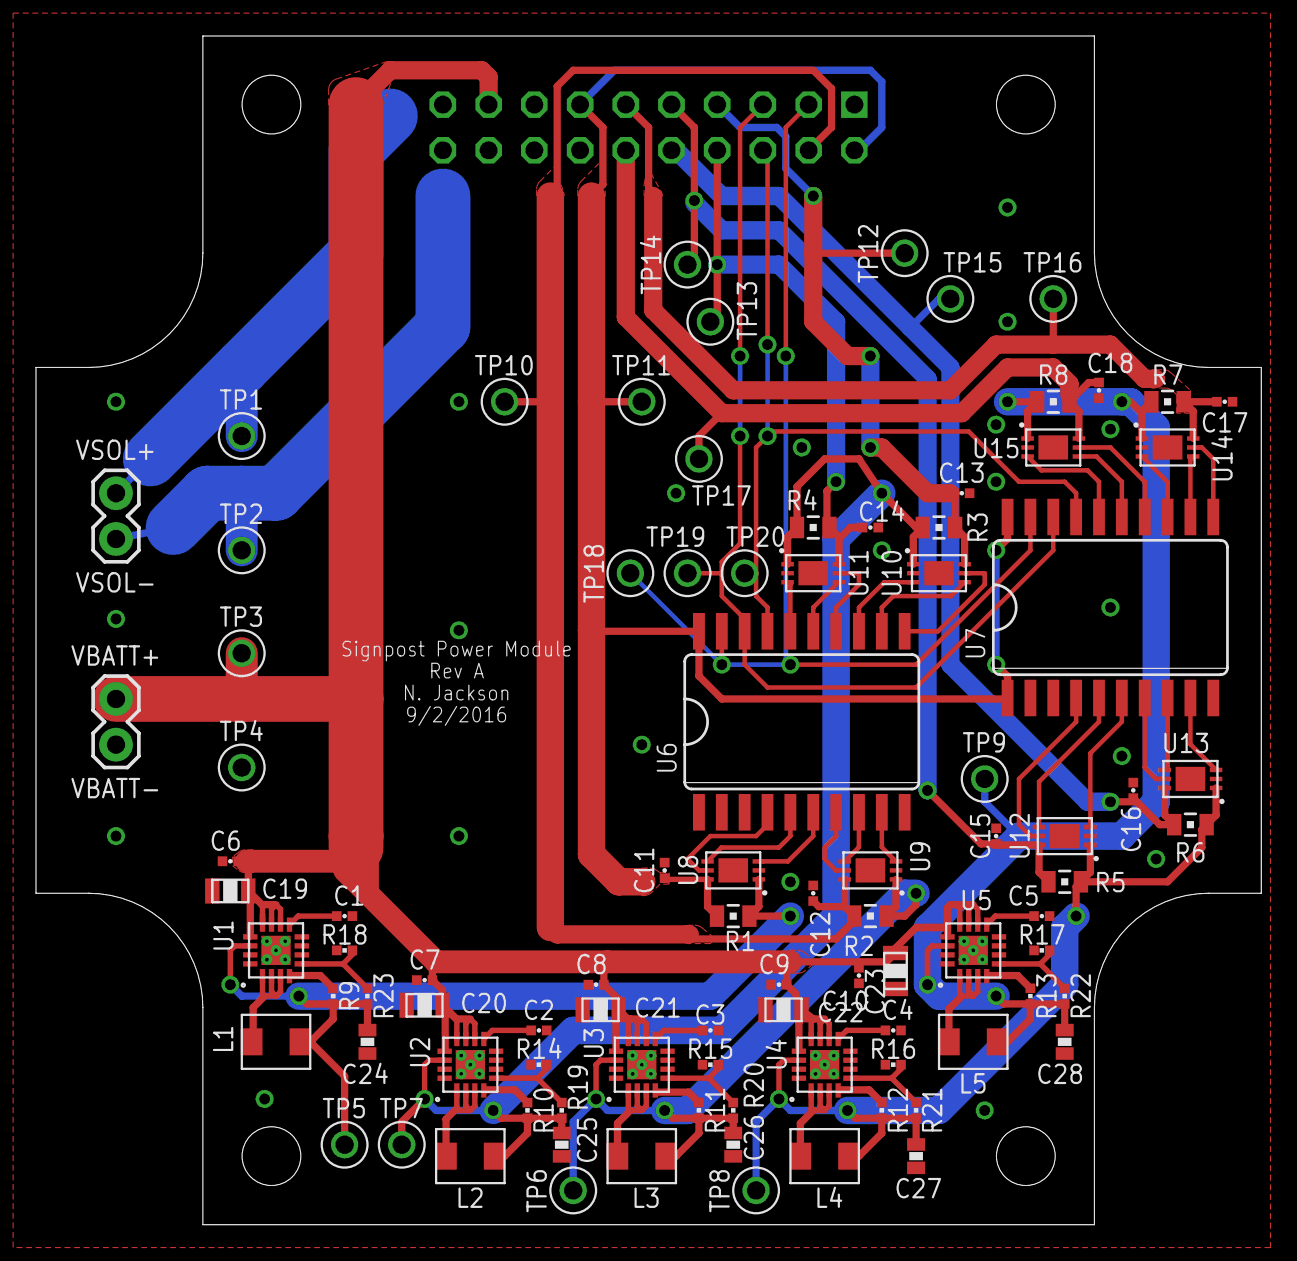
[picture p129: board hardware/power_supply_module/rev_a/power_supply_module.brd from above]

Board: 2 copper layers, 68.1 x 66.0 mm, 95 parts (0 on the bottom side), 64 nets.

Other parts of the board:
U$1: UCB_CAL_350MIL
