lab11/signpost/modules/arduino/rev_a/arduino-DIP.brd

## EAGLE design modules/arduino/rev_a/arduino-DIP.brd (2016-08-23)

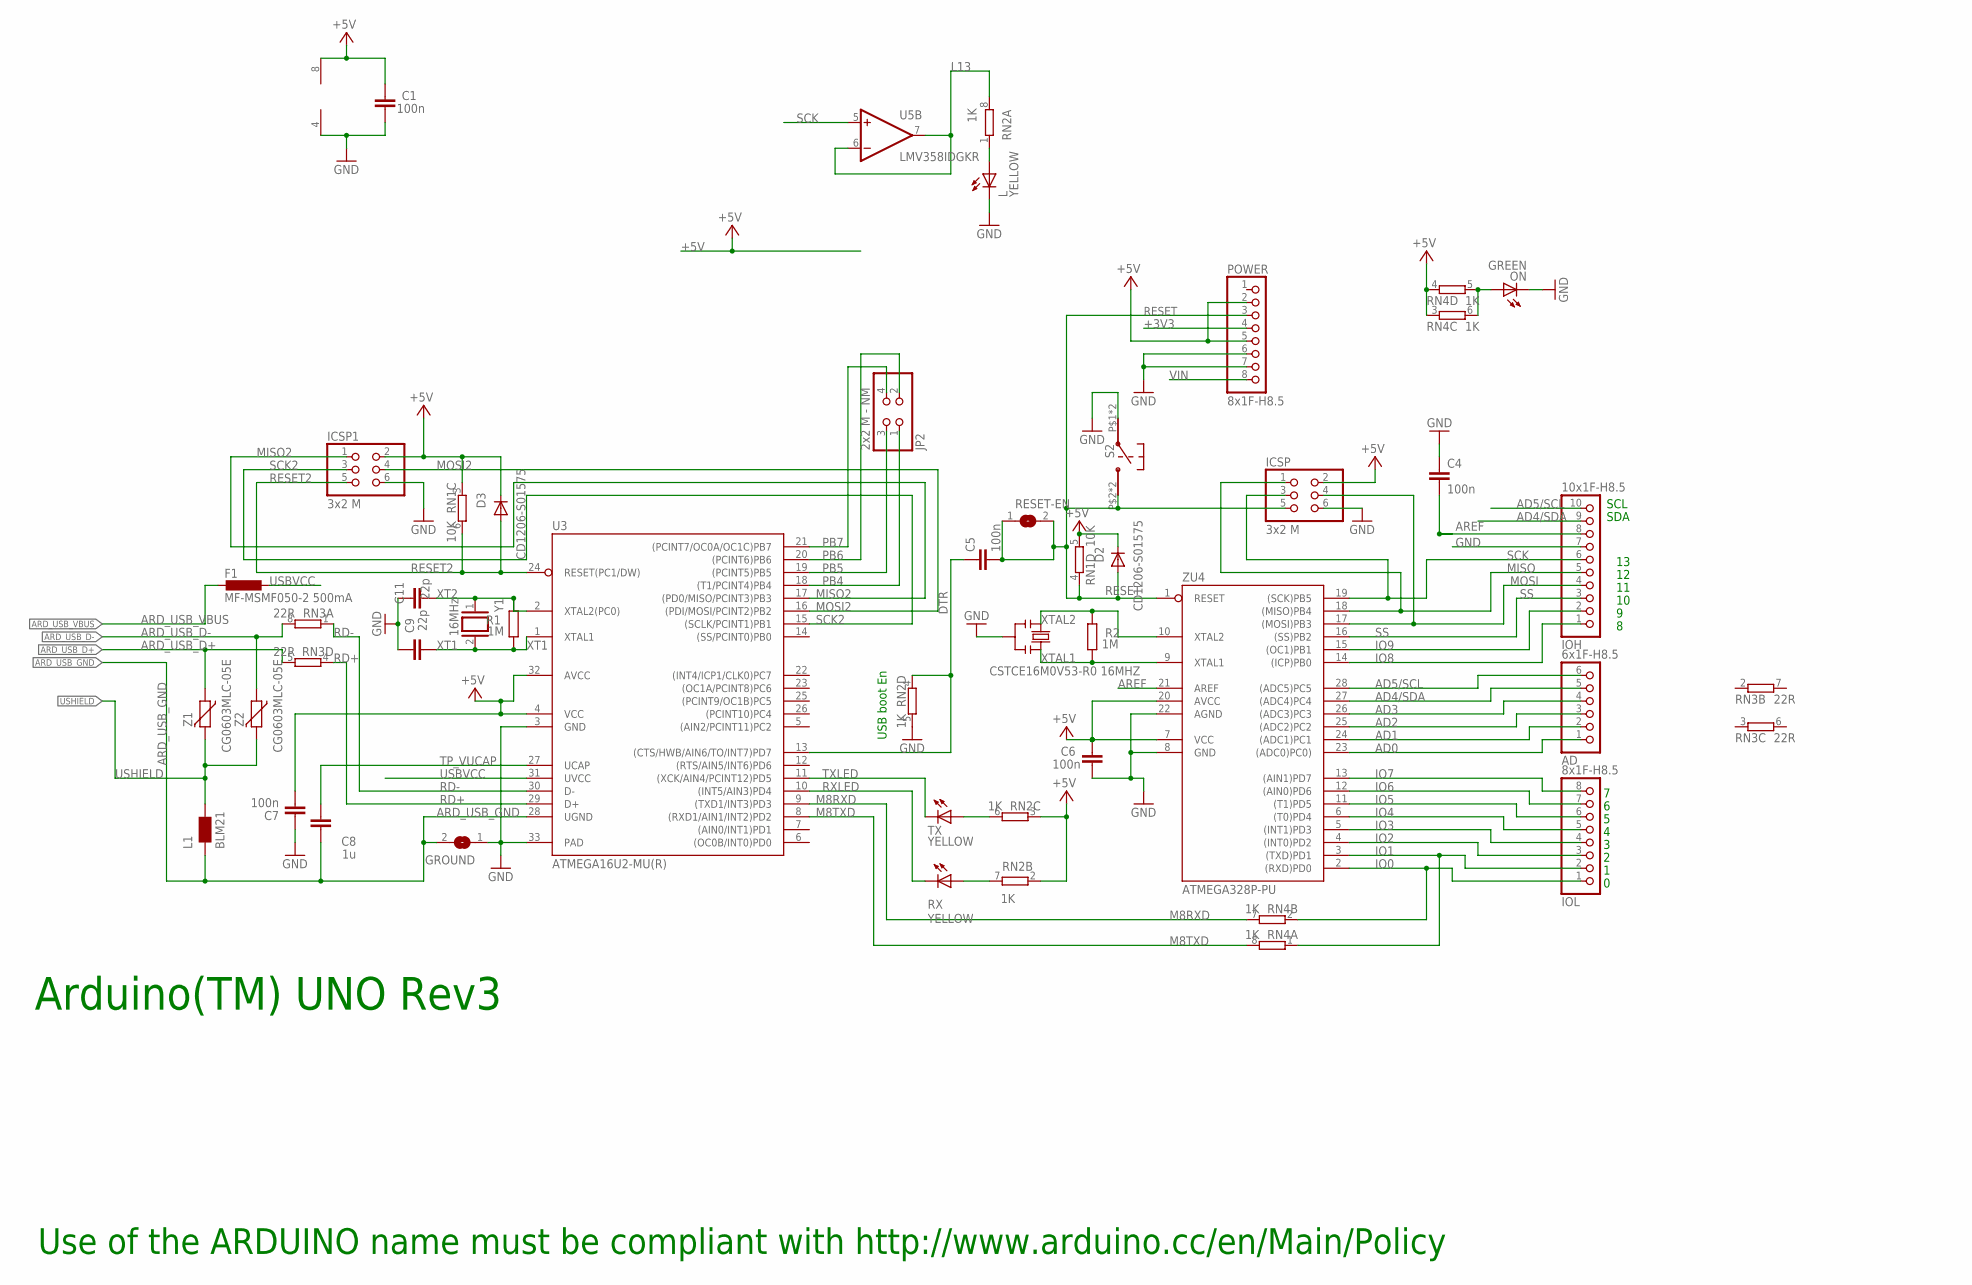
[picture p130: schematic arduino-DIP.sch, sheet 1]

Parts:
AD: 6x1F-H8.5; 1X06
C1, C4, C5, C6, C7: 100n; C0603-ROUND
C8: 1u; C0603-ROUND
C9, C11: 22p; C0603-ROUND
D2, D3: CD1206-S01575; MINIMELF
F1: MF-MSMF050-2 500mA; L1812; DIGIKEY MF-MSMF050-2CT-ND
GROUND: SJ
ICSP, ICSP1: 3x2 M; 2X03
IOH: 10x1F-H8.5; 1X10
IOL: 8x1F-H8.5; 1X08
JP2: 2x2 M - NM; 2X02
L: YELLOW; CHIP-LED0805
L1: BLM21; 0805; DIGIKEY 490-1054-1-ND
ON: GREEN; CHIP-LED0805
POWER: 8x1F-H8.5; 1X08
R1, R2: 1M; R0603-ROUND
RESET-EN: SJ
RN1: 10K; CAY16
RN2, RN4: 1K; CAY16
RN3: 22R; CAY16; DIGIKEY CAY16-220J4LFCT-ND
RX: YELLOW; CHIP-LED0805
S2: EVQP2
TX: YELLOW; CHIP-LED0805
U3: ATMEGA16U2-MU(R); MLF32
U5: LMV358IDGKR; MSOP08
Y1: 16MHz; QS; DIGIKEY 535-9041-ND
Y2: CSTCE16M0V53-R0 16MHZ; RESONATOR; DIGIKEY 490-1198-1-ND
Z1, Z2: CG0603MLC-05E; CT/CN0603; DIGIKEY CG0603MLC-05ECT-ND
ZU4: ATMEGA328P-PU; DIL28-3

Connections:
+3V3: POWER.4; also elsewhere on the board
+5V: C1.2, C6.2, C7.1, D2.C, D3.C, ICSP.2, ICSP1.2, POWER.2, POWER.5, RN1.3 (1), RN1.5 (2), RN2.2 (1), RN2.3 (1), RN4.3 (1), RN4.4 (1), U3.4 (VCC), U3.32 (AVCC), U5.8 (V+), ZU4.7 (VCC), ZU4.20 (AVCC); also elsewhere on the board
AD0: AD.1, ZU4.23 ((ADC0)PC0))
AD1: AD.2, ZU4.24 ((ADC1)PC1)
AD2: AD.3, ZU4.25 ((ADC2)PC2)
AD3: AD.4, ZU4.26 ((ADC3)PC3)
AD4/SDA: AD.5, IOH.9, ZU4.27 ((ADC4)PC4)
AD5/SCL: AD.6, IOH.10, ZU4.28 ((ADC5)PC5)
ARD_USB_D+: RN3.5 (2), Z1.1; also elsewhere on the board
ARD_USB_D-: RN3.8 (2), Z2.1; also elsewhere on the board
ARD_USB_GND: C8.2, GROUND.2, L1.1, U3.28 (UGND); also elsewhere on the board
ARD_USB_VBUS: F1.2; also elsewhere on the board
AREF: C4.2, IOH.8, ZU4.21 (AREF)
DTR: C5.1, RN2.4 (1), U3.13 ((CTS/HWB/AIN6/TO/INT7)PD7)
GND: C1.1, C4.1, C6.1, C7.2, C9.2, C11.2, GROUND.1, ICSP.6, ICSP1.6, IOH.7, L.C, ON.C, POWER.6, POWER.7, RN2.5 (2), S2.P$1, S2.P$3, U3.3 (GND), U3.33 (PAD), U5.4 (V-), Y2.2, ZU4.8 (GND), ZU4.22 (AGND); also elsewhere on the board
IO0: IOL.1, RN4.2 (1), ZU4.2 ((RXD)PD0)
IO1: IOL.2, RN4.1, ZU4.3 ((TXD)PD1)
IO2: IOL.3, ZU4.4 ((INT0)PD2)
IO3: IOL.4, ZU4.5 ((INT1)PD3)
IO4: IOL.5, ZU4.6 ((T0)PD4)
IO5: IOL.6, ZU4.11 ((T1)PD5)
IO6: IOL.7, ZU4.12 ((AIN0)PD6)
IO7: IOL.8, ZU4.13 ((AIN1)PD7)
IO8: IOH.1, ZU4.14 ((ICP)PB0)
IO9: IOH.2, ZU4.15 ((OC1)PB1)
L13: RN2.8 (2), U5.6 (-IN), U5.7 (OUT)
M8RXD: RN4.7 (2), U3.9 ((TXD1/INT3)PD3)
M8TXD: RN4.8 (2), U3.8 ((RXD1/AIN1/INT2)PD2)
MISO: ICSP.1, IOH.5, ZU4.18 ((MISO)PB4)
MISO2: ICSP1.1, U3.17 ((PD0/MISO/PCINT3)PB3)
MOSI: ICSP.4, IOH.4, ZU4.17 ((MOSI)PB3)
MOSI2: ICSP1.4, U3.16 ((PDI/MOSI/PCINT2)PB2)
unnamed: L.A, RN2.1
unnamed: ON.A, RN4.5 (2), RN4.6 (2)
unnamed: RN2.7 (2), RX.A
unnamed: RN2.6 (2), TX.A
PB4: JP2.1, U3.18 ((T1/PCINT4)PB4)
PB5: JP2.3, U3.19 ((PCINT5)PB5)
PB6: JP2.2, U3.20 ((PCINT6)PB6)
PB7: JP2.4, U3.21 ((PCINT7/OC0A/OC1C)PB7)
RD+: RN3.4 (1), U3.29 (D+)
RD-: RN3.1, U3.30 (D-)
RESET: C5.2, D2.A, ICSP.5, POWER.3, RESET-EN.1, RESET-EN.2, RN1.4 (1), S2.P$2, S2.P$4, ZU4.1 (RESET)
RESET2: D3.A, ICSP1.5, RN1.6 (2), U3.24 (RESET(PC1/DW))
RXLED: RX.C, U3.10 ((INT5/AIN3)PD4)
SCK: ICSP.3, IOH.6, U5.5 (+IN), ZU4.19 ((SCK)PB5)
SCK2: ICSP1.3, U3.15 ((SCLK/PCINT1)PB1)
SS: IOH.3, ZU4.16 ((SS)PB2)
TP_VUCAP: C8.1, U3.27 (UCAP)
TXLED: TX.C, U3.11 ((XCK/AIN4/PCINT12)PD5)
USBVCC: F1.1, U3.31 (UVCC)
USHIELD: L1.2, Z1.2, Z2.2
VIN: POWER.8
XT1: C9.1, R1.1, U3.1 (XTAL1), Y1.2
XT2: C11.1, R1.2, U3.2 (XTAL2(PC0)), Y1.1
XTAL1: R2.1, Y2.3, ZU4.9 (XTAL1)
XTAL2: R2.2, Y2.1, ZU4.10 (XTAL2)

Notes on the sheet:
Arduino(TM) UNO Rev3
USB boot En
SDA
SCL
Use of the ARDUINO name must be compliant with http://www.arduino.cc/en/Main/Policy

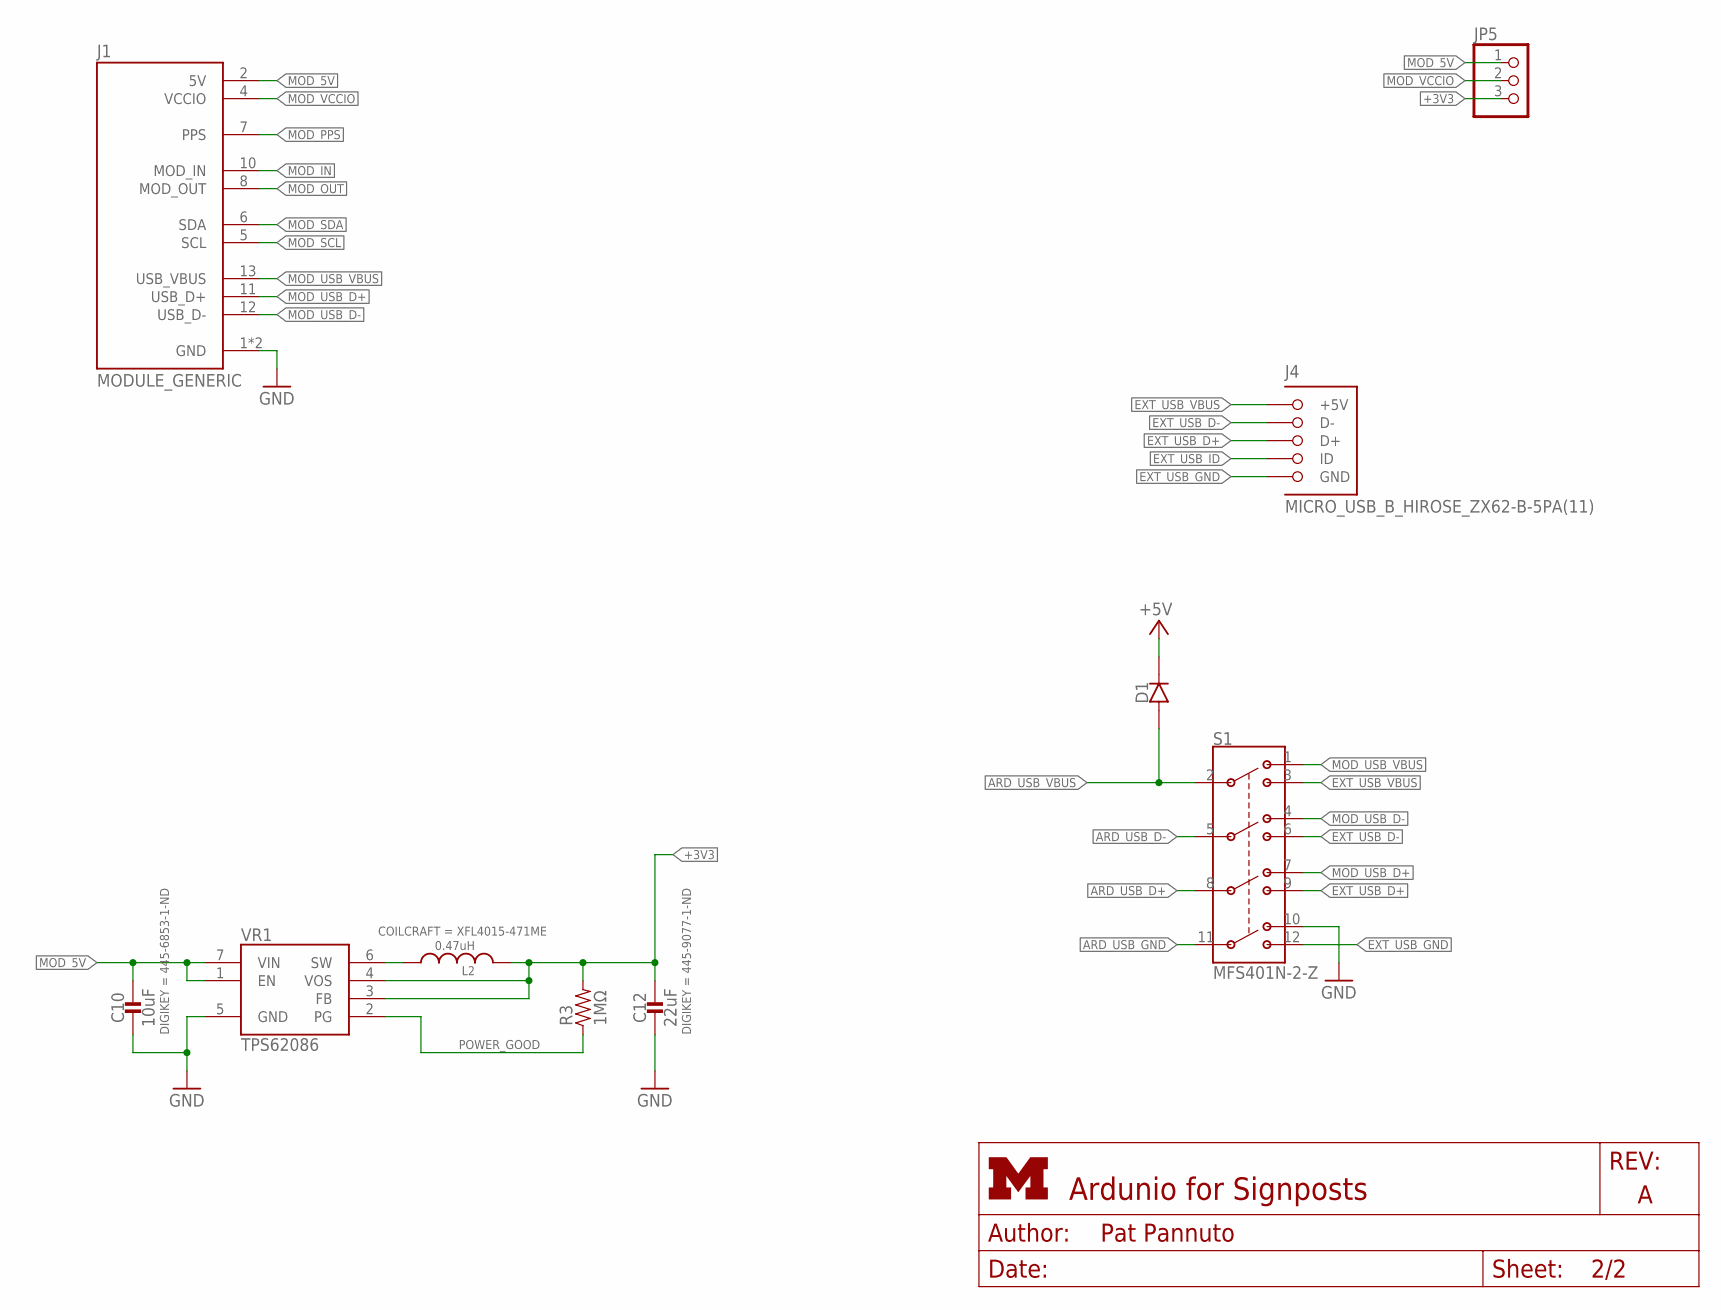
[picture p131: schematic arduino-DIP.sch, sheet 2]

Parts:
C10: 10uF; 0603_CAP; DIGIKEY 445-6853-1-ND
C12: 22uF; 0603_CAP; DIGIKEY 445-9077-1-ND
D1: DIODE; 0402_DIODE; DIGIKEY P18981CT-ND
J1: MODULE_GENERIC
J4: MICRO_USB_B_HIROSE_ZX62-B-5PA(11); USB_MICRO_B-HIROSE-ZX62-B-5PA(11)
JP5: PINHD-1X3; 1X03
L2: 0.47uH; XFL4015
R3: 1MΩ; 0603-RES
S1: MFS401N-2-Z
VR1: TPS62086; RLT0007A

Connections:
+3V3: C12.1, JP5.3, L2.2, R3.2, VR1.3 (FB), VR1.4 (VOS); also elsewhere on the board
+5V: D1.CATHODE; also elsewhere on the board
ARD_USB_D+: S1.8 (3P); also elsewhere on the board
ARD_USB_D-: S1.5 (2P); also elsewhere on the board
ARD_USB_GND: S1.11 (4P); also elsewhere on the board
ARD_USB_VBUS: D1.ANODE, S1.2 (1P); also elsewhere on the board
EXT_USB_D+: J4.3 (D+), S1.9 (3TB)
EXT_USB_D-: J4.2 (D-), S1.6 (2TB)
EXT_USB_GND: J4.5 (GND), S1.12 (4TB)
EXT_USB_ID: J4.4 (ID)
EXT_USB_VBUS: J4.1 (+5V), S1.3 (1TB)
GND: C10.2, C12.2, J1.1 (GND), J1.14 (GND), S1.10 (4TA), VR1.5 (GND); also elsewhere on the board
MOD_5V: C10.1, J1.2 (5V), JP5.1, VR1.1 (EN), VR1.7 (VIN)
MOD_IN: J1.10 (MOD_IN)
MOD_OUT: J1.8 (MOD_OUT)
MOD_PPS: J1.7 (PPS)
MOD_SCL: J1.5 (SCL)
MOD_SDA: J1.6 (SDA)
MOD_USB_D+: J1.11 (USB_D+), S1.7 (3TA)
MOD_USB_D-: J1.12 (USB_D-), S1.4 (2TA)
MOD_USB_VBUS: J1.13 (USB_VBUS), S1.1 (1TA)
MOD_VCCIO: J1.4 (VCCIO), JP5.2
unnamed: L2.1, VR1.6 (SW)
POWER_GOOD: R3.1, VR1.2 (PG)

Board: 2 copper layers, 49 parts (1 on the bottom side), 67 nets, no tracks yet.
