lab11/signpost/modules/arduino/rev_a/ardunio_breakout.brd

## EAGLE design modules/arduino/rev_a/ardunio_breakout.brd (2016-08-22)

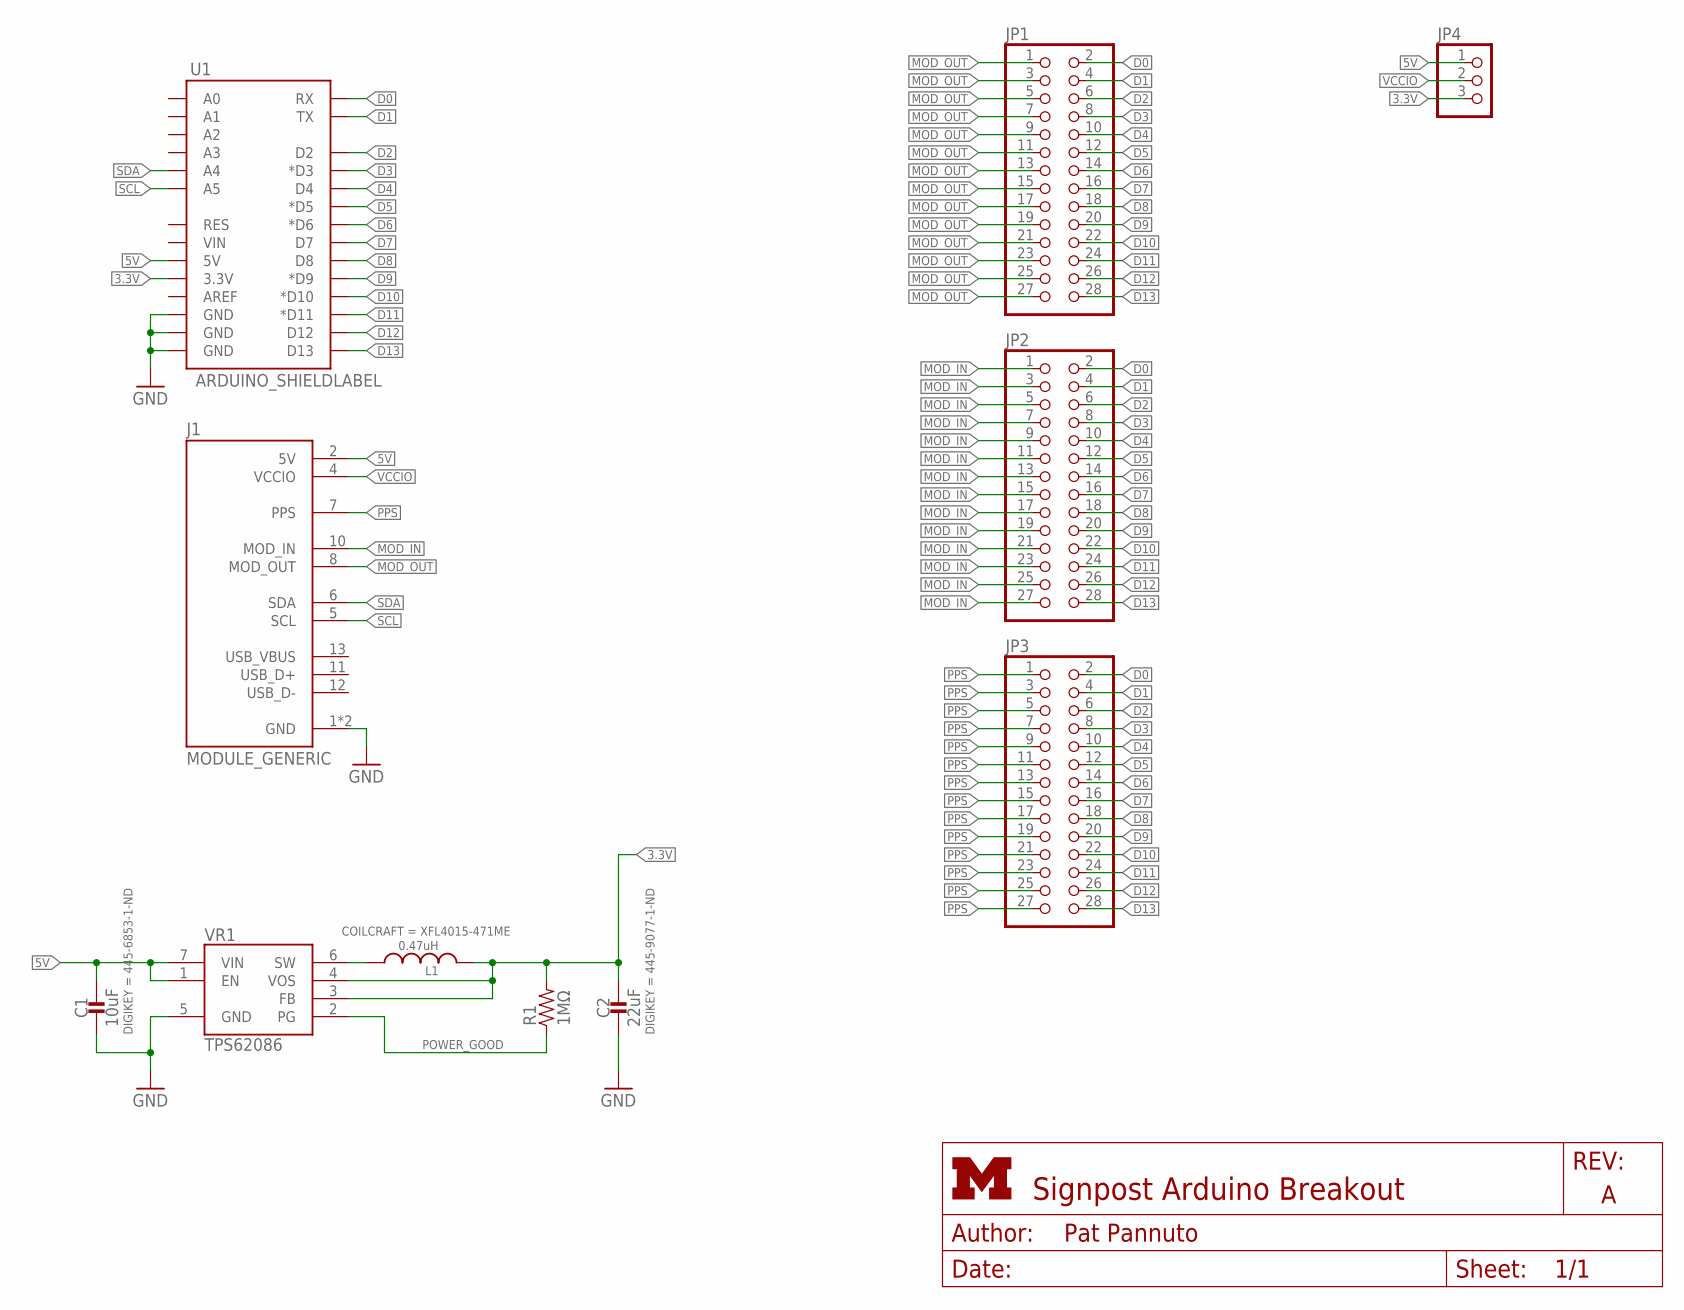
[picture p132: schematic ardunio_breakout.sch]

Parts:
C1: 10uF; 0603_CAP; DIGIKEY 445-6853-1-ND
C2: 22uF; 0603_CAP; DIGIKEY 445-9077-1-ND
J1: MODULE_GENERIC
JP1, JP2, JP3: PINHD-2X14; 2X14
JP4: PINHD-1X3; 1X03
L1: 0.47uH; XFL4015
R1: 1MΩ; 0603-RES
U1: ARDUINO_SHIELDLABEL; DUEMILANOVE_SHIELD
VR1: TPS62086; RLT0007A

Connections:
3.3V: C2.1, JP4.3, L1.2, R1.2, U1.3.3V, VR1.3 (FB), VR1.4 (VOS)
5V: C1.1, J1.2 (5V), JP4.1, U1.5V, VR1.1 (EN), VR1.7 (VIN)
D0: JP1.2, JP2.2, JP3.2, U1.RX
D1: JP1.4, JP2.4, JP3.4, U1.TX
D2: JP1.6, JP2.6, JP3.6, U1.D2
D3: JP1.8, JP2.8, JP3.8, U1.D3 (*D3)
D4: JP1.10, JP2.10, JP3.10, U1.D4
D5: JP1.12, JP2.12, JP3.12, U1.D5 (*D5)
D6: JP1.14, JP2.14, JP3.14, U1.D6 (*D6)
D7: JP1.16, JP2.16, JP3.16, U1.D7
D8: JP1.18, JP2.18, JP3.18, U1.D8
D9: JP1.20, JP2.20, JP3.20, U1.D9 (*D9)
D10: JP1.22, JP2.22, JP3.22, U1.D10 (*D10)
D11: JP1.24, JP2.24, JP3.24, U1.D11 (*D11)
D12: JP1.26, JP2.26, JP3.26, U1.D12
D13: JP1.28, JP2.28, JP3.28, U1.D13
GND: C1.2, C2.2, J1.1 (GND), J1.14 (GND), U1.GND@0 (GND), U1.GND@1 (GND), U1.GND@2 (GND), VR1.5 (GND)
MOD_IN: J1.10 (MOD_IN), JP2.1
MOD_OUT: J1.8 (MOD_OUT), JP1.1, JP1.3, JP1.5, JP1.7, JP1.9, JP1.11, JP1.13, JP1.15, JP1.17, JP1.19, JP1.21, JP1.23, JP1.25, JP1.27
unnamed: L1.1, VR1.6 (SW)
POWER_GOOD: R1.1, VR1.2 (PG)
PPS: J1.7 (PPS), JP3.1
SCL: J1.5 (SCL), U1.A5
SDA: J1.6 (SDA), U1.A4
VCCIO: J1.4 (VCCIO), JP4.2

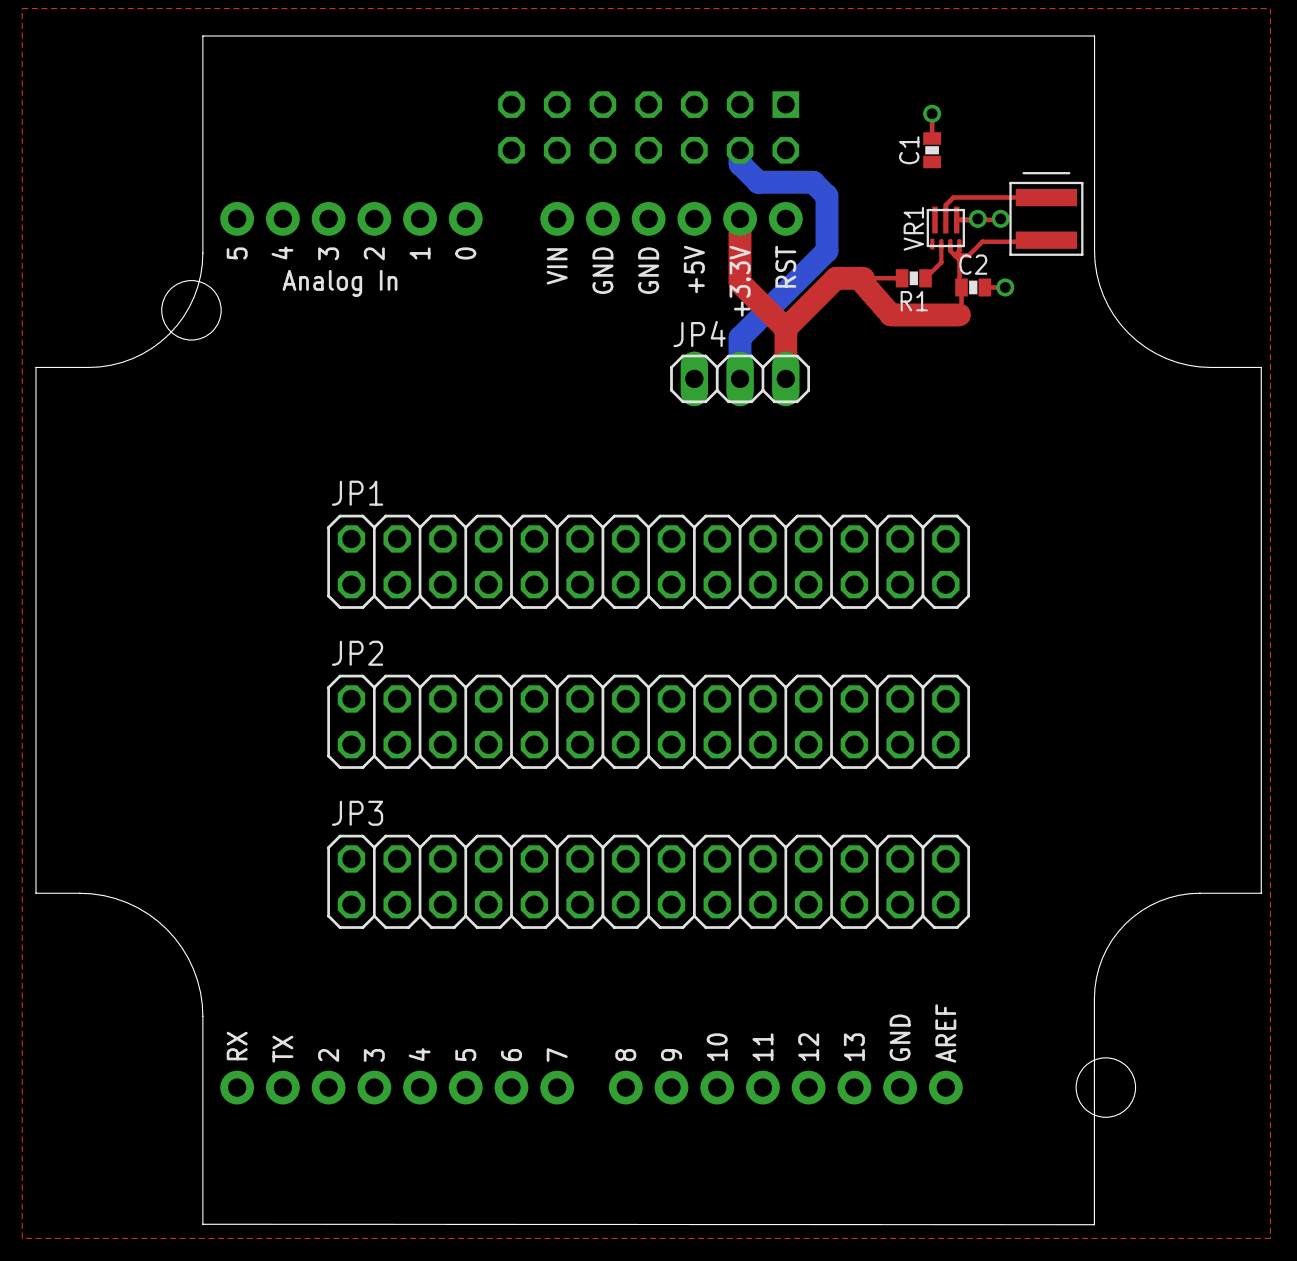
[picture p133: board ardunio_breakout.brd from above]

Board: 2 copper layers, 68.1 x 66.0 mm, 11 parts (0 on the bottom side), 25 nets.
