lab11/signpost/hardware/power_supply_breakout_module/rev_a/power_supply_breakout_module.brd

## EAGLE design hardware/power_supply_breakout_module/rev_a/power_supply_breakout_module.brd (2016-08-22)

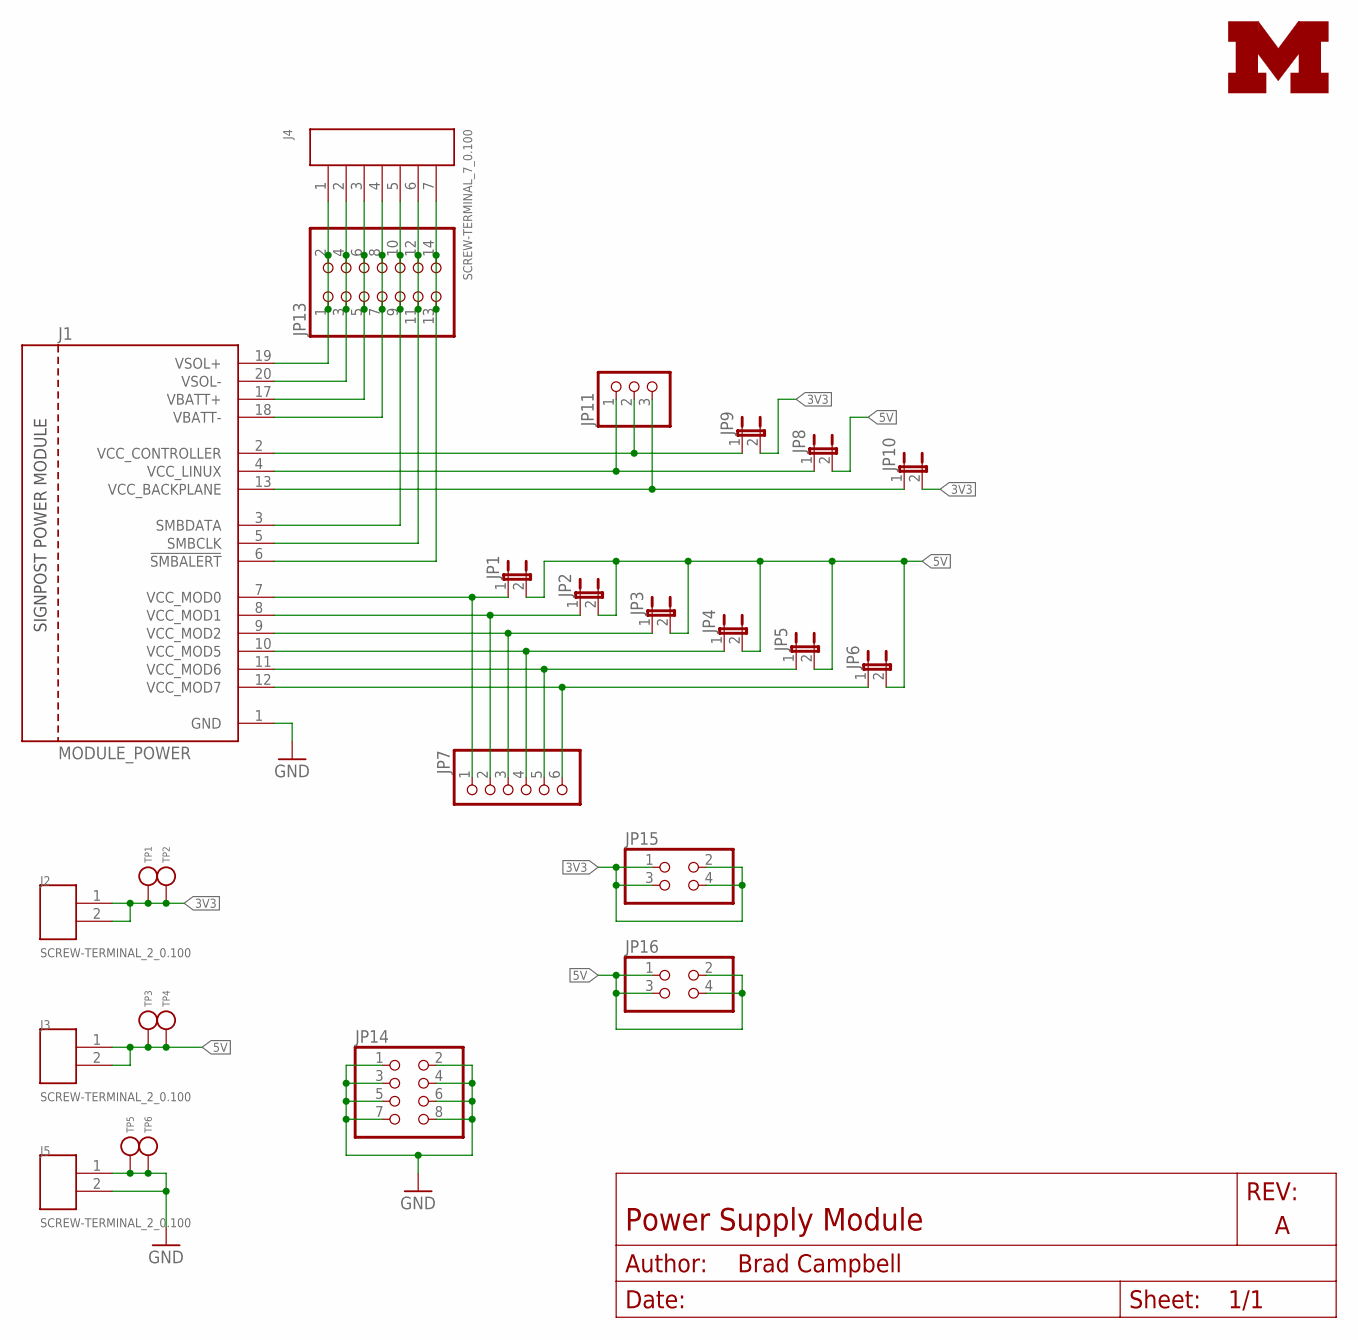
[picture p134: schematic power_supply_breakout_module.sch]

Parts:
J1: MODULE_POWER
J2, J3, J5: SCREW-TERMINAL_2_0.100; CONN_BLOCK_2
J4: SCREW-TERMINAL_7_0.100; CONN_BLOCK_7
JP1, JP2, JP3, JP4, JP5, JP6, JP8, JP9, JP10: JUMPER-2PTH; 1X02
JP7: PINHD-1X6; 1X06
JP11: PINHD-1X3; 1X03
JP13: PINHD-2X7; 2X07
JP14: PINHD-2X4; 2X04
JP15, JP16: PINHD-2X2; 2X02
LOGO1: UMICH_SOLID_MEDIUM; UMICH_SOLID_200MIL
TP1, TP2, TP3, TP4, TP5, TP6: TEST_POINT_0.040IN; TESTPOINT_0.040IN

Connections:
3V3: J2.1, J2.2, JP9.2, JP10.2, JP15.1, JP15.2, JP15.3, JP15.4, TP1.TESTPOINT, TP2.TESTPOINT
5V: J3.1, J3.2, JP1.2, JP2.2, JP3.2, JP4.2, JP5.2, JP6.2, JP8.2, JP16.1, JP16.2, JP16.3, JP16.4, TP3.TESTPOINT, TP4.TESTPOINT
!SMBALERT: J1.6 (!SMBALERT), J4.7, JP13.13, JP13.14
GND: J1.1 (GND), J5.1, J5.2, JP14.1, JP14.2, JP14.3, JP14.4, JP14.5, JP14.6, JP14.7, JP14.8, TP5.TESTPOINT, TP6.TESTPOINT
SMBCLK: J1.5 (SMBCLK), J4.6, JP13.11, JP13.12
SMBDATA: J1.3 (SMBDATA), J4.5, JP13.9, JP13.10
VBATT+: J1.17 (VBATT+), J4.3, JP13.5, JP13.6
VBATT-: J1.18 (VBATT-), J4.4, JP13.7, JP13.8
VCC_BACKPLANE: J1.13 (VCC_BACKPLANE), JP10.1, JP11.3
VCC_CONTROLLER: J1.2 (VCC_CONTROLLER), JP9.1, JP11.2
VCC_LINUX: J1.4 (VCC_LINUX), JP8.1, JP11.1
VCC_MOD0: J1.7 (VCC_MOD0), JP1.1, JP7.1
VCC_MOD1: J1.8 (VCC_MOD1), JP2.1, JP7.2
VCC_MOD2: J1.9 (VCC_MOD2), JP3.1, JP7.3
VCC_MOD5: J1.10 (VCC_MOD5), JP4.1, JP7.4
VCC_MOD6: J1.11 (VCC_MOD6), JP5.1, JP7.5
VCC_MOD7: J1.12 (VCC_MOD7), JP6.1, JP7.6
VSOL+: J1.19 (VSOL+), J4.1, JP13.1, JP13.2
VSOL-: J1.20 (VSOL-), J4.2, JP13.3, JP13.4

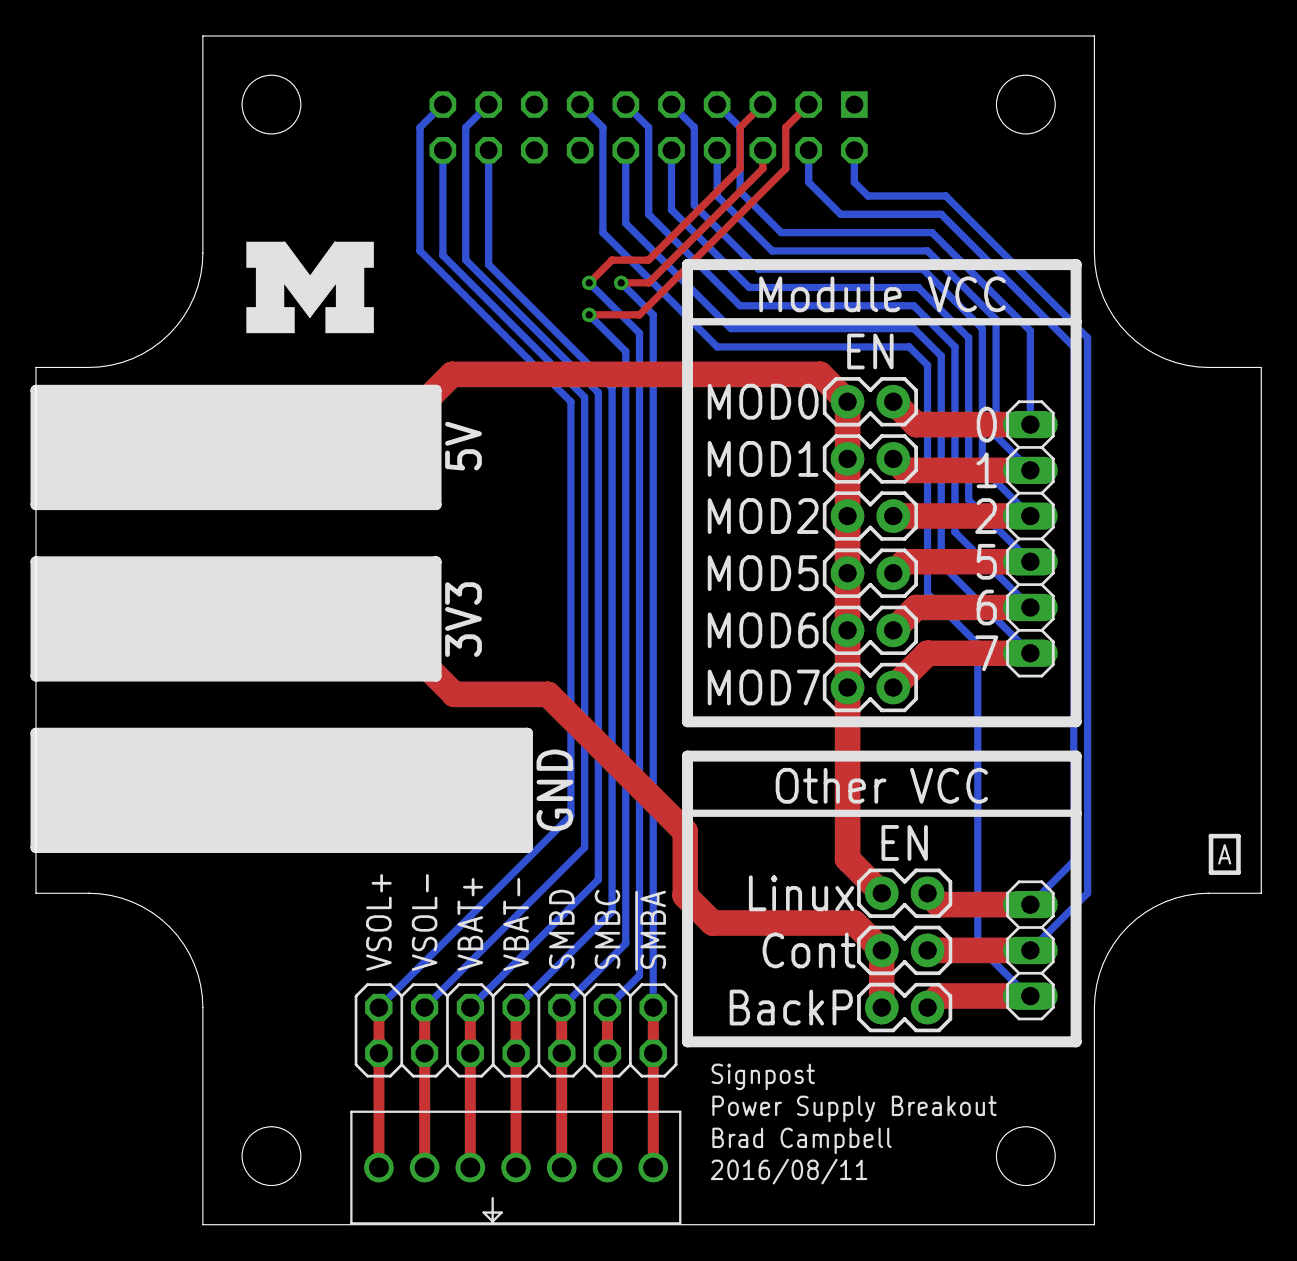
[picture p135: board power_supply_breakout_module.brd from above]

Board: 2 copper layers, 68.1 x 66.0 mm, 27 parts (0 on the bottom side), 19 nets.
