lab11/signpost/modules/spectrum154/hardware/scanner154/rev_a/scanner154.brd

## EAGLE design modules/spectrum154/hardware/scanner154/rev_a/scanner154.brd (2016-08-12)

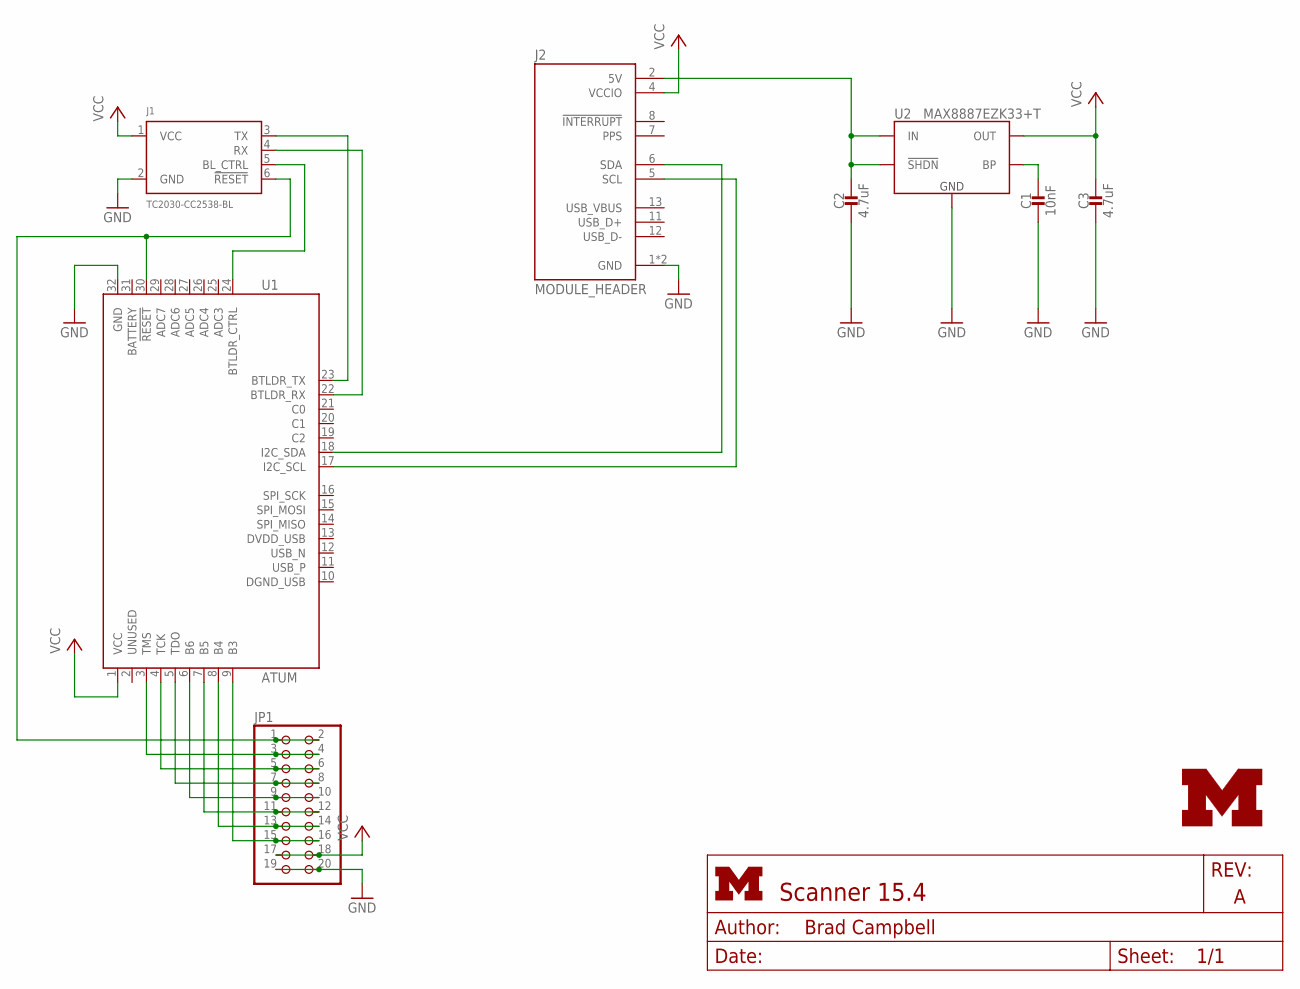
[picture p136: schematic scanner154.sch]

Parts:
C1: 10nF; 0603_CAP; DIGIKEY 490-1512-1-ND
C2, C3: 4.7uF; 0603_CAP; DIGIKEY 490-3297-1-ND
J1: TC2030-CC2538-BL; TC2030-IDC
J2: MODULE_HEADER; HEADER_14PIN
JP1: PINHD-2X10; 2X10
LOGO2: UMICH_SOLID_HUGE; UMICH_SOLID_500MIL
U1: ATUM
U2: MAX8887EZK33+T; SOT-23-5

Connections:
5V: C2.1, J2.2 (5V), U2.1 (IN), U2.3 (!SHDN)
!RESET: J1.6 (!RESET), JP1.1, JP1.2, U1.30 (!RESET)
B3: JP1.15, JP1.16, U1.9 (B3)
B4: JP1.13, JP1.14, U1.8 (B4)
B5: JP1.11, JP1.12, U1.7 (B5)
B6: JP1.9, JP1.10, U1.6 (B6)
GND: C1.2, C2.2, C3.2, J1.2 (GND), J2.1 (GND), J2.14 (GND), JP1.19, JP1.20, U1.32 (GND), U2.2 (GND)
unnamed: J1.3 (TX), U1.23 (BTLDR_TX)
unnamed: J1.4 (RX), U1.22 (BTLDR_RX)
unnamed: J1.5 (BL_CTRL), U1.24 (BTLDR_CTRL)
unnamed: C1.1, U2.4 (BP)
SCL: J2.5 (SCL), U1.17 (I2C_SCL)
SDA: J2.6 (SDA), U1.18 (I2C_SDA)
TCK: JP1.5, JP1.6, U1.4 (TCK)
TDO: JP1.7, JP1.8, U1.5 (TDO)
TMS: JP1.3, JP1.4, U1.3 (TMS)
VCC: C3.1, J1.1 (VCC), J2.4 (VCCIO), JP1.17, JP1.18, U1.1 (VCC), U2.5 (OUT)

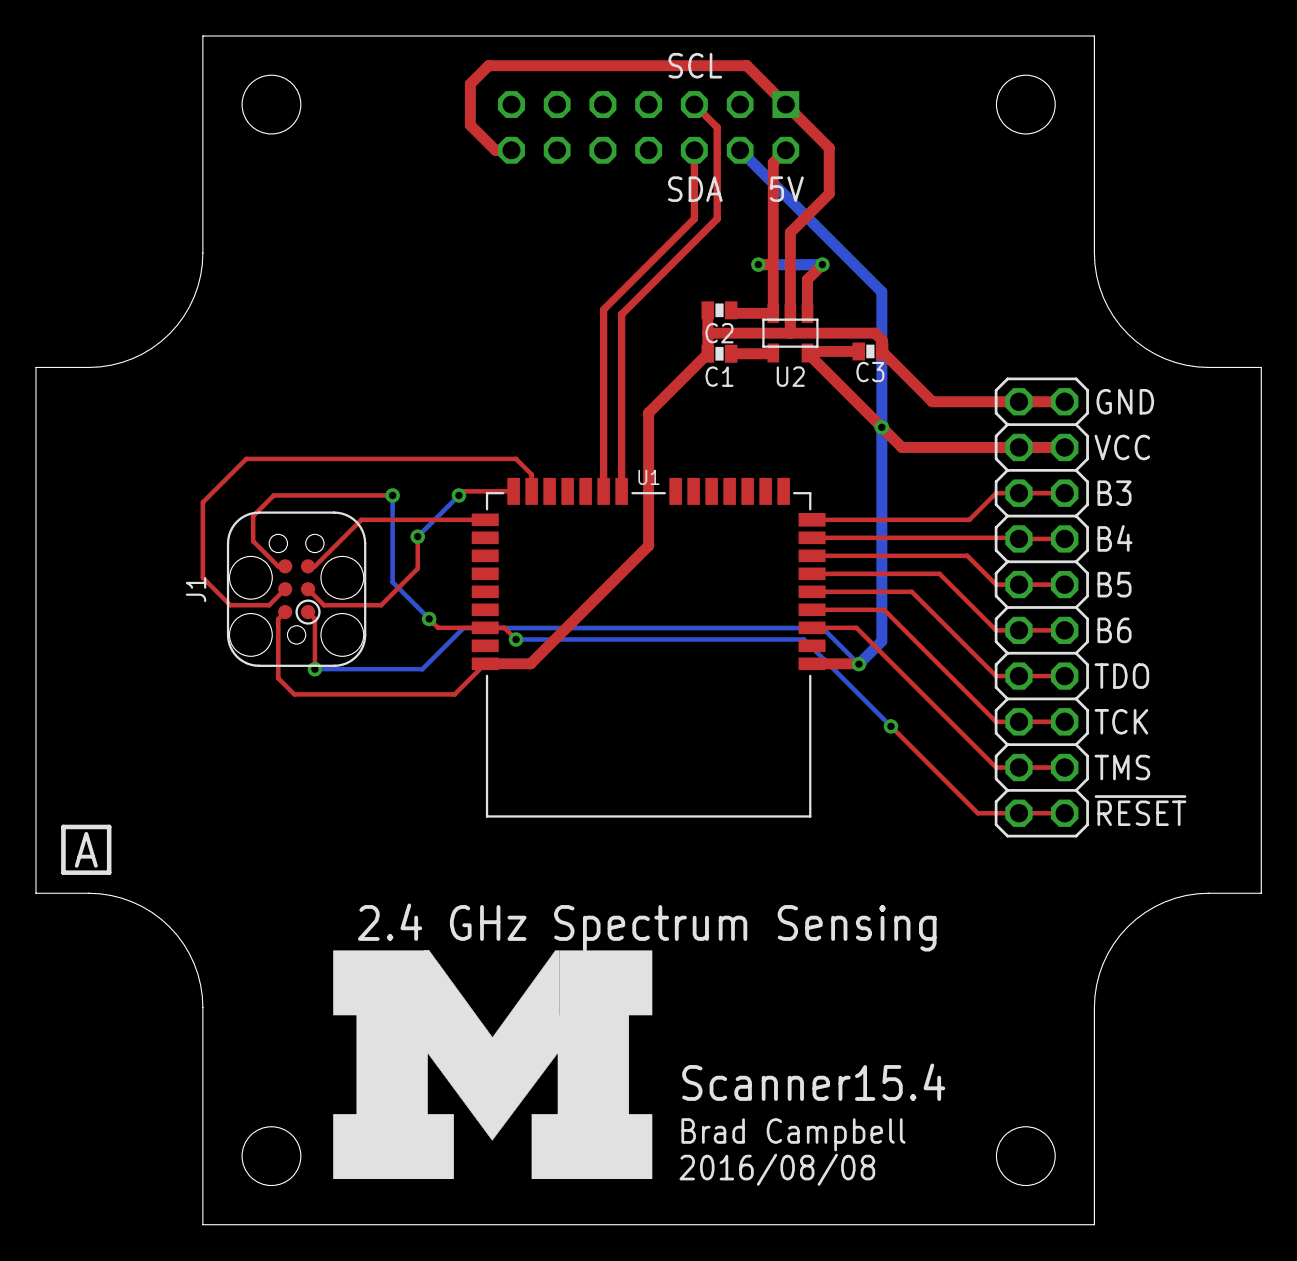
[picture p137: board scanner154.brd from above]

Board: 2 copper layers, 68.1 x 66.0 mm, 9 parts (0 on the bottom side), 17 nets.
